santan444/MS001/03-设计开发输出阶段/02电子/05物料证书/隔离电源/BK-1000VA.jpg

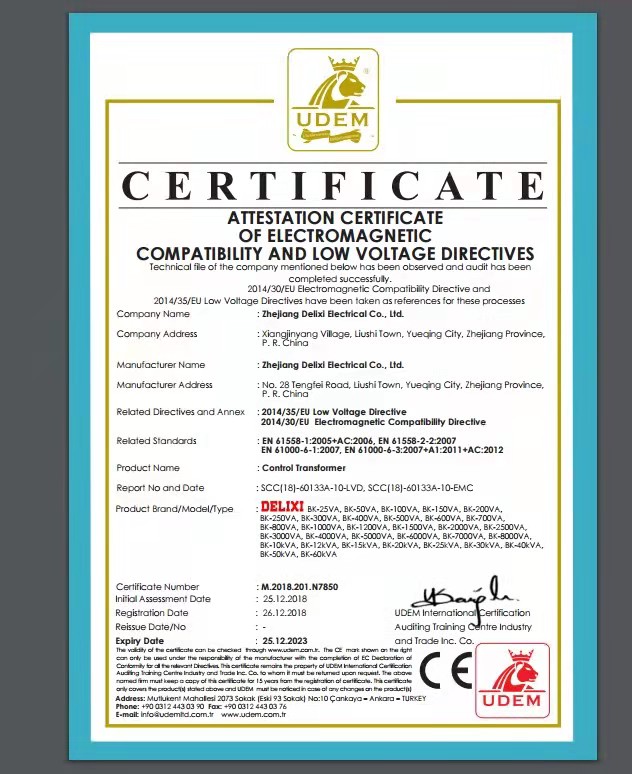
03-设计开发输出阶段/02电子/05物料证书/隔离电源/BK-1000VA.jpg
