santan444/MS001/03-设计开发输出阶段/02电子/05物料证书/显示器/优派VX3515-2KC-PRO.png

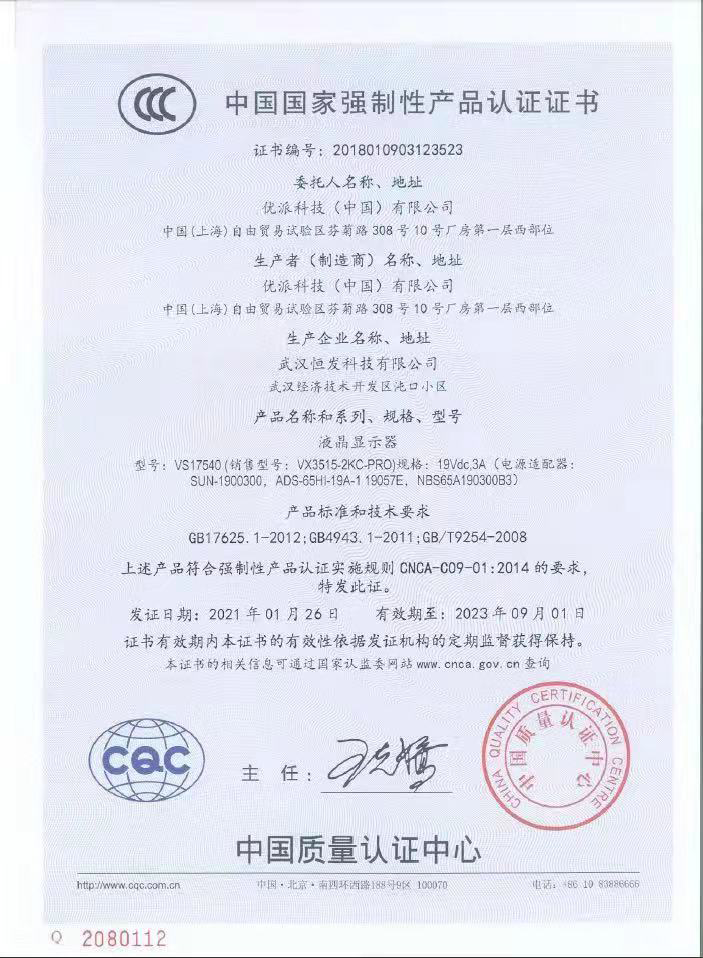
03-设计开发输出阶段/02电子/05物料证书/显示器/优派VX3515-2KC-PRO.png
