santan444/MS001/04-设计开发验证与确认阶段/02使用有效期/附件/控制电路板加速寿命测试记录-空表手签.docx

控制电路板加速寿命测试记录表
操作人： | | 日期：
部件名称 | 模块编号 | 外观完好 | 工作状态
UPS控制板 | 1号
| 2号
| 3号
UR控制板 | 1号
| 2号
| 3号
按键板 | 1号
| 2号
| 3号
RGB灯板 | 1号
| 2号
| 3号
激光控制板 | 1号
| 2号
| 3号
LED灯板 | 1号
| 2号
| 3号

表3.1 试验开始时验证

日期：2021.06.02
部件名称 | 模块编号 | 外观 | 工作状态
UPS控制板 | 1号 | 完好 | 正常
| 2号 | 完好 | 正常
| 3号 | 完好 | 正常
UR控制板 | 1号 | 完好 | 正常
| 2号 | 完好 | 正常
| 3号 | 完好 | 正常
按键板 | 1号 | 完好 | 正常
| 2号 | 完好 | 正常
| 3号 | 完好 | 正常
RGB灯板 | 1号 | 完好 | 正常
| 2号 | 完好 | 正常
| 3号 | 完好 | 正常
激光控制板 | 1号 | 完好 | 正常
| 2号 | 完好 | 正常
| 3号 | 完好 | 正常
LED灯板 | 1号 | 完好 | 正常
| 2号 | 完好 | 正常
| 3号 | 完好 | 正常

表3.2 试验进行中第一次验证

日期：2021.06.10
部件名称 | 模块编号 | 外观 | 工作状态
UPS控制板 | 1号 | 完好 | 正常
| 2号 | 完好 | 正常
| 3号 | 完好 | 正常
UR控制板 | 1号 | 完好 | 正常
| 2号 | 完好 | 正常
| 3号 | 完好 | 正常
按键板 | 1号 | 完好 | 正常
| 2号 | 完好 | 正常
| 3号 | 完好 | 正常
RGB灯板 | 1号 | 完好 | 正常
| 2号 | 完好 | 正常
| 3号 | 完好 | 正常
激光控制板 | 1号 | 完好 | 正常
| 2号 | 完好 | 正常
| 3号 | 完好 | 正常
LED灯板 | 1号 | 完好 | 正常
| 2号 | 完好 | 正常
| 3号 | 完好 | 正常

表3.3 试验进行中第二次验证

日期：2021.06.18
部件名称 | 模块编号 | 外观 | 工作状态
UPS控制板 | 1号 | 完好 | 正常
| 2号 | 完好 | 正常
| 3号 | 完好 | 正常
UR控制板 | 1号 | 完好 | 正常
| 2号 | 完好 | 正常
| 3号 | 完好 | 正常
按键板 | 1号 | 完好 | 正常
| 2号 | 完好 | 正常
| 3号 | 完好 | 正常
RGB灯板 | 1号 | 完好 | 正常
| 2号 | 完好 | 正常
| 3号 | 完好 | 正常
激光控制板 | 1号 | 完好 | 正常
| 2号 | 完好 | 正常
| 3号 | 完好 | 正常
LED灯板 | 1号 | 完好 | 正常
| 2号 | 完好 | 正常
| 3号 | 完好 | 正常

表3.4 试验进行中第三次验证

日期：2021.06.26
部件名称 | 模块编号 | 外观 | 工作状态
UPS控制板 | 1号 | 完好 | 正常
| 2号 | 完好 | 正常
| 3号 | 完好 | 正常
UR控制板 | 1号 | 完好 | 正常
| 2号 | 完好 | 正常
| 3号 | 完好 | 正常
按键板 | 1号 | 完好 | 正常
| 2号 | 完好 | 正常
| 3号 | 完好 | 正常
RGB灯板 | 1号 | 完好 | 正常
| 2号 | 完好 | 正常
| 3号 | 完好 | 正常
激光控制板 | 1号 | 完好 | 正常
| 2号 | 完好 | 正常
| 3号 | 完好 | 正常
LED灯板 | 1号 | 完好 | 正常
| 2号 | 完好 | 正常
| 3号 | 完好 | 正常

表3.5 试验结束时验证

日期：2021.07.02
部件名称 | 模块编号 | 外观 | 工作状态
UPS控制板 | 1号 | 完好 | 正常
| 2号 | 完好 | 正常
| 3号 | 完好 | 正常
UR控制板 | 1号 | 完好 | 正常
| 2号 | 完好 | 正常
| 3号 | 完好 | 正常
按键板 | 1号 | 完好 | 正常
| 2号 | 完好 | 正常
| 3号 | 完好 | 正常
RGB灯板 | 1号 | 完好 | 正常
| 2号 | 完好 | 正常
| 3号 | 完好 | 正常
激光控制板 | 1号 | 完好 | 正常
| 2号 | 完好 | 正常
| 3号 | 完好 | 正常
LED灯板 | 1号 | 完好 | 正常
| 2号 | 完好 | 正常
| 3号 | 完好 | 正常
