santan444/MS001/01-设计开发策划阶段/MS-001任命书_郭宏瑞.docx

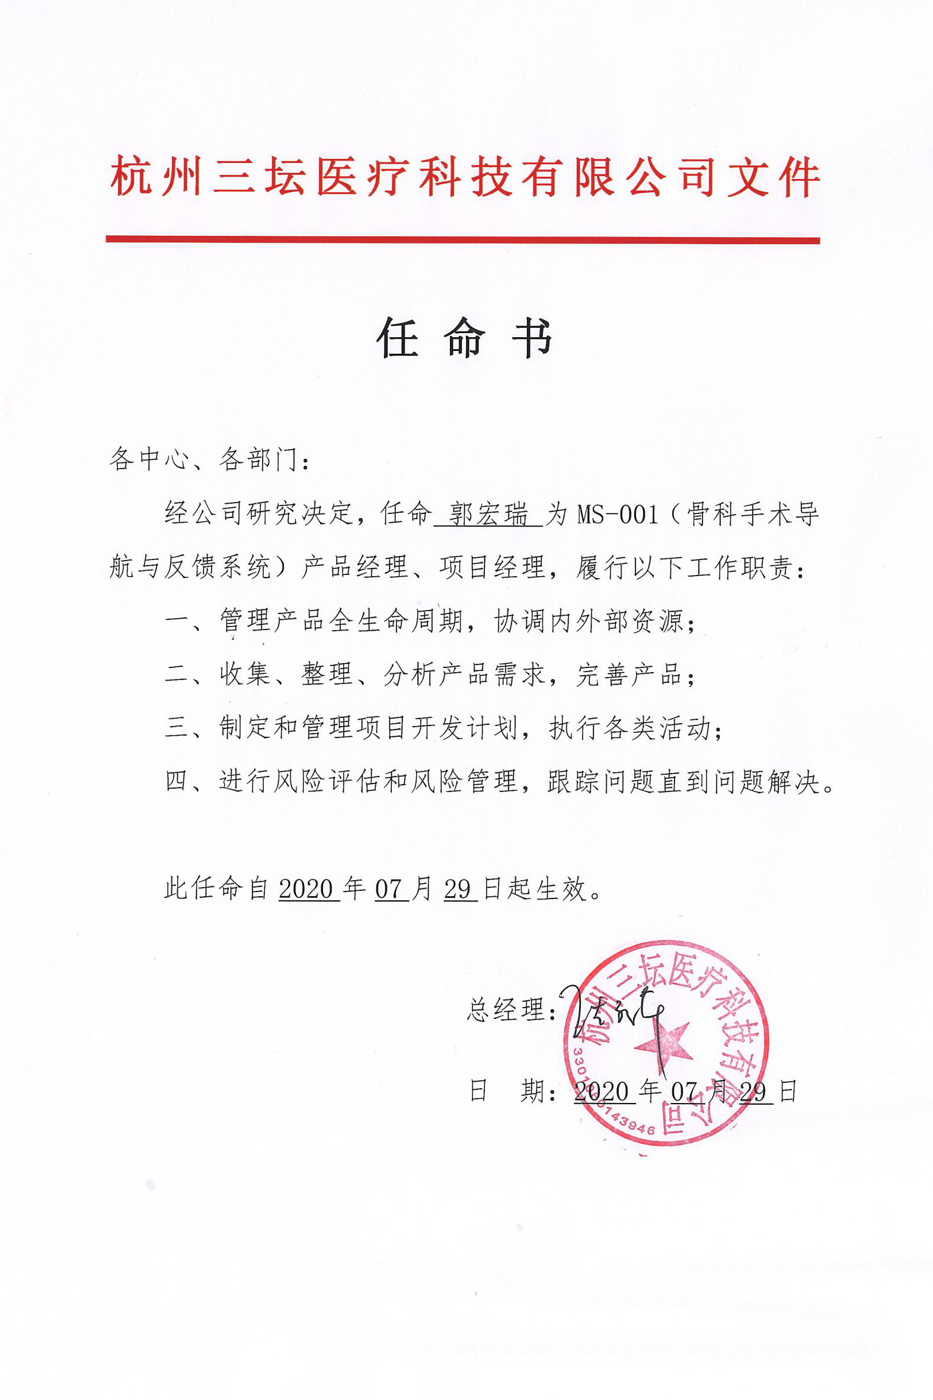
[picture p75: figure]
郭宏瑞-产品经理兼项目经理-MS-001
