santan444/MS001/04-设计开发验证与确认阶段/06评审类/MS-001第四阶段评审会会议纪要_20210831.docx

会议纪要

会议主题：MS-001项目第四阶段开发文件评审
会议时间：2021.08.31 | 会议地点：1号会议室

参会人员：韩琛、卢明、沈丽萍、陈汉清、童睿、王玉帆、焦晓黎、李明、詹佳丹、郭宏瑞

缺席人：

主要内容：

评审了“MS-001模块化手术引导系统”项目的第四阶段设计开发资料，主要确认了：

1. 第四阶段输出相关验证方案、报告等文件，以及下一阶段临床研究的工作安排；
2. 讨论下一步型检安排。

会议结论：

四阶（设计开发验证与确认阶段）资料完整，主要设计方案、验证过程、验证报告数据齐全，结论明确，项目风险可控。经评审审议通过，同意进入下一阶段工作。

记录人/日期：
