santan444/MS001/03-设计开发输出阶段/研发设备、工具、测试环境管理/软件开发设备信息表(戴维焕).docx

软件开发设备信息表

设备类型 | PC
设备编号 | 005001052
设备名称 | PDC20-PC
处理器 | Intel(R) Core i5-7500 @ 3.40GHz 四核
主板 | 华硕 PRIME B250M-PLUS
内存 | 8 GB ( 威刚 DDR4 2400MHz )
操作系统 | Windows 10 专业版
系统类型 | 64 位操作系统, 基于 x64 的处理器
硬盘 | HP SSD EX900 120GB ( 120 GB / 固态硬盘 )
| 1T 机械硬盘
显示器 | 戴尔 DEL413A DELL U2518D
显卡 | Nvidia GeForce GTX 1080 Ti ( 11 GB / 技嘉 )
网卡 | 英特尔 Ethernet Connection I219-V / 华硕
开发软件名称 | 模块化手术导引系统规划软件
