santan444/MS001/03-设计开发输出阶段/研发设备、工具、测试环境管理/软件开发设备信息表(杨斌).docx

软件开发设备信息表

设备类型 | PC
设备编号 | 005001051
设备名称 | PDC14-PC
处理器 | Intel(R) Core(TM) i5-8400 CPU @ 2.80GHz 2.81 GHz
主板 | 华硕B360M-PIXIU
内存 | 8.00 GB ( 金邦 DDR4 2666MHz )
操作系统 | Windows 10 专业版
系统类型 | 64 位操作系统, 基于 x64 的处理器
硬盘 | TIGO SSD 120GB ( 120 GB / 固态硬盘 )
| ST1000DM010-2EP102（1T/机械硬盘）
显示器 | DELF09A DELL SE2218HV（1920 * 1080）
显卡 | NVIDIA GeForce GTX 1050 Ti( 4 GB / 华硕 )
网卡 | 瑞昱 RTL8168/8111/8112 Gigabit Ethernet Controller / 华硕
开发软件名称 | 模块化手术导引系统导引软件
