santan444/MS001/03-设计开发输出阶段/研发设备、工具、测试环境管理/软件开发设备信息表(高广文).docx

软件开发设备信息表

设备类型 | PC
设备编号 | 005001053
设备名称 | DESKTOP-FU5TN12
处理器 | Intel(R) Core(TM) i7-10700F CPU @ 2.90GHz 2.90 GHz
主板 | HP 8704
内存 | 16 GB
操作系统 | Windows 10
系统类型 | 64 位操作系统, 基于 x64 的处理器
硬盘 | 256G 固态硬盘
| 1T 机械硬盘
显示器 | 冠捷AOC2790 U2790B（3840* 2160）
显卡 | NVIDIA GeForce RTX 2060
网卡 | 瑞昱 RTL8168/8111/8112 Gigabit Ethernet Controller / 惠普
开发软件名称 | 模块化手术导引系统规划软件
