santan444/MS001/03-设计开发输出阶段/研发设备、工具、测试环境管理/软件测试环境维护记录(导引台车).docx

软件开发/测试环境维护记录表

维护时间： 2021年 01 月 □开发 ☑测试

设备编号 | ST/RD-E6018 | 设备名称 | MS-001-B
点检项目 | 要求 | 结论 | 备注/问题
软件环境 | 检查操作系统为Windows10家庭版 x64及以上版本 | ☑是 □否 | /
| 检查FileZilla版本为FileZilla_3.7.4.1_win32 | ☑是 □否 | /
| 检查Anaconda版本为Anaconda3-2018.12-Windows-x86_64 | ☑是 □否 | /
| 检查VNC版本为V6.18.907 | ☑是 □否 | /
| 检查Tcp调试脚本为tcp_set.py | ☑是 □否 | /
| 检查机械臂运行脚本为a2_lsr_5_SS.urp | ☑是 □否 | /
| 检查被测软件可以正常运行 | ☑是 □否 | /
硬件环境 | 检查处理器为Intel（R）Core （TM）i3-10100 CPU @3.60GHz 3.60GHz | ☑是 □否 | /
| 检查内存为8GB及以上 | ☑是 □否 | /
| 检查硬盘为500GB及以上 | ☑是 □否 | /
| 检查显示器为1920×1080及以上 | ☑是 □否 | /
| 检查显卡为Intel（R）UHD Graphics 630 及以上 | ☑是 □否 | /
| 检查主机，开机正常，关机正常 | ☑是 □否 | /
| 检查Usb转串口驱动为CH341SER.EXE | ☑是 □否 | /
网络安全 | 检查主机是否联网 | ☑是 □否 | /
病毒防护 | 病毒库是否为最新 | ☑是 □否 | /
| 主机是否检测出病毒，并修复 | ☐是 ☑否 | /
| 主机是否检测出漏洞，并修复 | ☐是 ☑否 | /
数据备份与恢复 | 是否进行数据备份 | ☑是 □否 | /
| 是否进行数据恢复 | □是 ☑否 | /
其他 | /

维护人员/日期： 张彦彦/2021年 01 月 审核人员/日期：
