santan444/MS001/03-设计开发输出阶段/研发设备、工具、测试环境管理/软件测试环境维护记录(规划台车).docx

软件开发/测试环境维护记录表

维护时间： 2021年 01 月 □开发 ☑测试

设备编号 | ST/RD-E6021 | 设备名称 | MS-001-A
点检项目 | 要求 | 结论 | 备注/问题
软件环境 | 检查cuda版本为10.1 | ☑是 □否 | /
| 检查操作系统为Win10 64位（专业版或兼容版本）及以上版本 | ☑是 □否 | /
| 检查被测软件可以正常运行 | ☑是 □否 | /
硬件环境 | 检查内存为8GB及以上 | ☑是 □否 | /
| 检查GPU为NVIDA GeForce RTX 2060及以上 | ☑是 □否 | /
| 检查显示器为3440×1440及以上 | ☑是 □否 | /
| 检查主机，开机正常，关机正常 | ☑是 □否 | /
| 检查硬盘为1TB及以上 | ☑是 □否 | /
| 检查处理器为Intel（R）Core （TM）i5-10500 及以上 | ☑是 □否 | /
网络安全 | 检查主机是否联网 | ☑是 □否 | /
病毒防护 | 病毒库是否为最新 | ☑是 □否 | /
| 主机是否检测出病毒，并修复 | ☐是 ☑否 | /
| 主机是否检测出漏洞，并修复 | ☐是 ☑否 | /
数据备份与恢复 | 是否进行数据备份 | ☑是 □否 | /
| 是否进行数据恢复 | □是 ☑否 | /
其他 | /

维护人员/日期： 张彦彦/2021年 01 月 审核人员/日期：

记录编号：ST-QSP-48FM1 版本号：A/0 页码： 1 / 1
