santan444/MS001/03-设计开发输出阶段/研发设备、工具、测试环境管理/软件测试设备信息.docx

软件测试设备信息

编制/日期：
审核/日期：
批准/日期：

杭州三坛医疗科技有限公司

Hangzhou Santan Medical Technology Co.,Ltd.

## 一、规划台车

## 1.1测试样机编号

设备编号：ST/RD-E6017

型号： MS-001-A

## 1.2软件环境

操作系统 | Windows10 64位专业版
软件版本 | V1
GPU支持软件 | Nvidia CUDA Toolkit 10.1

## 1.3硬件环境

设备 | 型号或配置
主机 | 1、处理器：Intel（R）Core （TM）i5-10500 CPU @3.10GHz 3.10GHz 2、内存：8GB 3、硬盘：1TB 4、分辨率：3440×1440 5、显卡：NVIDA GeForce RTX 2060

## 二、导引台车

## 2.1测试样机编号

设备编号：ST/RD-E6018

型号： MS-001-B

## 2.2软件环境

操作系统 | Windows10家庭版 x64
软件版本 | V1
机械臂运行脚本 | a2_lsr_5_SS.urp
FileZilla | FileZilla_3.7.4.1_win32
Anaconda | Anaconda3-2018.12-Windows-x86_64
Tcp调试脚本 | tcp_set.py
VNC | V6.18.907

## 2.3硬件环境

设备 | 型号或配置
主机 | 1、处理器：Intel（R）Core （TM）i3-10100 CPU @3.60GHz 3.60GHz 2、内存：8GB 3、硬盘：500GB 4、显示器：1920×1080 5、显卡：Intel（R）UHD Graphics 630
