santan444/MS001/03-设计开发输出阶段/采购管理/合格供方名单.docx

合格供方名单

序号 | 供方名称 | 企业性质 | 地址 | 联系人 | 联系方式 | 主要供应产品 | 备注
1 | 杭州肯享机电有限公司 | ☑生产型企业 □贸易型企业 | 海宁连杭开发区春潮路28号 | 毛艳红 | 15967139096 | 机加工件 | B
2 | 杭州百达模型科技有限公司 | ☑生产型企业 □贸易型企业 | 杭州市良渚勾庄工业园沈港路11号2号楼3楼 | 陈海波 | 13646864889 | 机加工件 | B
3 | 浙江洪美包装有限公司 | ☑生产型企业 □贸易型企业 | 浙江省乐清市柳市镇方斗岩工业区 | 卢传 | 18707021276 | 包装木箱 | C
4 | 宁波司实自动化有限公司 | □生产型企业 ☑贸易型企业 | 浙江省宁波市鄞州区首南街道华茂学府一号A座908室 | 王楷华 | 15867504684 | UR机械臂+控制箱 | A
5 | 浙江捷昌线性驱动科技有限公司 | ☑生产型企业 □贸易型企业 | 浙江省新昌县省级高新技术产业园区 | 盛海东 | 18157561073 | 升降立柱 | B
6 | 腾德脚轮（苏州）有限公司 | □生产型企业 ☑贸易型企业 | 苏州市吴江区平望镇欧盛大道2号中鲈国际物流科技园欧中工业园 | 黄永祥 | 15312180089 | 医用脚轮 | C
7 | 浙江沃芯信息系统有限公司 | □生产型企业 ☑贸易型企业 | 杭州市西湖区文三路567号康新花园C座1701 | 高刚 | 0571-56617269 | PC电脑主机 | B
8 | 宁波市北仑区大碶玲辉机械加工厂 | ☑生产型企业 □贸易型企业 | 宁波北仑石湫工业区昌盛路21号 | 石群飞 | 13884407512 | 套筒组件 | B
9 | 上海瑞率电源有限公司 | □生产型企业 ☑贸易型企业 | 上海市嘉定区曹安公路5588号822室 | 章升 | 021-64608192 | 医用电源模块 | C
10 | 安徽鑫德电气有限公司 | □生产型企业 ☑贸易型企业 | 浙江省温州市乐清市柳市镇朝阳村利市（发货地址）/安徽市六安市金安区城北乡北二十铺村（公司地址） | 孔涛 | 18601666085 | 德力西隔离变压器 | B
11 | 得捷电子（上海）有限公司 | □生产型企业 ☑贸易型企业 | 上海市长宁区长宁路1133号长宁来福士广场T1幢办公楼32层3202 | DAVID ROBERT DOHERTY (https://www.qcc.com/pl/p01c217f27857986fc6c514f159dd31d.html) | 400-9201199 | 电子元器件 | C
12 | 杭州屹峰钣金制造有限公司 | ☑生产型企业 □贸易型企业 | 杭州市余杭区瓶窑镇彭公村彭安路88号 | 刘会强 | 18072815358 | 钣金件 | B
13 | 杭州科捷模型有限公司 | ☑生产型企业 □贸易型企业 | 浙江省杭州市江干区九环路63号标准厂房19号楼B幢1层 | 刘姗 | 13597747559 | 外购件，外壳手板件 | B、C
14 | 杭州玺港图文设计有限公司 | ☑生产型企业 □贸易型企业 | 杭州市西湖区三墩镇振华路290号 | 段绍能 | 0571-88478589 /13758246412 | 说明书打印等 | C
15 | 昆山起跑线包装材料有限公司 | ☑生产型企业 □贸易型企业 | 江苏省昆山市千灯镇鹿场路333号4号房 | 李涛 | 13761753564 | 珍珠棉 | C
16 | 深圳市隆创盛科技有限公司 | □生产型企业 ☑贸易型企业 | 深圳市宝安区西乡航城街道洲石路727号727创新园A7栋102室 | 肖建安 | 18107968308 | 导轨 | C
17 | 武汉杰昇电子科技有限公司 | □生产型企业 ☑贸易型企业 | 武汉市洪关区关山大道光谷软件园E1-406室 | 翁经理 | 13469980616 | 工作台旋转组件 | C
18 | 广州丰驰电子科技有限公司 | ☑生产型企业 □贸易型企业 | 广州番禺区大石镇大石街富山路4街5号 | 林雪梅 | 17322252223 | 荣哥显示器 | C
19 | 杭州金骏宇科技有限公司 | □生产型企业 ☑贸易型企业 | 杭州市拱墅区杭行路666号万达商业中心3幢1单元312室 | 刘志成 | 13606548237 | UPS主机 | B
20 | 杭州睿索科技有限公司 | ☑生产型企业 □贸易型企业 | 浙江省杭州市西湖区转塘街道梅玲南路1号1幢182室 | 朱星何 | 18121192337 | PCB板制板+贴片 | A
21 | 上海三实电器有限公司 | ☑生产型企业 □贸易型企业 | 北京东路668号科技京城西楼11楼1室 | 倪华芳 | 13917363722 | 脚踏开关 | B
22 | 大同贝朗科技有限公司 | ☑生产型企业 □贸易型企业 | 山西省大同市平城区水泊寺村南宁丰小区1号楼4号商铺 | 孟伟利 | 19834059842 | 碳纤维板 | C
23 | 苏州希瑞格机器人有限公司 | ☑生产型企业 □贸易型企业 | 昆山市玉山镇富士康路1388号3号 | 诸建新 | 0512-57127038 | 机械臂末端快换装置 | C
24 | 杭州亿泽电子有限公司 | ☑生产型企业 □贸易型企业 | 杭州余杭区博园路1号电子市场2F281 | 魏依冲 | 13588802500 | PCB板制板+贴片 | A
25 | 杭州迪凯电子城昆仲电子商行 | □生产型企业 ☑贸易型企业 | 浙江省杭州市余杭区良渚街道好运街93-99号杭州迪凯电子城4层4B680号 | 潘华军 | 0571-26280118 | 压簧，钢珠球，指示灯，交换机等 | C
26 | 南昌三极光电有限公司 | ☑生产型企业 □贸易型企业 | 江西省南昌市新建区经济开发区璜溪大道909号 | 孙小姐 | 13771991846 | 衍射片 | C
27 | 杭州三顺电器有限公司 | □生产型企业 ☑贸易型企业 | 杭州市西湖区西园路10号 | 徐连杰 | 15888856743 | 绿联线 | C
28 | 杭州致远包装有限公司 | ☑生产型企业 □贸易型企业 | 杭州市上城区笕桥镇横塘一区38号 | 陈周庆 | 0571-85046103 | 包装纸箱 | C
29 | 上海长湾工业产品设计有限公司 | ☑生产型企业 □贸易型企业 | 上海奉贤区新寺镇新林路618号5号楼 | 蒋鑫杰 | 13310156700 | 珍珠棉 | C
30 | 泗洪县鑫亚医疗器械有限公司 | ☑生产型企业 □贸易型企业 | 江苏泗洪红利来大市场 | 丁德玲 | 18261131827 | 消毒盒，卡条 | C
31 | 杭州聚献科技有限公司 | □生产型企业 ☑贸易型企业 | 杭州市西湖区文三路369号数码大厦701室 | 蒋柳喜 | 13372526295 | 优派显示器 | C
32 | 浙江科惠医疗器械股份有限公司 | ☑生产型企业 □贸易型企业 | 浙江省金华市婺城区仙华南街466号 | 应凯 | 13588869740 | 工作套筒+针芯 | B
33 | 浙江嘉佑医疗器械有限公司 | ☑生产型企业 □贸易型企业 | 浙江省绍兴市越城区人民东路1423号办公楼3楼 | 周迎 | 1896759776 | 工作套筒+针芯 | B
34 | 东莞市名优塑业有限公司 | □生产型企业 □贸易型企业 | 广东省东莞市虎门镇南栅五区民昌路3巷13号A栋3楼 | 陈深 | 13798589948 | 外壳手板，机加工件 | B

编制人/编制日期： 审核人/审核日期： 批准人/批准日期：

记录编号：ST-QSP-11FM6 版本号：B/2 页码： 1 / 1
