santan444/MS001/03-设计开发输出阶段/09评审类/MS-001第三阶段评审会会议纪要_20210425.docx

会议纪要

会议主题：MS-001项目第三阶段开发文件评审
会议时间：2021.04.25 | 会议地点：1号会议室

参会人员：韩琛、沈丽萍、陈汉清、童睿、王玉帆、焦晓黎、李明、詹佳丹、郭宏瑞

缺席人：

主要内容：

评审了“模块化手术引导系统”项目的第三阶段设计开发资料，主要确认了：

1. 第三阶段输出的设计开发文件；
2. 讨论下一步试产安排。

会议结论：

项目设计开发输出阶段资料完整，主要设计方案、验证过程、验证报告数据齐全，结论明确，项目风险可控，可以通过阶段评审，进入设计开发验证与确认阶段。

记录人/日期：
