santan444/MS001/03-设计开发输出阶段/03软件/MS-001导引软件描述文档.docx

# 1. 第一部分：基本信息

## 1.1. 软件标识

产品名称（型号）: MS-001-B导引软件

发布版本号：V1

HASH值（如MD5值）

注册申请人地址：

设计开发地址：

## 1.2. 安全性级别

描述软件安全等级，并详细说明安全等级的识别原因。回答表 1-1高风险等级和表 1-2中风险等级中的问题列表，是或否。

定义¹ | 软件安全等级
不会造成受损，不会对健康造成影响 | A
不会有严重受伤 | B
可能会导致死亡或严重受伤 | C

注1．根据IEC 62304:2006第4.3条规定。

表 1-1高风险等级

1. 该医疗器械软件是否具备作为血液建立计算机软件的资质？

否

2. 该医疗器械软件是否拟与药物或生物制剂组合使用？

否

3. 该医疗器械软件是否为高风险等级的医疗器械的附件？

否

4. 在危害缓解前，该医疗器械软件的失效是否会导致患者或器械用户的死亡或严重受伤？

是

a. 该医疗器械软件是否控制生命支持或维持生命功能？

否

b. 该医疗器械软件是否控制可能会导致死亡或严重受伤的具备潜在危害的能量，如放射治疗系统，除颤器和消融发生器？

否

c. 该医疗器械软件是否控制其故障或错误可能会导致死亡或严重受伤的治疗或诊疗？

否

d. 该医疗器械软件是否能提供直接推动治疗或诊疗的诊断信息，例如，如误用，可能会导致死亡或严重受伤？

否

e. 该医疗器械软件在可能危及生命，且必须采取医疗干预情况下，是否能提供生命体征监测和报警？

否

表 1-2中风险等级

1. 该医疗器械软件是否为中等风险等级的医疗器械的附件？

否

2. 在危害缓解前，该医疗器械软件的失效是否会导致患者或器械用户的轻微受伤？

否

3. 该医疗器械软件的故障或潜在设计缺陷是否会导致与轻微受伤相关的医疗护理的误诊或延迟？

是

根据以上的分析，产品软件可能会造成受损，可能会对健康造成影响，所以产品的软件类别为B级。

## 1.3. 结构功能

### 1.3.1. 软件体系结构图

模块化手术导引系统

导引软件

校准子功能

定位子功能

仿真子功能

配置子功能

系统退出子功能

软件注册子功能

网络子功能

机械臂控制子功能

登录子功能

软件信息子功能

日志子功能

登录功能

校准功能

定位功能

辅助设备功能

帮助功能

机械臂控制子功能功能

网络子功能

图 1-1软件系统结构图

本软件组件由“登录功能、校准功能、定位功能、辅助设备功能和帮助功能”组成；无选装。

本产品具体模块架构及流程如下所示：

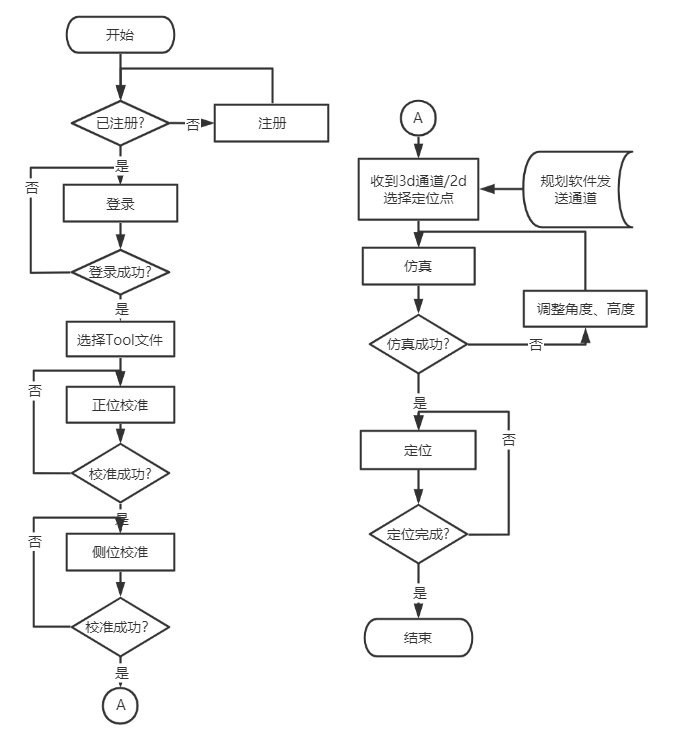
[picture p79: figure]

图 1-2流程图

本软件组件首次开机弹出注册对话框，向用户显示根据该主机硬件信息生成的机器码，用户提供机器码后从厂家获取到注册码。用户在注册对话框输入注册码，注册成功，进入登录页面。

以后本软件组件自动启动，用户使用厂家提供的账号密码登录使用。系统退出前有弹出提示，确认关机后自动关闭工作站电源。

通过软件信息子功能，可显示本软件组件的基本信息，以及本软件组件的生产厂商信息。

本软件组件通过网络接收C臂机传输的DICOM图像，接收图像后在软件中显示，调用图像处理算法进行C臂机畸变参数校准，本软件组件通过以太网络通过TCP/IP协议与机械臂底层控制程序通信，获取机械臂的姿态数据、关节角信息，控制关节移动，获取机械臂的状态；

正侧位校准功能，本软件组件会将机械臂当前姿态和当前图像信息发送给规划软件进行图像融合配准；

规划软件将会规划的通道数据发送回本软件组件，本软件组件再下发给机械臂单元进行仿真、定位操作。

本软件组件支持下面这些功能：

(1) 登录功能完成设备与软件绑定，并保证用户权限，保证网络安全。
(2) 校准功能可对X-Ray图像进行算法校准。正侧位校准所用时间均小于10S。
(3) 手术方案功能包含有数据管理、CT切割复位、CT分区，手术通道规划，X-Ray分区、图像配准和融合，显示定位通道信息。
(4) 配置子功能可以进行参数配置，C臂机相机参数配置和机械臂网络配置。
(5) 机械臂控制子功能进行机械臂关节控制，启动机械臂、关闭机械臂，正位复位、侧位复位，伸展机械臂、收纳机械臂，机械臂自由拖动，禁止拖动和水平对齐；获取机械臂关节角度。
(6) 网络子功能从C臂机接收DICOM图像；并将X光图像发送到规划软件；通过网络接口，还能够实时控制UR机械臂，并读取UR机械臂的实时状态反馈信息。接收的X-Ray 图片分辨率大于等于1000*100，并且宽度与高度相等。
(7) 仿真子功能能够调整定位目标的高度和角度，并能够进行3D通道仿真与2D目标点仿真。仿真数据获取响应时间小于3S。
(8) 定位子功能可以与规划软件配合，在接收到定位信息后进入定位界面。实现2D定位，2D居中；3D定位，定位重置。三维定位精度小于等于1.5mm，三维定位角度小于等于1°。

更多详情见本次注册资料《CH3.5.05.04 体系结构图》。

### 1.3.2. 主界面图示

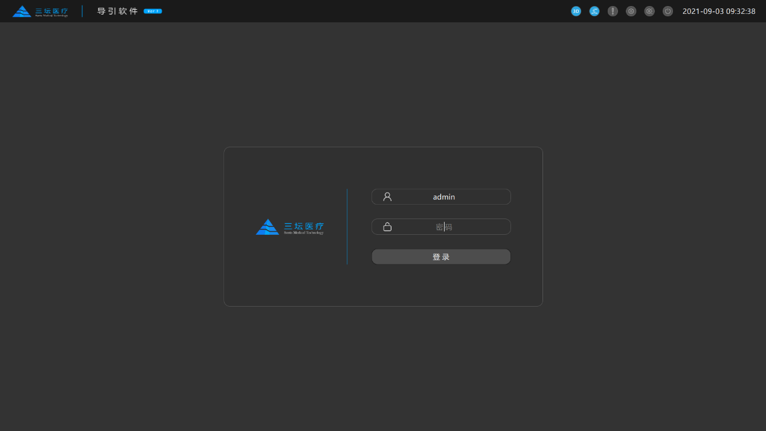
[picture p80: figure]

图 1-3主界面图示

### 1.3.3. 用户界面关系图

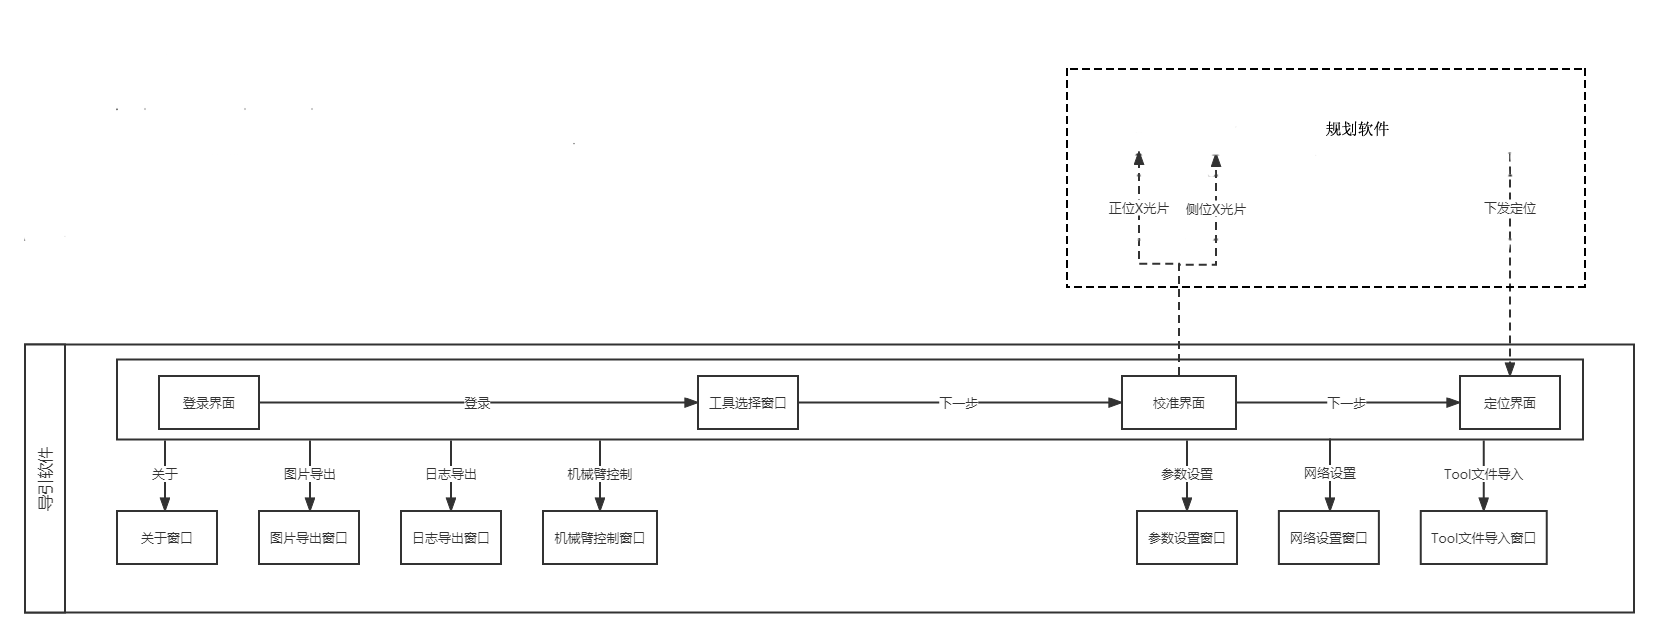
[picture p81: figure]

图 1-4用户关系界面图

(1) 登录界面：

用户登录界面，进入操作导引软件的入口。登录界面应该有合理的布局设计、风格。

(2) 工具选择窗口：

登录成功后，需先进行工具选择，选择本次手术装配的工具（前端器械等）信息数据。

(3) 校准界面：

进入该界面，呈现有校准后的2D视图区;对机械臂常用功能操作区;工具显示;信息提示;校准进度显示及校准功能操作区。每校准完成，将校准后的X光片发送至连接的规划软件。

(4) 定位界面：

进入该界面，呈现有校准后的正位2D视图区;对机械臂常用功能操作区;信息提示;接收规划软件的定位信息,模型仿真区/参数区显示;仿真姿态调整功能操作区;2D/3D定位功能操作区。

(5) 关于窗口：

显示软件版本信息、产品注册信息等。

(6) 图片导出窗口：

导出校准后的图片。

(7) 日志导出窗口：

导出软件的系统日志。

(8) 机械臂控制窗口：

查看及控制机械臂的6轴数据。

(9) 参数配置窗口：

查看配置校准参数、2D、3D补偿数据及机械臂包头信息。

(10) 网络设置窗口：

查看配置IP、端口、子网掩码信息。

(11) Tool文件导入窗口：

配置导入Tool数据。

## 1.4. 硬件拓扑

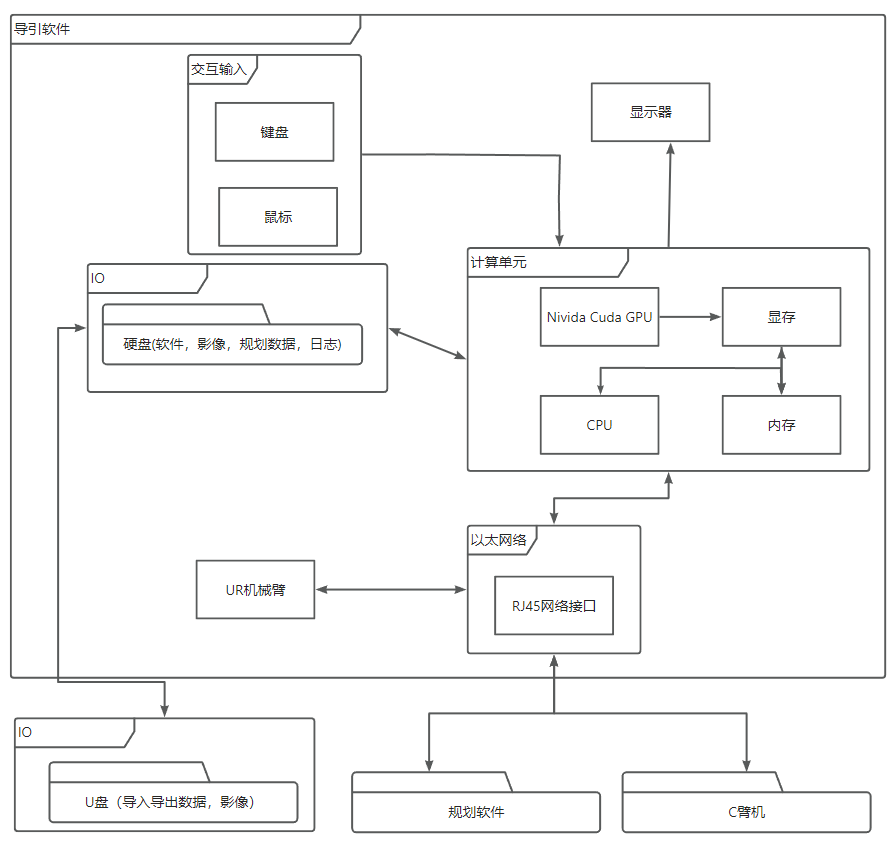
[picture p82: figure]

图 1-5硬件拓扑图

本软件组件在工作站安装后，依靠本地局域以太网络与MS-001-A规划软件进行数据通讯，依靠本地局域网与C臂机进行数据通信，依靠本地局域网与UR机械臂进行数据通信，不接入外部以太网络。数据导入、导出直接通过U盘进行传输。

## 1.5. 运行环境

本软件组件在工作站内安装运行，最低运行环境配置如下：

表 1-3运行环境最低配置

硬件要求 | CPU | Intel(R) Core(TM) i3-10100 CPU @3.60GHz 3.60GHz及以上
| 内存 | 8GB及以上
| GPU | Intel(R) UHD Graphics 630及以上
| 硬盘 | 500GB及以上
| 显示器 | 分辨率：1920*1080及以上
软件要求 | 操作系统 | Windows 10 64位（专业版）及其兼容版本
网络类型 | 局域网 | 100Base-T
| 网络架构 | Peer-to-Peer

## 1.6. 注册历史

本公司本产品为国内外首次注册，无上市历史。

# 2. 第二部分：实现过程

## 2.1. 开发概况

### 2.1.1. 开发方法

本软件组件使用瀑布模型开发方法。

### 2.1.2. 编程语言

本软件组件使用 C++ 编程语言作为组件的编程语言。

### 2.1.3. 开发测试环境

使用微软 Visual Studio 作为开发环境，用户界面架构选择了 Qt GUI 架构，代码开发环境和项目代码管理工具如下表所示：

表 2-1开发测试环境

| 名称 | 版本 | 供应商
开发编译工具 | Microsoft Visual Studio Enterprise 2015 | 14.0.25420.01 Update3 | Microsoft
| Qt | 5.9.7 | Qt Company
项目管理工具 | GitLab | Community Edition 8.17.4 | GitLab Inc.

### 2.1.4. 开发人员

开发人员：3人。

## 2.2. 风险管理

### 2.2.1. 目的

本软件组件的风险管理根据YY/T 0316-2016《医疗器械风险管理对医疗器械的应用》、YY/T 0664-2008《医疗器械软件生命周期过程》和本公司《风险控制程序》执行。

其目的是描述本软件组件的风险管理过程，以有效识别、评估和控制潜在风险。

### 2.2.2. 风险管理报告

见随附报告，报告名称：风险分析报告。

详见本次注册资料《CH3.2风险管理》。

## 2.3. 需求规格（请提供原始文档）

### 2.3.1. 需求规格依据定义

本软件组件的需要规格依据 《MS-001用户需求》中的需求项 UR0200,UR0700进行设计和工程化之后得到。

### 2.3.2. 软件需求规格分析文档

本软件组件的需要规格严格按照《MS-001产品技术需求说明书》第五章 产品功能需求中的5.1 导引软件功能需求执行设计和验证。

## 2.4. 生存周期

### 2.4.1. 生存周期模型

计划

需求分析

概要设计

详细设计

编码

测试

维护

策划阶段

设计开发

验证确认阶段

运行维护阶段

图 2-1瀑布生存周期

### 2.4.2. 开发阶段

开发阶段包括需求分析、概要设计、详细设计，编码和测试共五个阶段。

### 2.4.3. 维护阶段

维护阶段包括维护和测试两个阶段。

## 2.5. 验证与确认（请提供原始文档）

### 2.5.1. 软件的测试计划

由研发人员在代码编写过程中进行动态审核，对已编写完成的代码进行静态代码审核。代码编写完成后，单元测试由研发人员进行。

通过单元测试来测试功能的正确性，测试通过后，将功能进行集成，构成系统。构成完成后开始系统测试。

根据网络安全指导原则，进行网络安全测试。

详细测试计划参考下表：

序号 | 名称
1 | MS-001导引软件单元测试方案
2 | MS-001导引软件单元测试用例
3 | MS-001导引软件网络安全测试方案
4 | MS-001导引软件系统测试方案
5 | MS-001导引软件系统测试用例
6 | MS-001可用性确认方案及计划

### 2.5.2. 目的

由软件开发人员主力承担子功能的单元测试，确保对判定和条件组合完全覆盖，并保证程序中的每一条可能执行路径都至少被执行一次。

由测试人员承担对本软件组件的系统功能测试，在内部结构和内部特性不可见的情况下对程序的外部结构、功能和界面进行测试，保证用户业务逻辑能够完整正确地被实现。

### 2.5.3. 范围

针对本软件组件的软件注册子功能、登录子功能、校准子功能、机械臂控制子功能、定位子功能、仿真子能、网络子功、软件信息子功能、日志子功能、配置子功能、系统退出子功能等功能进行功能模块接口测试、局部数据结构测试、路径测试、错误处理测试、边界测试。

对本软件组件的系统测试内容主要体现在功能测试，主要依据是技术需求规格书中的功能需求部分。

### 2.5.4. 概况

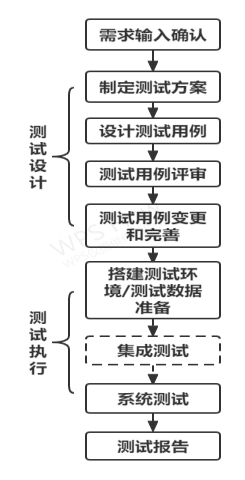
[picture p83: figure]
测试流程

图 2-2测试概况

### 2.5.5. 测试案例起始点

在《MS-001产品技术需求说明书》第五章 产品功能需求中的5.2 导引软件功能需求经过评审确认后，开始制订本软件组件的测试计划，启动测试。

### 2.5.6. 测试目标：通过与失败的标准

要求所有测试用例全部测试通过，认为测试通过。否则判定为测试失败。

### 2.5.7. 报告

（1） 测试人员根据测试方案，执行相应的测试用例，并做好测试记录；
（2） 测试人员进行缺陷登记，并跟踪解决情况，及时复测验证，关闭缺陷；
（3） 测试主管（组长）跟踪测试用例执行情况，了解影响测试用例执行的因素，及时跟进有关的协调，报告测试状态；
（4） 测试主管（组长）根据项目情况，将测试进展情况及时通报给相关各方。

### 2.5.8. 重新测试程序

在每轮测试中，按现有的测试用例没有新的缺陷被发现，测试报告中全部的活动缺陷都被解决，则启动回归测试。

测试小组将按照测试方案中对于回归测试的策略对产品进行回归测试，回归测试的用例属于测试用例的一部分或者是全部测试用例，但不能超出原先预定的测试用例的范围。

### 2.5.9. 任务

在代码开发阶段持续进行单元测试，以保证代码的可靠性。

在系统集成阶段，在发布版本上进行集成或系统测试，保证技术需求规格书中的功能需求完整正确被实现。

在系统集成阶段，在发布版本上进行网络安全测试，保证对网络安全指导原则的严格遵守。

依照《MS-001 可用性确认方案及计划》，确保本软件组件的可用性满足要求。

### 2.5.10. 缺陷报告

本产品剩余缺陷见：《MS-001缺陷分析报告》。

### 2.5.11. 测试报告

本软件组件测试报告见：

序号 | 名称
1 | MS-001导引软件系统测试报告
2 | MS-001导引软件系统测试记录
3 | MS-001导引软件网络安全测试记录
4 | MS-001导引软件网络安全测试报告
5 | MS-001可用性验证报告

## 2.6. 可追溯性分析

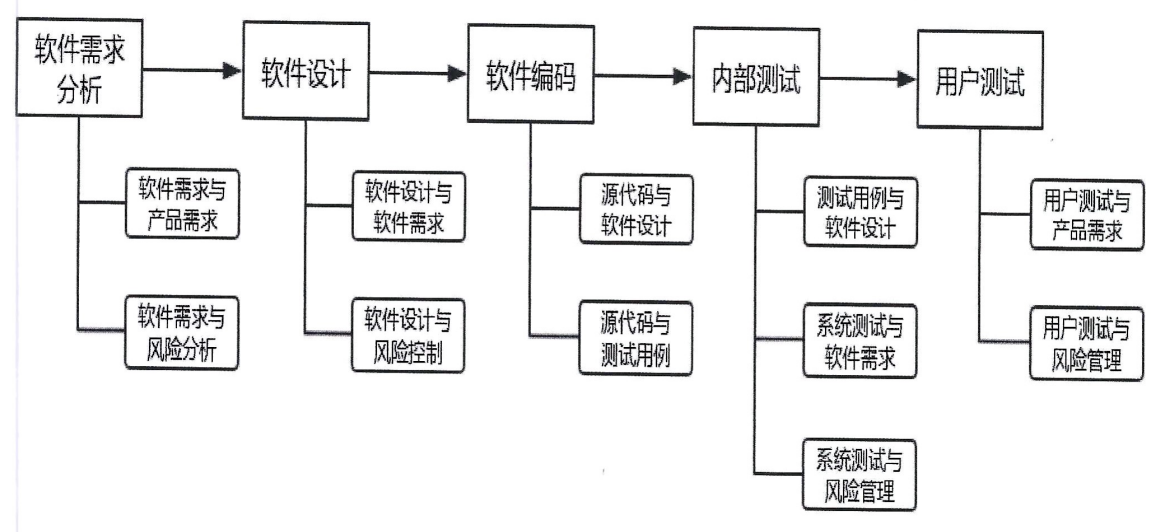
[picture p84: figure]

图 2-3软件可追溯性分析

本软件组件依照《软件可追溯性控制程序》进行软件可追溯性分析活动。

在设计阶段追溯软件设计与需求规格、软件设计与风险控制的关系；

在编码阶段追溯源代码与软件设计、源代码与测试用例的关系；

验证阶段追溯单元测试与软件实现、系统测试与需求规格、系统测试与风险管理之间的关系。

用户测试阶段追溯用户测试与可用性、用户测试与风险管理的关系。

本软件组件的可追溯性分析报告见：

序号 | 名称
1 | MS-001网络安全可追溯性分析报告
2 | MS-001可追溯性跟踪表
3 | MS-001可追溯性分析报告

## 2.7. 缺陷管理

### 2.7.1. 缺陷管理依据

依据《缺陷管理规程》进行项目研发过程的缺陷管理，对本软件组件各阶段的缺陷管理过程进行规范。

### 2.7.2. 缺陷管理过程

对于缺陷管理，从发现缺陷到最终解决的流程如图 2-4缺陷管理流程所示。

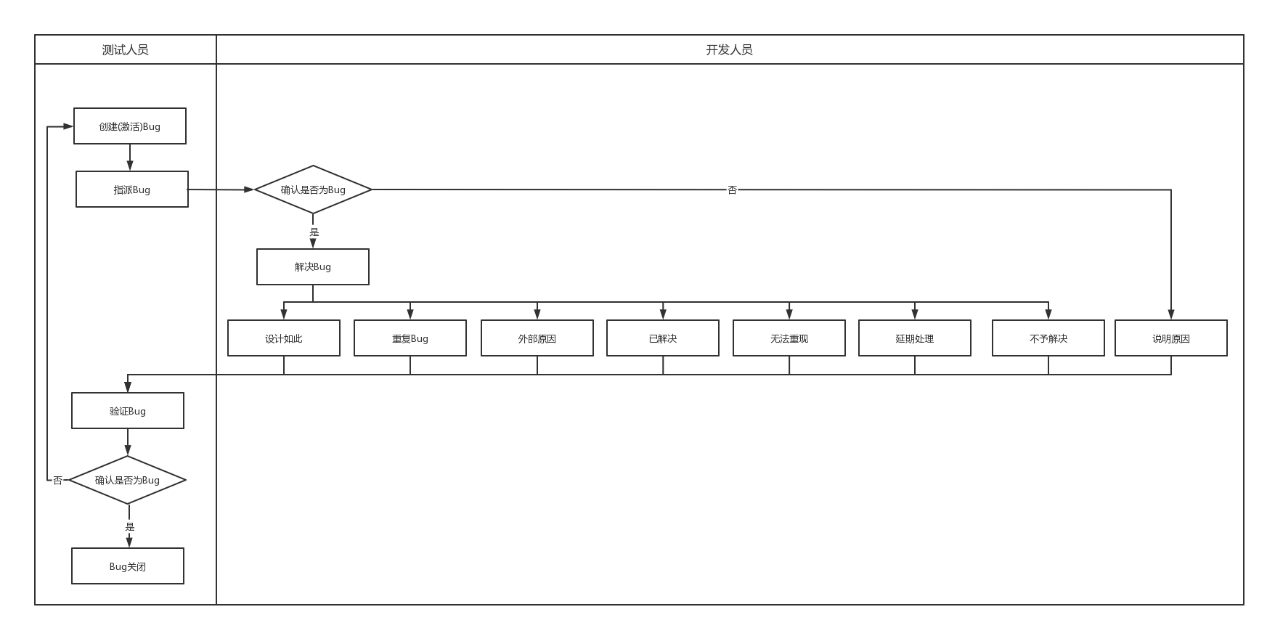
[picture p85: figure]
wps

图 2-4缺陷管理流程

### 2.7.3. 剩余缺陷解决

本软件组件无剩余未解决缺陷。

## 2.8. 更新历史

### 2.8.1. 软件版本识别要求

软件完整版本命名规则：vX.Y.Z.B

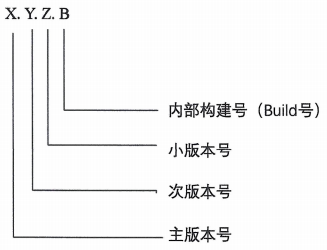
[picture p86: figure]

软件版本规则：发布版本为VX；软件完整版本为vX.Y.Z.B，其中：

X主版本号：表示重大软件更新。影响到医疗器械安全性或有效性的软件更新。具体而言，软件更新如影响到医疗器械的预期用途、使用环境或核心功能均为重大软件更新。

重大软件更新包括以下情形之一：

（1）适应型软件更新：软件运行平台跨越互不兼容的计算平台（包括硬件和软件），如操作系统软件由Windows变为iOS，32位计算平台变为64位计算平台、常规计算平台变为移动计算平台等，而预期运行的系统软件和支持软件的补丁更新一般不视为重大软件更新，除非影响到医疗器械的安全性或有效性。

（2）完善型软件更新：影响到用户临床决策（包括决策能力、决策结果、决策流程和用户行动），或者影响到人员安全（包括患者、用户和其他相关人员），如软件的输入输出数据类型、体系结构、用户界面关系、物理拓扑、核心算法、核心功能、诊疗流程或预期用途等发生改变，软件系统、高风险软件项/软件单元进行代码重构，安全性级别改变，调整报警方式等。而运算效率单纯提高、诊疗流程或工作语言可配置化（即用户可保留原有诊疗流程或工作语言）、用户界面文字性修改、中低风险软件项/软件单元的代码重构等情况通常不视为重大软件更新，除非影响到医疗器械的安全性或有效性。

Y次版本号：表示轻微增强类软件更新。不影响医疗器械安全性与有效性的，为适应新的运行环境，或为改变功能、性能等软件属性而进行的软件更新。

Z小版本号：表示纠正类软件更新。不影响医疗器械安全性与有效性的，为修正软件已知缺陷，或为修正软件潜在未知缺陷以避免出现运行故障而进行的软件更新。

B构建号（Build）：表示软件构建。是指软件编译生成一个版本，同个构建版本类型每发布一次Build号对应+1。

### 2.8.2. 软件版本更新历史

详见本次注册资料《CH3.5.5.9 版本更新历史》。

# 3. 第三部分：核心功能

涉及核心算法详见下表 3-1核心算法。

表 3-1核心算法

核心算法 | 算法类型 | 算法原理 | 核心功能 | 预期用途

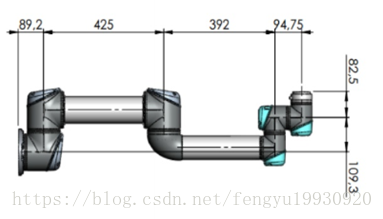
[picture p87: figure]

1. 机械臂正解 | 公开成熟算法 | 机械臂正运动学求解是已知机械臂的关节角度，求解机械臂基座坐标系下TCP的笛卡尔坐标位姿。其本质是六个根据D-H参数确定的变换矩阵的乘积。 UR5机械臂的D-H参数由UR官方提供，通过变换矩阵可得到机械臂TCP的精确笛卡尔位姿。 | 仿真子功能 | 能够调整定位目标的高度和角度，并能够进行3D通道仿真与2D目标点仿真

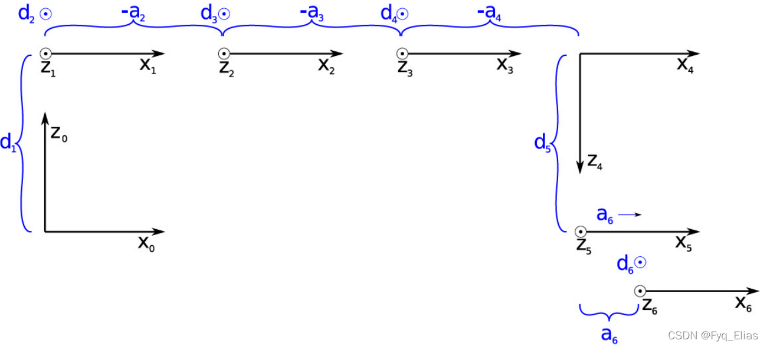
[picture p88: figure]

2.机械臂逆解 | 公开成熟算法 | 我们使用绕坐标系固定轴的方式来描述机械臂TCP的姿态，即绕定轴X（Roll）—Y（Pitch）—Z（Yaw）旋转，因而旋转矩阵左乘。位姿可表示为位移[px,py,pz]和旋转角度[r,b,a],使用D-H参数，我们可直接求解关节1的角度，共两组解。 基于关节1的两组角度，继续求解关节5，共可得四组解。 依次完成关节6，关节3，关节2，关节4得求解，完成机械臂六个关节得全部求解，共可得到八组解。 | 定位子功能 | 在接收到定位信息后进入定位界面。实现2D定位，2D居中；3D定位，定位重置

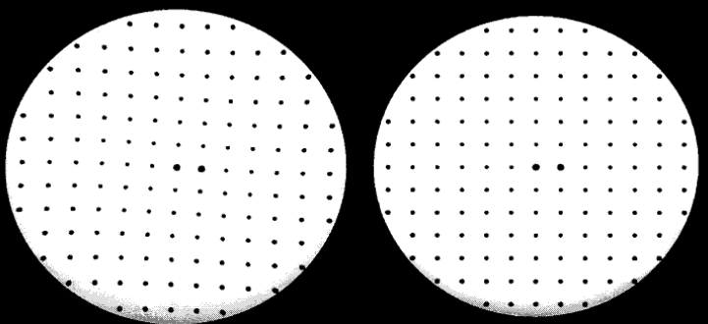
[picture p89: figure]

3.X-Ray图像畸变校正算法 | 公认成熟算法 | 图像增强器失真随C臂旋转角度的变化而变化，这是因为它与地球或其他杂散磁场的方向发生变化。超全局失真校正包括一个模型，不仅在图像中的每个位置，而且针对C臂的每个旋转角度，连续校正其失真。用9英寸图像增强器模式的标准C臂采集校准珠图像。超全局（SG）模型是从给定采样角度间隔的选定校准图像的单平面全局校正获得的。五阶单平面全局校正产生0.20像素的残余rms误差，而SG模型产生0.21像素的rms误差，这是一个可忽略的小差异。SG模型为旋转C臂图像提供了准确、快速和简单的校正，可用于锥形束CT。 | 校准子功能 | 可对X-Ray图像进行算法畸变校正以及校准。

# 4. 第四部分：结论

本软件组件依照YY/T 0664-2008 《医疗器械软件 软件生存周期过程》及《软件生存周期管理程序》进行软件生命期的管理。

依照《MS-001产品技术需求说明书》第五章 产品功能需求中的5.2 导引软件功能需求中的要求实现软件组件的功能，并通过系统测试和可用性确认保证了软件组件功能的完整和正确。

依照《缺陷管理规程》管理软件组件开发过程中的缺陷，最终无剩余未解决缺陷，说明软件组件的功能实现完整正确，且无安全性风险。

本产品通过对标准《YY/T 1474-2016医疗器械可用性工程对医疗器械的应用》的自查，验证了产品的可用性，最终通过临床试验对产品可用性进行确认。同时制定《用户培训方案》增强产品的可用性，以及人为因素对产品使用的影响。
