santan444/MS001/01-设计开发策划阶段/评审类/MS-001产品提议评审会会议纪要_20200729.docx

会议纪要

会议主题：产品开发提议评审
会议时间：2020.07.29 | 会议地点：会议室

参会人员：沈丽萍、韩琛、卢明、陈汉清、童睿、王玉帆、焦晓黎、范忆萍、詹佳丹

缺席人：何滨、于斌、柴宏志

主要内容：

一.评审了“骨科手术机器人导航系统”项目的产品开发提议资料，主要确认了：

1. 项目编号（与产品型号一致）：MS-001；
2. 产品名称与预期用途参照国局分类目录与已上市同类产品情况；
3. 初始设计目标的适应症的最低目标主要是临床应用较广脊柱类和创伤类手术，最高目标中可再根据临床案例进行补充；
4. 初始设计目标的适配C臂机为西门子Compact L和康达平板；
5. 初始设计目标的术中定位精度和术后反馈精度在研发中以“线性误差≤1.0mm，角度误差≤1°”要求开展。

二.下阶段部署

第1阶段开发的项目负责人为童睿；

计划于2020年9月18日前完成第1阶段开发评审。

记录人/日期：
