santan444/MS001/01-设计开发策划阶段/评审类/MS-001第一阶段评审会会议纪要_20200918.docx

会议纪要

会议主题：MS-001项目第一阶段开发文件评审
会议时间：2020.09.18 | 会议地点：会议室

参会人员：何滨、沈丽萍、陈汉清、童睿、王玉帆、焦晓黎、范忆萍、申明宇、杨梅、

詹佳丹

缺席人：于斌、韩琛、卢明、柴宏志

主要内容：

评审了“骨科手术机器人导航系统”项目的第一阶段开发资料，主要确认了：

1. 在项目可行性分析资料的知识产权情况中，本阶段放入《科技查新报告》，产品知识产权分析资料应在第二阶段/第三阶段开发文件中。
2. 确定了项目组成员与评审委员会成员。

记录人/日期：
