santan444/MS001/04-设计开发验证与确认阶段/02使用有效期/附件/外壳空表手签.docx

MS-001外壳加速寿命测试记录表
高低温开始试验日期： | | | | | 高低温结束试验日期：
油漆及机械强度检测日期： | | | | | 试验地点：
高低温试验温度： | | | | | 高低温试验湿度：

1. 外观检查

检查日 | | 外观是否完好 | | | | 说明
第7天： 年 月 日 | | 是 ☐ | | 否☐
第14天： 年 月 日 | | 是 ☐ | | 否☐
第21天： 年 月 日 | | 是 ☐ | | 否☐
第28天： 年 月 日 | | 是 ☐ | | 否☐
第35天： 年 月 日 | | 是 ☐ | | 否☐
第42天： 年 月 日 | | 是 ☐ | | 否☐
第49天： 年 月 日 | | 是 ☐ | | 否☐
第56天： 年 月 日 | | 是 ☐ | | 否☐
第63天： 年 月 日 | | 是 ☐ | | 否☐
第66天： 年 月 日 | | 是 ☐ | | 否☐

2. 尺寸检查

试验前 | 长x宽x高(mm)
试验后 | 长x宽x高(mm)
实配是否有影响 | | | 有☐ 无☐

3. 油漆耐擦拭检查

检测点1 | | 检测点2 | | 检测点3 | | 检测点4 | 检测点5
通过 ☐ | | 通过 ☐ | | 通过 ☐ | | 通过 ☐ | 通过 ☐
不通过☐ | | 不通过☐ | | 不通过☐ | | 不通过☐ | 不通过☐

4. 导电漆测试

检测点1 | | 检测点2 | | 检测点3 | | 检测点4 | 检测点5
通过 ☐ | | 通过 ☐ | | 通过 ☐ | | 通过 ☐ | 通过 ☐
不通过☐ | | 不通过☐ | | 不通过☐ | | 不通过☐ | 不通过☐

5. 机械强度检测

机械强度检测是否通过 | | | | 通过 ☐ 不通过☐
记录人/日期： | | | | 复核人/日期：

2021.05.20-2021.07.25

每隔7天进行一次外观检查

开始2021.05.20 周四

第7天2021.05.26 周三

06-02,06-09,06-16,06-23,06-30，07-07,07-14,07-21,07-24

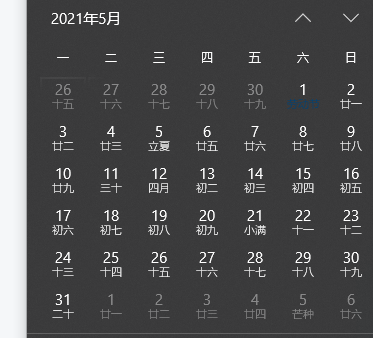
[picture p108: figure]
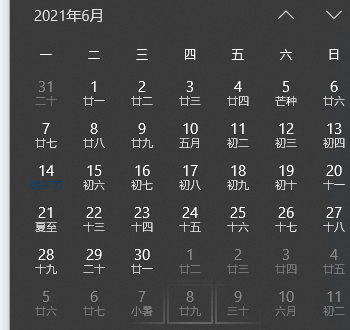
[picture p109: figure]
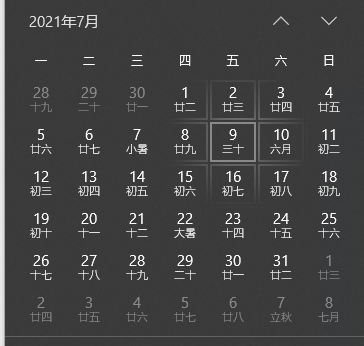
[picture p110: figure]
