santan444/MS001/03-设计开发输出阶段/转产指导/02SOP/MS-001生产工艺流程图.docx

MS-001模块化手术导引系统 生产工艺流程图

合格

检验

注：★标为关键工序

检验不合格品按《不合格品控制程序》处置

半成品入库或进入下一道工序

生产任务单

领料

出库发货

审核放行

产品入库

整机包装

整机调试

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
★TCP标定

MS-001-D体位反馈模块组装

MS-001-C工具包组装

MS-001-B导引模块组装调试

MS-001-A规划模块组装

版本号： | 编制人： | 审核人： | 批准人：
| 日期： | 日期： | 日期：

记录编号：ST-QSP-10FM21 版本号：A/1 页码： 1 / 1
