santan444/MS001/01-设计开发策划阶段/MS-001任命书_项目负责人童睿.PDF

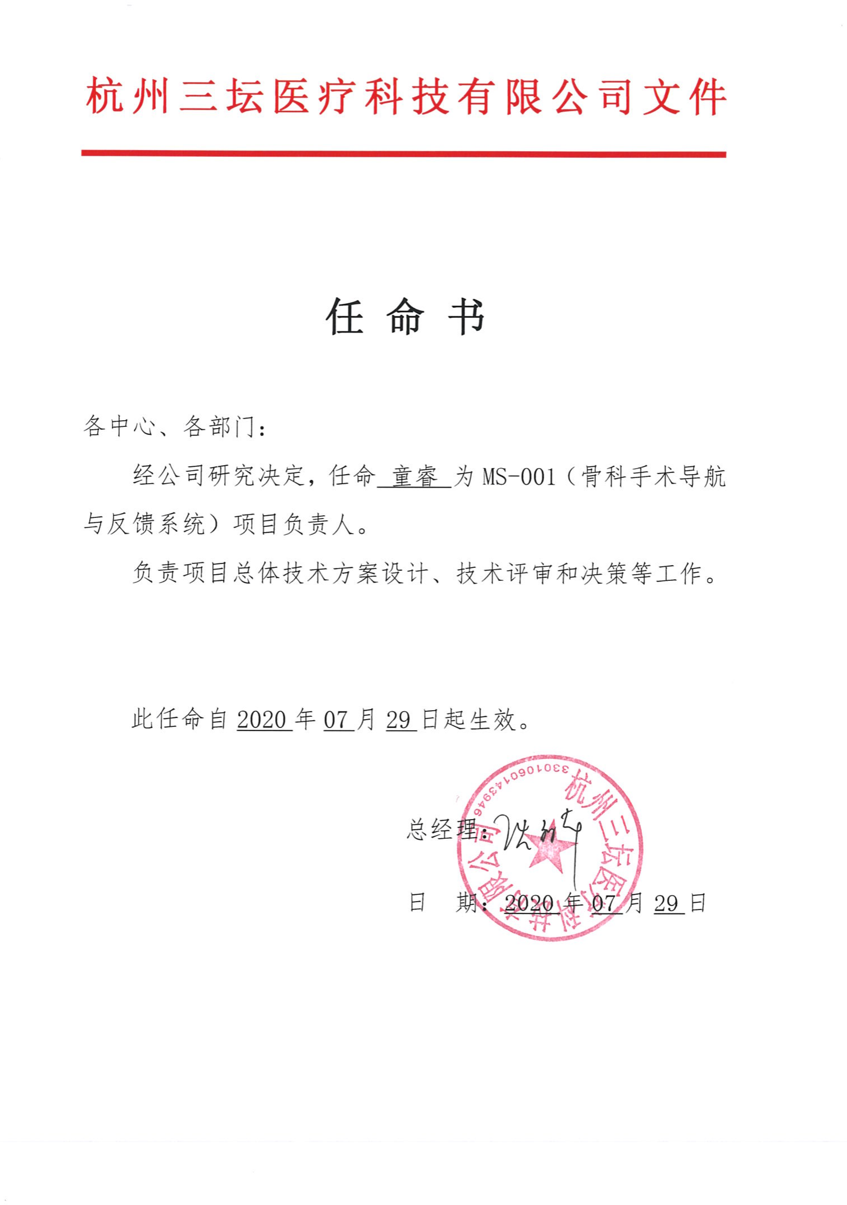
[picture p166: page 1]
