santan444/MS001/01-设计开发策划阶段/MS-001立项书.pdf

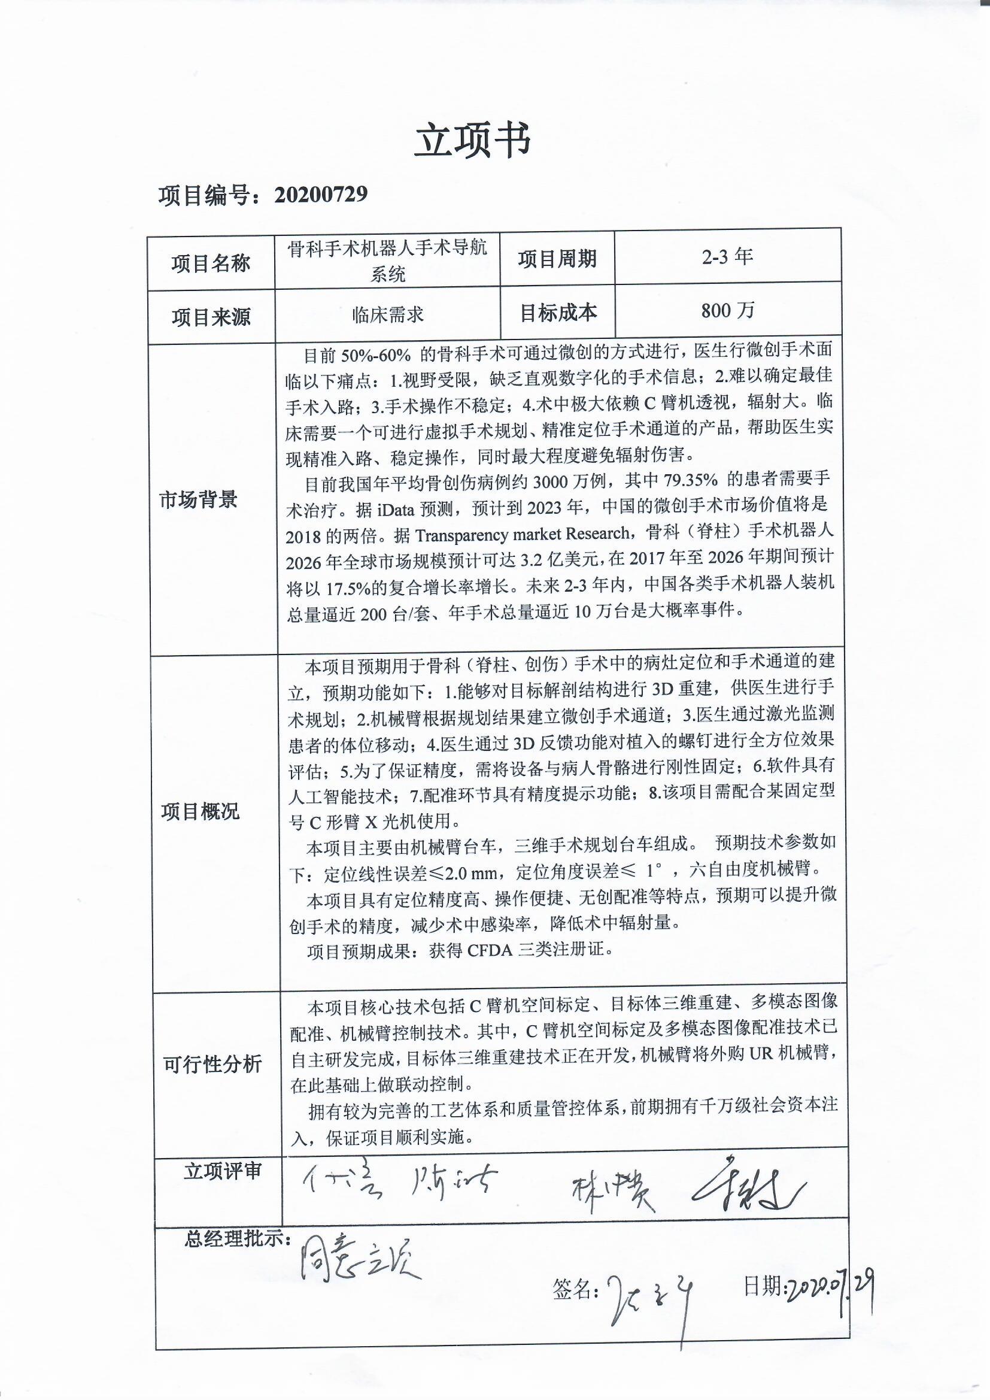
[picture p167: page 1]
