santan444/MS001/04-设计开发验证与确认阶段/02使用有效期/附件/HP ElitePro MTBF证书.pdf

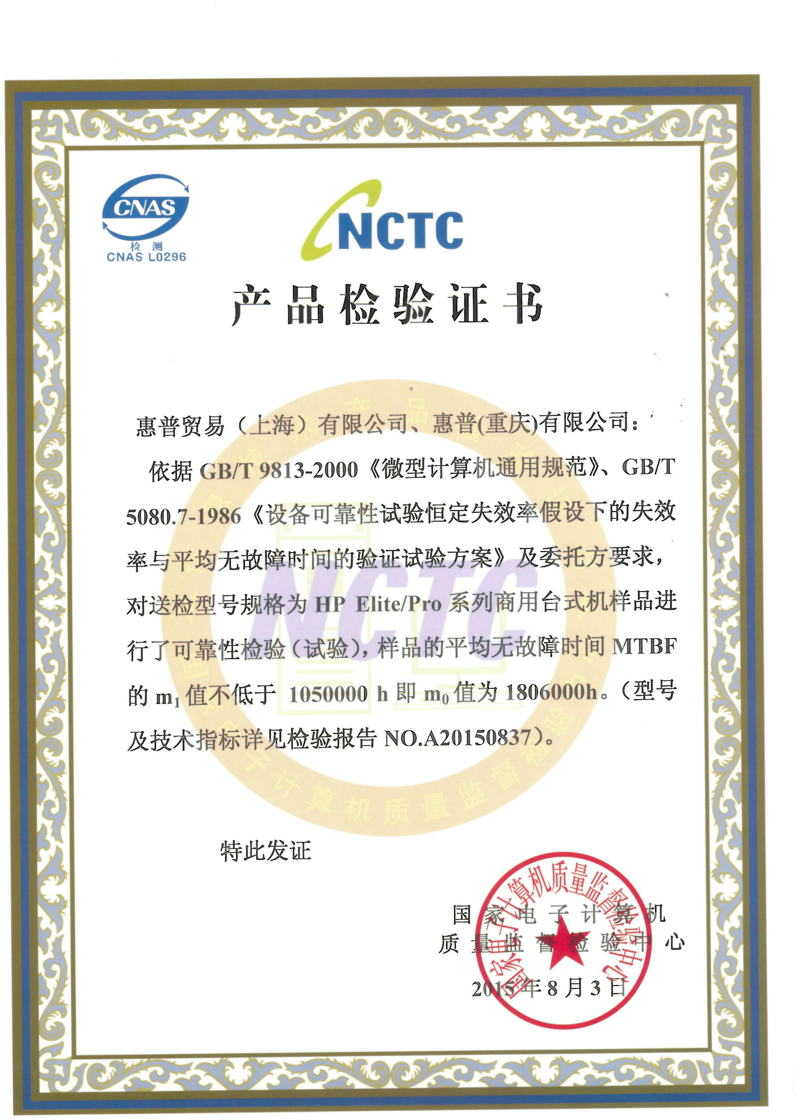
[picture p168: page 1]
