santan444/MS001/03-设计开发输出阶段/01系统/MS-001网络拓扑图.png

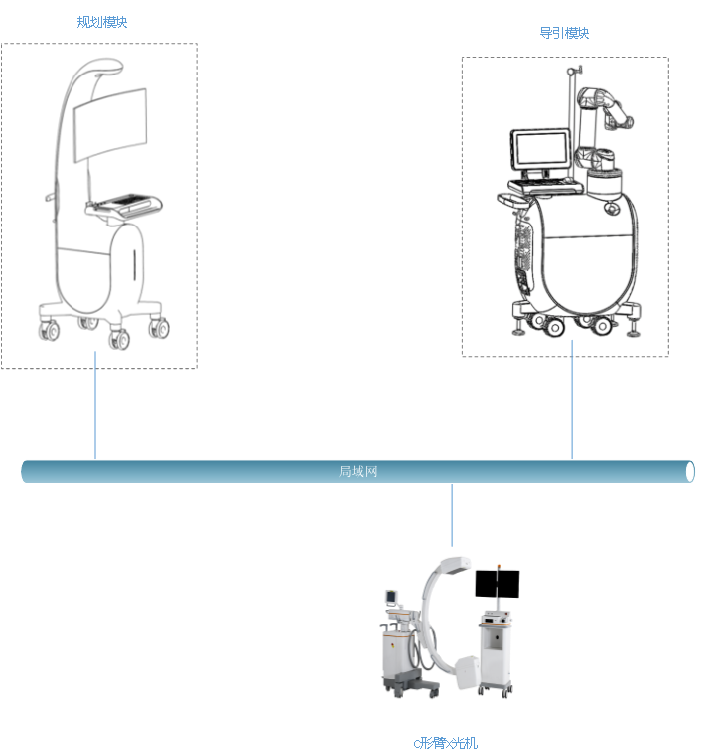
03-设计开发输出阶段/01系统/MS-001网络拓扑图.png
