santan444/MS001/03-设计开发输出阶段/研发设备、工具、测试环境管理/MS001.01.007SM.1.0 研发、生产、检验设备清单列表.docx

MS001.01.007SM.1.0

MS-001

研发、生产、检验设备清单

编制/日期：

审核/日期：

批准/日期：

杭州三坛医疗科技有限公司

文档更改履历

版本号 | 发布/实施日期 | 更改内容概述 | 更改者
V1.0 | | 文件新编

研发、生产、检验设备清单

序号 | 设备名称 | 型号/规格 | 数量 | 主要技术参数 | 备注
1 | 数字万用表 | VC97 | 1 | / | 研发测试数据用
2 | 直流稳压电源 | RIGOL DP832 | 1 | / | 研发测试用
3 | 示波器 | RIGOL DL3021 | 1 | 150V/40A 200W | 研发测试用
4 | 静电放电发生器 | PESD6030 | 1 | / | 研发EMC测试用
5 | 条码打印机 | T-4503E | 1 | / | 打印线缆标签
6 | 防静电手腕测试仪 | HAKK0498 | 1 | / | 电子器件安装人员用
7 | 色差仪 | WR-10 | 1 | ΔE<0.08 | 质量监测外观用
8 | 表面电阻率测试仪 | HZR-100 | 1 | / | 安规检测用
9 | 医用接地电阻测试仪 | CC2521E | 1 | AC220V/50Hz/5A | 安规检测用
10 | 医用耐电压测试仪 | CC2670E | 1 | AC220V/50Hz/5A | 安规检测用
11 | 医用泄漏电流测试仪 | CC2675E | 1 | AC220V/50Hz/5A | 安规检测用
12 | 电子防潮柜 | 350L | 1 | / | 生产物料储存
13 | 冰柜 | / | 1 | / | 测试物料冷冻
14 | 推拉力测试仪 | SF-50 | 1 | 0-50N | 研发碰撞测试用
15 | 三坐标测量仪 | Explorer classic 06.08.06 | 1 | / | 研发生产TCP标定用
16 | 激光功率仪 | LP1 | 1 | / | 研发及质量测激光用
17 | C形臂X光机 | Compact L | 1 | / | 临床整机调试用
18 | 冲击试验机 | / | 1 | / | /
19 | 立式压力蒸汽灭菌器 | LS-35HD 下排气式 | 1 | 设计温度136℃ 设计压力0.23MPa | 器械高温消毒测试用
20 | 超声波清洗机 | BG-01 | 1 | AC 250V/5A DC 115V/0.4A | 器械清洗消毒测试用
21 | 高低温箱 | WHTM-150BO | 1 | / | 研发老化实验用
22 | 三坐标测量仪 | Explorerclassic 06.08.06 | 1 | / | 研发生产标定数据用
23 | 光纤激光打标机 | BK-G20 | 1 | / | 生产打标用
24 | 角度尺 | / | 1 | / | 测量角度用
25 | 可见光频谱仪 | / | 1 | / | 测激光波长用
26 | 激光三坐标仪 | / | 1 | / | 研发测试用
