santan444/MS001/03-设计开发输出阶段/02电子/05物料证书/UPS/CASTLE 1K(6G)  CASTLE 1KS(6G) CQC证书2017-2025.pdf

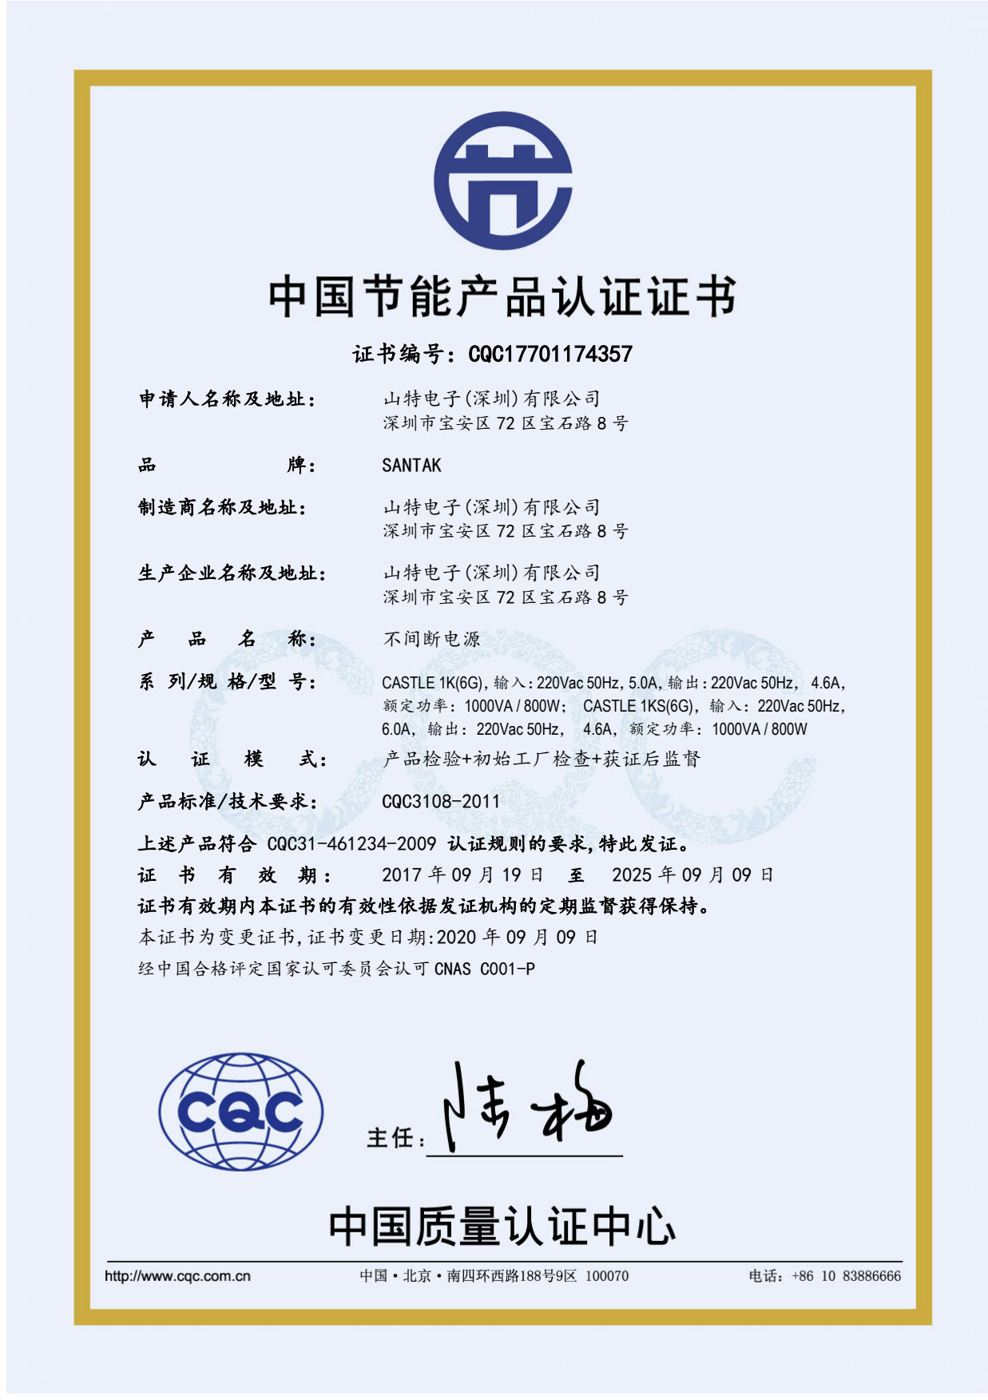
[picture p170: page 1]

证书编号：CQC17701174357

申请人名称及地址： 山特电子(深圳)有限公司
深圳市宝安区 72 区宝石路 8 号
品 | | | 牌： | SANTAK
制造商名称及地址： | 山特电子(深圳)有限公司
| | | | 深圳市宝安区 72 区宝石路 8 号
生产企业名称及地址： | 山特电子(深圳)有限公司
| | | | 深圳市宝安区 72 区宝石路 8 号
产 | 品 | 名 | 称： | 不间断电源
系 列/规 格/型 号： | CASTLE 1K(6G)，输入：220Vac 50Hz，5.0A，输出：220Vac 50Hz，4.6A，
| | | | 额定功率：1000VA / 800W； CASTLE 1KS(6G)，输入：220Vac 50Hz， 6.0A，输出：220Vac 50Hz， 4.6A，额定功率：1000VA / 800W
认 | 证 | 模 | 式： | 产品检验+初始工厂检查+获证后监督
产品标准/技术要求： | CQC3108-2011

上述产品符合 CQC31-461234-2009 认证规则的要求,特此发证。
证 书 有 效 期 ： | 2017 年 09 月 19 日 至 | 2025 年 09 月 09 日
证书有效期内本证书的有效性依据发证机构的定期监督获得保持。 本证书为变更证书,证书变更日期:2020 年 09 月 09 日

经中国合格评定国家认可委员会认可 CNAS C001-P
