santan444/MS001/03-设计开发输出阶段/采购管理/MS-001关键物料规格书.xlsx

序号 | 名称 | 厂家 | 型号 | 认证标准 | 证书编号
1 | 变压器 | 德力西 | BK-1000VA | CE | M.2018.201.N7850
2 | 电源插座 | SCHURTER | DD12.9321.111 | IEC/UL 60601-1 | VDE: 40001522 UL: E72928
3 | 熔断器 | 深圳市良胜电子 | 5JF5AL250V | VDE/UL | VDE:40009306 UL: E221465
4 | 开关电源 | VOXPOWER | NEVO+600M | UL60601 3rd Edition | DK-52068-A3-M1-ULE316486
5 | 机械臂显示器 | 荣歌 | FC-1560CF | CCC | 2020010903319530
6 | 三维显示器 | 优派 | VX3515-2KC-PRO | UL60601-1 | 2018010903123520
7 | 机械臂主机 | 惠普HP | EliteDesk800 G5 Desktop Mini | CCC | 2020010901298351
8 | 三维主机 | 惠普HP | ProDesk680 G5 PCIMT | CCC | 2020010901318512
9 | UR机械臂 | 优傲 | UR5 OEM 版本 | TUV | T72190266 01
10 | 5口交换机 | 腾达 | TEG1005D | CCC | 2016011608922330
11 | 升降立柱 | 捷昌 | JC35EN2-0-A-4-4-24-60/260-0-1-02-2D0-07-G | UL | E355312-D1001-1/A1/C0
12 | 脚轮 | TENTE | 5947UAP125P30-13 | EN 12530 | 770167
13 | 急停开关 | 和泉 | AVW411R/02R/20R | UL | E68961
14 | 脚踏开关 | 三实 | BVR 450/750V 2.5-6 | CCC | 2021010105411170
15 | UPS | 山特 | CASTLE 6G（C1K） | TLC | 0301846121555R1L
