santan444/MS001/03-设计开发输出阶段/采购管理/MS-001关键物料采购建议.xls

MS-001关键物料采购建议
序号 | 名称 | 型号 | 规格尺寸 | 单套配置数量 | 认证标准 | 参考图 | 厂家 | 备注
1 | 变压器 | BK-1000VA | 功率1000VA 输入220V 输出220V | 1 | CE |  | 德力西
2 | 电源插座 | DD12.9321.111 | 额定电压(AC)：250V 额定电流:10 A | 1 | IEC/UL 60601-1 |  | SCHURTER
3 | 熔断器 | F5AL250V | 250V，5A | 2 | IEC 60127-2 |  | 良胜电子
4 | 开关电源 | NEVO+600M | 额定功率:600W | 1 | UL60601 3rd Edition |  | VOXPOWER | 3路（5V、12V、24V）
5 | 机械臂显示器 | 工业显示器 | FC-1560CF | 1 | CCC |  | 荣歌
6 | 三维显示器 | VX3515-2KC-PRO | 分辨率：3440*1440 3尺寸：5寸 | 1 | CCC |  | 优派
7 | 导引模块主机 | 型号：惠普HP EliteDesk800 G6 Desktop Mini | CPU:英特尔i3-10100（3.6Ghz/6M/4核） 显卡：集成显卡 硬盘：512G（SSD） 内存：8G （DDR4-2666） 电源：90W外置电源适配器 尺寸：17.7x17.5x3.4cm | 1 | CCC | =DISPIMG("图片 1",1) | 惠普 | 选择有串口的
8 | 规划模块主机 | 惠普HP ProDesk680 G5 PCIMT | CPU:英特尔i5-10100（3.1Ghz/12M/6核） 显卡:NVIDIA RTX2060 6G显存 硬盘：1T（SSD） 内存：8G（DDR4-2666） 电源：400W80Plus白金电源 尺寸：17x27.7x33.8cm | 1 | CCC |  | 惠普
9 | UR机械臂 | UR5 OEM 版本 | 6轴 | 1 | CE/TUV |  | 优傲 | 联系UR机械臂代理采购 要求系统版本13版
10 | 5口交换机 | TEG1005D |  | 2 | CCC |  | 腾达
11 | 升降立柱 | JC35EN2-0-A-4-4-24-60/260-0-1-02-2D0-07-G |  | 1 | UL |  | 捷昌 | 4000N，行程60mm 联系捷昌驱动代理采购
12 | 脚轮 | 5947UAP125P30-13 |  | 8 | EN 12530 |  | TENTE
13 | 急停开关 | AVW411R/02R/20R |  | 1 | UL |  | 和泉
14 | 脚踏开关 | FS-81-SP-2-20 |  | 1 | TUV |  | 三实
15 | UPS | CASTLE 6G（C1K） |  | 1 | CE |  | 山特
