santan444/MS001/03-设计开发输出阶段/06BOM/辅料BOM/MS001-A.01.002MX.1.1规划模块辅料明细表.xls

三坛医疗 |  |  | 产品名称 | 规划模块 | 辅料 明细表 |  | 编制/日期 | 审核/日期 | 批准/日期
产品型号 |  | MS-001 | 文件号 | MS001-A.01.002MX.1.1
序号 | 物料等级 | 物料编码 | 图号/标准 | 名称 | 数量 | 材料 | 规格 | 备注 | 参考 供应商
紧固件
1 |  |  |  | 等高螺丝 | 10 | 304 | 5xM4x6 | M4螺纹高度5 |  | https://detail.tmall.com/item.htm?id=601075915248&ns=1&abbucket=17&skuId=4327895313549
2 |  |  | GB/T 819.1 | 十字沉头螺钉 | 10 | 304 | M3x8 | 8+2
3 |  |  | GB/T 819.1 | 十字沉头螺钉 | 20 | 304 | M4x8 | 2+4+4+10
4 |  |  | GB/T 70.1 | 内六角圆柱头螺钉 | 4 | 304 | M3x8 |  |  | 6颗USB延长线
5 |  |  | GB/T 70.1 | 内六角圆柱头螺钉 | 6 | 304 | M3x6 | 4+2
6 |  |  | GB/T 70.1 | 内六角圆柱头螺钉 | 8 | 304 | M3x4 | 8+
7 |  |  | GB/T 70.1 | 内六角圆柱头螺钉 | 9 | 304 | M4x8 | 4+5
8 |  |  | GB/T 70.1 | 内六角圆柱头螺钉 | 2 | 304 | M4x16 | 2
9 |  |  | GB/T 70.1 | 内六角圆柱头螺钉 | 4 | 304 | M12x120 | 4
10 |  |  | GB/T 9074.4 | 十字盘头组合螺钉 | 2 | 304 | M4x16 | 2
11 |  |  | GB/T 9074.4 | 十字盘头组合螺钉 | 52 | 304 | M4x12 | 2+2+4+24+4+14+2
12 |  |  | GB/T 9074.4 | 十字盘头组合螺钉 | 64 | 304 | M4x8 | 4+4+2+4+3+12+6+4+2+8+4+3+4+3+1
13 |  |  | GB/T 9074.4 | 十字盘头组合螺钉 | 4 | 304 | M4x6 | 4
14 |  |  | GB/T 9074.4 | 十字盘头组合螺钉 | 4 | 304 | M5x20 | 4
15 |  |  | GB/T 9074.4 | 十字盘头组合螺钉 | 9 | 304 | M5x16 | 5+4
 |  |  | GB/T 97.1 | 平垫 | 4 | 304 | 13*24*2.5 | 4
 |  |  | GB/T 93 | 弹垫 | 4 | 304 | M12 | 4
其它（胶水、轧带等）
1 |  |  |  | ZR- BVR线缆 | 2m |  | 黄绿色
2 |  |  |  | 16AWG线缆 | 2m |  | 蓝色
3 |  |  |  | 16AWG线缆 | 2m |  | 黄色
4 |  |  |  | 16AWG线缆 | 2m |  | 棕色
5 |  |  |  | 22AWG线缆 | 3m |  | 黑色
6 |  |  |  | 22AWG线缆 | 3m |  | 红色
7 |  |  |  | 编织套管 | 10m |  | 8mm
8 |  |  |  | 透明热缩管 | 5m |  | 6mm
9 |  |  |  | 透明热缩管 | 5m |  | 10mm
10 |  |  |  | 母绝缘线接头 | 10颗 |  | FDD1.25-187(5) 红色
11 |  |  |  | U型插片 | 10颗 |  | UT2.5-4
12 |  |  |  | O型插片 | 4颗 |  | OT2.5-16
13 |  |  |  | 直插插片 | 10颗 |  | C45-4
14 |  |  |  | 接插件 | 5颗 |  | SM2.5-4Pin(母头)
15 |  |  |  | 接插件 | 5颗 |  | PHB-4Y（母头）
16 |  |  |  | 扎带 | 10根 |  | 3x150
17 |  |  |  | 标签纸 | 40张 |  | 20x10mm
18 |  |  |  | 热缩套管 | 2m |  | 2mm
19 |  |  |  | 热缩套管 | 2m |  | 4mm
20 |  |  |  | 热缩套管 | 2m |  | 6mm
21 |  |  |  | 热缩套管 | 2m |  | 8mm
