santan444/MS001/03-设计开发输出阶段/06BOM/辅料BOM/MS001-B.01.002MX.1.1导引模块辅料明细表.xls

三坛医疗 |  |  | 产品名称 | 导引模块 | 辅料 明细表 |  | 编制/日期 | 审核/日期 | 批准/日期
产品型号 |  | MS-001 | 文件号 | MS001-B.01.002MX.1.1
序号 | 物料等级 | 物料编码 | 图号/标准 | 名称 | 数量 | 材料 | 规格 | 备注 | 参考 供应商
紧固件
1 |  |  | GB/T 819.1 | 十字沉头螺钉 | 6 | 304 | M3x10
2 |  |  | GB/T 819.1 | 十字沉头螺钉 | 40 | 304 | M4x8
3 |  |  | GB/T 819.1 | 十字沉头螺钉 | 2 | 304 | M5x8
4 |  |  | GB/T 70.1 | 内六角圆柱头螺钉 | 4 | 304 | M3X20
5 |  |  | GB/T 70.1 | 内六角圆柱头螺钉 | 9 | 304 | M3X8
6 |  |  | GB/T 70.1 | 内六角圆柱头螺钉 | 9 | 304 | M3X6
7 |  |  | GB/T 70.1 | 内六角圆柱头螺钉 | 9 | 304 | M4X8
8 |  |  | GB/T 70.1 | 内六角圆柱头螺钉 | 6 | 304 | M5X16
9 |  |  | GB/T 70.1 | 内六角圆柱头螺钉 | 6 | 304 | M5X20
10 |  |  | GB/T 70.1 | 内六角圆柱头螺钉 | 6 | 304 | M6X20
11 |  |  | GB/T 70.1 | 内六角圆柱头螺钉 | 6 | 304 | M8X20
12 |  |  | GB/T 70.1 | 内六角圆柱头螺钉 | 12 | 304 | M8X30
13 |  |  | GB/T 70.1 | 内六角圆柱头螺钉 | 35 | 304 | M8X50
14 |  |  | GB/T 70.1 | 内六角圆柱头螺钉 | 3 | 304 | M10X75
15 |  |  | GB/T 70.1 | 内六角圆柱头螺钉 | 5 | 304 | M12X80
16 |  |  | GB/T 9074.4 | 十字盘头组合螺钉 | 5 | 304 | M3x8
17 |  |  | GB/T 9074.4 | 十字盘头组合螺钉 | 53 | 304 | M4x12
18 |  |  | GB/T 9074.4 | 十字盘头组合螺钉 | 5 | 304 | M4x8
19 |  |  | GB/T 96.2 | 平垫 | 12 | 304 | 5
20 |  |  | GB/T 96.2 | 平垫 | 53 | 304 | 8
21 |  |  | GB/T 96.2 | 平垫 | 5 | 304 | 12
22 |  |  | GB/T 93 | 弹簧垫圈 | 12 | 304 | 5
23 |  |  | GB/T 93 | 弹簧垫圈 | 53 | 304 | 8
24 |  |  | GB/T 93 | 弹簧垫圈 | 5 | 304 | 12
25 |  |  | GB/T 6170 | 六角螺母 | 2 | 304 | M5
26 |  |  | GB/T 6170 | 六角螺母 | 2 | 304 | M8
27 |  |  | GB/T 818 | 十字盘头螺钉 | 12 | 白色尼龙 | M3x20
28 |  |  | GB/T 6170 | 十字盘头螺钉 | 9 | 白色尼龙 | M3x10
其它（胶水、轧带等）
1 |  |  |  | 扎带 | 10根 |  | 3*150
2 |  |  |  | ZR- BVR线缆 | 2m |  | 黄绿色
3 |  |  |  | 16AWG线缆 | 30m |  | 蓝色
4 |  |  |  | 16AWG线缆 | 30m |  | 棕色
5 |  |  |  | 16AWG线缆 | 30m |  | 黄色
6 |  |  |  | 22AWG线缆 | 30m |  | 红色
7 |  |  |  | 22AWG线缆 | 30m |  | 黑色
8 |  |  |  | 22AWG线缆 | 30m |  | 蓝色
9 |  |  |  | 22AWG线缆 | 30m |  | 绿色
10 |  |  |  | 22AWG线缆 | 30m |  | 黄色
11 |  |  |  | 22AWG线缆 | 30m |  | 白色
12 |  |  |  | 母绝缘线接头 | 10颗 |  | FDD1.25-187(5) 红色
13 |  |  |  | U型插片 | 50颗 |  | UT2.5-4
14 |  |  |  | U型插片 | 5颗 |  | UT2.5-6
15
16 |  |  |  | 接插件 | 20颗 |  | HT396K-3.96-4P-14-00A（母头）
17 |  |  |  | 接插件 | 15颗 |  | HT396K-3.96-2P-14-00A（母头）
18 |  |  |  | 接插件 | 5颗 |  | HT396K-3.96-5P-14-00A（母头）
19 |  |  |  | 接插件 | 10颗 |  | PHB-4Y母头
20 |  |  |  | 接插件 | 15颗 |  | SM2.5-2Pin公/母头
21 |  |  |  | 接插件 | 5颗 |  | SM2.5-3Pin公/母头
22 |  |  |  | 接插件 | 5颗 |  | SM2.5-4Pin公/母头
23 |  |  |  | 接插件 | 10颗 |  | PHB-2Y母头
24 |  |  |  | 直插插片 | 20颗 |  | C45-4
25 |  |  |  | O型插片 | 5颗 |  | OT2.5-16
26 |  |  |  | 编织套管 | 50m |  | 6mm |  |  | https://detail.tmall.com/item.htm?id=566406828196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
27 |  |  |  | 编织套管 | 50m |  | 8mm
28 |  |  |  | 编织套管 | 50m |  | 10mm
29 |  |  |  | 热缩管 | 10m |  | 2mm
30 |  |  |  | 热缩管 | 10m |  | 4mm
31 |  |  |  | 热缩管 | 10m |  | 6mm |  |  | https://detail.tmall.com/item.htm?id=566406828196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
32 |  |  |  | 热缩管 | 10m |  | 8mm
33 |  |  |  | 热缩管 | 10m |  | 10mm
34 |  |  |  | 透明热缩管 | 10m |  | 4mm
35 |  |  |  | 透明热缩管 | 10m |  | 6mm
36 |  |  |  | 透明热缩管 | 10m |  | 8mm
37 |  |  |  | 透明热缩管 | 10m |  | 10mm
38 |  |  |  | 标签纸 | 150 |  | 20x10mm
39 |  |  |  | 螺纹胶 | 1瓶 |  | 304胶水
40 |  |  |  | 焊锡 | 1卷 |  | 0.8mm 500g
41 |  |  |  | 导线槽 | 3m
42 |  |  |  | 钢丝绳 | 3m |  | 直径2mm 承重80kg
43 |  |  |  | 钢丝绳锁线器 | 6套 |  | 竖双孔
 |  |  |  | 螺丝盖 | 4 |  | 8mm
 |  |  |  |  |  |  |  |  |  | https://item.taobao.com/item.htm?spm=a1z10.5-c.w4002-17356780314.11.27121911Hr5sHv&id=37055685176
