santan444/MS001/03-设计开发输出阶段/02电子/MS001.06.004ZZ.1.1-按键板/02_物料清单/MS001.06.004WL.1.1-按键板-物料清单.xlsx

三坛医疗 |  |  | 组件名称 | 按键板 |  | 电路板组件 物料明细表 | 编制/日期 |  | 审核/日期 | 批准/日期
产品型号 |  | MS-001 | 文件号 | MS001.06.004WL.1.1
电路板组件
组件编码 |  | 610130005 | 按键板
物料明细
序号 | 物料类型 | 物料编码 | 名称/规格 | 厂家 | 封装 | 位号 | 数量 | 替代编码 | 替代名称/规格 | 替代厂家
1 | 开关 | 610110007 | K2-1817UQ-A4SW-01 | 韩国韩荣 | SMD-6*6mm | K1，K2 | 2
2 | 连接器 | 610060039 | PHB-4AWB | LHE（浙江联合） | PHB-4AWB | J1 | 1
3 | PCB板 | 617010018 | MS001.06.004YL.1.1 | 睿索科技 |  |  | 1
4
5
6
7
8
9
10
11
12
13
14
15
16
17
18
19
20
21
22
23
24
25
26
27
28
29
30
31
32
33
34
35
36
37
