santan444/MS001/03-设计开发输出阶段/02电子/MS001.06.005ZZ.1.1-LED灯板（MS001-A规划模块）/02_物料清单/MS001.06.005WL.1.1-LED灯板-物料清单.xlsx

三坛医疗 |  |  | 组件名称 | LED灯板 |  | 电路板组件 物料明细表 | 编制/日期 |  | 审核/日期 | 批准/日期
产品型号 |  | MS-001 | 文件号 | MS001.06.005WL.1.1
电路板组件
组件编码 |  | 610130006 | LED灯板
物料明细
序号 | 物料类型 | 物料编码 | 名称/规格 | 厂家 | 封装 | 位号 | 数量 | 替代编码 | 替代名称/规格 | 替代厂家
1 | 贴片LED | 610040071 | HL-AM-2835H489BC-S1-08HL | 鸿利光电 | SMT-2.8*3.5mm | D1-D12 | 12
2 | 贴片电阻 | 610016149 | RC0805JR-07130RL | 国巨 | R0805 | R1-R12 | 12
3 | 连接器 | 610060046 | PHB-2A | LHE（浙江联合） | PHB-2A | J1 | 1
4 | PCB板 | 617010019 | MS001.06.005YL.1.1 | 睿索科技 |  |  | 1
5
6
7
8
9
10
11
12
13
14
15
16
17
18
19
20
21
22
23
24
25
26
27
28
29
30
31
32
33
34
35
36
37
38
39
40
