santan444/MS001/03-设计开发输出阶段/04结构/04结构图/MS001.01.005ZX.1.1装箱清单.docx

MS001.01.005ZX.1.1

MS-001

装箱清单

编制/日期：

审核/日期：

批准/日期：

杭州三坛医疗科技有限公司

文档更改履历

版本号 | 发布/实施日期 | 更改内容概述 | 更改者
V1.1 | | 文件新编

装箱清单

产品名称 | 模块化手术导引系统
型号规格 | MS-001
产品编号
序 号 | 部件名称 | 单位 | 数量 | 备注
1 | 规划台车 | 台 | 1
2 | 导引台车 | 台 | 1
3 | 工具包 | 套 | 1
4 | 体位反馈模块 | 台 | 1
5 | 显示器Ⅰ | 台 | 1 | 带原包装M4螺钉
6 | 显示器Ⅱ | 台 | 1 | 带4颗M4X12组合螺钉
7 | 机械臂 | 台 | 1 | 带4颗M8X20螺钉
8 | 支撑杆 | 件 | 1
9 | 连接件 | 件 | 1
10 | 电源线 | 根 | 2 | 线长3米
11 | 脚踏开关 | 个 | 1 | 线长2米
12 | 网线 | 根 | 2 | 线长15米

随机技术文件
13 | 模块化手术导引系统使用说明书 | 本 | 1
14 | 模块化手术导引系统安装说明书 | 份 | 1
15 | 合格证 | 份 | 1
16 | 装箱清单 | 份 | 1
