santan444/MS001/03-设计开发输出阶段/02电子/05物料证书/UPS/山特C1-3K CE认证承诺.PDF

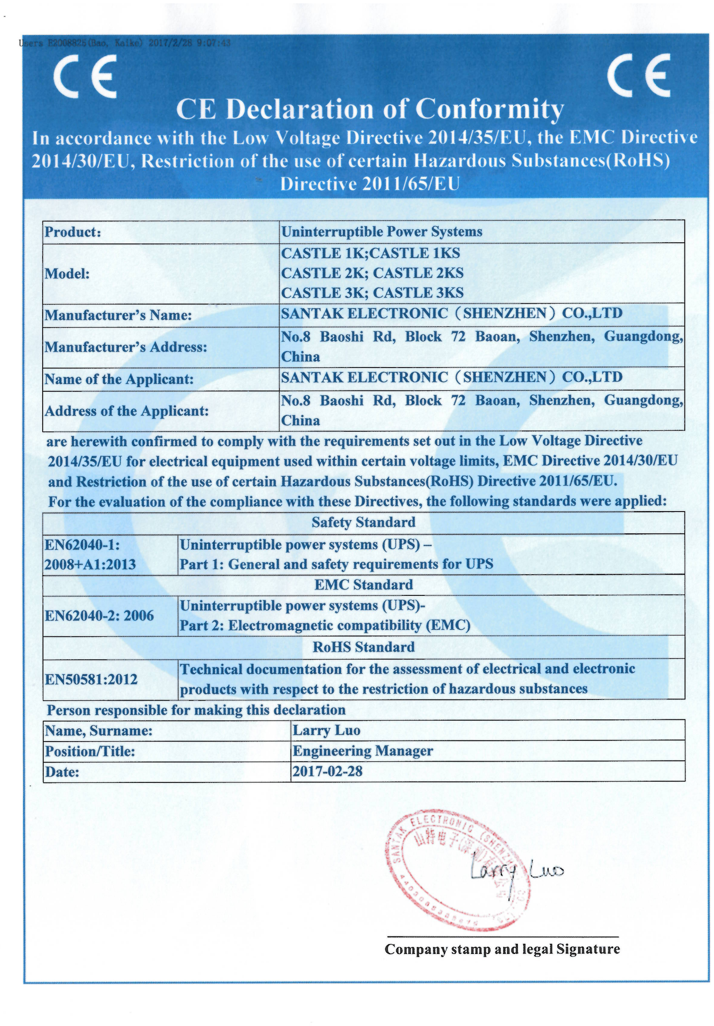
[picture p171: page 1]
