santan444/MS001/03-设计开发输出阶段/02电子/05物料证书/温控开关/KSD9700-5A铁壳（中文版）.pdf

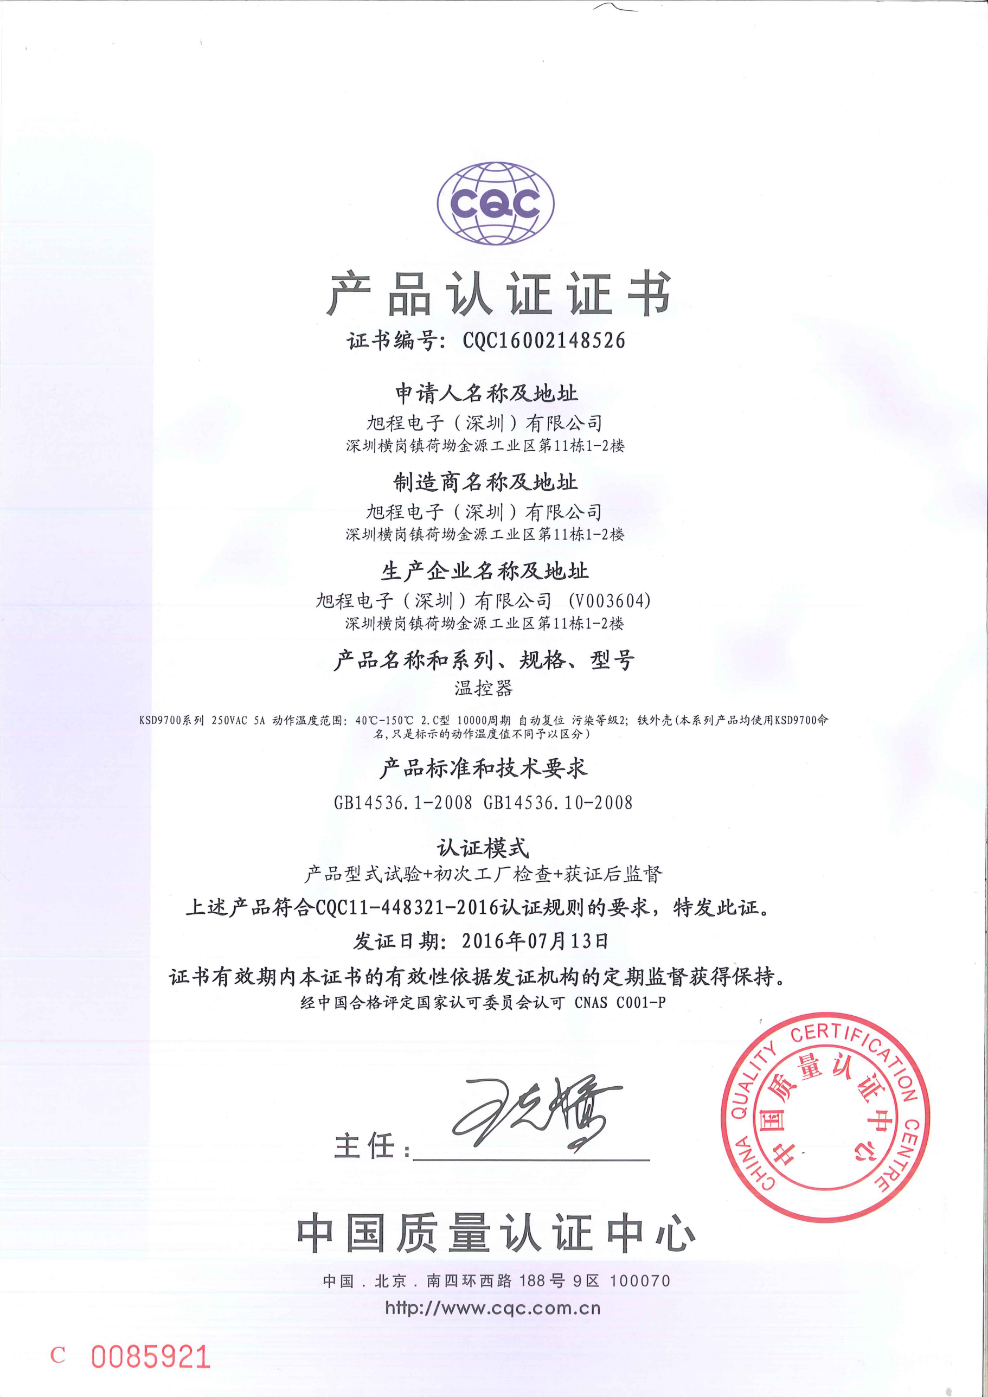
[picture p172: page 1]
