santan444/MS001/03-设计开发输出阶段/02电子/05物料证书/熔断器/F5AL250V 3C证书.pdf

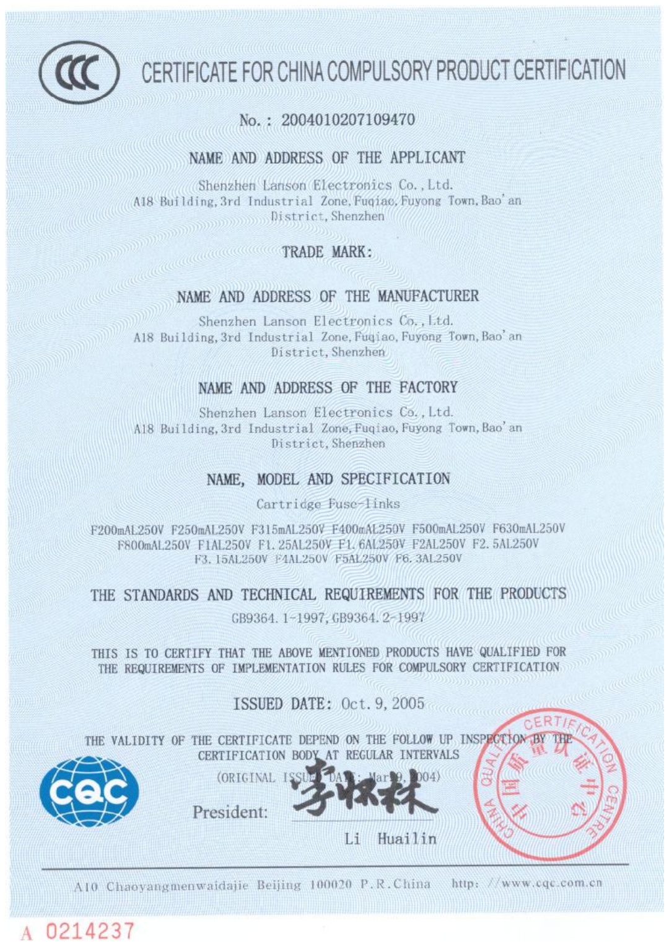
[picture p173: page 1]

PDF 文件使用 "pdfFactory Pro" 试用版本创建 www.fineprint.cn
