santan444/MS001/03-设计开发输出阶段/02电子/05物料证书/脚轮声明/Scan_20210802_104135（符合性声明）.pdf

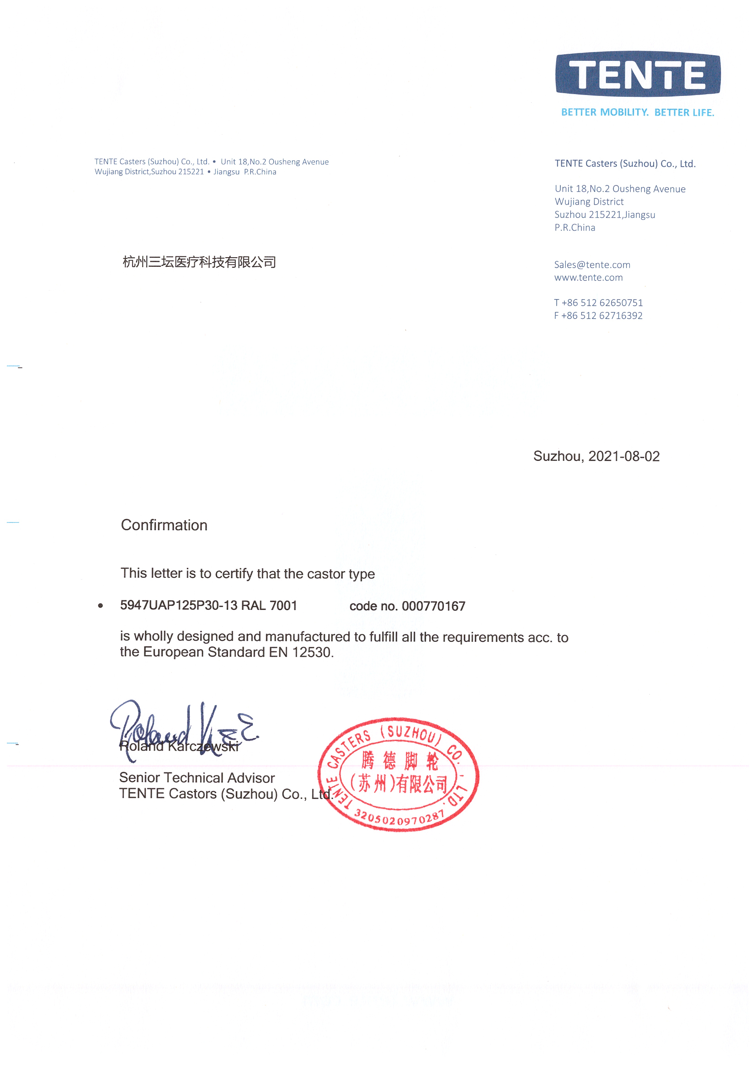
[picture p174: page 1]
