santan444/MS001/03-设计开发输出阶段/06BOM/MS001-A.01.001MX.1.1 规划模块物料明细表.xls

三坛医疗 |  |  | 组件名称 | 规划模块 | 组件物料 明细表 |  | 编制/日期 | 审核/日期 | 批准/日期
产品型号 |  | MS-001 | 文件号 | MS001-A.01.001MX.1.1
序号 | 物料等级 | 物料编码 | 图号/标准 | 名称 | 数量 | 材料 | 型号/规格 | 备注 | 参考 供应商
组件
1 |  | 200000028 | MS001-A.01.001ZZ.1.1 | 规划模块 | 1
部件
1 |  | 200000029 | MS001-A.02.001JX.1.1 | MS001-A框架总成 | 1
2 |  | 200000030 | MS001-A.03.001JX.1.1 | MS001-A外观总成 | 1
3 |  | 200000031 | MS001-A.04.001JX.1.1 | MS001-A侧面板总成 | 1
4 |  | 200000032 | MS001-A.05.001JX.1.1 | MS001-A工作台总成 | 1
5 |  | 200000033 | MS001-A.06.001JX.1.1 | MS001-A运输包装 | 1
加工件明细（机加工、钣金、塑料手板、3D打印、注塑件、线缆图等）
1 | C | 611020427 | MS001-A.01.001DY.1.1 | MS001-A下部面板电源输入线缆 | 1 |  |  | 自制线
2 | C | 611020428 | MS001-A.01.002DY.1.1 | MS001-A 220V电源输入线 | 1 |  |  | 自制线
3 | C | 611020429 | MS001-A.01.003DY.1.1 | MS001-A主机电源线 | 1 |  |  | 自制线
4 | C | 611020430 | MS001-A.01.004DY.1.1 | MS001-A显示器电源线 | 1 |  |  | 自制线
5 | C | 611020432 | MS001-A.01.005DY.1.1 | MS001-A LED灯条线1 | 2 |  |  | 自制线
6 | C | 611020433 | MS001-A.01.006XH.1.1 | MS001-A LED灯条线2 | 1 |  |  | 自制线
7 | C | 611020434 | MS001-A.01.007XH.1.1 | MS001-A计算机开关延长线组件 | 1 |  |  | 自制线
8 | B | 611020435 | MS001-A.02.002JS.1.1 | MS001-A外壳上部固定钣金 | 1 | 304
9 | B | 611020436 | MS001-A.02.003SL.1.1 | MS001-A显示器适配器支架 | 1 | ABS
10 | B | 611020437 | MS001-A.02.004JS.1.1 | MS001-A显示器支架转接件 | 1 | 6061
11 | B | 611020438 | MS001-A.02.005JS.1.1 | MS001-A显示器藏线支座 | 1 | 6061
12 | B | 611020439 | MS001-A.02.006JS.1.1 | MS001-A显示器藏线支座盖板 | 1 | 6061
13 | B | 611020440 | MS001-A.02.007SL.1.1 | MS001-A锁紧座1 | 1 | ABS
14 | B | 611020441 | MS001-A.02.008JS.1.1 | MS001-A焊接框架 | 1 | 304
 |  | / | MS001-A.02.023JS.1.1 | MS001-A框架上顶板 | 1 | 304 |  | 与焊接框架焊接成一体
15 | B | 611020442 | MS001-A.02.009JS.1.1 | MS001-A工作台支撑板 | 1 | Q235
16 | B | 611020443 | MS001-A.02.010JS.1.1 | MS001-A工作台支撑柱 | 1 | 304
17 | B | 611020444 | MS001-A.02.011SL.1.1 | MS001-A右侧灯条支架 | 1 | POM
18 | B | 611020445 | MS001-A.02.012JS.1.1 | MS001-A台车把手固定支架 | 1 | 304
19 | B | 611020446 | MS001-A.02.013SL.1.1 | MS001-A外壳侧部固定支架 | 2 | ABS
20 | B | 611020447 | MS001-A.02.014JS.1.1 | MS001-A交换机固定支架 | 1 | 304
21 | B | 611020448 | MS001-A.02.015JS.1.1 | MS001-A电器组件固定支架 | 1 | 304
22 | B | 611020449 | MS001-A.02.016JS.1.1 | MS001-A前灯条支架 | 1 | 304
23 | B | 611020450 | MS001-A.02.017JS.1.1 | MS001-A主机固定支架 | 1 | 304
24 | B | 611020451 | MS001-A.02.018JS.1.1 | MS001-A滚轮支撑柱 | 4 | 6061
25 | B | 611020452 | MS001-A.02.019SL.1.1 | MS001-A左侧灯条支架 | 1 | POM
26 | B | 611020453 | MS001-A.02.020JS.1.1 | MS001-A锁紧座2 | 1 | 304
27 | B | 611020597 | MS001-A.02.022JS.1.1 | MS001-A主机上钣金 | 1 | 304
28 | B | 611020599 | MS001-A.02.024JS.1.1 | MS001-A止转板 | 1 | 304
29 | B | 611020649 | MS001-A.02.025SL.1.1 | MS001-A灯条支架限位块 | 2 | ABS
30 | B | 611020677 | MS001-A.02.027SL.1.1 | MS001-A垫片 | 1 | 尼龙 |  |  |  | 采用铜网代替
31 | B | 611020678 | MS001-A.02.028JS.1.1 | MS001-A主机左固定支架 | 1 | 304
32 | B | 611020454 | MS001-A.03.002SL.1.1 | MS001-A外壳1 | 1 | ABS
33 | B | 611020455 | MS001-A.03.003SL.1.1 | MS001-A外壳2 | 1 | ABS
34 | B | 611020456 | MS001-A.03.004SL.1.1 | MS001-A外壳3 | 1 | ABS
35 | B | 611020457 | MS001-A.03.005SL.1.1 | MS001-A侧板 | 2 | ABS
36 | B | 611020459 | MS001-A.03.007SL.1.1 | MS001-A外壳4 | 1 | ABS
37 | B | 611020460 | MS001-A.03.008SL.1.1 | MS001-A外壳5 | 1 | ABS
38 | B | 611020461 | MS001-A.03.009SL.1.1 | MS001-A摄像头盖板 | 1 | ABS
39 | B | 611020462 | MS001-A.03.010SL.1.1 | MS001-A外壳6 | 1 | ABS
40 | B | 611020463 | MS001-A.03.011SL.1.1 | MS001-A显示器支架装饰罩 | 1 | ABS
41 | B | 611020464 | MS001-A.03.012SL.1.1 | MS001-A右侧透光板 | 1 | PC
42 | B | 611020465 | MS001-A.03.013SL.1.1 | MS001-A左侧透光板 | 1 | PC
43 | B | 611020466 | MS001-A.03.014SL.1.1 | MS001-A前侧透光板 | 1 | PC
44 | B | 611020600 | MS001-A.03.015SL.1.1 | MS001-A卡接块 | 10 | ABS
45 | B | 611020467 | MS001-A.04.002JS.1.1 | MS001-A侧面板 | 1 | 6061
46 | B | 611020468 | MS001-A.05.002SL.1.1 | MS001-A工作台外壳 | 1 | ABS
47 | B | 611020469 | MS001-A.05.003SL.1.1 | MS001-AUSB固定架 | 1 | ABS
48 | B | 611020470 | MS001-A.05.004SL.1.1 | MS001-A鼠标放置架 | 1 | ABS
49 | B | 611020471 | MS001-A.05.005JS.1.1 | MS001-A光驱固定钣金 | 1 | 304
50 | B | 611020472 | MS001-A.05.006SL.1.1 | MS001-A抽屉盒 | 1 | ABS
51 | B | 611020482 | MS001-A.05.007SL.1.1 | MS001-A工作台装饰条 | 1 | 亚克力板
52 | B | 611020651 | MS001-A.05.008JS.1.1 | MS001-A抽屉左支撑板 | 1 | 304
53 | B | 611020652 | MS001-A.05.009JS.1.1 | MS001-A抽屉右支撑板 | 1 | 304
54 | C | 612010065 | MS001-A.06.002MB.1.1 | MS001-A包装木箱 | 1 | 红色二等次胶合板
55 | C | 612010067 | MS001-A.06.003SL.1.1 | MS001-A珍珠棉1 | 1 | 珍珠棉
56 | C | 612010068 | MS001-A.06.004SL.1.1 | MS001-A珍珠棉2 | 1 | 珍珠棉
57 | C | 612010069 | MS001-A.06.005SL.1.1 | MS001-A珍珠棉3 | 1 | 珍珠棉
58 | C | 612010070 | MS001-A.06.006SL.1.1 | MS001-A珍珠棉4 | 1 | 珍珠棉
59 | C | 612010071 | MS001-A.06.007SL.1.1 | MS001-A珍珠棉5 | 1 | 珍珠棉
60 | C | 612010072 | MS001-A.06.008SL.1.1 | MS001-A珍珠棉6 | 1 | 珍珠棉
标准采购件明细（外购的各类机电类零部件、元器件等）
1 | A | 610130006 | MS001.06.005ZZ.1.1 | LED灯板 | 3 |  |  | 详见电子归档文件
2 | C | 611010134 |  | 交换机 | 1 |  | TEG1005D | 5口，5VDC | 腾达
3 | C | 611010119 |  | 二进十二出接线盒 | 1 |  | HS6/HY2-12a |  | 海胜
4 | B | 611010190 |  | 主机 | 1 |  | HP ProDesk680G6PCIMT | CPU：英特尔i5-10500（3.1Ghz6C65W） 内存：8G（DDR4-2666） 显卡：NVIDIARTX20608G独立显存 电源：550W电源 硬盘：1TSSD 机箱尺寸：15.5x30.3x33.7cm 预装系统：Windows10家庭版64Bit | 惠普总代
5 | C | 611010250 |  | 显示器*PRO | 1 |  | VX3515-2KC-PRO |  | 优派
6 | C | 611010197 |  | 电源模块-1233 | 1 |  | NEVO+600M-1233 | 一路5V 一路12V 24V两路并联 | 上海瑞率电源有限公司
7 | C | 611010114 |  | 滚轮 | 4 |  | 5947UAP125P30-13 |  | TENTE
8 | C | 611010200 |  | 键盘 | 1 |  | HW098A | 轻薄usb有线键盘鼠标套装白色 | 深圳市航世科技
9 | C | 611010199 |  | 鼠标 | 1 |  | M136U
10 | C | 611010236 |  | 22mm金属按钮插座 | 1 |  |  | 配22mm按钮，预留线定制（长1.5m） | FERNYE/丰奕电气
11 | C | 611010235 |  | 22mm金属带灯按钮 | 1 |  | FY1B-A/22F-10F/E+DY/B6 | 带电源标志颜色蓝色，电压5V，自复位平头 | FERNYE/丰奕电气
12 | C | 611010201 |  | USB延长线1.5m | 3 |  | U30-AF | 1.5m，USB3.0，带耳朵，公对母，带螺丝孔 | CY/辰阳
13 | C | 611010202 |  | 导轨 | 2 |  | MGN9C1R145L | 标准滑块 | 上银
14 | C | 611010203 |  | 按压式反弹器 | 1 |  | ML-120W |  | 蓝普/lamp
15 | C | 611010204 |  | 工作台旋转组件 | 1 |  | HG-S100-50 |  | 世嘉智尼
16 | C | 611010205 |  | USB外置光驱 | 1 |  | SE-086CM |  | 三星
17 | C | 611010217 |  | 电源接入连接器 | 1 |  | DD12.9321.111 |  | 得捷电子
18 | C | 611010198 |  | 网口延长线 | 4 |  | RJ45AM/AF | 1m，铜芯RJ45延长线，带螺丝孔,公对母
19 | C | 611010163 |  | 卡扣式防脱扣 | 1 |  | QT-102 | 电源插头卡扣式防脱扣 | 温州忧久科技
20 | C | 611010147 |  | 保险丝座 | 1 |  | 4301.1403 |  | 得捷电子
21 | C | 611010268 |  | 熔断器 | 2 |  | F5AL250V | 5*20 | 杰胜翔鹰
22 | C | 611010260 |  | HDMI数据线 | 1 |  | D0057 | 白色1.8m，2.1高清8k | DIGIFORCE 迪力科技
23 | C | 611010141 |  | 网线0.5米 | 1 |  | NW106 | 0.5m | 绿联
24 | C | 611010232 |  | MS001-APE薄膜塑料袋 | 1 |  | 900*2400*0.14mm
25 | C | 611010143 |  | 网线15米 | 1 |  | NW107 | 15m | 绿联
26 | C | 611010285 |  | 品字电源线-2.5平方 | 1 |  | 3x2.5平方 3C认证 | 3m | 优康
27 | C | 611010277 |  | USB延长线0.5米 | 4 |  | US103 | 0.5m,公对母不带耳朵 | 绿联
28 | C | 611010131 |  | USB延长线 | 1 |  | 1m | 公对公 | 绿联
