santan444/MS001/03-设计开发输出阶段/06BOM/MS001-B.01.001MX.1.1 导引模块物料明细表.xls

三坛医疗 |  |  | 组件名称 | 导引模块 | 组件物料 明细表 |  | 编制/日期 | 审核/日期 | 批准/日期
产品型号 |  | MS-001 | 文件号 | MS001-B.01.001MX.1.1
序号 | 物料等级 | 物料编码 | 图号/标准 | 名称 | 数量 | 材料 | 型号/规格 | 备注 | 参考 供应商
组件
1 |  | 200000034 | MS001-B.01.001ZZ.1.1 | 导引模块 | 1
部件
1 |  | 200000035 | MS001-B.02.001JX.1.1 | MS001-B升降总成 | 1
2 |  | 200000036 | MS001-B.03.001JX.1.1 | MS001-B框架总成 | 1
3 |  | 200000037 | MS001-B.04.001JX.1.1 | MS001-B外观总成 | 1
4 |  | 200000038 | MS001-B.05.001JX.1.1 | MS001-B工作台总成 | 1
5 |  | 200000039 | MS001-B.06.001JX.1.1 | MS001-B侧面板总成 | 1
6 |  | 200000040 | MS001-B.07.001JX.1.1 | MS001-B运输包装 | 1
加工件明细（机加工、钣金、塑料手板、3D打印、注塑件、线缆图等）
1 | C | 611020553 | MS001-B.01.001DY.1.1 | MS001-B接地线 | 1 |  |  | 自制线
2 | C | 611020554 | MS001-B.01.002DY.1.1 | MS001-B电源指示灯线 | 1 |  |  | 自制线
3 | C | 611020555 | MS001-B.01.003DY.1.1 | MS001-B铝壳电阻线 | 1 |  |  | 自制线
4 | C | 611020556 | MS001-B.01.004DY.1.1 | MS001-B隔离变压器输出线 | 1 |  |  | 自制线
5 | C | 611020557 | MS001-B.01.005DY.1.1 | MS001-B UPS输出线 | 1 |  |  | 自制线
6 | C | 611020558 | MS001-B.01.006DY.1.1 | MS001-B显示器电源线 | 1 |  |  | 自制线
7 | C | 611020559 | MS001-B.01.007DY.1.1 | MS001-B电脑电源线 | 1 |  |  | 自制线
8 | C | 611020560 | MS001-B.01.008DY.1.1 | MS001-B开关电源电源线 | 1 |  |  | 自制线
9 | C | 611020561 | MS001-B.01.009DY.1.1 | MS001-BUR控制箱电源线 | 1 |  |  | 自制线
10 | C | 611020562 | MS001-B.01.010XH.1.1 | MS001-B脚踏线 | 1 |  |  | 自制线
11 | C | 611020563 | MS001-B.01.011XH.1.1 | MS001-B计算机开关延长线组件 | 1 |  |  | 自制线
12 | C | 611020564 | MS001-B.01.012XH.1.1 | MS001-BUR开关输入控制线 | 1 |  |  | 自制线
13 | C | 611020565 | MS001-B.01.013XH.1.1 | MS001-B台车升控制线 | 1 |  |  | 自制线
14 | C | 611020566 | MS001-B.01.014XH.1.1 | MS001-B台车降控制线 | 1 |  |  | 自制线
15 | C | 611020567 | MS001-B.01.015XH.1.1 | MS001-BUR开关输出控制线 | 1 |  |  | 自制线
16 | C | 611020568 | MS001-B.01.016XH.1.1 | MS001-BUR上电反馈线 | 1 |  |  | 自制线
17 | C | 611020569 | MS001-B.01.017DY.1.1 | MS001-B 24V电源线 | 1 |  |  | 自制线
18 | C | 611020570 | MS001-B.01.018DY.1.1 | MS001-B 5V电源线 | 1 |  |  | 自制线
19 | C | 611020571 | MS001-B.01.019XH.1.1 | MS001-B立柱控制线 | 1 |  |  | 自制线
20 | C | 611020572 | MS001-B.01.020XH.1.1 | MS001-B急停开关线 | 1 |  |  | 自制线
21 | C | 611020573 | MS001-B.01.021XH.1.1 | MS001-B急停开关延长线 | 1 |  |  | 自制线
22 | C | 611020574 | MS001-B.01.022XH.1.1 | MS001-B脚踏控制线 | 1 |  |  | 自制线
23 | C | 611020575 | MS001-B.01.023XH.1.1 | MS001-B灯板线 | 1 |  |  | 自制线
24 | C | 611020576 | MS001-B.01.024XH.1.1 | MS001-B脚踏延长线 | 1 |  |  | 自制线
25 | C | 611020577 | MS001-B.01.025XH.1.1 | MS001-B线控手柄连接线 | 1 |  |  | 自制线
26 | C | 611020578 | MS001-B.01.026XH.1.1 | MS001-B线控手柄延长线 | 1 |  |  | 自制线
27 | C | 611020654 | MS001-B.01.027XH.1.1 | MS001-B UPS反馈线 | 1 |  |  | 自制线
28 | C | 611020655 | MS001-B.01.028XH.1.1 | MS001-B UPS开关中转线 | 1 |  |  | 自制线
29 | C | 611020656 | MS001-B.01.029XH.1.1 | MS001-B UPS开关延长线 | 1 |  |  | 自制线
30 | C | 611020657 | MS001-B.01.030XH.1.1 | MS001-B UPS反馈延长线 | 1 |  |  | 自制线
31 | C | 611020674 | MS001-B.01.031XH.1.1 | MS001-B线控手柄弹簧线 | 1 |  |  | 自制线
32 | C | 611020681 | MS001-B.01.032XH.1.1 | MS001-B脚踏开关线 | 1 |  |  | 自制线
33 | B | 611020486 | MS001-B.02.002JS.1.1 | MS001-B升降立柱顶板法兰 | 1 | Q235
34 | B | 611020487 | MS001-B.02.003JS.1.1 | MS001-B升降立柱顶板支撑柱 | 8 | Q235
35 | B | 611020488 | MS001-B.02.004JS.1.1 | MS001-B升降立柱底板法兰 | 1 | Q235
36 | B | 611020489 | MS001-B.02.005JS.1.1 | MS001-B升降立柱底板 | 1 | Q235
37 | B | 611020491 | MS001-B.03.003JS.1.1 | MS001-B工作台支撑法兰 | 1 | 304
38 | B | 611020492 | MS001-B.03.025JX.1.1 | MS001-B框架 | 1
 |  | / | MS001-B.03.004JS.1.1 | MS001-B焊接框架 | 1 | 304 |  | 框架附图一
 |  |  | MS001-B.03.002JS.1.1 | MS001-B焊接框架上支撑板 | 1 | 铝合金6061 |  | 框架附图二
 |  |  | MS001-B.03.007JS.1.1 | MS001-B焊接框架中支撑板 | 1 | Q235 |  | 框架附图三
39 | B | 611020493 | MS001-B.03.005JS.1.1 | MS001-B主机固定钣金 | 2 | 304
40 | B | 611020494 | MS001-B.03.006JS.1.1 | MS001-B主机电源适配器安装钣金 | 1 | 304
41 | B | 611020496 | MS001-B.03.008JS.1.1 | MS001-B焊接框架下支撑板 | 1 | Q235
42 | B | 611020497 | MS001-B.03.009JS.1.1 | MS001-B万向脚杯左支撑柱 | 1 | 铝合金6061
43 | B | 611020498 | MS001-B.03.010JS.1.1 | MS001-B UPS固定钣金一 | 1 | 304
44 | B | 611020499 | MS001-B.03.011JS.1.1 | MS001-B UPS固定钣金二 | 1 | 304
45 | B | 611020500 | MS001-B.03.012JS.1.1 | MS001-B机械臂控制箱固定钣金 | 1 | 304
46 | B | 611020501 | MS001-B.03.013JS.1.1 | MS001-B机械臂电源固定钣金 | 1 | 304
47 | B | 611020502 | MS001-B.03.014JS.1.1 | MS001-B显示器适配器安装支架 | 1 | 304
48 | B | 611020503 | MS001-B.03.015JS.1.1 | MS001-B机械臂支撑法兰 | 1 | 铝合金6061
49 | B | 611020506 | MS001-B.03.018JS.1.1 | MS001-B万向脚杯右支撑柱 | 1 | 铝合金6061
50 | B | 611020507 | MS001-B.03.019JS.1.1 | MS001-B万向脚杯前支撑柱 | 1 | 铝合金6061
51 | B | 611020508 | MS001-B.03.020JS.1.1 | MS001-B电路板安装钣金 | 1 | 304
52 | B | 611020509 | MS001-B.03.021JS.1.1 | MS001-B交换机安装钣金 | 1 | 304
53 | B | 611020579 | MS001-B.03.022JS.1.1 | MS001-B止转板 | 1 | SUS304
54 | B | 611020661 | MS001-B.03.023JS.1.1 | MS001-B电源模块安装钣金 | 1 | 304
55 | B | 611020662 | MS001-B.03.024JS.1.1 | MS001-B分线盒安装钣金 | 1 | 304
56 | B | 611020680 | MS001-B.03.026JS.1.1 | 支撑杆 | 1 | 铝合金
 |  | / | MS001-B.03.027JS.1.1 | 空心铝管 | 1 | 铝合金 |  | 支撑杆附图一
 |  |  | MS001-B.03.028JS.1.1 | 螺母 | 1 | 铝合金 |  | 支撑杆附图一
57 | B | 611020510 | MS001-B.04.002SL.1.1 | MS001-B外壳1 | 1 | ABS
58 | B | 611020511 | MS001-B.04.003SL.1.1 | MS001-B外壳2 | 1 | ABS
59 | B | 611020512 | MS001-B.04.004SL.1.1 | MS001-B外壳3 | 1 | ABS
60 | B | 611020513 | MS001-B.04.005SL.1.1 | MS001-B左侧板 | 1 | ABS
61 | B | 611020514 | MS001-B.04.006SL.1.1 | MS001-B遮蔽板 | 2 | ABS
62 | B | 611020515 | MS001-B.04.007SL.1.1 | MS001-B右侧板 | 1 | ABS
63 | B | 611020516 | MS001-B.04.008SL.1.1 | MS001-B外壳4 | 1 | ABS
64 | B | 611020517 | MS001-B.04.009SL.1.1 | MS001-B外壳5 | 1 | ABS
65 | B | 611020518 | MS001-B.04.010SL.1.1 | MS001-B透光罩 | 1 | PC
66 | B | 611020519 | MS001-B.04.011SL.1.1 | MS001-B机械臂装饰罩1 | 1 | ABS
67 | B | 611020520 | MS001-B.04.012SL.1.1 | MS001-B机械臂装饰罩2 | 1 | ABS
68 | B | 611020522 | MS001-B.04.013SL.1.1 | MS001-B收纳盖板 | 1 | ABS
69 | B | 611020648 | MS001-B.04.014JX.1.1 | MS001-B推手 | 1 | ABS+Q235 |  | 塑料包铁工艺
 |  | / | MS001-B.04.014SL.1.1 | MS001-B推手外壳 | 1 | ABS |  |  | 附图
 |  |  | MS001-B.04.014JS.1.1 | MS001-B推手加强金属件 | 1 | Q235 |  |  | 附图
70 | B | 611020523 | MS001-B.05.002SL.1.1 | MS001-B抽屉 | 1 | ABS
71 | B | 611020524 | MS001-B.05.003SL.1.1 | MS001-B工作台主体 | 1 | ABS
72 | B | 611020525 | MS001-B.05.004SL.1.1 | MS001-B显示器保护罩1 | 1 | ABS
73 | B | 611020526 | MS001-B.05.005SL.1.1 | MS001-B亚克力板 | 1 | PMMA
74 | B | 611020527 | MS001-B.05.006SL.1.1 | MS001-B显示器保护罩2 | 1 | ABS
75 | B | 611020528 | MS001-B.05.007SL.1.1 | MS001-B装饰条 | 1 | PMMA
76 | B | 611020529 | MS001-B.05.008JS.1.1 | MS001-B显示器支架钣金 | 1 | 304
77 | B | 611020530 | MS001-B.05.009SL.1.1 | MS001-B显示器支架外壳 | 1 | ABS
78 | B | 611020531 | MS001-B.05.010SL.1.1 | MS001-B线控手柄放置壳 | 1 | ABS
79 | B | 611020532 | MS001-B.05.011SL.1.1 | MS001-B鼠标放置壳 | 1 | ABS
80 | B | 611020533 | MS001-B.05.012SL.1.1 | MS001-BUSB延长线安装板 | 1 | ABS
81 | B | 611020534 | MS001-B.05.013JS.1.1 | MS001-B工作台支撑板 | 1 | Q235
82 | B | 611020535 | MS001-B.05.014JS.1.1 | MS001-B左侧导轨安装钣金 | 1 | 304
83 | B | 611020536 | MS001-B.05.015JS.1.1 | MS001-B右侧导轨安装钣金 | 1 | 304
84 | B | 611020537 | MS001-B.05.016SL.1.1 | MS001-B线控手柄外壳1 | 1 | ABS
85 | B | 611020538 | MS001-B.05.017SL.1.1 | MS001-B线控手柄外壳2 | 1 | ABS
86 | B | 611020539 | MS001-B.05.018SL.1.1 | MS001-B手柄按键 | 2 | PC
87 | B | 611020660 | MS001-B.05.019SL.1.1 | MS001-B显示器保护罩3 | 1 | ABS
88 | B | 611020540 | MS001-B.06.002JS.1.1 | MS001-B侧面板 | 1 | 铝合金6061
89 | C | 612010042 | MS001-B.07.002MB.1.1 | MS001-B包装木箱 | 1 | 红色二等次胶合板
 |  | / | MS001-B.07.003MB.1.1 | MS001-B台车托盘 | 1 | 红色二等次胶合板 |  | 木箱附图一
 |  |  | MS001-B.07.004MB.1.1 | MS001-B垫块面板 | 1 | 红色二等次胶合板 |  | 木箱附图二
90 | C | 612010045 | MS001-B.07.005SL.1.1 | MS001-B珍珠棉1 | 1 | 珍珠棉
91 | C | 612010046 | MS001-B.07.006SL.1.1 | MS001-B珍珠棉2 | 1 | 珍珠棉
92 | C | 612010047 | MS001-B.07.007SL.1.1 | MS001-B珍珠棉3 | 1 | 珍珠棉
93 | C | 612010048 | MS001-B.07.008SL.1.1 | MS001-B珍珠棉4 | 1 | 珍珠棉
94 | C | 612010049 | MS001-B.07.009SL.1.1 | MS001-B珍珠棉5 | 1 | 珍珠棉
95 | B | 611020418 | SY002.04.010SL.1.1 | SY-002机械臂关节罩（小） | 3 | ABS |  | 借用SY-002图号与物料号
96 | B | 611020419 | SY002.04.011SL.1.1 | SY-002机械臂关节罩（大） | 3 | ABS
标准采购件明细（外购的各类机电类零部件、元器件等）
1 | A | 611010247 |  | 机械臂+机械臂控制箱OEMV2版 | 1 |  | UR5 OEMV2版 |  | UR
2 | C | 611010207 |  | 显示器-15.6寸 | 1 |  | FC-190CF15.6寸 | 1920*1080p DVI和VGA接口 | 荣歌
3 | B | 611010208 |  | UPS | 1 |  | CASTLE 1K(6G) |  | 山特
4 | C | 611010206 |  | 铝壳电阻 | 1 |  | RX24-200W-4ΩJ
5 | C | 611010204 |  | 工作台旋转组件 | 1 |  | HG-S100-50 |  | 世嘉智尼
6 | B | 611010112 |  | 升降立柱 | 1 |  | JC35EN2-0-A-4-4-24-60/260-0-1-02-2D0-07-G | 4000N，行程60mm | 捷昌驱动
7 | C | 611010114 |  | 滚轮 | 4 |  | 5947UAP125P30-13 |  | TENTE
8 | C | 611010134 |  | 交换机 | 1 |  | TEG1005D | 5口，5VDC | 腾达
9 | C | 611010203 |  | 按压式反弹器 | 2 |  | ML-120W |  | 蓝普
10 | B | 611010192 |  | 主机G6 | 1 |  | HPEliteDesk800G6DesktopMini | PU:英特尔i3-10100（3.6Ghz/6M/4核） 显卡：集成显卡 硬盘：512G（SSD） 内存：8G（DDR4-2666） 电源：90W外置电源适配器 尺寸：17.7x17.5x3.4cm | 惠普总代
11 | C | 611010119 |  | 二进十二出接线盒 | 1 |  | HS6/HY2-12a |  | 海胜
12 | C | 611010197 |  | 电源模块-1233 | 1 |  | NEVO+600M-1233 | （一路5V、一路12V、24V两路并联） | 上海瑞率
13 | B | 611010117 |  | 隔离变压器 | 1 |  | BK-1000VA | 定制款220V | 德力西
14 | C | 611010271 |  | 万向脚杯-100 | 3 |  | D80,16×100 | 配垫圈 | 杰凯不锈钢
15 | C | 611010212 |  | 开关锁 | 2 |  | MS | 小头白色一套
16 | C | 611010213 |  | 轴销 | 3 |  | 4X50 | 双头带槽销
17 | C | 611010252 |  | 急停开关标识牌 | 1 |  | FJ-13-40 | 外径40内径22
18 | C | 611010136 |  | 急停开关 | 1 |  | AVW402R | 红色，两常闭 | 和泉
19 | C | 611010253 |  | USB线0.5m | 3 |  | USB108 | USB3.0，公对公，0.5m
20 | C | 611010201 |  | USB延长线1.5m | 2 |  | U30-AF | 1.5m，USB3.0，带耳朵，公对母，带螺丝孔 | CY/辰阳
21 | C | 611010202 |  | 导轨 | 2 |  | MGN9C1R145L |  | 上银
22 | C | 611010166 |  | 16mm金属带灯按钮 （蓝色电源符号） | 1 |  | FY1B-A/16F-10F/E+DY/B6 | 单独按钮，电压5V，自复位，平头
23 | C | 611010122 |  | 16mm金属带灯按钮 （绿色箭头符号） | 2 |  | FY1B-A/16F-10F/箭头/G24 | 单独按钮，电压24V，自复位，平头
24 | C | 611010124 |  | 16mm金属带灯按钮 （蓝色圆圈符号) | 1 |  | FY1B-A/16F-10F/E/B24 | 单独按钮，电压24V，自复位，平头
25 | C | 611010125 |  | 16mm金属按钮插座 | 4 |  |  | 与16mm金属按钮配套使用预留线定制（长1.5m）
26 | C | 611010128 |  | 凌科插座（网口） | 2 |  | LP-24-RJ45 | 插座 | 凌科
27 | C | 611010127 |  | 凌科插座（USB） | 1 |  | LP-24-USB | 座子
28 | C | 611010129 |  | 脚踏开关插头+插座组合 | 1 |  | LP24型12芯 | 法兰正装
29 | C | 611010217 |  | 电源接入连接器 | 1 |  | DD12.9321.111 |  | 得捷电子
30 | C | 611010121 |  | 电源指示灯 | 1 |  | 1053QC5 | 颜色：绿色 电压: 208V~250V | 得捷电子
31 | B | 611010126 |  | 脚踏开关 | 1 |  | FS-81-SP-2
32 | B | 611010268 |  | 熔断器 | 2 |  | F5AL250V | 5*20 | 杰胜翔鹰
33 | C | 611010147 |  | 保险丝座 | 1 |  | 4301.1403 |  | 得捷电子 (https://www.digikey.cn/products/zh/connectors-interconnects/power-entry-connectors-inlets-outlets-)
34 | C | 611010276 |  | 三芯航空插头+插座 | 1 |  | SF1210/P3+SF1212/S3 | 三芯整套 | 威浦
35 | C | 611010200 |  | 键盘 | 1 |  | HW098A | 轻薄usb有线键盘鼠标套装白色 | 深圳市航世科技
36 | C | 611010199 |  | 鼠标 | 1 |  | M136U
37 | C | 611010215 |  | 显示器支架-PO | 1 |  | PO-0-1 | （银色） | 昊雄
38 | C | 611010233 |  | MS001-BPE薄膜塑料袋 | 1 |  | 1100*1800*0.14mm
39 | C | 611010141 |  | 网线0.5米 | 2 |  | NW106 | 0.5m | 绿联
40 | C | 611010142 |  | 网线1米 | 2 |  | NW106 | 1m | 绿联
41 | C | 611010259 |  | VGA线 | 1 |  |  | 1.5m，VGA公对公 | 绿联
42 | C | 611010143 |  | 网线15米 | 1 |  | NW107 | 15m | 绿联
43 | C | 611010285 |  | 品字电源线-2.5平方 | 1 |  | 3x2.5平方 3C认证 | 3m | 优康
44 | A | 610130007 |  | RGB灯板 | 4 |  |  | 电子PCB板 | 睿索科技
45 | A | 610130004 |  | UR控制板 | 1
46 | A | 610130003 |  | UPS控制板 | 1
47 | A | 610130005 |  | 按键板 | 1
48 | C | 611010163 |  | 卡扣式防脱扣 | 1 |  | QT-102 | 电源插头卡扣式防脱扣 | 温州忧久科技
49 | C | 611010280 |  | USB分线器 | 1 |  | CM373 | 一出四 铝壳 | 绿联
50 | C | 611010281 |  | 杆包 | 1 |  |  | 125x9.5x9cm | 罟霸 | https://item.taobao.com/item.htm?id=569683703151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
51 | C | 611010255 |  | 蟹钳夹 | 1 |  | 大号钳夹
52 | C | 611010265 |  | 转接螺丝 | 1 |  | 1/4-3/8
53 | C | 611010256 |  | 球台 | 1 |  | SPS03 |  | Vlogger
54 | C | 611010257 |  | 磁吸盘 | 1 |  | 1/4-20螺孔 | 直径43mm
