santan444/MS001/03-设计开发输出阶段/06BOM/MS001-C.01.001MX.1.1工具包物料明细表.xls

三坛医疗 |  |  | 组件名称 | 工具包 | 组件物料 明细表 |  | 编制/日期 | 审核/日期 | 批准/日期
产品型号 |  | MS-001 | 文件号 | MS001-C.01.001MX.1.1
序号 | 物料等级 | 物料编码 | 图号/标准 | 名称 | 数量 | 材料 | 型号/规格 | 备注 | 参考 供应商
组件
1 |  | 200000041 | MS001-C.01.001ZZ.1.1 | 工具包 | 1
部件
1 |  | 200000064 | MS001-C.02.001JX.1.1 | MS001-C转接法兰总成 | 1
2 |  | 200000047 | MS001-C.03.001JX.1.1 | MS001-C配准板总成 | 1
3 |  | 200000048 | MS001-C.04.001JX.1.1 | MS001-C手术定位器总成 | 1
4 |  | 200000049 | MS001-C.05.001JX.1.1 | MS001-C产品包装 | 1
5 |  | 200000065 | MS001-C.07.001JX.1.1 | MS001-C运输包装 | 1
加工件明细（机加工、钣金、塑料手板、3D打印、注塑件、线缆图等）
1 | B | 611020665 | MS001-C.01.002JS.1.1 | MS001-C短套筒Φ2.0 | 1 | SUS304 |  |  | 科惠医疗
2 | B | 611020666 | MS001-C.01.003JS.1.1 | MS001-C短套筒Φ3.0 | 1 | SUS304 |  |  | 科惠医疗
3 | B | 611020667 | MS001-C.02.002JS.1.1 | MS001-C转接法兰 | 1 | POM黑色 |  |  | 肯享机电
4 | B | 611020668 | MS001-C.02.003JS.1.1 | MS001-C转接法兰2 | 1 | 6061-T6 |  |  | 肯享机电
5 | B | 611020669 | MS001-C.02.004JS.1.1 | MS001-C止锁按键 | 1 | 尼龙（黑色） |  |  | 肯享机电
6 | B | 611020632 | MS001-C.03.002SL.1.1 | MS001-C支撑板1 | 1 | 碳纤维板 |  |  | 河北多点
7 | B | 611020633 | MS001-C.03.003SL.1.1 | MS001-C支撑板2 | 1 | 碳纤维板 |  |  | 河北多点
8 | B | 611020634 | MS001-C.03.004SL.1.1 | MS001-C支撑板底板 | 2 | 碳纤维板 |  |  | 河北多点
9 | B | 611020635 | MS001-C.03.005SL.1.1 | MS001-C支撑板盖板 | 2 | 碳纤维板 |  |  | 河北多点
10 | B | 611020630 | MS001-C.03.006JS.1.1 | MS001-C连杆 | 1 | SUS304 |  |  | 肯享机电
11 | B | 611020631 | MS001-C.03.007JS.1.1 | MS001-C压板 | 2 | SUS304 |  |  | 肯享机电
12 | B | 611020636 | MS001-C.04.002JS.1.1 | MS001-C通道焊接件 | 1 | SUS304/6061 |  |  | 肯享机电
13 | B | 611020637 | MS001-C.04.003JS.1.1 | MS001-C底板 | 1 | SUS304 |  |  | 肯享机电
14 | B | 611020638 | MS001-C.04.004JS.1.1 | MS001-C压杆 | 1 | SUS304 |  |  | 肯享机电
15 | C | 612010052 | MS001-C.05.002ZB.1.1 | MS001-C工具包包装纸箱 | 1 | 瓦楞纸
16 | C | 612010078 | MS001-C.05.003SL.1.1 | MS001-C工具包珍珠棉 | 2 | 珍珠棉
17 | C | 612010053 | MS001-C.07.002ZB.1.1 | MS001-A显示器包装纸箱 | 1 | 瓦楞纸
18 | C | 612010054 | MS001-C.07.003ZB.1.1 | MS001-B显示器包装纸箱 | 1 | 瓦楞纸
19 | C | 612010055 | MS001-C.07.004ZB.1.1 | MS001-B机械臂包装纸箱 | 1 | 瓦楞纸
20 | C | 612010058 | MS001-C.07.005SL.1.1 | MS001-C木箱珍珠棉1 | 1 | 珍珠棉
21 | C | 612010059 | MS001-C.07.006SL.1.1 | MS001-C木箱珍珠棉2 | 1 | 珍珠棉
22 | C | 612010060 | MS001-C.07.007SL.1.1 | MS001-C木箱珍珠棉3 | 1 | 珍珠棉
23 | C | 612010061 | MS001-C.07.008SL.1.1 | MS001-C木箱珍珠棉4 | 1 | 珍珠棉
24 | C | 612010062 | MS001-C.07.009SL.1.1 | MS001-C木箱珍珠棉5 | 2 | 珍珠棉
25 | C | 612010063 | MS001-C.07.010SL.1.1 | MS001-C木箱珍珠棉6 | 2 | 珍珠棉
26 | C | 612010064 | MS001-C.07.011SL.1.1 | MS001-C木箱珍珠棉7 | 1 | 珍珠棉
27 | C | 612010075 | MS001-C.07.012SL.1.1 | MS001-B显示器珍珠棉 | 2 | 珍珠棉
28 | C | 612010057 | MS001-C.07.013MB.1.1 | MS001-C包装木箱 | 1 | 红色二等次胶合板
标准采购件明细（外购的各类机电类零部件、元器件等）
1 | C | 611010173 |  | 4mm钢珠球 | 62 | SUS304 | φ4
2 | C | 611010174 |  | 转轴 | 1 | SUS304 | φ2x16
3 | C | 611010175 |  | 弹簧 | 2 | SUS304 | 1.2x8x10
4 | C | 611010176 |  | 拨珠螺丝 | 2 | SUS304 | M4x6
5 | C | 611010179 |  | 圆柱销 | 2 | SUS304 | φ6x10
6 | C | 611010164 |  | QC-R50 | 1 | 合金 |  | 机械臂末端快换装置
7 | C | 611010165 |  | QC-G50 | 1 | 合金
8 | C | 611010238 |  | MS001-C PE塑料袋 | 1 | PE | 100X100X0.14
9 | C | 611010227 |  | MS001消毒盒 | 1 | 铝合金 | 31x22x9.5cm | 咖啡色，盒盖激光雕刻：工具包 | 泗洪县鑫亚医疗器械
10 | C | 611010269 |  | MS001卡条 | 6 | 硅胶 | 21.5x3.5cm
