santan444/MS001/03-设计开发输出阶段/06BOM/MS001-D.01.001MX.1.1 体位反馈模块物料明细表.xls

Sheet: 整机明细表
三坛医疗 |  |  | 组件名称 | 体位反馈模块 | 组件物料 明细表 |  | 编制/日期 | 审核/日期 | 批准/日期
产品型号 |  | MS-001 | 文件号 | MS001-D.01.001MX.1.1
序号 | 物料等级 | 物料编码 | 图号/标准 | 名称 | 数量 | 材料 | 型号/规格 | 备注 | 参考 供应商
组件
1 |  | 200000066 | MS001-D.01.001ZZ.1.1 | 体位反馈模块 | 1
加工件明细（机加工、钣金、塑料手板、3D打印、注塑件、线缆图等）
1 | B | 611020601 | MS001-D.01.002SL.1.1 | MS001-D开关 | 1 | ABS
2 | B | 611020602 | MS001-D.01.003SL.1.1 | MS001-D上外壳 | 1 | ABS
3 | B | 611020603 | MS001-D.01.004SL.1.1 | MS001-D透光板 | 1 | PMMA
4 | B | 611020604 | MS001-D.01.005SL.1.1 | MS001-D防掉落板 | 1 | ABS
5 | B | 611020605 | MS001-D.01.006SL.1.1 | MS001-D转轮 | 1 | ABS
6 | B | 611020606 | MS001-D.01.007SL.1.1 | MS001-D转动轴 | 1 | ABS
7 | B | 611020607 | MS001-D.01.008SL.1.1 | MS001-D下外壳 | 1 | ABS
8 | B | 611020675 | MS001-D.01.009BK.1.1 | MS001-D衍射片 | 4 |  | 共切割4份，原材料分别是50线/100线/150线/200线 | 自制件
9 | C | 612010056 | MS001-D.01.010ZB.1.1 | 体位反馈模块包装纸盒 | 1 | 白板纸
10 | C | 612010077 | MS001-D.01.011SL.1.1 | 体位反馈模块珍珠棉1 | 1 | 珍珠棉
11 | C | 612010076 | MS001-D.01.012SL.1.1 | 体位反馈模块珍珠棉2 | 1 | 珍珠棉
标准采购件明细（外购的各类机电类零部件、元器件等）
1 | C | 611010261 |  | 磁吸片 | 1 |  | 直径4.0cm
2 | C | 611010262 |  | 7号碱性电池 | 1 |  | LR03
3 | A | 610130009 |  | 激光控制板 | 1 |  |  | 详见电子归档文件
4 | C | 611010272 |  | 衍射片 | 1 |  | 50线 |  | 采购回来后需进行切割加工
5 | C | 611010273 |  | 衍射片 | 1 |  | 150线
6 | C | 611010274 |  | 衍射片 | 1 |  | 200线
7 | C | 611010275 |  | 衍射片 | 1 |  | 250线
8 | B | 611010286 |  | 弹簧 | 1 |  | 0.4x5x15
9 | C | / | GB/T 818 | 十字槽盘头螺钉 | 1 | 304 | M3X4

Sheet: Sheet1
611020574 | MS001-B.01.022XH.1.1 | MS001-B脚踏控制线
