santan444/MS001/03-设计开发输出阶段/06BOM/MS001.01.001MX.1.1 模块化手术导引系统物料明细表.xls

三坛医疗 |  |  | 产品名称 | 模块化手术导引系统 | 整机物料 明细表 |  | 编制/日期 | 审核/日期 | 批准/日期
产品型号 |  | MS-001 | 文件号 | MS001.01.001MX.1.1
序号 | 物料等级 | 物料编码 | 图号/标准 | 名称 | 数量 | 材料 | 规格 | 备注 | 参考 供应商
整机
1 |  | 100000001 | MS001.01.001ZZ.1.1 | 模块化手术导引系统 | 1
文件
1 | B | 612010033 | MS001.01.010SM.1.1 | 产品说明书 | 1
2 | B | 612010031 | MS001.01.004AZ.1.1 | MS-001安装说明书 | 1
3 | B | 612010032 | MS001.01.005ZX.1.1 | MS-001装箱清单 | 1
4 | B | 612010034 | MS001.01.006HZ.1.1 | MS-001合格证 | 1
5 | B | 612010079 | MS001.01.010BQ.1.1 | MS-001标签
组件
1 |  | 200000028 | MS001-A.01.001ZZ.1.1 | 规划模块 | 1
2 |  | 200000034 | MS001-B.01.001ZZ.1.1 | 导引模块 | 1
3 |  | 200000041 | MS001-C.01.001ZZ.1.1 | 工具包 | 1
4 |  | 200000066 | MS001-D.01.001ZZ.1.1 | 体位反馈模块 | 1
