santan444/MS001/03-设计开发输出阶段/06BOM/辅料BOM/MS001-C.01.002MX.1.1工具包辅料明细表.xls

三坛医疗 |  |  | 产品名称 | 工具包 | 辅料 明细表 |  | 编制/日期 | 审核/日期 | 批准/日期
产品型号 |  | MS-001 | 文件号 | MS001-C.01.002MX.1.1
序号 | 物料等级 | 物料编码 | 图号/标准 | 名称 | 数量 | 材料 | 规格 | 备注 | 参考 供应商
紧固件
1 |  |  | GB/T 819 | 十字沉头螺钉 | 9 | 304 | M3x10 |  |  | https://bairuite.tmall.com/
2 |  |  | GB/T 819 | 十字沉头螺钉 | 1 | 304 | M3x12 | 黑色
3 |  |  | GB/T 819 | 十字沉头螺钉 | 2 | 304 | M4x6
4 |  |  | GB/T 70.1 | 内六角圆柱头螺钉 | 4 | 304 | M5x16
5 |  |  | GB/T 70.1 | 内六角圆柱头螺钉 | 3 | 304 | M5x10
6 |  |  | GB/T 70.1 | 内六角圆柱头螺钉 | 4 | 304 | M6x10
7 |  |  | GB/T 818 | 十字盘头螺钉 | 12 | 白色尼龙 | M3x15 |  |  | https://gongyijj.tmall.com/?spm=a220o.1000855.1997427721.d4918089.36c77c93p6XWL0
8 |  |  | GB/T 6170 | 螺母 | 12 | 白色尼龙 | M3
9 |  |  | / | 塔簧 | 1 | 304 | 0.8x5/6x14-7 |  |  | https://detail.tmall.com/item.htm?id=579197291225&rn=f08 2f0a843a5495722949d2eff820e12&abbucket=2
10 |  |  | / | 转换牙套 | 1 | 304 | M5xM3x6 |  |  | https://detail.tmall.com/item.htm?id=609856596206&skuId=4510043962943
其它（胶水、扎带等）
1 |  |  | / | 10:1混合胶嘴 | 2 | / | 1.0mmx400x500 |  |  | https://detail.tmall.com/item.htm?id=528869768525&spm=a1z09.2.0.0.101c2e8dP6Zuuh&_u=s5qucc6f4ae
2 |  |  | / | 碳纤维专用胶 | 1/8 | AB胶 | ergo9966 | 约8套消耗1只 |  | https://detail.tmall.com/item.htm?id=570430227475&spm=a1z09.2.0.0.101c2e8dP6Zuuh&_u=s5qucc69ba6
3 |  |  | / | 硅胶垫片 | 1/12 | 硅胶 | 500x500x1.5mm | 约12套消耗1片 |  | https://detail.tmall.com/item.htm?id=523766983755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
