santan444/MS001/03-设计开发输出阶段/02电子/MS001.06.001ZZ.1.3-UPS控制板/02_物料清单/MS001.06.001WL.1.3-UPS控制板-物料清单.xlsx

三坛医疗 |  |  | 组件名称 | UPS控制板 |  | 电路板组件 物料明细表 | 编制/日期 |  | 审核/日期 | 批准/日期
产品型号 |  | MS-001 | 文件号 | MS001.06.001WL.1.3
电路板组件
组件编码 |  | 610130003 | UPS控制板
物料明细
序号 | 物料类型 | 物料编码 | 名称/规格 | 厂家 | 封装 | 位号 | 数量 | 替代编码 | 替代名称/规格 | 替代厂家
1 | 贴片电容 | 610026014 | CC0603KRX7R9BB104 | 国巨 | C0603 | C1, C2, C3, C4, C5, C6 | 6 | 610027014 | GRM188R71H104KA93D | 村田
2 | 贴片LED红灯 | 610040066 | 17-215SURC/S530-A3/TR8 | EVERLIGHT(台湾亿光) | 0805LED | D1 | 1
3 | 肖特基二极管 | 610040067 | B5819W | CJ（江苏长电） | SOD-123 | D2, D3, D4, D5, D6, D7, D8, D9, D10, D11 | 10
4 | 连接器 | 610060037 | PHB-2AWB | LHE（浙江联合） | PHB-2AWB | P2, P3 | 2
5 | 连接器 | 610060047 | 2.54mm带鼻双排直插排母 | 正凌精工 | 2*8P | P4 | 1
6 | 贴片电阻 | 610016077 | RC0603JR-072KL | 国巨 | R0603 | R1 | 1 | 610017077 | 0603WAJ0202T5E | 厚声
7 | 贴片电阻 | 610016116 | RC0603JR-07100KL | 国巨 | R0603 | R3, R5 | 2 | 610017116 | 0603WAJ0104T5E | 厚声
8 | 贴片电阻 | 610016093 | RC0603JR-0710KL | 国巨 | R0603 | R2, R4, R6 | 3 | 610017093 | 0603WAJ0103T5E | 厚声
9 | 电源芯片 | 610050031 | ME6210A33M3G | MICRONE(南京微盟) | SOT-23-3 | U1 | 1
10 | MCU芯片 | 610050036 | STM8L101F3P6 | ST(意法半导体) | TSSOP-20 | U2 | 1
11 | 贴片光耦 | 610040065 | EL817S1(C)(TU)-FG | EVERLIGHT(台湾亿光) | SMD-4P | U3 | 1
12 | PCB板 | 617010017 | MS001.06.001YL.1.3 | 睿索科技 |  |  | 1
13
14
15
16
17
18
19
20
21
22
23
24
25
26
27
28
29
30
31
32
33
34
35
36
37
38
39
