santan444/MS001/03-设计开发输出阶段/02电子/MS001.06.003ZZ.1.2-UR控制板/02_物料清单/MS001.06.003WL.1.2-UR控制板-物料清单.xlsx

三坛医疗 |  |  | 组件名称 | UR控制板 |  | 电路板组件 物料明细表 | 编制/日期 |  | 审核/日期 | 批准/日期
产品型号 |  | MS-001 | 文件号 | MS001.06.003WL.1.2
电路板组件
组件编码 |  | 610130004 | UR控制板
物料明细
序号 | 物料类型 | 物料编码 | 名称/规格 | 厂家 | 封装 | 位号 | 数量 | 替代编码 | 替代名称/规格 | 替代厂家
1 | 贴片电容 | 610026001 | CC0603JRNPO9BN220 | 国巨 | C0603 | C1, C3, C29, C30 | 4 | 610027001 | GRM1885C1H220JA01D | 村田
2 | 贴片电容 | 610026014 | CC0603KRX7R9BB104 | 国巨 | C0603 | C2, C4, C5,C6, C8, C9, C10, C11, C12, C14, C15, C18, C20, C21, C24, C25, C27，C28，C33 | 19 | 610027014 | GRM188R71H104KA93D | 村田
3 | 贴片电容 | 610026020 | CL21A106KAYNNNE | 三星 | C0805 | C7, C26 | 2 | 610027020 | GRM21BR61E106KA73L | 村田
4 | 贴片电解电容 | 610026036 | VEJ221M1VTR-0810 | lelon(台湾立隆) | SMD-8*10mm | C16, C23 | 2
5 | 贴片电解电容 | 610026037 | VEJ471M1CTR-0810 | lelon(台湾立隆) | SMD-8*10mm | C17, C19, C31 | 3
6 | 贴片LED | 610040063 | 17-215/G6C-FN2P2B/3T | EVERLIGHT(台湾亿光) | 0805 | D2 | 1
7 | 插拔式接线端子 | 610060030 | HT396R-3.96-04P-15 | KEFA(科发电子) | 2EDG4P-3R96-TH-W-L | J1, J11，J2, J6, J7 | 5
8 | 插拔式接线端子 | 610060032 | HT396R-3.96-02P-15 | KEFA(科发电子) | 2EDG2P-3R96-TH-W-L | J3, J5, J8, J9, J10 | 5
9 | 连接器 | 610060012 | U-USBAR04P-F002 | Ckmtw(灿科盟) | USB-A | J12 | 1
10 | 贴片电感 | 610030012 | SWPA8040S150MT | Sunlord(深圳顺络) | SMD-8.0*8.0*4.0mm | L1 | 1
11 | 贴片电感 | 610030010 | SLF7055T-100M2R5-3PF | TDK | SMD-7*7*5.5mm | L2 | 1
12 | 贴片MOS管 | 610040005 | 2N7002 | CJ（江苏长电） | SOT-23-3 | Q1, Q3, Q4, Q6, Q7, Q8，Q9 | 7
13 | 贴片MOS管 | 610040064 | AOD413A | AOS | TO-252-2 | Q2 | 1
14 | 贴片电阻 | 610016070 | RC0603JR-071KL | 国巨 | R0603 | R1, R3, R8, R23, R24,R32 | 6 | 610017070 | 0603WAJ0102T5E | 厚声
15 | 贴片电阻 | 610016093 | RC0603JR-0710KL | 国巨 | R0603 | R2, R4, R5, R9, R11, R12, R13, R14, R19, R25, R30, R31，R33 | 13 | 610017093 | 0603WAJ0103T5E | 厚声
16 | 贴片电阻 | 610016116 | RC0603JR-07100KL | 国巨 | R0603 | R6, R10, R17, R18 | 4 | 610017116 | 0603WAJ0104T5E | 厚声
17 | 贴片电阻 | 610016024 | RC0603JR-0710RL | 国巨 | R0603 | R7 | 1 | 610017024 | 0603WAJ0100T5E | 厚声
18 | 贴片电阻 | 610016109 | RC0603JR-0751KL | 国巨 | R0603 | R20, R21, R22, R28 | 4 | 610017109 | 0603WAJ0513T5E | 厚声
19 | 贴片电阻 | 610016089 | RC0603JR-076K8L | 国巨 | R0603 | R26 | 1 | 610017089 | 0603WAJ0682T5E | 厚声
20 | MCU芯片 | 610050029 | STM32F103RCT6 | ST(意法半导体) | LQFP-64 | U1 | 1
21 | 贴片光耦 | 610040065 | EL817S1(C)(TU)-FG | EVERLIGHT(台湾亿光) | SMD-4P | U2, U3, U4, U11, U12 | 5
22 | 电机驱动 | 610050054 | RZ7899 | RZ 睿智微 | SOP-8 | U13 | 1
23 | 电源芯片 | 610050031 | ME6210A33M3G | MICRONE(南京微盟) | SOT-23-3 | U6 | 1
24 | 集成电路 | 610050032 | TPS54202DDCR | TI(德州仪器) | SOT-23-6 | U7 | 1
25 | 集成电路 | 610050033 | ADUM1200AR | ADI(亚德诺)/LINEAR | SOIC-8 | U8 | 1
26 | 集成电路 | 610050034 | CH340G | WCH(南京沁恒) | SOP-16 | U9 | 1
27 | 集成电路 | 610050035 | USBLC6-2SC6 | ST(意法半导体) | SOT-23-6 | U10 | 1
28 | 贴片晶振 | 610100001 | X50328MSD2GC | YXC(扬兴科技) | SMD-5032_2P | Y1 | 1
29 | 贴片晶振 | 610100006 | X503212MSB2GI | YXC(扬兴科技) | SMD-5032_2P | Y2 | 1
30 | PCB板 | 617010021 | MS001.06.003YL.1.2 | 睿索科技 |  |  | 1
31
32
33
34
35
36
37
