santan444/MS001/03-设计开发输出阶段/02电子/MS001.06.006ZZ.1.1-RGB灯板/02_物料清单/MS001.06.006WL.1.1-RGB灯板-物料清单.xlsx

三坛医疗 |  |  | 组件名称 | RGB灯板 |  | 电路板组件 物料明细表 | 编制/日期 |  | 审核/日期 | 批准/日期
产品型号 |  | MS-001 | 文件号 | MS001.06.006WL.1.1
电路板组件
组件编码 |  | 610130007 | RGB灯板
物料明细
序号 | 物料类型 | 物料编码 | 名称/规格 | 厂家 | 封装 | 位号 | 数量 | 替代编码 | 替代名称/规格 | 替代厂家
1 | 贴片LED | 610040072 | HL-AF-5060H271BU46FU79GC-S1-THL | 鸿利光电 | SMT-5.4*5mm | D1, D2, D3, D4, D5, D6, D7, D8, D9, D10 | 10
2 | 贴片电阻 | 610016150 | RC0805JR-07200RL | 国巨 | R0805 | R2, R5, R8, R11, R14, R17, R20, R23, R26, R29 | 10
3 | 贴片电阻 | 610016149 | RC0805JR-07130RL | 国巨 | R0805 | R1, R3, R4, R6, R7, R9, R10, R12, R13, R15, R16, R18, R19, R21, R22, R24, R25, R27, R28, R30 | 20
4 | 连接器 | 610060039 | PHB-4AWB | LHE（浙江联合） | PHB-4AWB | J1, J2 | 2
5 | PCB板 | 617010020 | MS001.06.006YL.1.1 | 睿索科技 |  |  | 1
6
7
8
9
10
11
12
13
14
15
16
17
18
19
20
21
22
23
24
25
26
27
28
29
30
31
32
33
34
35
36
37
