santan444/MS001/03-设计开发输出阶段/02电子/MS001.06.007ZZ.1.1-激光控制板/02_物料清单/MS001.06.007WL.1.1-激光控制板-物料清单.xlsx

三坛医疗 |  |  | 组件名称 | 激光控制板 |  | 电路板组件 物料明细表 | 编制/日期 |  | 审核/日期 | 批准/日期
产品型号 |  | MS-001 | 文件号 | MS001.06.007WL.1.1
电路板组件
组件编码 |  | 610130016 | 激光控制板
物料明细
序号 | 物料类型 | 物料编码 | 名称/规格 | 厂家 | 封装 | 位号 | 数量 | 替代编码 | 替代名称/规格 | 替代厂家
1 | 电池盒 | 610060055 | 1节7号无盖插片 | 深圳金刚狼 | Bat-7-1 | BT1 | 1
2 | 贴片电容 | 610026014 | CC0603KRX7R9BB104 | 国巨 | 0603 | C1, C2, C3, C5, C7, C8 | 6
3 | 贴片电容 | 610026028 | CL21A226MAQNNNE | 三星 | 0805 | C4, C9, C11 | 3
4 | 贴片电容 | 610026011 | CC0603KRX7R9BB103 | 国巨 | 0603 | C10 | 1
5 | 肖特基二极管 | 610040067 | B5819W | CJ（江苏长电） | SOD-123 | D2 | 1
6 | 二极管 | 610040078 | 1N4148WS | CJ（江苏长电） | SOD-123 | D4, D5 | 2
7 | 激光发光头 | 610040079 | DS-206R | 深圳德胜 | Laser-R3 | D3 | 1
8 | 开关 | 610110007 | K2-1817UQ-A4SW-01 | 韩国韩荣 | K-1817 | K1 | 1
9 | 电感 | 610030019 | SWPA3015S220MT | Sunlord（顺络） | L3530 | L1, L2 | 2
10 | 贴片三极管 | 610040003 | S8050 | CJ（江苏长电） | SOT-23 | Q1, Q3 | 2
11 | 贴片三极管 | 610040077 | S8550 | CJ（江苏长电） | SOT-23 | Q2 | 1
12 | 贴片电阻 | 610016123 | RC0603JR-07200KL | 国巨 | 0603 | R1, R3, R6, R8, R9 | 5
13 | 贴片电阻 | 610016116 | RC0603JR-07100KL | 国巨 | 0603 | R2, R5, R7, R10, R11, R12, R13, R17, R18 | 9
14 | 贴片电阻 | 610016093 | RC0603JR-0710KL | 国巨 | 0603 | R14, R15，R19 | 3
15 | 贴片电阻 | 610016047 | RC0603JR-07100RL | 国巨 | 0603 | R20 | 1
16 | 贴片电阻 | 610016016 | RC0603JR-074R7L | 国巨 | 0603 | R21 | 1
17 | 贴片电阻 | 610016063 | RC0603JR-07510RL | 国巨 | 0603 | R16 | 1
18 | MCU芯片 | 610050037 | STM8L101F3P6 | ST(意法半导体) | TSSOP-20 | U1 | 1
19 | 集成电路 | 610050057 | LM358DR2G | ON(安森美) | SOIC-8 | U2 | 1
20 | 电源芯片 | 610050058 | ME2188A33XG | MICRONE(南京微盟) | SOT-23 | U3 | 1
21 | 电源芯片 | 610050059 | ME2159AM6G | MICRONE(南京微盟) | SOT23-6 | U5 | 1
22 | PCB板 | 617010029 | MS001.06.007YL.1.1 | 睿索科技 |  |  | 1
23
24
25
26
27
28
29
30
31
32
33
34
35
36
37
38
39
40
