santan444/MS001/03-设计开发输出阶段/07风险管理/MS-001设计失效模式与效应分析（D-FMEA）_电子.xlsx

Sheet: Rev
变更履历
版本号 | 发布/实施日期 | 更改内容概述 | 更改者
V1.0 | 2021.07.05 | 文件新编 | 洪洁
V1.1 | 2021.07.28 | 修改SEV | 洪洁

Sheet: FMEA
 |  |  |  | MS-001设计失效模式与效应分析（D-FMEA）_电子
 | 产品名称： | 模块化手术导引系统 |  | 文件号： | MS001.01.105SM.1.0
 | 产品代号： | MS-001 |  | 版本： | V1.0 |  | 编制/日期： |  |  | 审核/日期： |  |  | 批准/日期：
序号 | 子系统/零部件 | 潜在失效模式 | 潜在失效的后果 | 局部影响 | SEV | 最终影响 | SEV | 失效模式发生的原因/机理 | OCC | 现行设计控制预防 | 现行设计控制探测方法 | DET | RPN | 建议采取的行动 | 责任人和目标完成日期 | 风险评估控制记录编号
1 | 按键板 | 按键失效 | 按键常开 | 通道定位不能启动 | 5 | 延误手术进程，对病人无直接伤害 | 6 | 1.按键品质问题，内部接触不良。 2.连接线接触不好，断开了 | 2 | 1.按键的设计寿命留有余量； 2.对按键做寿命测试。 | 测试报告 | 5 | 60 | 无 | 2021.04 | R79
2 | 升降立柱 | 无法降 | 脚杯无法撑住地面 | 手术中台车不稳 | 3 | 延误手术进程，对病人无直接伤害 | 6 | 立柱自锁功能卡死 | 4 | 对立柱进行疲劳测试。 | 测试报告 | 1 | 24 | 无 | 2021.04 | R80
3 |  | 无法降 | 脚杯无法撑住地面 | 手术中台车不稳 | 3 | 延误手术进程，对病人无直接伤害 | 6 | 限位开关失效 | 8 | 1.让厂家对限位螺母加固； 2.对立柱进行疲劳测试。 | 测试报告 | 1 | 48 | 无 | 2021.04 | R81
4 |  | 电源连接松动 | 台车不能升降 | 台车在需要移动时无法进行移动 | 1 | 操作者使用不方便 | 3 | 接头故障，导致接触不良 | 1 | 使用防脱带卡扣插头。 | 设计方案评审 | 1 | 3 | 无 | 2021.04 | R82
5 | RGB灯板 | LED灯损坏 | 个别LED不亮 | LED灯亮度变低 | 1 | 无明显影响 | 1 | 后端功率过大，或者短路 | 2 | 使用正规厂家，成熟产品。 | 器件选型表 | 1 | 2 | 无 | 2021.04 | R83
6 |  | 接口松动 | LED整体不亮 | LED灯不能指示机械臂状态 | 2 | 影响用户通过指示灯观察机械臂状态 | 3 | 接头故障，导致接触不良 | 6 | 使用防脱带卡扣插头。 | 设计方案评审 | 1 | 18 | 无 | 2021.04 | R84
7 | UPS | 内部故障关闭 | 系统断电 | 系统在工作中突然断电 | 7 | 产品缺陷会导致病人/用户严重健康损害 | 8 | UPS发生过热、过载或其它内部故障时保护性关闭 | 4 | 1.外壳增加散热孔； 2.设计上，对UPS输出功率留有余量。 | 设计方案评审 | 2 | 64 | 进行超温测试，保证UPS工作散热良好。 | 2021.04 | R85
8 |  | 后备电池供电不足 | 停电时系统无后备电源 | 系统在工作中突然断电 | 7 | 产品缺陷会导致病人/用户严重健康损害 | 8 | 用户超年限使用 | 1 | 规定使用年限，定期更换。 | 使用说明书评审 | 1 | 8 | 无 | 2021.04 | R86
9 |  | 控制线连接松动 | 系统无法开机或者关机 | 系统开关机功能受限 | 3 | 延误手术进程，对病人无直接伤害 | 4 | 接头品质问题或者工艺原因 | 3 | 使用防脱带卡扣插头。 | 设计方案评审 | 2 | 24 | 无 | 2021.04 | R87
10 | UPS控制板 | 电源部分芯片故障 | 控制板无法供电 | 控制板功能失效 | 4 | UPS延时关机，对病人无直接伤害 | 5 | 后端功率过大，或者短路 | 4 | 1，设计上，对电源留有足够余量； 2，对PCB板进行测试，功率，电流。 | 设计方案评审 | 1 | 20 | 无 | 2021.04 | R88
11 |  | MCU故障 | 控制逻辑输出错误 | 控制板功能失效 | 2 | UPS延时关机，对病人无直接伤害 | 5 | MCU静电等干扰损坏 | 5 | 设计接地线，进行静电测试验证。 | 测试报告 | 1 | 25 | 无 | 2021.04 | R89
12 |  | 接口松动 | 与UPS信号无法发送 | 控制板功能失效 | 6 | UPS延时关机，对病人无直接伤害 | 5 | 接头故障，导致接触不良 | 6 | 使用防脱带卡扣插头。 | 设计方案评审 | 1 | 36 | 无 | 2021.04 | R90
13 | UR机器人 | 关节卡死 | 机器人达不到定位位置 | 系统定位无法正常进行 | 7 | 产品缺陷会导致病人/用户严重健康损害 | 8 | 关节电机损坏 | 1 | 进行耐久性测试。 | 测试报告 | 1 | 8 | 无 | 2021.04 | R91
14 |  | 定位精度变差 | 机器人到达定位位置误差较大 | 系统定位后有较大误差 | 7 | 产品缺陷会导致病人/用户严重健康损害 | 8 | 机械传动部分间隙过大 | 1 | 进行耐久性测试。 | 测试报告 | 2 | 16 | 无 | 2021.04 | R92
15 |  | 电源连接线松动 | 机械臂无法启动 | 机械臂无法启动 | 4 | 延误手术进程，对病人无直接伤害 | 6 | 接头故障，导致接触不良 | 3 | 使用原厂插头插座，不做二次加工。 | 设计方案评审 | 1 | 18 | 无 | 2021.04 | R93
16 |  | UR机器人末端工具漏电 | 电击患者或者影响手术监测设备正常工作 | 影响患者手术进程 | 7 | 产品缺陷会导致病人/用户严重健康损害 | 8 | 末端工具隔离未做好 | 1 | 对末端工具进行浮地设计。 | 测试报告 | 1 | 8 | 无 | 2021.04 | R94
17 | UR控制板 | 电源部分芯片故障 | 控制板无法供电 | 控制板所有功能失效 | 5 | 延误手术进程，对病人无直接伤害 | 6 | 后端功率过大，或者短路 | 4 | 1，设计上，对电源留有足够余量； 2，对PCB板进行测试，功率，电流。 | 设计方案评审 | 1 | 24 | 无 | 2021.04 | R95
18 |  | MCU故障 | 控制逻辑输出错误 | 控制板所有功能失效 | 7 | 延误手术进程，对病人无直接伤害 | 6 | MCU静电等干扰损坏 | 5 | 设计接地线，进行静电测试验证。 | 测试报告 | 1 | 35 | 无 | 2021.04 | R96
19 |  | USB功能失效 | 与PC机通讯失败 | 脚踏功能失效 | 7 | 延误手术进程，对病人无直接伤害 | 6 | 接头故障，导致接触不良 | 6 | 使用防脱带卡扣插头。 | 设计方案评审 | 1 | 42 | 无 | 2021.04 | R97
20 |  | 升降立柱电机功能失效 | 立柱无法升降 | 立柱无法升降 | 2 | 台车无法转移 | 4 | 接头故障，导致接触不良 | 3 | 使用防脱带卡扣插头。 | 设计方案评审 | 1 | 12 | 无 | 2021.04 | R98
21 |  | UR机械臂上下电功能失效 | 机械臂无法启动 | 机械臂无法启动 | 5 | 延误手术进程，对病人无直接伤害 | 6 | 接头故障，导致接触不良 | 3 | 使用防脱带卡扣插头。 | 设计方案评审 | 1 | 18 | 无 | 2021.04 | R99
22 |  | 脚踏功能失效 | 机械臂无法启动 | 机械臂无法定位 | 5 | 延误手术进程，对病人无直接伤害 | 6 | 接头故障，导致接触不良 | 3 | 使用防脱带卡扣插头。 | 设计方案评审 | 1 | 18 | 无 | 2021.04 | R100
23 |  | 电机正反转按键失效 | 立柱无法升降 | 立柱无法升降 | 5 | 台车无法转移 | 4 | 按键故障，开关有问题 | 5 | 1.按键的设计寿命留有余量； 2.对按键做疲劳测试。 | 测试报告 | 1 | 25 | 无 | 2021.04 | R101
24 |  | 芯片故障 | 控制板无法正常 | 控制板所有功能失效 | 5 | 延误手术进程，对病人无直接伤害 | 6 | 芯片品质问题故障 | 2 | 1.使用正规厂家，成熟产品； | 设计方案评审 | 1 | 12 | 无 | 2021.04 | R102
25 | 脚踏开关 | 开关卡住 | 机械臂无法启动 | 机械臂无法定位 | 7 | 产品缺陷会导致病人/用户严重健康损害 | 8 | 开关被异物卡住或者开关内部损坏 | 2 | 使用具有IP68认证的开关。 | 测试报告 | 1 | 16 | 无 | 2021.04 | R103
26 |  | 开关连接线断开 | 机械臂无法启动 | 机械臂无法定位 | 5 | 延误手术进程，对病人无直接伤害 | 6 | 插头脱落 | 4 | 使用具有CCC认证的开关。 | 测试报告 | 1 | 24 | 无 | 2021.04 | R104

Sheet: 附录A
评分标准
SEV 局部影响严重程度 |  | SEV 最终影响严重程度
标准 | 评分 | 标准 | 评分
产品不影响使用的瑕疵，功能报废率0.1% | 1 | 用户/病人通常不会发现并对其没有影响 | 1
产品不影响使用的瑕疵，功能报废率0.3% | 2 | 较细心能察觉的外观等产品瑕疵 | 2
产品次要功能损失，功能报废率0.3% | 3 | 用户容易发现并不乐于接受，不影响使用 | 3
产品次要功能损失，功能报废率1% | 4 | 使用不方便，增加用户负担 | 4
产品次要功能损失，可靠性降低但在规格内，功能报废率1% | 5 | 产品还能用，但性能没达到预期 | 5
产品次要严重功能损失，可靠性降低，功能报废率1% | 6 | 对病人/用户健康没有损害，但产品丧失功能 | 6
产品主要功能部分损失，功能报废率1% | 7 | 产品缺陷会导致病人/用户健康损害 | 7
产品主要功能部分损失，功能报废率3% | 8 | 产品缺陷会导致病人/用户严重健康损害 | 8
产品主要功能丧失，功能报废率10% | 9 | 产品缺陷会导致病人/用户生命危险或不可逆转的健康损害 | 9
产品主要功能和次要功能完全丧失，功能报废率10% | 10 | 产品缺陷会导致病人/用户死亡 | 10

Sheet: 附录B
评分标准
OCC（发生几率） |  | DET（失效模式的可察觉性）
标准 | 评分 | 标准 | 评分
<10ppm | 1 | 发生了必然被察觉 | 1
<100ppm | 2 | 一检查就能发现 | 2
<500ppm | 3 | 较多的检查才能发现 | 3
<1000ppm | 4 | 能被发现，检测方法可靠 | 4
<2500ppm | 5 | 可能被发现，检测方法可靠 | 5
<5000ppm | 6 | 可能被发现，检测方法相对可靠 | 6
<10000ppm | 7 | 难被肯定地发现，即使检测方法可靠 | 7
<25000ppm | 8 | 难被肯定地发现，即使检测方法相对可靠 | 8
<50000ppm | 9 | 很难被发现 | 9
<100000ppm | 10 | 似乎不可能察觉的到 | 10
