santan444/MS001/04-设计开发验证与确认阶段/可追溯性/MS-001可追溯性跟踪表_V1.1.xlsx

Sheet: 封面
MS-001
可追溯性跟踪表
 | 编制/时间：
 | 审核/时间：
 | 批准/时间：
 | 杭州三坛医疗科技有限公司

Sheet: 文档修订摘要
文档修订摘要
日期 | 版本号 | 修订章节 | 描述 | 作者
2020.10.29 | V1.0 | 可追溯性记录 | 二阶可追溯性记录（技术需求与用户需求） | 郭宏瑞
2021.08.31 | V1.1 | 可追溯性记录 | 四阶概要设计阶段，追踪概要设计 | 郭宏瑞

Sheet: readme
备忘：
1 | 已在表单页眉中设置了表单编号、版本号及页码情况。
2 | 医疗器械的网络安全可追溯性分析以下方式二选一： （1）提供独立的有关网络安全的可追溯分析； （2）提供整体的可追溯性报告，但需注明网络安全情况。
Readme
简介
本文档用于记录需求的相关信息和属性，管理需求与上下游工作产品的追踪关系。
操作说明
需求跟踪矩阵中所有列分成6个组，分别以不同的颜色标记，每组都可以折叠或展开（通过点击+\-). 各组详细说明如下：
字段 |  | 说明
1.用户需求跟踪 |  | 每一个用户需求可引伸出多个产品技术需求，并且多个用户需求可能需要相同的产品技术需求。在这里记录用户需求与产品技术需求之间的对应关系。可能是一对一、也可能是一对多的关系。
2.产品技术需求 | 状态 | 产品技术需求。 记录产品技术需求相关的信息，包括、、需求简要描述、需求状态。 需求状态包括： 1.已批准：该需求已经经过分析和评估，并确定了实现的版本，分配到相应的需求基线中； 2.已设计：该需求已经完成了设计； 3.已开发：该需求已经完成编码和单元测试；需求开发状态还可以进一步细分，如：提前完成/按时完成/延迟完成； 4.已测试：该需求已经完成了测试；需求测试状态还可以进一步细分，如：已系统测试，已用户测试； 5.已上线：该需求已经部署到生产系统。 6.已删除：由于需求变更原因，该需求已经被删除。
 | 技术需求编号
 | 简述
（软件需求跟踪） |  | 记录软件需求与产品技术需求、设计、代码、测试用例的关联关系。可能是一对一、也可能是一对多的关系。
3.设计文档追踪 |  | 记录产品技术需求与设计文档的关联关系。可能是一对一、也可能是一对多的关系。 设计可以跟踪到设计文档的章节。 设计文档可以是概要设计，也可以是详细设计，或者两者皆有。
4.下游工作产品跟踪 |  | 记录产品技术需求与设计、代码、测试用例的关联关系。可能是一对一、也可能是一对多的关系。 代码可以跟踪到代码文件。 测试可以跟踪到测试用例。
5.风险分析
6.需求变更信息 |  | 用于记录需求变更的过程。需求变更可以来源于用户、也可以来源于项目组内部。 需求变更类型包括新增、修改、删除。 1.新增：需要在矩阵中新增加一行，记录增加的需求点； 2.修改：直接修改原需求记录； 3.删除：原需求记录需要保留，只是将需求状态标记为“已删除”。
裁剪说明
允许裁剪的内容为： 1.用户需求跟踪。（对于由我方主导的纯研发项目，用户需求在适当情况下可裁剪） 软件需求。 3.设计文档，概要或详细至少追踪一种。
注意事项
无

Sheet: 可追溯性记录
1.用户需求追踪 |  | 2.产品技术需求 |  | 3.设计 |  |  | 4.验证、确认 |  |  |  | 5.风险分析
用户需求编号 | 用户需求描述 | 技术需求编号 | 技术需求描述 | 概设（文档及章节名称） | 详设（文档及章节名称） | 实现 | 单元测试 | 系统测试 | 产品验证 | 产品确认 | 风险编号
UR0101 | 整机设备有效期8年 | 170703 | 应最低满足8年的有效期。 | 《嵌入式硬件概要设计说明书》2.1章节功能需求与实现 《MS-001导引模块结构概要设计说明书》1.2章节产品非功能需求 《MS-001工具包结构概要设计说明书》1.2章节产品非功能需求 《MS-001规划模块结构概要设计说明书》1.2章节产品非功能需求； 《MS-001体位反馈模块结构概要设计说明书》1.2章节产品非功能需求 | 《MS-001嵌入式硬件详细设计说明书》 《MS-001导引模块结构详细设计说明书》 《MS-001规划模块结构详细设计说明书》 《MS-001工具包结构详细设计说明书》 《MS-001体位反馈模块结构详细设计说明书》 | 关键元件选型、 《MS001.01.001ZZ.1.1模块化手术导引系统》 | HP Elite/Pro系列MTBF证书 MTBF_25C_SR332-2_NEVOALL 电源NEVO+600M-1233 FPMH MTBF报告 MS-001规划模块焊接框架应力分析 MS-001外壳加速寿命测试报告 MS-001控制电路板加速寿命测试报告 MS-001导引模块焊接框架应力分析 UR5软件中文说明书 I II MS-001 UR机器人单元测试报告 UPS电源CASTLE1K(6G)承诺书（山特UPS3年保内服务） MS-001 升降立柱单元测试报告 MS-001工具包前端器械拆装次数试验报告 MS-001工具包套筒使用次数试验报告 MS-001 激光监测器测试报告 | 《MS-001有源医疗器械使用期限分析评价报告》 | 《MS-001有源医疗器械使用期限分析评价报告》 | 《可用性确认报告》 MS-001猪脊骨试验报告 MS-001模型试验报告 MS-001临床预试验报告 MS-001尸体试验报告 | R22、R23、R25
UR0102 | 电气安全要求符合相关标准 | 170201 | 非功能需求-电气安全-接地电阻：应符合GB 9706.1-2007 医用电气设备 第1部分：安全通用要求。 | 《嵌入式硬件概要设计说明书》2.1章节功能需求与实现 | 《MS-001嵌入式硬件详细设计说明书》 | 关键元件选型 电缆图 | / | 《系统整机验证报告》验证统计表15接地电阻 | 《系统整机验证报告》、型检的EMC检验报告、 型检的全性能检验报告 | 《可用性确认报告》 MS-001猪脊骨试验报告 MS-001模型试验报告 MS-001临床预试验报告 MS-001尸体试验报告 | /
 |  | 170202 | 非功能需求-电气安全-漏电流：应符合GB 9706.1-2007 医用电气设备 第1部分：安全通用要求。 | 《嵌入式硬件概要设计说明书》2.1章节功能需求与实现 | 《MS-001嵌入式硬件详细设计说明书》 | 关键元件选型 电缆图 | / | 《系统整机验证报告》验证统计表16正常工作温度下对地漏电流、 17正常工作温度下外壳漏电流、 18潮湿预处理后对地漏电流、 19潮湿预处理后外壳漏电流 | 《系统整机验证报告》、型检的EMC检验报告、 型检的全性能检验报告 | 《可用性确认报告》 MS-001猪脊骨试验报告 MS-001模型试验报告 MS-001临床预试验报告 MS-001尸体试验报告 | /
 |  | 170203 | 非功能需求-电气安全-绝缘：应符合GB 9706.1-2007 医用电气设备 第1部分：安全通用要求。 | 《嵌入式硬件概要设计说明书》2.1章节功能需求与实现 | 《MS-001嵌入式硬件详细设计说明书》 | 关键元件选型 电缆图 | / | 《系统整机验证报告》 | 《系统整机验证报告》、型检的EMC检验报告、 型检的全性能检验报告 | 《可用性确认报告》 MS-001猪脊骨试验报告 MS-001模型试验报告 MS-001临床预试验报告 MS-001尸体试验报告 | /
 |  | 170204 | 非功能需求-电气安全-爬电距离和电气间隙：应符合GB 9706.1-2007 医用电气设备 第1部分：安全通用要求。 | 《嵌入式硬件概要设计说明书》2.1章节功能需求与实现 | 《MS-001嵌入式硬件详细设计说明书》 | 关键元件选型 电缆图 | / | 《系统整机验证报告》 | 《系统整机验证报告》、型检的EMC检验报告、 型检的全性能检验报告 | 《可用性确认报告》 MS-001猪脊骨试验报告 MS-001模型试验报告 MS-001临床预试验报告 MS-001尸体试验报告 | /
UR0103 | EMC要求符合相关标准 | 170301 | 非功能需求-电磁兼容要求-辐射：应符合YY 0505-2012《医用电气设备 第1-2部分 安全通用要求并列标准 电磁兼容 要求和试验》的要求。 | 《嵌入式硬件概要设计说明书》2.1章节功能需求与实现 《MS-001导引模块结构概要设计说明书》1.2章节产品非功能需求 《MS-001规划模块结构概要设计说明书》1.2章节产品非功能需求 | 《MS-001嵌入式硬件详细设计说明书》 《MS-001导引模块结构详细设计说明书》 《MS-001规划模块结构详细设计说明书》 | 关键元件选型 电缆图 MS001-A.01.001ZZ.1.1规划模块 MS001-B.01.001ZZ.1.1导引模块 | / | 《系统整机验证报告》EMC检测 | 《系统整机验证报告》、型检的EMC检验报告、 型检的全性能检验报告 | 《可用性确认报告》 MS-001猪脊骨试验报告 MS-001模型试验报告 MS-001临床预试验报告 MS-001尸体试验报告 | /
 |  | 170302 | 非功能需求-电磁兼容要求-传导发射：应符合YY 0505-2012《医用电气设备 第1-2部分 安全通用要求并列标准 电磁兼容 要求和试验》的要求。 | 《嵌入式硬件概要设计说明书》2.1章节功能需求与实现 《MS-001导引模块结构概要设计说明书》1.2章节产品非功能需求 《MS-001规划模块结构概要设计说明书》1.2章节产品非功能需求 | 《MS-001嵌入式硬件详细设计说明书》 《MS-001导引模块结构详细设计说明书》 《MS-001规划模块结构详细设计说明书》 | 关键元件选型 电缆图 MS001-A.01.001ZZ.1.1规划模块 MS001-B.01.001ZZ.1.1导引模块 | / | 《系统整机验证报告》EMC检测 | 《系统整机验证报告》、型检的EMC检验报告、 型检的全性能检验报告 | 《可用性确认报告》 MS-001猪脊骨试验报告 MS-001模型试验报告 MS-001临床预试验报告 MS-001尸体试验报告 | /
 |  | 170303 | 非功能需求-电磁兼容要求-静电放电：应符合YY 0505-2012《医用电气设备 第1-2部分 安全通用要求并列标准 电磁兼容 要求和试验》的要求。 | 《嵌入式硬件概要设计说明书》2.1章节功能需求与实现 《MS-001导引模块结构概要设计说明书》1.2章节产品非功能需求 《MS-001规划模块结构概要设计说明书》1.2章节产品非功能需求 | 《MS-001嵌入式硬件详细设计说明书》 《MS-001导引模块结构详细设计说明书》 《MS-001规划模块结构详细设计说明书》 | 关键元件选型 电缆图 MS001-A.01.001ZZ.1.1规划模块 MS001-B.01.001ZZ.1.1导引模块 | / | 《系统整机验证报告》EMC检测 | 《系统整机验证报告》、型检的EMC检验报告、 型检的全性能检验报告 | 《可用性确认报告》 MS-001猪脊骨试验报告 MS-001模型试验报告 MS-001临床预试验报告 MS-001尸体试验报告 | /
 |  | 170304 | 非功能需求-电磁兼容要求-射频磁场辐射：应符合YY 0505-2012《医用电气设备 第1-2部分 安全通用要求并列标准 电磁兼容 要求和试验》的要求。 | 《嵌入式硬件概要设计说明书》2.1章节功能需求与实现 《MS-001导引模块结构概要设计说明书》1.2章节产品非功能需求 《MS-001规划模块结构概要设计说明书》1.2章节产品非功能需求 | 《MS-001嵌入式硬件详细设计说明书》 《MS-001导引模块结构详细设计说明书》 《MS-001规划模块结构详细设计说明书》 | 关键元件选型 电缆图 MS001-A.01.001ZZ.1.1规划模块 MS001-B.01.001ZZ.1.1导引模块 | / | 《系统整机验证报告》EMC检测 | 《系统整机验证报告》、型检的EMC检验报告、 型检的全性能检验报告 | 《可用性确认报告》 MS-001猪脊骨试验报告 MS-001模型试验报告 MS-001临床预试验报告 MS-001尸体试验报告 | /
 |  | 170305 | 非功能需求-电磁兼容要求-脉冲群：应符合YY 0505-2012《医用电气设备 第1-2部分 安全通用要求并列标准 电磁兼容 要求和试验》的要求。 | 《嵌入式硬件概要设计说明书》2.1章节功能需求与实现 《MS-001导引模块结构概要设计说明书》1.2章节产品非功能需求 《MS-001规划模块结构概要设计说明书》1.2章节产品非功能需求 | 《MS-001嵌入式硬件详细设计说明书》 《MS-001导引模块结构详细设计说明书》 《MS-001规划模块结构详细设计说明书》 | 关键元件选型 电缆图 MS001-A.01.001ZZ.1.1规划模块 MS001-B.01.001ZZ.1.1导引模块 | / | 《系统整机验证报告》EMC检测 | 《系统整机验证报告》、型检的EMC检验报告、 型检的全性能检验报告 | 《可用性确认报告》 MS-001猪脊骨试验报告 MS-001模型试验报告 MS-001临床预试验报告 MS-001尸体试验报告 | /
 |  | 170306 | 非功能需求-电磁兼容要求-浪涌：应符合YY 0505-2012《医用电气设备 第1-2部分 安全通用要求并列标准 电磁兼容 要求和试验》的要求。 | 《嵌入式硬件概要设计说明书》2.1章节功能需求与实现 《MS-001导引模块结构概要设计说明书》1.2章节产品非功能需求 《MS-001规划模块结构概要设计说明书》1.2章节产品非功能需求 | 《MS-001嵌入式硬件详细设计说明书》 《MS-001导引模块结构详细设计说明书》 《MS-001规划模块结构详细设计说明书》 | 关键元件选型 电缆图 MS001-A.01.001ZZ.1.1规划模块 MS001-B.01.001ZZ.1.1导引模块 | / | 《系统整机验证报告》EMC检测 | 《系统整机验证报告》、型检的EMC检验报告、 型检的全性能检验报告 | 《可用性确认报告》 MS-001猪脊骨试验报告 MS-001模型试验报告 MS-001临床预试验报告 MS-001尸体试验报告 | /
 |  | 170307 | 非功能需求-电磁兼容要求-射频场传导骚扰：应符合YY 0505-2012《医用电气设备 第1-2部分 安全通用要求并列标准 电磁兼容 要求和试验》的要求。 | 《嵌入式硬件概要设计说明书》2.1章节功能需求与实现 《MS-001导引模块结构概要设计说明书》1.2章节产品非功能需求 《MS-001规划模块结构概要设计说明书》1.2章节产品非功能需求 | 《MS-001嵌入式硬件详细设计说明书》 《MS-001导引模块结构详细设计说明书》 《MS-001规划模块结构详细设计说明书》 | 关键元件选型 电缆图 MS001-A.01.001ZZ.1.1规划模块 MS001-B.01.001ZZ.1.1导引模块 | / | 《系统整机验证报告》EMC检测 | 《系统整机验证报告》、型检的EMC检验报告、 型检的全性能检验报告 | 《可用性确认报告》 MS-001猪脊骨试验报告 MS-001模型试验报告 MS-001临床预试验报告 MS-001尸体试验报告 | /
 |  | 170308 | 非功能需求-电磁兼容要求-电压暂降、短时中断：应符合YY 0505-2012《医用电气设备 第1-2部分 安全通用要求并列标准 电磁兼容 要求和试验》的要求。 | 《嵌入式硬件概要设计说明书》2.1章节功能需求与实现 《MS-001导引模块结构概要设计说明书》1.2章节产品非功能需求 《MS-001规划模块结构概要设计说明书》1.2章节产品非功能需求 | 《MS-001嵌入式硬件详细设计说明书》 《MS-001导引模块结构详细设计说明书》 《MS-001规划模块结构详细设计说明书》 | 关键元件选型 电缆图 MS001-A.01.001ZZ.1.1规划模块 MS001-B.01.001ZZ.1.1导引模块 | / | 《系统整机验证报告》EMC检测 | 《系统整机验证报告》、型检的EMC检验报告、 型检的全性能检验报告 | 《可用性确认报告》 MS-001猪脊骨试验报告 MS-001模型试验报告 MS-001临床预试验报告 MS-001尸体试验报告 | /
 |  | 170309 | 非功能需求-电磁兼容要求-工频磁场：应符合YY 0505-2012《医用电气设备 第1-2部分 安全通用要求并列标准 电磁兼容 要求和试验》的要求。 | 《嵌入式硬件概要设计说明书》2.1章节功能需求与实现 《MS-001导引模块结构概要设计说明书》1.2章节产品非功能需求 《MS-001规划模块结构概要设计说明书》1.2章节产品非功能需求 | 《MS-001嵌入式硬件详细设计说明书》 《MS-001导引模块结构详细设计说明书》 《MS-001规划模块结构详细设计说明书》 | 关键元件选型 电缆图 MS001-A.01.001ZZ.1.1规划模块 MS001-B.01.001ZZ.1.1导引模块 | / | 《系统整机验证报告》EMC检测 | 《系统整机验证报告》、型检的EMC检验报告、 型检的全性能检验报告 | 《可用性确认报告》 MS-001猪脊骨试验报告 MS-001模型试验报告 MS-001临床预试验报告 MS-001尸体试验报告 | /
UR0104 | 环境要求符合相关标准 | 170601 | 环境试验应符合 GB/T 14710-2009 《医用电器环境要求及试验方法》并制定相应的环境试验表。 | 《嵌入式硬件概要设计说明书》2.1章节功能需求与实现 《MS-001导引模块结构概要设计说明书》1.2章节产品非功能需求 《MS-001工具包结构概要设计说明书》1.2章节产品非功能需求 《MS-001规划模块结构概要设计说明书》1.2章节产品非功能需求； 《MS-001体位反馈模块结构概要设计说明书》1.2章节产品非功能需求 | 《MS-001嵌入式硬件详细设计说明书》 《MS-001导引模块结构详细设计说明书》 《MS-001规划模块结构详细设计说明书》 《MS-001工具包结构详细设计说明书》 《MS-001体位反馈模块结构详细设计说明书》 | 整机、 MS001-A.01.001ZZ.1.1规划模块 MS001-B.01.001ZZ.1.1导引模块 MS001-C.01.001ZZ.1.1 工具包 MS001-D.01.001ZZ.1.1体位反馈模块 | / | 《系统整机验证报告》验证统计表27额定工作低温试验 28低温贮存试验 29额定工作高温试验 30运行试验 31高温贮存试验 32额定工作湿热试验 33湿热贮存试验 | 《系统整机验证报告》、型检的EMC检验报告、 型检的全性能检验报告 | 《可用性确认报告》 MS-001猪脊骨试验报告 MS-001模型试验报告 MS-001临床预试验报告 MS-001尸体试验报告 | /
UR0105 | 网络安全要求符合相关标准 | 170501 | 非功能需求-网络安全-保密性：产品实现自身和相关的数据仅可由授权用户在授权的时间以授权的方式进行访问和使用。 | 《规划软件概要设计说明书》8.11.1 | 《规划软件详细设计说明书》4章 | 登录-on_pButton_login_clicked、 登录-getUserInfo、 登录-getDBPassword | A-UT0201001、 A-UT0202002、 A-UT0202007 | 《规划软件系统测试用例》-用户访问控制测试 | 《MS-001规划软件系统测试报告》、 《MS-001规划软件网络安全测试报告》 | 《可用性确认报告》 MS-001猪脊骨试验报告 MS-001模型试验报告 MS-001临床预试验报告 MS-001尸体试验报告 | H10、H11
 |  | 170501 | 非功能需求-网络安全-保密性：产品实现自身和相关的数据仅可由授权用户在授权的时间以授权的方式进行访问和使用。 | 《导引软件概要设计说明书》8.11.1 | 《导引软件详细设计说明书》6章节 | 登录-Login、 登录-GetPassword、 登录-GetLogin、 登录-GetUserInfo | B-UT0401001、 B-UT0401004、 B-UT0401006、 B-UT0401015 | 《导引软件系统测试用例》-登录 | MS-001导引软件系统测试报告、 MS-001导引软件网络安全测试报告 | 《可用性确认报告》 MS-001猪脊骨试验报告 MS-001模型试验报告 MS-001临床预试验报告 MS-001尸体试验报告 | H22
 |  | 170502 | 非功能需求-网络安全-完整性：应实现产品相关数据是准确和完整的，且不能被篡改。 | 《规划软件概要设计说明书》8.3.1、8.9.1 | 《规划软件详细设计说明书》7章 | 数据管理-initUI、 数据管理-initPatientList、 数据管理-updatePatientList、 数据管理-dataRowClicked、 数据管理-dataRowDoubleClicked、 数据管理-receiveSearchClicked、 数据管理-receiveClearClicked、 数据管理-initPatientListWithParam、 数据管理-StartImport | A-UT0504001、 A-UT0504002、 A-UT0504003、 A-UT0504004、 A-UT0504005、 A-UT0504006、 A-UT0504007、 A-UT0504008、 A-UT0505003 | 《规划软件系统测试用例》-信息安全测试 | 《MS-001规划软件系统测试报告》、 《MS-001规划软件网络安全测试报告》 | 《可用性确认报告》 MS-001猪脊骨试验报告 MS-001模型试验报告 MS-001临床预试验报告 MS-001尸体试验报告 | H12
 |  | 170502 | 非功能需求-网络安全-完整性：应实现产品相关数据是准确和完整的，且不能被篡改。 | 《导引软件概要设计说明书》8.3.1、8.9.1 | 《导引软件详细设计说明书》12章 | 配置-initNetworkReg、 配置-InitToolSelectView、 配置-LoadToolInformation、 定位-Start、 定位-Simulation 网络-ByteCount、 网络-Bits、 网络-PosMatrixData、 网络-Parse、 网络-ParseData | B-UT0601001、 B-UT0612004、 B-UT0612005、 B-UT0201040、 B-UT0201010 B-UT1001007、 B-UT1001008、 B-UT1002001、 B-UT1002005、 B-UT1003022 | 《导引软件网络安全测试用例》 | 《MS-001导引软件系统测试报告》、 《MS-001导引软件网络安全测试报告》 | 《可用性确认报告》 MS-001猪脊骨试验报告 MS-001模型试验报告 MS-001临床预试验报告 MS-001尸体试验报告 | /
 |  | 170503 | 非功能需求-网络安全-可得性：应实现产品自身和相关数据能以预期方式适时进行访问和使用。 | 《规划软件概要设计说明书》8.3.1 | 《规划软件详细设计说明书》4章 | 登录-on_pButton_login_clicked、 登录-getUserInfo、 登录-getDBPassword | A-UT0201001、 A-UT0202002、 A-UT0202007 | 《规划软件系统测试用例》-用户访问控制测试 《规划软件系统测试用例》-信息安全测试 | 《MS-001规划软件系统测试报告》、 《MS-001规划软件网络安全测试报告》 | 《可用性确认报告》 MS-001猪脊骨试验报告 MS-001模型试验报告 MS-001临床预试验报告 MS-001尸体试验报告 | /
 |  | 170503 | 非功能需求-网络安全-可得性：应实现产品自身和相关数据能以预期方式适时进行访问和使用。 | 《导引软件概要设计说明书》8.3.1 | 《导引软件详细设计说明书》6章 | 登录-Login、 登录-GetPassword、 登录-GetLogin、 登录-GetUserInfo | B-UT0401001、 B-UT0401004、 B-UT0401006、 B-UT0401015 | 《导引软件系统测试用例》-帮助 《导引软件系统测试用例》-其他 | 《MS-001导引软件系统测试报告》、 《MS-001导引软件网络安全测试报告》 | 《可用性确认报告》 MS-001猪脊骨试验报告 MS-001模型试验报告 MS-001临床预试验报告 MS-001尸体试验报告 | /
 |  | 170504 | 非功能需求-网络安全-真实性：产品应符合其所宣称技术。 | 《规划软件概要设计说明书》8.7.1 | 《规划软件详细设计说明书》3.6、8.6、9.6、10.6、11.6、12.6、13.6章节 | / | 《规划软件单元测试报告》 | 《规划软件系统测试用例》-信息安全测试 | 《MS-001规划软件系统测试报告》、 《MS-001规划软件网络安全测试报告》 | 《可用性确认报告》 MS-001猪脊骨试验报告 MS-001模型试验报告 MS-001临床预试验报告 MS-001尸体试验报告 | /
 |  | 170504 | 非功能需求-网络安全-真实性：产品应符合其所宣称技术。 | 《导引软件概要设计说明书》8.7.1 | 《导引软件详细设计说明书》3.6、5.6、11.6章节 | / | 《导引软件单元测试报告》 | 《导引软件网络安全测试用例》 | 《MS-001导引软件系统测试报告》、 《MS-001导引软件网络安全测试报告》 | 《可用性确认报告》 MS-001猪脊骨试验报告 MS-001模型试验报告 MS-001临床预试验报告 MS-001尸体试验报告 | /
 |  | 170505 | 非功能需求-网络安全-抗抵赖性：产品应实现可证明宣称的技术的实际结果。 | 《规划软件概要设计说明书》8.7.1 | 《规划软件详细设计说明书》3.11、8.11、9.11、10.11、11.11、12.11、13.11章节 | / | 《规划软件单元测试报告》 | 《规划软件系统测试用例》-信息安全测试 | 《MS-001规划软件系统测试报告》、 《MS-001规划软件网络安全测试报告》 | 《可用性确认报告》 MS-001猪脊骨试验报告 MS-001模型试验报告 MS-001临床预试验报告 MS-001尸体试验报告 | /
 |  | 170505 | 非功能需求-网络安全-抗抵赖性：产品应实现可证明宣称的技术的实际结果。 | 《导引软件概要设计说明书》8.7.1 | 《导引软件详细设计说明书》3.11、5.11、11.11章节 | / | 《导引软件单元测试报告》 | 《导引软件网络安全测试用例》-帮助 | 《MS-001导引软件系统测试报告》、 《MS-001导引软件网络安全测试报告》 | 《可用性确认报告》 MS-001猪脊骨试验报告 MS-001模型试验报告 MS-001临床预试验报告 MS-001尸体试验报告 | /
 |  | 170506 | 非功能需求-网络安全-可核查性：产品应实现过程可记录、可追溯 | 《规划软件概要设计说明书》8.10.1 | 《规划软件详细设计说明书》16章节 | 日志记录-Logger、 日志导出-ExportSessionData | A-UT1401002、 A-UT1501004 | 《规划软件系统测试用例》-信息安全测试 | 《MS-001规划软件系统测试报告》、 《MS-001规划软件网络安全测试报告》 | 《可用性确认报告》 MS-001猪脊骨试验报告 MS-001模型试验报告 MS-001临床预试验报告 MS-001尸体试验报告 | /
 |  | 170506 | 非功能需求-网络安全-可核查性：产品应实现过程可记录、可追溯 | 《导引软件概要设计说明书》8.10.1 | 《导引软件详细设计说明书》9章节 | 日志-WriteMilestoneLogInfo、 日志-WriteMilestoneLogWarn、 日志-WriteMilestoneLogError、 日志-MilestoneLogEndLog、 日志-WritLogInfo、 日志-WriteLogWarning、 日志-WriteLogError、 日志-EndLog | B-UT0701001、 B-UT0701002、 B-UT0701003、 B-UT0701004、 B-UT0702001、 B-UT0702002、 B-UT0702003、 B-UT0702004 | 《导引软件系统测试用例》-帮助 | 《MS-001导引软件系统测试报告》、 《MS-001导引软件网络安全测试报告》 | 《可用性确认报告》 MS-001猪脊骨试验报告 MS-001模型试验报告 MS-001临床预试验报告 MS-001尸体试验报告 | /
 |  | 170507 | 非功能需求-网络安全-可靠性：产品应实现预期设计、结果与实际设计、结果相一致。 | 《规划软件概要设计说明书》8.7.1 | 《规划软件详细设计说明书》3.11至18.11章节 | / | 《规划软件单元测试报告》 | 《规划软件网络安全测试用例》 | 《MS-001规划软件系统测试报告》、 《MS-001规划软件网络安全测试报告》 | 《可用性确认报告》 MS-001猪脊骨试验报告 MS-001模型试验报告 MS-001临床预试验报告 MS-001尸体试验报告 | /
 |  | 170507 | 非功能需求-网络安全-可靠性：产品应实现预期设计、结果与实际设计、结果相一致。 | 《导引软件概要设计说明书》8.7.1 | 《导引软件详细设计说明书》3.11至13.11章节 | / | 《导引软件单元测试报告》 | 《导引软件网络安全测试用例》 | 《MS-001导引软件系统测试报告》、 《MS-001导引软件网络安全测试报告》 | 《可用性确认报告》 MS-001猪脊骨试验报告 MS-001模型试验报告 MS-001临床预试验报告 MS-001尸体试验报告 | /
 |  | 170508 | 非功能需求-网络安全-相关数据：产品应实现医疗数据和设备数据要求符合《医疗器械网络安全注册审查指导原则》的要求。 | 《规划软件概要设计说明书》8.1.1 | 《规划软件详细设计说明书》1.4 | / | 《规划软件单元测试报告》 | 《规划软件网络安全测试用例》 | 《MS-001规划软件系统测试报告》、 《MS-001规划软件网络安全测试报告》 | 《可用性确认报告》 MS-001猪脊骨试验报告 MS-001模型试验报告 MS-001临床预试验报告 MS-001尸体试验报告 | /
 |  | 170508 | 非功能需求-网络安全-相关数据：产品应实现医疗数据和设备数据要求符合《医疗器械网络安全注册审查指导原则》的要求。 | 《导引软件概要设计说明书》8.1.1 | 《导引软件详细设计说明书》1.4 | / | 《导引软件单元测试报告》 | 《导引软件网络安全测试用例》 | 《MS-001导引软件系统测试报告》、 《MS-001导引软件网络安全测试报告》 | 《可用性确认报告》 MS-001猪脊骨试验报告 MS-001模型试验报告 MS-001临床预试验报告 MS-001尸体试验报告 | /
 |  | 170509 | 非功能需求-网络安全-电子接口：产品应实现电子接口要求符合《医疗器械网络安全注册审查指导原则》的要求。 | 《嵌入式硬件概要设计说明书》2.1章节功能需求与实现 | 《MS-001嵌入式硬件详细设计说明书》 | / | / | 《系统整机验证报告》 | 型检的EMC检验报告、 型检的全性能检验报告 | 《可用性确认报告》 MS-001猪脊骨试验报告 MS-001模型试验报告 MS-001临床预试验报告 MS-001尸体试验报告 | /
UR0200 | 本产品应该提供规划功能，用于手术方案的规划和制定 | 000101 | 产品性能需求-01手术规划手术-路径允许规划数：≤50 | 《规划软件概要设计说明书》8.3.1 | 《规划软件详细设计说明书》10.3 | 规划软件-规划-GetLine | A-UT0802003 | 《规划软件系统测试用例》-性能 | 《MS-001规划软件系统测试报告》 | 《可用性确认报告》 MS-001猪脊骨试验报告 MS-001模型试验报告 MS-001临床预试验报告 MS-001尸体试验报告 | /
 |  | 000102 | 产品性能需求-01手术规划-软件能对术前CT等数据进行三维重建 | 《规划软件概要设计说明书》8.4.1 | 《规划软件详细设计说明书》8.1 | 规划软件-CT分区-InitView | A-UT0701002 | 《规划软件系统测试用例》-切割复位 | 《MS-001规划软件系统测试报告》 | 《可用性确认报告》 MS-001猪脊骨试验报告 MS-001模型试验报告 MS-001临床预试验报告 MS-001尸体试验报告 | /
 |  | 000103 | 产品性能需求-01手术规划-软件能对重建数据（横断位、冠状位、矢状位、3D视图）进行常规的旋转、平移、缩放及窗口窗位调整等交互操作 | 《规划软件概要设计说明书》8.7.1 | 《规划软件详细设计说明书》8.2 | 规划软件-数据管理-InitWindowLevel、 规划软件-数据管理-SetWindowLevel、 规划软件-数据管理-wheelEvent | A-UT0505004、 A-UT0505008、 A-UT0505010 | 《规划软件系统测试用例》-手术规划 | 《MS-001规划软件系统测试报告》 | 《可用性确认报告》 MS-001猪脊骨试验报告 MS-001模型试验报告 MS-001临床预试验报告 MS-001尸体试验报告 | /
 |  | 000104 | 产品性能需求-01手术规划-软件能进行手术路径的规划操作，可以定义手术通道的直径大小、方向、长度及颜色等 | 《规划软件概要设计说明书》8.7.1 | 《规划软件详细设计说明书》10.1 | 规划软件-规划-GetLine、 规划软件-规划-LineOperationButtonClicked | A-UT0802003、 A-UT0807013 | 《规划软件系统测试用例》-手术规划 | 《MS-001规划软件系统测试报告》 | 《可用性确认报告》 MS-001猪脊骨试验报告 MS-001模型试验报告 MS-001临床预试验报告 MS-001尸体试验报告 | R134、R135、R136
 |  | 000105 | 产品性能需求-01手术规划-软件可实现2D图像与3D图像的自动配准功能 | 《规划软件概要设计说明书》8.7.1 | 《规划软件详细设计说明书》12.2 | 规划软件-配准-coarseMatching 规划软件-配准-clearAllVectorData 规划软件-配准-changeBoxByItemIndex | A-UT1002001、 A-UT1002029、 A-UT1002034 | 《规划软件系统测试用例》-图像配准 | 《MS-001规划软件系统测试报告》 | 《可用性确认报告》 MS-001猪脊骨试验报告 MS-001模型试验报告 MS-001临床预试验报告 MS-001尸体试验报告 | /
 |  | 000106 | 产品性能需求-01手术规划-X光片椎体分割数量≤12 | 《规划软件概要设计说明书》8.3.1 | 《规划软件详细设计说明书》11.2 | 规划软件-X-Ray分区-JudgeAddSpineBox | A-UT0902013 | 《规划软件系统测试用例》--性能测试 | 《MS-001规划软件系统测试报告》 | 《可用性确认报告》 MS-001猪脊骨试验报告 MS-001模型试验报告 MS-001临床预试验报告 MS-001尸体试验报告 | /
 |  | 000107 | 产品性能需求-01手术规划-CT三维椎体分割数量≤12 | 《规划软件概要设计说明书》8.3.1 | 《规划软件详细设计说明书》9.2 | 规划软件-CT分区-AddNewBox | A-UT0702004 | 《规划软件系统测试用例》--性能测试 | 《MS-001规划软件系统测试报告》 | 《可用性确认报告》 MS-001猪脊骨试验报告 MS-001模型试验报告 MS-001临床预试验报告 MS-001尸体试验报告 | /
 |  | 000108 | 产品性能需求-01手术规划-切割列表数量≤10 | 《规划软件概要设计说明书》8.3.1 | 《规划软件详细设计说明书》8.1 | 规划软件-切割复位-pushVolumes | A-UT0604021 | 《规划软件系统测试用例》--性能测试 | 《MS-001规划软件系统测试报告》 | 《可用性确认报告》 MS-001猪脊骨试验报告 MS-001模型试验报告 MS-001临床预试验报告 MS-001尸体试验报告 | /
UR0300 | 本产品应该提供手术定位功能，用于定位信息发送、指引手术位置 | 000201 | 三维定位精度：≤1.5mm | / | / | 软件编码 | 《导引软件单元测试报告》 | 《导引软件系统测试用例》-定位 | 《系统整机验证报告》、《MS-001导引软件系统测试报告》 | 《可用性确认报告》 MS-001猪脊骨试验报告 MS-001模型试验报告 MS-001临床预试验报告 MS-001尸体试验报告 | /
 |  | 000202 | 三维定位角度：≤1º | / | / | 软件编码 | 《导引软件单元测试报告》 | 《导引软件系统测试用例》-定位 《导引软件系统测试用例》-性能测试 | 《系统整机验证报告》、《MS-001导引软件系统测试报告》 | 《可用性确认报告》 MS-001猪脊骨试验报告 MS-001模型试验报告 MS-001临床预试验报告 MS-001尸体试验报告 | /
 |  | 000203 | 正、侧位手眼标定所用时间应≤10秒（点击校准至弹出确认图片） | 《导引软件概要设计说明书》8.4.1 | 《导引软件详细设计说明书》3.3 | 导引软件-校准-Registration、 导引软件-校准-Process | B-UT0101001、 B-UT0101007 | 《导引软件系统测试用例》-校准 《导引软件系统测试用例》-性能测试 | 《系统整机验证报告》、《MS-001导引软件系统测试报告》 | 《可用性确认报告》 MS-001猪脊骨试验报告 MS-001模型试验报告 MS-001临床预试验报告 MS-001尸体试验报告 | /
 |  | 000204 | 仿真计算时间应≤3秒（点击姿态仿真至模型开始运动前） | 《导引软件概要设计说明书》8.4.1 | 《导引软件详细设计说明书》5.3 | 导引软件-仿真-FindTrees、 导引软件-仿真-JudgeReach | B-UT0301006、 B-UT0301010 | 《导引软件系统测试用例》-性能测试 | 《系统整机验证报告》、《MS-001导引软件系统测试报告》 | 《可用性确认报告》 MS-001猪脊骨试验报告 MS-001模型试验报告 MS-001临床预试验报告 MS-001尸体试验报告 | /
 |  | 000205 | 定位时间：≤10秒 | 《嵌入式硬件概要设计说明书》2.1章节功能需求与实现 | 《MS-001嵌入式硬件详细设计说明书》 | / | / | 《系统整机验证报告》 | 《系统整机验证报告》 | 《可用性确认报告》 MS-001猪脊骨试验报告 MS-001模型试验报告 MS-001临床预试验报告 MS-001尸体试验报告 | /
UR0400 | 本产品应该提供术中监测功能，用于监测术中患者的移动情况 | 140001 | 体位反馈功能需求-使用环境-手术室 | 《嵌入式硬件概要设计说明书》2.1章节功能需求与实现 《MS-001体位反馈模块结构概要设计说明书》1.1章节产品功能需求 | 《MS-001嵌入式硬件详细设计说明书》 《MS-001体位反馈模块结构详细设计说明书》 | MS001-D.01.001ZZ.1.1体位反馈模块 | / | 《系统整机验证报告》 | 《可用性验证报告》 | 《可用性确认报告》 MS-001猪脊骨试验报告 MS-001模型试验报告 MS-001临床预试验报告 MS-001尸体试验报告 | /
 |  | 140002 | 体位反馈功能需求-安装方式-安装在手术导引台车 | 《嵌入式硬件概要设计说明书》2.1章节功能需求与实现 《MS-001体位反馈模块结构概要设计说明书》1.1章节产品功能需求 | 《MS-001嵌入式硬件详细设计说明书》 《MS-001体位反馈模块结构详细设计说明书》 | MS001-D.01.008SL.1.1下外壳 | / | 《系统整机验证报告》外观 | 《可用性验证报告》 | 《可用性确认报告》 MS-001猪脊骨试验报告 MS-001模型试验报告 MS-001临床预试验报告 MS-001尸体试验报告 | R73
 |  | 140003 | 体位反馈功能需求-安装方式-安装在手术室 | 《嵌入式硬件概要设计说明书》2.1章节功能需求与实现 《MS-001体位反馈模块结构概要设计说明书》1.1章节产品功能需求 | 《MS-001嵌入式硬件详细设计说明书》 《MS-001体位反馈模块结构详细设计说明书》 | MS001-D.01.008SL.1.1 MS001-D下外壳 | / | 《系统整机验证报告》 | 《可用性验证报告》 | 《可用性确认报告》 MS-001猪脊骨试验报告 MS-001模型试验报告 MS-001临床预试验报告 MS-001尸体试验报告 | /
 |  | 140004 | 体位反馈功能需求-供电方式-独立电池供电 | 《嵌入式硬件概要设计说明书》2.1章节功能需求与实现 《MS-001体位反馈模块结构概要设计说明书》1.1章节产品功能需求 | 《MS-001嵌入式软件详细设计说明书》 《MS-001体位反馈模块结构详细设计说明书》 | MS001-D.01.003SL.1.1 MS001-D上外壳 | 《MS-001 激光监测器测试方案》 《MS-001 激光监测器测试报告》 | 《系统整机验证报告》 | 《系统整机验证报告》、《可用性验证报告》 | 《可用性确认报告》 MS-001猪脊骨试验报告 MS-001模型试验报告 MS-001临床预试验报告 MS-001尸体试验报告 | R27
 |  | 140005 | 体位反馈功能需求-开关按钮-开关功能 | 《嵌入式硬件概要设计说明书》2.1章节功能需求与实现 《MS-001体位反馈模块结构概要设计说明书》1.1章节产品功能需求 | 《MS-001嵌入式软件详细设计说明书》 《MS-001体位反馈模块结构详细设计说明书》 | MS001-D.01.002SL.1.1 MS001-D开关 | 《MS-001 激光监测器测试方案》 《MS-001 激光监测器测试报告》 | 《系统整机验证报告》 | 《系统整机验证报告》、《可用性验证报告》 | 《可用性确认报告》 MS-001猪脊骨试验报告 MS-001模型试验报告 MS-001临床预试验报告 MS-001尸体试验报告 | /
 |  | 140006 | 体位反馈功能需求-开关按钮-激光亮度调节功能 | 《嵌入式硬件概要设计说明书》2.1章节功能需求与实现 《MS-001体位反馈模块结构概要设计说明书》1.1章节产品功能需求 | 《MS-001嵌入式软件详细设计说明书》 《MS-001体位反馈模块结构详细设计说明书》 | MS001-D.01.006SL.1. MS001-D转轮 MS001-D.01.007SL.1.1 MS001-D转动轴 | 《MS-001 激光监测器测试方案》 《MS-001 激光监测器测试报告》 | 《系统整机验证报告》 | 《系统整机验证报告》、《可用性验证报告》 | 《可用性确认报告》 MS-001猪脊骨试验报告 MS-001模型试验报告 MS-001临床预试验报告 MS-001尸体试验报告 | R4
 |  | 140007 | 体位反馈功能需求-造型风格-科技、简约、专业 | 《MS-001体位反馈模块结构概要设计说明书》1.1章节产品功能需求 | 《MS-001体位反馈模块结构详细设计说明书》 | MS001-D.01.003SL.1.1 MS001-D上外壳 MS001-D.01.008SL.1.1 MS001-D下外壳 | / | 《系统整机验证报告》 | 《可用性验证报告》 | 《可用性确认报告》 MS-001猪脊骨试验报告 MS-001模型试验报告 MS-001临床预试验报告 MS-001尸体试验报告 | /
 |  | 140008 | 体位反馈功能需求-设备组成-纽扣电池/7号电池 | 《嵌入式硬件概要设计说明书》2.1章节功能需求与实现 《MS-001体位反馈模块结构概要设计说明书》1.1章节产品功能需求 | 《MS-001嵌入式软件详细设计说明书》 《MS-001体位反馈模块结构详细设计说明书》 | MS001-D.01.003SL.1.1 MS001-D上外壳 MS001-D.01.008SL.1.1 MS001-D下外壳 | 《MS-001 激光监测器测试方案》 《MS-001 激光监测器测试报告》 | 《系统整机验证报告》 | 《系统整机验证报告》、《可用性验证报告》 | 《可用性确认报告》 MS-001猪脊骨试验报告 MS-001模型试验报告 MS-001临床预试验报告 MS-001尸体试验报告 | /
 |  | 140009 | 体位反馈功能需求-设备组成-PCB板 | 《嵌入式硬件概要设计说明书》2.1章节功能需求与实现 《MS-001体位反馈模块结构概要设计说明书》1.1章节产品功能需求 | 《MS-001嵌入式软件详细设计说明书》 《MS-001体位反馈模块结构详细设计说明书》 | MS001-D.01.003SL.1.1 MS001-D上外壳 MS001-D.01.008SL.1.1 MS001-D下外壳 | 《MS-001 激光监测器测试方案》 《MS-001 激光监测器测试报告》 | 《系统整机验证报告》 | 《系统整机验证报告》 | 《可用性确认报告》 MS-001猪脊骨试验报告 MS-001模型试验报告 MS-001临床预试验报告 MS-001尸体试验报告 | /
 |  | 140010 | 体位反馈功能需求-设备组成-激光头组1组/3组 | 《MS-001体位反馈模块结构概要设计说明书》1.1章节产品功能需求 | 《MS-001体位反馈模块结构详细设计说明书》 | MS001-D.01.006SL.1. MS001-D转轮 MS001-D.01.007SL.1.1 MS001-D转动轴 | 《MS-001 激光监测器测试方案》 《MS-001 激光监测器测试报告》 | 《系统整机验证报告》 | 《可用性验证报告》 | 《可用性确认报告》 MS-001猪脊骨试验报告 MS-001模型试验报告 MS-001临床预试验报告 MS-001尸体试验报告 | R4
 |  | 140011 | 体位反馈功能需求-设备组成-激光栅片1片/6片 | 《MS-001体位反馈模块结构概要设计说明书》1.1章节产品功能需求 | 《MS-001体位反馈模块结构详细设计说明书》 | MS001-D.01.009BK.1.1 MS001-D衍射片 | 《MS-001 激光监测器测试方案》 《MS-001 激光监测器测试报告》 | 《系统整机验证报告》 | 《可用性验证报告》 | 《可用性确认报告》 MS-001猪脊骨试验报告 MS-001模型试验报告 MS-001临床预试验报告 MS-001尸体试验报告 | R4
 |  | 140012 | 体位反馈功能需求-结构设计-与手术导引系统台车结构可配合安装 | 《MS-001体位反馈模块结构概要设计说明书》1.1章节产品功能需求 | 《MS-001体位反馈模块结构详细设计说明书》 | MS001-D.01.008SL.1.1 MS001-D下外壳 | / | 《系统整机验证报告》 | 《可用性验证报告》 | 《可用性确认报告》 MS-001猪脊骨试验报告 MS-001模型试验报告 MS-001临床预试验报告 MS-001尸体试验报告 | R73
 |  | 140013 | 体位反馈功能需求-结构设计-可独立安装在手术室内其他位置/墙壁/无影灯 | 《MS-001体位反馈模块结构概要设计说明书》1.1章节产品功能需求 | 《MS-001体位反馈模块结构详细设计说明书》 | MS001-D.01.008SL.1.1 MS001-D下外壳 | / | 《系统整机验证报告》 | 《可用性验证报告》 | 《可用性确认报告》 MS-001猪脊骨试验报告 MS-001模型试验报告 MS-001临床预试验报告 MS-001尸体试验报告 | /
 |  | 140014 | 体位反馈功能需求-结构设计-激光栅片转换装置 | 《MS-001体位反馈模块结构概要设计说明书》1.1章节产品功能需求 | 《MS-001体位反馈模块结构详细设计说明书》 | MS001-D.01.006SL.1. MS001-D转轮 MS001-D.01.007SL.1.1 MS001-D转动轴 MS001-D.01.009BK.1.1 MS001-D衍射片 | 《MS-001 激光监测器测试方案》 《MS-001 激光监测器测试报告》 | 《系统整机验证报告》 | 《可用性验证报告》 | 《可用性确认报告》 MS-001猪脊骨试验报告 MS-001模型试验报告 MS-001临床预试验报告 MS-001尸体试验报告 | /
 |  | 140015 | 体位反馈功能需求-结构设计-激光亮度调节按钮 | 《MS-001体位反馈模块结构概要设计说明书》1.1章节产品功能需求 | 《MS-001体位反馈模块结构详细设计说明书》 | MS001-D.01.006SL.1. MS001-D转轮 MS001-D.01.007SL.1.1 MS001-D转动轴 MS001-D.01.009BK.1.1 MS001-D衍射片 | 《MS-001 激光监测器测试方案》 《MS-001 激光监测器测试报告》 | 《系统整机验证报告》 | 《可用性验证报告》 | 《可用性确认报告》 MS-001猪脊骨试验报告 MS-001模型试验报告 MS-001临床预试验报告 MS-001尸体试验报告 | /
 |  | 140016 | 体位反馈功能需求-结构设计-包装和运输要求：单独包装 | 《MS-001体位反馈模块结构概要设计说明书》1.1章节产品功能需求 | 《MS-001体位反馈模块结构详细设计说明书》 《MS-001体位反馈模块包装及标签方案》 | MS001-D.01.010ZB.1.1 体位反馈模块包装纸盒 MS001-D.01.011SL.1.1 体位反馈模块珍珠棉1 MS001-D.01.012SL.1.1 体位反馈模块珍珠棉2 | / | 《系统整机验证报告》 | 《可用性验证报告》 | 《可用性确认报告》 MS-001猪脊骨试验报告 MS-001模型试验报告 MS-001临床预试验报告 MS-001尸体试验报告 | /
 |  | 140017 | 体位反馈功能需求-外观设计-良好的耐磨性以及抗划伤性、外观污渍好清理、外观强度可靠 | 《MS-001体位反馈模块结构概要设计说明书》1.1章节产品功能需求 | 《MS-001体位反馈模块结构详细设计说明书》 | MS001-D.01.011SL.1.1 体位反馈模块珍珠棉1 MS001-D.01.012SL.1.1 体位反馈模块珍珠棉2 | / | 《系统整机验证报告》 | 《可用性验证报告》 | 《可用性确认报告》 MS-001猪脊骨试验报告 MS-001模型试验报告 MS-001临床预试验报告 MS-001尸体试验报告 | /
 |  | 140018 | 体位反馈功能需求-外观设计-设计外观整体性要考虑与主体两个台车搭配 | 《MS-001体位反馈模块结构概要设计说明书》1.1章节产品功能需求 | 《MS-001体位反馈模块结构详细设计说明书》 | MS001-D.01.003SL.1.1 MS001-D上外壳 MS001-D.01.008SL.1.1 MS001-D下外壳 | / | 《系统整机验证报告》 | 《可用性验证报告》 | 《可用性确认报告》 MS-001猪脊骨试验报告 MS-001模型试验报告 MS-001临床预试验报告 MS-001尸体试验报告 | /
 |  | 140019 | 体位反馈功能需求-外观设计-油漆喷涂 | 《MS-001体位反馈模块结构概要设计说明书》1.1章节产品功能需求 | 《MS-001体位反馈模块结构详细设计说明书》 | MS001-D.01.003SL.1.1 MS001-D上外壳 MS001-D.01.008SL.1.1 MS001-D下外壳 | / | 《系统整机验证报告》 | 《可用性验证报告》 | 《可用性确认报告》 MS-001猪脊骨试验报告 MS-001模型试验报告 MS-001临床预试验报告 MS-001尸体试验报告 | /
 |  | 140020 | 体位反馈功能需求-材料要求-医用级别材料 | 《MS-001体位反馈模块结构概要设计说明书》1.1章节产品功能需求 | 《MS-001体位反馈模块结构详细设计说明书》 | MS001-D.01.003SL.1.1 MS001-D上外壳 MS001-D.01.008SL.1.1 MS001-D下外壳 | / | 《系统整机验证报告》 | 《可用性验证报告》 | 《可用性确认报告》 MS-001猪脊骨试验报告 MS-001模型试验报告 MS-001临床预试验报告 MS-001尸体试验报告 | /
 |  | 140021 | 体位反馈功能需求-工艺-哑光油漆 | 《MS-001体位反馈模块结构概要设计说明书》1.1章节产品功能需求 | 《MS-001体位反馈模块结构详细设计说明书》 | MS001-D.01.003SL.1.1 MS001-D上外壳 MS001-D.01.008SL.1.1 MS001-D下外壳 | / | 《系统整机验证报告》 | 《可用性验证报告》 | 《可用性确认报告》 MS-001猪脊骨试验报告 MS-001模型试验报告 MS-001临床预试验报告 MS-001尸体试验报告 | /
 |  | 140022 | 体位反馈功能需求-文字-铭牌（粘贴） | 《MS-001体位反馈模块结构概要设计说明书》1.1章节产品功能需求 | 《MS-001体位反馈模块结构详细设计说明书》 | MS001-D.01.003SL.1.1 MS001-D上外壳 MS001-D.01.008SL.1.1 MS001-D下外壳 | / | 《系统整机验证报告》 | 《可用性验证报告》 | 《可用性确认报告》 MS-001猪脊骨试验报告 MS-001模型试验报告 MS-001临床预试验报告 MS-001尸体试验报告 | /
UR0500 | 本产品需要提供医用移动式台车用于承载显示器、主控机 | 120001 | 规划台车功能需求-使用环境-手术室 | 《嵌入式硬件概要设计说明书》2.1章节功能需求与实现 《MS-001规划模块结构概要设计说明书》1.1章节产品功能需求 | 《MS-001嵌入式硬件详细设计说明书》2.1章节 《MS-001规划模块结构详细设计说明书》 | MS001-A.01.001ZZ.1.1规划模块 | / | 《系统整机验证报告》 | 《可用性验证报告》 | 《可用性确认报告》 MS-001猪脊骨试验报告 MS-001模型试验报告 MS-001临床预试验报告 MS-001尸体试验报告 | /
 |  | 120002 | 规划台车功能需求-安装方式-可移动 | 《MS-001规划模块结构概要设计说明书》1.1章节产品功能需求 | 《MS-001规划模块结构详细设计说明书》 《MS-001关键零部件选型报告》4.脚轮选型 | MS001-A.02.001JX.1.1 MS001-A框架总成 | / | 《系统整机验证报告》 | 《可用性验证报告》 | 《可用性确认报告》 MS-001猪脊骨试验报告 MS-001模型试验报告 MS-001临床预试验报告 MS-001尸体试验报告 | R48
 |  | 120003 | 规划台车功能需求-供电方式-AC 220V 50/60Hz | 《嵌入式硬件概要设计说明书》2.1章节功能需求与实现 | 《MS-001嵌入式硬件详细设计说明书》2.1章节 | MS001-A.04.001JX.1.1 MS001-A侧面板总成 | / | 《系统整机验证报告》 | 《可用性验证报告》 | 《可用性确认报告》 MS-001猪脊骨试验报告 MS-001模型试验报告 MS-001临床预试验报告 MS-001尸体试验报告 | R60
 |  | 120004 | 规划台车功能需求-移动方式-脚轮移动 | 《MS-001规划模块结构概要设计说明书》1.1章节产品功能需求 | 《MS-001规划模块结构详细设计说明书》 《MS-001关键零部件选型报告》4.脚轮选型 | MS001-A.02.001JX.1.1 MS001-A框架总成 | / | 《系统整机验证报告》 | 《可用性验证报告》 | 《可用性确认报告》 MS-001猪脊骨试验报告 MS-001模型试验报告 MS-001临床预试验报告 MS-001尸体试验报告 | R52
 |  | 120005 | 规划台车功能需求-接口-USB口2个（USB常用，考虑放置在操作台上） | 《嵌入式硬件概要设计说明书》2.1章节功能需求与实现 《MS-001规划模块结构概要设计说明书》1.1章节产品功能需求 | 《MS-001嵌入式硬件详细设计说明书》2.1章节 《MS-001规划模块结构详细设计说明书》 | MS001-A.04.001JX.1.1 MS001-A侧面板总成 | / | 《系统整机验证报告》 | 《可用性验证报告》 | 《可用性确认报告》 MS-001猪脊骨试验报告 MS-001模型试验报告 MS-001临床预试验报告 MS-001尸体试验报告 | /
 |  | 120006 | 规划台车功能需求-接口-网口4个 | 《嵌入式硬件概要设计说明书》2.1章节功能需求与实现 《MS-001规划模块结构概要设计说明书》1.1章节产品功能需求 | 《MS-001嵌入式硬件详细设计说明书》2.1章节 《MS-001规划模块结构详细设计说明书》 | MS001-A.04.001JX.1.1 MS001-A侧面板总成 | / | 《系统整机验证报告》 | 《可用性验证报告》 | 《可用性确认报告》 MS-001猪脊骨试验报告 MS-001模型试验报告 MS-001临床预试验报告 MS-001尸体试验报告 | /
 |  | 120007 | 规划台车功能需求-接口-电源接口1个（防脱落设计） | 《嵌入式硬件概要设计说明书》2.1章节功能需求与实现 《MS-001规划模块结构概要设计说明书》1.1章节产品功能需求 | 《MS-001嵌入式硬件详细设计说明书》2.1章节 《MS-001规划模块结构详细设计说明书》 | MS001-A.04.001JX.1.1 MS001-A侧面板总成 | / | 《系统整机验证报告》 | 《可用性验证报告》 | 《可用性确认报告》 MS-001猪脊骨试验报告 MS-001模型试验报告 MS-001临床预试验报告 MS-001尸体试验报告 | /
 |  | 120008 | 规划台车功能需求-开关按钮-系统开关1个（包括指示灯） | 《嵌入式硬件概要设计说明书》2.1章节功能需求与实现 《MS-001规划模块结构概要设计说明书》1.1章节产品功能需求 | 《MS-001嵌入式硬件详细设计说明书》2.1章节 《MS-001规划模块结构详细设计说明书》 | MS001-A.04.001JX.1.1 MS001-A侧面板总成 | / | 《系统整机验证报告》 | 《可用性验证报告》 | 《可用性确认报告》 MS-001猪脊骨试验报告 MS-001模型试验报告 MS-001临床预试验报告 MS-001尸体试验报告 | /
 |  | 120009 | 规划台车功能需求-灯光-电源指示灯1个，设备上电后立即亮起 | 《嵌入式硬件概要设计说明书》2.1章节功能需求与实现 《MS-001规划模块结构概要设计说明书》1.1章节产品功能需求 | 《MS-001嵌入式硬件详细设计说明书》2.1章节 《MS-001规划模块结构详细设计说明书》 | 《MS001.06.005YL.1.1-LED灯板-原理图》 MS001-A.04.001JX.1.1 MS001-A侧面板总成 | / | 《系统整机验证报告》 | 《可用性验证报告》 | 《可用性确认报告》 MS-001猪脊骨试验报告 MS-001模型试验报告 MS-001临床预试验报告 MS-001尸体试验报告 | R83、R84
 |  | 120010 | 规划台车功能需求-灯光-系统运行指示灯1个 | 《嵌入式硬件概要设计说明书》2.1章节功能需求与实现 《MS-001规划模块结构概要设计说明书》1.1章节产品功能需求 | 《MS-001嵌入式硬件详细设计说明书》2.1章节 《MS-001规划模块结构详细设计说明书》 | MS001-A.04.001JX.1.1 MS001-A侧面板总成 | / | 《系统整机验证报告》 | 《可用性验证报告》 | 《可用性确认报告》 MS-001猪脊骨试验报告 MS-001模型试验报告 MS-001临床预试验报告 MS-001尸体试验报告 | R83、R84
 |  | 120011 | 规划台车功能需求-显示方式-宽视野显示器 | 《嵌入式硬件概要设计说明书》2.1章节功能需求与实现 | 《MS-001嵌入式硬件详细设计说明书》2.1章节 | 关键器件选型 | / | 《系统整机验证报告》 | 《可用性验证报告》 | 《可用性确认报告》 MS-001猪脊骨试验报告 MS-001模型试验报告 MS-001临床预试验报告 MS-001尸体试验报告 | /
 |  | 120012 | 规划台车功能需求-造型风格-科技、简约、专业 | 《MS-001规划模块结构概要设计说明书》1.1章节产品功能需求 | 《MS-001规划模块结构详细设计说明书》 | MS001-A.03.001JX.1.1 MS001-A外观总成 | / | 《系统整机验证报告》 | 《可用性验证报告》 | 《可用性确认报告》 MS-001猪脊骨试验报告 MS-001模型试验报告 MS-001临床预试验报告 MS-001尸体试验报告 | R56、R57
 |  | 120013 | 规划台车功能需求-台车组成-系统PC机 | 《嵌入式硬件概要设计说明书》2.1章节功能需求与实现 《MS-001规划模块结构概要设计说明书》1.1章节产品功能需求 | 《MS-001嵌入式硬件详细设计说明书》2.1章节 《MS-001规划模块结构详细设计说明书》 | MS001-A.02.001JX.1.1 MS001-A框架总成 | 《MS-001 其它关键元件验收方法》 | 《系统整机验证报告》 | 《可用性验证报告》 | 《可用性确认报告》 MS-001猪脊骨试验报告 MS-001模型试验报告 MS-001临床预试验报告 MS-001尸体试验报告 | /
 |  | 120014 | 规划台车功能需求-台车组成-交换机（至少4个接口） | 《嵌入式硬件概要设计说明书》2.1章节功能需求与实现 《MS-001规划模块结构概要设计说明书》1.1章节产品功能需求 | 《MS-001嵌入式硬件详细设计说明书》2.1章节 《MS-001规划模块结构详细设计说明书》 | MS001-A.02.001JX.1.1 MS001-A框架总成 | 《MS-001 其它关键元件验收方法》 | 《系统整机验证报告》 | 《可用性验证报告》 | 《可用性确认报告》 MS-001猪脊骨试验报告 MS-001模型试验报告 MS-001临床预试验报告 MS-001尸体试验报告 | /
 |  | 120015 | 规划台车功能需求-台车组成-电源模块、滤波器 | 《嵌入式硬件概要设计说明书》2.1章节功能需求与实现 《MS-001规划模块结构概要设计说明书》1.1章节产品功能需求 | 《MS-001嵌入式硬件详细设计说明书》2.1章节 《MS-001规划模块结构详细设计说明书》 | MS001-A.02.001JX.1.1 MS001-A框架总成 | 《MS-001 其它关键元件验收方法》 | 《系统整机验证报告》 | 《可用性验证报告》 | 《可用性确认报告》 MS-001猪脊骨试验报告 MS-001模型试验报告 MS-001临床预试验报告 MS-001尸体试验报告 | R82
 |  | 120016 | 规划台车功能需求-台车组成-宽屏显示器 | 《嵌入式硬件概要设计说明书》2.1章节功能需求与实现 《MS-001规划模块结构概要设计说明书》1.1章节产品功能需求 | 《MS-001嵌入式硬件详细设计说明书》2.1章节 《MS-001规划模块结构详细设计说明书》 | MS001-A.02.001JX.1.1 MS001-A框架总成 | 《MS-001 其它关键元件验收方法》 | 《系统整机验证报告》 | 《可用性验证报告》 | 《可用性确认报告》 MS-001猪脊骨试验报告 MS-001模型试验报告 MS-001临床预试验报告 MS-001尸体试验报告 | /
 |  | 120017 | 规划台车功能需求-台车组成-静音轮 | 《MS-001规划模块结构概要设计说明书》1.1章节产品功能需求 | 《MS-001规划模块结构详细设计说明书》 《MS-001关键零部件选型报告》4.脚轮选型 | MS001-A.02.001JX.1.1 MS001-A框架总成 | / | 《系统整机验证报告》 | 《可用性验证报告》 | 《可用性确认报告》 MS-001猪脊骨试验报告 MS-001模型试验报告 MS-001临床预试验报告 MS-001尸体试验报告 | /
 |  | 120018 | 规划台车功能需求-台车组成-光驱 | 《嵌入式硬件概要设计说明书》2.1章节功能需求与实现 《MS-001规划模块结构概要设计说明书》1.1章节产品功能需求 | 《MS-001嵌入式硬件详细设计说明书》2.1章节 | MS001-A.02.001JX.1.1 MS001-A框架总成 | / | 《系统整机验证报告》 | 《可用性验证报告》 | 《可用性确认报告》 MS-001猪脊骨试验报告 MS-001模型试验报告 MS-001临床预试验报告 MS-001尸体试验报告 | /
 |  | 120019 | 规划台车功能需求-结构设计-显示器：显示器设计有上下角度调节功能 | 《MS-001规划模块结构概要设计说明书》1.1章节产品功能需求 | 《MS-001规划模块结构详细设计说明书》 | MS001-A.02.001JX.1.1 MS001-A框架总成 | / | 《系统整机验证报告》 | 《可用性验证报告》 | 《可用性确认报告》 MS-001猪脊骨试验报告 MS-001模型试验报告 MS-001临床预试验报告 MS-001尸体试验报告 | R53、R54、R55
 |  | 120020 | 规划台车功能需求-结构设计-键鼠放置：台车上应该可以放置有线键盘和鼠标并设计收纳位 | 《MS-001规划模块结构概要设计说明书》1.1章节产品功能需求 | 《MS-001规划模块结构详细设计说明书》 | MS001-A.05.001JX.1.1 MS001-A工作台总成 | / | 《系统整机验证报告》 | 《可用性验证报告》 | 《可用性确认报告》 MS-001猪脊骨试验报告 MS-001模型试验报告 MS-001临床预试验报告 MS-001尸体试验报告 | /
 |  | 120021 | 规划台车功能需求-结构设计-设备检修口：机械臂控制箱位置设计设备检修口，方便快速方便检修 | 《MS-001规划模块结构概要设计说明书》1.1章节产品功能需求 | 《MS-001规划模块结构详细设计说明书》 | MS001-A.02.001JX.1.1 MS001-A框架总成 MS001-A.03.001JX.1.1 MS001-A外观总成 | / | 《系统整机验证报告》 | 《可用性验证报告》 | 《可用性确认报告》 MS-001猪脊骨试验报告 MS-001模型试验报告 MS-001临床预试验报告 MS-001尸体试验报告 | /
 |  | 120022 | 规划台车功能需求-结构设计-显示器安装 | 《MS-001规划模块结构概要设计说明书》1.1章节产品功能需求 | 《MS-001规划模块结构详细设计说明书》 | MS001-A.02.001JX.1.1 MS001-A框架总成 | / | 《系统整机验证报告》 | 《可用性验证报告》 | 《可用性确认报告》 MS-001猪脊骨试验报告 MS-001模型试验报告 MS-001临床预试验报告 MS-001尸体试验报告 | R53、R54、R55
 |  | 120023 | 规划台车功能需求-结构设计-物品收纳空间：增加一个收纳抽屉 | 《MS-001规划模块结构概要设计说明书》1.1章节产品功能需求 | 《MS-001规划模块结构详细设计说明书》 | MS001-A.05.001JX.1.1 MS001-A工作台总成 | / | 《系统整机验证报告》 | 《可用性验证报告》 | 《可用性确认报告》 MS-001猪脊骨试验报告 MS-001模型试验报告 MS-001临床预试验报告 MS-001尸体试验报告 | /
 |  | 120024 | 规划台车功能需求-结构设计-散热：外壳有散孔，热源主要为系统PC机 | 《MS-001规划模块结构概要设计说明书》1.1章节产品功能需求 | 《MS-001规划模块结构详细设计说明书》 《MS-001规划模块热分析报告》 | MS001-A.03.001JX.1.1 MS001-A外观总成 | / | 《MS-001规划模块热分析报告》 | 《系统整机验证报告》、《可用性验证报告》 | 《可用性确认报告》 MS-001猪脊骨试验报告 MS-001模型试验报告 MS-001临床预试验报告 MS-001尸体试验报告 | R8、R11、R16
 |  | 120025 | 规划台车功能需求-结构设计-防尘：进风口、散热口有防尘措施 | 《MS-001规划模块结构概要设计说明书》1.1章节产品功能需求 | 《MS-001规划模块结构详细设计说明书》 | MS001-A.03.001JX.1.1 MS001-A外观总成 | / | 《系统整机验证报告》 | 《系统整机验证报告》、《可用性验证报告》 | 《可用性确认报告》 MS-001猪脊骨试验报告 MS-001模型试验报告 MS-001临床预试验报告 MS-001尸体试验报告 | /
 |  | 120026 | 规划台车功能需求-结构设计-包装和运输要求： | 《MS-001规划模块结构概要设计说明书》1.1章节产品功能需求 | 《MS-001规划模块结构详细设计说明书》 《MS-001规划模块包装及标签方案》 | MS001-A.06.001JX.1.1 MS001-A运输包装 | / | 《系统整机验证报告》、 型检报告-运输试验 | 型检报告（模拟运输） | 《可用性确认报告》 MS-001猪脊骨试验报告 MS-001模型试验报告 MS-001临床预试验报告 MS-001尸体试验报告 | R58
 |  | 120027 | 规划台车功能需求-外观设计-良好的耐磨性以及抗划伤性、外观污渍好清理、外观强度可靠（满足一定的防碰撞强度） | 《MS-001规划模块结构概要设计说明书》1.1章节产品功能需求 | 《MS-001规划模块结构详细设计说明书》 | MS001-A.03.001JX.1.1 MS001-A外观总成 | / | 《系统整机验证报告》 | 型检报告（模拟运输） | 《可用性确认报告》 MS-001猪脊骨试验报告 MS-001模型试验报告 MS-001临床预试验报告 MS-001尸体试验报告 | R58、R61
 |  | 120028 | 规划台车功能需求-外观设计-设计外观整体性要考虑显示器的配色 | 《MS-001规划模块结构概要设计说明书》1.1章节产品功能需求 | 《MS-001规划模块结构详细设计说明书》 | MS001-A.03.001JX.1.1 MS001-A外观总成 | / | 《系统整机验证报告》 | 《可用性验证报告》 | 《可用性确认报告》 MS-001猪脊骨试验报告 MS-001模型试验报告 MS-001临床预试验报告 MS-001尸体试验报告 | /
 |  | 120029 | 规划台车功能需求-外观设计-油漆喷涂 | 《MS-001规划模块结构概要设计说明书》1.1章节产品功能需求 | 《MS-001规划模块结构详细设计说明书》 | MS001-A.03.001JX.1.1 MS001-A外观总成 | / | 《系统整机验证报告》 | 《可用性验证报告》 | 《可用性确认报告》 MS-001猪脊骨试验报告 MS-001模型试验报告 MS-001临床预试验报告 MS-001尸体试验报告 | /
 |  | 120030 | 规划台车功能需求-材料要求-医用级别材料 | 《MS-001规划模块结构概要设计说明书》1.1章节产品功能需求 | 《MS-001规划模块结构详细设计说明书》 | MS001-A.03.001JX.1.1 MS001-A外观总成 | / | 《系统整机验证报告》 | 《可用性验证报告》 | 《可用性确认报告》 MS-001猪脊骨试验报告 MS-001模型试验报告 MS-001临床预试验报告 MS-001尸体试验报告 | /
 |  | 120031 | 规划台车功能需求-工艺-哑光油漆 | 《MS-001规划模块结构概要设计说明书》1.1章节产品功能需求 | 《MS-001规划模块结构详细设计说明书》 | MS001-A.03.001JX.1.1 MS001-A外观总成 | / | 《系统整机验证报告》 | 《可用性验证报告》 | 《可用性确认报告》 MS-001猪脊骨试验报告 MS-001模型试验报告 MS-001临床预试验报告 MS-001尸体试验报告 | /
 |  | 120032 | 规划台车功能需求-文字-商标、logo、铭牌 | 《MS-001规划模块结构概要设计说明书》1.1章节产品功能需求 | 《MS-001规划模块结构详细设计说明书》 | MS001-A.03.001JX.1.1 MS001-A外观总成 | / | 《系统整机验证报告》 | 《可用性验证报告》 | 《可用性确认报告》 MS-001猪脊骨试验报告 MS-001模型试验报告 MS-001临床预试验报告 MS-001尸体试验报告 | R12
UR0600 | 本产品需要提供医用移动式台车用于承载机械臂系统、显示器、主控机 | 130001 | 导引台车功能需求-使用环境-手术室 | 《嵌入式硬件概要设计说明书》2.1章节功能需求与实现 《MS-001导引模块结构概要设计说明书》1.1章节产品功能需求 | 《MS-001嵌入式硬件详细设计说明书》2.1章节 《MS-001导引模块结构详细设计说明书》 《MS-001导引模块万向脚杯选型计算》 | MS001-B.01.001ZZ.1.1 导引模块 | / | 《系统整机验证报告》 | 《可用性验证报告》 | 《可用性确认报告》 MS-001猪脊骨试验报告 MS-001模型试验报告 MS-001临床预试验报告 MS-001尸体试验报告 | /
 |  | 130002 | 导引台车功能需求-安装方式-可移动 | 《MS-001导引模块结构概要设计说明书》1.1章节产品功能需求 | 《MS-001导引模块结构详细设计说明书》 《MS-001关键零部件选型报告》4.脚轮选型 | MS001-B.03.001JX.1.1 MS001-B框架总成 | / | 《系统整机验证报告》 | 《可用性验证报告》 | 《可用性确认报告》 MS-001猪脊骨试验报告 MS-001模型试验报告 MS-001临床预试验报告 MS-001尸体试验报告 | R48
 |  | 130003 | 导引台车功能需求-供电方式-AC 220V 50/60Hz | 《嵌入式硬件概要设计说明书》2.1章节功能需求与实现 | 《MS-001嵌入式硬件详细设计说明书》2.1章节 | / | / | 《系统整机验证报告》 | 《可用性验证报告》 | 《可用性确认报告》 MS-001猪脊骨试验报告 MS-001模型试验报告 MS-001临床预试验报告 MS-001尸体试验报告 | R72
 |  | 130004 | 导引台车功能需求-移动方式-脚轮移动 | 《MS-001导引模块结构概要设计说明书》1.1章节产品功能需求 | 《MS-001导引模块结构详细设计说明书》 《MS-001关键零部件选型报告》4.脚轮选型 | MS001-B.03.001JX.1.1 MS001-B框架总成 | 关键器件选型 | 《系统整机验证报告》 | 《可用性验证报告》 | 《可用性确认报告》 MS-001猪脊骨试验报告 MS-001模型试验报告 MS-001临床预试验报告 MS-001尸体试验报告 | R62、R63
 |  | 130005 | 导引台车功能需求-接口-USB口3个（USB常用，操作台上2个、后面板1个） | 《嵌入式硬件概要设计说明书》2.1章节功能需求与实现 《MS-001导引模块结构概要设计说明书》1.1章节产品功能需求 | 《MS-001嵌入式硬件详细设计说明书》2.1章节 《MS-001导引模块结构详细设计说明书》 | MS001-B.06.001JX.1.1 MS001-B侧面板总成 | / | 《系统整机验证报告》 | 《可用性验证报告》 | 《可用性确认报告》 MS-001猪脊骨试验报告 MS-001模型试验报告 MS-001临床预试验报告 MS-001尸体试验报告 | /
 |  | 130006 | 导引台车功能需求-接口-网口2个 | 《嵌入式硬件概要设计说明书》2.1章节功能需求与实现 《MS-001导引模块结构概要设计说明书》1.1章节产品功能需求 | 《MS-001嵌入式硬件详细设计说明书》2.1章节 《MS-001导引模块结构详细设计说明书》 | MS001-B.06.001JX.1.1 MS001-B侧面板总成 | / | 《系统整机验证报告》 | 《可用性验证报告》 | 《可用性确认报告》 MS-001猪脊骨试验报告 MS-001模型试验报告 MS-001临床预试验报告 MS-001尸体试验报告 | /
 |  | 130007 | 导引台车功能需求-接口-电源接口1个（防脱落设计） | 《嵌入式硬件概要设计说明书》2.1章节功能需求与实现 《MS-001导引模块结构概要设计说明书》1.1章节产品功能需求 | 《MS-001嵌入式硬件详细设计说明书》2.1章节 《MS-001导引模块结构详细设计说明书》 | MS001-B.06.001JX.1.1 MS001-B侧面板总成 | / | 《系统整机验证报告》 | 《可用性验证报告》 | 《可用性确认报告》 MS-001猪脊骨试验报告 MS-001模型试验报告 MS-001临床预试验报告 MS-001尸体试验报告 | R82
 |  | 130008 | 导引台车功能需求-接口-脚踏开关插口1个 | 《嵌入式硬件概要设计说明书》2.1章节功能需求与实现 《MS-001导引模块结构概要设计说明书》1.1章节产品功能需求 | 《MS-001嵌入式硬件详细设计说明书》2.1章节 《MS-001导引模块结构详细设计说明书》 | MS001-B.06.001JX.1.1 MS001-B侧面板总成 | / | 《系统整机验证报告》 | 《可用性验证报告》 | 《可用性确认报告》 MS-001猪脊骨试验报告 MS-001模型试验报告 MS-001临床预试验报告 MS-001尸体试验报告 | R100
 |  | 130009 | 导引台车功能需求-开关按钮-急停开关1个 | 《嵌入式硬件概要设计说明书》2.1章节功能需求与实现 《MS-001导引模块结构概要设计说明书》1.1章节产品功能需求 | 《MS-001嵌入式硬件详细设计说明书》2.1章节 《MS-001导引模块结构详细设计说明书》 | MS001-B.06.001JX.1.1 MS001-B侧面板总成 | / | 《系统整机验证报告》 | 《可用性验证报告》 | 《可用性确认报告》 MS-001猪脊骨试验报告 MS-001模型试验报告 MS-001临床预试验报告 MS-001尸体试验报告 | /
 |  | 130010 | 导引台车功能需求-开关按钮-台车升、降按钮各1个（包含指示灯） | 《嵌入式硬件概要设计说明书》2.1章节功能需求与实现 《嵌入式软件概要设计说明书》2.3章节功能需求与实现 《MS-001导引模块结构概要设计说明书》1.1章节产品功能需求 | 《MS-001嵌入式硬件详细设计说明书》2.1章节 《MS-001嵌入式软件详细设计说明书》 《MS-001导引模块结构详细设计说明书》 | 《MS001.06.003YL.1.2-UR控制板-原理图》 MS001.06.003DM.1.1-UR控制板-源代码》 MS001-B.05.001JX.1.1 MS001-B工作台总成 | 《MS-001 UR控制板单元测试方案》 《MS-001 UR控制板单元测试报告》 | 《系统整机验证报告》 | 《系统整机验证报告》 | 《可用性确认报告》 MS-001猪脊骨试验报告 MS-001模型试验报告 MS-001临床预试验报告 MS-001尸体试验报告 | R80、R81
 |  | 130011 | 导引台车功能需求-开关按钮-通道升、降按钮各1个（包含指示灯），结构设计为接线式遥控器 | 《嵌入式硬件概要设计说明书》2.1章节功能需求与实现 《MS-001导引模块结构概要设计说明书》1.1章节产品功能需求 | 《MS-001嵌入式硬件详细设计说明书》2.1章节 《MS-001导引模块结构详细设计说明书》 | MS001.06.004YL.1.1-按键板-原理图》 MS001-B.05.001JX.1.1 MS001-B工作台总成 | 《MS-001 按键板测试方案》 《MS-001 按键板测试报告》 | 《系统整机验证报告》 | 《系统整机验证报告》 | 《可用性确认报告》 MS-001猪脊骨试验报告 MS-001模型试验报告 MS-001临床预试验报告 MS-001尸体试验报告 | R80、R81
 |  | 130012 | 导引台车功能需求-开关按钮-系统开机按钮1个（包含指示灯） | 《嵌入式硬件概要设计说明书》2.1章节功能需求与实现 《MS-001导引模块结构概要设计说明书》1.1章节产品功能需求 | 《MS-001嵌入式硬件详细设计说明书》2.1章节 《MS-001导引模块结构详细设计说明书》 | MS001-B.05.001JX.1.1 MS001-B工作台总成 | 《MS-001 金属带灯按钮测试方案》 《MS-001 金属带灯按钮测试报告》 | 《系统整机验证报告》 | 《可用性验证报告》 | 《可用性确认报告》 MS-001猪脊骨试验报告 MS-001模型试验报告 MS-001临床预试验报告 MS-001尸体试验报告 | /
 |  | 130013 | 导引台车功能需求-开关按钮-机械臂上电开关按钮1个（包含指示灯） | 《嵌入式硬件概要设计说明书》2.1章节功能需求与实现 《嵌入式软件概要设计说明书》2.3章节功能需求与实现 《MS-001导引模块结构概要设计说明书》1.1章节产品功能需求 | 《MS-001嵌入式硬件详细设计说明书》2.1章节 《MS-001导引模块结构详细设计说明书》 | 《MS001.06.003YL.1.2-UR控制板-原理图》 《MS001.06.003DM.1.1-UR控制板-源代码》 MS001-B.06.001JX.1.1 MS001-B侧面板总成 | 《MS-001 UR控制板单元测试方案》 《MS-001 UR控制板单元测试报告》 《MS-001 金属带灯按钮测试方案》 《MS-001 金属带灯按钮测试报告》 | 《系统整机验证报告》 | 《可用性验证报告》 | 《可用性确认报告》 MS-001猪脊骨试验报告 MS-001模型试验报告 MS-001临床预试验报告 MS-001尸体试验报告 | /
 |  | 130014 | 导引台车功能需求-灯光-电源指示灯1个，设备上电后立即亮起 | 《嵌入式硬件概要设计说明书》2.1章节功能需求与实现 《MS-001导引模块结构概要设计说明书》1.1章节产品功能需求 | 《MS-001嵌入式硬件详细设计说明书》2.1章节 《MS-001导引模块结构详细设计说明书》 | MS001-B.06.001JX.1.1 MS001-B侧面板总成 | / | 《系统整机验证报告》 | 《可用性验证报告》 | 《可用性确认报告》 MS-001猪脊骨试验报告 MS-001模型试验报告 MS-001临床预试验报告 MS-001尸体试验报告 | R83、R84
 |  | 130015 | 导引台车功能需求-灯光-系统运行指示灯1个 | 《嵌入式硬件概要设计说明书》2.1章节功能需求与实现 《MS-001导引模块结构概要设计说明书》1.1章节产品功能需求 | 《MS-001嵌入式硬件详细设计说明书》2.1章节 《MS-001导引模块结构详细设计说明书》 | MS001-B.06.001JX.1.1 MS001-B侧面板总成 | / | 《系统整机验证报告》 | 《可用性验证报告》 | 《可用性确认报告》 MS-001猪脊骨试验报告 MS-001模型试验报告 MS-001临床预试验报告 MS-001尸体试验报告 | R83、R84
 |  | 130016 | 导引台车功能需求-灯光-机械臂运行指示灯1个 | 《MS-001导引模块结构概要设计说明书》1.1章节产品功能需求 | 《MS-001导引模块结构详细设计说明书》 | MS001-B.06.001JX.1.1 MS001-B侧面板总成 | / | 《系统整机验证报告》 | 《可用性验证报告》 | 《可用性确认报告》 MS-001猪脊骨试验报告 MS-001模型试验报告 MS-001临床预试验报告 MS-001尸体试验报告 | /
 |  | 130017 | 导引台车功能需求-显示方式-15寸显示器 | 《嵌入式硬件概要设计说明书》2.1章节功能需求与实现 《MS-001导引模块结构概要设计说明书》1.1章节产品功能需求 | 《MS-001嵌入式硬件详细设计说明书》2.1章节 《MS-001导引模块结构详细设计说明书》 | MS001-B.03.001JX.1.1 MS001-B框架总成 | 《MS-001 其它关键元件验收方法》 | 《系统整机验证报告》 | 《可用性验证报告》 | 《可用性确认报告》 MS-001猪脊骨试验报告 MS-001模型试验报告 MS-001临床预试验报告 MS-001尸体试验报告 | /
 |  | 130018 | 导引台车功能需求-造型风格-科技、简约、专业 | 《MS-001导引模块结构概要设计说明书》1.1章节产品功能需求 | 《MS-001导引模块结构详细设计说明书》 | MS001-B.01.001ZZ.1.1 导引模块 | / | 《系统整机验证报告》 | 《可用性验证报告》 | 《可用性确认报告》 MS-001猪脊骨试验报告 MS-001模型试验报告 MS-001临床预试验报告 MS-001尸体试验报告 | /
 |  | 130019 | 导引台车功能需求-台车组成-机械臂及控制系统 | 《嵌入式硬件概要设计说明书》2.1章节功能需求与实现 《嵌入式软件概要设计说明书》2.3章节功能需求与实现 《MS-001导引模块结构概要设计说明书》1.1章节产品功能需求 | 《MS-001嵌入式软件详细设计说明书》 《MS-001嵌入式硬件详细设计说明书》2.1章节 《MS-001导引模块结构详细设计说明书》 | 《MS001.06.003YL.1.2-UR控制板-原理图》 《MS001.06.006YL.1.1-RGB灯板-原理图》 《MS001.06.003DM.1.1-UR控制板-源代码》 MS001-B.03.001JX.1.1 MS001-B框架总成 | 《MS-001 UR控制板单元测试方案》 《MS-001 UR控制板单元测试报告》 《MS-001 RGB灯板单元测试方案》 《MS-001 RGB灯板单元测试报告》 | 《MS-001 UR机器人单元测试报告》、《MS-001 UR控制板单元测试报告》 | 《系统整机验证报告》 | 《可用性确认报告》 MS-001猪脊骨试验报告 MS-001模型试验报告 MS-001临床预试验报告 MS-001尸体试验报告 | R91、R92、R93、R94、R95、R96、R97、R98、R99、R100、R101、R102
 |  | 130020 | 导引台车功能需求-台车组成-主机 | 《嵌入式硬件概要设计说明书》2.1章节功能需求与实现 《MS-001导引模块结构概要设计说明书》1.1章节产品功能需求 | 《MS-001嵌入式硬件详细设计说明书》2.1章节 《MS-001导引模块结构详细设计说明书》 | MS001-B.03.001JX.1.1 MS001-B框架总成 | 关键器件选型 | 《系统整机验证报告》 | 《可用性验证报告》 | 《可用性确认报告》 MS-001猪脊骨试验报告 MS-001模型试验报告 MS-001临床预试验报告 MS-001尸体试验报告 | /
 |  | 130021 | 导引台车功能需求-台车组成-UPS | 《嵌入式硬件概要设计说明书》2.1章节功能需求与实现 《嵌入式软件概要设计说明书》2.3章节功能需求与实现 《MS-001导引模块结构概要设计说明书》1.1章节产品功能需求 | 《MS-001嵌入式软件详细设计说明书》 《MS-001嵌入式硬件详细设计说明书》2.1章节 《MS-001导引模块结构详细设计说明书》 | 《MS001.06.001YL.1.3-UPS控制板-原理图》 《MS001.06.001DM.1.2-UPS控制板-源代码》 MS001-B.03.001JX.1.1 MS001-B框架总成 | 《MS-001 UPS单元测试方案》 《MS-001 UPS单元测试报告》 《MS-001 UPS控制板单元测试方案》 《MS-001 UPS控制板单元测试报告》 | 《系统整机验证报告》 | 《MS-001 UPS单元测试报告》、《MS-001 UPS控制板单元测试报告》、《系统整机验证报告》 | 《可用性确认报告》 MS-001猪脊骨试验报告 MS-001模型试验报告 MS-001临床预试验报告 MS-001尸体试验报告 | R85、R86、R87、R88、R89、R90
 |  | 130022 | 导引台车功能需求-台车组成-交换机 | 《嵌入式硬件概要设计说明书》2.1章节功能需求与实现 《MS-001导引模块结构概要设计说明书》1.1章节产品功能需求 | 《MS-001嵌入式硬件详细设计说明书》2.1章节 《MS-001导引模块结构详细设计说明书》 | MS001-B.03.001JX.1.1 MS001-B框架总成 | 《MS-001 其它关键元件验收方法》 | 《系统整机验证报告》 | 《可用性验证报告》 | 《可用性确认报告》 MS-001猪脊骨试验报告 MS-001模型试验报告 MS-001临床预试验报告 MS-001尸体试验报告 | /
 |  | 130023 | 导引台车功能需求-台车组成-升降立柱 | 《嵌入式硬件概要设计说明书》2.1章节功能需求与实现 《嵌入式软件概要设计说明书》2.3章节功能需求与实现 《MS-001导引模块结构概要设计说明书》1.1章节产品功能需求 | 《MS-001嵌入式软件详细设计说明书》 《MS-001嵌入式硬件详细设计说明书》2.1章节 《MS-001导引模块结构详细设计说明书》 《MS-001关键零部件选型报告》3.升降立柱选型 | 《MS001.06.003YL.1.2-UR控制板-原理图》 《MS001.06.003DM.1.1-UR控制板-源代码》 MS001-B.03.001JX.1.1 MS001-B框架总成 | 《MS-001 UR控制板单元测试方案》 《MS-001 UR控制板单元测试报告》 《MS-001 升降立柱单元测试方案》 《MS-001 升降立柱单元测试报告》 | 《系统整机验证报告》 | 《可用性验证报告》 | 《可用性确认报告》 MS-001猪脊骨试验报告 MS-001模型试验报告 MS-001临床预试验报告 MS-001尸体试验报告 | /
 |  | 130024 | 导引台车功能需求-台车组成-电源模块、滤波器 | 《嵌入式硬件概要设计说明书》2.1章节功能需求与实现 《MS-001导引模块结构概要设计说明书》1.1章节产品功能需求 | 《MS-001嵌入式硬件详细设计说明书》2.1章节 《MS-001导引模块结构详细设计说明书》 | MS001-B.03.001JX.1.1 MS001-B框架总成 | 《MS-001 其它关键元件验收方法》 | 《系统整机验证报告》 | 《可用性验证报告》 | 《可用性确认报告》 MS-001猪脊骨试验报告 MS-001模型试验报告 MS-001临床预试验报告 MS-001尸体试验报告 | /
 |  | 130025 | 导引台车功能需求-台车组成-显示器 | 《嵌入式硬件概要设计说明书》2.1章节功能需求与实现 | 《MS-001嵌入式硬件详细设计说明书》2.1章节 《MS-001导引模块结构详细设计说明书》 | MS001-B.03.001JX.1.1 MS001-B框架总成 | 《MS-001 其它关键元件验收方法》 | 《系统整机验证报告》 | 《可用性验证报告》 | 《可用性确认报告》 MS-001猪脊骨试验报告 MS-001模型试验报告 MS-001临床预试验报告 MS-001尸体试验报告 | R67、R68、R69
 |  | 130026 | 导引台车功能需求-台车组成-脚撑、静音轮 | 《嵌入式硬件概要设计说明书》2.1章节功能需求与实现 《MS-001导引模块结构概要设计说明书》1.1章节产品功能需求 | 《MS-001嵌入式硬件详细设计说明书》2.1章节 《MS-001导引模块结构详细设计说明书》 《MS-001关键零部件选型报告》4.脚轮选型 | MS001-B.03.001JX.1.1 MS001-B框架总成 | 《MS-001 其它关键元件验收方法》 | 《系统整机验证报告》 | 《可用性验证报告》 | 《可用性确认报告》 MS-001猪脊骨试验报告 MS-001模型试验报告 MS-001临床预试验报告 MS-001尸体试验报告 | R64
 |  | 130027 | 导引台车功能需求-台车组成-脚踏开关 | 《嵌入式硬件概要设计说明书》2.1章节功能需求与实现 《MS-001导引模块结构概要设计说明书》1.1章节产品功能需求 | 《MS-001嵌入式硬件详细设计说明书》2.1章节 《MS-001导引模块结构详细设计说明书》 | MS001-B.06.001JX.1.1 MS001-B侧面板总成 | 《MS-001 脚踏开关单元测试方案》 《MS-001 脚踏开关单元测试报告》 | 《系统整机验证报告》 | 《可用性验证报告》 | 《可用性确认报告》 MS-001猪脊骨试验报告 MS-001模型试验报告 MS-001临床预试验报告 MS-001尸体试验报告 | /
 |  | 130028 | 导引台车功能需求-台车组成-体位反馈模块的固定支架 | 《嵌入式硬件概要设计说明书》2.1章节功能需求与实现 《MS-001导引模块结构概要设计说明书》1.1章节产品功能需求 | 《MS-001嵌入式硬件详细设计说明书》2.1章节 《MS-001导引模块结构详细设计说明书》 | MS001-B.03.001JX.1.1 MS001-B框架总成 | / | 《系统整机验证报告》 | 《可用性验证报告》 | 《可用性确认报告》 MS-001猪脊骨试验报告 MS-001模型试验报告 MS-001临床预试验报告 MS-001尸体试验报告 | R73
 |  | 130029 | 导引台车功能需求-结构设计-脚踏收纳 | 《MS-001导引模块结构概要设计说明书》1.1章节产品功能需求 | 《MS-001导引模块结构详细设计说明书》 | MS001-B.04.001JX.1.1 MS001-B外观总成 | 《MS-001 脚踏开关单元测试方案》 《MS-001 脚踏开关单元测试报告》 | 《系统整机验证报告》 | 《可用性验证报告》 | 《可用性确认报告》 MS-001猪脊骨试验报告 MS-001模型试验报告 MS-001临床预试验报告 MS-001尸体试验报告 | /
 |  | 130030 | 导引台车功能需求-结构设计-键鼠放置：台车上应该可以放置有线键盘和鼠标并设计收纳位 | 《MS-001导引模块结构概要设计说明书》1.1章节产品功能需求 | 《MS-001导引模块结构详细设计说明书》 | MS001-B.05.001JX.1.1 MS001-B工作台总成 | / | 《系统整机验证报告》 | 《可用性验证报告》 | 《可用性确认报告》 MS-001猪脊骨试验报告 MS-001模型试验报告 MS-001临床预试验报告 MS-001尸体试验报告 | /
 |  | 130031 | 导引台车功能需求-结构设计-设备检修口：机械臂控制箱位置设计设备检修口，方便快速检修 | 《MS-001导引模块结构概要设计说明书》1.1章节产品功能需求 | 《MS-001导引模块结构详细设计说明书》 | MS001-B.04.001JX.1.1 MS001-B外观总成 | / | 《系统整机验证报告》 | 《可用性验证报告》 | 《可用性确认报告》 MS-001猪脊骨试验报告 MS-001模型试验报告 MS-001临床预试验报告 MS-001尸体试验报告 | R74
 |  | 130032 | 导引台车功能需求-结构设计-机械臂工作高度：当设备工作时，要求机械臂的基座距离地面1.1m左右 | 《MS-001导引模块结构概要设计说明书》1.1章节产品功能需求 | 《MS-001导引模块结构详细设计说明书》 | MS001-B.03.001JX.1.1 MS001-B框架总成 | / | 《系统整机验证报告》 | 《可用性验证报告》 | 《可用性确认报告》 MS-001猪脊骨试验报告 MS-001模型试验报告 MS-001临床预试验报告 MS-001尸体试验报告 | /
 |  | 130033 | 导引台车功能需求-结构设计-设备重量：台车设计完成后总体重量大于200公斤 | 《MS-001导引模块结构概要设计说明书》1.1章节产品功能需求 | 《MS-001导引模块结构详细设计说明书》 | MS001-B.01.001ZZ.1.1 导引模块 | / | 《系统整机验证报告》 | 《可用性验证报告》 | 《可用性确认报告》 MS-001猪脊骨试验报告 MS-001模型试验报告 MS-001临床预试验报告 MS-001尸体试验报告 | /
 |  | 130034 | 导引台车功能需求-结构设计-散热：外壳有散孔，热源主要为主机、机械臂控制系统、UPS | 《MS-001导引模块结构概要设计说明书》1.1章节产品功能需求 | 《MS-001导引模块结构详细设计说明书》《MS-001导引模块热分析报告》 | MS001-B.04.001JX.1.1 MS001-B外观总成 MS001-B.03.001JX.1.1 MS001-B框架总成 | 《MS-001导引模块热分析报告》 | 《系统整机验证报告》 | 《可用性验证报告》 | 《可用性确认报告》 MS-001猪脊骨试验报告 MS-001模型试验报告 MS-001临床预试验报告 MS-001尸体试验报告 | R8、R11、R16、R85
 |  | 130035 | 导引台车功能需求-结构设计-防尘：进风口、散热口有防尘措施 | 《MS-001导引模块结构概要设计说明书》1.1章节产品功能需求 | 《MS-001导引模块结构详细设计说明书》 | MS001-B.04.001JX.1.1 MS001-B外观总成 MS001-B.03.001JX.1.1 MS001-B框架总成 | / | 《系统整机验证报告》 | 《可用性验证报告》 | 《可用性确认报告》 MS-001猪脊骨试验报告 MS-001模型试验报告 MS-001临床预试验报告 MS-001尸体试验报告 | /
 |  | 130036 | 导引台车功能需求-结构设计-包装和运输要求 | 《MS-001导引模块结构概要设计说明书》1.1章节产品功能需求 | 《MS-001导引模块结构详细设计说明书》 《MS-001导引模块包装及标签方案》 | MS001-B.07.001JX.1.1 MS001-B运输包装 | / | 《系统整机验证报告》 | 型检报告（模拟运输） | 《可用性确认报告》 MS-001猪脊骨试验报告 MS-001模型试验报告 MS-001临床预试验报告 MS-001尸体试验报告 | R71
 |  | 130037 | 导引台车功能需求-结构设计-设备断电后可以单独启动UPS，控制台车升降 | 《MS-001导引模块结构概要设计说明书》1.1章节产品功能需求 | 《MS-001导引模块结构详细设计说明书》 | MS001-B.03.001JX.1.1 MS001-B框架总成 | 《MS-001 UPS单元测试方案》 《MS-001 UPS单元测试报告》 《MS-001 UPS控制板单元测试方案》 《MS-001 UPS控制板单元测试报告》 | 《系统整机验证报告》 | 《可用性验证报告》 | 《可用性确认报告》 MS-001猪脊骨试验报告 MS-001模型试验报告 MS-001临床预试验报告 MS-001尸体试验报告 | R80、R81
 |  | 130038 | 导引台车功能需求-外观设计-设计外观整体性时要考虑机械臂有个固定的收纳姿态 | 《MS-001导引模块结构概要设计说明书》1.1章节产品功能需求 | 《MS-001导引模块结构详细设计说明书》 | MS001-B.04.001JX.1.1 MS001-B外观总成 | / | 《系统整机验证报告》 | 《可用性验证报告》 | 《可用性确认报告》 MS-001猪脊骨试验报告 MS-001模型试验报告 MS-001临床预试验报告 MS-001尸体试验报告 | /
 |  | 130039 | 导引台车功能需求-外观设计-良好的耐磨性以及抗划伤性、外观污渍好清理、外观强度可靠（满足一定的防碰撞强度） | 《MS-001导引模块结构概要设计说明书》1.1章节产品功能需求 | 《MS-001导引模块结构详细设计说明书》 | MS001-B.04.001JX.1.1 MS001-B外观总成 | / | 《系统整机验证报告》 | 《可用性验证报告》 | 《可用性确认报告》 MS-001猪脊骨试验报告 MS-001模型试验报告 MS-001临床预试验报告 MS-001尸体试验报告 | R65、R66
 |  | 130040 | 导引台车功能需求-外观设计-设计外观整体性要考虑机械臂的配色 | 《MS-001导引模块结构概要设计说明书》1.1章节产品功能需求 | 《MS-001导引模块结构详细设计说明书》 | MS001-B.04.001JX.1.1 MS001-B外观总成 | / | 《系统整机验证报告》 | 《可用性验证报告》 | 《可用性确认报告》 MS-001猪脊骨试验报告 MS-001模型试验报告 MS-001临床预试验报告 MS-001尸体试验报告 | /
 |  | 130041 | 导引台车功能需求-外观设计-油漆喷涂 | 《MS-001导引模块结构概要设计说明书》1.1章节产品功能需求 | 《MS-001导引模块结构详细设计说明书》 | MS001-B.04.001JX.1.1 MS001-B外观总成 | / | 《系统整机验证报告》 | 《可用性验证报告》 | 《可用性确认报告》 MS-001猪脊骨试验报告 MS-001模型试验报告 MS-001临床预试验报告 MS-001尸体试验报告 | /
 |  | 130042 | 导引台车功能需求-材料要求-医用级别材料 | 《MS-001导引模块结构概要设计说明书》1.1章节产品功能需求 | 《MS-001导引模块结构详细设计说明书》 | MS001-B.04.001JX.1.1 MS001-B外观总成 | / | 《系统整机验证报告》 | 《可用性验证报告》 | 《可用性确认报告》 MS-001猪脊骨试验报告 MS-001模型试验报告 MS-001临床预试验报告 MS-001尸体试验报告 | /
 |  | 130043 | 导引台车功能需求-工艺-哑光油漆 | 《MS-001导引模块结构概要设计说明书》1.1章节产品功能需求 | 《MS-001导引模块结构详细设计说明书》 | MS001-B.04.001JX.1.1 MS001-B外观总成 | / | 《系统整机验证报告》 | 《可用性验证报告》 | 《可用性确认报告》 MS-001猪脊骨试验报告 MS-001模型试验报告 MS-001临床预试验报告 MS-001尸体试验报告 | /
 |  | 130044 | 导引台车功能需求-文字-商标、logo、铭牌 | 《MS-001导引模块结构概要设计说明书》1.1章节产品功能需求 | 《MS-001导引模块结构详细设计说明书》《MS-001导引模块包装及标签方案》 | MS001-B.04.001JX.1.1 MS001-B外观总成 | / | 《系统整机验证报告》 | 《可用性验证报告》 | 《可用性确认报告》 MS-001猪脊骨试验报告 MS-001模型试验报告 MS-001临床预试验报告 MS-001尸体试验报告 | R12
UR0700 | 本产品需要提供一种应用软件，用于患者管理、CT数据导入、X片数据导入、手术规划、手术路径发送 | 010101 | 规划软件功能需求-系统启动后自动打开软件 | 《规划软件概要设计说明书》7.2.1 | 《规划软件详细设计说明书》4-4.2-1 | 登录登录-initLoginUI | A-UT0201002 | 《规划软件系统测试用例》-登录 | 《MS-001规划软件系统测试报告》、《可用性验证报告》 | 《可用性确认报告》 MS-001猪脊骨试验报告 MS-001模型试验报告 MS-001临床预试验报告 MS-001尸体试验报告 | /
 |  | 010102 | 规划软件功能需求-软件启动后进行检测注册序列号，通过后进入登录界面 | 《规划软件概要设计说明书》7.1.1 | 《规划软件详细设计说明书》4-3.2-1 | 软件注册-verifyCrc | A-UT0201003 | 《规划软件系统测试用例》-登录 | 《MS-001规划软件系统测试报告》、《可用性验证报告》 | 《可用性确认报告》 MS-001猪脊骨试验报告 MS-001模型试验报告 MS-001临床预试验报告 MS-001尸体试验报告 | /
 |  | 010103 | 规划软件功能需求-用户通过账号、密码进行登录操作 | 《规划软件概要设计说明书》7.2.1 | 《规划软件详细设计说明书》4-4.2-1 | 登录登录-on_pButton_login_clicked、 登录登录-getUserInfo、 登录登录-getDBPassword | A-UT0201001、 A-UT0202002、 A-UT0202007 | 《规划软件系统测试用例》-登录 | 《MS-001规划软件系统测试报告》、《可用性验证报告》 | 《可用性确认报告》 MS-001猪脊骨试验报告 MS-001模型试验报告 MS-001临床预试验报告 MS-001尸体试验报告 | /
 |  | 010104 | 规划软件功能需求-用户名或者账号密码错误应有相应的提示 | 《规划软件概要设计说明书》7.2.1 | 《规划软件详细设计说明书》4-4.2-2 | 登录登录-on_pButton_login_clicked | A-UT0201001 | 《规划软件系统测试用例》-登录 | 《MS-001规划软件系统测试报告》、《可用性验证报告》 | 《可用性确认报告》 MS-001猪脊骨试验报告 MS-001模型试验报告 MS-001临床预试验报告 MS-001尸体试验报告 | /
 |  | 010105 | 规划软件功能需求-登录界面应该有合理的布局设计、风格 | 《规划软件概要设计说明书》7.2.1 | 《规划软件详细设计说明书》4-4.1-1 | 登录登录-initLoginUI | A-UT0201002 | 《规划软件系统测试用例》-登录 | 《MS-001规划软件系统测试报告》、《可用性验证报告》 | 《可用性确认报告》 MS-001猪脊骨试验报告 MS-001模型试验报告 MS-001临床预试验报告 MS-001尸体试验报告 | /
 |  | 020101 | 规划软件功能需求-账号登录后软件进入模块选择界面 | 《规划软件概要设计说明书》7.3.1 | 《规划软件详细设计说明书》6-6.1-1 | 登录登录-initUI | A-UT0401003 | 《规划软件系统测试用例》-登录 | 《MS-001规划软件系统测试报告》、《可用性验证报告》 | 《可用性确认报告》 MS-001猪脊骨试验报告 MS-001模型试验报告 MS-001临床预试验报告 MS-001尸体试验报告 | /
 |  | 020102 | 规划软件功能需求-必须选择机械臂模块（基础模块、默认选择状态） | 《规划软件概要设计说明书》7.3.1 | 《规划软件详细设计说明书》6-6.2-1 | 选择-initUI | A-UT0401003 | 《规划软件系统测试用例》-辅助模块选择 | 《MS-001规划软件系统测试报告》、《可用性验证报告》 | 《可用性确认报告》 MS-001猪脊骨试验报告 MS-001模型试验报告 MS-001临床预试验报告 MS-001尸体试验报告 | /
 |  | 030101 | 规划软件功能需求-CT数据管理 | 《规划软件概要设计说明书》7.4.1 | 《规划软件详细设计说明书》7-7.1-1 | 数据管理-initUI、 数据管理-initPatientList、 数据管理-updatePatientList、 数据管理-dataRowClicked、 数据管理-dataRowDoubleClicked、 数据管理-receiveSearchClicked、 数据管理-receiveClearClicked、 数据管理-nitPatientListWithParam、 数据管理-StartImport | A-UT0504001、 A-UT0504002、 A-UT0504003、 A-UT0504004、 A-UT0504005、 A-UT0504006、 A-UT0504007、 A-UT0504008、 A-UT0505003 | 《规划软件系统测试用例》-数据管理 | 《MS-001规划软件系统测试报告》 | 《可用性确认报告》 MS-001猪脊骨试验报告 MS-001模型试验报告 MS-001临床预试验报告 MS-001尸体试验报告 | R116、R117
 |  | 030102 | 规划软件功能需求-CT导入 | 《规划软件概要设计说明书》7.4.1 | 《规划软件详细设计说明书》7-7.2-2、 7-7.2-3 | 数据管理-StartImport、 数据管理-ImportPlanningData | A-UT0505003、 A-UT0505007 | 《规划软件系统测试用例》-数据管理 | 《MS-001规划软件系统测试报告》 | 《可用性确认报告》 MS-001猪脊骨试验报告 MS-001模型试验报告 MS-001临床预试验报告 MS-001尸体试验报告 | R105、R117
 |  | 030103 | 规划软件功能需求-CT预览 | 《规划软件概要设计说明书》7.4.1 | 《规划软件详细设计说明书》7-7.2-15、 7-7.2-16、 7-7.2-17、 7-7.2-18、 7-7.2-19 | 数据管理-initPatientList、 数据管理-updatePatientList、 数据管理-SetPreview、 数据管理-SelectPreview、 数据管理-eventFilter、 数据管理-wheelEvent | A-UT0505001、 A-UT0505002、 A-UT0505005、 A-UT0505006、 A-UT0505009、 A-UT0505010 | 《规划软件系统测试用例》-数据管理 | 《MS-001规划软件系统测试报告》 | 《可用性确认报告》 MS-001猪脊骨试验报告 MS-001模型试验报告 MS-001临床预试验报告 MS-001尸体试验报告 | R115
 |  | 030104 | 规划软件功能需求-CT序列 | 《规划软件概要设计说明书》7.4.1 | 《规划软件详细设计说明书》7-7.2-5、 7-7.2-6、 7-7.2-9、 7-7.2-12、 7-7.2-13 | 数据管理-SetDefaultSelectItem、 数据管理-OnCurrentIndexClicked、 数据管理-initListView、 数据管理-initUI | A-UT0503003、 A-UT0503004、 A-UT0503005、 A-UT0504001 | 《规划软件系统测试用例》-数据管理 | 《MS-001规划软件系统测试报告》 | 《可用性确认报告》 MS-001猪脊骨试验报告 MS-001模型试验报告 MS-001临床预试验报告 MS-001尸体试验报告 | R118
 |  | 030201 | 规划软件功能需求-切割复位 | 《规划软件概要设计说明书》7.5.1 | 《规划软件详细设计说明书》8-8.1-1 | 切割复位-initItemWidget、 切割复位-loadSingleModel、 切割复位-initVolumeProperty、 切割复位-initVolume、 切割复位-initItkData | A-UT0603003、 A-UT0604002、 A-UT0604006、 A-UT0604010、 A-UT0604013 | 《规划软件系统测试用例》-数据管理 《规划软件系统测试用例》-切割复位 | 《MS-001规划软件系统测试报告》 | 《可用性确认报告》 MS-001猪脊骨试验报告 MS-001模型试验报告 MS-001临床预试验报告 MS-001尸体试验报告 | R108
 |  | 030202 | 规划软件功能需求-切割图像显示区 | 《规划软件概要设计说明书》7.5.1 | 《规划软件详细设计说明书》8-8.2-1、 8-8.2-2、 8-8.2-3、 8-8.2-5 | 切割复位-isChecked、 切割复位-mouseMoveEvent、 切割复位-moveByActor、 切割复位-mousePressEvent、 切割复位-getVtkTransformMatrix、 切割复位-moveByCamera、 切割复位-wheelEvent | A-UT0603005、 A-UT0604001、 A-UT0604014、 A-UT0604015、 A-UT0604016、 A-UT0604019、 A-UT0604020、 A-UT0604023 | 《规划软件系统测试用例》-切割复位 | 《MS-001规划软件系统测试报告》 | 《可用性确认报告》 MS-001猪脊骨试验报告 MS-001模型试验报告 MS-001临床预试验报告 MS-001尸体试验报告 | R108
 |  | 030203 | 规划软件功能需求-切割列表区 | 《规划软件概要设计说明书》7.5.1 | 《规划软件详细设计说明书》8-8.2-4、8-8.2-5 | 切割复位-initItemWidget、 切割复位-updateName、 切割复位-updateId、 切割复位-isChecked、 切割复位-getItemName、 切割复位-getItemIndex、 切割复位-setCheckBoxVisible、 切割复位-setChecked | A-UT0603002、 A-UT0603003、 A-UT0603004、 A-UT0603005、 A-UT0603006、 A-UT0603007、 A-UT0603008、 A-UT0603009 | 《规划软件系统测试用例》-切割复位 | 《MS-001规划软件系统测试报告》 | 《可用性确认报告》 MS-001猪脊骨试验报告 MS-001模型试验报告 MS-001临床预试验报告 MS-001尸体试验报告 | /
 |  | 030204 | 规划软件功能需求-切割操作功能区 | 《规划软件概要设计说明书》7.5.1 | 《规划软件详细设计说明书》8-8.2-5 、8-8.2-6、8-8.2-7、8-8.2-8章节 | 切割复位-isChecked、 切割复位-mouseMoveEvent、 切割复位-moveByActor、 切割复位-mousePressEvent、 切割复位-getVtkTransformMatrix、 切割复位-moveByCamera、 切割复位-wheelEvent | A-UT0603005、 A-UT0604001、 A-UT0604014、 A-UT0604015、 A-UT0604016、 A-UT0604019、 A-UT0604020、 A-UT0604023 | 《规划软件系统测试用例》-切割复位 | 《MS-001规划软件系统测试报告》 | 《可用性确认报告》 MS-001猪脊骨试验报告 MS-001模型试验报告 MS-001临床预试验报告 MS-001尸体试验报告 | R108
 |  | 030205 | 规划软件功能需求-复位图像显示区 | 《规划软件概要设计说明书》7.5.1 | 《规划软件详细设计说明书》8-8.2-11 | 切割复位-isChecked、 切割复位-mouseMoveEvent、 切割复位-moveByActor、 切割复位-mousePressEvent、 切割复位-getVtkTransformMatrix、 切割复位-moveByCamera、 切割复位-wheelEvent | A-UT0603005、 A-UT0604001、 A-UT0604014、 A-UT0604015、 A-UT0604016、 A-UT0604019、 A-UT0604020、 A-UT0604023 | 《规划软件系统测试用例》-切割复位 | 《MS-001规划软件系统测试报告》 | 《可用性确认报告》 MS-001猪脊骨试验报告 MS-001模型试验报告 MS-001临床预试验报告 MS-001尸体试验报告 | /
 |  | 030206 | 规划软件功能需求-复位列表区 | 《规划软件概要设计说明书》7.5.1 | 《规划软件详细设计说明书》8-8.2-10 | 切割复位-initItemWidget、 切割复位-updateName、 切割复位-updateId、 切割复位-isChecked、 切割复位-getItemName、 切割复位-getItemIndex、 切割复位-setCheckBoxVisible、 切割复位-setChecked | A-UT0603002、 A-UT0603003、 A-UT0603004、 A-UT0603005、 A-UT0603006、 A-UT0603007、 A-UT0603008、 A-UT0603009 | 《规划软件系统测试用例》-切割复位 | 《MS-001规划软件系统测试报告》 | 《可用性确认报告》 MS-001猪脊骨试验报告 MS-001模型试验报告 MS-001临床预试验报告 MS-001尸体试验报告 | /
 |  | 030207 | 规划软件功能需求-复位操作功能区 | 《规划软件概要设计说明书》7.5.1 | 《规划软件详细设计说明书》8-8.2-11 | 切割复位-isChecked、 切割复位-mouseMoveEvent、 切割复位-moveByActor、 切割复位-mousePressEvent、 切割复位-getVtkTransformMatrix、 切割复位-moveByCamera、 切割复位-wheelEvent | A-UT0603005、 A-UT0604001、 A-UT0604014、 A-UT0604015、 A-UT0604016、 A-UT0604019、 A-UT0604020、 A-UT0604023 | 《规划软件系统测试用例》-切割复位 | 《MS-001规划软件系统测试报告》 | 《可用性确认报告》 MS-001猪脊骨试验报告 MS-001模型试验报告 MS-001临床预试验报告 MS-001尸体试验报告 | /
 |  | 030301 | 规划软件功能需求-CT分区 | 《规划软件概要设计说明书》7.6.1 | 《规划软件详细设计说明书》9-9.1-1 | CT分区-InitView | A-UT0701002 | 《规划软件系统测试用例》-切割复位 《规划软件系统测试用例》-CT分区 | 《MS-001规划软件系统测试报告》 | 《可用性确认报告》 MS-001猪脊骨试验报告 MS-001模型试验报告 MS-001临床预试验报告 MS-001尸体试验报告 | R106
 |  | 030302 | 规划软件功能需求-CT正视图显 | 《规划软件概要设计说明书》7.6.1 | 《规划软件详细设计说明书》9-9.2-3、 9-9.2-5 | CT分区-RestInterface、 CT分区-RightMouseRelease、 CT分区-RightMousePress | A-UT0701005、 A-UT0702002、 A-UT0702006、 A-UT0702007 | 《规划软件系统测试用例》-CT分区 | 《MS-001规划软件系统测试报告》 | 《可用性确认报告》 MS-001猪脊骨试验报告 MS-001模型试验报告 MS-001临床预试验报告 MS-001尸体试验报告 | /
 |  | 030303 | 规划软件功能需求-CT侧视图显示 | 《规划软件概要设计说明书》7.6.1 | 《规划软件详细设计说明书》9-9.2-4、 9-9.2-5 | CT分区-RestInterface、 CT分区-RightMouseRelease、 CT分区-RightMousePress | A-UT0701005、 A-UT0702002、 A-UT0702006、 A-UT0702007 | 《规划软件系统测试用例》-CT分区 | 《MS-001规划软件系统测试报告》 | 《可用性确认报告》 MS-001猪脊骨试验报告 MS-001模型试验报告 MS-001临床预试验报告 MS-001尸体试验报告 | /
 |  | 030304 | 规划软件功能需求-分区列表 | 《规划软件概要设计说明书》7.6.1 | 《规划软件详细设计说明书》9-9.2-6 | CT分区-InitData、 CT分区-LeftMouseRelease、 CT分区-AddNewBox、 CT分区-DeleteBox | A-UT0701001、 A-UT0702001、 A-UT0702004、 A-UT0702005 | 《规划软件系统测试用例》-CT分区 | 《MS-001规划软件系统测试报告》 | 《可用性确认报告》 MS-001猪脊骨试验报告 MS-001模型试验报告 MS-001临床预试验报告 MS-001尸体试验报告 | /
 |  | 030305 | 规划软件功能需求-分区功能区 | 《规划软件概要设计说明书》7.6.1 | 《规划软件详细设计说明书》9-9.2-7、 9-9.2-9、 9-9.2-10、 9-9.2-11 | CT分区-InitData、 CT分区-InitView、 CT分区-LeftMouseRelease、 CT分区-AddNewBox、 CT分区-DeleteBox | A-UT0701001、 A-UT0701002、 A-UT0702001、 A-UT0702004、 A-UT0702005 | 《规划软件系统测试用例》-CT分区 | 《MS-001规划软件系统测试报告》 | 《可用性确认报告》 MS-001猪脊骨试验报告 MS-001模型试验报告 MS-001临床预试验报告 MS-001尸体试验报告 | /
 |  | 030401 | 规划软件功能需求-规划功能 | 《规划软件概要设计说明书》7.7.1 | 《规划软件详细设计说明书》10-10.1-1 | 规划-View2D、 规划-Init2DView、 规划-InitLabels、 规划-View3D、 规划-Initial、 规划-InitData、 规划-InitView、 规划-ShowCone | A-UT0801001、 A-UT0801004、 A-UT0801008、 A-UT0801009、 A-UT0806003、 A-UT0807008、 A-UT0807011、 A-UT0810001 | 《规划软件系统测试用例》-CT分区 《规划软件系统测试用例》-手术规划 | 《MS-001规划软件系统测试报告》 | 《可用性确认报告》 MS-001猪脊骨试验报告 MS-001模型试验报告 MS-001临床预试验报告 MS-001尸体试验报告 | R105、R106、R107、R108、R109、R110、R111、R112、R113、R114、R115、R116、R117、R118、R119、R120、R121、R123、R124、R125、R126、R127、R128、R129、R130、R131、R132、R133、R134、R135、R136、R137、R138、R139
 |  | 030402 | 规划软件功能需求-CT数据视图 | 《规划软件概要设计说明书》7.7.1 | 《规划软件详细设计说明书》10-10.1-1、 10-10.2-2 | 规划-View2D、 规划-View3DZoom、 规划-GenerateVROpacity、 规划-Init2DView、 规划-SelectAndChange3dColor、 规划-SetType、 规划-Change3dModle、 规划-InitLabels、 规划-View3D、 规划-GetRenderZoomFrame、 规划-Set3DViewSynchronization、 规划-Reduction3dOpacity、 规划-InitOpacityData、 规划-View2DZoom、 规划-SliceNavigatorZoom、 规划-SliceNavigator、 规划-GetRenderFrame、 规划-Init3DZoomPositionView、 规划-Set2dWindowLevel | A-UT0801001、 A-UT0801002、 A-UT0801003、 A-UT0801004、 A-UT0801005、 A-UT0801006、 A-UT0801007、 A-UT0801008、 A-UT0801009、 A-UT0801010、 A-UT0801011、 A-UT0801012、 A-UT0801013、 A-UT0801014、 A-UT0801015、 A-UT0801016、 A-UT0801017、 A-UT0801018、 A-UT0801019 | 《规划软件系统测试用例》-手术规划 | 《MS-001规划软件系统测试报告》 | 《可用性确认报告》 MS-001猪脊骨试验报告 MS-001模型试验报告 MS-001临床预试验报告 MS-001尸体试验报告 | R115
 |  | 030403 | 规划软件功能需求-分区图像区 | 《规划软件概要设计说明书》7.7.1 | 《规划软件详细设计说明书》10-10.2-3 | 规划-ShowCone、 规划-WidgetIsVisible、 规划-SetWidgetVisible、 规划-SetSelectText、 规划-GetRenderWidget | A-UT0811001、 A-UT0811002、 A-UT0811003、 A-UT0811004、 A-UT0811005 | 《规划软件系统测试用例》-手术规划 | 《MS-001规划软件系统测试报告》 | 《可用性确认报告》 MS-001猪脊骨试验报告 MS-001模型试验报告 MS-001临床预试验报告 MS-001尸体试验报告 | /
 |  | 030404 | 规划软件功能需求-螺钉规划列表 | 《规划软件概要设计说明书》7.7.1 | 《规划软件详细设计说明书》10-10.2-4 | 规划-SetTableState、 规划-setModel、 规划-UpdataHeaderChecked、 规划-UnLockTable、 规划-LockTable、 规划-setModel、 规划-UpdataHeaderChecked、 规划-SetTableState、 规划-LockTable、 规划-UnLockTable、 规划-resizeEvent、 规划-mousePressEvent | A-UT0808001、 A-UT0808002、 A-UT0808003、 A-UT0808004、 A-UT0808005、 A-UT0809001、 A-UT0809002、 A-UT0809003、 A-UT0809004、 A-UT0809005、 A-UT0809006、 A-UT0809007 | 《规划软件系统测试用例》-规划 | 《MS-001规划软件系统测试报告》 | 《可用性确认报告》 MS-001猪脊骨试验报告 MS-001模型试验报告 MS-001临床预试验报告 MS-001尸体试验报告 | R137
 |  | 030405 | 规划软件功能需求-规划功能操作 | 《规划软件概要设计说明书》7.7.1 | 《规划软件详细设计说明书》10-10.2-6 | 规划-GetLinePlanTableObserverId、 规划-SetLinePlanTableObserverId、 规划-GetLine、 规划-AddView、 规划-BeginMeasure、 规划-AssignmentMeasureWidget、 规划-EmptyMeasureWidget、 规划-OffAllMeasure、 规划-showEvent、 规划-ThumbnailSketchWidget、 规划-SetButtonEnable、 规划-OrganSegmentationStateChange、 规划-ReadSelfModularData、 规划-MeasureButtonClicked、 规划-RestInterface、 规划-InitData、 规划-ReadOtherModularData、 规划-ChangeFourWidgetZoom、 规划-InitView、 规划-UpdataSplitConeFourViewCenter、 规划-LineOperationButtonClicked、 规划-ClearAllScrew、 规划-VerificationSelfData | A-UT0802001、 A-UT0802002、 A-UT0802003、 A-UT0802004、 A-UT0805001、 A-UT0805002、 A-UT0805003、 A-UT0805004、 A-UT0807001、 A-UT0807002、 A-UT0807003、 A-UT0807004、 A-UT0807005、 A-UT0807006、 A-UT0807007、 A-UT0807008、 A-UT0807009、 A-UT08070010、 A-UT08070011、 A-UT08070012、 A-UT08070013、 A-UT08070014、 A-UT08070015 | 《规划软件系统测试用例》-手术规划 | 《MS-001规划软件系统测试报告》 | 《可用性确认报告》 MS-001猪脊骨试验报告 MS-001模型试验报告 MS-001临床预试验报告 MS-001尸体试验报告 | R105、R106、R107、R108、R109、R110、R111、R112、R113、R114、R115、R116、R117、R118、R119、R120、R121、R123、R124、R125、R126、R127、R128、R129、R130、R131、R132、R133、R134、R135、R136、R137、R138、R139
 |  | 030406 | 规划软件功能需求-器官分割 | 《规划软件概要设计说明书》7.7.1 | 《规划软件详细设计说明书》10-10.2-5 | 规划-InitView、 规划-RestWidget、 规划-AddImage | A-UT0810001、 A-UT0810002、 A-UT0810003 | 《规划软件系统测试用例》-手术规划 | 《MS-001规划软件系统测试报告》 | 《可用性确认报告》 MS-001猪脊骨试验报告 MS-001模型试验报告 MS-001临床预试验报告 MS-001尸体试验报告 | R108
 |  | 030407 | 规划软件功能需求-器官分割图像显示区 | 《规划软件概要设计说明书》7.7.1 | 《规划软件详细设计说明书》10-10.2-5 | 规划-View2D、 规划-InitView、 规划-RestWidget、 规划-AddImage | A-UT0801001、 A-UT0810001、 A-UT0810002、 A-UT0810003 | 《规划软件系统测试用例》-手术规划 | 《MS-001规划软件系统测试报告》 | 《可用性确认报告》 MS-001猪脊骨试验报告 MS-001模型试验报告 MS-001临床预试验报告 MS-001尸体试验报告 | /
 |  | 030501 | 规划软件功能需求-X-Ray分区 | 《规划软件概要设计说明书》7.8.1 | 《规划软件详细设计说明书》11-11.1-1、11-11.1-2 、11-11.1-3、11-11.1-4 | X-Ray分区--ReceiveFrontalImage、 X-Ray分区-ReadOtherModularData、 X-Ray分区-UpdateCameraParam、 X-Ray分区-ReadSelfModularData、 X-Ray分区-RestInterface | A-UT0901001、 A-UT0901002、 A-UT0901003、 A-UT0901004、 A-UT0901005 | 《规划软件系统测试用例》-手术规划 《规划软件系统测试用例》-X-Ray分区 | 《MS-001规划软件系统测试报告》 | 《可用性确认报告》 MS-001猪脊骨试验报告 MS-001模型试验报告 MS-001临床预试验报告 MS-001尸体试验报告 | R39、R107
 |  | 030502 | 规划软件功能需求-X-Ray显示区 | 《规划软件概要设计说明书》7.8.1 | 《规划软件详细设计说明书》11-11.2-1、 11-11.2-2、 11-11.2-3、 11-11.2-4 | X-Ray分区-LeftMouseRelease、 X-Ray分区-RightMousePress、 X-Ray分区-MouseMove、 X-Ray分区-RightMouseRelease、 X-Ray分区-LeftMousePress | A-UT0902005、 A-UT0902006、 A-UT0902007、 A-UT0902032、 A-UT0902037 | 《规划软件系统测试用例》-X-Ray分区 | 《MS-001规划软件系统测试报告》 | 《可用性确认报告》 MS-001猪脊骨试验报告 MS-001模型试验报告 MS-001临床预试验报告 MS-001尸体试验报告 | /
 |  | 030503 | 规划软件功能需求-分区列表 | 《规划软件概要设计说明书》7.8.1 | 《规划软件详细设计说明书》11-11.2-5 、11-11.2-6 | X-Ray分区-ReadOtherModularData、 X-Ray分区-ReadSelfModularData、 X-Ray分区-ReadBoxData | A-UT0901002、 A-UT0901004、 A-UT0902034、 | 《规划软件系统测试用例》-X-Ray分区 | 《MS-001规划软件系统测试报告》 | 《可用性确认报告》 MS-001猪脊骨试验报告 MS-001模型试验报告 MS-001临床预试验报告 MS-001尸体试验报告 | /
 |  | 030504 | 规划软件功能需求-X-Ray椎体分割功能 | 《规划软件概要设计说明书》7.8.1 | 《规划软件详细设计说明书》11-11.2-7、11-11.2-8、11-11.2-9 | X-Ray分区-ClearView、 X-Ray分区-CreateLine、 X-Ray分区-RightRot、 X-Ray分区-SetTips、 X-Ray分区-LeftMouseRelease、 X-Ray分区-RightMousePress、 X-Ray分区-MouseMove、 X-Ray分区-SaveBoxData、 X-Ray分区-JudgeMoveMiddleLine、 X-Ray分区-JudgeMoveVerticalLine、 X-Ray分区-SortLinesAndPoints、 X-Ray分区-GetBroundPos、 X-Ray分区-JudgeAddSpineBox、 X-Ray分区-UpdateSpineBoxData、 X-Ray分区-CreatePoint、 X-Ray分区-RotateLine、 X-Ray分区-LeftLineMove、 X-Ray分区-PostProcessingImageData、 X-Ray分区-RestCam、 X-Ray分区-SaveAngleData、 X-Ray分区-AddNewBox、 X-Ray分区-ReflashLabelActor、 X-Ray分区-InitPushbutton、 X-Ray分区-JudgeRotateLine、 X-Ray分区-LeaveWidget、 X-Ray分区-CreateBigBox、 X-Ray分区-RestInterface、 X-Ray分区-AddSpineBox、 X-Ray分区-MiddleLineMove、 X-Ray分区-GetVtkWidget、 X-Ray分区-LeftRot、 X-Ray分区-RightMouseRelease、 X-Ray分区-ValidationCtAdnXRayData、 X-Ray分区-ReadBoxData、 X-Ray分区-DeleteBox、 X-Ray分区-LineMove、 X-Ray分区-LeftMousePress、 X-Ray分区-VtkSplitXRayWidget、 X-Ray分区-ResetWindowLevel、 X-Ray分区-DeleteSpinBox | A-UT0902001、 A-UT0902002、 A-UT0902003、 A-UT0902004、 A-UT0902005、 A-UT0902006、 A-UT0902007、 A-UT0902008、 A-UT0902009、 A-UT0902010、 A-UT0902011、 A-UT0902012、 A-UT0902013、 A-UT0902014、 A-UT0902015、 A-UT0902016、 A-UT0902017、 A-UT0902018、 A-UT0902019、 A-UT0902020、 A-UT0902021、 A-UT0902022、 A-UT0902023、 A-UT0902024、 A-UT0902025、 A-UT0902026、 A-UT0902027、 A-UT0902028、 A-UT0902029、 A-UT0902030、 A-UT0902031、 A-UT0902032、 A-UT0902033、 A-UT0902034、 A-UT0902035、 A-UT0902036、 A-UT0902037、 A-UT0902038、 A-UT0902039、 A-UT0902040 | 《规划软件系统测试用例》-X-Ray分区 | 《MS-001规划软件系统测试报告》 | 《可用性确认报告》 MS-001猪脊骨试验报告 MS-001模型试验报告 MS-001临床预试验报告 MS-001尸体试验报告 | R49、R107
 |  | 030601 | 规划软件功能需求-配准界面 | 《规划软件概要设计说明书》7.9.1 | 《规划软件详细设计说明书》12-12.1-1、 12-12.1-2、 12-12.1-3 | 配准-initUITest、 配准-ui_Test、 | A-UT1002016、 A-UT1001005、 A-UT1002032 | 《规划软件系统测试用例》-X-Ray分区 《规划软件系统测试用例》-图像配准 | 《MS-001规划软件系统测试报告》 | 《可用性确认报告》 MS-001猪脊骨试验报告 MS-001模型试验报告 MS-001临床预试验报告 MS-001尸体试验报告 | /
 |  | 030602 | 规划软件功能需求-配准-图像显示区 | 《规划软件概要设计说明书》7.9.1 | 《规划软件详细设计说明书》12-12.2-1、 12-12.2-2、 12-12.2-4 | 配准-zoomInOrOut、 配准-restoreFrontalCtPosture、 配准-restoreFrontalCtPosture、 配准-frontalFilter、 配准-lateralProcessingImageData | A-UT1001006、 A-UT1001009、 A-UT1002002、 A-UT1002027、 A-UT1002030 | 《规划软件系统测试用例》-图像配准 | 《MS-001规划软件系统测试报告》 | 《可用性确认报告》 MS-001猪脊骨试验报告 MS-001模型试验报告 MS-001临床预试验报告 MS-001尸体试验报告 | /
 |  | 030603 | 规划软件功能需求-配准-椎体列表 | 《规划软件概要设计说明书》7.9.1 | 《规划软件详细设计说明书》12-12.2-3 | 配准-coarseMatching、 配准-clearAllVectorData、 配准-changeBoxByItemIndex | A-UT1002001、 A-UT1002029、 A-UT1002034 | 《规划软件系统测试用例》-图像配准 | 《MS-001规划软件系统测试报告》 | 《可用性确认报告》 MS-001猪脊骨试验报告 MS-001模型试验报告 MS-001临床预试验报告 MS-001尸体试验报告 | /
 |  | 030604 | 规划软件功能需求-配准-配准操作功能 | 《规划软件概要设计说明书》7.9.1 | 《规划软件详细设计说明书》12-12.2-3 | 配准-coarseMatching、 配准-clearAllVectorData、 配准-changeBoxByItemIndex | A-UT1002001、 A-UT1002029、 A-UT1002034 | 《规划软件系统测试用例》-图像配准 | 《MS-001规划软件系统测试报告》 | 《可用性确认报告》 MS-001猪脊骨试验报告 MS-001模型试验报告 MS-001临床预试验报告 MS-001尸体试验报告 | R7、R109、R111
 |  | 030605 | 规划软件功能需求-配准-配准参数设置界面 | 《规划软件概要设计说明书》7.9.1 | 《规划软件详细设计说明书》12-12.2-4 | 配准-mouseReleaseEvent、 配准-mousePressEvent | A-UT1001004、 A-UT1001022、 | 《规划软件系统测试用例》-图像配准 | 《MS-001规划软件系统测试报告》 | 《可用性确认报告》 MS-001猪脊骨试验报告 MS-001模型试验报告 MS-001临床预试验报告 MS-001尸体试验报告 | /
 |  | 030701 | 规划软件功能需求-定位 | 《规划软件概要设计说明书》7.10.1 | 《规划软件详细设计说明书》13-13.1-1、 13-13.1-2、 13-13.1-3、 13-13.1-4 | 定位-InitView、 定位-ui_ | A-UT1101001、 A-UT1101006 | 《规划软件系统测试用例》-图像配准 《规划软件系统测试用例》-定位 | 《MS-001规划软件系统测试报告》 | 《可用性确认报告》 MS-001猪脊骨试验报告 MS-001模型试验报告 MS-001临床预试验报告 MS-001尸体试验报告 | R166
 |  | 030702 | 规划软件功能需求-定位-图像显示 | 《规划软件概要设计说明书》7.10.1 | 《规划软件详细设计说明书》13-13.2-2、 13-13.2-3 | 定位-InitView、 定位-RestInterface、 定位-ui_、 定位-showEvent | A-UT1101001、 A-UT1101003、 A-UT1101006、 A-UT1101009 | 《规划软件系统测试用例》-定位 | 《MS-001规划软件系统测试报告》 | 《可用性确认报告》 MS-001猪脊骨试验报告 MS-001模型试验报告 MS-001临床预试验报告 MS-001尸体试验报告 | /
 |  | 030703 | 规划软件功能需求--定位-螺钉列表 | 《规划软件概要设计说明书》7.10.1 | 《规划软件详细设计说明书》13-13.2-4 | 定位-InitData、 定位-ReadSelfModularData | A-UT1101002、 A-UT1101011 | 《规划软件系统测试用例》-定位 | 《MS-001规划软件系统测试报告》 | 《可用性确认报告》 MS-001猪脊骨试验报告 MS-001模型试验报告 MS-001临床预试验报告 MS-001尸体试验报告 | /
 |  | 030704 | 规划软件功能需求--定位-定位操作 | 《规划软件概要设计说明书》7.10.1 | 《规划软件详细设计说明书》13-13.2-5 | 定位-SendPositionData | A-UT1101012 | 《规划软件系统测试用例》-定位 | 《MS-001规划软件系统测试报告》 | 《可用性确认报告》 MS-001猪脊骨试验报告 MS-001模型试验报告 MS-001临床预试验报告 MS-001尸体试验报告 | /
 |  | 040101 | 规划软件功能需求-软件可实现外部设备的连接状态的显示 | 《规划软件概要设计说明书》7.11.1 | 《规划软件详细设计说明书》5-5.2-2 | 网络-InitConnect | A-UT1101010 | 《规划软件系统测试用例》-手术外设监测 | 《MS-001规划软件系统测试报告》 | 《可用性确认报告》 MS-001猪脊骨试验报告 MS-001模型试验报告 MS-001临床预试验报告 MS-001尸体试验报告 | /
 |  | 040102 | 规划软件功能需求-软件可以联合C臂机使用。 | 《规划软件概要设计说明书》7.11.1 | 《规划软件详细设计说明书》5-5.2-1 | 网络-InitConnect | A-UT1101010 | 《规划软件系统测试用例》-定位 | 《MS-001规划软件系统测试报告》、《C臂机联合使用验证报告》 | 《可用性确认报告》 MS-001猪脊骨试验报告 MS-001模型试验报告 MS-001临床预试验报告 MS-001尸体试验报告 | R36、R147、R169、R170
 |  | 050101 | 规划软件功能需求-软件可适配本公司生产的其他扩展模块 | 《规划软件概要设计说明书》3.5-7.11.1 | 《规划软件详细设计说明书》6-6.1-1 | 选择-OptionWidget、 选择-closeEvent、 选择-initUI | A-UT0401001、 A-UT0401002、 A-UT0401003 | 《规划软件系统测试用例》-X-Ray分区 | 《MS-001规划软件系统测试报告》 | 《可用性确认报告》 MS-001猪脊骨试验报告 MS-001模型试验报告 MS-001临床预试验报告 MS-001尸体试验报告 | /
 |  | 060101 | 规划软件功能需求-配置模块包括关于、日志导出、设置和高级设置（需要密码登录）、系统退出、外部设备状态指示 | 《规划软件概要设计说明书》7.12.1、7.13.1 | 《规划软件详细设计说明书》5-5.1-1 | 网络-AboutDialog、 日志导出-okClicked、 配置-initParam | A-UT1201001、 A-UT1501001、 A-UT1301001 | 《规划软件系统测试用例》-帮助 | 《MS-001规划软件系统测试报告》 | 《可用性确认报告》 MS-001猪脊骨试验报告 MS-001模型试验报告 MS-001临床预试验报告 MS-001尸体试验报告 | /
 |  | 060102 | 规划软件功能需求-软件信息模块 | 《规划软件概要设计说明书》7.13.1 | 《规划软件详细设计说明书》14-14.2-1 | 软件信息-AboutDialog | A-UT1201001 | 《规划软件系统测试用例》-帮助 | 《MS-001规划软件系统测试报告》 | 《可用性确认报告》 MS-001猪脊骨试验报告 MS-001模型试验报告 MS-001临床预试验报告 MS-001尸体试验报告 | /
 |  | 060103 | 规划软件功能需求-日志模块 | 《规划软件概要设计说明书》7.14.1、7.15.1 | 《规划软件详细设计说明书》17-17.1-1 | 日志记录-Logger、 日志导出-ExportSessionData | A-UT1401002、 A-UT1501004 | 《规划软件系统测试用例》-帮助 | 《MS-001规划软件系统测试报告》 | 《可用性确认报告》 MS-001猪脊骨试验报告 MS-001模型试验报告 MS-001临床预试验报告 MS-001尸体试验报告 | /
 |  | 060104 | 规划软件功能需求-设置 | 《规划软件概要设计说明书》7.12.1 | 《规划软件详细设计说明书》15-15.2-1 | 配置-initParam、 配置-readConfig | A-UT1301001、 A-UT1301004、 A-UT1302001、 A-UT1302004 | 《规划软件系统测试用例》-帮助 | 《MS-001规划软件系统测试报告》 | 《可用性确认报告》 MS-001猪脊骨试验报告 MS-001模型试验报告 MS-001临床预试验报告 MS-001尸体试验报告 | /
 |  | 060105 | 规划软件功能需求-高级设置 | 《规划软件概要设计说明书》7.12.1 | 《规划软件详细设计说明书》15-15.2-1 | 配置-initParam、 配置-readConfig | A-UT1301001、 A-UT1301004、 A-UT1302001、 A-UT1302004 | 《规划软件系统测试用例》-帮助 | 《MS-001规划软件系统测试报告》 | 《可用性确认报告》 MS-001猪脊骨试验报告 MS-001模型试验报告 MS-001临床预试验报告 MS-001尸体试验报告 | /
 |  | 060106 | 规划软件功能需求-系统退出模块 | 《规划软件概要设计说明书》7.16.1 | 《规划软件详细设计说明书》18-18.1-1 | 系统退出-closeEvent、 系统退出-on_pButton_other_system_clicked | A-UT1601003、 A-UT1601004 | 《规划软件系统测试用例》-帮助 | 《MS-001规划软件系统测试报告》 | 《可用性确认报告》 MS-001猪脊骨试验报告 MS-001模型试验报告 MS-001临床预试验报告 MS-001尸体试验报告 | /
UR0800 | 本产品需要提供一种应用软件，用于控制机械臂运动以及仿真 | 070101 | 导引软件功能需求-系统启动后自动打开软件 | 《导引软件概要设计说明书》7.2.1 | 《导引软件详细设计说明书》6-6.2-1 | 网络-StartProgram | B-UT1003010 | 《导引软件系统测试用例》-其他 | 《MS-001导引软件系统测试报告》、 《可用性验证报告》 | 《可用性确认报告》 MS-001猪脊骨试验报告 MS-001模型试验报告 MS-001临床预试验报告 MS-001尸体试验报告 | /
 |  | 070102 | 导引软件功能需求-软件启动后进行检测注册序列号，通过后进入登录界面 | 《导引软件概要设计说明书》7.1.1 | 《导引软件详细设计说明书》11-11.2-2 | 注册-generateLicense、 注册-IsValid | B-UT0902002、 B-UT0902003 | 《导引软件系统测试用例》-其他 | 《MS-001导引软件系统测试报告》、 《可用性验证报告》 | 《可用性确认报告》 MS-001猪脊骨试验报告 MS-001模型试验报告 MS-001临床预试验报告 MS-001尸体试验报告 | /
 |  | 070103 | 导引软件功能需求-用户通过账号、密码进行登录操作 | 《导引软件概要设计说明书》7.2.1 | 《导引软件详细设计说明书》6-6.2-1 | 登录-Login、 登录-GetPassword、 登录-GetLogin、 登录-GetUserInfo | B-UT0401001、 B-UT0401004、 B-UT0401006、 B-UT0401015 | 《导引软件系统测试用例》-登录 | 《MS-001导引软件系统测试报告》、 《可用性验证报告》 | 《可用性确认报告》 MS-001猪脊骨试验报告 MS-001模型试验报告 MS-001临床预试验报告 MS-001尸体试验报告 | /
 |  | 070104 | 导引软件功能需求-用户名或者密码错误应有相应的提示 | 《导引软件概要设计说明书》7.2.1 | 《导引软件详细设计说明书》6-6.2-2 | 登录-GetCablicate | B-UT0401009 | 《导引软件系统测试用例》-登录 | 《MS-001导引软件系统测试报告》、 《可用性验证报告》 | 《可用性确认报告》 MS-001猪脊骨试验报告 MS-001模型试验报告 MS-001临床预试验报告 MS-001尸体试验报告 | R149、R150、R151、R152
 |  | 070105 | 导引软件功能需求-登录界面应该有合理的布局设计、风格 | 《导引软件概要设计说明书》7.2.1 | 《导引软件详细设计说明书》4-4.1-1 | 登录-Login | B-UT0401001 | 《导引软件系统测试用例》-登录 《导引软件系统测试用例》-其他 | 《MS-001导引软件系统测试报告》 | 《可用性确认报告》 MS-001猪脊骨试验报告 MS-001模型试验报告 MS-001临床预试验报告 MS-001尸体试验报告 | /
 |  | 080101 | 导引软件功能需求-校准-工具选择 | 《导引软件概要设计说明书》7.3.1 | 《导引软件详细设计说明书》3.11-13 | 配置-InitToolSelectView、 配置-LoadToolInformation | B-UT0612004、 B-UT0612005 | 《导引软件系统测试用例》-校准 | 《MS-001导引软件系统测试报告》 | 《可用性确认报告》 MS-001猪脊骨试验报告 MS-001模型试验报告 MS-001临床预试验报告 MS-001尸体试验报告 | /
 |  | 080102 | 导引软件功能需求-校准-校准界面 | 《导引软件概要设计说明书》7.3.1 | 《导引软件详细设计说明书》3章节 | 校准-Registration、 校准-Initialize、 校准-Prepared、 校准-Prepared | B-UT0101001、 B-UT0102001、 B-UT0102002、 B-UT0104001 | 《导引软件系统测试用例》-校准 | 《MS-001导引软件系统测试报告》 | 《可用性确认报告》 MS-001猪脊骨试验报告 MS-001模型试验报告 MS-001临床预试验报告 MS-001尸体试验报告 | R160
 |  | 080103 | 导引软件功能需求-校准-图像显示区 | 《导引软件概要设计说明书》7.3.1 | 《导引软件详细设计说明书》3-3.1-2 | 校准-CalibrateImage、 校准-UndistortPoint、 校准-SendFrontalImage、 校准-SendLateralImage、 校准-SendFrontalImageParam、 校准-SendLateralImageMatrixParam | B-UT0102003、 B-UT0102004、 B-UT1002009、 B-UT1002010、 B-UT1002015、 B-UT1002016 | 《导引软件系统测试用例》-校准 | 《MS-001导引软件系统测试报告》 | 《可用性确认报告》 MS-001猪脊骨试验报告 MS-001模型试验报告 MS-001临床预试验报告 MS-001尸体试验报告 | R154
 |  | 080104 | 导引软件功能需求-校准-机械臂控制功能区 | 《导引软件概要设计说明书》7.4.1 | 《导引软件详细设计说明书》13-13.2 | 机械臂控制-Move | B-UT1101001、 B-UT1103006 | 《导引软件系统测试用例》-校准 | 《MS-001导引软件系统测试报告》 | 《可用性确认报告》 MS-001猪脊骨试验报告 MS-001模型试验报告 MS-001临床预试验报告 MS-001尸体试验报告 | R40、R45、R165
 |  | 080105 | 导引软件功能需求-校准-功能模块区 | 《导引软件概要设计说明书》7.3.1 | 《导引软件详细设计说明书》3-3.2、4-4.2 | 配置-IsCalibrateStatus、 配置-FrontalCalibrate、 配置-LateralCalibrate、 定位-InitProcessor、 定位-StartServer、 定位-State | B-UT0604001、 B-UT0604003、 B-UT0604004、 B-UT0201001、 B-UT0201002、 B-UT0201003 | 《导引软件系统测试用例》-校准 | 《MS-001导引软件系统测试报告》 | 《可用性确认报告》 MS-001猪脊骨试验报告 MS-001模型试验报告 MS-001临床预试验报告 MS-001尸体试验报告 | R160
 |  | 080106 | 导引软件功能需求-校准-工具信息区 | 《导引软件概要设计说明书》7.3.1 | 《导引软件详细设计说明书》3章节 | 配置-LoadToolInformation | B-UT0612005 | 《导引软件系统测试用例》-校准 | 《MS-001导引软件系统测试报告》 | 《可用性确认报告》 MS-001猪脊骨试验报告 MS-001模型试验报告 MS-001临床预试验报告 MS-001尸体试验报告 | /
 |  | 080107 | 导引软件功能需求-校准-信息打印 | 《导引软件概要设计说明书》7.3.1 | 《导引软件详细设计说明书》3.1 | 校准-Registration、 校准-CalibrateImage、 校准-IsRegsitered、 校准-IsFrontalRegsitered、 校准-IsLateralRegsitered、 校准-LastLocation、 校准-LastError | B-UT0101001、 B-UT0102003、 B-UT0103002、 B-UT0103003、 B-UT0103004、 B-UT0103005、 B-UT0103006 | 《导引软件系统测试用例》-校准 | 《MS-001导引软件系统测试报告》 | 《可用性确认报告》 MS-001猪脊骨试验报告 MS-001模型试验报告 MS-001临床预试验报告 MS-001尸体试验报告 | /
 |  | 080108 | 导引软件功能需求-校准-功能操作区 | 《导引软件概要设计说明书》7.3.1 | 《导引软件详细设计说明书》3-3.2 | 校准-CalibrateFrontalXRay、 校准-CalibrateLateralXRay | B-UT0103010、 B-UT0103011 | 《导引软件系统测试用例》-校准 | 《MS-001导引软件系统测试报告》 | 《可用性确认报告》 MS-001猪脊骨试验报告 MS-001模型试验报告 MS-001临床预试验报告 MS-001尸体试验报告 | R142
 |  | 090101 | 导引软件功能需求-定位-机械臂运动功能 | 《导引软件概要设计说明书》7.4.1 | 《导引软件详细设计说明书》4-4.2-1、 4-4.2-2、 | 定位-Move | B-UT1101001、 B-UT1103006 | 《导引软件系统测试用例》-定位 | 《MS-001导引软件系统测试报告》 | 《可用性确认报告》 MS-001猪脊骨试验报告 MS-001模型试验报告 MS-001临床预试验报告 MS-001尸体试验报告 | R1、R2、R9、R24
 |  | 090102 | 导引软件功能需求-定位-定位界面 | 《导引软件概要设计说明书》7.5.1 | 《导引软件详细设计说明书》4章节 | 定位-InitArmJointView、 定位-InitView | B-UT1101003、 B-UT1102005 | 《导引软件系统测试用例》-定位 | 《MS-001导引软件系统测试报告》 | 《可用性确认报告》 MS-001猪脊骨试验报告 MS-001模型试验报告 MS-001临床预试验报告 MS-001尸体试验报告 | /
 |  | 090103 | 导引软件功能需求-定位-图像显示区 | 《导引软件概要设计说明书》7.5.1 | 《导引软件详细设计说明书》12-12.2-1 | 校准-CalibrateImage | B-UT0102003 | 《导引软件系统测试用例》-定位 | 《MS-001导引软件系统测试报告》 | 《可用性确认报告》 MS-001猪脊骨试验报告 MS-001模型试验报告 MS-001临床预试验报告 MS-001尸体试验报告 | /
 |  | 090104 | 导引软件功能需求-定位-机械臂控制功能区（与080104相同） | 《导引软件概要设计说明书》7.4.1 | 《导引软件详细设计说明书》13-13.2 | 机械臂控制-Move | B-UT1101001、 B-UT1103006 | 《导引软件系统测试用例》-校准 | 《MS-001导引软件系统测试报告》 | 《可用性确认报告》 MS-001猪脊骨试验报告 MS-001模型试验报告 MS-001临床预试验报告 MS-001尸体试验报告 | R40、R45、R165
 |  | 090105 | 导引软件功能需求-定位-功能模块区（与080105相同） | 《导引软件概要设计说明书》7.5.1 | 《导引软件详细设计说明书》3-3.2、4-4.2 | 校准-IsCalibrateStatus、 校准-FrontalCalibrate、 校准-LateralCalibrate、 定位-InitProcessor、 定位-StartServer、 定位-State | B-UT0604001、 B-UT0604003、 B-UT0604004、 B-UT0201001、 B-UT0201002、 B-UT0201003 | 《导引软件系统测试用例》-定位 《导引软件系统测试用例》-校准 | 《MS-001导引软件系统测试报告》 | 《可用性确认报告》 MS-001猪脊骨试验报告 MS-001模型试验报告 MS-001临床预试验报告 MS-001尸体试验报告 | R160
 |  | 090106 | 导引软件功能需求-定位-信息打印 | 《导引软件概要设计说明书》7.5.1 | 《导引软件详细设计说明书》3.1 | 校准-Registration、 校准-CalibrateImage、 校准-IsRegsitered、 校准-IsFrontalRegsitered、 校准-IsLateralRegsitered、 校准-LastLocation、 校准-LastError | B-UT0101001、 B-UT0102003、 B-UT0103002、 B-UT0103003、 B-UT0103004、 B-UT0103005、 B-UT0103006 | 《导引软件系统测试用例》-定位 | 《MS-001导引软件系统测试报告》 | 《可用性确认报告》 MS-001猪脊骨试验报告 MS-001模型试验报告 MS-001临床预试验报告 MS-001尸体试验报告 | /
 |  | 090107 | 导引软件功能需求-定位-模型仿真 | 《导引软件概要设计说明书》7.6.1 | 《导引软件详细设计说明书》5-5.2 | 仿真-SetStartEndPoint、 仿真-FindTrees、 仿真-JudgeReach、 仿真-ReplanPath | B-UT0301001、 B-UT0301006、 B-UT0301010、 B-UT0301015 | 《导引软件系统测试用例》-定位 | 《MS-001导引软件系统测试报告》 | 《可用性确认报告》 MS-001猪脊骨试验报告 MS-001模型试验报告 MS-001临床预试验报告 MS-001尸体试验报告 | R167
 |  | 090108 | 导引软件功能需求-定位-机械臂参数区 | 《导引软件概要设计说明书》7.6.1 | 《导引软件详细设计说明书》13-13.2-1、 13-13.2-8、 5-5.2 | 仿真-UpdateAngle、 仿真-UpdateHeight、 仿真-UpdateHeightAngle、 仿真-Update2dAngle、 仿真-Update2dHeight、 仿真-Simulation、 机械臂控制-ArmCtlDlgShowed、 机械臂控制-QueryArmJoint | B-UT0201032、 B-UT0201033、 B-UT0201034、 B-UT0201038、 B-UT0201039、 B-UT0201040、 B-UT0201049、 B-UT0201050 | 《导引软件系统测试用例》-定位 | 《MS-001导引软件系统测试报告》 | 《可用性确认报告》 MS-001猪脊骨试验报告 MS-001模型试验报告 MS-001临床预试验报告 MS-001尸体试验报告 | /
 |  | 090109 | 导引软件功能需求-定位-功能操作区及重置功能 | 《导引软件概要设计说明书》7.5.1 | 《导引软件详细设计说明书》4-4.2 | 定位-Simulation、 定位-LaserTargetPose、 定位-ChannelTargetPose | B-UT0201040、 B-UT0201041、 B-UT0201042 | 《导引软件系统测试用例》-定位 | 《MS-001导引软件系统测试报告》 | 《可用性确认报告》 MS-001猪脊骨试验报告 MS-001模型试验报告 MS-001临床预试验报告 MS-001尸体试验报告 | R145、R146
 |  | 100101 | 导引软件功能需求-软件可实现监测外部设备的连接状态 | 《导引软件概要设计说明书》7.7.1 | 《导引软件详细设计说明书》12-12.4 | 网络-IsConnected | B-UT1003011 | 《导引软件系统测试用例》-辅助设备 | 《MS-001导引软件系统测试报告》 | 《可用性确认报告》 MS-001猪脊骨试验报告 MS-001模型试验报告 MS-001临床预试验报告 MS-001尸体试验报告 | /
 |  | 100102 | 软件可以联合C臂机使用 | 《导引软件概要设计说明书》7.7.1 | 《导引软件详细设计说明书》12.2 | 网络-GenerateCode | B-UT1002007 | 《导引软件系统测试用例》-校准 | 《MS-001导引软件系统测试报告》 | 《可用性确认报告》 MS-001猪脊骨试验报告 MS-001模型试验报告 MS-001临床预试验报告 MS-001尸体试验报告 | R36、R147、R169、R170
 |  | 100103 | 导引软件功能需求-软件适配我公司生产的规划软件 | 《导引软件概要设计说明书》7.7.1 | 《导引软件详细设计说明书》12-12.1-1 | 网络-SetStartEndPoint、 网络-SetHigh | B-UT1003001、 B-UT1003002 | 《导引软件系统测试用例》-校准 《导引软件系统测试用例》-定位 | 《MS-001导引软件系统测试报告》 | 《可用性确认报告》 MS-001猪脊骨试验报告 MS-001模型试验报告 MS-001临床预试验报告 MS-001尸体试验报告 | R148
 |  | 110101 | 导引软件功能需求-帮助-软件应该实现帮助信息显示及软件设置功能 | 《导引软件概要设计说明书》7.10.1 | 《导引软件详细设计说明书》7、8、10章节 | 软件信息-getSoftInVersion、 配置-initNetworkReg、 配置-ShowEvent、 配置-ReadIniSettings、 系统退出-invokeSystemExit | B-UT0501001、 B-UT0801001、 B-UT0601001、 B-UT0607001、 B-UT0607002 | 《导引软件系统测试用例》-帮助 | 《MS-001导引软件系统测试报告》 | 《可用性确认报告》 MS-001猪脊骨试验报告 MS-001模型试验报告 MS-001临床预试验报告 MS-001尸体试验报告 | /
 |  | 110102 | 导引软件功能需求-帮助-关于 | 《导引软件概要设计说明书》7.8.1 | 《导引软件详细设计说明书》7-7.2-1 | 软件信息-getSoftInVersion | B-UT0501001 | 《导引软件系统测试用例》-帮助 | 《MS-001导引软件系统测试报告》 | 《可用性确认报告》 MS-001猪脊骨试验报告 MS-001模型试验报告 MS-001临床预试验报告 MS-001尸体试验报告 | /
 |  | 110103 | 导引软件功能需求-帮助-设置 | 《导引软件概要设计说明书》7.4.1、7.9.1、7.10.1 | 《导引软件详细设计说明书》8-8.2-1、 13-13.2-2至13-13.2-11 | 配置-ExporImages、 机械臂控制-Move、 机械臂控制-ArmCtlDlgShowed | B-UT0605003、 B-UT1101001、 B-UT1103006、 B-UT0201049 | 《导引软件系统测试用例》-帮助 | 《MS-001导引软件系统测试报告》 | 《可用性确认报告》 MS-001猪脊骨试验报告 MS-001模型试验报告 MS-001临床预试验报告 MS-001尸体试验报告 | /
 |  | 110104 | 导引软件功能需求-帮助-高级设置 | 《导引软件概要设计说明书》7.5.1、7.6.1、7.10.1 | 《导引软件详细设计说明书》8-8.2-1 | 配置-initNetworkReg、 配置-InitToolSelectView、 配置-LoadToolInformation、 配置-Start、 配置-Simulation | B-UT0601001、 B-UT0612004、 B-UT0612005、 B-UT0201040、 B-UT0201010 | 《导引软件系统测试用例》-帮助 《导引软件系统测试用例》-定位 | 《MS-001导引软件系统测试报告》 | 《可用性确认报告》 MS-001猪脊骨试验报告 MS-001模型试验报告 MS-001临床预试验报告 MS-001尸体试验报告 | /
 |  | 110105 | 导引软件功能需求-帮助-系统退出 | 《导引软件概要设计说明书》7.11.1 | 《导引软件详细设计说明书》10-10.2-1 | 系统退出-invokeSystemExit | B-UT0801001 | 《导引软件系统测试用例》-帮助 | 《MS-001导引软件系统测试报告》 | 《可用性确认报告》 MS-001猪脊骨试验报告 MS-001模型试验报告 MS-001临床预试验报告 MS-001尸体试验报告 | /
UR0901 | 提供图像校准的装置用于X光片图像处理 | 150002 | 工具包功能需求-安装方式-配合机械臂前端法兰安装 | 《MS-001工具包结构概要设计说明书》1.1章节产品功能需求 | 《MS-001工具包结构详细设计说明书》 | MS001-C.02.001JX.1.1 MS001-C转接法兰总成 | / | 《系统整机验证报告》 | 《可用性验证报告》 | 《可用性确认报告》 MS-001猪脊骨试验报告 MS-001模型试验报告 MS-001临床预试验报告 MS-001尸体试验报告 | R75
 |  | 150003 | 工具包功能需求-造型风格-科技、简约、专业 | 《MS-001工具包结构概要设计说明书》1.1章节产品功能需求 | 《MS-001工具包结构详细设计说明书》 | MS001-C.01.001ZZ.1.1 工具包 | / | 《系统整机验证报告》 | 《可用性验证报告》 | 《可用性确认报告》 MS-001猪脊骨试验报告 MS-001模型试验报告 MS-001临床预试验报告 MS-001尸体试验报告 | /
 |  | 150004 | 工具包功能需求-设备组成-配准板 | 《MS-001工具包结构概要设计说明书》1.1章节产品功能需求 | 《MS-001工具包结构详细设计说明书》 《MS-001关键零部件选型报告》6.配准板材料选型 | MS001-C.03.001JX.1.1 MS001-C配准板总成 | / | 《系统整机验证报告》 | 《可用性验证报告》 | 《可用性确认报告》 MS-001猪脊骨试验报告 MS-001模型试验报告 MS-001临床预试验报告 MS-001尸体试验报告 | R77
 |  | 150005 | 工具包功能需求-设备组成-转接法兰 | 《MS-001工具包结构概要设计说明书》1.1章节产品功能需求 | 《MS-001工具包结构详细设计说明书》 | MS001-C.02.002SL.1.1 MS001-C转接法兰 MS001-C.02.003JS.1.1 MS001-C转接法兰2 | / | 《系统整机验证报告》 | 《可用性验证报告》 | 《可用性确认报告》 MS-001猪脊骨试验报告 MS-001模型试验报告 MS-001临床预试验报告 MS-001尸体试验报告 | /
 |  | 150008 | 工具包功能需求-结构设计-标定板要求上下两层结构设计 | 《MS-001工具包结构概要设计说明书》1.1章节产品功能需求 | 《MS-001工具包结构详细设计说明书》 | MS001-C.03.001JX.1.1 MS001-C配准板总成 | / | 《系统整机验证报告》 | 《可用性验证报告》 | 《可用性确认报告》 MS-001猪脊骨试验报告 MS-001模型试验报告 MS-001临床预试验报告 MS-001尸体试验报告 | /
 |  | 150009 | 工具包功能需求-结构设计-标定板材质要求碳纤维材质 | 《MS-001工具包结构概要设计说明书》1.1章节产品功能需求 | 《MS-001工具包结构详细设计说明书》 | MS001-C.03.001JX.1.1 MS001-C配准板总成 | / | 《系统整机验证报告》 | 《可用性验证报告》 | 《可用性确认报告》 MS-001猪脊骨试验报告 MS-001模型试验报告 MS-001临床预试验报告 MS-001尸体试验报告 | R77
 |  | 150010 | 工具包功能需求-结构设计-标定板表面镶嵌钢柱球（钢珠球的排列和数量由算法定） | 《MS-001工具包结构概要设计说明书》1.1章节产品功能需求 | 《MS-001工具包结构详细设计说明书》 | MS001-C.03.001JX.1.1 MS001-C配准板总成 | / | 《系统整机验证报告》 | 《可用性验证报告》 | 《可用性确认报告》 MS-001猪脊骨试验报告 MS-001模型试验报告 MS-001临床预试验报告 MS-001尸体试验报告 | /
 |  | 150016 | 工具包功能需求-外观设计-良好的耐磨性以及抗划伤性、外观污渍好清理、外观强度可靠 | 《MS-001工具包结构概要设计说明书》1.1章节产品功能需求 | 《MS-001工具包结构详细设计说明书》 | MS001-C.01.001ZZ.1.1 工具包 | / | 《系统整机验证报告》 | 《可用性验证报告》 | 《可用性确认报告》 MS-001猪脊骨试验报告 MS-001模型试验报告 MS-001临床预试验报告 MS-001尸体试验报告 | /
 |  | 150017 | 工具包功能需求-外观设计-设计外观整体性要考虑与主体两个台车搭配 | 《MS-001工具包结构概要设计说明书》1.1章节产品功能需求 | 《MS-001工具包结构详细设计说明书》 | MS001-C.01.001ZZ.1.1 工具包 | / | 《系统整机验证报告》 | 《可用性验证报告》 | 《可用性确认报告》 MS-001猪脊骨试验报告 MS-001模型试验报告 MS-001临床预试验报告 MS-001尸体试验报告 | /
 |  | 150018 | 工具包功能需求-外观设计-器械抛光 | 《MS-001工具包结构概要设计说明书》1.1章节产品功能需求 | 《MS-001工具包结构详细设计说明书》 | MS001-C.01.001ZZ.1.1 工具包 | / | 《系统整机验证报告》 | 《可用性验证报告》 | 《可用性确认报告》 MS-001猪脊骨试验报告 MS-001模型试验报告 MS-001临床预试验报告 MS-001尸体试验报告 | /
 |  | 150019 | 工具包功能需求-材料要求-医用级别材料 | 《MS-001工具包结构概要设计说明书》1.1章节产品功能需求 | 《MS-001工具包结构详细设计说明书》 | MS001-C.01.001ZZ.1.1 工具包 | / | 《系统整机验证报告》 | 《可用性验证报告》 | 《可用性确认报告》 MS-001猪脊骨试验报告 MS-001模型试验报告 MS-001临床预试验报告 MS-001尸体试验报告 | /
 |  | 150020 | 工具包功能需求-文字-商标、logo、产品信息 | 《MS-001工具包结构概要设计说明书》1.1章节产品功能需求 | 《MS-001工具包结构详细设计说明书》<MS-001工具包包装及标签方案> | MS001-C.01.001ZZ.1.1 工具包 | / | 《系统整机验证报告》 | 《可用性验证报告》 | 《可用性确认报告》 MS-001猪脊骨试验报告 MS-001模型试验报告 MS-001临床预试验报告 MS-001尸体试验报告 | R12
UR0902 | 提供手术定位的装置，用于通道把持 | 同前述150005 | 工具包功能需求-设备组成-转接法兰 | / | / | / | / | / | / | / | /
 |  | 150006 | 工具包功能需求-设备组成-定位工具 | 《MS-001工具包结构概要设计说明书》1.1章节产品功能需求 | 《MS-001工具包结构详细设计说明书》 《MS-001关键零部件选型报告》5.手术定位器材料选型 | / | / | 《系统整机验证报告》 | 《可用性验证报告》 | 《可用性确认报告》 MS-001猪脊骨试验报告 MS-001模型试验报告 MS-001临床预试验报告 MS-001尸体试验报告 | R77
 |  | 150011 | 工具包功能需求-结构设计-通道连杆与转接法兰可快速拆装，需保证拆装一致性 | 《MS-001工具包结构概要设计说明书》1.1章节产品功能需求 | 《MS-001工具包结构详细设计说明书》 | / | / | 《系统整机验证报告》 | 《可用性验证报告》 | 《可用性确认报告》 MS-001猪脊骨试验报告 MS-001模型试验报告 MS-001临床预试验报告 MS-001尸体试验报告 | R76
 |  | 同前述150016 | 工具包功能需求-外观设计-良好的耐磨性以及抗划伤性、外观污渍好清理、外观强度可靠 | / | / | / | / | / | / | / | /
 |  | 同前述150017 | 工具包功能需求-外观设计-设计外观整体性要考虑与主体两个台车搭配 | / | / | / | / | / | / | / | /
 |  | 同前述150018 | 工具包功能需求-外观设计-器械抛光 | / | / | / | / | / | / | / | /
 |  | 同前述150019 | 工具包功能需求-材料要求-医用级别材料 | / | / | / | / | / | / | / | /
 |  | 同前述150020 | 工具包功能需求-文字-商标、logo、产品信息 | / | / | / | / | / | / | / | /
UR0903 | 提供手术定位的装置，用于通道定位 | 同前述150005 | 工具包功能需求-设备组成-转接法兰 | / | / | / | / | / | / | / | /
 |  | 150007 | 工具包功能需求-设备组成-套筒 | 《MS-001工具包结构概要设计说明书》1.1章节产品功能需求 | 《MS-001工具包结构详细设计说明书》 | MS001-C.01.002JS.1.1 MS001-C短套筒Φ2.0 MS001-C.01.003JS.1.1 MS001-C短套筒Φ3.0 | MS-001工具包套筒使用次数试验报告 | 《系统整机验证报告》 | 生物相容性测试报告 | 《可用性确认报告》 MS-001猪脊骨试验报告 MS-001模型试验报告 MS-001临床预试验报告 MS-001尸体试验报告 | R78
 |  | 150012 | 工具包功能需求-结构设计-套筒内径应适配不同规格的手术工具（克氏针、施氏针） | 《MS-001工具包结构概要设计说明书》1.1章节产品功能需求 | 《MS-001工具包结构详细设计说明书》 | MS001-C.01.002JS.1.1 MS001-C短套筒Φ2.0 MS001-C.01.003JS.1.1 MS001-C短套筒Φ3.0 | / | 《系统整机验证报告》 | 生物相容性测试报告 | 《可用性确认报告》 MS-001猪脊骨试验报告 MS-001模型试验报告 MS-001临床预试验报告 MS-001尸体试验报告 | R78
 |  | 150013 | 工具包功能需求-结构设计-套筒外径与通道配合时控制公差 | 《MS-001工具包结构概要设计说明书》1.1章节产品功能需求 | 《MS-001工具包结构详细设计说明书》 | MS001-C.01.002JS.1.1 MS001-C短套筒Φ2.0 MS001-C.01.003JS.1.1 MS001-C短套筒Φ3.0 | / | 《系统整机验证报告》 | 生物相容性测试报告 | 《可用性确认报告》 MS-001猪脊骨试验报告 MS-001模型试验报告 MS-001临床预试验报告 MS-001尸体试验报告 | /
 |  | 150014 | 工具包功能需求-结构设计-套筒材质选用医用不锈钢材质 | 《MS-001工具包结构概要设计说明书》1.1章节产品功能需求 | 《MS-001工具包结构详细设计说明书》 | MS001-C.01.002JS.1.1 MS001-C短套筒Φ2.0 MS001-C.01.003JS.1.1 MS001-C短套筒Φ3.0 | / | 生物相容性测试报告 | 生物相容性测试报告 | 《可用性确认报告》 MS-001猪脊骨试验报告 MS-001模型试验报告 MS-001临床预试验报告 MS-001尸体试验报告 | R78
 |  | 150015 | 工具包功能需求-结构设计-套筒与前端器械设计消毒盒，用于医院消毒 | 《MS-001工具包结构概要设计说明书》1.1章节产品功能需求 | 《MS-001工具包结构详细设计说明书》 《MS-001关键零部件选型报告》-5.手术定位器材料选型 《MS-001关键零部件选型报告》-6.配准板材料选型 | MS001-C.01.002JS.1.1 MS001-C短套筒Φ2.0 MS001-C.01.003JS.1.1 MS001-C短套筒Φ3.0 | MS-001工具包套筒使用次数试验报告 | 工具包及选配包消毒灭菌指南 | 工具包及选配包消毒灭菌指南 | 《可用性确认报告》 MS-001猪脊骨试验报告 MS-001模型试验报告 MS-001临床预试验报告 MS-001尸体试验报告 | R3、R5、R6、R50
 |  | 同前述150016 | 工具包功能需求-外观设计-良好的耐磨性以及抗划伤性、外观污渍好清理、外观强度可靠 | / | / | / | / | / | / | / | /
 |  | 同前述150017 | 工具包功能需求-外观设计-设计外观整体性要考虑与主体两个台车搭配 | / | / | / | / | / | / | / | /
 |  | 同前述150018 | 工具包功能需求-外观设计-器械抛光 | / | / | / | / | / | / | / | /
 |  | 同前述150019 | 工具包功能需求-材料要求-医用级别材料 | / | / | / | / | / | / | / | /
 |  | 同前述150020 | 工具包功能需求-文字-商标、logo、产品信息 | / | / | / | / | / | / | / | /
UR1000 | 本产品需要可以与C臂机联合使用 | 《产品技术需求说明书》2.3章节"产品定位" | 与普通C形臂X光机配合使用。 | / | / | / | / | 《C臂机联合使用验证方案》 《C臂机联合使用验证报告》、 《MS-001规划软件系统测试报告》、 《MS-001导引软件系统测试报告》 | 《C臂机联合使用验证报告》、 《MS-001规划软件系统测试报告》、 《MS-001导引软件系统测试报告》 | 《可用性确认报告》 MS-001猪脊骨试验报告 MS-001模型试验报告 MS-001临床预试验报告 MS-001尸体试验报告 | R36、R147
UR1000 | 本产品需要可以与C臂机联合使用 | 同前述040102 | 软件可以联合C臂机使用。 | / | / | / | / | / | / | / | /
UR1100 | 本产品的系统精度应该符合脊柱手术精度要求 | 000201 | 产品性能需求-02术中导引-三维定位精度：≤1.5mm | / | / | / | 《导引软件单元测试报告》 | 《导引软件系统测试用例》-性能 | 《MS-001导引软件系统测试报告》 | 《可用性确认报告》 MS-001猪脊骨试验报告 MS-001模型试验报告 MS-001临床预试验报告 MS-001尸体试验报告 | /
 |  | 000202 | 产品性能需求-02术中导引-三维定位角度：≤1º | / | / | / | 《导引软件单元测试报告》 | 《导引软件系统测试用例》-性能 | 《MS-002导引软件系统测试报告》 | 《可用性确认报告》 MS-001猪脊骨试验报告 MS-001模型试验报告 MS-001临床预试验报告 MS-001尸体试验报告 | /
UR1200 | 本产品应能实现快速定位 | 000203 | 产品性能需求-02术中导引-正、侧位手眼标定所用时间应≤10秒（点击校准至弹出确认图片） | 《导引软件概要设计说明书》8.4.1 | 《导引软件详细设计说明书》3.3 | 导引软件-校准-Registration、 导引软件-校准-Process | B-UT0101001、 B-UT0101007、 | 《导引软件系统测试用例》-校准 《导引软件系统测试用例》-性能 | 《MS-003导引软件系统测试报告》 | 《可用性确认报告》 MS-001猪脊骨试验报告 MS-001模型试验报告 MS-001临床预试验报告 MS-001尸体试验报告 | /
 |  | 000204 | 产品性能需求-02术中导引-仿真计算时间应≤3秒（点击姿态仿真至模型开始运动前） | 《导引软件概要设计说明书》8.4.1 | 《导引软件详细设计说明书》5.3 | 导引软件-仿真-FindTrees、 导引软件-仿真-JudgeReach | B-UT0301006、 B-UT0301010 | 《导引软件系统测试用例》-性能 | 《MS-004导引软件系统测试报告》 | 《可用性确认报告》 MS-001猪脊骨试验报告 MS-001模型试验报告 MS-001临床预试验报告 MS-001尸体试验报告 | /
 |  | 000205 （同前述） | 产品性能需求-02术中导引-定位时间：≤10秒（同前述000205） | / | / | / | / | / | / | / | /
UR1300 | 本产品的用户人群应为骨科手术医生 | 《产品技术需求说明书》2.4章节"使用人群" | 2.4使用人群 | / | / | 整机 | / | 《系统整机验证报告》 | 《可用性验证报告》 | 《可用性确认报告》 MS-001猪脊骨试验报告 MS-001模型试验报告 MS-001临床预试验报告 MS-001尸体试验报告 | R28
UR1400 | 本产品的使用场景应为手术室 | 120001（同前述120001） | 规划台车功能需求-使用环境-手术室（同前述120001） | / | / | / | / | / | / | / | /
 |  | 130001（同前述130001） | 导引台车功能需求-使用环境-手术室（同前述130001） | / | / | / | / | / | / | / | /
 |  | 140001（同前述140001） | 体位反馈功能需求-使用环境-手术室（同前述120001） | / | / | / | / | / | / | / | /
 |  | 150001 | 工具包功能需求-使用环境-手术室 | 《MS-001工具包结构概要设计说明书》1.1章节产品功能需求 | 《MS-001工具包结构详细设计说明书》 | MS001-C.01.001ZZ.1.1 工具包 | / | 《系统整机验证报告》 | 《可用性验证报告》 | 《可用性确认报告》 MS-001猪脊骨试验报告 MS-001模型试验报告 MS-001临床预试验报告 MS-001尸体试验报告 | /
/ | / | 160001 | 操作设备为鼠标、键盘 | / | / | 关键元件选型 接线图 | / | 《系统整机验证报告》 | 《可用性验证报告》 | 《可用性确认报告》 MS-001猪脊骨试验报告 MS-001模型试验报告 MS-001临床预试验报告 MS-001尸体试验报告 | /
/ | / | 160002 | 符合常用办公软件等的操作习惯，包括鼠标滚轮，中键、左右键的操作 | / | / | 整机 | / | 《系统整机验证报告》 | 《可用性验证报告》 | 《可用性确认报告》 MS-001猪脊骨试验报告 MS-001模型试验报告 MS-001临床预试验报告 MS-001尸体试验报告 | /
/ | / | 160003 | 界面文字统一，不允许出现中、英文混搭的现象 | 《规划软件概要设计说明书》8.7.1 | / | 软件编码 | 《规划软件单元测试报告》 | 《规划软件系统测试用例》-登录 《规划软件系统测试用例》-辅助模块选择 《规划软件系统测试用例》-数据管理 《规划软件系统测试用例》-CT分区 《规划软件系统测试用例》-手术规划 《规划软件系统测试用例》--切割复位 《规划软件系统测试用例》-X-Ray分区 《规划软件系统测试用例》-图像配准 《规划软件系统测试用例》-定位 《规划软件系统测试用例》-帮助 | 《MS-001规划软件系统测试报告》 | 《可用性确认报告》 MS-001猪脊骨试验报告 MS-001模型试验报告 MS-001临床预试验报告 MS-001尸体试验报告 | /
/ | / | 160003 | 界面文字统一，不允许出现中、英文混搭的现象 | 《导引软件概要设计说明书》8.7.1 | / | 软件编码 | 《导引软件单元测试报告》 | 《导引软件系统测试用例》-登录 《导引软件系统测试用例》-校准 《导引软件系统测试用例》-定位 《导引软件系统测试用例》-帮助 | 《MS-001导引软件系统测试报告》 | 《可用性确认报告》 MS-001猪脊骨试验报告 MS-001模型试验报告 MS-001临床预试验报告 MS-001尸体试验报告 | /
/ | / | 160004 | 可预见错误：处理方法由用户在流程中定义错误的出路来处理 | 《规划软件概要设计说明书》8.8.1 | 《规划软件详细设计说明书》3至18章节 | 登录-on_pButton_login_clicked、 登录-getUserInfo、 登录-getDBPassword、 登录-initUI、 数据管理-initPatientList、 数据管理-updatePatientList、 数据管理-dataRowClicked、 数据管理-dataRowDoubleClicked、 数据管理-receiveSearchClicked、 数据管理-receiveClearClicked、 数据管理-initPatientListWithParam、 数据管理-StartImport、 选择-initItemWidget、 选择-loadSingleModel、 规划-initVolumeProperty、 规划-initVolume、 规划-initItkData、 X-Ray分区-InitView、 X-Ray分区-View2D、 X-Ray分区-Init2DView、 X-Ray分区-InitLabels、 CT分区-View3D、 CT分区-Initial、 CT分区-InitData、 CT分区-InitView、 切割复位-ShowCone、 网络-ReceiveFrontalImage、 切割复位-ReadOtherModularData、 切割复位-UpdateCameraParam、 切割复位-ReadSelfModularData、 定位-RestInterface、 日志记录-initUITest、 日志导出-ui_Test、 网络-InitConnect、 配置-initParam、 配置-readConfig、 系统退出-closeEvent、 软件信息-on_pButton_other_system_clicked | A-UT0201001、 A-UT0202002、 A-UT0202007、 A-UT0504001、 A-UT0504002、 A-UT0504003、 A-UT0504004、 A-UT0504005、 A-UT0504006、 A-UT0504007、 A-UT0504008、 A-UT0505003、 A-UT0603003、 A-UT0604002、 A-UT0604006、 A-UT0604010、 A-UT0604013、 A-UT0701002 、 A-UT0801001、 A-UT0801004、 A-UT0801008、 A-UT0801009、 A-UT0806003、 A-UT0807008、 A-UT0807011、 A-UT0810001、 A-UT0901001、 A-UT0901002、 A-UT0901003、 A-UT0901004、 A-UT0901005、 A-UT1002016、 A-UT1001005、 A-UT1002032、 A-UT1101001、 A-UT1101006、 A-UT1101010、 A-UT1301001、 A-UT1301004、 A-UT1302001、 A-UT1302004、 A-UT1301001、 A-UT1301004、 A-UT1302001、 A-UT1302004、 A-UT1601003、 A-UT1601004 | 《规划软件系统测试用例》-登录 《规划软件系统测试用例》-数据管理 《规划软件系统测试用例》-切割复位 《规划软件系统测试用例》-CT分区 《规划软件系统测试用例》-手术规划 《规划软件系统测试用例》-X-Ray分区 《规划软件系统测试用例》-图像配准 | 《MS-001规划软件系统测试报告》 | 《可用性确认报告》 MS-001猪脊骨试验报告 MS-001模型试验报告 MS-001临床预试验报告 MS-001尸体试验报告 | /
/ | / | 160004 | 可预见错误：处理方法由用户在流程中定义错误的出路来处理 | 《导引软件概要设计说明书》8.8.1 | 《导引软件详细设计说明书》3至13章 | 登录-StartProgram、 注册-generateLicense、 注册-IsValid、 校准-InitToolSelectView、 校准-LoadToolInformation、 机械臂控制-Move、 定位-Move、 定位-InitArmJointView、 定位-InitView、 网络-CalibrateImage、 仿真-SetStartEndPoint、 仿真-FindTrees、 仿真-JudgeReach、 仿真-ReplanPath、 软件信息-getSoftInVersion、 配置-initNetworkReg、 配置-ShowEvent、 配置-ReadIniSettings、 系统退出-invokeSystemExit | B-UT1003010、 B-UT0902002、 B-UT0902003、 B-UT0612004、 B-UT0612005、 B-UT1101001、 B-UT1103006、 B-UT1101001、 B-UT1103006、 B-UT1101003、 B-UT1102005、 B-UT0102003、 B-UT0301001、 B-UT0301006、 B-UT0301010、 B-UT0301015、 B-UT0501001、 B-UT0801001、 B-UT0601001、 B-UT0607001、 B-UT0607002 | 《导引软件系统测试用例》-登录 《导引软件系统测试用例》-校准 《导引软件系统测试用例》-定位 《导引软件系统测试用例》-辅助设备 《导引软件系统测试用例》-帮助 《导引软件系统测试用例》-其他 | 《MS-001导引软件系统测试报告》 | 《可用性确认报告》 MS-001猪脊骨试验报告 MS-001模型试验报告 MS-001临床预试验报告 MS-001尸体试验报告 | /
/ | / | 160005 | 不可预见错误：处理方法为通过日志记录、异常跟踪来处理 | 《规划软件概要设计说明书》8.10.1 | 《规划软件详细设计说明书》16章节 | 日志记录-Logger、 日志导出-ExportSessionData | A-UT1401002、 A-UT1501004 | 《规划软件系统测试用例》-帮助 | 《MS-001规划软件系统测试报告》 | 《可用性确认报告》 MS-001猪脊骨试验报告 MS-001模型试验报告 MS-001临床预试验报告 MS-001尸体试验报告 | /
/ | / | 160005 | 不可预见错误：处理方法为通过日志记录、异常跟踪来处理 | 《导引软件概要设计说明书》8.10.1 | 《导引软件详细设计说明书》9章节 | 日志-WriteMilestoneLogInfo、 日志-WriteMilestoneLogWarn、 日志-WriteMilestoneLogError、 日志-MilestoneLogEndLog、 日志-WritLogInfo、 日志-WriteLogWarning、 日志-WriteLogError、 日志-EndLog | B-UT0701001、 B-UT0701002、 B-UT0701003、 B-UT0701004、 B-UT0702001、 B-UT0702002、 B-UT0702003、 B-UT0702004、 | 《导引软件系统测试用例》-校准 《导引软件系统测试用例》-帮助 | 《MS-001导引软件系统测试报告》 | 《可用性确认报告》 MS-001猪脊骨试验报告 MS-001模型试验报告 MS-001临床预试验报告 MS-001尸体试验报告 | /
/ | / | 160006 | 提供注册机制，根据本地信息产生序列号，用于基本的注册。防止用户任意复制后使用 | 《规划软件概要设计说明书》8.6.1、8.11.1 | 《规划软件详细设计说明书》3 | 注册-verifyCrc、 注册-generateLicense、 注册-IsValid | A-UT0201003、 A-UT0902002、 A-UT0902003 | 《规划软件系统测试用例》-帮助 | 《MS-001规划软件系统测试报告》 | 《可用性确认报告》 MS-001猪脊骨试验报告 MS-001模型试验报告 MS-001临床预试验报告 MS-001尸体试验报告 | /
/ | / | 160006 | 提供注册机制，根据本地信息产生序列号，用于基本的注册。防止用户任意复制后使用 | 《导引软件概要设计说明书》8.6.1、8.11.1 | 《导引软件详细设计说明书》11章节 | 注册-generateLicense、 注册-IsValid | B-UT0902002、 B-UT0902003 | 《导引软件系统测试用例》-帮助 | 《MS-001导引软件系统测试报告》 | 《可用性确认报告》 MS-001猪脊骨试验报告 MS-001模型试验报告 MS-001临床预试验报告 MS-001尸体试验报告 | /
/ | / | 160007 | 需口令才能登录，运行登录后修改口令 | 《规划软件概要设计说明书》8.5.1 | 《规划软件详细设计说明书》4 | 登录-on_pButton_login_clicked、 登录-getUserInfo、 登录-getDBPassword、 | A-UT0201001、 A-UT0202002、 A-UT0202007 | 《规划软件系统测试用例》-登录 | 《MS-001规划软件系统测试报告》 | 《可用性确认报告》 MS-001猪脊骨试验报告 MS-001模型试验报告 MS-001临床预试验报告 MS-001尸体试验报告 | /
/ | / | 160007 | 需口令才能登录，运行登录后修改口令 | 《导引软件概要设计说明书》8.5.1 | 《导引软件详细设计说明书》6章节 | 登录-Login、 登录-GetPassword、 登录-GetLogin、 登录-GetUserInfo | B-UT0401001、 B-UT0401004、 B-UT0401006、 B-UT0401015 | 《导引软件系统测试用例》-登录 | 《MS-001导引软件系统测试报告》 | 《可用性确认报告》 MS-001猪脊骨试验报告 MS-001模型试验报告 MS-001临床预试验报告 MS-001尸体试验报告 | /
/ | / | 160008 | 重建150MB尺寸单个DICOM序列，所用时间应当小于等于10秒 | 《规划软件概要设计说明书》8.4.1 | 《规划软件详细设计说明书》12.3 | 配准-InitView | A-UT0701002 | 《规划软件系统测试用例》-性能 | 《MS-001规划软件系统测试报告》 | 《可用性确认报告》 MS-001猪脊骨试验报告 MS-001模型试验报告 MS-001临床预试验报告 MS-001尸体试验报告 | /
/ | / | 160009 | 正侧位手眼标定所用时间应当小于等于10秒 | 《导引软件概要设计说明书》8.4.1 | 《导引软件详细设计说明书》3.3 | 注册-FindTrees、 注册-JudgeReach | B-UT0301006、 B-UT0301010 | 《导引软件系统测试用例》-性能 | 《MS-001导引软件系统测试报告》 | 《可用性确认报告》 MS-001猪脊骨试验报告 MS-001模型试验报告 MS-001临床预试验报告 MS-001尸体试验报告 | /
/ | / | 160010 | 仿真计算时间应当小于等于3秒 | 《导引软件概要设计说明书》8.4.1 | 《导引软件详细设计说明书》5.3 | 网络-FindTrees、 网络-JudgeReach | B-UT0301006、 B-UT0301010 | 《导引软件系统测试用例》-性能 | 《MS-001导引软件系统测试报告》 | 《可用性确认报告》 MS-001猪脊骨试验报告 MS-001模型试验报告 MS-001临床预试验报告 MS-001尸体试验报告 | /
/ | / | 160011 | 过日志记录关键操作及关键结果，记录异常、警告 | 《规划软件概要设计说明书》8.10.1 | 《规划软件详细设计说明书》16章节 | 日志记录-Logger、 日志导出-ExportSessionData | A-UT1401002、 A-UT1501004 | 《规划软件系统测试用例》-帮助 | 《MS-001规划软件系统测试报告》 | 《可用性确认报告》 MS-001猪脊骨试验报告 MS-001模型试验报告 MS-001临床预试验报告 MS-001尸体试验报告 | /
/ | / | 160011 | 过日志记录关键操作及关键结果，记录异常、警告 | 《导引软件概要设计说明书》8.10.1 | 《导引软件详细设计说明书》9章节 | 日志-WriteMilestoneLogInfo、 日志-WriteMilestoneLogWarn、 日志-WriteMilestoneLogError、 日志-MilestoneLogEndLog、 日志-WritLogInfo、 日志-WriteLogWarning、 日志-WriteLogError、 日志-EndLog | B-UT0701001、 B-UT0701002、 B-UT0701003、 B-UT0701004、 B-UT0702001、 B-UT0702002、 B-UT0702003、 B-UT0702004 | 《导引软件系统测试用例》-帮助 《导引软件系统测试用例》-校准 | 《MS-001导引软件系统测试报告》 | 《可用性确认报告》 MS-001猪脊骨试验报告 MS-001模型试验报告 MS-001临床预试验报告 MS-001尸体试验报告 | /
/ | / | 170101 | 非功能需求-标识标签-标签、铭牌需要用工具或用较大的力才能取下； | 《MS-001导引模块结构概要设计说明书》1.2章节产品非功能需求 《MS-001工具包结构概要设计说明书》1.2章节产品非功能需求 《MS-001规划模块结构概要设计说明书》1.2章节产品非功能需求； 《MS-001体位反馈模块结构概要设计说明书》1.2章节产品非功能需求 | MS-001规划模块包装及标签方案 MS-001导引模块包装及标签方案 MS-001工具包包装及标签方案 MS-001体位反馈模块包装及标签方案 | MS001.01.010BQ.1.0 MS-001标签MS001.01.011SM.1.0 包装印刷说明书 | / | 《系统整机验证报告》 | 《系统整机验证报告》 | 《可用性确认报告》 MS-001猪脊骨试验报告 MS-001模型试验报告 MS-001临床预试验报告 MS-001尸体试验报告 | /
/ | / | 170102 | 非功能需求-标识标签-必须标记生产商的名字或商标标记； | 《MS-001导引模块结构概要设计说明书》1.2章节产品非功能需求 《MS-001工具包结构概要设计说明书》1.2章节产品非功能需求 《MS-001规划模块结构概要设计说明书》1.2章节产品非功能需求； 《MS-001体位反馈模块结构概要设计说明书》1.2章节产品非功能需求 | MS-001规划模块包装及标签方案 MS-001导引模块包装及标签方案 MS-001工具包包装及标签方案 MS-001体位反馈模块包装及标签方案 | MS001.01.010BQ.1.0 MS-001标签MS001.01.011SM.1.0 包装印刷说明书 | / | 《系统整机验证报告》 | 《系统整机验证报告》 | 《可用性确认报告》 MS-001猪脊骨试验报告 MS-001模型试验报告 MS-001临床预试验报告 MS-001尸体试验报告 | R12
/ | / | 170103 | 非功能需求-标识标签-用于警告性说明，指导性说明标识，应贴在显著的位置； | 《MS-001导引模块结构概要设计说明书》1.2章节产品非功能需求 《MS-001工具包结构概要设计说明书》1.2章节产品非功能需求 《MS-001规划模块结构概要设计说明书》1.2章节产品非功能需求； 《MS-001体位反馈模块结构概要设计说明书》1.2章节产品非功能需求 | MS-001规划模块包装及标签方案 MS-001导引模块包装及标签方案 MS-001工具包包装及标签方案 MS-001体位反馈模块包装及标签方案 | MS001.01.010BQ.1.0 MS-001标签MS001.01.011SM.1.0 包装印刷说明书 | / | 《系统整机验证报告》 | 《系统整机验证报告》 | 《可用性确认报告》 MS-001猪脊骨试验报告 MS-001模型试验报告 MS-001临床预试验报告 MS-001尸体试验报告 | R12
/ | / | 170104 | 非功能需求-标识标签-固定设备的标签安装在正常使用位置时能看清； | 《MS-001导引模块结构概要设计说明书》1.2章节产品非功能需求 《MS-001工具包结构概要设计说明书》1.2章节产品非功能需求 《MS-001规划模块结构概要设计说明书》1.2章节产品非功能需求 | MS-001规划模块包装及标签方案 MS-001导引模块包装及标签方案 MS-001工具包包装及标签方案 | MS001.01.010BQ.1.0 MS-001标签MS001.01.011SM.1.0 包装印刷说明书 | / | 《系统整机验证报告》 | 《系统整机验证报告》 | 《可用性确认报告》 MS-001猪脊骨试验报告 MS-001模型试验报告 MS-001临床预试验报告 MS-001尸体试验报告 | /
/ | / | 170105 | 非功能需求-标识标签-设备的连接接口应该有标识； | 《MS-001导引模块结构概要设计说明书》1.2章节产品非功能需求 《MS-001工具包结构概要设计说明书》1.2章节产品非功能需求 《MS-001规划模块结构概要设计说明书》1.2章节产品非功能需求 | MS-001规划模块包装及标签方案 MS-001导引模块包装及标签方案 MS-001工具包包装及标签方案 | MS001.01.010BQ.1.0 MS-001标签MS001.01.011SM.1.0 包装印刷说明书 | / | 《系统整机验证报告》 | 《系统整机验证报告》 | 《可用性确认报告》 MS-001猪脊骨试验报告 MS-001模型试验报告 MS-001临床预试验报告 MS-001尸体试验报告 | /
/ | / | 170106 | 非功能需求-标识标签-与电源的连接需标明相关信息； | 《嵌入式硬件概要设计说明书》2.1章节功能需求与实现 《MS-001导引模块结构概要设计说明书》1.2章节产品非功能需求 《MS-001规划模块结构概要设计说明书》1.2章节产品非功能需求 | 《MS-001嵌入式硬件详细设计说明书》2.1章节 MS-001规划模块包装及标签方案 MS-001导引模块包装及标签方案 | MS001.01.010BQ.1.0 MS-001标签MS001.01.011SM.1.0 包装印刷说明书 | / | 《系统整机验证报告》 | 《系统整机验证报告》 | 《可用性确认报告》 MS-001猪脊骨试验报告 MS-001模型试验报告 MS-001临床预试验报告 MS-001尸体试验报告 | /
/ | / | 170107 | 非功能需求-标识标签-如有应用部分，应用部分应标记电击防护程度分类等相关符号； | 《嵌入式硬件概要设计说明书》2.1章节功能需求与实现 《MS-001导引模块结构概要设计说明书》1.2章节产品非功能需求 《MS-001规划模块结构概要设计说明书》1.2章节产品非功能需求 | 《MS-001嵌入式硬件详细设计说明书》2.1章节 MS-001规划模块包装及标签方案 MS-001导引模块包装及标签方案 | MS001.01.010BQ.1.0 MS-001标签MS001.01.011SM.1.0 包装印刷说明书 | / | 《系统整机验证报告》 | 《系统整机验证报告》 | 《可用性确认报告》 MS-001猪脊骨试验报告 MS-001模型试验报告 MS-001临床预试验报告 MS-001尸体试验报告 | /
/ | / | 170108 | 非功能需求-标识标签-安全符号和警告性的标识应有对能造成生理效应的危险适当标记，如激光； | 《嵌入式硬件概要设计说明书》2.1章节功能需求与实现 《MS-001导引模块结构概要设计说明书》1.2章节产品非功能需求 《MS-001工具包结构概要设计说明书》1.2章节产品非功能需求 《MS-001规划模块结构概要设计说明书》1.2章节产品非功能需求； 《MS-001体位反馈模块结构概要设计说明书》1.2章节产品非功能需求 | 《MS-001嵌入式硬件详细设计说明书》2.1章节 MS-001规划模块包装及标签方案 MS-001导引模块包装及标签方案 MS-001工具包包装及标签方案 MS-001体位反馈模块包装及标签方案 | MS001.01.010BQ.1.0 MS-001标签MS001.01.011SM.1.0 包装印刷说明书 | / | 《系统整机验证报告》 | 《系统整机验证报告》 | 《可用性确认报告》 MS-001猪脊骨试验报告 MS-001模型试验报告 MS-001临床预试验报告 MS-001尸体试验报告 | /
/ | / | 170109 | 非功能需求-标识标签-熔断器，温度保护开关和热流保护开关：在其附近标上型号、额定值，在随附文件中给出参考标记。 | 《嵌入式硬件概要设计说明书》2.1章节功能需求与实现 《MS-001导引模块结构概要设计说明书》1.2章节产品非功能需求 《MS-001规划模块结构概要设计说明书》1.2章节产品非功能需求 | 《MS-001嵌入式硬件详细设计说明书》2.1章节 MS-001规划模块包装及标签方案 MS-001导引模块包装及标签方案 | MS001.01.010BQ.1.0 MS-001标签MS001.01.011SM.1.0 包装印刷说明书 | / | 《系统整机验证报告》 | 《系统整机验证报告》 | 《可用性确认报告》 MS-001猪脊骨试验报告 MS-001模型试验报告 MS-001临床预试验报告 MS-001尸体试验报告 | /
/ | / | 170110 | 非功能需求-标识标签-电源端子：在其附近标记出电源要求。 | 《嵌入式硬件概要设计说明书》2.1章节功能需求与实现 《MS-001规划模块结构概要设计说明书》1.2章节产品非功能需求 | 《MS-001嵌入式硬件详细设计说明书》2.1章节 | MS001.01.010BQ.1.0 MS-001标签MS001.01.011SM.1.0 包装印刷说明书 | / | 《系统整机验证报告》 | 《系统整机验证报告》 | 《可用性确认报告》 MS-001猪脊骨试验报告 MS-001模型试验报告 MS-001临床预试验报告 MS-001尸体试验报告 | /
/ | / | 170111 | 非功能需求-标识标签-导线：应标记导线的图号/线号/颜色/功能。 | 《嵌入式硬件概要设计说明书》2.1章节功能需求与实现 | 《MS-001嵌入式硬件详细设计说明书》2.1章节 | / | / | 《系统整机验证报告》 | 《系统整机验证报告》 | 《可用性确认报告》 MS-001猪脊骨试验报告 MS-001模型试验报告 MS-001临床预试验报告 MS-001尸体试验报告 | /
/ | / | 170112 | 非功能需求-标识标签-指示灯：应该明确定义指示灯的颜色及定义，并给出标示说明。 | 《嵌入式硬件概要设计说明书》2.1章节功能需求与实现 | 《MS-001嵌入式硬件详细设计说明书》2.1章节 | / | / | 《系统整机验证报告》 | 《系统整机验证报告》 | 《可用性确认报告》 MS-001猪脊骨试验报告 MS-001模型试验报告 MS-001临床预试验报告 MS-001尸体试验报告 | /
/ | / | 170401 | 非功能需求-机械安全-产品应该有防护装置或保护措施保证设备的安全。 | 《MS-001导引模块结构概要设计说明书》1.2章节产品非功能需求 《MS-001工具包结构概要设计说明书》1.2章节产品非功能需求 《MS-001规划模块结构概要设计说明书》1.2章节产品非功能需求 | MS-001规划模块包装及标签方案 MS-001导引模块包装及标签方案 MS-001工具包包装及标签方案 | MS001.01.010BQ.1.0 MS-001标签 | / | 《系统整机验证报告》 | 《系统整机验证报告》 | 《可用性确认报告》 MS-001猪脊骨试验报告 MS-001模型试验报告 MS-001临床预试验报告 MS-001尸体试验报告 | /
/ | / | 170402 | 非功能需求-机械安全-产品和零件表面不能有毛刺，锐角和锐边。 | 《MS-001导引模块结构概要设计说明书》1.2章节产品非功能需求 《MS-001工具包结构概要设计说明书》1.2章节产品非功能需求 《MS-001规划模块结构概要设计说明书》1.2章节产品非功能需求； 《MS-001体位反馈模块结构概要设计说明书》1.2章节产品非功能需求 | 《MS-001导引模块结构详细设计说明书》 《MS-001规划模块结构详细设计说明书》 《MS-001工具包结构详细设计说明书》 《MS-001体位反馈模块结构详细设计说明书》 | MS001.01.001ZZ.1.1模块化手术导引系统 | / | 《系统整机验证报告》 | 《系统整机验证报告》 | 《可用性确认报告》 MS-001猪脊骨试验报告 MS-001模型试验报告 MS-001临床预试验报告 MS-001尸体试验报告 | /
/ | / | 170403 | 非功能需求-机械安全-产品包括部件的任何调节孔盖及所有零件都应该有一定的刚度。 | 《MS-001导引模块结构概要设计说明书》1.2章节产品非功能需求 《MS-001工具包结构概要设计说明书》1.2章节产品非功能需求 《MS-001规划模块结构概要设计说明书》1.2章节产品非功能需求； 《MS-001体位反馈模块结构概要设计说明书》1.2章节产品非功能需求 | 《MS-001导引模块结构详细设计说明书》 《MS-001规划模块结构详细设计说明书》 《MS-001工具包结构详细设计说明书》 《MS-001体位反馈模块结构详细设计说明书》 《MS-001规划模块焊接框架应力分析》 《MS-001导引模块焊接框架应力分析》 《MS-001工具包定位器应力分析》 | MS001-A.02.001JX.1.1 MS001-A框架总成 MS001-B.03.001JX.1.1 MS001-B框架总成 | / | 《系统整机验证报告》 | 《系统整机验证报告》 | 《可用性确认报告》 MS-001猪脊骨试验报告 MS-001模型试验报告 MS-001临床预试验报告 MS-001尸体试验报告 | /
/ | / | 170404 | 非功能需求-机械安全-产品中用于支撑或固定患者的部件，应设计、制造成使身体损伤和固定件意外松动的危险应该减到最小。 | 《MS-001导引模块结构概要设计说明书》1.2章节产品非功能需求 《MS-001工具包结构概要设计说明书》1.2章节产品非功能需求 《MS-001规划模块结构概要设计说明书》1.2章节产品非功能需求 | 《MS-001导引模块结构详细设计说明书》 《MS-001规划模块结构详细设计说明书》 《MS-001工具包结构详细设计说明书》 | MS001-A.01.001ZZ.1.1规划模块 MS001-B.01.001ZZ.1.1 导引模块 MS001-C.01.001ZZ.1.1 工具包 | / | 《系统整机验证报告》 | 《系统整机验证报告》 | 《可用性确认报告》 MS-001猪脊骨试验报告 MS-001模型试验报告 MS-001临床预试验报告 MS-001尸体试验报告 | /
/ | / | 170405 | 非功能需求-机械安全-产品正常使用时，设备不能倾斜造成失衡。 | 《MS-001导引模块结构概要设计说明书》1.2章节产品非功能需求 《MS-001工具包结构概要设计说明书》1.2章节产品非功能需求 《MS-001规划模块结构概要设计说明书》1.2章节产品非功能需求 | 《MS-001导引模块结构详细设计说明书》 《MS-001规划模块结构详细设计说明书》 《MS-001工具包结构详细设计说明书》 | MS001-A.01.001ZZ.1.1规划模块 MS001-B.01.001ZZ.1.1 导引模块 MS001-C.01.001ZZ.1.1 工具包 | / | 《系统整机验证报告》 | 《系统整机验证报告》 | 《可用性确认报告》 MS-001猪脊骨试验报告 MS-001模型试验报告 MS-001临床预试验报告 MS-001尸体试验报告 | R64
/ | / | 170406 | 非功能需求-机械安全-无安全装置的悬挂系统载荷应不超过安全工作载荷；设计时应该考虑磨损、腐蚀等老化时的安全系数。 | 《MS-001导引模块结构概要设计说明书》1.2章节产品非功能需求 《MS-001工具包结构概要设计说明书》1.2章节产品非功能需求 《MS-001规划模块结构概要设计说明书》1.2章节产品非功能需求 | 《MS-001导引模块结构详细设计说明书》 《MS-001规划模块结构详细设计说明书》 《MS-001工具包结构详细设计说明书》 | MS001-A.01.001ZZ.1.1规划模块 MS001-B.01.001ZZ.1.1 导引模块 MS001-C.01.001ZZ.1.1 工具包 | / | 《系统整机验证报告》 | 《系统整机验证报告》 | 《可用性确认报告》 MS-001猪脊骨试验报告 MS-001模型试验报告 MS-001临床预试验报告 MS-001尸体试验报告 | /
/ | / | 170407 | 非功能需求-机械安全-产品的外壳要承受一定的按压测试。 | 《MS-001导引模块结构概要设计说明书》1.2章节产品非功能需求 《MS-001工具包结构概要设计说明书》1.2章节产品非功能需求 《MS-001规划模块结构概要设计说明书》1.2章节产品非功能需求； 《MS-001体位反馈模块结构概要设计说明书》1.2章节产品非功能需求 | 《MS-001导引模块结构详细设计说明书》 《MS-001规划模块结构详细设计说明书》 《MS-001工具包结构详细设计说明书》 《MS-001体位反馈模块结构详细设计说明书》 | MS001-A.01.001ZZ.1.1规划模块 MS001-B.01.001ZZ.1.1 导引模块 MS001-C.01.001ZZ.1.1 工具包 MS001-D.01.001ZZ.1.1 体位反馈模块 | / | 《系统整机验证报告》 | 《系统整机验证报告》 | 《可用性确认报告》 MS-001猪脊骨试验报告 MS-001模型试验报告 MS-001临床预试验报告 MS-001尸体试验报告 | R66
/ | / | 170408 | 非功能需求-机械安全-产品的外壳要承受一定的冲击力。 | 《MS-001导引模块结构概要设计说明书》1.2章节产品非功能需求 《MS-001工具包结构概要设计说明书》1.2章节产品非功能需求 《MS-001规划模块结构概要设计说明书》1.2章节产品非功能需求； 《MS-001体位反馈模块结构概要设计说明书》1.2章节产品非功能需求 | 《MS-001导引模块结构详细设计说明书》 《MS-001规划模块结构详细设计说明书》 《MS-001工具包结构详细设计说明书》 《MS-001体位反馈模块结构详细设计说明书》 《MS-001规划模块焊接框架应力分析》 《MS-001导引模块焊接框架应力分析》 《MS-001工具包定位器应力分析》 | MS001-A.03.001JX.1.1 MS001-A外观总成 MS001-B.04.001JX.1.1 MS001-B外观总成 | / | 《系统整机验证报告》 | 《系统整机验证报告》 | 《可用性确认报告》 MS-001猪脊骨试验报告 MS-001模型试验报告 MS-001临床预试验报告 MS-001尸体试验报告 | R66
/ | / | 170701 | 非功能需求-其他-如有激光类组件，应符合GB7247.1-2012《激光产品的安全 第1部分：设备分类、要求》的要求。 | 《嵌入式硬件概要设计说明书》2.1章节功能需求与实现； 《MS-001体位反馈模块结构概要设计说明书》1.2章节产品非功能需求 | 《MS-001嵌入式硬件详细设计说明书》2.1章节 | MS001-D.01.001ZZ.1.1 体位反馈模块 | / | 体位反馈模块稳定验证方案及报告 体位反馈模块有效性验证方案及报告 | 《系统整机验证报告》验证统计表6激光波长、7激光功率； 型检报告 | 《可用性确认报告》 MS-001猪脊骨试验报告 MS-001模型试验报告 MS-001临床预试验报告 MS-001尸体试验报告 | R4
/ | / | 170702 | 非功能需求-其他-如有脚踏开关组件，应符合YY1057-2016《医用脚踏开关通用技术条件》的要求。 | 《嵌入式硬件概要设计说明书》2.1章节功能需求与实现 | 《MS-001嵌入式硬件详细设计说明书》2.1章节 | MS001-B.06.001JX.1.1 MS001-B侧面板总成 | 《MS-001 脚踏开关单元测试方案》 《MS-001 脚踏开关单元测试报告》 | 《系统整机验证报告》 | 《系统整机验证报告》 | 《可用性确认报告》 MS-001猪脊骨试验报告 MS-001模型试验报告 MS-001临床预试验报告 MS-001尸体试验报告 | R37、R103

Sheet: 质量原模板
 | 可追溯性跟踪表
产品名称：模块化手术导引系统 |  |  |  |  | 产品型号：MS-001 |  |  |  | 编制人/日期：
文件号： |  |  |  |  | 文件版本号：V1.0 |  |  |  | 复核人/日期：
序号 | 用户需求 ID | 风险分析 | 技术需求 ID | 概要设计 文件及其章节号 | 详细设计 文件及其章节号 | 单元模块名称 |  | 验证与确认
 |  |  |  |  |  | 硬件 | 软件 | 单元测试 用例ID | 集成测试 用例ID | 系统测试 用例ID | 产品验证报告 | 用户测试 文件及其章节号
填写说明：1.风险分析中填写危险（源）标识；2.软件源代码追溯至软件单元（列明名称），填入单元模块-软件栏中。
