santan444/MS001/03-设计开发输出阶段/07风险管理/MS-001网络安全风险记录.xlsx

Sheet: 文档修改履历
模板修订履历
序号 | 版本号 | 发布/实施日期 | 更改内容概述 | 更改者
1 | V1.0 | 2021.04.20 | 文件新编 | 郭宏瑞 | 郭宏瑞 | 2021.04.20 | 童睿 | 2021.04.20 | 陈汉清 | 2021.04.21
 | V1.0更正版 | 2023.07.27 | 因2023.07体考整改，文件引用与被引用时间先后逻辑问题，重新签批。内容无修改 | 黄莹莹 |  |  | 郭宏瑞 | 2023.07.27 | 张巍 | 2023.07.27

Sheet: 风险可接受准则
潜在的伤害严重度等级(S)
等级名称 | 代号 | 定义
可忽略 | S1 | 不便或暂时不适
轻度 | S2 | 导致不要求专业医疗介入的暂时伤害或损伤
严重 | S3 | 导致要求专业医疗介入的伤害或损伤
危重的 | S4 | 导致永久性损伤或危及生命的伤害
灾难性的 | S5 | 导致患者死亡
危险发生概率(P)
等级名称 | 代号 | 概率范围 | 分析
非常少 | P1 | ﹤10-6 | 事件不可复制和/或无法在设备的指定操作条件下复制。由于缺乏明确的信息，或在调查后发现与一系列未经证实或不可信的操作员行为或事件有关，因此无法对此类事件进行适当调查。
很少 | P2 | ﹤10-5和≥10-6 | 在设备的特定操作条件下，在产品寿命期间，事件很少发生。这一概率与设备运行相关的不经常的、未预料到的结果有关，或与操作员操作或异常事件的多步骤序列有关。
偶然 | P3 | ﹤10-4和≥10-5 | 在产品寿命期间，在设备的特定操作条件下，偶尔会发生事件。这种概率与两个特定的连续或同时的操作员操作或事件，或大多数用户偶尔执行的功能有关。
有时 | P4 | ﹤10-3和≥10-4 | 在产品的寿命期内，在设备的特定操作条件下，事件可能会发生或多次发生。这种可能性与未预料到的结果有关，这些结果很可能发生在设备的正常使用中。
经常 | P5 | ≥10-3 | 事件不可复制和/或无法在设备的指定操作条件下复制。由于缺乏明确的信息，或在调查后发现与一系列未经证实或不可信的操作员行为或事件有关，因此无法对此类事件进行适当调查。
风险评价准则
A：可接受的风险；
R：合理可行降低(ALARP)的风险；
U：不经过风险/收益分析即判定为不可接受的风险。

Sheet: RAC
项目编号： |  | MS-001 |  | 产品名称： | 模块化手术导引系统 |  |  |  | 编制/日期：
风险分析 |  |  |  |  |  |  |  | 风险评估 |  |  | 风险控制
危险源序号 | 危险(源) |  | 详细描述 | 可预见的事件 |  | 危险情况 | 伤害 | 伤害等级S | 伤害概率P | 风险A/R/U | 风险控制选项 | 风险控制措施描述 | 验证实施：设计规范
规划软件
H1 | 使用错误危险 |  | 产品在无人值守期间阻止非授权用户访问和使用的能力。 | 非授权人员操作设备。 |  | 病人信息泄露。 | 泄露隐私信息 | S1 | P2 | A | 设计保证 | 设备自动休眠。 | 规划软件详细设计说明书 （MS001-A.03.001DD）
H2 | 功能危险 |  | 用户活动未二次确认。 | 导致操作风险。 |  | 引起误操作。 | 延误手术进程。 | S2 | P2 | R | 防护措施 | 用户确认后进行操作。 | 规划软件详细设计说明书 （MS001-A.03.001DD）
H3 | 使用错误危险 |  | 未授权用户使用设备。 | 非授权人员操作设备泄露信息。 |  | 病人信息泄露。 | 泄露隐私信息。 | S2 | P2 | R | 防护措施 | 账号权限管理。 | 规划软件详细设计说明书 （MS001-A.03.001DD）
H4 | 使用错误危险 |  | 产品的数据、硬件或软件受到损坏或破坏。 | 操作中断、数据丢失。 |  | 操作中断。 | 延误手术进程。 | S2 | P2 | R | 设计保证 | 数据保存，设备重启后可恢复至原始步骤。 | 规划软件详细设计说明书 （MS001-A.03.001DD）
H5 | 使用错误危险 |  | U盘导入的数据存在被更改的风险。 | 导入数据错误。 |  | 病人信息不准确。 | 延误手术进程。 | S3 | P2 | R | 设计保证 | 对CT的层数、层厚、连续性进行校验。 | 规划软件详细设计说明书 （MS001-A.03.001DD）
H6 | 功能危险 |  | 存在恶意软件侵入、破坏风险。 | 软件遭到破坏。 |  | 设备无法使用。 | 延误手术进程。 | S2 | P3 | R | 防护措施 | 系统防护。 | 规划软件详细设计说明书 （MS001-A.03.001DD）
H7 | 功能危险 |  | 不能保证正常通信。 | 操作中断、设备无法使用。 |  | 操作中断。 | 延误手术进程。 | S2 | P2 | R | 防护措施 | 内部通信协议 | 规划软件详细设计说明书 （MS001-A.03.001DD）
H8 | 使用错误危险 |  | 存在非授权人员操作和信息泄露。 | 非授权人员操作设备。 |  | 病人信息泄露。 | 泄露隐私信息。 | S1 | P2 | A | 防护措施 | 账号权限管理。 | 规划软件详细设计说明书 （MS001-A.03.001DD）
H9 | 使用错误危险 |  | 数据存储介质盗用、损坏。 | 工作站损坏、盗用。 |  | 数据丢失。 | 病人信息丢失。 | S2 | P2 | R | 设计保证 | 工作站置于台车内部不可拆卸。 | 规划软件详细设计说明书 （MS001-A.03.001DD）
H10 | 使用错误危险 |  | 用户对设备使用不当。 | 设备数据泄露或损坏。 |  | 病人信息泄露。 | 泄露隐私信息。 | S1 | P2 | A | 安全说明 | 加强人员培训 | /
H11 | 使用错误危险 |  | 数据存在非授权人员操作和信息泄露。 | 非授权人员操作设备。 |  | 病人信息泄露。 | 泄露隐私信息。 | S1 | P2 | A | 防护措施 | 数据加密存储。 | 规划软件详细设计说明书 （MS001-A.03.001DD）
H12 | 使用错误危险 |  | 数据传输中存在泄露风险。 | 非授权人员操作设备。 |  | 病人信息泄露。 | 泄露隐私信息。 | S1 | P2 | A | 防护措施 | 数据加密存储。 | 规划软件详细设计说明书 （MS001-A.03.001DD）
H13 | 功能危险 |  | 传输中存在数据不完整。 | 显示信息不完整。 |  | 信息缺失。 | 延误手术进程。 | S2 | P2 | R | 防护措施 | 数据加密、校验。 | 规划软件详细设计说明书 （MS001-A.03.001DD）
导引软件
H14 | 使用错误危险 |  | 产品在无人值守期间阻止非授权用户访问和使用的能力。 | 非授权人员操作设备。 |  | 病人信息泄露。 | 泄露隐私信息 | S1 | P2 | A | 设计保证 | 设备自动休眠。 | 导引软件详细设计说明书 （MS001-B.03.001DD）
H15 | 功能危险 |  | 用户活动未二次确认。 | 导致操作风险。 |  | 引起误操作。 | 延误手术进程。 | S2 | P2 | R | 防护措施 | 用户确认后进行操作。 | 导引软件详细设计说明书 （MS001-B.03.001DD）
H16 | 使用错误危险 |  | 未授权用户使用设备。 | 非授权人员操作设备泄露信息。 |  | 病人信息泄露。 | 泄露隐私信息。 | S2 | P2 | R | 防护措施 | 账号权限管理。 | 导引软件详细设计说明书 （MS001-B.03.001DD）
H17 | 使用错误危险 |  | 产品的数据、硬件或软件受到损坏或破坏。 | 操作中断、数据丢失。 |  | 操作中断。 | 延误手术进程。 | S2 | P2 | R | 设计保证 | 数据保存，设备重启后可恢复至原始步骤。 | 导引软件详细设计说明书 （MS001-B.03.001DD）
H18 | 功能危险 |  | 存在恶意软件侵入、破坏风险。 | 软件遭到破坏。 |  | 设备无法使用。 | 延误手术进程。 | S2 | P3 | R | 防护措施 | 系统防护。 | 导引软件详细设计说明书 （MS001-B.03.001DD）
H19 | 功能危险 |  | 不能保证正常通信。 | 操作中断、设备无法使用。 |  | 操作中断。 | 延误手术进程。 | S2 | P2 | R | 防护措施 | 提供DICOM协议 | 导引软件详细设计说明书 （MS001-B.03.001DD）
H20 | 使用错误危险 |  | 存在非授权人员操作和信息泄露。 | 非授权人员操作设备。 |  | 病人信息泄露。 | 泄露隐私信息。 | S1 | P2 | A | 防护措施 | 账号权限管理。 | 导引软件详细设计说明书 （MS001-B.03.001DD）
H21 | 使用错误危险 |  | 数据存储介质盗用、损坏。 | 工作站损坏、盗用。 |  | 数据丢失。 | 病人信息丢失。 | S2 | P2 | R | 设计保证 | 工作站置于台车内部不可拆卸。 | 导引软件详细设计说明书 （MS001-B.03.001DD）
H22 | 使用错误危险 |  | 用户对设备使用不当。 | 设备数据泄露或损坏。 |  | 病人信息泄露。 | 泄露隐私信息。 | S1 | P2 | A | 安全说明 | 加强人员培训 | 说明书（MS001.01.010SM）
H23 | 使用错误危险 |  | 数据传输中存在泄露风险。 | 非授权人员操作设备。 |  | 病人信息泄露。 | 泄露隐私信息。 | S1 | P2 | A | 防护措施 | 数据加密存储。 | 导引软件详细设计说明书 （MS001-B.03.001DD）
H24 | 功能危险 |  | 传输中存在数据不完整。 | 显示信息不完整。 |  | 信息缺失。 | 延误手术进程。 | S2 | P2 | R | 防护措施 | 数据加密、校验。 | 导引软件详细设计说明书 （MS001-B.03.001DD）

Sheet: 参考
能量危险（源）示例 | 生物学和化学危险（源）示例 | 操作危险（源）示例 | 信息危险（源）示例
电磁能 | 生物学的 | 功能 | 标记
线电压 | 细菌 | 不正确或不适当的输出或功能 | 不完整的使用说明书
漏电流 | 病毒 | 不正确的测量 | 性能特征的不适当的描述
——外壳漏电流 | 其他介质（例如：蛋白病毒） | 错误的测量 | 不适当的预期使用规范
——对地漏电流 | 再次或者交叉感染 | 功能的丧失或变坏 | 局限性未充分公示
——患者漏电流 | 化学的 | 使用错误 | 操作说明书
电场 | 气路、组织、环境或者财产暴露在外来物质中、例如： | 缺乏注意力 | 医疗器械所使用的的附件的规范不适当
磁场 | ——酸或碱 | 记忆力不良 | 使用前检查规范不适当
辐射能 | ——残留物 | 不遵守规则 | 过于复杂的操作说明
电离辐射 | ——污染物 | 缺乏知识 | 警告
非电离辐射 | ——添加剂或者加工助剂 | 违反常规 | 副作用
热能 | ——清洁剂、消毒剂或试验试剂 |  | 一次性使用医疗器械可能重复使用的危险（源）
高温 | ——降解产物 |  | 服务和使用的危险（源）
低温 | ——医用气体
机械能 | ——麻醉产品 |  | 服务和维护规范
重力 | 生物相容性
——坠落 | 化学成分毒性，例如：
——悬挂物 | ——致敏型/刺激
振动 | ——致热源
贮存的能量
运动零件
扭转力、剪切力和张力
患者的移动和定位
声能
——超声能量
——次声能量
——声音
高压液体注射
 |  |  |  | 参考YY/T 0316-2016 | 问题 | 考虑因素
 |  |  |  | C.2.1 | 医疗器械的预期用途是什么和怎样使用医疗器械？ | 医疗器械的作用：
 |  |  |  |  |  | 疾病的诊断、预防、监护、治疗或者缓解；
 |  |  |  |  |  | 伤害或残疾的补偿；
 |  |  |  |  |  | 解剖或生理过程的研究、替代或者补偿； 妊辰控制；
 |  |  |  |  |  | 使用要求（例如，患者人群）？
 |  |  |  |  |  | 设备用于维持生命或支撑生命？
 |  |  |  |  |  | 医疗器械故障时是否需要特殊干预？
 |  |  |  | C.2.2 | 医疗器械是否预期植入？ | 考虑：
 |  |  |  |  |  | 植入位置，患者人群的特征，年龄，体重，体力活动，老化对种植体性能的影响，种植体的预期寿命，植入的可逆性。
 |  |  |  | C.2.3 | 医疗器械是否预期和患者或其他人员接触？ | 预期的接触性质，即表面接触，侵入性接触或植入，以及接触的周期和频率。
 |  |  |  | C.2.4 | 在医疗器械中利用何种材料或组分，或与医疗器械共同使用或与其接触？ | 考虑：
 |  |  |  |  |  | 与相关物质的相容性；
 |  |  |  |  |  | 与组织或体液的相容性；
 |  |  |  |  |  | 是否值得与安全相关的特征？
 |  |  |  |  |  | 是否利用动物源材料？
 |  |  |  | C.2.5 | 是否有能量给予患者或从患者身上获取？ | 考虑：
 |  |  |  |  |  | 能量转移的类型；
 |  |  |  |  |  | 其控制、质量、数量、强度和持续时间；
 |  |  |  |  |  | 能量基本是否高于类似产品当前应用的能量水平。
 |  |  |  | C.2.6 | 是否有物质提供给患者或从患者身上提取？ | 考虑：
 |  |  |  |  |  | 物质是提供还是提取；无论是单一物质还是一系列物质；最大和最小传送率及其控制。
 |  |  |  | C.2.7 | 医疗器械是否处理生物材料用于随后的再次使用、输液/血或移植？ | 考虑：
 |  |  |  |  |  | 处理过程和物质的类型（例如，自动输血，透析，血液成分或细胞疗法处理）
 |  |  |  | C.2.8 | 医疗器械是否以无菌形式提供或预期由使用者灭菌，或用其它微生物学控制方法灭菌？ | 考虑：
 |  |  |  |  |  | 医疗装置是否预期一次性使用包装或重复使用包装；
 |  |  |  |  |  | 储存寿命；
 |  |  |  |  |  | 重复使用周期次数的限制；
 |  |  |  |  |  | 灭菌方式；
 |  |  |  |  |  | 制造商非预期灭菌方法的影响。
 |  |  |  | C.2.9 | 医疗器械是否预期由用户进行常规清洁和消毒？ | 考虑：
 |  |  |  |  |  | 使用的清洁剂或消毒剂的类型以及对清洁周期数的任何限制。
 |  |  |  |  |  | 医疗器械的设计会影响日常清洁和消毒的效果。
 |  |  |  |  |  | 应考虑清洁剂和消毒剂对装置的安全性或性能的影响。
 |  |  |  | C.2.10 | 医疗器械是否预期改善患者的环境？ | 考虑：
 |  |  |  |  |  | 温度； 湿度； 大气成分； 压力； 光线。
 |  |  |  | C.2.11 | 是否进行测量？ | 考虑：
 |  |  |  |  |  | 测量的变量以及测量结果的准确性和精度。
 |  |  |  | C.2.12 | 医疗器械是否进行分析处理？ | 考虑：
 |  |  |  |  |  | 医疗设备是否从输入数据或采集数据得出结论，使用的算法以及置信限度。 应特别注意数据或算法的非预期应用。
 |  |  |  | C.2.13 | 医疗器械是否预期和其它医疗器械、医药或其它医疗技术联合使用？ | 考虑：
 |  |  |  |  |  | 识别可能涉及的任何其他医疗装置，药物或其他医疗技术以及与这种相互作用相关的潜在问题以及患者对治疗的依从性。
 |  |  |  | C.2.14 | 是否有不希望的能量或物质输出？ | 能量相关考虑:
 |  |  |  |  |  | 噪声和振动，热量，辐射（包括电离，非电离和紫外/可见/红外辐射），接触温度，泄漏电流和电场或磁场。
 |  |  |  |  |  | 物质相关考虑：
 |  |  |  |  |  | 制造，清洁或测试中使用的物质，如果留在产品中，会产生不必要的生理影响。
 |  |  |  |  |  | 其他物质相关考虑：化学品，废物和体液的排放。
 |  |  |  | C.2.15 | 医疗器械是否对环境影响敏感？ | 考虑：
 |  |  |  |  |  | 操作、运输和存储环境。这些因素包括光照、温度、湿度、振动、溢出、对电源和冷却电源变化的敏感性，以及电磁干扰。
 |  |  |  | C.2.16 | 医疗器械是否影响环境？ | 考虑：
 |  |  |  |  |  | 对电力和冷却供应的影响；
 |  |  |  |  |  | 有毒物质的排放；
 |  |  |  |  |  | 电磁干扰的产生。
 |  |  |  | C.2.17 | 医疗器械是否有基本的消耗品或附件？ | 考虑：
 |  |  |  |  |  | 这些消耗品或附件的规格，以及在选择这些消耗品时对用户的任何限制。
 |  |  |  | C.2.18 | 是否需要维护和校准？ | 考虑：
 |  |  |  |  |  | 是否由操作者或用户或专家进行维护或校准；
 |  |  |  |  |  | 维护或校准需要特殊的物质或设备。
 |  |  |  | C.2.19 | 医疗器械是否有软件？ | 考虑：
 |  |  |  |  |  | 软件是否打算由操作员或用户或专家安装，验证，修改或交换。
 |  |  |  | C.2.20 | 医疗器械是否有存储寿命限制？ | 考虑：
 |  |  |  |  |  | 标签或标识，以及到期后此类医疗器械的处置。
 |  |  |  | C.2.21 | 是否有延时或长期使用效应？ | 考虑:
 |  |  |  |  |  | 人体工程学和累积效应。
 |  |  |  |  |  | 示例包括：
 |  |  |  |  |  | 随时间腐蚀的盐水泵，机械疲劳，皮带和附件松动，
 |  |  |  |  |  | 振动的影响，标签磨损或脱落，长期的材料退化。
 |  |  |  | C.2.22 | 医疗器械承受何种机械力？ | 考虑:
 |  |  |  |  |  | 医疗装置受到的力是受用户控制还是与他人的相互作用控制。
 |  |  |  | C.2.23 | 什么决定医疗器械的寿命？ | 考虑:
 |  |  |  |  |  | 老化和电池耗尽。
 |  |  |  | C.2.24 | 医疗器械是否预期一次性使用？ | 考虑:
 |  |  |  |  |  | 医疗器械使用后是否自毁？设备已被使用是否显而易见？
 |  |  |  | C.2.25 | 医疗器械是否需要安全的退出运行或处置？ | 考虑：
 |  |  |  |  |  | 处置医疗设备本身产生的废弃物。 例如，是否含有有毒或有害物质，物质是否可回收？
 |  |  |  | C.2.26 | 医疗器械的安装或使用是否需要专门的培训或专门的技能？ | 考虑：
 |  |  |  |  |  | 医疗设备的新颖性以及设备安装人员可能的技能和培训。
 |  |  |  | C.2.27 | 如何提供安全使用信息？ | 考虑：
 |  |  |  |  |  | 信息是由制造商直接提供给最终用户，还是涉及安装人员，护理人员，医疗保健专业人员或药剂师等第三方的参与，以及这是否会影响到培训；
 |  |  |  |  |  | 调试和交付给最终用户，以及是可以由没有必要技能的人员进行安装；
 |  |  |  |  |  | 基于设备的预期寿命，是否需要对操作员或服务人员进行再培训或重新认证。
 |  |  |  | C.2.28 | 是否需要建立或引入新的制造过程？ | 考虑:
 |  |  |  |  |  | 新技术或新的生产规模
 |  |  |  | C.2.29 | 医疗器械的成功使用，是否关键取决于人为因素，例如用户界面？
 |  |  |  | C.2.29.1 | 用户界面设计特性是否可能促成使用错误？ | 应考虑的因素是可能导致使用错误的用户界面设计。 界面设计的例子包括：控制和指示器，使用的符号，人机工程学特征，物理设计和布局，操作层次，软件驱动设备的菜单，警告的可见性，警报的可听性以及颜色编码的标准化。 有关可用性的更多指导，请参阅IEC 60601-1-6，有关警报的指导请参阅IEC 60601-1-8
 |  |  |  | C.2.29.2 | 医疗器械是否在因分散注意力而导致使用错误的环境中使用？ | 考虑：
 |  |  |  |  |  | 使用错误的后果；
 |  |  |  |  |  | 干扰是否来自公共场所；
 |  |  |  |  |  | 用户是否被偶发性事件干扰。
 |  |  |  | C.2.29.3 | 医疗器械是否有连接部分或附件？ | 考虑:
 |  |  |  |  |  | 错误连接的可能性，与其他产品连接的相似性，连接力，对连接完整性的反馈，过度和不足。
 |  |  |  | C.2.29.4 | 医疗器械是否有控制接口？ | 考虑:
 |  |  |  |  |  | 间隔，编码，分组，映射，反馈模式，失误，滑动，控制差异，可见性，激活或改变的方向，控制是连续的还是离散的，以及设置或动作的可逆性。
 |  |  |  | C.2.29.5 | 医疗器械是否显示信息？ | 考虑：
 |  |  |  |  |  | 各种环境中的可视性，方向，用户的视觉能力，人口和观点，所呈现信息的清晰度，单位，颜色编码以及关键信息的可访问性。
 |  |  |  | C.2.29.6 | 医疗器械是否由菜单控制？ | 考虑:
 |  |  |  |  |  | 复杂性和层数，状态意识，设置位置，导航方法，每个动作的步数，序列清晰度和记忆问题，控制功能相对于其可访问性的重要性以及偏离指定操作程序的影响。
 |  |  |  | C.2.29.7 | 医疗器械是否由具有特殊需要的人使用？ | 考虑:
 |  |  |  |  |  | 使用者，他们的精神和身体能力，技能和培训，人体工程学方面，使用环境，安装要求以及患者控制或影响医疗设备使用的能力。 应特别关注残疾人，老年人，儿童等有特殊需求的用户。 他们的特殊需求可能包括另一个人的帮助，以便使用医疗设备。 医疗器械是否打算供具有不同技术水平和文化背景的人使用？
 |  |  |  | C.2.29.8 | 用户界面能否用于启动使用者动作？ | 考虑：
 |  |  |  |  |  | 启动一个有意的动作以便用户进入受控操作模式的可能性，增加了患者的风险并且为用户提供了这种情况的意识。
 |  |  |  | C.2.30 | 医疗器械是否使用报警系统？ | 考虑:
 |  |  |  |  |  | 是否存在误报，漏报，断电报警系统，不可靠的远程报警系统，以及医务人员了解报警系统工作原理的可能性。 报警系统的指导在IEC 60601-1-8中给出。
 |  |  |  | C.2.31 | 医疗器械可能以什么方式被故意地误用？ | 考虑:
 |  |  |  |  |  | 连接器使用不正确，禁用安全功能或警报，忽视制造商推荐的维护。
 |  |  |  | C.2.32 | 医疗器械是否持有患者护理的关键数据？ | 考虑：
 |  |  |  |  |  | 数据被修改或损坏的后果。
 |  |  |  | C.2.33 | 医疗器械是否预期为移动式或便携式？ | 应该考虑的因素是必要的把手，手柄，车轮，制动器，机械稳定性和耐久性。
 |  |  |  | C.2.34 | 医疗器械的使用是否依赖于基本性能？ | 考虑：
 |  |  |  |  |  | 例如，生命支持设备的输出特性或警报的操作。有关性能的讨论，请参见GB 9706.1（IEC60601-1-1）
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
