santan444/MS001/03-设计开发输出阶段/07风险管理/MS-001风险评估和控制记录.xlsx

Sheet: 危险源
参考YY/T 0316-2016 | 问题 | 适用 | 详细描述 | 可能的危险（源） | 危险源标识 | 详细描述
 |  | 与否
C.2.1 | 医疗器械的预期用途是什么和怎样使用医疗器械？ | 适用 | 用于骨外科开放或经皮手术的导航定位。 | 机械能危险 | R1 | 定位过程中，机械臂失控或误操作
 |  |  |  | 功能危险 | R2 | 机械臂精度不准，或者配准误差过大
C.2.2 | 医疗器械是否预期植入？ | 否
C.2.3 | 医疗器械是否预期和患者或其他人员接触？ | 适用 |  | 生物学危险 | R50 | 套筒接触患者
C.2.4 | 在医疗器械中利用何种材料或组分，或与医疗器械共同使用或与其接触？ | 适用 | 与导针共同使用 | 化学危险 | R3 | 套筒磨损产生污染物
C.2.5 | 是否有能量给予患者或从患者身上获取? | 适用 | 激光能量给予患者 | 热能危险 | R4 | 激光功率过大
C.2.6 | 是否有物质提供给患者或从患者身上提取？ | 否
C.2.7 | 医疗器械是否处理生物材料用于随后的再次使用、输液/血或移植？ | 否
C.2.8 | 医疗器械是否以无菌形式提供或预期由使用者灭菌，或用其它微生物学控制方法灭菌？ | 适用 | 工具包需要医院进行高温和低温等离子灭菌 | 生物学危险 | R5 | 灭菌不彻底
C.2.9 | 医疗器械是否预期由用户进行常规清洁和消毒？ | 适用 | 医院进行常规清洁消毒 | 生物学危险 | R6 | 没有进行清洁消毒
C.2.10 | 医疗器械是否预期改善患者的环境? | 否
C.2.11 | 是否进行测量? | 否
C.2.12 | 医疗器械是否进行分析处理? | 适用 | 需要对医学图像进行处理 | 功能危险 | R7 | 配准结果欠佳
C.2.13 | 医疗器械是否预期和其它医疗器械、医药或其它医疗技术联合使用？ | 适用 | 与C臂机配合使用，与导针共同使用 | 辐射能危险 | R8 | 设备发热量超标
 |  |  |  | 机械能危险 | R9 | 机械臂运动路径规划有误
C.2.14 | 是否有不希望的能量或物质输出？ | 适用 | 器械可能发射辐射电磁能及设备发热，激光发热 | 电磁能危险 | R10 | 对外辐射电磁能超标
 |  |  |  | 辐射能危险 | R11 | 设备发热量超标
C.2.15 | 医疗器械是否对环境影响敏感？ | 适用 | 1.操作、运输和存储环境都会规定要求 | 标记危险 | R12 | 标记不清楚
 |  |  | 2.器械可能发射辐射电磁能及设备发热，激光发热 | 电磁能危险 | R13 | 环境电磁能超标
 |  |  |  | 辐射能危险 | R14 | 环境温度过高导致设备内部温度过高
C.2.16 | 医疗器械是否影响环境？ | 适用 | 器械对环境产生辐射电磁能影响 | 电磁能危险 | R15 | 对外辐射电磁能超标
 |  |  |  | 辐射能危险 | R16 | 设备发热量超标
C.2.17 | 医疗器械是否有基本的消耗品或附件？ | 适用 | 工具包是消耗品 | 功能危险 | R17 | 未按使用次数报废，导致精度下降
 |  |  | 激光监测是消耗品 | 功能危险 | R18 | 未按使用次数报废，导致电池续航量不够，激光监测失效，体位发生 移动
C.2.18 | 是否需要维护和校准？ | 适用 | 整机需要定期维护 | 功能危险 | R19 | 没有定期维护
 |  |  |  | 使用错误危险 | R20 | 没有定期维护
C.2.19 | 医疗器械是否有软件？ | 适用 | 器械预装软件，用户无法修改 | 功能危险 | R21 | 软件版本安装错误
C.2.20 | 医疗器械是否有存储寿命限制？ | 适用 | 8年 | 功能危险 | R22 | 超期继续使用器械
C.2.21 | 是否有延时或长期使用效应？ | 适用 | 器械机械松动，老化 | 功能危险 | R23 | 老化后继续使用器械
C.2.22 | 医疗器械承受何种机械力？ | 适用 | 受到的力是受用户控制 | 机械能危险 | R24 | 医生拖动机械臂用力过猛
C.2.23 | 什么决定医疗器械的寿命？ | 适用 | 关键元器件 | 功能危险 | R25 | 关键元器件超过使用寿命
C.2.24 | 医疗器械是否预期一次性使用？ | 否
C.2.25 | 医疗器械是否需要安全的退出运行或处置？ | 适用 | 相关部件需要按照国家标准规范进行处置 | 化学危险 化学危险 | R26 R27 | UPS电池未按规定回收处置 激光监测器电池未按规定回收处置
C.2.26 | 医疗器械的安装或使用是否需要专门的培训或专门的技能？ | 适用 | 需要专门培训 | 使用错误危险 | R28 | 培训不到位
 |  |  |  | 操作说明书危险 | R29 | 过于复杂的操作说明
C.2.27 | 如何提供安全使用信息？ | 适用 | 必须由专业人员进行售后安装、调试； | 服务和维护规范危险 | R30 | 由未经专业培训的人员进行安装、调试
 |  |  | 涉及第三方的参与，需要给第三方做相关培训； | 操作说明书危险 | R31 | 第三方培训不到位
 |  |  | 会提供操作说明书； | 使用错误危险 | R32 | 没有提供操作说明书
C.2.28 | 是否需要建立或引入新的制造过程？ | 否
C.2.29 | 医疗器械的成功使用，是否关键取决于人为因素，例如用户界面？
C.2.29.1 | 用户界面设计特性是否可能促成使用错误？ | 适用 | 软件界面设计可能会有误导性 | 标记危险 | R33 | 软件界面不适当的描述
C.2.29.2 | 医疗器械是否在因分散注意力而导致使用错误的环境中使用？ | 适用 | 软件的操作界面和脚踏控制时会有分散注意力 | 使用错误危险 | R34 | 使用者注意力不集中，在软件界面误点了机械臂相关功能，以及误踩脚踏
C.2.29.3 | 医疗器械是否有连接部分或附件？ | 适用 | 使用脚踏进行控制 | 使用错误危险 | R35 | 未连接脚踏
 |  |  | 器械需要跟C臂机用网线连接 | 使用错误危险 | R36 | 跟C臂机未连接
C.2.29.4 | 医疗器械是否有控制接口？ | 适用 | 使用脚踏进行控制 | 功能危险 | R37 | 脚踏接口功能错误，机械臂未按预期运动或停止
 |  |  | 使用通道升降遥控器 | 功能危险 | R38 | 通道升降遥控器失灵
C.2.29.5 | 医疗器械是否显示信息？ | 适用 | 软件界面或操作面板均显示信息 | 使用错误危险 | R39 | CT分区/X-ray分区,未按提示信息操作，导致无法配准
 |  |  |  | 功能危险 | R40 | 机械臂掉电或异常时会漏报、误报
C.2.29.6 | 医疗器械是否由菜单控制？ | 适用 | 器械由菜单控制 | 使用错误危险 | R41 | 菜单点错按钮
 |  |  |  | 功能危险 | R42 | 菜单表述不明确
C.2.29.7 | 医疗器械是否由具有特殊需要的人使用？ | 适用 | 经过专业培训的医生 | 使用错误危险 | R43 | 医生培训不合格或未经培训操作
C.2.29.8 | 用户界面能否用于启动使用者动作? | 适用 | 机械臂运动过程中有指示灯闪烁 | 使用错误危险 | R44 | 手术过程中，误点定位操作
C.2.30 | 医疗器械是否使用报警系统？ | 适用 | 机械臂掉电或异常会提醒 | 功能危险 | R45 | 机械臂掉电或异常时会漏报、误报
C.2.31 | 医疗器械可能以什么方式被故意地误用？ | 适用 | 在手术过程中，误用通道升降和台车升降按钮 | 使用错误危险 | R46 | 在手术过程中，误用通道升降按钮
 |  |  |  | 机械能危险 | R47 | 在手术过程中，误用台车升降按钮
C.2.32 | 医疗器械是否持有患者护理的关键数据？ | 否
C.2.33 | 医疗器械是否预期为移动式或便携式？ | 适用 | 移动式医疗设备 | 机械能危险 | R48 | 台车移动过程中存在倾倒风险
C.2.34 | 医疗器械的使用是否依赖于基本性能？ | 适用 | 器械使用依赖定位精度；图像识别精度会影响系统精度 | 功能危险 | R49 | 1，机械臂的定位精度未达标； 2，未按提示进行CT分区和X-ray分区；

Sheet: RAC
序号 | 危险(源) | 事件系列 | 危险情况 | 伤害 | 伤害严重度S | 伤害的总体概率P | 风险水平 | 风险控制选项 | 风险控制措施描述 | 验证实施：设计规范 | 有效性验证：设计验证方案编号 | 有效性验证：设计验证报告编号 | 状态 | 措施后S | 措施后P | 措施后风险水平R | 剩余风险评价 | 剩余风险披露 | 措施引入新的风险？
R1 | 机械能危险 | 定位过程中，机械臂失控或误操作 | 碰撞患者 | 造成患者伤残 | S3 | P3 | U | 设计保证 防护措施 | 1.增加脚踏控制； 2.紧急停止按钮。
R2 | 功能危险 | 机械臂精度不准，或者配准误差过大 | 导引错误 | 造成患者伤残 | S3 | P3 | U | 设计保证 安全说明 | 1.增加客户人工确认； 2.软件增加确认提示信息； 3.说明书中增加说明。
R3 | 化学危险 | 套筒磨损产生污染物 | 污染物掉落到患者伤口 | 造成患者感染 | S3 | P2 | R | 设计保证 安全说明 | 1.做生物相容性验证； 2.说明书限定套筒使用次数。
R4 | 热能危险 | 激光功率过大 | 激光照射患者 | 造成患者皮肤灼伤 | S2 | P3 | R | 设计保证 安全说明 | 1.限定激光功率不超过0.39mW； 2.增加激光警示标签； 3.说明书中增加说明。
R5 | 生物学危险 | 灭菌不彻底 | 细菌与患者伤口接触 | 患者细菌感染 | S4 | P3 | U | 设计保证 安全说明 | 1.确定灭菌参数，进行验证； 2.说明书增加灭菌要求； 3.对用户进行培训。
R6 | 生物学危险 | 没有进行清洁消毒 | 残留污染物 | 患者交叉感染 | S3 | P3 | U | 安全说明 | 1.说明书增加日常清洁消毒要求。
R7 | 功能危险 | 配准结果欠佳 | 客户就按当前的配准结果执行，螺钉打偏 | 导致患者伤残 | S3 | P3 | U | 防护措施 安全说明 | 1.软件增加用户确认提示信息； 2.说明书中增加说明。
R8 | 辐射能危险 | 设备发热量超标 | 影响C臂机的功能，导致X-ray图像不清晰 | 延误手术进程 | S2 | P1 | A | 设计保证 | 1.进行超温测试验证； 2.减少设备发热量。
R9 | 机械能危险 | 机械臂运动路径规划有误 | 导针偏离目标位置 | 造成患者伤残 | S3 | P3 | U | 设计保证 | 1.增加机械臂路径仿真模拟。
R10 | 电磁能危险 | 对外辐射电磁能超标 | 干扰其他手术设备不正常 | 造成患者伤残 | S3 | P3 | U | 设计保证 | 1.EMC设计和测试验证。
R11 | 辐射能危险 | 设备发热量超标 | 影响其他手术室设备运行 | 造成患者伤残 | S3 | P3 | U | 设计保证 | 1.进行超温测试验证； 2.减少设备发热量。
R12 | 标记危险 | 标记不清楚 | 使用不规范或功能变坏 | 延误手术进程 | S2 | P1 | A | 安全说明 | 1.说明书中规定相关要求； 2.包装箱增加标识说明。
R13 | 电磁能危险 | 环境电磁能超标 | 干扰设备，系统运行不流畅甚至死机；软件卡滞；显示器无画面或画面模糊；机械臂运行停止或者卡顿。 | 延误手术进程 | S2 | P2 | R | 设计保证 | 1.EMC设计和测试验证。
R14 | 辐射能危险 | 环境温度过高导致设备内部温度过高 | 设备运行不流畅甚至死机 | 延误手术进程 | S2 | P2 | R | 安全说明 | 1.说明书中明确设备使用环境条件。
R15 | 电磁能危险 | 对外辐射电磁能超标 | 干扰其他手术设备不正常 | 造成患者伤残 | S3 | P2 | R | 设计保证 | 1.EMC设计和测试验证。
R16 | 辐射能危险 | 设备发热量超标 | 影响其他手术室设备运行 | 造成患者伤残 | S3 | P2 | R | 设计保证 | 1.进行超温测试验证； 2.减少设备发热量。
R17 | 功能危险 | 未按使用次数报废，导致精度下降 | 导引错误 | 造成患者伤残 | S3 | P3 | U | 安全说明 设计保证 | 1.说明书中规定； 2.软件里增加次数判断。
R18 | 功能危险 | 未按使用次数报废，导致电池续航量不够，激光监测失效.体位发生移动 | 导引错误 | 造成患者伤残 | S3 | P3 | U | 设计保证 安全说明 | 1.低电量时.激光闪烁提示； 2.说明书中规定。
R19 | 功能危险 | 没有定期维护 | 整机精度下降，导引偏差 | 造成患者伤残 | S3 | P2 | R | 安全说明 | 1.说明书中规定维护周期。
R20 | 使用错误危险 | 没有定期维护 | 整机精度下降，导引偏差 | 造成患者伤残 | S3 | P2 | R | 安全说明 | 1.说明书中规定维护周期。
R21 | 功能危险 | 软件版本安装错误 | 软件功能无法使用 | 延误手术进程 | S2 | P1 | A | 设计保证 | 1.提供生产指南。
R22 | 功能危险 | 超期继续使用器械 | 整机精度下降，导引偏差 | 造成患者伤残 | S3 | P3 | U | 安全说明 | 1.说明书中明确规定有效期。
R23 | 功能危险 | 老化后继续使用器械 | 整机精度下降，导引偏差 | 造成患者伤残 | S3 | P2 | R | 安全说明 | 1.说明书中明确规定有效期、整机有效期。
R24 | 机械能危险 | 客户拖动机械臂用力过猛 | 机械臂保护性停止 | 延误手术进程 | S2 | P3 | R | 安全说明 | 1.说明书中规定。
R25 | 功能危险 | 关键元器件超过使用寿命 | 设备无法使用 | 延误手术进程 | S2 | P3 | R | 设计保证 安全说明 | 1.对关键元器件选型验证； 2.符合整机有效期要求。
R26 | 化学危险 | UPS电池未按规定回收处置 | 造成环境污染 | 无 | S1 | P2 | A | 安全说明 | 1.说明书中增加回收相关说明。
R27 | 化学危险 | 激光监测器电池未按规定回收处置 | 造成环境污染 | 无 | S1 | P1 | A | 安全说明 | 1.说明书中增加回收相关说明。
R28 | 使用错误危险 | 培训不到位 | 引起误操作 | 延误手术进程 | S2 | P2 | R | 安全说明 | 1.加强培训并考核。
R29 | 操作说明书危险 | 过于复杂的操作说明 | 影响客户的手术效率 | 延误手术进程 | S2 | P2 | R | 设计保证 | 1.进行可用性验证。
R30 | 服务和维护规范危险 | 由未经专业培训的人员进行安装、调试 | 设备无法使用 | 无 | S2 | P1 | A | 安全说明 | 1.对安装调试人员进行培训及考核。
R31 | 操作说明书危险 | 第三方培训不到位 | 引起误操作 | 延误手术进程 | S2 | P2 | R | 安全说明 | 1.对经销商加强培训与考核。
R32 | 使用错误危险 | 没有提供操作说明书 | 引起误操作 | 延误手术进程 | S2 | P3 | R | 安全说明 | 1.进行装箱核对。
R33 | 标记危险 | 软件界面不适当的描述 | 引起误操作 | 延误手术进程 | S2 | P2 | R | 设计保证 | 1.进行可用性验证。
R34 | 使用错误危险 | 使用者注意力不集中，在软件界面误点了机械臂相关功能，以及误踩脚踏 | 机械臂碰撞到患者 | 导致患者伤残 | S3 | P3 | U | 防护措施 | 1.增加机械臂控制相关动作的确认提示。
R35 | 使用错误危险 | 未连接脚踏 | 机械臂无法运动 | 延误手术进程 | S2 | P1 | A | 安全说明 | 1.现场进行脚踏安装确认。
R36 | 使用错误危险 | 跟C臂机未连接 | X-ray图像无法获取 | 延误手术进程 | S2 | P1 | A | 防护措施 | 1.软件有相应状态显示。
R37 | 功能危险 | 脚踏接口功能错误，机械臂未按预期运动或停止 | 机械臂碰撞到患者 | 导致患者伤残 | S3 | P2 | R | 防护措施 | 1.保障软件测试； 2.增加紧急停止按钮。
R38 | 功能危险 | 通道升降遥控器失灵 | 机械臂碰撞到患者 | 导致患者伤残 | S3 | P2 | R | 防护措施 | 1.增加紧急停止按钮。
R39 | 使用错误危险 | CT分区/X-ray分区，未按提示信息操作，导致无法配准 | 客户就按当前的配准结果执行下发定位 | 导致患者伤残 | S3 | P3 | U | 安全说明设计防护 | 1.软件增加确认提示信息。
R40 | 功能危险 | 机械臂掉电或异常时会漏报、误报 | 引起误操作 | 延误手术进程 | S2 | P1 | A | 设计保证 | 1.声音、灯光提示。
R41 | 使用错误危险 | 菜单点错按钮 | 引起误操作 | 延误手术进程 | S2 | P3 | R | 安全说明 设计防护 | 1.关键行为前增加确认提示信息； 2.通过软件设计进行了有效阻隔.尽量避免误操作发生后的影响。
R42 | 功能危险 | 菜单表述不明确 | 引起误操作 | 延误手术进程 | S2 | P2 | R | 设计保证 | 1.进行可用性验证。
R43 | 使用错误危险 | 客户培训不合格或未经培训操作 | 引起误操作 | 导致患者伤残 | S3 | P1 | R | 安全说明 | 1.进行客户培训及考核。
R44 | 使用错误危险 | 手术过程中，误点定位操作 | 引起非预期动作 | 导致患者伤残 | S3 | P3 | U | 防护措施 | 1.采用脚踏配合，先点软件按钮，再踩脚踏； 2.运动过程中增加灯光提示； 3.增加预先软件模拟仿真。
R45 | 功能危险 | 机械臂掉电或异常时会漏报、误报 | 引起误操作 | 延误手术进程 | S2 | P1 | A | 设计保证 | 1.声音、灯光提示。
R46 | 使用错误危险 | 在手术过程中，误用通道升降按钮 | 引起非预期动作 | 导致患者伤残 | S3 | P2 | R | 防护措施 | 1.增加紧急停止按钮； 2.升降过程中，使用灯光提示。
R47 | 机械能危险 | 在手术过程中，误用台车升降按钮 | 台车压到使用者脚 | 导致使用者受伤 | S2 | P2 | R | 防护措施 | 1.限制台车升降速度； 2.升降过程中，使用灯光提示； 3.按钮设计成点动式。
R48 | 机械能危险 | 台车移动过程中存在倾倒风险 | 台车倾倒 | 导致使用者受伤 | S2 | P2 | R | 设计保证 | 1.降低台车重心； 2.加大脚轮间距。
R49 | 功能危险 | 1，机械臂的定位精度未达标； 2，未按提示进行CT分区和X-ray分区； | 定位误差较大 | 导致患者伤残 | S3 | P3 | U | 设计保证 防护措施 | 1.增加机械臂双机标定，tcp标定； 2.软件增加提示信息。
R50 | 生物学危险 | 套筒接触患者 | 残留污染物 | 造成患者感染 | S3 | P2 | R | 防护措施 安全说明 | 1.确定灭菌参数进行验证； 2.说明书增加灭菌要求； 3.对用户进行培训。
R51 | 使用错误危险 | 合适通道精度范围内执行置针操作。 | 操作者未顺着通道方向置入导针 | 造成患者伤残 | S3 | P2 | R | 安全说明 | 1.加强培训并考核。
R52 | 机械能危险 | 脚轮刹车失效 | 在停放时，受到外力作用台车移动 | 操作不方便 | S1 | P1 | A | 设计保证 | 1.脚轮选型。
R53 | 机械能危险 | 显示器安装固定支架断裂 | 产品无法使用 | 产品不能正常使用 | S1 | P1 | A | 设计保证 | 1.选型确认。
R54 | 机械能危险 | 显示器安装固定支架无法限位 | 显示器往一边偏的较多 | 产品操作不便 | S1 | P1 | A | 设计保证 | 1.选型确认。
R55 | 机械能危险 | 显示器安装固定支架松动 | 显示器晃动 | 产品操作不便 | S1 | P1 | A | 设计保证 | 1.选型确认。
R56 | 机械能危险 | 焊接框架开裂 | 产品形态无法保持 | 产品不能正常使用 | S1 | P1 | A | 设计保证 | 1.对焊缝有明确要求。
R57 | 机械能危险 | 焊接框架变形.台车转运过程中会晃动 | 产品形态无法保持 | 产品不能正常使用 | S1 | P2 | A | 设计保证 | 1.受力分析。
R58 | 机械能危险 | 外壳受外力作用破损 | 外观破损影响视觉观感.同时影响到对内部设备的防护 | 无 | S1 | P1 | A | 设计保证 | 1.设计考虑材料的强度、韧性及厚度； 2.考虑拆件工艺。
R59 | 机械能危险 | 工作台旋转组件卡涩 | 操作时不方便调整工作台方向 | 产品操作不便 | S1 | P1 | A | 设计保证 | 1.选型确认。
R60 | 使用错误危险 | 侧面板插头脱落（脚绊倒电缆） | 功能无法操作 | 延误手术进程 | S2 | P1 | A | 防护措施 | 1.增加防脱落卡扣。
R61 | 机械能危险 | 主控面板外壳受外力作用破损 | 外观破损影响视觉观感.同时影响到对内部设备的防护 | 无 | S1 | P1 | A | 设计保证 | 1.设计考虑材料的强度、韧性及厚度； 2.考虑拆件工艺。
R62 | 机械能危险 | 脚轮刹车失效 | 在停放时.受到外力作用.台车会移动 | 操作不方便 | S1 | P2 | A | 设计保证 | 1.选型确认。
R63 | 机械能危险 | 脚轮过载.卡涩异响 | 台车移动会受到一定影响 | 操作不方便 | S1 | P2 | A | 设计保证 | 1.适当减重，提高脚轮安全系数。
R64 | 机械能危险 | 脚杯受重力作用脚杯变形、设备倾斜 | 定位不准 | 导致患者伤残 | S3 | P1 | R | 设计保证 | 1.选型确认。
R65 | 机械能危险 | 焊接框架开裂 | 设备异响.结构不稳定 | 产品不能正常使用 | S3 | P1 | R | 设计保证 | 1.对焊缝有明确要求。
R66 | 机械能危险 | 焊接框架变形，台车转运过程中会晃动 | 产品形态无法保持 | 产品不能正常使用 | S4 | P1 | R | 设计保证 | 1.受力分析。
R67 | 扭转力、剪切力和张力 | 显示器安装固定支架断裂 | 无法操作 | 产品不能正常使用 | S1 | P2 | A | 设计保证 | 1.选型确认。
R68 | 运动零件 | 显示器安装固定支架松动 | 显示器晃动 | 操作者不便 | S1 | P2 | A | 设计保证 | 1.选型确认。
R69 | 扭转力、剪切力和张力 | 显示器安装固定支架无法限位 | 显示器往一边偏的较多 | 操作者不便 | S1 | P1 | A | 设计保证 | 1.选型确认。
R70 | 机械能危险 | 工作台旋转组件卡涩 | 操作时不方便调整工作台方向 | 产品操作不便 | S1 | P1 | A | 设计保证 | 1.选型确认。
R71 | 机械能危险 | 外壳受外力作用破损 | 外观破损影响视觉观感.同时影响到对内部设备的防护 | 无 | S1 | P1 | A | 设计保证 | 1.设计考虑材料的强度、韧性及厚度； 2.考虑拆件工艺。
R72 | 使用错误危险 | 侧面板插头脱落（脚绊倒电缆） | 功能无法操作 | 延误手术进程 | S2 | P1 | A | 防护措施 | 1.增加防脱落卡扣。
R73 | 机械能危险 | 激光定位杆晃动 | 影响客户对体位的判断 | 导致患者伤残 | S4 | P2 | U | 设计保证 | 1.采用无活动式设计； 2.采用铝合金材质，采用合适的壁厚。
R74 | 机械能危险 | 主控面板外壳受外力作用破损 | 外观破损影响视觉观感.同时影响到对内部设备的防护 | 产品不能正常使用 | S1 | P1 | A | 设计保证 | 1.设计考虑材料的强度、韧性及厚度； 2.塑料外壳手板考虑拆件工艺。
R75 | 机械能危险 | 转接法兰磨损 | 定位不准 | 导致患者伤残 | S4 | P3 | U | 设计保证 | 1.消耗品，限定使用次数。
R76 | 机械能危险 | 手术定位器连接不稳固 | 无法定位 | 延误手术进程 | S2 | P2 | R | 设计保证 | 1.增加止锁按键。
R77 | 机械能危险 | 配准板变形 | 定位不准 | 导致患者伤残 | S4 | P4 | U | 设计保证 防护措施 | 1.结构设计增强结构刚度； 2.灭菌方式修改。
R78 | 机械能危险 | 套筒磨损 | 定位不准 | 导致患者伤残 | S4 | P3 | U | 设计保证 | 1.消耗品，限定使用次数。
R79 | 功能危险 | 按键板按键失效 | 按键常开 | 延误手术进程 | S2 | P1 | A | 设计保证 | 1.按键的设计寿命留有余量； 2.对按键做寿命测试。
R80 | 机械能危险 | 立柱自锁功能卡死，升降立柱无法降 | 脚杯无法撑住地面 | 延误手术进程 | S2 | P1 | A | 设计保证 | 1.对立柱进行疲劳测试。
R81 | 机械能危险 | 限位开关失效，升降立柱无法降 | 脚杯无法撑住地面 | 延误手术进程 | S2 | P1 | A | 设计保证 | 1.对限位螺母加固； 2.对立柱进行疲劳测试。
R82 | 机械能危险 | 电源连接松动 | 台车不能升降 | 产品操作不便 | S1 | P1 | A | 设计保证 | 1.使用防脱带卡扣插头。
R83 | 功能危险 | RGB灯板LED灯损坏 | 个别LED不亮 | 无明显影响 | S1 | P1 | A | 设计保证 | 1.选型确认。
R84 | 机械能危险 | RGB灯板接口松动 | LED整体不亮 | 影响用户通过指示灯观察机械臂状态 | S2 | P2 | R | 设计保证 | 1.使用防脱带卡扣插头。
R85 | 功能危险 | UPS内部故障关闭 | 系统断电 | 导致患者伤残 | S3 | P1 | R | 设计保证 | 1.外壳增加散热孔； 2.设计上，对UPS输出功率留有余量。
R86 | 功能危险 | 用户超年限使用，UPS后备电池供电不足 | 停电时系统无后备电源 | 导致患者伤残 | S3 | P1 | R | 安全说明 | 1.规定使用年限，定期更换。
R87 | 机械能危险 | UPS控制线连接松动 | 系统无法开机或者关机 | 延误手术进程 | S2 | P1 | A | 设计保证 | 1.使用防脱带卡扣插头。
R88 | 功能危险 | UPS控制板电源部分芯片故障 | 控制板无法供电，UPS延时关机 | 对病人无直接伤害 | S1 | P1 | A | 设计保证 | 1.设计上对电源留有足够余量； 2.对PCB板进行测试，功率，电流。
R89 | 功能危险 | UPS控制板MCU故障 | 控制逻辑输出错误，UPS延时关机 | 对病人无直接伤害 | S1 | P1 | A | 设计保证 防护措施 | 1.设计接地线，进行静电测试验证。
R90 | 机械能危险 | UPS控制板接口松动 | 与UPS信号无法发送，UPS延时关机 | 对病人无直接伤害 | S1 | P1 | A | 设计保证 | 1.使用防脱带卡扣插头。
R91 | 功能危险 | UR机器人关节卡死 | 机器人达不到定位位置 | 导致患者伤残 | S3 | P1 | R | 设计保证 | 1.进行耐久性测试。
R92 | 功能危险 | UR机器人定位精度变差 | 机器人到达定位位置误差较大 | 导致患者伤残 | S3 | P2 | R | 设计保证 | 1.进行耐久性测试。
R93 | 机械能危险 | UR机器人电源连接线松动 | 机械臂无法启动 | 延误手术进程 | S2 | P1 | A | 设计保证 | 1.使用原厂插头，不进行改动。
R94 | 电磁能危险 | UR机器人末端工具漏电 | 电击患者或者影响手术监测设备正常工作 | 导致患者伤残 | S3 | P1 | R | 设计保证 | 1.对末端工具进行浮地设计。
R95 | 功能危险 | UR控制板电源部分芯片故障 | 控制板无法供电 | 延误手术进程 | S2 | P1 | A | 设计保证 | 1.设计上，对电源留有足够余量； 2.对PCB板进行测试，功率，电流。
R96 | 功能危险 | UR控制板MCU故障 | 控制逻辑输出错误 | 延误手术进程 | S2 | P1 | A | 设计保证 | 1.设计接地线，进行静电测试验证。
R97 | 功能危险 | UR控制板USB功能失效 | 与PC机通讯失败 | 延误手术进程 | S2 | P1 | A | 设计保证 | 1.使用防脱带卡扣插头。
R98 | 功能危险 | UR控制板升降立柱电机功能失效 | 立柱无法升降 | 台车无法转移 | S1 | P1 | A | 设计保证 | 1.使用防脱带卡扣插头。
R99 | 功能危险 | UR机械臂上下电功能失效 | 机械臂无法启动 | 延误手术进程 | S2 | P1 | A | 设计保证 | 1.使用防脱带卡扣插头。
R100 | 功能危险 | UR控制板脚踏功能失效 | 机械臂无法启动 | 延误手术进程 | S2 | P1 | A | 设计保证 | 1.使用防脱带卡扣插头。
R101 | 功能危险 | UR控制板电机正反转按键失效 | 立柱无法升降 | 台车无法转移 | S1 | P1 | A | 设计保证 | 1.按键的设计寿命留有余量； 2.对按键做疲劳测试。
R102 | 功能危险 | UR控制板芯片故障 | 控制板无法正常 | 延误手术进程 | S2 | P1 | A | 设计保证 | 1.选型确认。
R103 | 功能危险 | 脚踏开关卡住 | 机械臂无法启动 | 延误手术进程 | S2 | P1 | A | 设计保证 | 1.使用具有IP68认证的开关。
R104 | 功能危险 | 开关连接线断开 | 机械臂无法启动 | 延误手术进程 | S2 | P1 | A | 设计保证 | 1.使用具有CCC认证的开关。
R105 | 功能危险 | 导入的CT层厚过厚图像不清晰，配准偏差较大 | 螺钉打偏 | 导致患者伤残 | S3 | P5 | U | 安全说明 | 1.在说明书中明确CT图像层厚要求。
R106 | 功能危险 | CT分区操作不规范，配准图像偏差大 | 螺钉打偏 | 导致患者伤残 | S3 | P5 | U | 设计保证 | 1.增加提示条：关于CT分区的操作注意事项。
R107 | 功能危险 | X-RAY分区操作不规范，配准图像偏差大 | 螺钉打偏 | 导致患者伤残 | S3 | P5 | U | 设计保证 | 1.增加提示条：关于X-RAY分区的操作注意事项。
R108 | 功能危险 | CT切割错误，配准图像偏差大 | 螺钉打偏 | 导致患者伤残 | S3 | P5 | U | 设计保证 | 1.增加复位按钮。
R109 | 功能危险 | 操作不规范 自动配准图像偏差大 | 螺钉打偏 | 导致患者伤残 | S3 | P5 | U | 设计保证 | 1.增加用户确认配准结果。
R110 | 功能危险 | 接收到的x光图像有干扰 | 螺钉打偏 | 导致患者伤残 | S3 | P5 | U | 设计保证 | 1.增加X光图像去除小球、滤波等功能。
R111 | 功能危险 | 自动配准效果不佳 | 螺钉打偏 | 导致患者伤残 | S3 | P5 | U | 设计保证 | 1.增加用户手动微调功能。
R112 | 功能危险 | 接收到的X光图像方向错误 | 螺钉打偏 | 导致患者伤残 | S3 | P5 | U | 设计保证 | 1软件提供X光图像上下翻转和左右翻转功能。
R113 | 功能危险 | u盘传输错误 | 数据无法读取 | 延误手术进程 | S3 | P3 | U | 设计保证 | 1.增加软件提示。
R114 | 功能危险 | 导入路径过长 | 数据无法读取 | 延误手术进程 | S3 | P3 | U | 设计保证 | 1.增加软件提示。
R115 | 功能危险 | CT数据异常 | 数据无法读取 | 延误手术进程 | S3 | P3 | U | 设计保证 | 1.增加软件提示。
R116 | 功能危险 | CT缓存硬盘空间不足 | 医生无法继续手术 | 延误手术进程 | S3 | P3 | U | 设计保证 | 1.增加软件提示。
R117 | 功能危险 | 导入相同CT后会覆盖之前的CT数据 | 医生无法继续手术 | 延误手术进程 | S3 | P3 | U | 设计保证 | 1.重复导入之后软件会新建CT存放路径。
R118 | 功能危险 | 未对多序列CT数据进行区分 | 多序列CT导致软件崩溃 | 延误手术进程 | S3 | P3 | U | 设计保证 | 1.多序列CT导入时生成多序列列表可供选择。
R119 | 功能危险 | 内存和硬盘不稳定 | 需要重启设备 | 延误手术进程 | S3 | P3 | U | 设计保证 | 1.重启后可以继续操作。
R120 | 功能危险 | 操作系统自有缺陷 | 需要重启设备 | 延误手术进程 | S3 | P3 | U | 设计保证 | 1.重启后可以继续操作。
R121 | 功能危险 | 数据未保存或备份 | 需要重启设备 | 延误手术进程 | S3 | P3 | U | 设计保证 | 1.软件关键数据自动保存和备份。
R122 | 功能危险 | 数据损坏 | 需要重启设备 | 延误手术进程 | S3 | P3 | U | 设计保证 | 1.增加软件提示。
R123 | 功能危险 | 数据未更新到其他模块 | 需要重启设备 | 延误手术进程 | S3 | P3 | U | 设计保证 | 1.不同模块相关数据共享。
R124 | 功能危险 | step设置错误 | 需要重启设备 | 延误手术进程 | S3 | P3 | U | 设计保证 | 1.增加权限控制，非相关人员无法修改设置。
R125 | 功能危险 | ip设置错误 | 需要重启设备 | 延误手术进程 | S3 | P3 | U | 设计保证 | 1.增加权限控制，非相关人员无法修改设置。
R126 | 功能危险 | 阈值设置错误 | 需要重启设备 | 延误手术进程 | S3 | P3 | U | 设计保证 | 1.增加权限控制，非相关人员无法修改设置。
R127 | 功能危险 | 窗宽窗位参数调整后无法重置 | 需要重启设备 | 延误手术进程 | S3 | P3 | U | 设计保证 | 1.设置窗宽窗位重置按钮。
R128 | 功能危险 | 部分功能在主进程中占用太多时间 | 医生使用体验感不佳 | 影响医生判断 | S1 | P3 | R | 设计保证 | 1.软件开启多线程运行计算。
R129 | 功能危险 | CT交互渲染时间太长 | 医生使用体验感不佳 | 影响医生判断 | S1 | P3 | R | 设计保证 | 1.软件利用GPU对渲染进行加速。
R130 | 功能危险 | 进度条运行中执行其他操作 | 医生使用体验感不佳 | 影响医生判断 | S1 | P3 | R | 设计保证 | 1.进度条设置置顶。
R131 | 功能危险 | 软件未单实例运行 | 医生使用体验感不佳 | 影响医生判断 | S1 | P3 | R | 设计保证 | 1.软件设置单实例运行程序。
R132 | 功能危险 | 账户数据库被篡改 | 医生无法继续手术 | 延误手术进程 | S3 | P3 | U | 设计保证 | 1.增加账户数据库crc校验。
R133 | 功能危险 | 内存不够 | 医生无法继续手术 | 延误手术进程 | S3 | P3 | U | 设计保证 | 1.限定螺钉数量。
R134 | 功能危险 | 螺钉默认颜色单一 | 医生无法继续手术 | 延误手术进程 | S3 | P3 | U | 设计保证 | 1.自定义螺钉颜色。
R135 | 功能危险 | 未设置螺钉长度范围 | 医生无法继续手术 | 延误手术进程 | S3 | P3 | U | 设计保证 | 1.螺钉限定最大长度最小长度。
R136 | 功能危险 | 螺钉直径固定 | 医生无法继续手术 | 延误手术进程 | S3 | P3 | U | 设计保证 | 1.螺钉直径。
R137 | 功能危险 | 规划后修改螺钉所属椎体导致螺钉位置混乱 | 医生无法继续手术 | 延误手术进程 | S3 | P3 | U | 设计保证 | 1.规划后修改螺钉所属椎体会同步。
R138 | 功能危险 | 导出数据中拔出U盘 | 医生使用体验感不佳 | 影响医生判断 | S1 | P3 | R | 设计保证 | 1.增加软件提示。
R139 | 功能危险 | 分椎线未划定移动范围 | 医生无法继续手术 | 延误手术进程 | S3 | P3 | U | 设计保证 | 1.限定分椎线范围。
R140 | 功能危险 | 内存和硬盘不稳定 | 医生无法继续手术 | 延误手术进程 | S3 | P3 | U | 设计保证 | 1.重启后可以继续操作。
R141 | 功能危险 | 操作系统自有缺陷 | 医生无法继续手术 | 延误手术进程 | S3 | P3 | U | 设计保证 | 1.重启后可以继续操作。
R142 | 功能危险 | 网络异常断开 | 手术无法继续 | 延误手术进程 | S3 | P3 | U | 设计保证 | 1.软件与机械臂断开连接时弹窗提示。
R143 | 功能危险 | 机械臂运动到关节极限，保护性停止 | 手术无法继续 | 延误手术进程 | S3 | P3 | U | 设计保证 | 1.使用自由拖动模式，将机械臂关节运动到正常范围内。
R144 | 功能危险 | 机械臂关节自碰撞，保护性停止 | 手术无法继续 | 延误手术进程 | S3 | P3 | U | 设计保证 | 1.增加姿态仿真功能。
R145 | 功能危险 | 机械臂无法到达指定地点 | 手术无法继续 | 延误手术进程 | S3 | P3 | U | 设计保证 | 1.增加姿态仿真功能。
R146 | 功能危险 | 机械臂遇到障碍物，保护性停止 | 手术无法继续 | 延误手术进程 | S3 | P3 | U | 设计保证 | 1.增加姿态仿真功能。
R147 | 功能危险 | 与C臂机的网络连接断开 | 手术无法继续 | 延误手术进程 | S3 | P3 | U | 设计保证 | 1.显示于C臂机连接的网络状态。
R148 | 功能危险 | 与规划软件的网络连接断开 | 手术无法继续 | 延误手术进程 | S3 | P3 | U | 设计保证 | 1.软件提示发送超时。
R149 | 功能危险 | focalLength设置错误 | 手术无法继续 | 延误手术进程 | S3 | P3 | U | 设计保证 | 1.增加权限控制，非相关人员无法修改设置。
R150 | 功能危险 | spacing设置错误 | 手术无法继续 | 延误手术进程 | S3 | P3 | U | 设计保证 | 1.增加权限控制，非相关人员无法修改设置。
R151 | 功能危险 | radius设置错误 | 手术无法继续 | 延误手术进程 | S3 | P3 | U | 设计保证 | 1.增加权限控制，非相关人员无法修改设置。
R152 | 功能危险 | minArea、maxArea设置错误 | 手术无法继续 | 延误手术进程 | S3 | P3 | U | 设计保证 | 1.增加权限控制，非相关人员无法修改设置。
R153 | 功能危险 | 校准板未水平摆放 | 手术无法继续 | 延误手术进程 | S3 | P3 | U | 设计保证 | 1.增加机械臂水平对齐功能。
R154 | 功能危险 | X光图像分辨率不匹配 | 手术无法继续 | 延误手术进程 | S3 | P3 | U | 设计保证 | 1.配置文件增加参数设置X光图像分辨率。
R155 | 功能危险 | 校准板小球坐标数据不匹配 | 手术无法继续 | 延误手术进程 | S3 | P3 | U | 设计保证 | 1.图像X光片识别结果保存本地。
R156 | 功能危险 | 机械臂临时断电 | 手术无法继续 | 延误手术进程 | S3 | P3 | U | 设计保证 | 1.软件提供机械臂断开和开启功能。
R157 | 功能危险 | 机械臂姿态数据未保存或者备份 | 手术无法继续 | 延误手术进程 | S3 | P3 | U | 设计保证 | 1.每次X光图像校准之后将姿态数据保存至本地，并提供正位复位和侧位复位功能。
R158 | 功能危险 | 规划未在接收X光图像界面 | 手术无法继续 | 延误手术进程 | S3 | P3 | U | 设计保证 | 1.增加软件提示。
R159 | 功能危险 | 部分功能在主进程中占用太多时间 | 医生使用体验感不佳 | 影响医生判断 | S3 | P3 | U | 设计保证 | 1.软件开启多线程运行计算。
R160 | 功能危险 | 校准参数设置错误 | 医生使用体验感不佳 | 影响医生判断 | S3 | P3 | U | 设计保证 | 1.软件校准超时提示。
R161 | 功能危险 | 进度条运行中执行其他操作 | 医生使用体验感不佳 | 影响医生判断 | S3 | P3 | U | 设计保证 | 1.进度条设置置顶。
R162 | 功能危险 | 软件未单实例运行 | 医生使用体验感不佳 | 影响医生判断 | S3 | P3 | U | 设计保证 | 1.软件设置单实例运行程序。
R163 | 功能危险 | 未配置工具文件 | 手术无法继续 | 延误手术进程 | S3 | P3 | U | 设计保证 | 1.增加工具文件导入功能。
R164 | 功能危险 | 工具文格式错误 | 手术无法继续 | 延误手术进程 | S3 | P3 | U | 设计保证 | 1.增加软件提示。
R165 | 功能危险 | 机械臂未开启 | 手术无法继续 | 延误手术进程 | S3 | P3 | U | 设计保证 | 1.增加软件提示。
R166 | 功能危险 | 定位过程未正常结束无法进行下一次定位 | 手术无法继续 | 延误手术进程 | S3 | P3 | U | 设计保证 | 1.设置定位重置按钮。
R167 | 功能危险 | 程序指令顺序冲突 | 手术无法继续 | 延误手术进程 | S3 | P3 | U | 设计保证 | 1.在仿真未结束时禁用定位按钮。
R168 | 功能危险 | 接收到规划数据时未明显提示信息 | 手术无法继续 | 延误手术进程 | S3 | P3 | U | 设计保证 | 1.接收到规划定位数据时显示通道数据信息。
R169 | 功能的丧失或变坏 | (1)网络异常 (2)无法接受X光图像 (3)无法显示C臂机的X光图像 | 手术无法继续 | 用户体验感差 | S1 | P3 | R | 安全说明 设计保证 | 1.采用稳定的网络设备； 2.加强测试。
R170 | 功能的丧失或变坏 | (1)C臂机故障 (2)无法接受X光图像 (3)无法显示C臂机的X光图像 | 手术无法继续 | 用户体验感差 | S1 | P3 | R | 安全说明 | 1.术前检查保证C臂机正常运行； 2.规范操作。
R171 | 功能危险 | 软件内存不够 | 医生使用体验感不佳 | 影响医生判断 | S3 | P3 | U | 设计保证 | 1.增加内存边界检查。

Sheet: 签字页
 |  |  | 文件号：MS001.01.103SM.1.0
模块化手术导引系统
风险评估和控制记录
设计开发输出阶段
 | 编制/时间：
 | 审核/时间：
 | 批准/时间：
 | 杭州三坛医疗科技有限公司
文档更改履历
版本号 | 发布/实施日期 | 更改内容概述 |  | 更改者
V1.0 |  | 文件新编

Sheet: 风险可接受准则
潜在的伤害严重度等级(S)
等级名称 | 代号 | 定义
可忽略 | S1 | 不便或暂时不适
轻度 | S2 | 导致不要求专业医疗介入的暂时伤害或损伤
严重 | S3 | 导致要求专业医疗介入的伤害或损伤
危重的 | S4 | 导致永久性损伤或危及生命的伤害
灾难性的 | S5 | 导致患者死亡
危险发生概率(Px)
等级名称 | 代号 | 概率范围 | 分析
非常少 | Im | ﹤10-6 | 事件不可复制和/或无法在设备的指定操作条件下复制。由于缺乏明确的信息，或在调查后发现与一系列未经证实或不可信的操作员行为或事件有关，因此无法对此类事件进行适当调查。
很少 | Re | ﹤10-5和≥10-6 | 在设备的特定操作条件下，在产品寿命期间，事件很少发生。这一概率与设备运行相关的不经常的、未预料到的结果有关，或与操作员操作或异常事件的多步骤序列有关。
偶然 | Oc | ﹤10-4和≥10-5 | 在产品寿命期间，在设备的特定操作条件下，偶尔会发生事件。这种概率与两个特定的连续或同时的操作员操作或事件，或大多数用户偶尔执行的功能有关。
有时 | So | ﹤10-3和≥10-4 | 在产品的寿命期内，在设备的特定操作条件下，事件可能会发生或多次发生。这种可能性与未预料到的结果有关，这些结果很可能发生在设备的正常使用中。
经常 | Fr | ≥10-3 | 事件不可复制和/或无法在设备的指定操作条件下复制。由于缺乏明确的信息，或在调查后发现与一系列未经证实或不可信的操作员行为或事件有关，因此无法对此类事件进行适当调查。
可能造成的伤害(Py)
等级名称 | 代号 | 说明
可能 | L | 该事件可能导致患者/用户的不良结果和/或医务人员无法识别。这种伤害是迅速或立即发生的。
不太可能 | U | 该事件对护理者来说不是很明显，但良好的临床实践和/或预防性维护等因素可能会阻止严重的患者/用户不良结果。
极少 | R | 该事件不太可能导致患者/用户的不良结果和/或对医务人员明显。这种伤害可能是由于发病延迟，从而增加了检测的可能性。
伤害总体概率评价标准(P)
可能造成的伤害(Py) |  | 危险发生概率(Px)
 |  | 经常Fr | 有时So | 偶然Oc | 很少Re | 非常少Im
可能 (L) |  | 经常P5 | 有时P4 | 偶然P3 | 很少P2 | 非常少P1
不太可能 (U) |  | 有时P4 | 偶然P3 | 很少P2 | 非常少P1 | 非常少P1
极少（R） |  | 偶然P3 | 很少P2 | 非常少P1 | 非常少P1 | 非常少P1
风险评价准则
A：可接受的风险；
R：合理可行降低(ALARP)的风险；
U：不经过风险/收益分析即判定为不可接受的风险。

Sheet: 危险（源）示例
危险（源）示例
能量危险（源）示例 | 生物学和化学危险（源）示例 | 操作危险（源）示例 | 信息危险（源）示例
电磁能 | 生物学的 | 功能 | 标记
线电压 | 细菌 | 不正确或不适当的输出或功能 | 不完整的使用说明书
漏电流 | 病毒 | 不正确的测量 | 性能特征的不适当的描述
——外壳漏电流 | 其他介质（例如：蛋白病毒） | 错误的测量 | 不适当的预期使用规范
——对地漏电流 | 再次或者交叉感染 | 功能的丧失或变坏 | 局限性未充分公示
——患者漏电流 | 化学的 | 使用错误 | 操作说明书
电场 | 气路、组织、环境或者财产暴露在外来物质中、例如： | 缺乏注意力 | 医疗器械所使用的的附件的规范不适当
磁场 | ——酸或碱 | 记忆力不良 | 使用前检查规范不适当
辐射能 | ——残留物 | 不遵守规则 | 过于复杂的操作说明
电离辐射 | ——污染物 | 缺乏知识 | 警告
非电离辐射 | ——添加剂或者加工助剂 | 违反常规 | 副作用
热能 | ——清洁剂、消毒剂或试验试剂 |  | 一次性使用医疗器械可能重复使用的危险（源）
高温 | ——降解产物 |  | 服务和使用的危险（源）
低温 | ——医用气体
机械能 | ——麻醉产品 |  | 服务和维护规范
重力 | 生物相容性
——坠落 | 化学成分毒性，例如：
——悬挂物 | ——致敏型/刺激
振动 | ——致热源
贮存的能量
运动零件
扭转力、剪切力和张力
患者的移动和定位
声能
——超声能量
——次声能量
——声音
高压液体注射
参考YY/T 0316-2016 （ISO14971:2012） | 问题 | 考虑因素
C.2.1 | 医疗器械的预期用途是什么和怎样使用医疗器械？ | 医疗器械的作用:
 |  | 疾病的诊断、预防、监护、治疗或者缓解；
 |  | 伤害或残疾的补偿；
 |  | 解剖或生理过程的研究、替代或者补偿； 妊辰控制；
 |  | 使用要求（例如，患者人群）？
 |  | 设备用于维持生命或支撑生命?
 |  | 医疗器械故障时是否需要特殊干预?
C.2.2 | 医疗器械是否预期植入？ | 考虑：植入位置，患者人群的特征，年龄，体重，体力活动，老化对种植体性能的影响，种植体的预期寿命，植入的可逆性。
C.2.3 | 医疗器械是否预期和患者或其他人员接触？ | 预期的接触性质，即表面接触，侵入性接触或植入，以及接触的周期和频率。
C.2.4 | 在医疗器械中利用何种材料或组分，或与医疗器械共同使用或与其接触？ | 考虑：:
 |  | 与相关物质的相容性;
 |  | 与组织或体液的相容性;
 |  | 是否值得与安全相关的特征;
 |  | 是否利用动物源材料?
C.2.5 | 是否有能量给予患者或从患者身上获取? | 考虑：
 |  | 能量转移的类型;
 |  | 其控制、质量、数量、强度和持续时间;
 |  | 能量基本是否高于类似产品当前应用的能量水平。
C.2.6 | 是否有物质提供给患者或从患者身上提取？ | 考虑：
 |  | 物质是提供还是提取；无论是单一物质还是一系列物质；最大和最小传送率及其控制。
C.2.7 | 医疗器械是否处理生物材料用于随后的再次使用、输液/血或移植？ | 考虑：:
 |  | 处理过程和物质的类型（例如，自动输血，透析，血液成分或细胞疗法处理）
C.2.8 | 医疗器械是否以无菌形式提供或预期由使用者灭菌，或用其它微生物学控制方法灭菌？ | 考虑：:
 |  | 医疗装置是否预期一次性使用包装或重复使用包装;
 |  | 储存寿命;
 |  | 重复使用周期次数的限制;
 |  | 灭菌方式;
 |  | 制造商非预期灭菌方法的影响.。
C.2.9 | 医疗器械是否预期由用户进行常规清洁和消毒？ | 考虑：:
 |  | 使用的清洁剂或消毒剂的类型以及对清洁周期数的任何限制。
 |  | 医疗器械的设计会影响日常清洁和消毒的效果。 应考虑清洁剂和消毒剂对装置的安全性或性能的影响。
C.2.10 | 医疗器械是否预期改善患者的环境? | 考虑：
 |  | 温度;
 |  | 湿度;
 |  | 大气成分;
 |  | 压力;
 |  | 光线.
C.2.11 | 是否进行测量? | 考虑：:
 |  | 测量的变量以及测量结果的准确性和精度。
C.2.12 | 医疗器械是否进行分析处理? | 考虑：:
 |  | 医疗设备是否从输入数据或采集数据得出结论，使用的算法以及置信限度。 应特别注意数据或算法的非预期应用。
C.2.13 | 医疗器械是否预期和其它医疗器械、医药或其它医疗技术联合使用？ | 考虑：:
 |  | 识别可能涉及的任何其他医疗装置，药物或其他医疗技术以及与这种相互作用相关的潜在问题以及患者对治疗的依从性。
C.2.14 | 是否有不希望的能量或物质输出？ | 能量相关考虑:
 |  | 噪声和振动，热量，辐射（包括电离，非电离和紫外/可见/红外辐射），接触温度，泄漏电流和电场或磁场。
 |  | 物质相关考虑： 制造，清洁或测试中使用的物质，如果留在产品中，会产生不必要的生理影响。
 |  | 其他物质相关考虑：化学品，废物和体液的排放。
C.2.15 | 医疗器械是否对环境影响敏感？ | 考虑：:
 |  | 操作、运输和存储环境。这些因素包括光照、温度、湿度、振动、溢出、对电源和冷却电源变化的敏感性，以及电磁干扰。
C.2.16 | 医疗器械是否影响环境？ | 考虑：:
 |  | 对电力和冷却供应的影响；
 |  | 有毒物质的排放；
 |  | 电磁干扰的产生
C.2.17 | 医疗器械是否有基本的消耗品或附件？ | 考虑：:
 |  | 这些消耗品或附件的规格，以及在选择这些消耗品时对用户的任何限制。
C.2.18 | 是否需要维护和校准？ | 考虑：:
 |  | 是否由操作者或用户或专家进行维护或校准;
 |  | 维护或校准需要特殊的物质或设备;
C.2.19 | 医疗器械是否有软件？ | 考虑：
 |  | 软件是否打算由操作员或用户或专家安装，验证，修改或交换。
C.2.20 | 医疗器械是否有存储寿命限制？ | 考虑：:
 |  | 标签或标识，以及到期后此类医疗器械的处置。
C.2.21 | 是否有延时或长期使用效应？ | 考虑:
 |  | 人体工程学和累积效应。
 |  | 示例包括：
 |  | 随时间腐蚀的盐水泵，机械疲劳，皮带和附件松动，
 |  | 振动的影响，标签磨损或脱落，长期的材料退化。
C.2.22 | 医疗器械承受何种机械力？ | 考虑:
 |  | 医疗装置受到的力是受用户控制还是与他人的相互作用控制。
C.2.23 | 什么决定医疗器械的寿命？ | 考虑: 老化和电池耗尽。
C.2.24 | 医疗器械是否预期一次性使用？ | 考虑: 医疗器械使用后是否自毁？设备已被使用是否显而易见？
C.2.25 | 医疗器械是否需要安全的退出运行或处置？ | 考虑： 处置医疗设备本身产生的废弃物。 例如，是否含有有毒或有害物质，物质是否可回收？
C.2.26 | 医疗器械的安装或使用是否需要专门的培训或专门的技能？ | 考虑： 医疗设备的新颖性以及设备安装人员可能的技能和培训。
C.2.27 | 如何提供安全使用信息？ | 考虑：
 |  | 信息是由制造商直接提供给最终用户，还是涉及安装人员，护理人员，医疗保健专业人员或药剂师等第三方的参与，以及这是否会影响到培训;
 |  | 调试和交付给最终用户，以及是可以由没有必要技能的人员进行安装;
 |  | 基于设备的预期寿命，是否需要对操作员或服务人员进行再培训或重新认证。
C.2.28 | 是否需要建立或引入新的制造过程？ | 考虑: 新技术或新的生产规模
C.2.29 | 医疗器械的成功使用，是否关键取决于人为因素，例如用户界面？
C.2.29.1 | 用户界面设计特性是否可能促成使用错误？ | 应考虑的因素是可能导致使用错误的用户界面设计。
 |  | 界面设计的例子包括：控制和指示器，使用的符号，人机工程学特征，物理设计和布局，操作层次，软件驱动设备的菜单，警告的可见性，警报的可听性以及颜色编码的标准化。 有关可用性的更多指导，请参阅IEC 60601-1-6，有关警报的指导请参阅IEC 60601-1-8
C.2.29.2 | 医疗器械是否在因分散注意力而导致使用错误的环境中使用？ | 考虑：
 |  | 使用错误的后果;
 |  | 干扰是否来自公共场所;
 |  | 用户是否被偶发性事件干扰
C.2.29.3 | 医疗器械是否有连接部分或附件？ | 考虑:
 |  | 错误连接的可能性，与其他产品连接的相似性，连接力，对连接完整性的反馈，过度和不足。
C.2.29.4 | 医疗器械是否有控制接口？ | 考虑:
 |  | 间隔，编码，分组，映射，反馈模式，失误，滑动，控制差异，可见性，激活或改变的方向，控制是连续的还是离散的，以及设置或动作的可逆性。
C.2.29.5 | 医疗器械是否显示信息？ | 考虑：
 |  | 各种环境中的可视性，方向，用户的视觉能力，人口和观点，所呈现信息的清晰度，单位，颜色编码以及关键信息的可访问性。
C.2.29.6 | 医疗器械是否由菜单控制？ | 考虑:
 |  | 复杂性和层数，状态意识，设置位置，导航方法，每个动作的步数，序列清晰度和记忆问题，控制功能相对于其可访问性的重要性以及偏离指定操作程序的影响。
C.2.29.7 | 医疗器械是否由具有特殊需要的人使用？ | 考虑:
 |  | 使用者，他们的精神和身体能力，技能和培训，人体工程学方面，使用环境，安装要求以及患者控制或影响医疗设备使用的能力。 应特别关注残疾人，老年人，儿童等有特殊需求的用户。 他们的特殊需求可能包括另一个人的帮助，以便使用医疗设备。 医疗器械是否打算供具有不同技术水平和文化背景的人使用？
C.2.29.8 | 用户界面能否用于启动使用者动作? | 考虑：启动一个有意的动作以便用户进入受控操作模式的可能性，增加了患者的风险并且为用户提供了这种情况的意识。
C.2.30 | 医疗器械是否使用报警系统？ | 考虑:
 |  | 是否存在误报，漏报，断电报警系统，不可靠的远程报警系统，以及医务人员了解报警系统工作原理的可能性。 报警系统的指导在IEC 60601-1-8中给出。
C.2.31 | 医疗器械可能以什么方式被故意地误用？ | 考虑:
 |  | 连接器使用不正确，禁用安全功能或警报，忽视制造商推荐的维护。
C.2.32 | 医疗器械是否持有患者护理的关键数据？ | 考虑：数据被修改或损坏的后果。
C.2.33 | 医疗器械是否预期为移动式或便携式？ | 应该考虑的因素是必要的把手，手柄，车轮，制动器，机械稳定性和耐久性。
C.2.34 | 医疗器械的使用是否依赖于基本性能？ | 考虑：例如，生命支持设备的输出特性或警报的操作。
 |  | 有关性能的讨论，请参见GB 9706.1（IEC60601-1-1）
