santan444/MS001/02-设计开发输入阶段/配置管理/MS-001配置管理计划及配置项列表V1.0(二阶).xls

Sheet: 封面
 |  | 文件号：MS001.01.101CF.1.0
MS-001
配置管理计划及配置项列表
 | 编制/日期： |  | 郭宏瑞/2020.10.29
 | 审核/日期： |  | 童睿/2020.10.29
 | 批准/日期： |  | 陈汉清/2020.10.29
杭州三坛医疗科技有限公司

Sheet: 文档修订页
文档更改履历
日期 | 版本号 | 修订章节 | 描述 | 作者 | 评审者 | 评审日期 | 批准
2020-09-18 | V0.1 | 初稿 | 初步制定本项目配置计划 | 郭宏瑞 | / | / | /
2020-10-29 | V1.0 | 全文 | 制定本项目配置管理计划；基线时间计划 | 郭宏瑞 | 童睿 |  | 陈汉清 | （二阶）

Sheet: 1.组织和职责
1.组织和职责
角色 | 承担者 | 职责 | 工作频度
配置管理员 | 郭宏瑞 | 1.根据项目特点制定项目配置管理计划； 2.配合项目经理识别项目生命周期过程各个阶段的配置项； 3.根据项目生命周期确定项目基线计划； 4.配置服务器日常管理； 5.创建配置基线,跟踪和管理变更过程； 6.向项目经理报告当前配置状态； 7.程序发布执行； 8.跟踪并解决相关的配置问题。 | 每阶段/事件触发
产品经理/项目经理 | 郭宏瑞 | 1.批准配置项的标志，以及软件基线的建立； 2.制定访问控制策略； 3.建立、更改基线的设置，审核变更申请； 4.根据配置管理员的报告决定相应的对策； 5.审核项目配置管理计划； 6.审核配置项的发布； 7.接受配置状态报告； 8.跟踪并解决相关的配置问题。 | 每阶段/事件触发
项目负责人 | 童睿 | 1.审批项目配置管理计划,发布配置计划； 2.审批配置项的发布； 3.接受配置状态报告； 4.解决配置管理问题； 5.批准产品版本发布。 | 每阶段/事件触发

Sheet: 2.配置项标识规定
2.配置项标识规定
技术文档
标识规定 | 项目名称(简称) + 文档类型名称
说明 | 技术类文档包括：技术需求说明书/设计文档/测试类文档
举例 | MS-001技术需求说明书
技术讨论记录
标识规定 | 项目名称(简称) +文档类型名称+记录日期
说明 | 项目名称：项目启动阶段，依据项目立项报告定义
 | 文档类型名称：技术讨论记录表示管理文档的类别为技术讨论记录
 | 讨论日期:为讨论的时间(格式为4位的年2位的月2为的日如20050718)
举例 | MS-001技术讨论记录_20050914
项目管理文档
项目计划
标识规定 | 项目名称(简称) + 项目计划+（版本号）
说明 | 文档类型名称：如概要设计说明书,详细设计说明书
 | 项目名称：项目启动阶段，依据项目立项报告定义
 | 括号内版本号为可选项 如：进度计划选用（无法添加历史修改页）
举例 | MS-001开发计划书.doc、MS-001开发计划V1.0.mpp
会议纪要
标识规定 | 项目名称(简称) + 会议纪要 +开会日期
说明 | 项目名称：项目启动阶段，依据项目立项报告定义
 | 文档类型名称：会议纪要
举例 | MS-001会议记要_20051010
项目月报/周报
标识规定 | 项目名称(简称)+文档类别+ 日期
说明 | 项目名称：项目启动阶段，依据项目立项报告定义。
 | 项目周报:表示管理文档的类别为项目周报
 | 提交日期：8位
举例 | MS-001周报_20051010
工程实施
标识规定 | 项目名称(简称) +客户名称(简称)+文件类型
说明 | 工程类实施文档包括:割接方案/上线报告/安装调试报告等工程类关键性文档
 | 项目名称：项目启动阶段，依据项目立项报告定义。
举例 | MS-001某某医院上线报告.doc
软件发布标识
文档版本号命名规则(适用修改历史页版本命名)
标识规定 | VX.Y.
说明 | 内部版本号：
 | X – 与发布版本对应
 | Y – 与增量、修正对应
 | 说明: 文档初始版本号为0.1，发布初始版本为1.0 ，
 | 若这次版本与上一个版本相比，发布新的版本，则X增2，Y置0；
 | 若这次版本与上一个版本相比，存在增量、修正，则Y增1.
举例 | V2.0 ；V1.1
代码版本命名规则
标识规定 | 版本号=vX.Y.Z.B
说明
举例 | v1.0.0.1

Sheet: 3.配置库说明
3.配置库说明
文档工程-配置库目录结构
一级目录 |  | 二级目录 |  | 备注说明 | 操作权限
MS-001 骨科手术导航与反馈系统 |  |  |  | 顶级目录，产品编号及名称 | 仅配置管理员读写
 |  | 01-设计开发策划阶段 |  | 针对策划阶段（一阶）文档，例如产品开发提议、可行性分析等
 |  | 02-设计开发输入阶段 |  | 针对输入阶段（二阶）文档，例如产品技术需求、风险管理计划等
 |  | 03-设计开发输出阶段 |  | 针对输出阶段（三阶）文档，例如概要设计说明书、详细设计说明书、单元测试报告、集成测试报告等
 |  | 04-设计开发验证与确认阶段 |  | 针对验证与确认阶段（四阶）文档，例如用户测试报告等
 |  | 05-设计开发注册申报阶段 |  | 注册申报阶段（五阶），例如注册检验报告、临床评价资料等
 |  | 06-设计开发量产阶段 |  | 量产阶段（六阶），上市及上市后产生的文档
注:1.一级二级目录均不可更改，三级目录以上可再进行扩展；2.文档工程中不允许存放开发工具软件包等，请将开发工具软件包存放在“研发中心/09-工作软件”目录下。避免工具包占用配置库主机空间，备份时间周期过长。
工作环境及使用工具说明
类别 | 工具/环境/配置要求 |  | 地址 |  | 维护负责人
需求管理 | Excel/Word |  | / |  | 郭宏瑞
缺陷跟踪 | Excel |  | / |  | 郭宏瑞
配置管理 | Excel/Word |  | / |  | 郭宏瑞
编码工具 | Microsoft Visual Studio |  | / |  | /
发布站点 | U盘 |  | / |  | 郭宏瑞
版本控制 | 文档工程：移动硬盘 |  | / |  | 郭宏瑞
 | 代码工程：Gitlab |  | http://192.168.2.252:7080/MS-001 |  | 戴维焕
代码工程-配置库操作权限分配举例说明
master分支 | master | 用途 | 主分支，产品的功能全部实现后，最终在master分支对外发布。
 |  | 数据来源 | 初始创建；从其他分支(develop)合并。
 |  | 权限 | 该分支为开发负责人可以读写，其他开发人员只读； 另外所有在master分支的推送应该打标签做记录，方便追溯。
develop分支 | develop | 用途 | 开发分支，该分支为所有开发人员日常提交的分支； 按项目进展阶段性，进行提测。
 |  | 数据来源 | 基于master分支克隆。
 |  | 权限 | 该分支为所有开发人员可读写，测试人员只读。
配置库操作权限分组举例说明
大域 | 名称 | 权限分组名称 | 权限分组说明
文档域 | MS-001 骨科手术导航与反馈系统 | / | /
代码域（Gitlab） | MS-001 | Guest | Gitlab用户在组中有五种权限：Guest、Reporter、Developer、Master、Owner Guest：可以创建issue、发表评论，不能读写版本库
 |  | Reporter | Reporter：可以克隆代码，不能提交，QA、PM可以赋予这个权限
 |  | Developer | Developer：可以克隆代码、开发、提交、push，RD可以赋予这个权限
 |  | Master | Master：可以创建项目、添加tag、保护分支、添加项目成员、编辑项目，核心RD负责人可以赋予这个权限
 |  | Owner | Owner：可以设置项目访问权限 - Visibility Level、删除项目、迁移项目、管理组成员，开发组leader可以赋予这个权限。
 |  |  | Gitlab中的组和项目有三种访问权限：Private、Internal、Public Private：只有组成员才能看到 Internal：只要登录的用户就能看到 Public：所有人都能看到

Sheet: 4.基线计划
4.基线计划
基线标识 | 基线名称 | 计划创建日期
MS-001策划基线V1.0 | 策划基线 | 2020-09-18
MS-001输入基线V1.0 | 输入基线 | 2020-10-29
MS-001输出基线V1.0 | 输出基线 | 2020年12月
MS-001验证确认基线V1.0 | 验证确认基线 | 2021年1月

Sheet: 5.配置项计划
5.配置项计划
1.文档类配置项 |  |  |  |  |  | 按阶段进行配置
1.1技术类文档
# | 配置项名称 | 责任人 | 是否纳入基线 | 进入基线条件 | 计划入库日期 | 所属基线
1 | 开发提议书 | 产品经理 | 是 | 评审通过 | 2020-09-18 | 策划基线 | 一阶策划
2 | 市场可行性分析 | 产品经理 | 是 | 评审通过 | 2020-09-18 | 策划基线
3 | 技术可行性分析 | 系统工程师 | 是 | 评审通过 | 2020-09-18 | 策划基线
4 | 市场竞品情况 | 质量经理 | 是 | 评审通过 | 2020-09-18 | 策划基线
5 | 学术调研分析 | 学术专员 | 是 | 评审通过 | 2020-09-18 | 策划基线
6 | 专利分析 | 知识产权专员 | 是 | 评审通过 | 2020-09-18 | 策划基线
7 | 用户需求 | 产品经理 | 是 | 评审通过 | 2020-10-29 | 输入基线 | 二阶输入
8 | 可用性需求评估 | 产品经理 | 是 | 评审通过 | 2020-10-29 | 输入基线
9 | 可用性任务分析 | 产品经理 | 是 | 评审通过 | 2020-10-29 | 输入基线
10 | 可用性分析报告 | 产品经理 | 是 | 评审通过 | 2020-10-29 | 输入基线
11 | 产品技术需求说明书（软件、硬件、结构） | 系统工程师 | 是 | 评审通过 | 2020-10-29 | 输入基线
12 | 硬件/嵌软概要设计说明书 | 电子/嵌软工程师 | 是 | 评审通过 | 2020年12月 | 输出基线 | 三阶输出
13 | 结构概要设计说明书 | 结构工程师 | 是 | 评审通过 | 2020年12月 | 输出基线
14 | 结构ID外观效果图（配色方案图） | 结构工程师 | 是 | 评审通过 | 2020年12月 | 输出基线
15 | 软件概要设计说明书 | 软件工程师 | 是 | 评审通过 | 2020年12月 | 输出基线
16 | 结构设计失效模式分析 | 结构工程师 | 是 | 评审通过 | 2020年12月 | 输出基线
17 | 硬件设计失效模式分析 | 硬件/嵌软工程师 | 是 | 评审通过 | 2020年12月 | 输出基线
18 | 软件设计FTA风险分析 | 软件工程师 | 是 | 评审通过 | 2020年12月 | 输出基线
19 | 软件系统测试方案及用例 | 软件测试工程师 | 是 | 评审通过 | 2020年12月 | 输出基线
20 | 整机测试计划\方案 | 系统工程师 | 是 | 评审通过 | 2020年12月 | 输出基线
21 | 硬件/嵌软详细设计说明书 | 电子/嵌软工程师 | 是 | 评审通过 | 2020年12月 | 输出基线
22 | 硬件关键零部件测试验证方案及报告 | 电子工程师 | 是 | 评审通过 | 2020年12月 | 输出基线
23 | 嵌软代码评审记录 | 嵌软工程师 | 是 | 评审通过 | 2020年12月 | 输出基线
24 | 硬件BOM | 硬件工程师 | 是 | 评审通过 | 2020年12月 | 输出基线
25 | 电气原理图 | 硬件工程师 | 是 | 评审通过 | 2020年12月 | 输出基线
26 | 电气绝缘图 | 硬件工程师 | 是 | 评审通过 | 2020年12月 | 输出基线
27 | SMT装配图 | 硬件工程师 | 是 | 评审通过 | 2020年12月 | 输出基线
28 | PCB原理图（Gerber文件/坐标文件） | 硬件工程师 | 是 | 评审通过 | 2020年12月 | 输出基线
29 | PCB加工工艺要求 | 硬件工程师 | 是 | 评审通过 | 2020年12月 | 输出基线
30 | 布线图 | 硬件工程师 | 是 | 评审通过 | 2020年12月 | 输出基线
31 | 接线图 | 硬件工程师 | 是 | 评审通过 | 2020年12月 | 输出基线
32 | 硬件调试指导书 | 硬件工程师 | 是 | 评审通过 | 2020年12月 | 输出基线
33 | 硬件测试方案/报告 | 硬件工程师 | 是 | 评审通过 | 2020年12月 | 输出基线
34 | 结构详细设计说明书 | 结构工程师 | 是 | 评审通过 | 2020年12月 | 输出基线
35 | 结构关键零部件测试验证方案及报告 | 结构工程师 | 是 | 评审通过 | 2020年12月 | 输出基线
36 | 结构BOM | 结构工程师 | 是 | 评审通过 | 2020年12月 | 输出基线
37 | 详细结构设计图（2D/3D） | 结构工程师 | 是 | 评审通过 | 2020年12月 | 输出基线
38 | 包装设计图 | 结构工程师 | 是 | 评审通过 | 2020年12月 | 输出基线
39 | 结构组装报告 | 结构工程师 | 是 | 评审通过 | 2020年12月 | 输出基线
40 | 软件详细设计说明书 | 软件工程师 | 是 | 评审通过 | 2020年12月 | 输出基线
41 | 软件测试方案/用例/报告 | 软件工程师 | 是 | 评审通过 | 2020年12月 | 输出基线
42 | 软件代码评审记录 | 软件工程师 | 是 | 评审通过 | 2020年12月 | 输出基线
43 | 软件评审记录 | 软件工程师 | 是 | 评审通过 | 2020年12月 | 输出基线
44 | 软件缺陷管理记录 | 软件工程师 | 是 | 评审通过 | 2020年12月 | 输出基线
45 | 关键物料规格书 | 研发负责人 | 是 | 评审通过 | 2020年12月 | 输出基线
46 | 工装设计图纸 | 结构工程师 | 是 | 评审通过 | 2020年12月 | 输出基线
47 | 原理样机制作/调试记录 | 研发负责人 | 是 | 评审通过 | 2020年12月 | 输出基线
48 | 生产作业指导书 | 研发负责人 | 是 | 评审通过 | 2020年12月 | 输出基线
49 | 检验指导书 | 研发负责人 | 是 | 评审通过 | 2020年12月 | 输出基线
50 | 工艺流程图(含质量/工艺控制点） | 研发负责人 | 是 | 评审通过 | 2020年12月 | 输出基线
51 | 产品说明书 | 产品经理 | 是 | 评审通过 | 2020年12月 | 输出基线
52 | 产品技术要求 | 产品经理 | 是 | 评审通过 | 2020年12月 | 输出基线
53 | 工程样机生产记录/验证方案 | 生产负责人 | 是 | 评审通过 | 2021年1月 | 验证确认基线
54 | 关键工序验证 | 生产负责人 | 是 | 评审通过 | 2021年1月 | 验证确认基线
55 | 生产/检验相关软件验证报告 | 生产负责人 | 是 | 评审通过 | 2021年1月 | 验证确认基线
56 | 使用期限验证 | 生产负责人 | 是 | 评审通过 | 2021年1月 | 验证确认基线
57 | 机械试验 | 生产负责人 | 是 | 评审通过 | 2021年1月 | 验证确认基线
58 | 环境试验 | 生产负责人 | 是 | 评审通过 | 2021年1月 | 验证确认基线
59 | 性能测试摸底测试（EMC、安规） | 生产负责人 | 是 | 评审通过 | 2021年1月 | 验证确认基线
60 | 生物相容性 | 生产负责人 | 是 | 评审通过 | 2021年1月 | 验证确认基线
61 | 可用性验证方案及计划/报告 | 临床负责人 | 是 | 评审通过 | 2021年1月 | 验证确认基线
62 | 可用性确认方案及计划/报告 | 临床负责人 | 是 | 评审通过 | 2021年1月 | 验证确认基线
63 | 可用性分析报告 | 临床负责人 | 是 | 评审通过 | 2021年1月 | 验证确认基线
64 | 体模试验方案/报告 | 临床负责人 | 是 | 评审通过 | 2021年1月 | 验证确认基线
65 | 动物/尸体试验方案/报告 | 临床负责人 | 是 | 评审通过 | 2021年1月 | 验证确认基线
66 | 试产样机制作与评估 | 生产负责人 | 是 | 评审通过 | 2021年1月 | 验证确认基线
67 | 注册检验报告 | 注册经理 | 是 | 评审通过 | 2023年8月 | 五阶注册基线
68 | 临床评价 | 注册经理 | 是 | 评审通过 | 2023年8月 | 五阶注册基线
69 | 注册申报 | 注册经理 | 是 | 评审通过 | 2023年8月 | 五阶注册基线
70 | 产品备案凭证/注册证 | 注册经理 | 是 | 评审通过 | 2023年8月 | 五阶注册基线
71 | 生产备案凭证/许可证 | 注册经理 | 是 | 评审通过 | 2023年8月 | 五阶注册基线
包括:需求规格书/设计文档/测试文档/数据库脚本等,当然每个阶段这些的变量部分作为新配置项识别
1.2管理类文档
# | 配置项名称 | 责任人 | 是否纳入基线 | 进入基线条件 | 计划入库日期 | 所属基线
1 | 任命书 | 项目经理 | 是 | 评审通过 | 2020-09-18 | 策划基线
2 | 项目立项报告 | 产品经理 | 是 | 评审通过 | 2020-09-18 | 策划基线 | 那时程序还没有定义DCP，无需DCP报告
3 | 设计与开发策划计划 | 项目经理 | 是 | 评审通过 | 2020-09-18 | 策划基线
4 | 设计开发计划书 | 项目经理 | 是 | 评审通过 | 2020-10-29 | 输入基线
5 | 里程碑事件进展表 | 项目经理 | 是 | 项目经理确认 | / | 当前所属基线
6 | 风险管理计划 | 产品经理 | 是 | 评审通过 | 2020-10-29 | 输入基线
7 | 风险评估和控制记录 | 产品经理 | 是 | 评审通过 | 2020-10-29 | 输入基线
8 | 风险管理报告 | 产品经理 | 是 | 评审通过 | 2020-10-29 | 当前所属基线
9 | 网络安全风险管理计划 | 产品经理 | 是 | 评审通过 | 2020年12月 | 输出基线
10 | 软件生存周期计划 | 开发经理 | 是 | 评审通过 | 2020年12月 | 输出基线
11 | 配置管理计划 | 配置管理员 | 是 | 评审通过 | 2020-10-29 | 输入基线
12 | 配置审计报告 | 配置管理员 | 是 | 项目经理确认 | 2020-10-29 | 输入基线
13 | 配置项状态报告 | 配置管理员 | 是 | 项目经理确认 | 2020-10-29 | 输入基线
14 | 可追溯性分析 | 项目经理 | 是 | 评审通过 | 2020年12月 | 输出基线
15 | 变更申请单 | 产品经理 | 是 | 评审通过 | / | 当前所属基线
16 | 更改通知单 | 产品经理 | 是 | 评审通过 | / | 当前所属基线
17 | 会议记录 | 项目经理 | 是 | 项目经理确认 | / | 当前所属基线
包括:项目计划,配置计划,会议纪要等
1.3第三方相关
# | 配置项名称 | 责任人 | 是否纳入基线 | 进入基线条件 | 计划入库日期 | 所属基线
1 | 现成软件验证报告 | 配置管理员 | 是 | 评审通过 | / | 当前所属基线
2 | 现成软件评估 | 配置管理员 | 是 | 评审通过 | / | 当前所属基线
3 | 现成软件列表 | 配置管理员 | 是 | 项目经理确认 | / | 当前所属基线
4 | 第三方依赖库 | 配置管理员 | 是 | 评审通过 | / | 当前所属基线
包括:和相关小组交互的第三方文档、工具、平台、插件等等,这些输入或者输出直接对项目产生一定的影响,相关小组包括:本公司其他项目或者部门,用户,第三方厂家
1.4工程类文档
# | 配置项名称 | 责任人 | 是否纳入基线 | 进入基线条件 | 计划入库日期 | 所属基线
1 | / | /
包括:项目的割接方案/上线计划/安装调试报告/上线报告等等工程文档
2代码类配置项
# | 配置项名称 | 责任人 | 是否纳入基线 | 进入基线条件 | 计划入库日期 | 所属基线
1 | 源代码 | 开发经理 | 是 | 测试通过 | / | 输出基线
包括:产品的源代码/编译环境/ 要求:颗粒度保持在模块级别,不需要列出具体的配置项名称，只需要说明此子目录下存放的哪类配置项，如“子服务前台”
公共部分说明： 1.识别阶段和生命周期的各个阶段保持一致，如果在设计阶段识别的配置项，那么这个识别阶段就是设计阶段 2.进入基线条件：其实任何一个配置项纳入配置库必须经过评审/验证/或者确认才能纳入基线库，例如需求规格书必须经过评审，工程类文档只要项目经理确认，对于代码类配置项必须经常测试进行验证

Sheet: 6.配置变更流程
6.基本变更流程
按照ST-QSP-39《更改控制程序》执行

Sheet: 7.源码管理流程
6.基本变更流程
按照ST-QSP-39《更改控制程序》执行
7.源码管理流程
 | 注：以下流程供项目组参考，配置管理与项目组定义源码管理流程
 | 主要工作流程 1 . 初始化项目为gitflow , 默认创建master分支 , 然后从master拉取第一个develop分支 2 . 从develop拉取feature分支进行编码开发(多个开发人员拉取多个feature同时进行并行开发 , 互不影响) 3 . feature分支完成后 , 合并到develop(不推送 , feature功能完成还未提测 , 推送后会影响其他功能分支的开发) 合并feature到develop , 可以选择删除当前feature , 也可以不删除 . 但当前feature就不可更改了 , 必须从release分支继续编码修改 4 . 从develop拉取release分支进行提测 , 提测过程中在release分支上修改BUG 5 . release分支上线后 , 合并release分支到develop/master并推送 合并之后 , 可选删除当前release分支 , 若不删除 , 则当前release不可修改 . 线上有问题也必须从master拉取hotfix分支进行修改 6 . 上线之后若发现线上BUG , 从master拉取hotfix进行BUG修改 7 . hotfix通过测试上线后 , 合并hotfix分支到develop/master并推送 合并之后 , 可选删除当前hostfix , 若不删除 , 则当前hotfix不可修改 , 若补丁未修复 , 需要从master拉取新的hotfix继续修改 8 . 当进行一个feature时 , 若develop分支有变动 , 如其他开发人员完成功能并上线 , 则需要将完成的功能合并到自己分支上 即合并develop到当前feature分支 9 . 当进行一个release分支时 , 若develop分支有变动 , 如其他开发人员完成功能并上线 , 则需要将完成的功能合并到自己分支上 即合并develop到当前release分支 (!!! 因为当前release分支通过测试后会发布到线上 , 如果不合并最新的develop分支 , 就会发生丢代码的情况)

Sheet: 8.日常工作计划
8.日常工作计划
配置审计计划
审计频率 | 1次/阶段
审计人 | 配置管理员
审计内容 | 1、项目组成员配置活动的规范性检查（检入、检出等） 2、配置项变更过程及记录 3、基线完整性及变更过程和记录
配置状态报告发布计划
发布频率 | 1次/阶段
发布人 | 配置管理员
发布对象 | 项目管理人员（PM，各小组组长）
配置库维护计划
维护频率 | 巡检： 1次/阶段 备份：代码配置库每天自动备份
维护人 | 配置管理员
维护内容 | 配置库巡检，确保配置库正常
注：表中蓝字部分为范例，项目组使用时依据实际情况填写。
