santan444/MS001/03-设计开发输出阶段/03软件/04软件测试/MS-001缺陷记录表(各版本;新老编号映射).xlsx

Sheet: 规划软件缺陷汇总表
软件名称 | 版本号 | 原始BugID | 修改后Bug编号 | 严重程度 | 标题 | 状态 | 解决方式 | 备注
规划软件 | v1.0.0.9 | 195 | 1 | 2 | 配准-单节脊柱配准过程中，还能进行其他操作 | 已关闭 | / | 激活4个，关闭13个
 | v1.0.0.9 | 263 | 2 | 2 | 参数设置connect参数为1，软件重启后不能自动连接 | 已关闭 | /
 | v1.0.0.9 | 327 | 3 | 2 | 导出数据到u盘没判断u盘空间 | 已关闭 | /
 | v1.0.0.9 | 338 | 4 | 1 | X光分区页面重复校准正侧位X光片，点下一步，软件崩溃 | 已关闭 | /
 | v1.0.0.9 | 357 | 5 | 2 | 数据管理模块：2D图、3D图移动到窗口外面，无法恢复 | 已关闭 | /
 | v1.0.0.9 | 352 | 6 | 2 | 规划页面的2D图、3D图移动到窗口外面，无法恢复 | 已关闭 | /
 | v1.0.0.9 | 351 | 7 | 3 | 切割：上一步有弹框 | 已关闭 | /
 | v1.0.0.9 | 193 | 8 | 2 | CT分区与X光分区后，椎体标记无交集，点击X光分区页面下一步，无任何提示信息 | 已关闭 | /
 | v1.0.0.9 | 344 | 9 | 1 | 规划页面导出的数据是.dat格式，导致无法导入，后面改为Santan_CT224711_4格式 | 已关闭 | /
 | v1.0.0.9 | 354 | 10 | 3 | CT分区页面，修改分区信息，点击上一步，有弹框提示 | 已关闭 | /
 | v1.0.0.9 | 355 | 11 | 3 | 规划页面，修改规划信息，点击上一步，有弹框提示 | 已关闭 | /
 | v1.0.0.9 | 356 | 12 | 3 | X光分区页面，调整分区线角度或删除分区线，点击上一步，有弹框提示 | 已关闭 | /
 | v1.0.0.9 | 306 | 13 | 1 | X-Ray分区界面，顺/逆时针旋转X光片，点击下一步，进入配准界面时软件崩溃 | 已关闭 | /
 | v1.0.0.9 | 353 | 14 | 1 | 切割复位页面的2D图、3D图移动到窗口外面，无法恢复 | 已激活 | /
 | v1.0.0.9 | 363 | 15 | 2 | U盘导入CT，导入完成，拔出U盘，点击下一步，切割复位页面报错，视图窗口显示的是windows桌面 | 已激活 | /
 | v1.0.0.9 | 362 | 16 | 3 | 切割复位页面ctrl+右键是调整窗宽窗位，应该是放大缩小 | 已激活 | /
 | v1.0.0.9 | 361 | 17 | 2 | 配准页面的颜色无法修改 | 已激活 | /
 | v1.0.0.10 | 352 | 14 | 1 | 切割复位页面的2D图、3D图移动到窗口外面，无法恢复 | 已关闭 | / | 激活2个，关闭4个
 | v1.0.0.10 | 363 | 15 | 2 | U盘导入CT，导入完成，拔出U盘，点击下一步，切割复位页面报错，视图窗口显示的是windows桌面 | 已关闭 | /
 | v1.0.0.10 | 362 | 16 | 3 | 切割复位页面ctrl+右键是调整窗宽窗位，应该是放大缩小 | 已关闭 | /
 | v1.0.0.10 | 361 | 17 | 2 | 配准页面的颜色无法修改 | 已关闭 | /
 | v1.0.0.10 | 366 | 18 | 2 | v1.0.0.10的版本上还有【模拟加载】的按钮，需要去掉 | 已激活 | /
 | v1.0.0.10 | 120 | 19 | 3 | 切割界面，骨块名称可以使用“！￥……（）-；。”命名，修复后无法输入这些字符 | 已激活 | /
 | v1.0.0.11 | 366 | 18 | 2 | v1.0.0.10的版本上还有【模拟加载】的按钮，需要去掉 | 已关闭 | / | 激活8个，关闭2个
 | v1.0.0.11 | 120 | 19 | 3 | 切割界面，骨块名称可以使用“！￥……（）-；。”命名，修复后无法输入这些字符 | 已关闭 | /
 | v1.0.0.11 | 602 | 20 | 2 | CT分区、X光分区界面调节分区线角度后，移动左右两侧线，出现分区线交叉(CT分区 | 已激活 | /
 | v1.0.0.11 | 604 | 21 | 2 | 进入切割复位前，CT序列不完整，导入成功，CT显示不全，改为检查序列数据完整性，CT数据不完整给出提示 | 已激活 | /
 | v1.0.0.11 | 606 | 22 | 3 | X光分区界面只接收正位图，可点击下一步进入配准界面 | 已激活 | /
 | v1.0.0.11 | 317 | 23 | 1 | 修改了X-ray外参不会更新的问题 | 已激活 | /
 | v1.0.0.11 | 700 | 24 | 1 | 规划页面，胸椎和腰椎规划的螺钉名称错误 | 已激活 | /
 | v1.0.0.11 | 701 | 25 | 3 | 规划页面，M5 U型螺钉去掉 | 已激活 | /
 | v1.0.0.11 | 702 | 26 | 1 | 移动、旋转、放大缩小新增三个参数，可控制微调按钮调整幅度 | 已激活 | /
 | v1.0.0.11 | 705 | 27 | 1 | 图像配准页面，CT与X光全部显示出来，只显示一节不方便观察配图效果 | 已激活 | /
 | v1.0.0.12 | 602 | 20 | 2 | CT分区、X光分区界面调节分区线角度后，移动左右两侧线，出现分区线交叉(CT分区 | 已关闭 | / | 激活0个，关闭8个
 | v1.0.0.12 | 604 | 21 | 2 | 进入切割复位前，CT序列不完整，导入成功，CT显示不全，改为检查序列数据完整性，CT数据不完整给出提示 | 已关闭 | /
 | v1.0.0.12 | 606 | 22 | 3 | X光分区界面只接收正位图，可点击下一步进入配准界面 | 已关闭 | /
 | v1.0.0.12 | 317 | 23 | 1 | 修改了X-ray外参不会更新的问题 | 已关闭 | /
 | v1.0.0.12 | 700 | 24 | 1 | 规划页面，胸椎和腰椎规划的螺钉名称错误 | 已关闭 | /
 | v1.0.0.12 | 701 | 25 | 3 | 规划页面，M5 U型螺钉去掉 | 已关闭 | /
 | v1.0.0.12 | 702 | 26 | 1 | 移动、旋转、放大缩小新增三个参数，可控制微调按钮调整幅度 | 已关闭 | /
 | v1.0.0.12 | 705 | 27 | 1 | 图像配准页面，CT与X光全部显示出来，只显示一节不方便观察配图效果 | 已关闭 | /

Sheet: 导引软件缺陷汇总表
软件名称 | 版本号 | 原始BugID | 修改后Bug编号 | 严重程度 | 标题 | 状态 | 解决方式 | 备注
导引软件 | v1.0.0.6 | 224 | 28 | 3 | 导引软件接收的螺钉定位消息，螺钉序号获取错误 | 已关闭 | / | 激活2个，关闭4个
 | v1.0.0.6 | 244 | 29 | 2 | 正侧位复位完成，提示内部错误 | 已关闭 | /
 | v1.0.0.6 | 269 | 30 | 2 | 导引软件X光片校准失败，提示仿真失败，关节3在其零点两侧 | 已关闭 | /
 | v1.0.0.6 | 318 | 31 | 1 | 正侧位校准，校准成功后精度值显示的是上次校准的值 | 已关闭 | /
 | v1.0.0.6 | 274 | 32 | 2 | 配准页面，配准完成，没点确认，进入定位发螺钉定位，提示分椎错误 | 已激活 | /
 | v1.0.0.6 | 289 | 33 | 2 | 规划软件不在配准页面或者X光分区页面，导引软件校准X光，也会校准成功，应提示校准失败 | 已激活 | /
 | v1.0.0.7 | 274 | 32 | 2 | 配准页面，配准完成，没点确认，进入定位发螺钉定位，提示分椎错误 | 已关闭 | / | 激活10个，关闭2个
 | v1.0.0.7 | 289 | 33 | 2 | 规划软件不在配准页面或者X光分区页面，导引软件校准X光，也会校准成功，应提示校准失败 | 已关闭 | /
 | v1.0.0.7 | 266 | 34 | 2 | 3D未连接，校准超时，提示激光定位：定位中 | 已激活 | /
 | v1.0.0.7 | 358 | 35 | 1 | 导引软件姿态仿真卡死，仿真模型未运动 | 已激活 | /
 | v1.0.0.7 | 359 | 36 | 1 | 机械臂控制页面，关闭机械臂，自动连接后，点水平对齐，踩脚踏，弹框提示机械臂断开连接 | 已激活 | /
 | v1.0.0.7 | 360 | 37 | 1 | 机械臂水平对齐运动到位后，再点击水平对齐，踩脚踏，软件提示“机械臂断开连接” | 已激活 | /
 | v1.0.0.7 | 364 | 38 | 2 | 机械臂未完全上电，进入工具选择，选择工具提示mark球加载失败，机械臂完全上电后，选工具还是mark球加载失败 | 已激活 | /
 | v1.0.0.7 | 367 | 39 | 2 | 校准、仿真日志内的开始时间和截止时间打印的是秒，导致仿真起始时间和结束时间的时间戳一样，看不出计算时间 | 已激活 | /
 | v1.0.0.7 | 403 | 40 | 3 | 3维主机和二维主机网络互通-自动连接值为0-启动三维软件，无法自动重连 | 已激活 | /
 | v1.0.0.7 | 404 | 41 | 1 | 3D-踩脚踏-发送螺钉1-点螺钉定位-机械臂可以运动 | 已激活 | /
 | v1.0.0.7 | 408 | 42 | 1 | 发送一个3D/2D定位指令-仿真中-进行3D/2D定位也能进行 | 已激活 | /
 | v1.0.0.7 | 580 | 43 | 1 | 导引软件MinArea的值不能修改为500以上的数值 | 已激活 | /
 | v1.0.0.8 | 266 | 34 | 2 | 3D未连接，校准超时，提示激光定位：定位中 | 已关闭 | / | 关闭10个
 | v1.0.0.8 | 358 | 35 | 1 | 导引软件姿态仿真卡死，仿真模型未运动 | 已关闭 | /
 | v1.0.0.8 | 359 | 36 | 1 | 机械臂控制页面，关闭机械臂，自动连接后，点水平对齐，踩脚踏，弹框提示机械臂断开连接 | 已关闭 | /
 | v1.0.0.8 | 360 | 37 | 1 | 机械臂水平对齐运动到位后，再点击水平对齐，踩脚踏，软件提示“机械臂断开连接” | 已关闭 | /
 | v1.0.0.8 | 364 | 38 | 2 | 机械臂未完全上电，进入工具选择，选择工具提示mark球加载失败，机械臂完全上电后，选工具还是mark球加载失败 | 已关闭 | /
 | v1.0.0.8 | 367 | 39 | 2 | 校准、仿真日志内的开始时间和截止时间打印的是秒，导致仿真起始时间和结束时间的时间戳一样，看不出计算时间 | 已关闭 | /
 | v1.0.0.8 | 403 | 40 | 3 | 3维主机和二维主机网络互通-自动连接值为0-启动三维软件，无法自动重连 | 已关闭 | /
 | v1.0.0.8 | 404 | 41 | 1 | 3D-踩脚踏-发送螺钉1-点螺钉定位 | 已关闭 | /
 | v1.0.0.8 | 408 | 42 | 1 | 发送一个3D/2D定位指令-仿真中-进行3D/2D定位也能进行 | 已关闭 | /
 | v1.0.0.8 | 580 | 43 | 1 | 导引软件MinArea的值不能修改为500以上的数值 | 已关闭 | /
