santan444/MS001/03-设计开发输出阶段/03软件/03单元测试/导引软件/MS-001导引软件单元测试用例.xlsx

Sheet: 封面
MS-001
导引软件单元测试用例
 | 编制/时间：
 | 审核/时间：
 | 批准/时间：
 | 杭州三坛医疗科技有限公司

Sheet: 文档履历
文档更改履历
版本号 | 发布/实施日期 | 更改内容概述 | 更改者
V1.0 |  | 文件新编

Sheet: 01校准
01校准
测试用例ID | 测试用例 | 测试名称 | 判断 | 输入项目
B-UT0101001 | MarkerRegistrationTest | RegistrationTest | 校准测试 | TEST_F(MarkerRegistrationTest, RegistrationTest)
B-UT0101002 |  | Pos2MatTest | 位置转为矩阵测试 | TEST_F(MarkerRegistrationTest, Pos2MatTest)
B-UT0101003 |  | QjkTest | Qjk运算测试 | TEST_F(MarkerRegistrationTest, QjkTest)
B-UT0101004 |  | SoftAssignTest | 软分配测试 | TEST_F(MarkerRegistrationTest, SoftAssignTest)
B-UT0101005 |  | FindMatchTest | 寻找匹配测试 | TEST_F(MarkerRegistrationTest, FindMatchTest)
B-UT0101006 |  | PoseUpdateTest | 更新姿态测试 | TEST_F(MarkerRegistrationTest, PoseUpdateTest)
B-UT0101007 |  | ProcessTest | 运行进程测试 | TEST_F(MarkerRegistrationTest, ProcessTest)
B-UT0101008 |  | SetNormalizeTransformParaTest | 设置归一化变换参数测试 | TEST_F(MarkerRegistrationTest, SetNormalizeTransformParaTest)
B-UT0101009 |  | SetInitialPoseParaTest | 设置初始化姿态参数测试 | TEST_F(MarkerRegistrationTest, SetInitialPoseParaTest)
B-UT0101010 |  | SetFocalLengthTest | 设置焦距测试 | TEST_F(MarkerRegistrationTest, SetFocalLengthTest)
B-UT0101011 |  | SetCostValueTest | 取值测试 | TEST_F(MarkerRegistrationTest, SetCostValueTest)
B-UT0102001 | calibrationProcessorTest | InitializeTest | 初始化测试 | TEST_F(calibrationProcessorTest, InitializeTest)
B-UT0102002 |  | PreparedTest | 准备测试 | TEST_F(calibrationProcessorTest, PreparedTest)
B-UT0102003 |  | CalibrateImageTest | 校准图像测试 | TEST_F(calibrationProcessorTest, CalibrateImageTest)
B-UT0102004 |  | UndistortPointTest | 校正点测试 | TEST_F(calibrationProcessorTest, UndistortPointTest)
B-UT0102005 |  | StartGetCoefficientTest | 开始获取系数测试 | TEST_F(calibrationProcessorTest, StartGetCoefficientTest)
B-UT0102006 |  | GetCoefficientTest | 获取系数测试 | TEST_F(calibrationProcessorTest, GetCoefficientTest)
B-UT0103001 | RobotRegistrationProcessorTest | IsCalibratedTest | 是否已校正测试 | TEST_F(RobotRegistrationProcessorTest, IsCalibratedTest)
B-UT0103002 |  | IsRegsiteredTest | 是否已校准测试 | TEST_F(RobotRegistrationProcessorTest, IsRegsiteredTest)
B-UT0103003 |  | IsFrontalRegsiteredTest | 是否已正位校准测试 | TEST_F(RobotRegistrationProcessorTest, IsFrontalRegsiteredTest)
B-UT0103004 |  | IsLateralRegsiteredTest | 是否已侧位校准测试 | TEST_F(RobotRegistrationProcessorTest, IsLateralRegsiteredTest)
B-UT0103005 |  | LastLocationTest | 返回当前位置测试 | TEST_F(RobotRegistrationProcessorTest, LastLocationTest)
B-UT0103006 |  | LastErrorTest | 返回当前错误测试 | TEST_F(RobotRegistrationProcessorTest, LastErrorTest)
B-UT0103007 |  | ArmPoseTest | 机械臂姿势测试 | TEST_F(RobotRegistrationProcessorTest, ArmPoseTest)
B-UT0103008 |  | XRayCalibratedTest | X光已校正测试 | TEST_F(RobotRegistrationProcessorTest, XRayCalibratedTest)
B-UT0103009 |  | CalibrateXRayTest | 校正X光测试 | TEST_F(RobotRegistrationProcessorTest, CalibrateXRayTest)
B-UT0103010 |  | CalibrateFrontalXRayTest | 正位X光校正测试 | TEST_F(RobotRegistrationProcessorTest, CalibrateFrontalXRayTest)
B-UT0103011 |  | CalibrateLateralXRayTest | 侧位X光校正测 | TEST_F(RobotRegistrationProcessorTest, CalibrateLateralXRayTest)
B-UT0103012 |  | SaveCalibratedXRayTest | 保存X光校正测试 | TEST_F(RobotRegistrationProcessorTest, SaveCalibratedXRayTest)
B-UT0103013 |  | SaveFrontalCalibratedXRayTest | 保存正位X光校正测试 | TEST_F(RobotRegistrationProcessorTest, SaveFrontalCalibratedXRayTest)
B-UT0103014 |  | SaveLateralCalibratedXRayTest | 保存侧位X光校正测试 | TEST_F(RobotRegistrationProcessorTest, SaveLateralCalibratedXRayTest)
B-UT0103015 |  | ArmFrontalRegistrationTest | 机械臂正位校准测试 | TEST_F(RobotRegistrationProcessorTest, ArmFrontalRegistrationTest)
B-UT0103016 |  | ArmLateralRegistrationTest | 机械臂侧位校准测试 | TEST_F(RobotRegistrationProcessorTest, ArmLateralRegistrationTest)
B-UT0103017 |  | Frontal2LateralMatrixTest | 正侧位关系矩阵测试 | TEST_F(RobotRegistrationProcessorTest, Frontal2LateralMatrixTest)
B-UT0103018 |  | LocatRayTest | 位置通道测试 | TEST_F(RobotRegistrationProcessorTest, LocatRayTest)
B-UT0103019 |  | Locat3dRayTest | 三维位置通道测试 | TEST_F(RobotRegistrationProcessorTest, Locat3dRayTest)
B-UT0103020 |  | ArmFrontalMatrixTest | 机械臂正位矩阵测试 | TEST_F(RobotRegistrationProcessorTest, ArmFrontalMatrixTest)
B-UT0103021 |  | ArmLateralMatrixTest | 机械臂侧位矩阵测试 | TEST_F(RobotRegistrationProcessorTest, ArmLateralMatrixTest)
B-UT0103022 |  | Mat2VectorTest | 矩阵转数组测试 | TEST_F(RobotRegistrationProcessorTest, Mat2VectorTest)
B-UT0103023 |  | Vector2MatTest | 数组转矩阵测试 | TEST_F(RobotRegistrationProcessorTest, Vector2MatTest)
B-UT0104001 | RobotWorkerTest | PreparedTest | 准备测试 | TEST_F(RobotWorkerTest, PreparedTest)
B-UT0104002 |  | SaveFrontalTest | 保存正位测试 | TEST_F(RobotWorkerTest, SaveFrontalTest)
B-UT0104003 |  | SaveLateralTest | 保存侧位测试 | TEST_F(RobotWorkerTest, SaveLateralTest)
B-UT0104004 |  | CalibrateFrontalTest | 正位校正测试 | TEST_F(RobotWorkerTest, CalibrateFrontalTest)
B-UT0104005 |  | CalibratelateralTest | 侧位校正测试 | TEST_F(RobotWorkerTest, CalibratelateralTest)
B-UT0104006 |  | RegistrationFrontalTest | 正位校准测试 | TEST_F(RobotWorkerTest, RegistrationFrontalTest)
B-UT0104007 |  | RegistrationLateralTest | 侧位校准测试 | TEST_F(RobotWorkerTest, RegistrationLateralTest)
B-UT0104008 |  | LaserLocateTest | 通道定位测试 | TEST_F(RobotWorkerTest, LaserLocateTest)
B-UT0104009 |  | PathLocateTest | 定位路径测试 | TEST_F(RobotWorkerTest, PathLocateTest)
B-UT0104010 |  | Get3dPointsTest | 获取3d点测试 | TEST_F(RobotWorkerTest, Get3dPointsTest)
B-UT0104011 |  | GetCal2flangeMatrixTest | 获取法兰矩阵测试 | TEST_F(RobotWorkerTest, GetCal2flangeMatrixTest)
B-UT0104012 |  | GetCalibrationCoefficientTest | 获取校正关系矩阵测试 | TEST_F(RobotWorkerTest, GetCalibrationCoefficientTest)
B-UT0104013 |  | StartCalibrationCoefficientTest | 开始畸变校正测试 | TEST_F(RobotWorkerTest, StartCalibrationCoefficientTest)
B-UT0104014 |  | LoadMarkerDataTest | 载入Marker球数据测试 | TEST_F(RobotWorkerTest, LoadMarkerDataTest)
B-UT0104015 |  | MarkerDetectTest | 监测Marker球测试 | TEST_F(RobotWorkerTest, MarkerDetectTest)
B-UT0104016 |  | RegistrationTest | 校准测试 | TEST_F(RobotWorkerTest, RegistrationTest)
B-UT0104017 |  | GetPointOnLineTest | 获取在线点测试 | TEST_F(RobotWorkerTest, GetPointOnLineTest)
B-UT0104018 |  | GetPose2dTest | 获取2d姿态测试 | TEST_F(RobotWorkerTest, GetPose2dTest)
B-UT0104019 |  | GetPose3dTest | 获取3d姿态 | TEST_F(RobotWorkerTest, GetPose3dTest)
B-UT0104020 |  | RobertPose2MatrixTest | 机器姿态转成矩阵测试 | TEST_F(RobotWorkerTest, RobertPose2MatrixTest)
B-UT0104021 |  | Pos2MatrixTest | 位置转成矩阵测试 | TEST_F(RobotWorkerTest, Pos2MatrixTest)
B-UT0104022 |  | ConnectedRegionTest | 联通区域测试 | TEST_F(RobotWorkerTest, ConnectedRegionTest)
B-UT0104023 |  | GetInitializeTest | 获取初始化信息测试 | TEST_F(RobotWorkerTest, GetInitializeTest)
B-UT0104024 |  | CompensateTransfromTest | 补偿转换测试 | TEST_F(RobotWorkerTest, CompensateTransfromTest)

Sheet: 02定位
02定位
测试用例ID | 测试用例 | 测试名称 | 判断 | 输入项目
B-UT0201001 | ArmDriveURTest | InitProcessorTest | 初始化处理器测试 | TEST_F(ArmDriveURTest, InitProcessorTest)
B-UT0201002 |  | StartServerTest | 开启服务测试 | TEST_F(ArmDriveURTest, StartServerTest)
B-UT0201003 |  | StateTest | 状态测试 | TEST_F(ArmDriveURTest, StateTest)
B-UT0201004 |  | IsConnectedTest | 是否连接测试 | TEST_F(ArmDriveURTest, IsConnectedTest)
B-UT0201005 |  | connectArmTest | 连接机械臂测试 | TEST_F(ArmDriveURTest, IsFreeDriveTest)
B-UT0201006 |  | IsFreeDriveTest | 驱动是否空闲测试 | TEST_F(ArmDriveURTest, CheckProcessorTest)
B-UT0201007 |  | CheckProcessorTes | 检查处理器测试 | TEST_F(ArmDriveURTest, SetPortTest)
B-UT0201008 |  | SetPortTest | 设置端口测试 | TEST_F(ArmDriveURTest, ConnectArmTest)
B-UT0201009 |  | ConnectArmTest | 连接机械臂测试 | TEST_F(ArmDriveURTest, DisconnectArmTest)
B-UT0201010 |  | StartTest | 开启测试 | TEST_F(ArmDriveURTest, StartTest)
B-UT0201011 |  | StopTest | 停止测试 | TEST_F(ArmDriveURTest, StopTest)
B-UT0201012 |  | PauseTest | 暂停测试 | TEST_F(ArmDriveURTest, PauseTest)
B-UT0201013 |  | ResumeTest | 恢复测试 | TEST_F(ArmDriveURTest, ResumeTest)
B-UT0201014 |  | MoveLaserTest | 移动激光测试 | TEST_F(ArmDriveURTest, MoveLaserTest)
B-UT0201015 |  | MoveChannelTest | 移动通道测试 | TEST_F(ArmDriveURTest, MoveChannelTest)
B-UT0201016 |  | MovePathTest | 移动路径测试 | TEST_F(ArmDriveURTest, MovePathTest)
B-UT0201017 |  | SetFreeDriveTest | 设置驱动空闲测试 | TEST_F(ArmDriveURTest, SetFreeDriveTest)
B-UT0201018 |  | SetSpeedTest | 设置速度测试 | TEST_F(ArmDriveURTest, SetSpeedTest)
B-UT0201019 |  | laserSwitchTest | 激光转换测试 | TEST_F(ArmDriveURTest, laserSwitchTest)
B-UT0201020 |  | ResetArmTest | 重启机械臂测试 | TEST_F(ArmDriveURTest, ResetArmTest)
B-UT0201021 |  | FrontalLateralResetArmTest | 正侧位重置机械臂测试 | TEST_F(ArmDriveURTest, FrontalLateralResetArmTest)
B-UT0201022 |  | ResetLocationTest | 重置定位测试 | TEST_F(ArmDriveURTest, ResetLocationTest)
B-UT0201023 |  | AlignArmTest | 校准机械臂测试 | TEST_F(ArmDriveURTest, AlignArmTest)
B-UT0201024 |  | OriginPosTest | 起始位置测试 | TEST_F(ArmDriveURTest, OriginPosTest)
B-UT0201025 |  | SetOriginTest | 设置起点测试 | TEST_F(ArmDriveURTest, SetOriginTest)
B-UT0201026 |  | SetOrigin1Test | 设置起点测试 | TEST_F(ArmDriveURTest, SetOrigin1Test)
B-UT0201027 |  | SetChannelInvalidTest | 设置通道不合理测试 | TEST_F(ArmDriveURTest, SetChannelInvalidTest)
B-UT0201028 |  | ArmPosTest | 机械臂位置测试 | TEST_F(ArmDriveURTest, ArmPosTest)
B-UT0201029 |  | FrontalRegisterArmWithXRayTest | 机械臂正位注册测试 | TEST_F(ArmDriveURTest, FrontalRegisterArmWithXRayTest)
B-UT0201030 |  | LateralRegisterArmWithXRayTest | 机械臂侧位注册测试 | TEST_F(ArmDriveURTest, LateralRegisterArmWithXRayTest)
B-UT0201031 |  | RegisterArmWithXRayTest | 机械臂注册测试 | TEST_F(ArmDriveURTest, RegisterArmWithXRayTest)
B-UT0201032 |  | UpdateAngleTest | 更新角度测试 | TEST_F(ArmDriveURTest, UpdateAngleTest)
B-UT0201033 |  | UpdateHeightTest | 更新高度测试 | TEST_F(ArmDriveURTest, UpdateHeightTest)
B-UT0201034 |  | UpdateHeightAngleTest | 更新高度角度测试 | TEST_F(ArmDriveURTest, UpdateHeightAngleTest)
B-UT0201035 |  | StretchArmTest | 拉伸机械臂测试 | TEST_F(ArmDriveURTest, StretchArmTest)
B-UT0201036 |  | ExtendArmTest | 展开机械臂测试 | TEST_F(ArmDriveURTest, ExtendArmTest)
B-UT0201037 |  | StowageArmTest | 收回机械臂测试 | TEST_F(ArmDriveURTest, StowageArmTest)
B-UT0201038 |  | Update2dAngleTest | 更新角度测试 | TEST_F(ArmDriveURTest, Update2dAngleTest)
B-UT0201039 |  | Update2dHeightTest | 更新高度测试 | TEST_F(ArmDriveURTest, Update2dHeightTest)
B-UT0201040 |  | SimulationTest | 仿真测试 | TEST_F(ArmDriveURTest, SimulationTest)
B-UT0201041 |  | LaserTargetPoseTest | 激光定位姿态测试 | TEST_F(ArmDriveURTest, LaserTargetPoseTest)
B-UT0201042 |  | ChannelTargetPoseTest | 通道定位姿态测试 | TEST_F(ArmDriveURTest, ChannelTargetPoseTest)
B-UT0201043 |  | LaserTcpTest | 激光TCP测试 | TEST_F(ArmDriveURTest, LaserTcpTest)
B-UT0201044 |  | ChannelTcpTest | 通道TCP测试 | TEST_F(ArmDriveURTest, ChannelTcpTest)
B-UT0201045 |  | SetLaserTcpTest | 设置激光TCP测试 | TEST_F(ArmDriveURTest, SetLaserTcpTest)
B-UT0201046 |  | SetChannelTcpTest | 设置通道TCP测试 | TEST_F(ArmDriveURTest, SetChannelTcpTest)
B-UT0201047 |  | LaserStatusTest | 激光状态测试 | TEST_F(ArmDriveURTest, LaserStatusTest)
B-UT0201048 |  | SetDebugTest | 设置调试模式测试 | TEST_F(ArmDriveURTest, SetDebugTest)
B-UT0201049 |  | ArmCtlDlgShowedTest | 机械臂控制对话框测试 | TEST_F(ArmDriveURTest, ArmCtlDlgShowedTest)
B-UT0201050 |  | QueryArmJointTest | 查看机械臂关节测试 | TEST_F(ArmDriveURTest, QueryArmJointTest)
B-UT0201051 |  | ReceiveMoveChannelPathTest | 接收移动通道路径测试 | TEST_F(ArmDriveURTest, ReceiveMoveChannelPathTest)
B-UT0201052 |  | ReceiveMove3dChannelPathTest | 接收移动3D通道路径测试 | TEST_F(ArmDriveURTest, ReceiveMove3dChannelPathTest)
B-UT0201053 |  | ReceiveCalcPathFinishedTest | 接收计算路径完成测试 | TEST_F(ArmDriveURTest, ReceiveCalcPathFinishedTest)
B-UT0201054 |  | SimulateTargetCartesianTest | 仿真定位笛卡尔坐标系测试 | TEST_F(ArmDriveURTest, SimulateTargetCartesianTest)
B-UT0201055 |  | ToExtendArmTest | 开始展开机械臂测试 | TEST_F(ArmDriveURTest, ToExtendArmTest)
B-UT0201056 |  | ToStowageArmTest | 开始收回机械臂测试 | TEST_F(ArmDriveURTest, ToStowageArmTest)

Sheet: 03仿真
03仿真
测试用例ID | 测试用例 | 测试名称 | 判断 | 输入项目
B-UT0301001 | RRTTest | SetStartEndPointTest | 设置起始点、终点测试 | TEST_F(RRTTest, SetStartEndPointTest)
B-UT0301002 |  | SetHighTest | 设置基座平面的限制高度测试 | TEST_F(RRTTest, SetHighTest)
B-UT0301003 |  | SetModeTest | 设置模式测试 | TEST_F(RRTTest, SetModeTest)
B-UT0301004 |  | JudgeJointTest | 判断角度测试 | TEST_F(RRTTest, JudgeJointTest)
B-UT0301005 |  | ExtendNewNodeTest | 拓展新节点测试 | TEST_F(RRTTest,ExtendNewNodeTest)
B-UT0301006 |  | FindTreesTest | 寻找树测试 | TEST_F(RRTTest,FindTreesTest)
B-UT0301007 |  | CreatNewRandJointTest | 创建新的随机节点测试 | TEST_F(RRTTest, CreatNewRandJointTest)
B-UT0301008 |  | MyRandTest | 随机测试 | TEST_F(RRTTest, MyRandTest)
B-UT0301009 |  | GetNewestAddNodeTest | 获取最新增加节点测试 | TEST_F(RRTTest, GetNewestAddNodeTest)
B-UT0301010 |  | JudgeReachTest | 判断到达测试 | TEST_F(RRTTest, JudgeReachTest)
B-UT0301011 |  | FindPathTest | 寻找路径点测试 | TEST_F(RRTTest,FindPathTest)
B-UT0301012 |  | ToFindPathTest | 寻找路径测试 | TEST_F(RRTTest,ToFindPathTest)
B-UT0301013 |  | GetTotalCountTest | 获取路点个数测试 | TEST_F(RRTTest, GetTotalCountTest)
B-UT0301014 |  | GetPathJointByCountTest | 根据数量获取路径角度测试 | TEST_F(RRTTest, GetPathJointByCountTest)
B-UT0301015 |  | ReplanPathTest | 重规划路径测试 | TEST_F(RRTTest,ReplanPathTest)

Sheet: 04登录
04登录
测试用例ID | 测试用例 | 测试名称 | 判断 | 输入项目
B-UT0401001 | MainStoreTest | LoginTest | 登录测试 | TEST_F(MainStoreTest, LoginTest)
B-UT0401002 |  | SetUserIDTest | 设置用户名测试 | TEST_F(MainStoreTest, SetUserIDTest)
B-UT0401003 |  | SetPasswordTest | 设置密码测试 | TEST_F(MainStoreTest, SetPasswordTest)
B-UT0401004 |  | GetPasswordTest | 获取密码测试 | TEST_F(MainStoreTest, GetPasswordTest)
B-UT0401005 |  | SetLoginTest | 设置登录测试 | TEST_F(MainStoreTest, SetLoginTest)
B-UT0401006 |  | GetLoginTest | 获取登录测试 | TEST_F(MainStoreTest, GetLoginTest)
B-UT0401007 |  | SetSoftInVersionTest | 设置软件版本信息测试 | TEST_F(MainStoreTest, SetSoftInVersionTest)
B-UT0401008 |  | GetSoftInVersionTest | 获取软件版本信息测试 | TEST_F(MainStoreTest, GetSoftInVersionTest)
B-UT0401009 |  | GetCablicateTest | 获取字幕测试 | TEST_F(MainStoreTest, GetCablicateTest)
B-UT0401010 |  | SetCablicateTest | 设置字幕测试 | TEST_F(MainStoreTest, SetCablicateTest)
B-UT0401011 |  | GetPasswordChangedTest | 获取密码修改测试 | TEST_F(MainStoreTest, GetPasswordChangedTest)
B-UT0401012 |  | SetPasswordChangedTest | 设置密码修改测试 | TEST_F(MainStoreTest, SetPasswordChangedTest)
B-UT0401013 |  | GetSipShowIMTest | 获取显示的图像测试 | TEST_F(MainStoreTest, GetSipShowIMTest)
B-UT0401014 |  | SetSipShowIMTest | 设置显示的图像测试 | TEST_F(MainStoreTest, SetSipShowIMTest)
B-UT0401015 |  | GetUserInfoTest | 获取用户信息测试 | TEST_F(MainStoreTest, GetUserInfoTest)

Sheet: 05软件信息
05软件信息
测试用例ID | 测试用例 | 测试名称 | 判断 | 输入项目
B-UT0501001 | SoftInfoTest | getSoftInVersionTest | 获取软件版本信息测试 | TEST_F(SoftInfoTest, getSoftInVersionTest)
B-UT0501002 |  | setInVersionTest | 设置软件版本信息测试 | TEST_F(SoftInfoTest, setInVersionTest)

Sheet: 06配置
 | 06配置
 | 测试用例ID | 测试用例 | 测试名称 | 判断 | 输入项目
 | B-UT0601001 | ConfigSettingsDialogTest | initNetworkRegTest | 初始化网络测试 | TEST_F(ConfigSettingsDialogTest, IninNetworkRegTest)
 | B-UT0601002 |  | ConfirmBtnClickTest | 确认按钮测试 | TEST_F(ConfigSettingsDialogTest, ConfirmBtnClickTest)
 | B-UT0602001 | CalibrateArmWidgetTest | ShowWidgetTest | 显示正位/侧位窗口测试 | TEST_F(CalibrateArmWidgetTest, ShowWidgetTest)
 | B-UT0602002 |  | FileIsExistTest | 文件是否存在测试 | TEST_F(CalibrateArmWidgetTest, FileIsExistTest)
 | B-UT0602003 |  | ClearFilesTest | 清除文件测试 | TEST_F(CalibrateArmWidgetTest, ClearFilesTest)
 | B-UT0602004 |  | SaveImage1Test | 保存图像测试 | TEST_F(CalibrateArmWidgetTest, SaveImage1Test)
 | B-UT0602005 |  | SaveImage2Test | 保存图像测试 | TEST_F(CalibrateArmWidgetTest, SaveImage2Test)
 | B-UT0602006 |  | CloseEventTest | 关闭事件测试 | TEST_F(CalibrateArmWidgetTest, CloseEventTest)
 | B-UT0602007 |  | ShowEventTest | 显示事件测试 | TEST_F(CalibrateArmWidgetTest, ShowEventTest)
 | B-UT0602008 |  | CalibrateTypeTest | 获取校准类型测试 | TEST_F(CalibrateArmWidgetTest, CalibrateTypeTest)
 | B-UT0602009 |  | ImageCountTest | 图像数量测试 | TEST_F(CalibrateArmWidgetTest, ImageCountTest)
 | B-UT0603001 | CalibrateBoardToolImportDialogTest | showEventTest | 显示事件测试 | TEST_F(CalibrateBoardToolImportDialogTest, ShowEventTest)
 | B-UT0603002 |  | KeyPressEventTest | 按键测试 | TEST_F(CalibrateBoardToolImportDialogTest, KeyPressEventTest)
 | B-UT0603003 |  | RefreshUsbTest | 刷新USB测试 | TEST_F(CalibrateBoardToolImportDialogTest, RefreshUsbTest)
 | B-UT0603004 |  | UpdateUsbRootTest | 刷新USBRoot测试 | TEST_F(CalibrateBoardToolImportDialogTest, UpdateUsbRootTest)
 | B-UT0603005 |  | CopyFileToPathTest | 拷贝文件到目录测试 | TEST_F(CalibrateBoardToolImportDialogTest, CopyFileToPathTest)
 | B-UT0603006 |  | CheckUsbTest | 检查USB测试 | TEST_F(CalibrateBoardToolImportDialogTest, CheckUsbTest)
 | B-UT0603007 |  | ScanDataTest | 浏览数据测试 | TEST_F(CalibrateBoardToolImportDialogTest, ScanDataTest)
 | B-UT0603008 |  | IsImportFileTest | 是否导入文件测试 | TEST_F(CalibrateBoardToolImportDialogTest, IsImportFileTest)
 | B-UT0604001 | CalibrateControlTest | IsCalibrateStatusTest | 是否校准状态测试 | TEST_F(CalibrateControlTest, IsCalibrateStatusTest)
 | B-UT0604002 |  | UpdateStatusTest | 更新状态测试 | TEST(CalibrateControlTest, updateStatusTest)
 | B-UT0604003 |  | FrontalCalibrateTest | 正位校准测试 | TEST(CalibrateControlTest, frontalCalibrateTest)
 | B-UT0604004 |  | LateralCalibrateTest | 侧位校准测试 | TEST(CalibrateControlTest, lateralCalibrateTest)
 | B-UT0604005 |  | CalibrateFinishedTest | 校准完成测试 | TEST_F(CalibrateControlTest, CalibrateFinishedTest)
 | B-UT0604006 |  | NewFrameTest | 新帧测试 | TEST_F(CalibrateControlTest, NewFrameTest)
 | B-UT0605001 | ExportImageDialogTest | ShowEventTest | 显示事件测试 | TEST_F(ExportImageDialogTest, ShowEventTest)
 | B-UT0605002 |  | HideEventTest | 隐藏事件测试 | TEST_F(ExportImageDialogTest, HideEventTest)
 | B-UT0605003 |  | ExporImagesTest | 导出图像测试 | TEST_F(ExportImageDialogTest, ExporImagesTest)
 | B-UT0605004 |  | RefreshUsbTest | 刷新USB测试 | TEST_F(ExportImageDialogTest, RefreshUsbTest)
 | B-UT0605005 |  | UpdateUsbRootTest | 更新USBroot测试 | TEST_F(ExportImageDialogTest, UpdateUsbRootTest)
 | B-UT0605006 |  | CheckUsbTest | 检查USB测试 | TEST_F(ExportImageDialogTest, CheckUsbTest)
 | B-UT0606001 | ExportLogViewTest | checkUsbTest | 检查USB测试 | TEST_F(ExportLogViewTest, checkUsbTest)
 | B-UT0606002 |  | refreshUsbTest | 刷新USB测试 | TEST_F(ExportLogViewTest, refreshUsbTest)
 | B-UT0606003 |  | reloadClickTest | 重载按钮测试 | TEST_F(ExportLogViewTest, reloadClickTest)
 | B-UT0606004 |  | showEventTest | 显示事件测试 | TEST_F(ExportLogViewTest, showEventTest)
 | B-UT0607001 | ParameterConfigDialogTest | ShowEventTest | 显示事件测试 | TEST_F(ParameterConfigDialogTest, ShowEventTest)
 | B-UT0607002 |  | ReadIniSettingsTest | 读取ini配置测试 | TEST_F(ParameterConfigDialogTest, ReadIniSettingsTest)
 | B-UT0607003 |  | WriteSettingsTest | 写入ini配置测试 | TEST_F(ParameterConfigDialogTest, WriteSettingsTest)
 | B-UT0608001 | PasswordDialogTest | ShowEventTest | 显示事件测试 | TEST_F(PasswordDialogTest, ShowEventTest)
 | B-UT0608002 |  | CloseEventTest | 关闭事件测试 | TEST_F(PasswordDialogTest, CloseEventTest)
 | B-UT0608003 |  | ConfirmBtnClickTest | 确认按钮测试 | TEST_F(PasswordDialogTest, ConfirmBtnClickTest)
 | B-UT0608004 |  | cancelBtnTest | 取消按钮测试 | TEST_F(PasswordDialogTest, CancelBtnClickTest)
 | B-UT0609001 | PromptDialogTest | SetPromptText1Test | 设置提示文本测试 | TEST_F(PromptDialogTest, SetPromptText1Test)
 | B-UT0609002 |  | SetPromptText2Test | 按照类别设置提示文本测试 | TEST_F(PromptDialogTest, SetPromptText2Test)
 | B-UT0610001 | RegisterDialogTest | RegisterLicenseTest | 注册许可测试 | TEST_F(RegisterDialogTest, RegisterLicenseTest)
 | B-UT0610002 |  | PaintEventTest | 界面绘制事件测试 | TEST_F(RegisterDialogTest, PaintEventTest)
 | B-UT0610003 |  | KeyPressEventTest | 键盘按压事件测试 | TEST_F(RegisterDialogTest, KeyPressEventTest)
 | B-UT0610004 |  | CloseEventTest | 关闭事件测试 | TEST_F(RegisterDialogTest, CloseEventTest)
. | B-UT0611001 | RegistrationResultWidgetTest | FrontalRegisterationImageTest | 正位校准图像测试 | TEST_F(RegistrationResultWidgetTest, FrontalRegisterationImageTest)
 | B-UT0611002 |  | LateralRegisterationImageTest | 侧位校准图像测试 | TEST_F(RegistrationResultWidgetTest, LateralRegisterationImageTest)
 | B-UT0612001 | ToolSelectDialogTest | ShowEventTest | 显示事件测试 | TEST_F(ToolSelectDialogTest, ShowEventTest)
 | B-UT0612002 |  | KeyPressEventTest | 键盘按压事件测试 | TEST_F(ToolSelectDialogTest, KeyPressEventTest)
 | B-UT0612003 |  | CloseEventTest | 关闭事件测试 | TEST_F(ToolSelectDialogTest, CloseEventTest)
 | B-UT0612004 |  | InitToolSelectViewTest | 初始化工具选择界面测试 | TEST_F(ToolSelectDialogTest, InitToolSelectViewTest)
 | B-UT0612005 |  | LoadToolInformationTest | 载入工具信息测试 | TEST_F(ToolSelectDialogTest, LoadToolInformationTest)
 | B-UT0612006 |  | ScanDataTest | 浏览数据测试 | TEST_F(ToolSelectDialogTest, ScanDataTest)

Sheet: 07日志
07日志
测试用例ID | 测试用例 | 测试名称 | 判断 | 输入项目
B-UT0701001 | MilestoneLogTest | WriteMilestoneLogInfoTest | 关键日志写入测试 | TEST_F(MilestoneLogTest, WriteMilestoneLogInfoTest)
B-UT0701002 |  | WriteMilestoneLogWarnTest | 关键日志写入警告测试 | TEST_F(MilestoneLogTest, WriteMilestoneLogWarnTest)
B-UT0701003 |  | WriteMilestoneLogErrorTest | 关键日志写入错误测试 | TEST_F(MilestoneLogTest, WriteMilestoneLogErrorTest)
B-UT0701004 |  | MilestoneLogEndLogTest | 关键日志写入结束测试 | TEST_F(MilestoneLogTest, MilestoneLogEndLogTest)
B-UT0702001 | SystemLogTest | WritLogInfoTest | 写日志信息测试 | TEST_F(SystemLogTest, WritLogInfoTest)
B-UT0702002 |  | WriteLogWarningTest | 结束写入警告测试 | TEST_F(SystemLogTest, WriteLogWarningTest)
B-UT0702003 |  | WriteLogErrorTest | 日志写入错误测试 | TEST_F(SystemLogTest, WriteLogErrorTest)
B-UT0702004 |  | EndLogTest | 结束日志测试 | TEST_F(SystemLogTest, EndLogTest)

Sheet: 08系统退出
08系统退出
测试用例ID | 测试用例 | 测试名称 | 判断 | 输入项目
B-UT0801001 | MainStoreTest | invokeSystemExitTest | 系统退出测试 | TEST_F(SystemExitTest, invokeSystemExitTest)

Sheet: 09软件注册
09软件注册
测试用例 |  | 测试名称 | 判断 | 输入项目
B-UT0901001 | SystemInfoTest | cpuIdTest | 是否获取CPU序列号测试 | TEST_F(SystemInfoTest, cpuIdTest)
B-UT0901002 |  | diskIdTest | 是否获取硬盘序列号测试 | TEST_F(SystemInfoTest, diskIdTest)
B-UT0902001 | SoftLicenseTest | systemCodeTest | 生成机器码测试 | TEST_F(SoftLicenseTest, systemCodeTest)
B-UT0902002 |  | generateLicenseTest | 生成注册码测试 | TEST_F(SoftLicenseTest, generateLicenseTest)
B-UT0902003 |  | IsValidTest | 判断注册码的有效性测试 | TEST_F(SoftLicenseTest, IsValidTest)
B-UT0903001 | RegisterDialogTest | RegisterLicenseTest | 注册证测试 | TEST_F(RegisterDialogTest, RegisterLicenseTest)
B-UT0903002 |  | PaintEventTest | 绘制事件测试 | TEST_F(RegisterDialogTest, PaintEventTest)
B-UT0903003 |  | KeyPressEventTest | 键盘按压时间测试 | TEST_F(RegisterDialogTest, KeyPressEventTest)
B-UT0903004 |  | CloseEventTest | 关闭事件测试 | TEST_F(RegisterDialogTest, CloseEventTest)

Sheet: 10网络
10网络
测试用例ID | 测试用例 | 测试名称 | 判断 | 输入项目
B-UT1001001 | ImageDataTest | IsNullTest | 是否为空测试 | TEST_F(ImageDataTest, IsNullTest)
B-UT1001002 |  | CopyTest | 拷贝测试 | TEST_F(ImageDataTest, CopyTest)
B-UT1001003 |  | FromatTest | 格式化测试 | TEST_F(ImageDataTest, FromatTest)
B-UT1001004 |  | BytesPerLineTest | 一行字节数测试 | TEST_F(ImageDataTest, BytesPerLineTest)
B-UT1001005 |  | WidthTest | 宽测试 | TEST_F(ImageDataTest, WidthTest)
B-UT1001006 |  | HeightTest | 高测试 | TEST_F(ImageDataTest, HeightTest)
B-UT1001007 |  | ByteCountTest | 字节数测试 | TEST_F(ImageDataTest, ByteCountTest)
B-UT1001008 |  | BitsTest | 比特测试 | TEST_F(ImageDataTest, BitsTest)
B-UT1001009 |  | ConvertTo1Test | 转换测试 | TEST_F(ImageDataTest, ConvertTo1Test)
B-UT1001010 |  | ConvertTo2Test | 转换测试 | TEST_F(ImageDataTest, ConvertTo2Test)
B-UT1001011 |  | TrunToSquareTest | 变正方形测试 | TEST_F(ImageDataTest, TrunToSquareTest)
B-UT1002001 | ImageService3DTest | PosMatrixDataTest | 姿态矩阵数据测试 | TEST_F(ImageService3DTest, PosMatrixDataTest)
B-UT1002002 |  | StartServerTest | 开始服务测试 | TEST_F(ImageService3DTest, StartServerTest)
B-UT1002003 |  | StartListenTest | 开始监听测试 | TEST_F(ImageService3DTest, StartListenTest)
B-UT1002004 |  | ProcessCommandTest | 解析命令测试 | TEST_F(ImageService3DTest, ProcessCommandTest)
B-UT1002005 |  | ParseTest | 解析测试 | TEST_F(ImageService3DTest, ParseTest)
B-UT1002006 |  | SendCommandTest | 发送命令测试 | TEST_F(ImageService3DTest, SendCommandTest)
B-UT1002007 |  | GenerateCodeTest | 生成代码测试 | TEST_F(ImageService3DTest, GenerateCodeTest)
B-UT1002008 |  | SetLocateTest | 设置位置测试 | TEST_F(ImageService3DTest, SetLocateTest)
B-UT1002009 |  | SendFrontalImageTest | 发送正位图像测试 | TEST_F(ImageService3DTest, SendFrontalImageTest)
B-UT1002010 |  | SendLateralImageTest | 发送侧位图像测试 | TEST_F(ImageService3DTest, SendLateralImageTest)
B-UT1002011 |  | SendFeedbackFrontalImageTest | 发送正位反馈图像测试 | TEST_F(ImageService3DTest, SendFeedbackFrontalImageTest)
B-UT1002012 |  | SendFeedbackLateralImageTest | 发送侧位反馈图像测试 | TEST_F(ImageService3DTest, SendFeedbackLateralImageTest)
B-UT1002013 |  | SendLateralImageMatrixTest | 发送侧位图像与矩阵参数测试 | TEST_F(ImageService3DTest, SendLateralImageMatrixTest)
B-UT1002014 |  | Frontal2LateralMatrixTest | 正侧位矩阵测试 | TEST_F(ImageService3DTest, Frontal2LateralMatrixTest)
B-UT1002015 |  | SendFrontalImageParamTest | 发送正位图片和参数测试 | TEST_F(ImageService3DTest, SendFrontalImageParamTest)
B-UT1002016 |  | SendLateralImageMatrixParamTest | 发送侧位图片和矩阵参数测试 | TEST_F(ImageService3DTest, SendLateralImageMatrixParamTest)
B-UT1003001 | ArmURDashboardProcessorTest | ConnectDashboardTest | 连接面板测试 | TEST_F(ArmURDashboardProcessorTest, ConnectDashboardTest)
B-UT1003002 |  | ConnectToServerTest | 连接到服务测试 | TEST_F(ArmURDashboardProcessorTest, ConnectToServerTest)
B-UT1003003 |  | DisconnectFromServerTest | 断开服务连接测试 | TEST_F(ArmURDashboardProcessorTest, DisconnectFromServerTest)
B-UT1003004 |  | PlayTest | 执行测试 | TEST_F(ArmURDashboardProcessorTest, PlayTest)
B-UT1003005 |  | PauseTest | 暂停测试 | TEST_F(ArmURDashboardProcessorTest, PauseTest)
B-UT1003006 |  | StopTest | 停止测试 | TEST_F(ArmURDashboardProcessorTest, StopTest)
B-UT1003007 |  | QuitTest | 退出测试 | TEST_F(ArmURDashboardProcessorTest, QuitTest)
B-UT1003008 |  | ShutDownTest | 关闭测试 | TEST_F(ArmURDashboardProcessorTest, ShutDownTest)
B-UT1003009 |  | RestartTest | 重启测试 | TEST_F(ArmURDashboardProcessorTest, RestartTest)
B-UT1003010 |  | StartProgramTest | 启动程序测试 | TEST_F(ArmURDashboardProcessorTest, StartProgramTest)
B-UT1003011 |  | IsConnectedTest | 是否连接测试 | TEST_F(ArmURDashboardProcessorTest, IsConnectedTest)
B-UT1003012 |  | IpAddrTest | 获取IP测试 | TEST_F(ArmURDashboardProcessorTest, IpAddrTest)
B-UT1003013 |  | SendCmdPackagesTest | 发送命名包测试 | TEST_F(ArmURDashboardProcessorTest, SendCmdPackagesTest)
B-UT1003014 |  | SendSingleCmdTest | 发送一条命令测试 | TEST_F(ArmURDashboardProcessorTest, SendSingleCmdTest)
B-UT1003015 |  | RobotStateTest | 获取机器状态测试 | TEST_F(ArmURDashboardProcessorTest, RobotStateTest)
B-UT1003016 |  | ClosePopupTest | 关闭弹窗测试 | TEST_F(ArmURDashboardProcessorTest, ClosePopupTest)
B-UT1003017 |  | SetPresssedTest | 设置压下测试 | TEST_F(ArmURDashboardProcessorTest, SetPresssedTest)
B-UT1003018 |  | ResetLocationTest | 重置位置测试 | TEST_F(ArmURDashboardProcessorTest, ResetLocationTest)
B-UT1003019 |  | SetLocationStatusTest | 设置位置状态测试 | TEST_F(ArmURDashboardProcessorTest, SetLocationStatusTest)
B-UT1003020 |  | GenerateCodeTest | 生成代码测试 | TEST_F(ArmURDashboardProcessorTest, GenerateCodeTest)
B-UT1003021 |  | CheckStatusTest | 检查状态测试 | TEST_F(ArmURDashboardProcessorTest, CheckStatusTest)
B-UT1003022 |  | ParseDataTest | 解析数据测试 | TEST_F(ArmURDashboardProcessorTest, ParseDataTest)
B-UT1003023 |  | ProcessCommandTest | 加工命令测试 | TEST_F(ArmURDashboardProcessorTest, ProcessCommandTest)

Sheet: 11机械臂控制
11机械臂控制
测试用例ID | 测试用例 | 测试名称 | 判断 | 输入项目
B-UT1101001 | ArmJointControlTest | MoveTest | 运动测试 | TEST_F(ArmJointControlTest, MoveTest)
B-UT1101002 |  | SetPortTest | 设置端口测试 | TEST_F(ArmJointControlTest, SetPortTest)
B-UT1101003 |  | InitArmJointViewTest | 初始化视图测试 | TEST_F(ArmJointControlTest, InitArmJointViewTest)
B-UT1101004 |  | SetFetchStatusTest | 设置获取状态测试 | TEST_F(ArmJointControlTest, SetFetchStatusTest)
B-UT1102001 | GetArmJointProcessorTest | SetPortTest | 设置端口测试 | TEST_F(GetArmJointProcessorTest, SetPortTest)
B-UT1102002 |  | SetIpaddressTest | 设置IP测试 | TEST_F(GetArmJointProcessorTest, SetIpaddressTest)
B-UT1102003 |  | ConnectURTest | 连接UR测试 | TEST_F(GetArmJointProcessorTest, ConnectURTest)
B-UT1102004 |  | PackageHeadUpdatedTest | 更新包头测试 | TEST_F(GetArmJointProcessorTest, PackageHeadUpdatedTest)
B-UT1102005 |  | InitViewTest | 初始化视图测试 | TEST_F(GetArmJointProcessorTest, InitViewTest)
B-UT1102006 |  | DisconnectURTest | 断开连接UR测试 | TEST_F(GetArmJointProcessorTest, DisconnectURTest)
B-UT1102007 |  | IsConnectedTest | 是否连接测试 | TEST_F(GetArmJointProcessorTest, IsConnectedTest)
B-UT1102008 |  | StartConnectTest | 开始连接作业测试 | TEST_F(GetArmJointProcessorTest, StartConnectTest)
B-UT11020010 |  | ParsePacketTest | 解包测试 | TEST_F(GetArmJointProcessorTest, ParsePacketTest)
B-UT11020011 |  | GetDoubleTest | 获取双精度测试 | TEST_F(GetArmJointProcessorTest, GetDoubleTest)
B-UT11020012 |  | SetFetchStatusTest | 设置获取状态测试 | TEST_F(GetArmJointProcessorTest, SetFetchStatusTest)
B-UT1103001 | ArmJointControlProcessorTest | SetPortTest | 设置端口测试 | TEST_F(ArmJointControlProcessorTest, SetPortTest)
B-UT1103002 |  | SetIpaddressTest | 设置IP测试 | TEST_F(ArmJointControlProcessorTest, SetIpaddressTest)
B-UT1103003 |  | ConnectURTest | 连接UR测试 | TEST_F(ArmJointControlProcessorTest, ConnectURTest)
B-UT1103004 |  | DisconnectURTest | UR断开连接测试 | TEST_F(ArmJointControlProcessorTest, DisconnectURTest)
B-UT1103005 |  | IsConnectedTest | 是否连接测试 | TEST_F(ArmJointControlProcessorTest, IsConnectedTest)
B-UT1103006 |  | MoveTest | 移动测试 | TEST_F(ArmJointControlProcessorTest, MoveTest)
B-UT1103007 |  | StartConnectTest | 开始连接测试 | TEST_F(ArmJointControlProcessorTest, StartConnectTest)
