santan444/MS001/03-设计开发输出阶段/03软件/03单元测试/导引软件/MS-001导引软件单元测试记录.xlsx

Sheet: 封面
MS-001
导引软件单元测试记录
 | 编制/时间：
 | 审核/时间：
 | 批准/时间：
 | 杭州三坛医疗科技有限公司

Sheet: 文档履历
文档更改履历
版本号 | 发布/实施日期 | 更改内容概述 | 更改者
V1.0 |  | 文件新编

Sheet: 01校准
01校准
测试用例ID | 测试用例 | 测试名称 | 判断 | 输入项目 | 输出结果 | 验证人 | 验证日期 | 结果 | 测试状态
B-UT0101001 | MarkerRegistrationTest | RegistrationTest | 校准测试 | TEST_F(MarkerRegistrationTest, RegistrationTest) | [----------] 11 tests from MarkerRegistrationTest [ RUN ] MarkerRegistrationTest.RegistrationTest [ OK ] MarkerRegistrationTest.RegistrationTest (14 ms) [ RUN ] MarkerRegistrationTest.Pos2MatTest [ OK ] MarkerRegistrationTest.Pos2MatTest (0 ms) [ RUN ] MarkerRegistrationTest.QjkTest [ OK ] MarkerRegistrationTest.QjkTest (31 ms) [ RUN ] MarkerRegistrationTest.SoftAssignTest [ OK ] MarkerRegistrationTest.SoftAssignTest (2 ms) [ RUN ] MarkerRegistrationTest.FindMatchTest [ OK ] MarkerRegistrationTest.FindMatchTest (0 ms) [ RUN ] MarkerRegistrationTest.PoseUpdateTest [ OK ] MarkerRegistrationTest.PoseUpdateTest (3 ms) [ RUN ] MarkerRegistrationTest.ProcessTest [ OK ] MarkerRegistrationTest.ProcessTest (73 ms) [ RUN ] MarkerRegistrationTest.SetNormalizeTransformParaTest [ OK ] MarkerRegistrationTest.SetNormalizeTransformParaTest (0 ms) [ RUN ] MarkerRegistrationTest.SetInitialPoseParaTest [ OK ] MarkerRegistrationTest.SetInitialPoseParaTest (0 ms) [ RUN ] MarkerRegistrationTest.SetFocalLengthTest [ OK ] MarkerRegistrationTest.SetFocalLengthTest (0 ms) [ RUN ] MarkerRegistrationTest.SetCostValueTest [ OK ] MarkerRegistrationTest.SetCostValueTest (0 ms) [----------] 11 tests from MarkerRegistrationTest (131 ms total) | 杨斌 | 2021-02-01 | OK | PASS
B-UT0101002 |  | Pos2MatTest | 位置转为矩阵测试 | TEST_F(MarkerRegistrationTest, Pos2MatTest) |  | 杨斌 | 2021-02-01 | OK | PASS
B-UT0101003 |  | QjkTest | Qjk运算测试 | TEST_F(MarkerRegistrationTest, QjkTest) |  | 杨斌 | 2021-02-01 | OK | PASS
B-UT0101004 |  | SoftAssignTest | 软分配测试 | TEST_F(MarkerRegistrationTest, SoftAssignTest) |  | 杨斌 | 2021-02-01 | OK | PASS
B-UT0101005 |  | FindMatchTest | 寻找匹配测试 | TEST_F(MarkerRegistrationTest, FindMatchTest) |  | 杨斌 | 2021-02-01 | OK | PASS
B-UT0101006 |  | PoseUpdateTest | 更新姿态测试 | TEST_F(MarkerRegistrationTest, PoseUpdateTest) |  | 杨斌 | 2021-02-01 | OK | PASS
B-UT0101007 |  | ProcessTest | 运行进程测试 | TEST_F(MarkerRegistrationTest, ProcessTest) |  | 杨斌 | 2021-02-01 | OK | PASS
B-UT0101008 |  | SetNormalizeTransformParaTest | 设置归一化变换参数测试 | TEST_F(MarkerRegistrationTest, SetNormalizeTransformParaTest) |  | 杨斌 | 2021-02-01 | OK | PASS
B-UT0101009 |  | SetInitialPoseParaTest | 设置初始化姿态参数测试 | TEST_F(MarkerRegistrationTest, SetInitialPoseParaTest) |  | 杨斌 | 2021-02-01 | OK | PASS
B-UT0101010 |  | SetFocalLengthTest | 设置焦距测试 | TEST_F(MarkerRegistrationTest, SetFocalLengthTest) |  | 杨斌 | 2021-02-01 | OK | PASS
B-UT0101011 |  | SetCostValueTest | 取值测试 | TEST_F(MarkerRegistrationTest, SetCostValueTest) |  | 杨斌 | 2021-02-01 | OK | PASS
B-UT0102001 | calibrationProcessorTest | InitializeTest | 初始化测试 | TEST_F(calibrationProcessorTest, InitializeTest) | [----------] 6 tests from calibrationProcessorTest [ RUN ] calibrationProcessorTest.InitializeTest [ OK ] calibrationProcessorTest.InitializeTest (2 ms) [ RUN ] calibrationProcessorTest.PreparedTest [ OK ] calibrationProcessorTest.PreparedTest (0 ms) [ RUN ] calibrationProcessorTest.CalibrateImageTest [ OK ] calibrationProcessorTest.CalibrateImageTest (2 ms) [ RUN ] calibrationProcessorTest.UndistortPointTest [ OK ] calibrationProcessorTest.UndistortPointTest (1 ms) [ RUN ] calibrationProcessorTest.StartGetCoefficientTest [ OK ] calibrationProcessorTest.StartGetCoefficientTest (0 ms) [ RUN ] calibrationProcessorTest.GetCoefficientTest [ OK ] calibrationProcessorTest.GetCoefficientTest (388025 ms) [----------] 6 tests from calibrationProcessorTest (388037 ms total) | 杨斌 | 2021-02-01 | OK | PASS
B-UT0102002 |  | PreparedTest | 准备测试 | TEST_F(calibrationProcessorTest, PreparedTest) |  | 杨斌 | 2021-02-01 | OK | PASS
B-UT0102003 |  | CalibrateImageTest | 校准图像测试 | TEST_F(calibrationProcessorTest, CalibrateImageTest) |  | 杨斌 | 2021-02-01 | OK | PASS
B-UT0102004 |  | UndistortPointTest | 校正点测试 | TEST_F(calibrationProcessorTest, UndistortPointTest) |  | 杨斌 | 2021-02-01 | OK | PASS
B-UT0102005 |  | StartGetCoefficientTest | 开始获取系数测试 | TEST_F(calibrationProcessorTest, StartGetCoefficientTest) |  | 杨斌 | 2021-02-01 | OK | PASS
B-UT0102006 |  | GetCoefficientTest | 获取系数测试 | TEST_F(calibrationProcessorTest, GetCoefficientTest) |  | 杨斌 | 2021-02-01 | OK | PASS
B-UT0103001 | RobotRegistrationProcessorTest | IsCalibratedTest | 是否已校正测试 | TEST_F(RobotRegistrationProcessorTest, IsCalibratedTest) | [----------] 23 tests from RobotRegistrationProcessorTest [ RUN ] RobotRegistrationProcessorTest.IsCalibratedTest [ OK ] RobotRegistrationProcessorTest.IsCalibratedTest (107 ms) [ RUN ] RobotRegistrationProcessorTest.IsRegsiteredTest [ OK ] RobotRegistrationProcessorTest.IsRegsiteredTest (63 ms) [ RUN ] RobotRegistrationProcessorTest.IsFrontalRegsiteredTest [ OK ] RobotRegistrationProcessorTest.IsFrontalRegsiteredTest (57 ms) [ RUN ] RobotRegistrationProcessorTest.IsLateralRegsiteredTest [ OK ] RobotRegistrationProcessorTest.IsLateralRegsiteredTest (58 ms) [ RUN ] RobotRegistrationProcessorTest.LastLocationTest [ OK ] RobotRegistrationProcessorTest.LastLocationTest (73 ms) [ RUN ] RobotRegistrationProcessorTest.LastErrorTest [ OK ] RobotRegistrationProcessorTest.LastErrorTest (49 ms) [ RUN ] RobotRegistrationProcessorTest.ArmPoseTest [ OK ] RobotRegistrationProcessorTest.ArmPoseTest (48 ms) [ RUN ] RobotRegistrationProcessorTest.XRayCalibratedTest [ OK ] RobotRegistrationProcessorTest.XRayCalibratedTest (50 ms) [ RUN ] RobotRegistrationProcessorTest.CalibrateXRayTest [ OK ] RobotRegistrationProcessorTest.CalibrateXRayTest (64 ms) [ RUN ] RobotRegistrationProcessorTest.CalibrateFrontalXRayTest [ OK ] RobotRegistrationProcessorTest.CalibrateFrontalXRayTest (49 ms) [ RUN ] RobotRegistrationProcessorTest.CalibrateLateralXRayTest [ OK ] RobotRegistrationProcessorTest.CalibrateLateralXRayTest (72 ms) [ RUN ] RobotRegistrationProcessorTest.SaveCalibratedXRayTest [ OK ] RobotRegist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 | 杨斌 | 2021-02-02 | OK | PASS
B-UT0103002 |  | IsRegsiteredTest | 是否已校准测试 | TEST_F(RobotRegistrationProcessorTest, IsRegsiteredTest) |  | 杨斌 | 2021-02-02 | OK | PASS
B-UT0103003 |  | IsFrontalRegsiteredTest | 是否已正位校准测试 | TEST_F(RobotRegistrationProcessorTest, IsFrontalRegsiteredTest) |  | 杨斌 | 2021-02-02 | OK | PASS
B-UT0103004 |  | IsLateralRegsiteredTest | 是否已侧位校准测试 | TEST_F(RobotRegistrationProcessorTest, IsLateralRegsiteredTest) |  | 杨斌 | 2021-02-02 | OK | PASS
B-UT0103005 |  | LastLocationTest | 返回当前位置测试 | TEST_F(RobotRegistrationProcessorTest, LastLocationTest) |  | 杨斌 | 2021-02-02 | OK | PASS
B-UT0103006 |  | LastErrorTest | 返回当前错误测试 | TEST_F(RobotRegistrationProcessorTest, LastErrorTest) |  | 杨斌 | 2021-02-02 | OK | PASS
B-UT0103007 |  | ArmPoseTest | 机械臂姿势测试 | TEST_F(RobotRegistrationProcessorTest, ArmPoseTest) |  | 杨斌 | 2021-02-02 | OK | PASS
B-UT0103008 |  | XRayCalibratedTest | X光已校正测试 | TEST_F(RobotRegistrationProcessorTest, XRayCalibratedTest) |  | 杨斌 | 2021-02-02 | OK | PASS
B-UT0103009 |  | CalibrateXRayTest | 校正X光测试 | TEST_F(RobotRegistrationProcessorTest, CalibrateXRayTest) |  | 杨斌 | 2021-02-02 | OK | PASS
B-UT0103010 |  | CalibrateFrontalXRayTest | 正位X光校正测试 | TEST_F(RobotRegistrationProcessorTest, CalibrateFrontalXRayTest) |  | 杨斌 | 2021-02-02 | OK | PASS
B-UT0103011 |  | CalibrateLateralXRayTest | 侧位X光校正测 | TEST_F(RobotRegistrationProcessorTest, CalibrateLateralXRayTest) |  | 杨斌 | 2021-02-02 | OK | PASS
B-UT0103012 |  | SaveCalibratedXRayTest | 保存X光校正测试 | TEST_F(RobotRegistrationProcessorTest, SaveCalibratedXRayTest) |  | 杨斌 | 2021-02-02 | OK | PASS
B-UT0103013 |  | SaveFrontalCalibratedXRayTest | 保存正位X光校正测试 | TEST_F(RobotRegistrationProcessorTest, SaveFrontalCalibratedXRayTest) |  | 杨斌 | 2021-02-02 | OK | PASS
B-UT0103014 |  | SaveLateralCalibratedXRayTest | 保存侧位X光校正测试 | TEST_F(RobotRegistrationProcessorTest, SaveLateralCalibratedXRayTest) |  | 杨斌 | 2021-02-02 | OK | PASS
B-UT0103015 |  | ArmFrontalRegistrationTest | 机械臂正位校准测试 | TEST_F(RobotRegistrationProcessorTest, ArmFrontalRegistrationTest) |  | 杨斌 | 2021-02-02 | OK | PASS
B-UT0103016 |  | ArmLateralRegistrationTest | 机械臂侧位校准测试 | TEST_F(RobotRegistrationProcessorTest, ArmLateralRegistrationTest) |  | 杨斌 | 2021-02-02 | OK | PASS
B-UT0103017 |  | Frontal2LateralMatrixTest | 正侧位关系矩阵测试 | TEST_F(RobotRegistrationProcessorTest, Frontal2LateralMatrixTest) |  | 杨斌 | 2021-02-02 | OK | PASS
B-UT0103018 |  | LocatRayTest | 位置通道测试 | TEST_F(RobotRegistrationProcessorTest, LocatRayTest) |  | 杨斌 | 2021-02-02 | OK | PASS
B-UT0103019 |  | Locat3dRayTest | 三维位置通道测试 | TEST_F(RobotRegistrationProcessorTest, Locat3dRayTest) |  | 杨斌 | 2021-02-02 | OK | PASS
B-UT0103020 |  | ArmFrontalMatrixTest | 机械臂正位矩阵测试 | TEST_F(RobotRegistrationProcessorTest, ArmFrontalMatrixTest) |  | 杨斌 | 2021-02-02 | OK | PASS
B-UT0103021 |  | ArmLateralMatrixTest | 机械臂侧位矩阵测试 | TEST_F(RobotRegistrationProcessorTest, ArmLateralMatrixTest) |  | 杨斌 | 2021-02-02 | OK | PASS
B-UT0103022 |  | Mat2VectorTest | 矩阵转数组测试 | TEST_F(RobotRegistrationProcessorTest, Mat2VectorTest) |  | 杨斌 | 2021-02-02 | OK | PASS
B-UT0103023 |  | Vector2MatTest | 数组转矩阵测试 | TEST_F(RobotRegistrationProcessorTest, Vector2MatTest) |  | 杨斌 | 2021-02-02 | OK | PASS
B-UT0104001 | RobotWorkerTest | PreparedTest | 准备测试 | TEST_F(RobotWorkerTest, PreparedTest) | [----------] 24 tests from RobotWorkerTest [ RUN ] RobotWorkerTest.PreparedTest [ OK ] RobotWorkerTest.PreparedTest (64 ms) [ RUN ] RobotWorkerTest.SaveFrontalTest [ OK ] RobotWorkerTest.SaveFrontalTest (66 ms) [ RUN ] RobotWorkerTest.SaveLateralTest [ OK ] RobotWorkerTest.SaveLateralTest (76 ms) [ RUN ] RobotWorkerTest.CalibrateFrontalTest [ OK ] RobotWorkerTest.CalibrateFrontalTest (63 ms) [ RUN ] RobotWorkerTest.CalibratelateralTest [ OK ] RobotWorkerTest.CalibratelateralTest (57 ms) [ RUN ] RobotWorkerTest.RegistrationFrontalTest [ OK ] RobotWorkerTest.RegistrationFrontalTest (67 ms) [ RUN ] RobotWorkerTest.RegistrationLateralTest [ OK ] RobotWorkerTest.RegistrationLateralTest (47 ms) [ RUN ] RobotWorkerTest.LaserLocateTest [ OK ] RobotWorkerTest.LaserLocateTest (131 ms) [ RUN ] RobotWorkerTest.PathLocateTest [ OK ] RobotWorkerTest.PathLocateTest (115 ms) [ RUN ] RobotWorkerTest.Get3dPointsTest [ OK ] RobotWorkerTest.Get3dPointsTest (63 ms) [ RUN ] RobotWorkerTest.GetCal2flangeMatrixTest [ OK ] RobotWorkerTest.GetCal2flangeMatrixTest (49 ms) [ RUN ] RobotWorkerTest.GetCalibrationCoefficientTest [ OK ] RobotWorkerTest.GetCalibrationCoefficientTest (382545 ms) [ RUN ] RobotWorkerTest.StartCalibrationCoefficientTest [ OK ] RobotWorkerTest.StartCalibrationCoefficientTest (79 ms) [ RUN ] RobotWorkerTest.LoadMarkerDataTest [ OK ] RobotWorkerTest.LoadMarkerDataTest (56 ms) [ RUN ] RobotWorkerTest.MarkerDetectTest [ OK ] RobotWorkerTest.MarkerDetectTest (78 ms) [ RUN ] RobotWor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 | 杨斌 | 2021-02-02 | OK | PASS
B-UT0104002 |  | SaveFrontalTest | 保存正位测试 | TEST_F(RobotWorkerTest, SaveFrontalTest) |  | 杨斌 | 2021-02-02 | OK | PASS
B-UT0104003 |  | SaveLateralTest | 保存侧位测试 | TEST_F(RobotWorkerTest, SaveLateralTest) |  | 杨斌 | 2021-02-02 | OK | PASS
B-UT0104004 |  | CalibrateFrontalTest | 正位校正测试 | TEST_F(RobotWorkerTest, CalibrateFrontalTest) |  | 杨斌 | 2021-02-02 | OK | PASS
B-UT0104005 |  | CalibratelateralTest | 侧位校正测试 | TEST_F(RobotWorkerTest, CalibratelateralTest) |  | 杨斌 | 2021-02-02 | OK | PASS
B-UT0104006 |  | RegistrationFrontalTest | 正位校准测试 | TEST_F(RobotWorkerTest, RegistrationFrontalTest) |  | 杨斌 | 2021-02-02 | OK | PASS
B-UT0104007 |  | RegistrationLateralTest | 侧位校准测试 | TEST_F(RobotWorkerTest, RegistrationLateralTest) |  | 杨斌 | 2021-02-02 | OK | PASS
B-UT0104008 |  | LaserLocateTest | 通道定位测试 | TEST_F(RobotWorkerTest, LaserLocateTest) |  | 杨斌 | 2021-02-02 | OK | PASS
B-UT0104009 |  | PathLocateTest | 定位路径测试 | TEST_F(RobotWorkerTest, PathLocateTest) |  | 杨斌 | 2021-02-02 | OK | PASS
B-UT0104010 |  | Get3dPointsTest | 获取3d点测试 | TEST_F(RobotWorkerTest, Get3dPointsTest) |  | 杨斌 | 2021-02-02 | OK | PASS
B-UT0104011 |  | GetCal2flangeMatrixTest | 获取法兰矩阵测试 | TEST_F(RobotWorkerTest, GetCal2flangeMatrixTest) |  | 杨斌 | 2021-02-02 | OK | PASS
B-UT0104012 |  | GetCalibrationCoefficientTest | 获取校正关系矩阵测试 | TEST_F(RobotWorkerTest, GetCalibrationCoefficientTest) |  | 杨斌 | 2021-02-02 | OK | PASS
B-UT0104013 |  | StartCalibrationCoefficientTest | 开始畸变校正测试 | TEST_F(RobotWorkerTest, StartCalibrationCoefficientTest) |  | 杨斌 | 2021-02-02 | OK | PASS
B-UT0104014 |  | LoadMarkerDataTest | 载入Marker球数据测试 | TEST_F(RobotWorkerTest, LoadMarkerDataTest) |  | 杨斌 | 2021-02-02 | OK | PASS
B-UT0104015 |  | MarkerDetectTest | 监测Marker球测试 | TEST_F(RobotWorkerTest, MarkerDetectTest) |  | 杨斌 | 2021-02-02 | OK | PASS
B-UT0104016 |  | RegistrationTest | 校准测试 | TEST_F(RobotWorkerTest, RegistrationTest) |  | 杨斌 | 2021-02-02 | OK | PASS
B-UT0104017 |  | GetPointOnLineTest | 获取在线点测试 | TEST_F(RobotWorkerTest, GetPointOnLineTest) |  | 杨斌 | 2021-02-02 | OK | PASS
B-UT0104018 |  | GetPose2dTest | 获取2d姿态测试 | TEST_F(RobotWorkerTest, GetPose2dTest) |  | 杨斌 | 2021-02-02 | OK | PASS
B-UT0104019 |  | GetPose3dTest | 获取3d姿态 | TEST_F(RobotWorkerTest, GetPose3dTest) |  | 杨斌 | 2021-02-02 | OK | PASS
B-UT0104020 |  | RobertPose2MatrixTest | 机器姿态转成矩阵测试 | TEST_F(RobotWorkerTest, RobertPose2MatrixTest) |  | 杨斌 | 2021-02-02 | OK | PASS
B-UT0104021 |  | Pos2MatrixTest | 位置转成矩阵测试 | TEST_F(RobotWorkerTest, Pos2MatrixTest) |  | 杨斌 | 2021-02-02 | OK | PASS
B-UT0104022 |  | ConnectedRegionTest | 联通区域测试 | TEST_F(RobotWorkerTest, ConnectedRegionTest) |  | 杨斌 | 2021-02-02 | OK | PASS
B-UT0104023 |  | GetInitializeTest | 获取初始化信息测试 | TEST_F(RobotWorkerTest, GetInitializeTest) |  | 杨斌 | 2021-02-02 | OK | PASS
B-UT0104024 |  | CompensateTransfromTest | 补偿转换测试 | TEST_F(RobotWorkerTest, CompensateTransfromTest) |  | 杨斌 | 2021-02-02 | OK | PASS

Sheet: 02定位
02定位
测试用例ID | 测试用例 | 测试名称 | 判断 | 输入项目 | 输出结果 | 验证人 | 验证日期 | 结果 | 测试状态
B-UT0201001 | ArmDriveURTest | InitProcessorTest | 初始化处理器测试 | TEST_F(ArmDriveURTest, InitProcessorTest) | [----------] 56 tests from ArmDriveURTest [ RUN ] ArmDriveURTest.InitProcessorTest Com3 open failed [ OK ] ArmDriveURTest.InitProcessorTest (77 ms) [ RUN ] ArmDriveURTest.StartServerTest Com3 open failed [ OK ] ArmDriveURTest.StartServerTest (138 ms) [ RUN ] ArmDriveURTest.StateTest Com3 open failed [ OK ] ArmDriveURTest.StateTest (140 ms) [ RUN ] ArmDriveURTest.IsConnectedTest Com3 open failed [ OK ] ArmDriveURTest.IsConnectedTest (142 ms) [ RUN ] ArmDriveURTest.IsFreeDriveTest Com3 open failed [ OK ] ArmDriveURTest.IsFreeDriveTest (146 ms) [ RUN ] ArmDriveURTest.CheckProcessorTest Com3 open failed [ OK ] ArmDriveURTest.CheckProcessorTest (140 ms) [ RUN ] ArmDriveURTest.SetPortTest Com3 open failed [ OK ] ArmDriveURTest.SetPortTest (141 ms) [ RUN ] ArmDriveURTest.ConnectArmTest Com3 open failed [ OK ] ArmDriveURTest.ConnectArmTest (138 ms) [ RUN ] ArmDriveURTest.DisconnectArmTest Com3 open failed Could not parse stylesheet of object 0x214a88a1500 [ OK ] ArmDriveURTest.DisconnectArmTest (572 ms) [ RUN ] ArmDriveURTest.StartTest Com3 open failed [ OK ] ArmDriveURTest.StartTest (138 ms) [ RUN ] ArmDriveURTest.StopTest Com3 open failed [ OK ] ArmDriveURTest.StopTest (158 ms) [ RUN ] ArmDriveURTest.PauseTest Com3 open failed [ OK ] ArmDriveURTest.PauseTest (143 ms) [ RUN ] ArmDriveURTest.ResumeTest Com3 open failed [ OK ] ArmDriveURTest.ResumeTest (147 ms) [ RUN ] ArmDriveURTest.MoveLaserTest Com3 open failed [ OK ] ArmDriveURTest.MoveLaserTest (128 ms) QIODevice::write (QTcpSo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 | 杨斌 | 2021-03-13 | OK | PASS
B-UT0201002 |  | StartServerTest | 开启服务测试 | TEST_F(ArmDriveURTest, StartServerTest) |  | 杨斌 | 2021-03-13 | OK | PASS
B-UT0201003 |  | StateTest | 状态测试 | TEST_F(ArmDriveURTest, StateTest) |  | 杨斌 | 2021-03-13 | OK | PASS
B-UT0201004 |  | IsConnectedTest | 是否连接测试 | TEST_F(ArmDriveURTest, IsConnectedTest) |  | 杨斌 | 2021-03-13 | OK | PASS
B-UT0201005 |  | connectArmTest | 连接机械臂测试 | TEST_F(ArmDriveURTest, IsFreeDriveTest) |  | 杨斌 | 2021-03-13 | OK | PASS
B-UT0201006 |  | IsFreeDriveTest | 驱动是否空闲测试 | TEST_F(ArmDriveURTest, CheckProcessorTest) |  | 杨斌 | 2021-03-13 | OK | PASS
B-UT0201007 |  | CheckProcessorTes | 检查处理器测试 | TEST_F(ArmDriveURTest, SetPortTest) |  | 杨斌 | 2021-03-13 | OK | PASS
B-UT0201008 |  | SetPortTest | 设置端口测试 | TEST_F(ArmDriveURTest, ConnectArmTest) |  | 杨斌 | 2021-03-13 | OK | PASS
B-UT0201009 |  | ConnectArmTest | 连接机械臂测试 | TEST_F(ArmDriveURTest, DisconnectArmTest) |  | 杨斌 | 2021-03-13 | OK | PASS
B-UT0201010 |  | StartTest | 开启测试 | TEST_F(ArmDriveURTest, StartTest) |  | 杨斌 | 2021-03-13 | OK | PASS
B-UT0201011 |  | StopTest | 停止测试 | TEST_F(ArmDriveURTest, StopTest) |  | 杨斌 | 2021-03-13 | OK | PASS
B-UT0201012 |  | PauseTest | 暂停测试 | TEST_F(ArmDriveURTest, PauseTest) |  | 杨斌 | 2021-03-13 | OK | PASS
B-UT0201013 |  | ResumeTest | 恢复测试 | TEST_F(ArmDriveURTest, ResumeTest) |  | 杨斌 | 2021-03-13 | OK | PASS
B-UT0201014 |  | MoveLaserTest | 移动激光测试 | TEST_F(ArmDriveURTest, MoveLaserTest) |  | 杨斌 | 2021-03-13 | OK | PASS
B-UT0201015 |  | MoveChannelTest | 移动通道测试 | TEST_F(ArmDriveURTest, MoveChannelTest) |  | 杨斌 | 2021-03-13 | OK | PASS
B-UT0201016 |  | MovePathTest | 移动路径测试 | TEST_F(ArmDriveURTest, MovePathTest) |  | 杨斌 | 2021-03-13 | OK | PASS
B-UT0201017 |  | SetFreeDriveTest | 设置驱动空闲测试 | TEST_F(ArmDriveURTest, SetFreeDriveTest) |  | 杨斌 | 2021-03-13 | OK | PASS
B-UT0201018 |  | SetSpeedTest | 设置速度测试 | TEST_F(ArmDriveURTest, SetSpeedTest) |  | 杨斌 | 2021-03-13 | OK | PASS
B-UT0201019 |  | laserSwitchTest | 激光转换测试 | TEST_F(ArmDriveURTest, laserSwitchTest) |  | 杨斌 | 2021-03-13 | OK | PASS
B-UT0201020 |  | ResetArmTest | 重启机械臂测试 | TEST_F(ArmDriveURTest, ResetArmTest) |  | 杨斌 | 2021-03-13 | OK | PASS
B-UT0201021 |  | FrontalLateralResetArmTest | 正侧位重置机械臂测试 | TEST_F(ArmDriveURTest, FrontalLateralResetArmTest) |  | 杨斌 | 2021-03-13 | OK | PASS
B-UT0201022 |  | ResetLocationTest | 重置定位测试 | TEST_F(ArmDriveURTest, ResetLocationTest) |  | 杨斌 | 2021-03-13 | OK | PASS
B-UT0201023 |  | AlignArmTest | 校准机械臂测试 | TEST_F(ArmDriveURTest, AlignArmTest) |  | 杨斌 | 2021-03-13 | OK | PASS
B-UT0201024 |  | OriginPosTest | 起始位置测试 | TEST_F(ArmDriveURTest, OriginPosTest) |  | 杨斌 | 2021-03-13 | OK | PASS
B-UT0201025 |  | SetOriginTest | 设置起点测试 | TEST_F(ArmDriveURTest, SetOriginTest) |  | 杨斌 | 2021-03-13 | OK | PASS
B-UT0201026 |  | SetOrigin1Test | 设置起点测试 | TEST_F(ArmDriveURTest, SetOrigin1Test) |  | 杨斌 | 2021-03-13 | OK | PASS
B-UT0201027 |  | SetChannelInvalidTest | 设置通道不合理测试 | TEST_F(ArmDriveURTest, SetChannelInvalidTest) |  | 杨斌 | 2021-03-13 | OK | PASS
B-UT0201028 |  | ArmPosTest | 机械臂位置测试 | TEST_F(ArmDriveURTest, ArmPosTest) |  | 杨斌 | 2021-03-13 | OK | PASS
B-UT0201029 |  | FrontalRegisterArmWithXRayTest | 机械臂正位注册测试 | TEST_F(ArmDriveURTest, FrontalRegisterArmWithXRayTest) |  | 杨斌 | 2021-03-13 | OK | PASS
B-UT0201030 |  | LateralRegisterArmWithXRayTest | 机械臂侧位注册测试 | TEST_F(ArmDriveURTest, LateralRegisterArmWithXRayTest) |  | 杨斌 | 2021-03-13 | OK | PASS
B-UT0201031 |  | RegisterArmWithXRayTest | 机械臂注册测试 | TEST_F(ArmDriveURTest, RegisterArmWithXRayTest) |  | 杨斌 | 2021-03-13 | OK | PASS
B-UT0201032 |  | UpdateAngleTest | 更新角度测试 | TEST_F(ArmDriveURTest, UpdateAngleTest) |  | 杨斌 | 2021-03-13 | OK | PASS
B-UT0201033 |  | UpdateHeightTest | 更新高度测试 | TEST_F(ArmDriveURTest, UpdateHeightTest) |  | 杨斌 | 2021-03-13 | OK | PASS
B-UT0201034 |  | UpdateHeightAngleTest | 更新高度角度测试 | TEST_F(ArmDriveURTest, UpdateHeightAngleTest) |  | 杨斌 | 2021-03-13 | OK | PASS
B-UT0201035 |  | StretchArmTest | 拉伸机械臂测试 | TEST_F(ArmDriveURTest, StretchArmTest) |  | 杨斌 | 2021-03-13 | OK | PASS
B-UT0201036 |  | ExtendArmTest | 展开机械臂测试 | TEST_F(ArmDriveURTest, ExtendArmTest) |  | 杨斌 | 2021-03-13 | OK | PASS
B-UT0201037 |  | StowageArmTest | 收回机械臂测试 | TEST_F(ArmDriveURTest, StowageArmTest) |  | 杨斌 | 2021-03-13 | OK | PASS
B-UT0201038 |  | Update2dAngleTest | 更新角度测试 | TEST_F(ArmDriveURTest, Update2dAngleTest) |  | 杨斌 | 2021-03-13 | OK | PASS
B-UT0201039 |  | Update2dHeightTest | 更新高度测试 | TEST_F(ArmDriveURTest, Update2dHeightTest) |  | 杨斌 | 2021-03-13 | OK | PASS
B-UT0201040 |  | SimulationTest | 仿真测试 | TEST_F(ArmDriveURTest, SimulationTest) |  | 杨斌 | 2021-03-13 | OK | PASS
B-UT0201041 |  | LaserTargetPoseTest | 激光定位姿态测试 | TEST_F(ArmDriveURTest, LaserTargetPoseTest) |  | 杨斌 | 2021-03-13 | OK | PASS
B-UT0201042 |  | ChannelTargetPoseTest | 通道定位姿态测试 | TEST_F(ArmDriveURTest, ChannelTargetPoseTest) |  | 杨斌 | 2021-03-13 | OK | PASS
B-UT0201043 |  | LaserTcpTest | 激光TCP测试 | TEST_F(ArmDriveURTest, LaserTcpTest) |  | 杨斌 | 2021-03-13 | OK | PASS
B-UT0201044 |  | ChannelTcpTest | 通道TCP测试 | TEST_F(ArmDriveURTest, ChannelTcpTest) |  | 杨斌 | 2021-03-13 | OK | PASS
B-UT0201045 |  | SetLaserTcpTest | 设置激光TCP测试 | TEST_F(ArmDriveURTest, SetLaserTcpTest) |  | 杨斌 | 2021-03-13 | OK | PASS
B-UT0201046 |  | SetChannelTcpTest | 设置通道TCP测试 | TEST_F(ArmDriveURTest, SetChannelTcpTest) |  | 杨斌 | 2021-03-13 | OK | PASS
B-UT0201047 |  | LaserStatusTest | 激光状态测试 | TEST_F(ArmDriveURTest, LaserStatusTest) |  | 杨斌 | 2021-03-13 | OK | PASS
B-UT0201048 |  | SetDebugTest | 设置调试模式测试 | TEST_F(ArmDriveURTest, SetDebugTest) |  | 杨斌 | 2021-03-13 | OK | PASS
B-UT0201049 |  | ArmCtlDlgShowedTest | 机械臂控制对话框测试 | TEST_F(ArmDriveURTest, ArmCtlDlgShowedTest) |  | 杨斌 | 2021-03-13 | OK | PASS
B-UT0201050 |  | QueryArmJointTest | 查看机械臂关节测试 | TEST_F(ArmDriveURTest, QueryArmJointTest) |  | 杨斌 | 2021-03-13 | OK | PASS
B-UT0201051 |  | ReceiveMoveChannelPathTest | 接收移动通道路径测试 | TEST_F(ArmDriveURTest, ReceiveMoveChannelPathTest) |  | 杨斌 | 2021-03-13 | OK | PASS
B-UT0201052 |  | ReceiveMove3dChannelPathTest | 接收移动3D通道路径测试 | TEST_F(ArmDriveURTest, ReceiveMove3dChannelPathTest) |  | 杨斌 | 2021-03-13 | OK | PASS
B-UT0201053 |  | ReceiveCalcPathFinishedTest | 接收计算路径完成测试 | TEST_F(ArmDriveURTest, ReceiveCalcPathFinishedTest) |  | 杨斌 | 2021-03-13 | OK | PASS
B-UT0201054 |  | SimulateTargetCartesianTest | 仿真定位笛卡尔坐标系测试 | TEST_F(ArmDriveURTest, SimulateTargetCartesianTest) |  | 杨斌 | 2021-03-13 | OK | PASS
B-UT0201055 |  | ToExtendArmTest | 开始展开机械臂测试 | TEST_F(ArmDriveURTest, ToExtendArmTest) |  | 杨斌 | 2021-03-13 | OK | PASS
B-UT0201056 |  | ToStowageArmTest | 开始收回机械臂测试 | TEST_F(ArmDriveURTest, ToStowageArmTest) |  | 杨斌 | 2021-03-13 | OK | PASS

Sheet: 03仿真
03仿真
测试用例ID | 测试用例 | 测试名称 | 判断 | 输入项目 | 输出结果 | 验证人 | 验证日期 | 结果 | 测试状态
B-UT0301001 | RRTTest | SetStartEndPointTest | 设置起始点、终点测试 | TEST_F(RRTTest, SetStartEndPointTest) | [==========] Running 15 tests from 1 test case. [----------] Global test environment set-up. [----------] 15 tests from RRTTest [ RUN ] RRTTest.SetStartEndPointTest [ OK ] RRTTest.SetStartEndPointTest (6 ms) [ RUN ] RRTTest.SetHighTest [ OK ] RRTTest.SetHighTest (1 ms) [ RUN ] RRTTest.SetModeTest [ OK ] RRTTest.SetModeTest (1 ms) [ RUN ] RRTTest.JudgeJointTest [ OK ] RRTTest.JudgeJointTest (2 ms) [ RUN ] RRTTest.ExtendNewNodeTest [ OK ] RRTTest.ExtendNewNodeTest (2 ms) [ RUN ] RRTTest.FindTreesTest [ OK ] RRTTest.FindTreesTest (137317 ms) [ RUN ] RRTTest.CreatNewRandJointTest [ OK ] RRTTest.CreatNewRandJointTest (1 ms) [ RUN ] RRTTest.MyRandTest [ OK ] RRTTest.MyRandTest (1 ms) [ RUN ] RRTTest.GetNewestAddNodeTest [ OK ] RRTTest.GetNewestAddNodeTest (2 ms) [ RUN ] RRTTest.JudgeReachTest [ OK ] RRTTest.JudgeReachTest (2 ms) [ RUN ] RRTTest.FindPathTest [ OK ] RRTTest.FindPathTest (1 ms) [ RUN ] RRTTest.ToFindPathTest [ OK ] RRTTest.ToFindPathTest (137189 ms) [ RUN ] RRTTest.GetTotalCountTest [ OK ] RRTTest.GetTotalCountTest (1 ms) [ RUN ] RRTTest.GetPathJointByCountTest [ OK ] RRTTest.GetPathJointByCountTest (2 ms) [ RUN ] RRTTest.ReplanPathTest [ OK ] RRTTest.ReplanPathTest (1 ms) [----------] 15 tests from RRTTest (2236116 ms total) | 杨斌 | 2021-03-10 | OK | PASS
B-UT0301002 |  | SetHighTest | 设置基座平面的限制高度测试 | TEST_F(RRTTest, SetHighTest) |  | 杨斌 | 2021-03-10 | OK | PASS
B-UT0301003 |  | SetModeTest | 设置模式测试 | TEST_F(RRTTest, SetModeTest) |  | 杨斌 | 2021-03-10 | OK | PASS
B-UT0301004 |  | JudgeJointTest | 判断角度测试 | TEST_F(RRTTest, JudgeJointTest) |  | 杨斌 | 2021-03-10 | OK | PASS
B-UT0301005 |  | ExtendNewNodeTest | 拓展新节点测试 | TEST_F(RRTTest,ExtendNewNodeTest) |  | 杨斌 | 2021-03-10 | OK | PASS
B-UT0301006 |  | FindTreesTest | 寻找树测试 | TEST_F(RRTTest,FindTreesTest) |  | 杨斌 | 2021-03-10 | OK | PASS
B-UT0301007 |  | CreatNewRandJointTest | 创建新的随机节点测试 | TEST_F(RRTTest, CreatNewRandJointTest) |  | 杨斌 | 2021-03-10 | OK | PASS
B-UT0301008 |  | MyRandTest | 随机测试 | TEST_F(RRTTest, MyRandTest) |  | 杨斌 | 2021-03-10 | OK | PASS
B-UT0301009 |  | GetNewestAddNodeTest | 获取最新增加节点测试 | TEST_F(RRTTest, GetNewestAddNodeTest) |  | 杨斌 | 2021-03-10 | OK | PASS
B-UT0301010 |  | JudgeReachTest | 判断到达测试 | TEST_F(RRTTest, JudgeReachTest) |  | 杨斌 | 2021-03-10 | OK | PASS
B-UT0301011 |  | FindPathTest | 寻找路径点测试 | TEST_F(RRTTest,FindPathTest) |  | 杨斌 | 2021-03-10 | OK | PASS
B-UT0301012 |  | ToFindPathTest | 寻找路径测试 | TEST_F(RRTTest,ToFindPathTest) |  | 杨斌 | 2021-03-10 | OK | PASS
B-UT0301013 |  | GetTotalCountTest | 获取路点个数测试 | TEST_F(RRTTest, GetTotalCountTest) |  | 杨斌 | 2021-03-10 | OK | PASS
B-UT0301014 |  | GetPathJointByCountTest | 根据数量获取路径角度测试 | TEST_F(RRTTest, GetPathJointByCountTest) |  | 杨斌 | 2021-03-10 | OK | PASS
B-UT0301015 |  | ReplanPathTest | 重规划路径测试 | TEST_F(RRTTest,ReplanPathTest) |  | 杨斌 | 2021-03-10 | OK | PASS

Sheet: 04登录
04登录
测试用例ID | 测试用例 | 测试名称 | 判断 | 输入项目 | 输出结果 | 验证人 | 验证日期 | 结果 | 测试状态
B-UT0401001 | MainStoreTest | LoginTest | 登录测试 | TEST_F(MainStoreTest, LoginTest) | [----------] 15 tests from MainStoreTest [ RUN ] MainStoreTest.LoginTest [ OK ] MainStoreTest.LoginTest (0 ms) [ RUN ] MainStoreTest.SetUserIDTest [ OK ] MainStoreTest.SetUserIDTest (0 ms) [ RUN ] MainStoreTest.SetPasswordTest [ OK ] MainStoreTest.SetPasswordTest (0 ms) [ RUN ] MainStoreTest.GetPasswordTest [ OK ] MainStoreTest.GetPasswordTest (0 ms) [ RUN ] MainStoreTest.SetLoginTest [ OK ] MainStoreTest.SetLoginTest (0 ms) [ RUN ] MainStoreTest.GetLoginTest [ OK ] MainStoreTest.GetLoginTest (0 ms) [ RUN ] MainStoreTest.SetSoftInVersionTest [ OK ] MainStoreTest.SetSoftInVersionTest (0 ms) [ RUN ] MainStoreTest.GetSoftInVersionTest [ OK ] MainStoreTest.GetSoftInVersionTest (0 ms) [ RUN ] MainStoreTest.GetCablicateTest [ OK ] MainStoreTest.GetCablicateTest (0 ms) [ RUN ] MainStoreTest.SetCablicateTest [ OK ] MainStoreTest.SetCablicateTest (0 ms) [ RUN ] MainStoreTest.GetPasswordChangedTest [ OK ] MainStoreTest.GetPasswordChangedTest (0 ms) [ RUN ] MainStoreTest.SetPasswordChangedTest [ OK ] MainStoreTest.SetPasswordChangedTest (0 ms) [ RUN ] MainStoreTest.GetSipShowIMTest [ OK ] MainStoreTest.GetSipShowIMTest (0 ms) [ RUN ] MainStoreTest.SetSipShowIMTest [ OK ] MainStoreTest.SetSipShowIMTest (163 ms) [ RUN ] MainStoreTest.GetUserInfoTest QSqlQuery::exec: database not open false "" [ OK ] MainStoreTest.GetUserInfoTest (2 ms) [----------] 15 tests from MainStoreTest (173 ms total) | 杨斌 | 2021-02-08 | OK | PASS
B-UT0401002 |  | SetUserIDTest | 设置用户名测试 | TEST_F(MainStoreTest, SetUserIDTest) |  | 杨斌 | 2021-02-08 | OK | PASS
B-UT0401003 |  | SetPasswordTest | 设置密码测试 | TEST_F(MainStoreTest, SetPasswordTest) |  | 杨斌 | 2021-02-08 | OK | PASS
B-UT0401004 |  | GetPasswordTest | 获取密码测试 | TEST_F(MainStoreTest, GetPasswordTest) |  | 杨斌 | 2021-02-08 | OK | PASS
B-UT0401005 |  | SetLoginTest | 设置登录测试 | TEST_F(MainStoreTest, SetLoginTest) |  | 杨斌 | 2021-02-08 | OK | PASS
B-UT0401006 |  | GetLoginTest | 获取登录测试 | TEST_F(MainStoreTest, GetLoginTest) |  | 杨斌 | 2021-02-08 | OK | PASS
B-UT0401007 |  | SetSoftInVersionTest | 设置软件版本信息测试 | TEST_F(MainStoreTest, SetSoftInVersionTest) |  | 杨斌 | 2021-02-08 | OK | PASS
B-UT0401008 |  | GetSoftInVersionTest | 获取软件版本信息测试 | TEST_F(MainStoreTest, GetSoftInVersionTest) |  | 杨斌 | 2021-02-08 | OK | PASS
B-UT0401009 |  | GetCablicateTest | 获取字幕测试 | TEST_F(MainStoreTest, GetCablicateTest) |  | 杨斌 | 2021-02-08 | OK | PASS
B-UT0401010 |  | SetCablicateTest | 设置字幕测试 | TEST_F(MainStoreTest, SetCablicateTest) |  | 杨斌 | 2021-02-08 | OK | PASS
B-UT0401011 |  | GetPasswordChangedTest | 获取密码修改测试 | TEST_F(MainStoreTest, GetPasswordChangedTest) |  | 杨斌 | 2021-02-08 | OK | PASS
B-UT0401012 |  | SetPasswordChangedTest | 设置密码修改测试 | TEST_F(MainStoreTest, SetPasswordChangedTest) |  | 杨斌 | 2021-02-08 | OK | PASS
B-UT0401013 |  | GetSipShowIMTest | 获取显示的图像测试 | TEST_F(MainStoreTest, GetSipShowIMTest) |  | 杨斌 | 2021-02-08 | OK | PASS
B-UT0401014 |  | SetSipShowIMTest | 设置显示的图像测试 | TEST_F(MainStoreTest, SetSipShowIMTest) |  | 杨斌 | 2021-02-08 | OK | PASS
B-UT0401015 |  | GetUserInfoTest | 获取用户信息测试 | TEST_F(MainStoreTest, GetUserInfoTest) |  | 杨斌 | 2021-02-08 | OK | PASS
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
