santan444/MS001/03-设计开发输出阶段/03软件/03单元测试/规划软件/MS-001规划软件单元测试用例.xlsx

Sheet: 封面
MS-001
规划软件单元测试用例
 | 编制/时间：
 | 审核/时间：
 | 批准/时间：
 | 杭州三坛医疗科技有限公司

Sheet: 文档履历
文档更改履历
版本号 | 发布/实施日期 | 更改内容概述 | 更改者
V1.0 |  | 文件新编

Sheet: 01注册
01注册
测试用例ID | 测试用例 | 测试名称 | 判断 | 输入项目
A-A-UT0101001 | SystemInfoTest | diskIdTest | 是否获取硬盘序列号测试 | TEST(SystemInfoTest, diskIdTest)
A-A-UT0101002 |  | cpuIdTest | 是否获取CPU序列号测试 | TEST(SystemInfoTest, cpuIdTest)
A-A-UT0102001 | SoftLicenseTest | systemCodeTest | 是否生成机器码测试 | TEST(SoftLicenseTest, systemCodeTest)
A-A-UT0102002 |  | isValidTest | 判断注册码的有效性测试 | TEST(SoftLicenseTest, isValidTest)
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
