santan444/MS001/03-设计开发输出阶段/02电子/05物料证书/交换机/TEG1005D.jpg

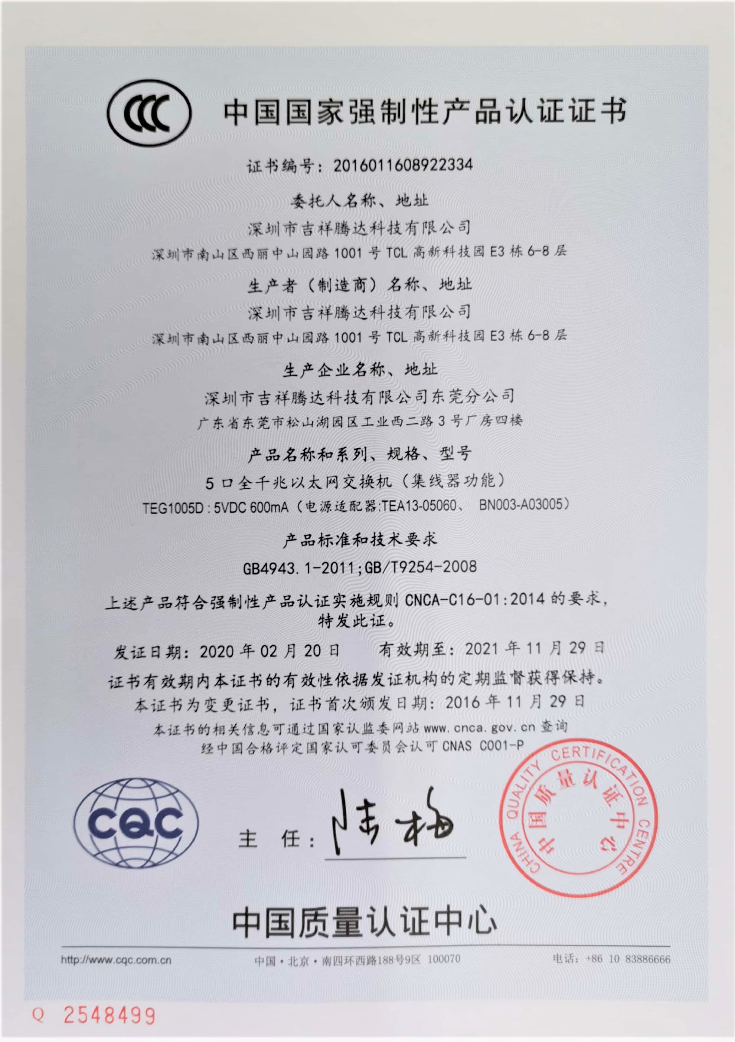
03-设计开发输出阶段/02电子/05物料证书/交换机/TEG1005D.jpg
