santan444/MS001/03-设计开发输出阶段/02电子/05物料证书/显示器/机械臂显示器FC-1560CF.png

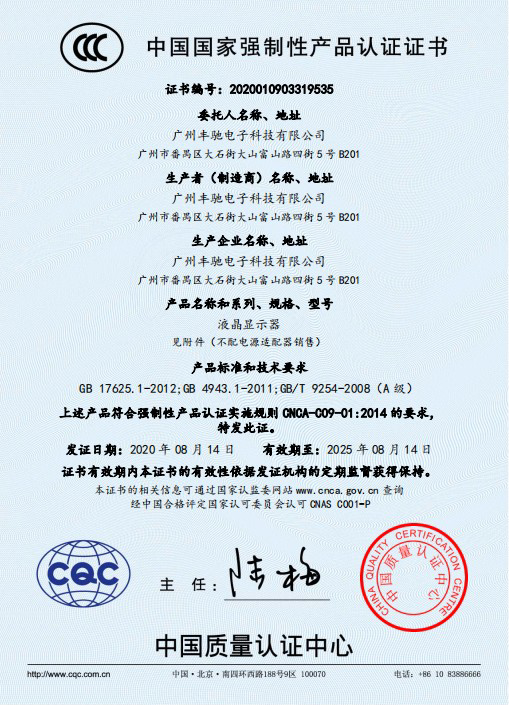
03-设计开发输出阶段/02电子/05物料证书/显示器/机械臂显示器FC-1560CF.png
