santan444/MS001/03-设计开发输出阶段/02电子/05物料证书/电源插座/VDE.png

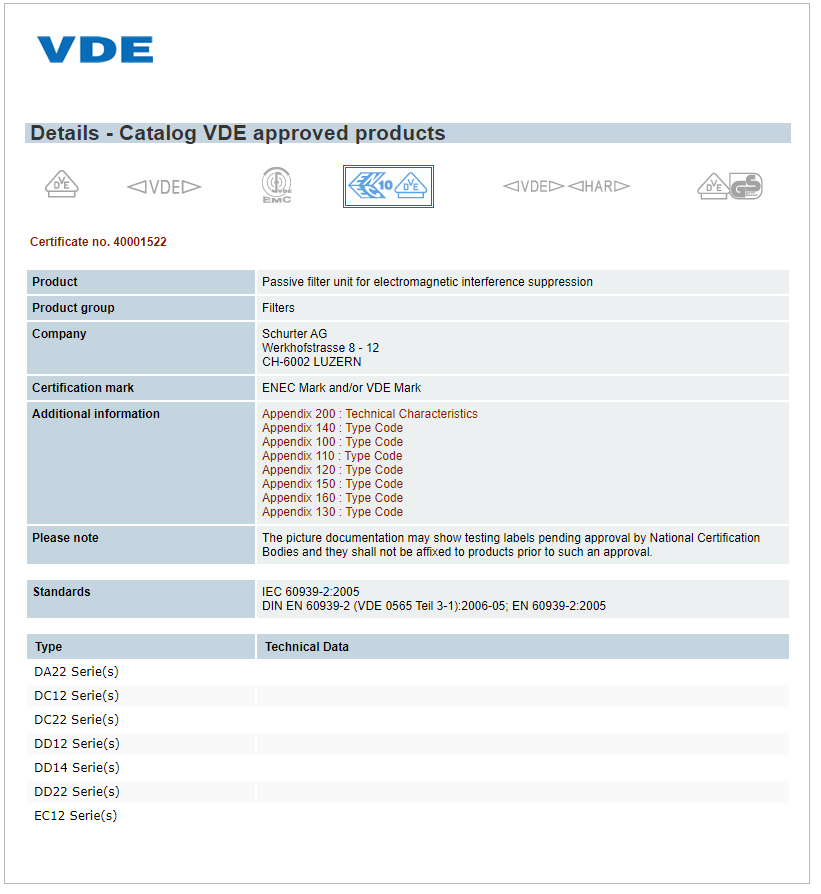
03-设计开发输出阶段/02电子/05物料证书/电源插座/VDE.png
