santan444/MS001/03-设计开发输出阶段/04结构/04结构图/2. MS001-B 导引模块/2. MS001-B STEP零件3D模型/MS001-B.05.008JS.1.1 显示器支架钣金.step

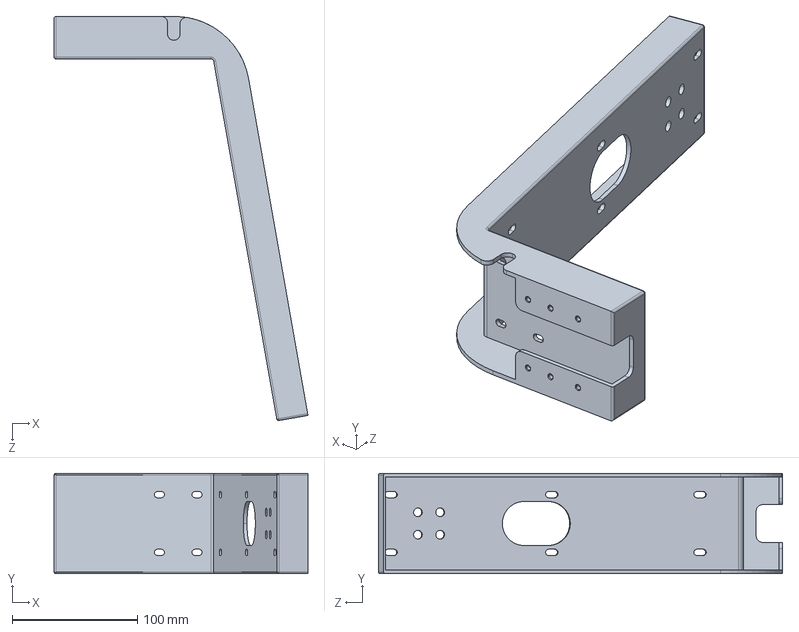
[picture p179: CAD file, 2024-10-22]
03-设计开发输出阶段/04结构/04结构图/2. MS001-B 导引模块/2. MS001-B STEP零件3D模型/MS001-B.05.008JS.1.1 显示器支架钣金.step
202.4 x 80.0 x 322.1 mm
