santan444/MS001/03-设计开发输出阶段/04结构/04结构图/3. MS001-C 工具包/2. MS001-C STEP零件3D模型/MS001-C.07.005SL.1.1 MS001-C木箱珍珠棉1.step

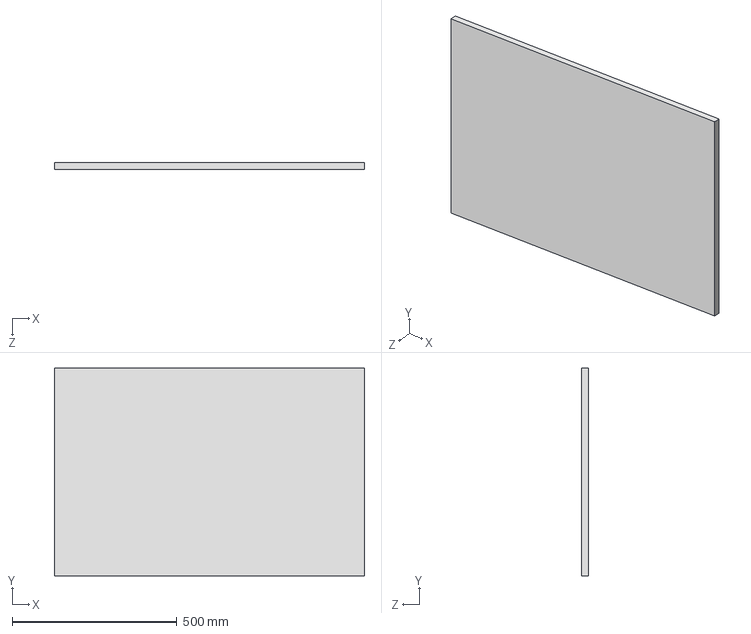
[picture p180: CAD file, 2024-10-22]
03-设计开发输出阶段/04结构/04结构图/3. MS001-C 工具包/2. MS001-C STEP零件3D模型/MS001-C.07.005SL.1.1 MS001-C木箱珍珠棉1.step
940.0 x 630.0 x 20.0 mm
