santan444/MS001/03-设计开发输出阶段/04结构/04结构图/4. MS001-D 体位反馈模块/MS001-D STEP/MS001-D.01.008SL.1.1 MS001-D下外壳.step

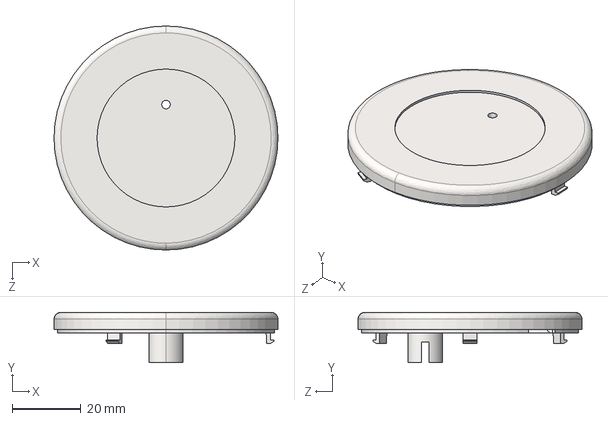
[picture p181: CAD file, 2024-10-22]
03-设计开发输出阶段/04结构/04结构图/4. MS001-D 体位反馈模块/MS001-D STEP/MS001-D.01.008SL.1.1 MS001-D下外壳.step
65.0 x 14.6 x 65.0 mm
