santan444/MS001/03-设计开发输出阶段/04结构/04结构图/5. MS001-C 工具包选配包/图纸/step/MS001-C.08.004JS.1.1-MS001-C底层固定钣金3.step

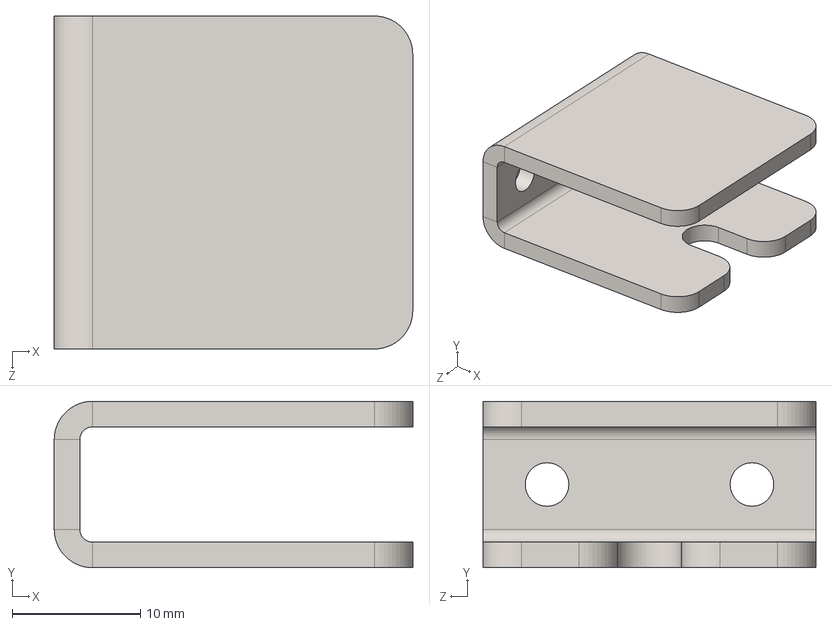
[picture p182: CAD file, 2024-10-22]
03-设计开发输出阶段/04结构/04结构图/5. MS001-C 工具包选配包/图纸/step/MS001-C.08.004JS.1.1-MS001-C底层固定钣金3.step
28.0 x 13.0 x 26.0 mm
