santan444/MS001/03-设计开发输出阶段/04结构/05工艺装备/MS-001系统精度检测工装/MS001.05.002SL.1.1 整机精度检测工装本体.STEP

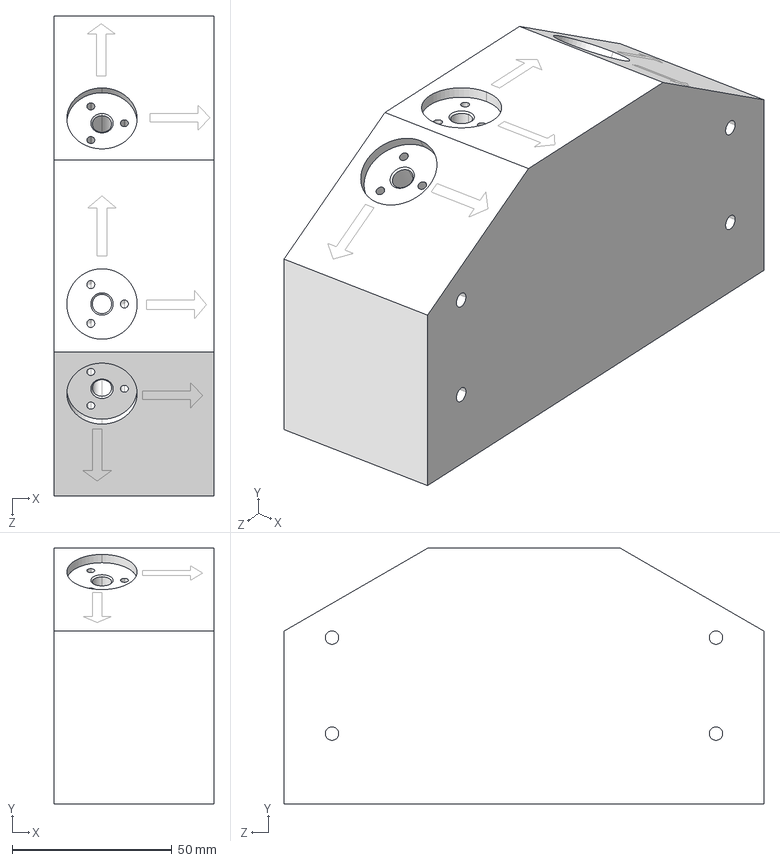
[picture p183: CAD file, 2024-10-22]
03-设计开发输出阶段/04结构/05工艺装备/MS-001系统精度检测工装/MS001.05.002SL.1.1 整机精度检测工装本体.STEP
50.0 x 80.0 x 150.0 mm
