santan444/MS001/03-设计开发输出阶段/04结构/04结构图/1. MS001-A 规划模块/2. MS001-A STEP零件3D模型/MS001-A.04.002JS.1.1侧面板.step

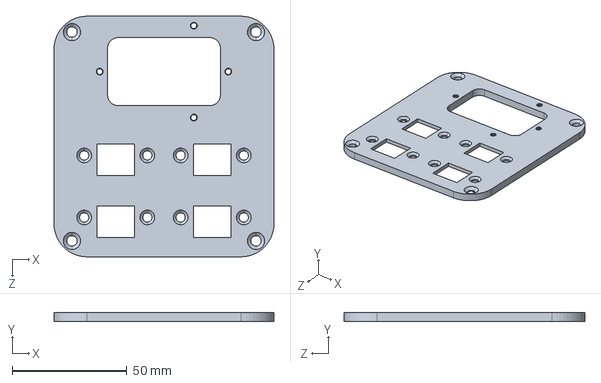
[picture p184: CAD file, 2024-10-22]
03-设计开发输出阶段/04结构/04结构图/1. MS001-A 规划模块/2. MS001-A STEP零件3D模型/MS001-A.04.002JS.1.1侧面板.step
95.8 x 4.00 x 104.8 mm
