santan444/MS001/03-设计开发输出阶段/04结构/04结构图/2. MS001-B 导引模块/2. MS001-B STEP零件3D模型/MS001-B.04.006SL.1.1 遮蔽板.step

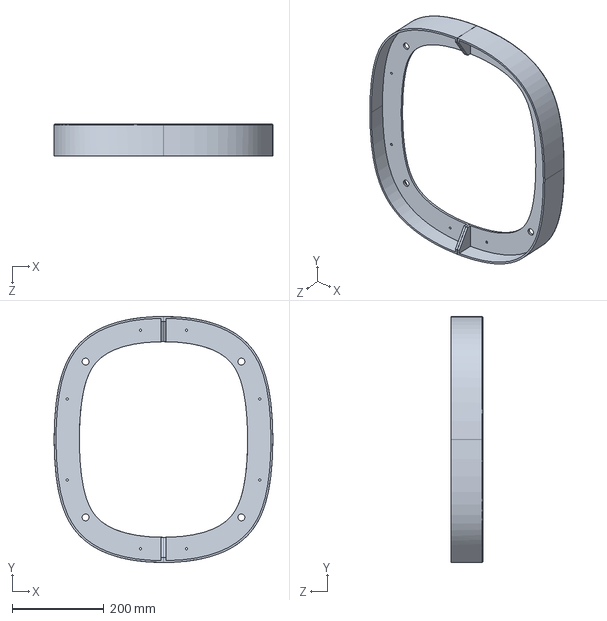
[picture p185: CAD file, 2024-10-22]
03-设计开发输出阶段/04结构/04结构图/2. MS001-B 导引模块/2. MS001-B STEP零件3D模型/MS001-B.04.006SL.1.1 遮蔽板.step
477.2 x 536.8 x 69.0 mm
殑敖啣 x 2
