santan444/MS001/03-设计开发输出阶段/04结构/04结构图/1. MS001-A 规划模块/2. MS001-A STEP零件3D模型/MS001-A.02.026SL.1.1MS001-A静电屏蔽罩.step

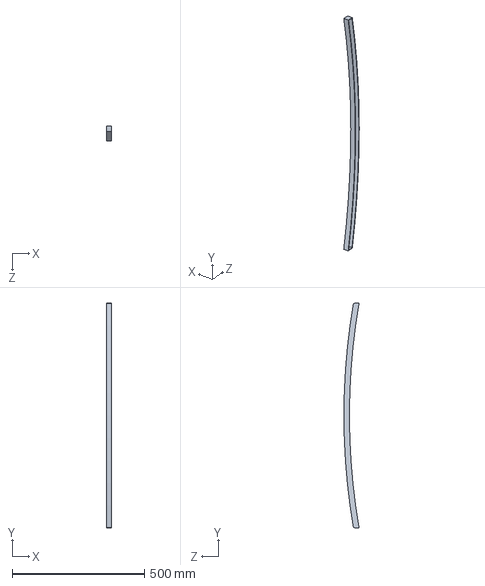
[picture p189: CAD file, 2024-10-22]
03-设计开发输出阶段/04结构/04结构图/1. MS001-A 规划模块/2. MS001-A STEP零件3D模型/MS001-A.02.026SL.1.1MS001-A静电屏蔽罩.step
18.0 x 849.5 x 57.4 mm
