santan444/MS001/03-设计开发输出阶段/04结构/04结构图/2. MS001-B 导引模块/2. MS001-B STEP零件3D模型/MS001-B.04.011SL.1.1 机械臂装饰罩1.step

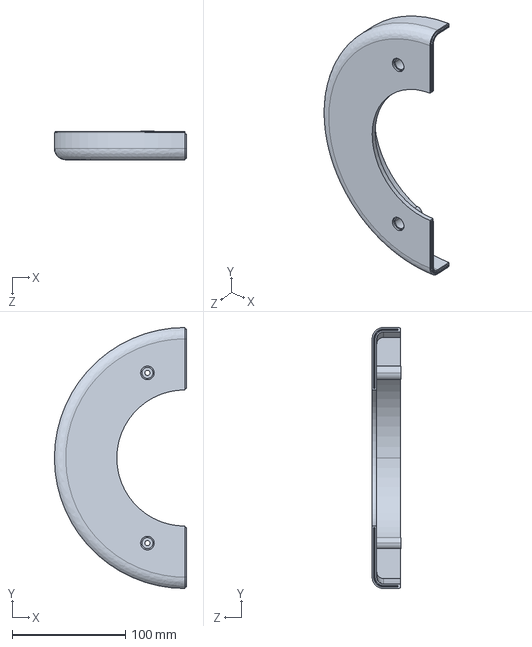
[picture p190: CAD file, 2024-10-22]
03-设计开发输出阶段/04结构/04结构图/2. MS001-B 导引模块/2. MS001-B STEP零件3D模型/MS001-B.04.011SL.1.1 机械臂装饰罩1.step
116.5 x 230.0 x 25.3 mm
