santan444/MS001/03-设计开发输出阶段/04结构/04结构图/3. MS001-C 工具包/2. MS001-C STEP零件3D模型/MS001-C.04.002JS.1.1 MS001-C通道焊接件.STEP

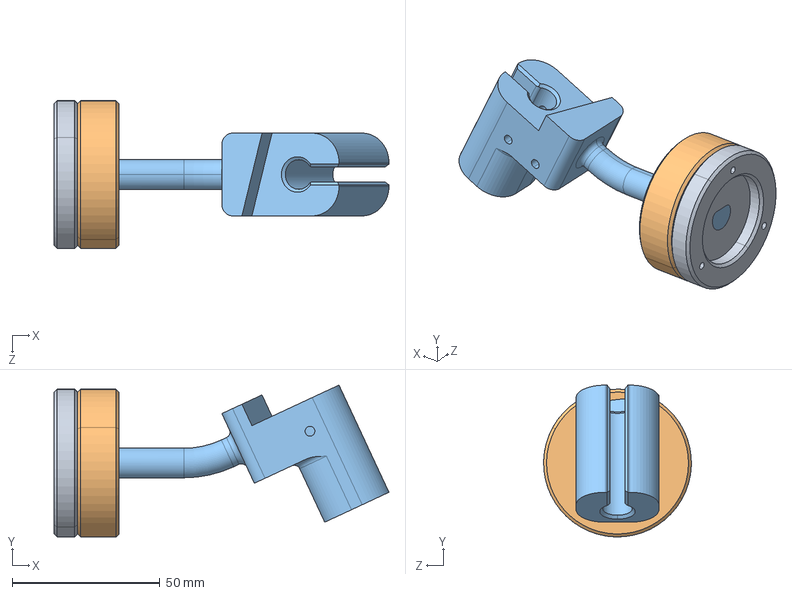
[picture p191: CAD file, 2024-10-22]
03-设计开发输出阶段/04结构/04结构图/3. MS001-C 工具包/2. MS001-C STEP零件3D模型/MS001-C.04.002JS.1.1 MS001-C通道焊接件.STEP
113.3 x 51.4 x 50.0 mm
MS001-C.04.002JS.1.1-附图1 MS001-C连接法兰
MS001-C.04.002JS.1.1-附图2 MS001-C连接法兰2
MS001-C.04.002JS.1.1-附图3 MS001-C通道连杆
