santan444/MS001/03-设计开发输出阶段/04结构/05工艺装备/MS-001系统精度检测工装/MS001.05.004SL.1.1 精度盘.STEP

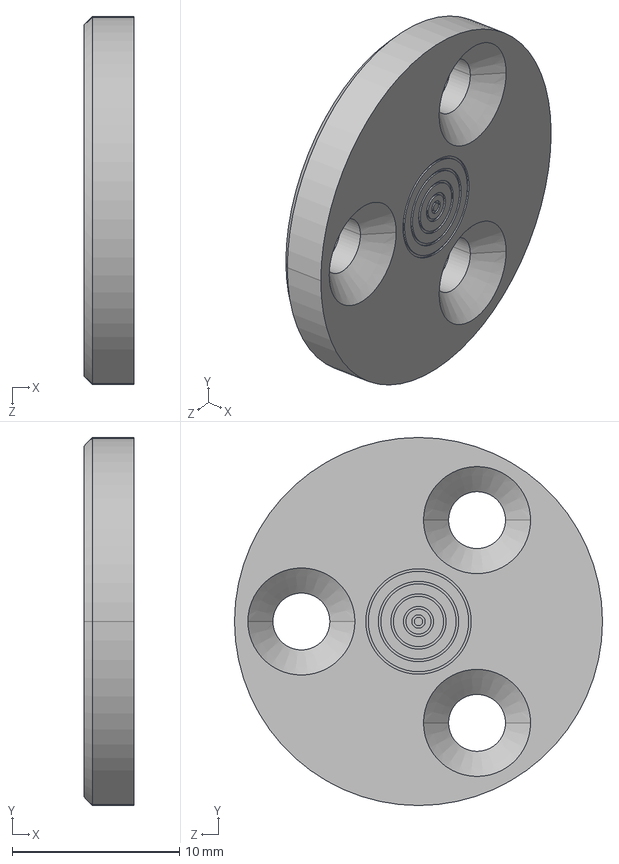
[picture p193: CAD file, 2024-10-22]
03-设计开发输出阶段/04结构/05工艺装备/MS-001系统精度检测工装/MS001.05.004SL.1.1 精度盘.STEP
3.00 x 22.0 x 22.0 mm
