santan444/MS001/03-设计开发输出阶段/04结构/04结构图/2. MS001-B 导引模块/2. MS001-B STEP零件3D模型/MS001-B.03.004JS.1.1 焊接框架.step

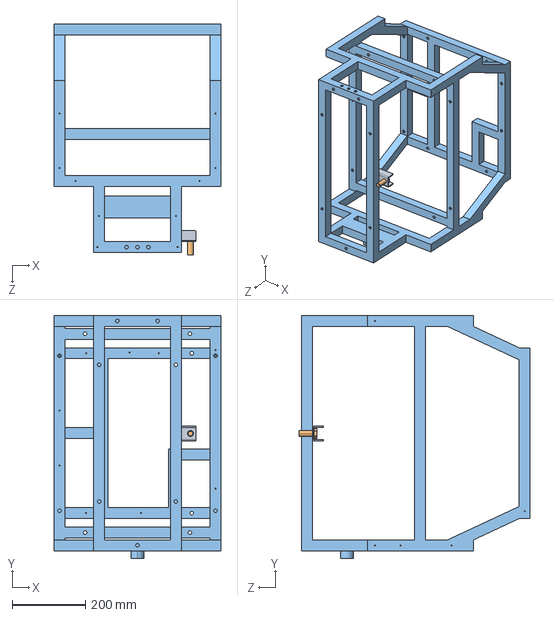
[picture p195: CAD file, 2024-10-22]
03-设计开发输出阶段/04结构/04结构图/2. MS001-B 导引模块/2. MS001-B STEP零件3D模型/MS001-B.03.004JS.1.1 焊接框架.step
457.0 x 665.0 x 633.0 mm
