santan444/MS001/03-设计开发输出阶段/04结构/04结构图/3. MS001-C 工具包/2. MS001-C STEP零件3D模型/MS001-C.02.004SL.1.1 MS001-C止锁按键.step

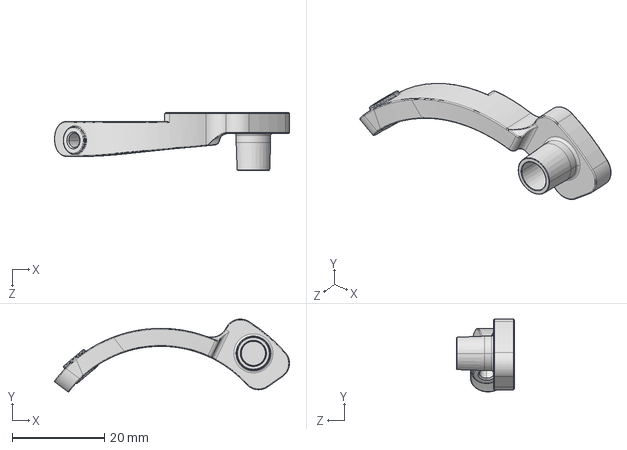
[picture p196: CAD file, 2024-10-22]
03-设计开发输出阶段/04结构/04结构图/3. MS001-C 工具包/2. MS001-C STEP零件3D模型/MS001-C.02.004SL.1.1 MS001-C止锁按键.step
51.0 x 15.8 x 12.5 mm
