santan444/MS001/03-设计开发输出阶段/04结构/04结构图/4. MS001-D 体位反馈模块/MS001-D STEP/MS001-D.01.002SL.1.1 MS001-D开关.step

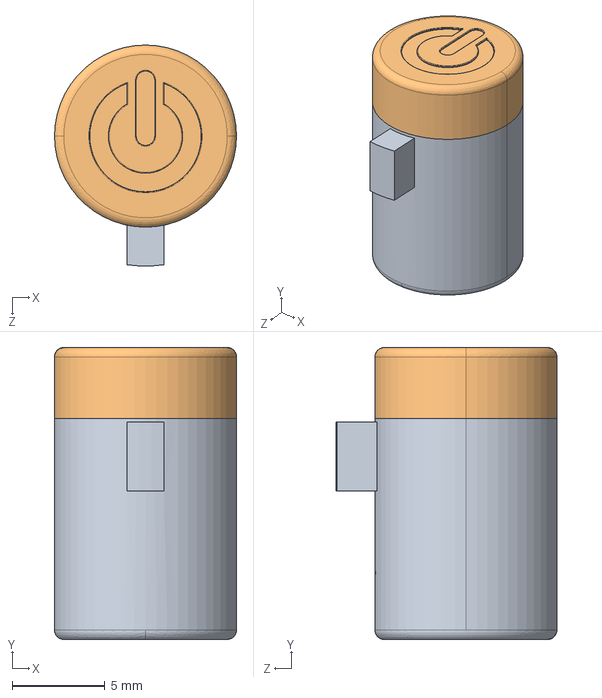
[picture p197: CAD file, 2024-10-22]
03-设计开发输出阶段/04结构/04结构图/4. MS001-D 体位反馈模块/MS001-D STEP/MS001-D.01.002SL.1.1 MS001-D开关.step
9.80 x 15.7 x 11.9 mm
