santan444/MS001/03-设计开发输出阶段/04结构/04结构图/5. MS001-C 工具包选配包/图纸/step/MS001-C.08.008JS.1.1-工作套筒（长）.step

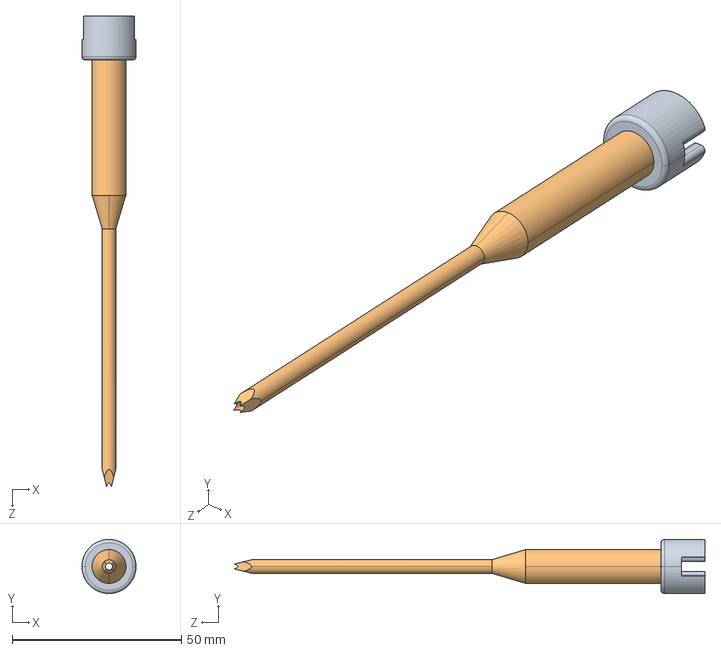
[picture p198: CAD file, 2024-10-22]
03-设计开发输出阶段/04结构/04结构图/5. MS001-C 工具包选配包/图纸/step/MS001-C.08.008JS.1.1-工作套筒（长）.step
16.0 x 16.0 x 139.2 mm
