santan444/MS001/03-设计开发输出阶段/04结构/04结构图/1. MS001-A 规划模块/2. MS001-A STEP零件3D模型/MS001-A.02.027SL.1.1MS001-A垫片.step

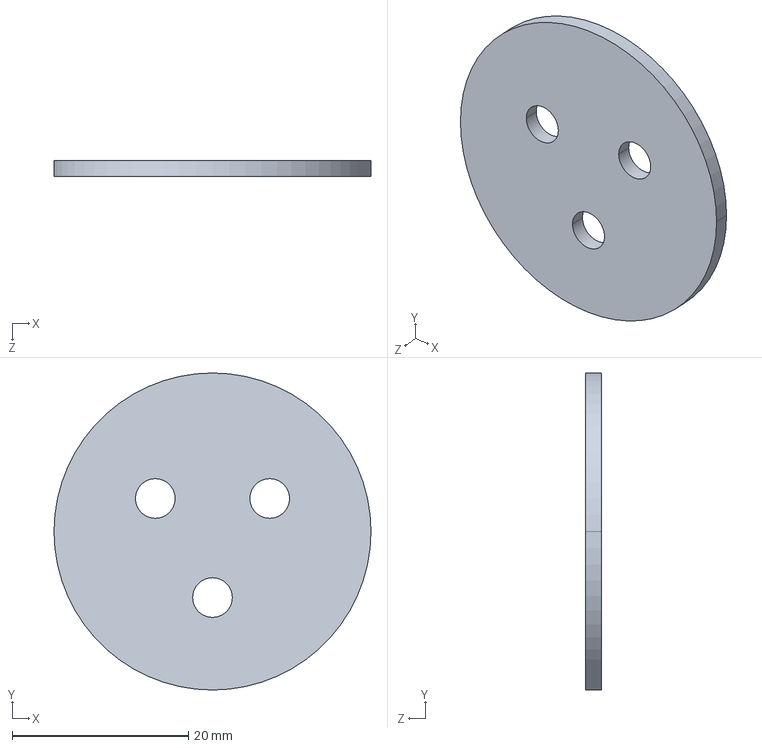
[picture p199: CAD file, 2024-10-22]
03-设计开发输出阶段/04结构/04结构图/1. MS001-A 规划模块/2. MS001-A STEP零件3D模型/MS001-A.02.027SL.1.1MS001-A垫片.step
36.0 x 36.0 x 1.80 mm
