santan444/MS001/03-设计开发输出阶段/04结构/04结构图/2. MS001-B 导引模块/2. MS001-B STEP零件3D模型/MS001-B.05.005SL.1.1 亚克力板.step

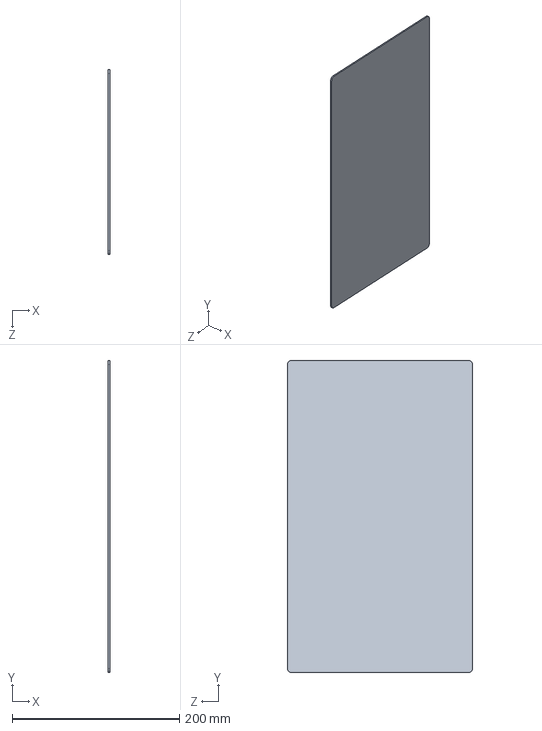
[picture p200: CAD file, 2024-10-22]
03-设计开发输出阶段/04结构/04结构图/2. MS001-B 导引模块/2. MS001-B STEP零件3D模型/MS001-B.05.005SL.1.1 亚克力板.step
2.00 x 373.0 x 221.5 mm
