santan444/MS001/03-设计开发输出阶段/04结构/04结构图/4. MS001-D 体位反馈模块/MS001-D STEP/MS001-D.01.005SL.1.1 MS001-D防掉落板.step

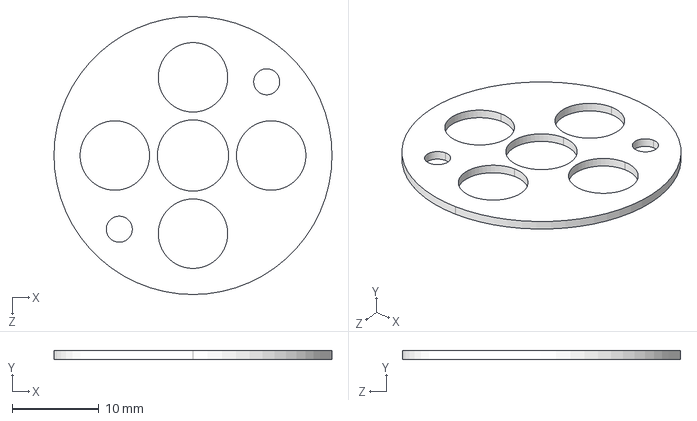
[picture p202: CAD file, 2024-10-22]
03-设计开发输出阶段/04结构/04结构图/4. MS001-D 体位反馈模块/MS001-D STEP/MS001-D.01.005SL.1.1 MS001-D防掉落板.step
32.0 x 1.00 x 32.0 mm
