santan444/MS001/03-设计开发输出阶段/04结构/04结构图/5. MS001-C 工具包选配包/图纸/step/工作套筒（短）.step

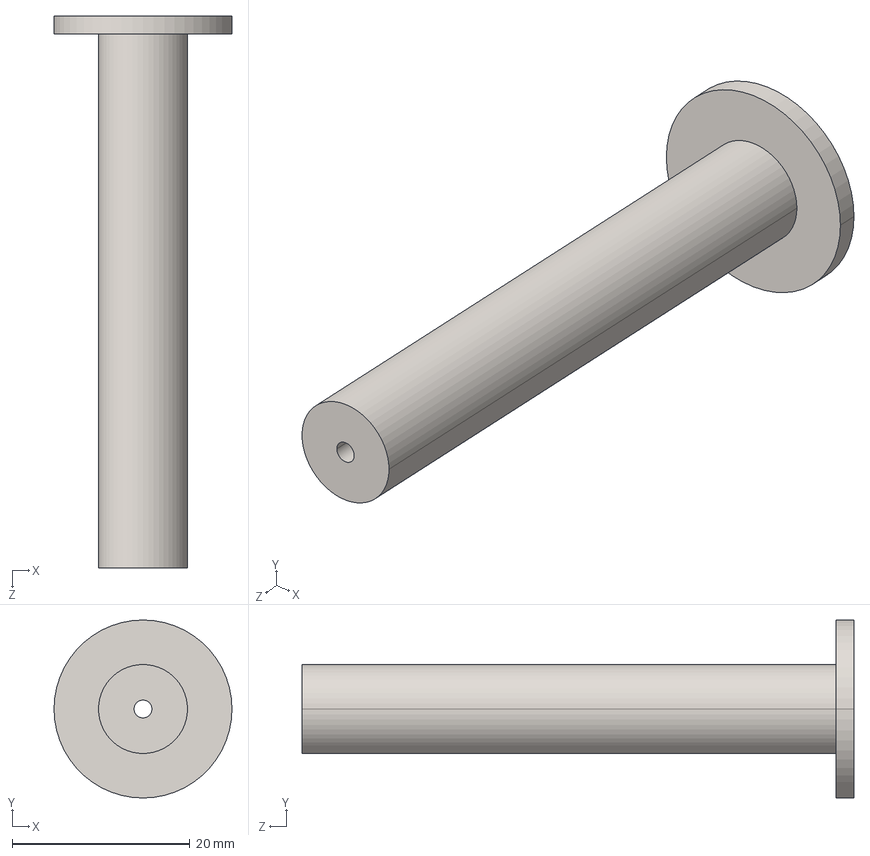
[picture p203: CAD file, 2024-10-22]
03-设计开发输出阶段/04结构/04结构图/5. MS001-C 工具包选配包/图纸/step/工作套筒（短）.step
20.0 x 20.0 x 62.0 mm
