santan444/MS001/03-设计开发输出阶段/04结构/04结构图/1. MS001-A 规划模块/2. MS001-A STEP零件3D模型/MS001-A.06.002MB.1.1包装木箱.step

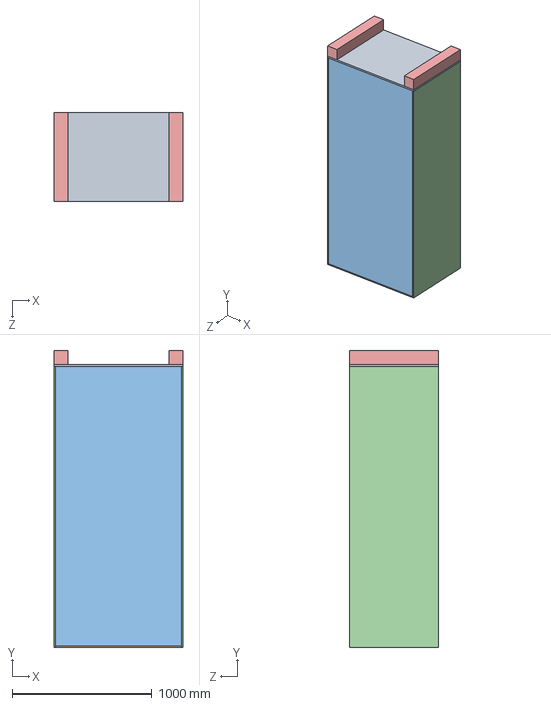
[picture p204: CAD file, 2024-10-22]
03-设计开发输出阶段/04结构/04结构图/1. MS001-A 规划模块/2. MS001-A STEP零件3D模型/MS001-A.06.002MB.1.1包装木箱.step
920.0 x 2125.0 x 639.0 mm
