santan444/MS001/03-设计开发输出阶段/04结构/04结构图/3. MS001-C 工具包/2. MS001-C STEP零件3D模型/MS001-C.03.007JS.1.1 MS001-C压板.step

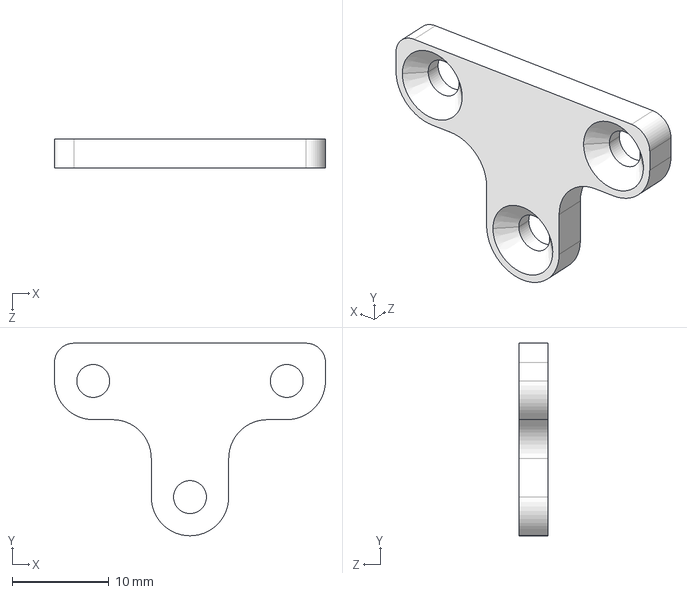
[picture p206: CAD file, 2024-10-22]
03-设计开发输出阶段/04结构/04结构图/3. MS001-C 工具包/2. MS001-C STEP零件3D模型/MS001-C.03.007JS.1.1 MS001-C压板.step
28.0 x 19.9 x 3.00 mm
