santan444/MS001/03-设计开发输出阶段/04结构/04结构图/4. MS001-D 体位反馈模块/MS001-D STEP/MS001-D.01.010ZB.1.1 体位反馈模块包装纸盒.step

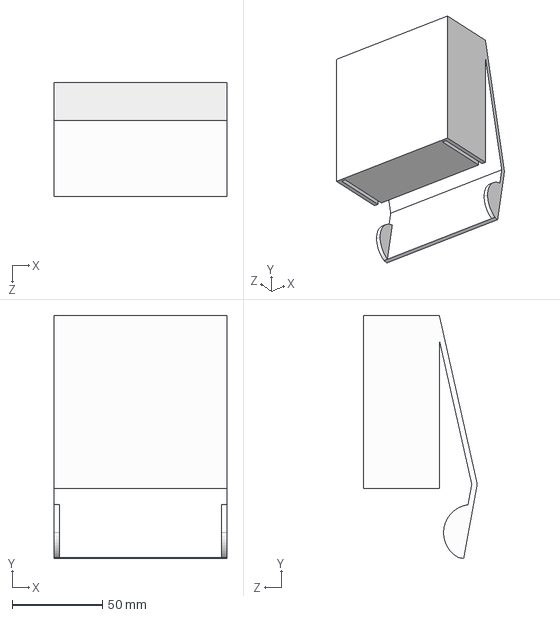
[picture p207: CAD file, 2024-10-22]
03-设计开发输出阶段/04结构/04结构图/4. MS001-D 体位反馈模块/MS001-D STEP/MS001-D.01.010ZB.1.1 体位反馈模块包装纸盒.step
96.0 x 135.0 x 63.1 mm
