santan444/MS001/03-设计开发输出阶段/04结构/04结构图/5. MS001-C 工具包选配包/图纸/step/MS001-C.09.002ZB.1.1 MS001-C工具包纸箱.step

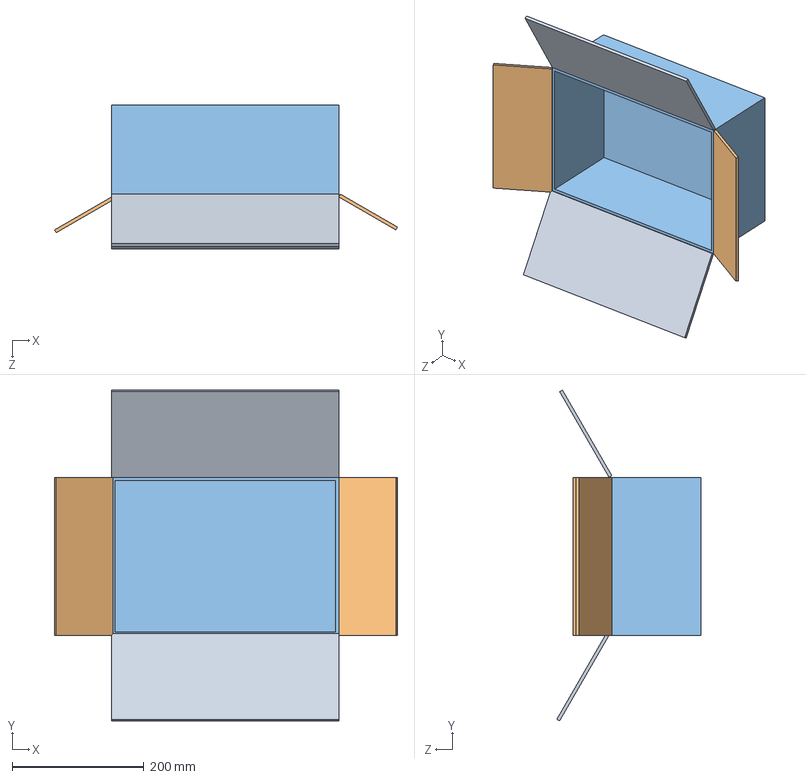
[picture p208: CAD file, 2024-10-22]
03-设计开发输出阶段/04结构/04结构图/5. MS001-C 工具包选配包/图纸/step/MS001-C.09.002ZB.1.1 MS001-C工具包纸箱.step
520.7 x 502.3 x 219.3 mm
