santan444/MS001/03-设计开发输出阶段/04结构/04结构图/1. MS001-A 规划模块/2. MS001-A STEP零件3D模型/MS001-A.05.009JS.1.1抽屉右支撑板.step

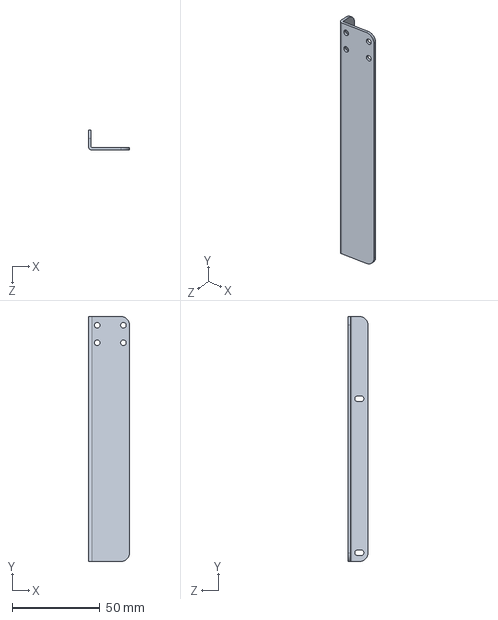
[picture p209: CAD file, 2024-10-22]
03-设计开发输出阶段/04结构/04结构图/1. MS001-A 规划模块/2. MS001-A STEP零件3D模型/MS001-A.05.009JS.1.1抽屉右支撑板.step
23.5 x 140.0 x 11.5 mm
