santan444/MS001/03-设计开发输出阶段/04结构/04结构图/4. MS001-D 体位反馈模块/MS001-D STEP/MS001-D.01.007SL.1.1 MS001-D转动轴.step

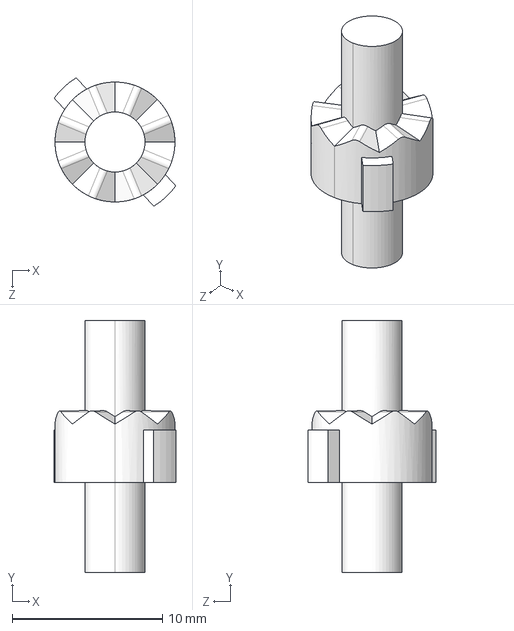
[picture p212: CAD file, 2024-10-22]
03-设计开发输出阶段/04结构/04结构图/4. MS001-D 体位反馈模块/MS001-D STEP/MS001-D.01.007SL.1.1 MS001-D转动轴.step
8.11 x 16.8 x 8.56 mm
