santan444/MS001/03-设计开发输出阶段/04结构/04结构图/1. MS001-A 规划模块/2. MS001-A STEP零件3D模型/MS001-A.05.006SL.1.1抽屉盒.step

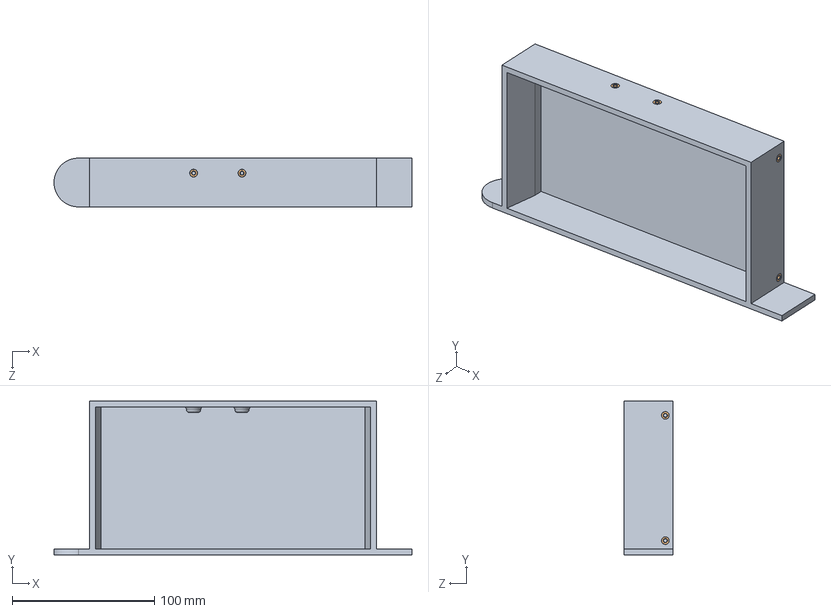
[picture p214: CAD file, 2024-10-22]
03-设计开发输出阶段/04结构/04结构图/1. MS001-A 规划模块/2. MS001-A STEP零件3D模型/MS001-A.05.006SL.1.1抽屉盒.step
251.7 x 108.0 x 34.3 mm
