santan444/MS001/03-设计开发输出阶段/04结构/04结构图/3. MS001-C 工具包/2. MS001-C STEP零件3D模型/MS001-C.01.003JS.1.1 MS001-C短套筒Φ3.0.step

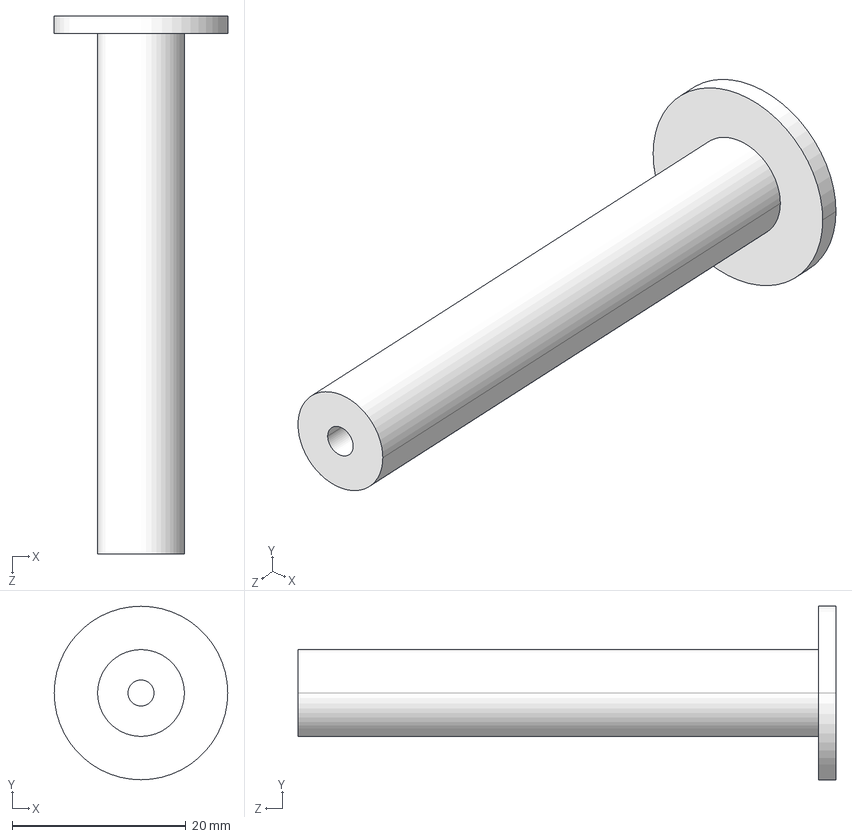
[picture p216: CAD file, 2024-10-22]
03-设计开发输出阶段/04结构/04结构图/3. MS001-C 工具包/2. MS001-C STEP零件3D模型/MS001-C.01.003JS.1.1 MS001-C短套筒Φ3.0.step
20.0 x 20.0 x 62.0 mm
