santan444/MS001/03-设计开发输出阶段/04结构/04结构图/4. MS001-D 体位反馈模块/MS001-D STEP/MS001-D.01.011SL.1.1体位反馈模块珍珠棉1.step

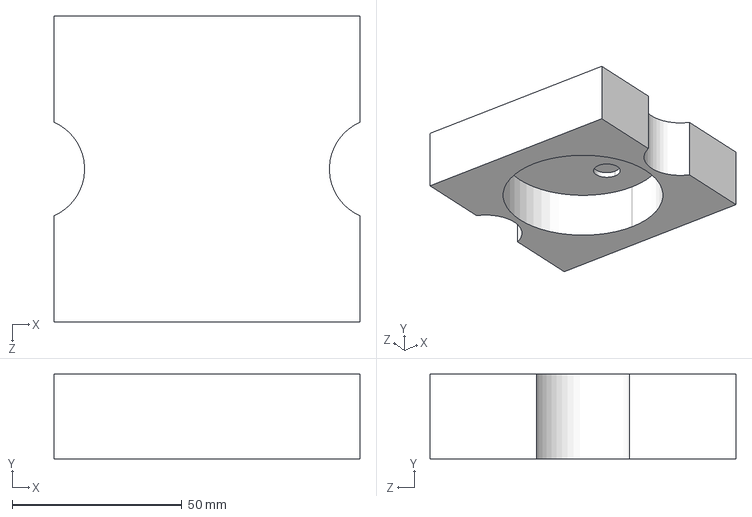
[picture p217: CAD file, 2024-10-22]
03-设计开发输出阶段/04结构/04结构图/4. MS001-D 体位反馈模块/MS001-D STEP/MS001-D.01.011SL.1.1体位反馈模块珍珠棉1.step
90.0 x 25.0 x 90.0 mm
