santan444/MS001/03-设计开发输出阶段/04结构/04结构图/5. MS001-C 工具包选配包/图纸/step/MS001-C.08.003JS.1.1-MS001-C底层固定钣金2.step

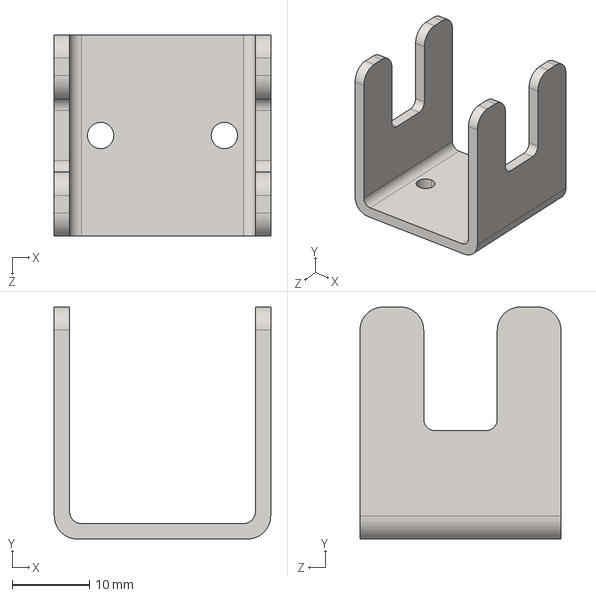
[picture p218: CAD file, 2024-10-22]
03-设计开发输出阶段/04结构/04结构图/5. MS001-C 工具包选配包/图纸/step/MS001-C.08.003JS.1.1-MS001-C底层固定钣金2.step
28.0 x 30.0 x 26.0 mm
