santan444/MS001/03-设计开发输出阶段/04结构/04结构图/1. MS001-A 规划模块/2. MS001-A STEP零件3D模型/MS001-A.03.014SL.1.1前侧透光板.step

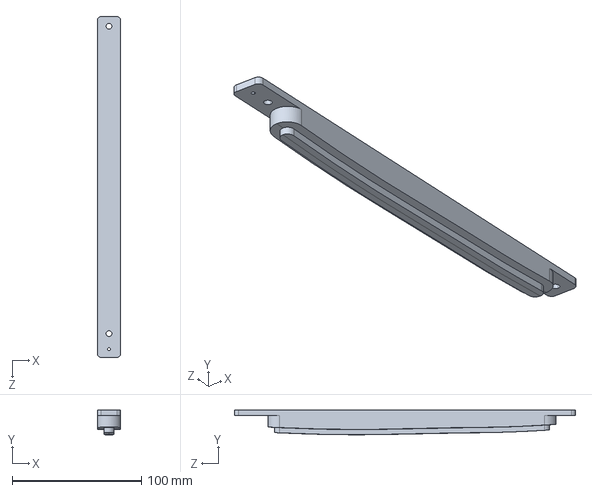
[picture p219: CAD file, 2024-10-22]
03-设计开发输出阶段/04结构/04结构图/1. MS001-A 规划模块/2. MS001-A STEP零件3D模型/MS001-A.03.014SL.1.1前侧透光板.step
18.0 x 19.0 x 264.0 mm
