santan444/MS001/03-设计开发输出阶段/04结构/04结构图/3. MS001-C 工具包/2. MS001-C STEP零件3D模型/MS001-C.07.011SL.1.1 MS001-C木箱珍珠棉7.step

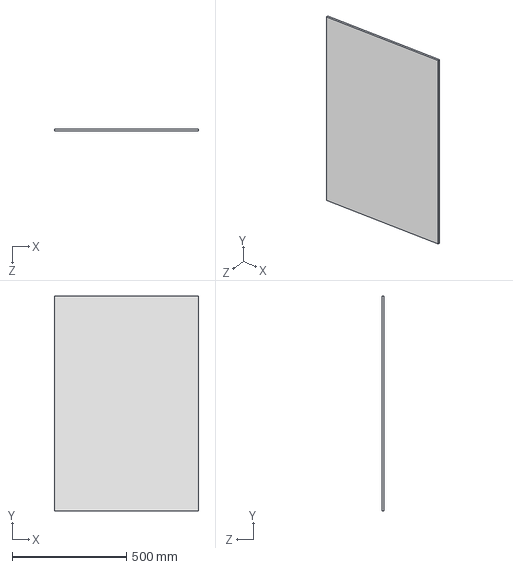
[picture p221: CAD file, 2024-10-22]
03-设计开发输出阶段/04结构/04结构图/3. MS001-C 工具包/2. MS001-C STEP零件3D模型/MS001-C.07.011SL.1.1 MS001-C木箱珍珠棉7.step
630.0 x 940.0 x 10.0 mm
