santan444/MS001/03-设计开发输出阶段/04结构/04结构图/4. MS001-D 体位反馈模块/MS001-D STEP/MS001-D.01.006SL.1.1 MS001-D转轮.step

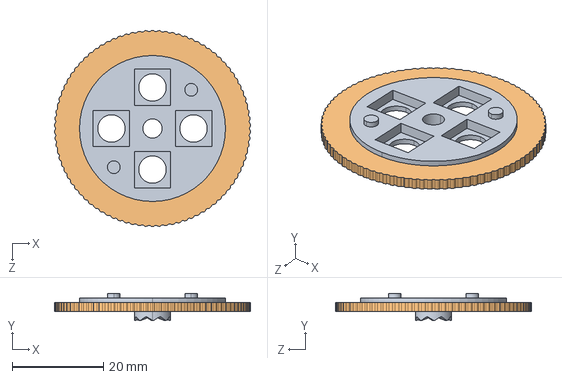
[picture p222: CAD file, 2024-10-22]
03-设计开发输出阶段/04结构/04结构图/4. MS001-D 体位反馈模块/MS001-D STEP/MS001-D.01.006SL.1.1 MS001-D转轮.step
43.0 x 6.00 x 43.0 mm
