santan444/MS001/03-设计开发输出阶段/04结构/04结构图/5. MS001-C 工具包选配包/图纸/step/MS001-C.05.003SL.1.1 MS001-C工具包珍珠棉.step

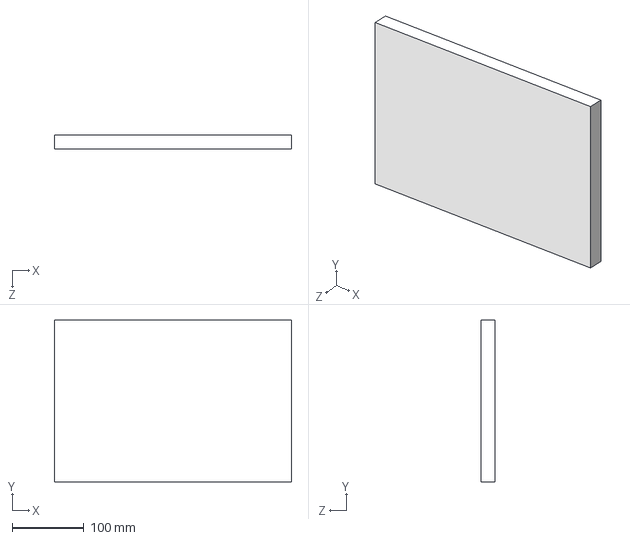
[picture p223: CAD file, 2024-10-22]
03-设计开发输出阶段/04结构/04结构图/5. MS001-C 工具包选配包/图纸/step/MS001-C.05.003SL.1.1 MS001-C工具包珍珠棉.step
330.0 x 225.0 x 20.0 mm
