santan444/MS001/03-设计开发输出阶段/04结构/04结构图/1. MS001-A 规划模块/2. MS001-A STEP零件3D模型/MS001-A.02.007SL.1.1MS001-A锁紧座1.step

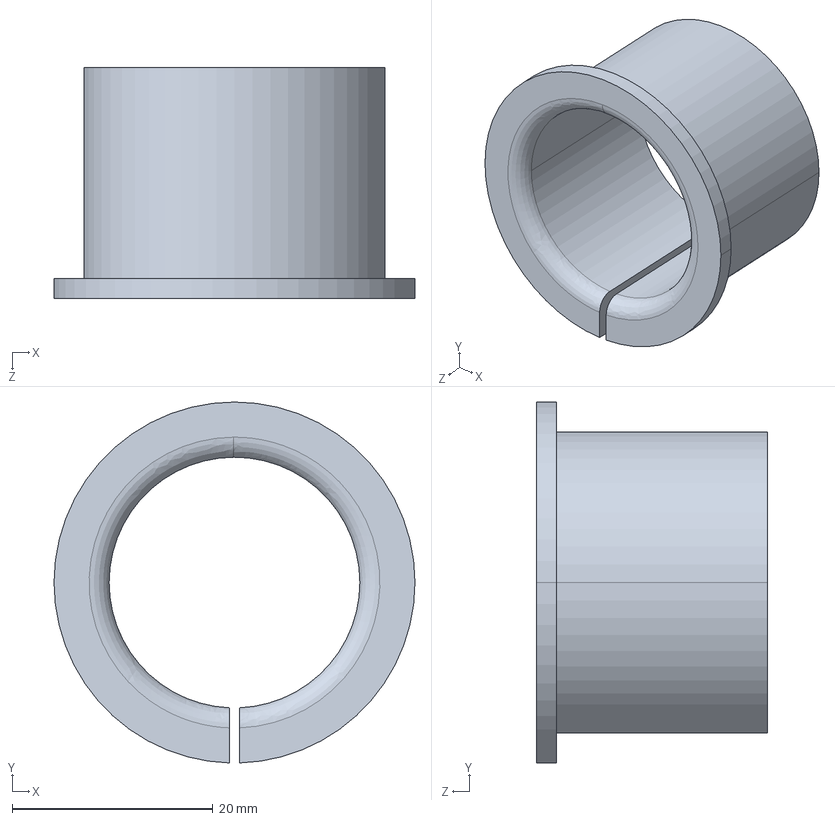
[picture p224: CAD file, 2024-10-22]
03-设计开发输出阶段/04结构/04结构图/1. MS001-A 规划模块/2. MS001-A STEP零件3D模型/MS001-A.02.007SL.1.1MS001-A锁紧座1.step
36.0 x 36.0 x 23.0 mm
