santan444/MS001/03-设计开发输出阶段/04结构/04结构图/2. MS001-B 导引模块/2. MS001-B STEP零件3D模型/MS001-B.03.020JS.1.1 电路板安装钣金.step

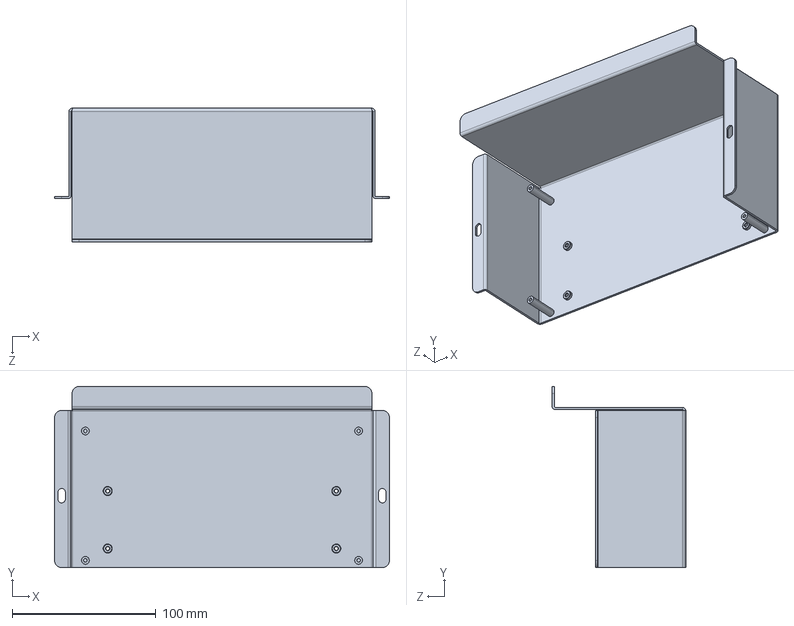
[picture p225: CAD file, 2024-10-22]
03-设计开发输出阶段/04结构/04结构图/2. MS001-B 导引模块/2. MS001-B STEP零件3D模型/MS001-B.03.020JS.1.1 电路板安装钣金.step
233.0 x 126.0 x 93.0 mm
