santan444/MS001/03-设计开发输出阶段/04结构/04结构图/3. MS001-C 工具包/2. MS001-C STEP零件3D模型/MS001-C.07.008SL.1.1 MS001-C木箱珍珠棉4.step

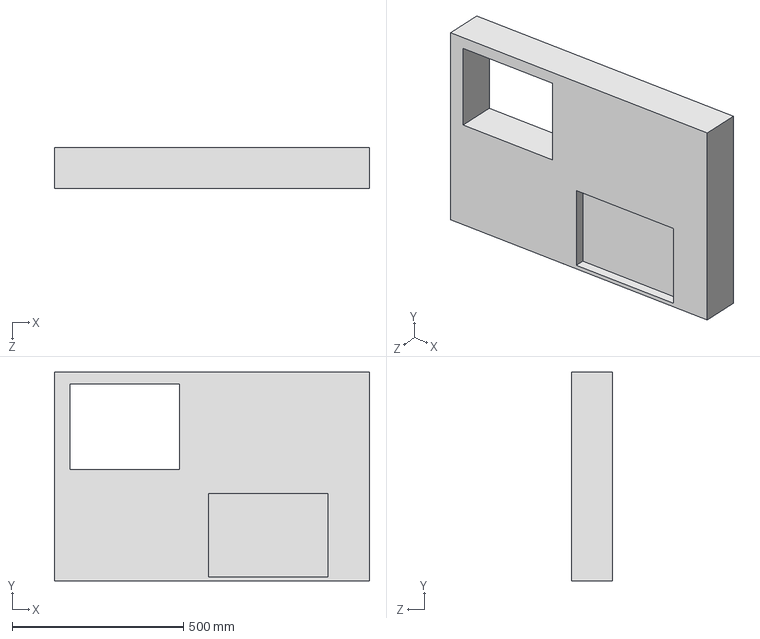
[picture p226: CAD file, 2024-10-22]
03-设计开发输出阶段/04结构/04结构图/3. MS001-C 工具包/2. MS001-C STEP零件3D模型/MS001-C.07.008SL.1.1 MS001-C木箱珍珠棉4.step
920.0 x 610.0 x 120.0 mm
