santan444/MS001/03-设计开发输出阶段/04结构/04结构图/4. MS001-D 体位反馈模块/MS001-D STEP/MS001-D.01.009BK.1.1 MS001-D衍射片.step

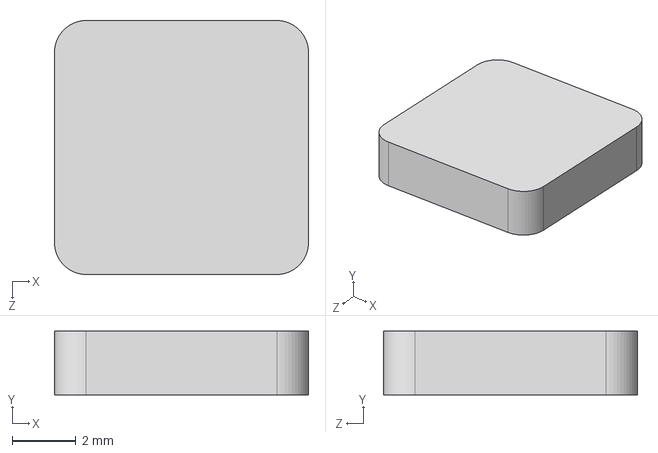
[picture p227: CAD file, 2024-10-22]
03-设计开发输出阶段/04结构/04结构图/4. MS001-D 体位反馈模块/MS001-D STEP/MS001-D.01.009BK.1.1 MS001-D衍射片.step
8.00 x 2.00 x 8.00 mm
