santan444/MS001/03-设计开发输出阶段/04结构/04结构图/1. MS001-A 规划模块/2. MS001-A STEP零件3D模型/MS001-A.02.024JS.1.1MS001-A止转板.step

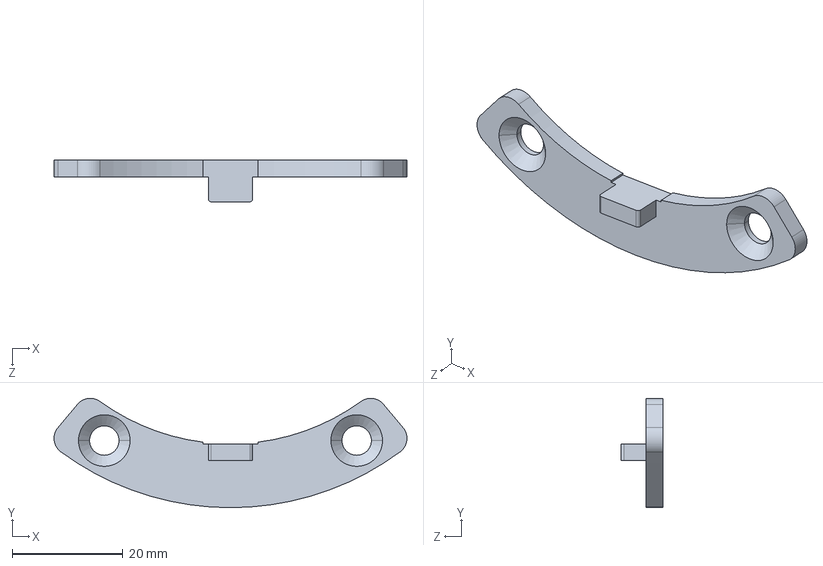
[picture p229: CAD file, 2024-10-22]
03-设计开发输出阶段/04结构/04结构图/1. MS001-A 规划模块/2. MS001-A STEP零件3D模型/MS001-A.02.024JS.1.1MS001-A止转板.step
63.6 x 19.7 x 7.50 mm
