santan444/MS001/03-设计开发输出阶段/04结构/04结构图/3. MS001-C 工具包/2. MS001-C STEP零件3D模型/MS001-C.07.012SL.1.1 MS001-B显示器珍珠棉.step

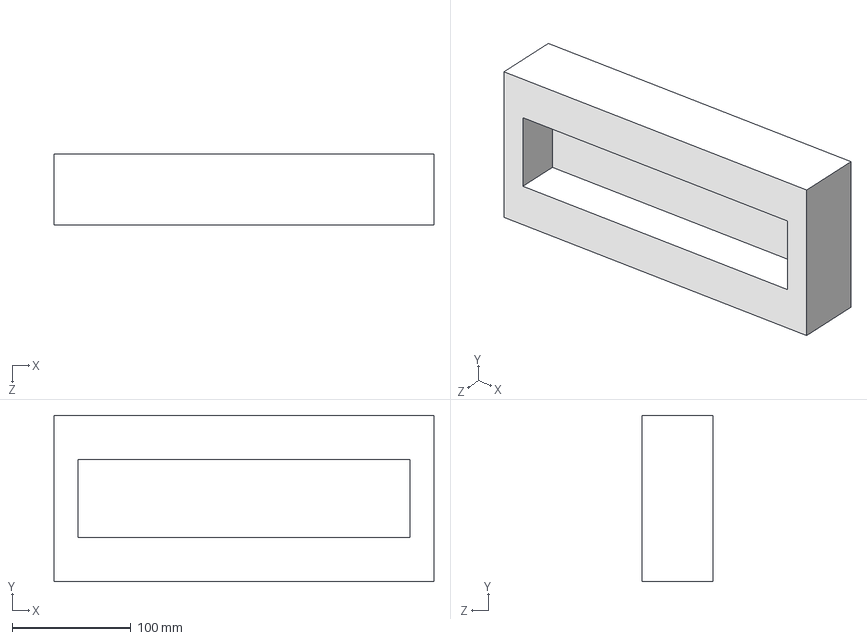
[picture p230: CAD file, 2024-10-22]
03-设计开发输出阶段/04结构/04结构图/3. MS001-C 工具包/2. MS001-C STEP零件3D模型/MS001-C.07.012SL.1.1 MS001-B显示器珍珠棉.step
320.0 x 140.0 x 60.0 mm
