santan444/MS001/03-设计开发输出阶段/04结构/04结构图/5. MS001-C 工具包选配包/图纸/step/MS001-C.08.00JS.1.1-MS001-C长套筒固定钣金2.step

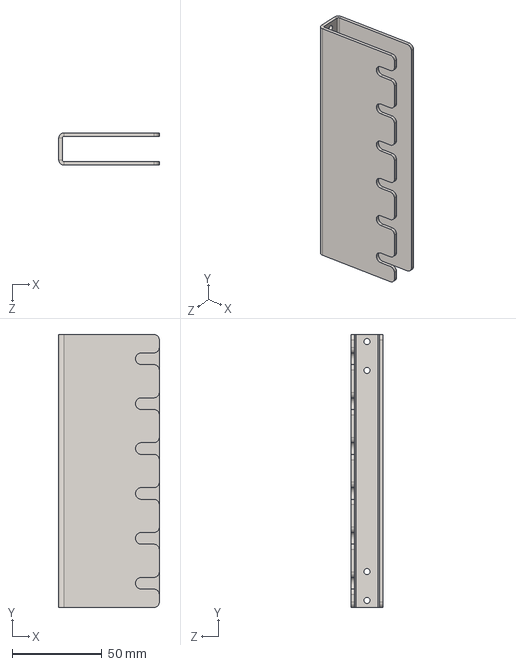
[picture p231: CAD file, 2024-10-22]
03-设计开发输出阶段/04结构/04结构图/5. MS001-C 工具包选配包/图纸/step/MS001-C.08.00JS.1.1-MS001-C长套筒固定钣金2.step
56.0 x 152.0 x 18.0 mm
