santan444/MS001/03-设计开发输出阶段/04结构/04结构图/2. MS001-B 导引模块/2. MS001-B STEP零件3D模型/MS001-B.07.003MB.1.1 台车托盘.step

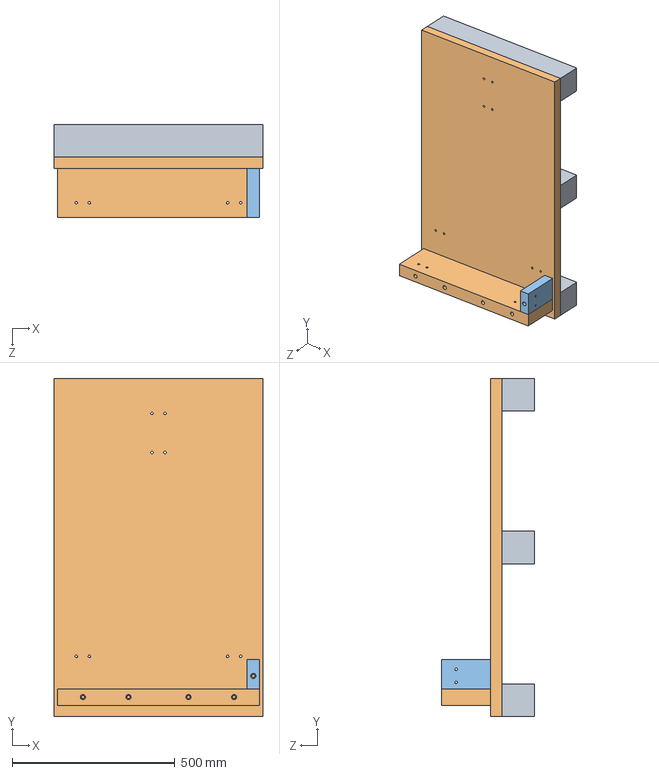
[picture p232: CAD file, 2024-10-22]
03-设计开发输出阶段/04结构/04结构图/2. MS001-B 导引模块/2. MS001-B STEP零件3D模型/MS001-B.07.003MB.1.1 台车托盘.step
640.0 x 1037.0 x 285.0 mm
