santan444/MS001/03-设计开发输出阶段/04结构/04结构图/3. MS001-C 工具包/2. MS001-C STEP零件3D模型/MS001-C.07.010SL.1.1 MS001-C木箱珍珠棉6.step

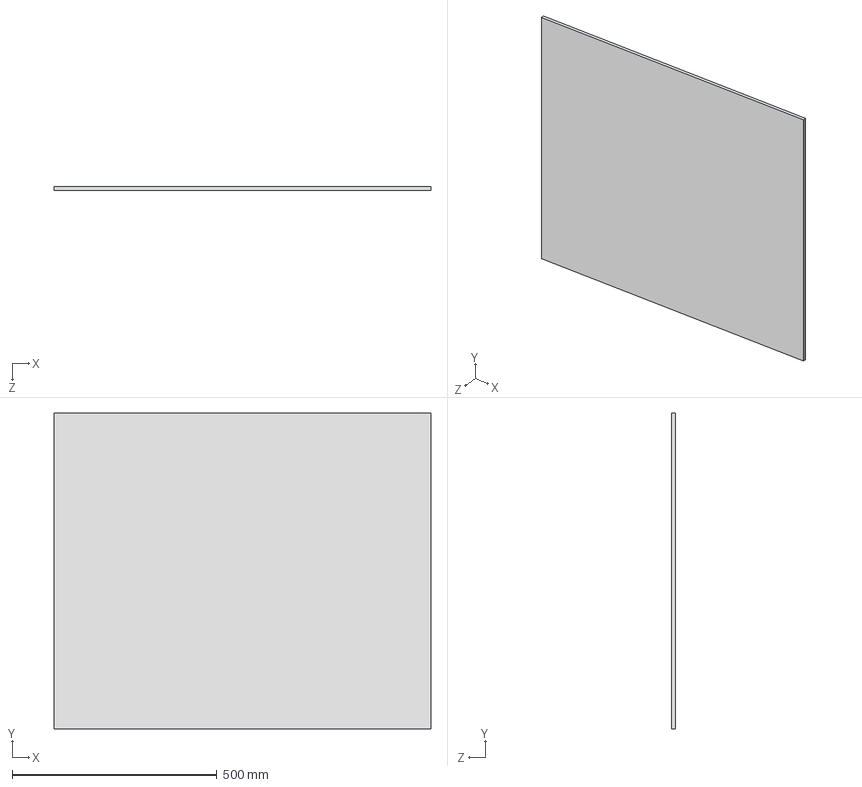
[picture p233: CAD file, 2024-10-22]
03-设计开发输出阶段/04结构/04结构图/3. MS001-C 工具包/2. MS001-C STEP零件3D模型/MS001-C.07.010SL.1.1 MS001-C木箱珍珠棉6.step
920.0 x 770.0 x 10.0 mm
