santan444/MS001/03-设计开发输出阶段/04结构/04结构图/1. MS001-A 规划模块/2. MS001-A STEP零件3D模型/MS001-A.02.011SL.1.1MS001-A右侧灯条支架.step

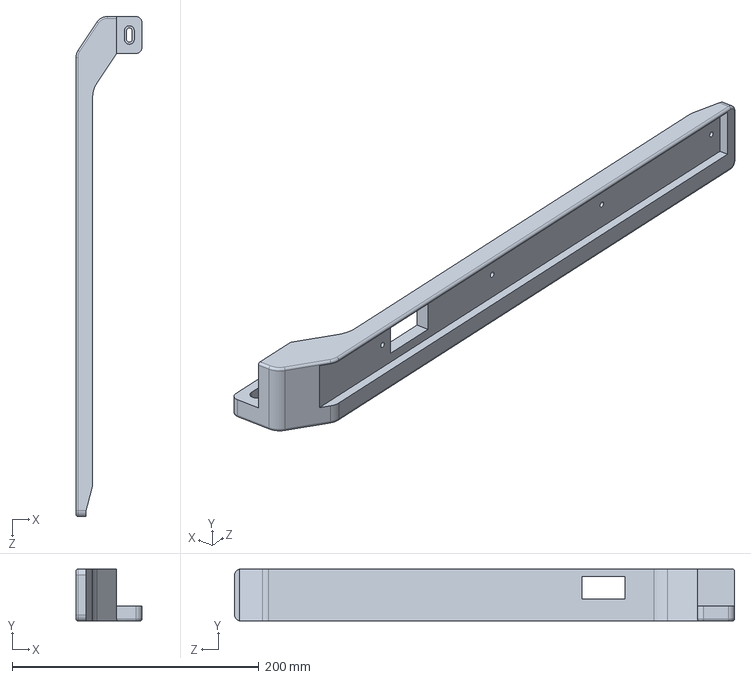
[picture p234: CAD file, 2024-10-22]
03-设计开发输出阶段/04结构/04结构图/1. MS001-A 规划模块/2. MS001-A STEP零件3D模型/MS001-A.02.011SL.1.1MS001-A右侧灯条支架.step
53.5 x 42.0 x 405.0 mm
