santan444/MS001/03-设计开发输出阶段/04结构/04结构图/2. MS001-B 导引模块/2. MS001-B STEP零件3D模型/MS001-B.05.013JS.1.1 工作台支撑板.step

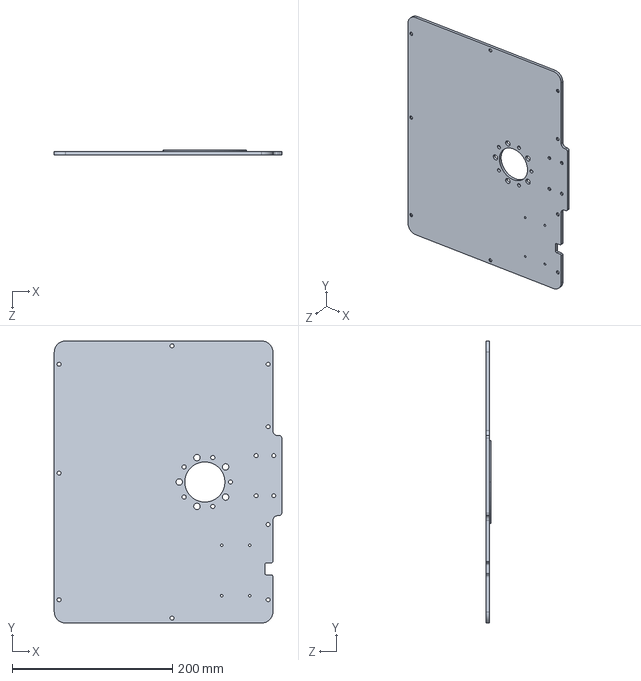
[picture p235: CAD file, 2024-10-22]
03-设计开发输出阶段/04结构/04结构图/2. MS001-B 导引模块/2. MS001-B STEP零件3D模型/MS001-B.05.013JS.1.1 工作台支撑板.step
284.0 x 352.0 x 6.00 mm
