santan444/MS001/03-设计开发输出阶段/04结构/04结构图/3. MS001-C 工具包/2. MS001-C STEP零件3D模型/MS001-C.03.003SL.1.1 MS001-C支撑板2.step

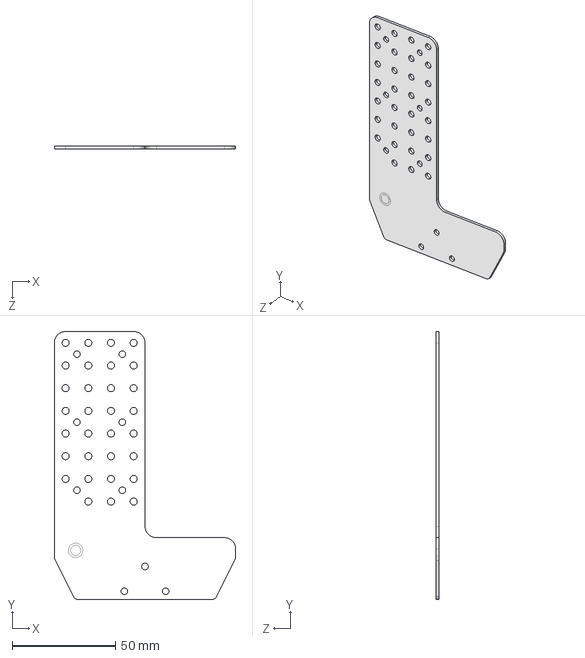
[picture p236: CAD file, 2024-10-22]
03-设计开发输出阶段/04结构/04结构图/3. MS001-C 工具包/2. MS001-C STEP零件3D模型/MS001-C.03.003SL.1.1 MS001-C支撑板2.step
88.0 x 130.0 x 1.50 mm
