santan444/MS001/03-设计开发输出阶段/04结构/04结构图/1. MS001-A 规划模块/2. MS001-A STEP零件3D模型/MS001-A.06.008SL.1.1珍珠棉6.step

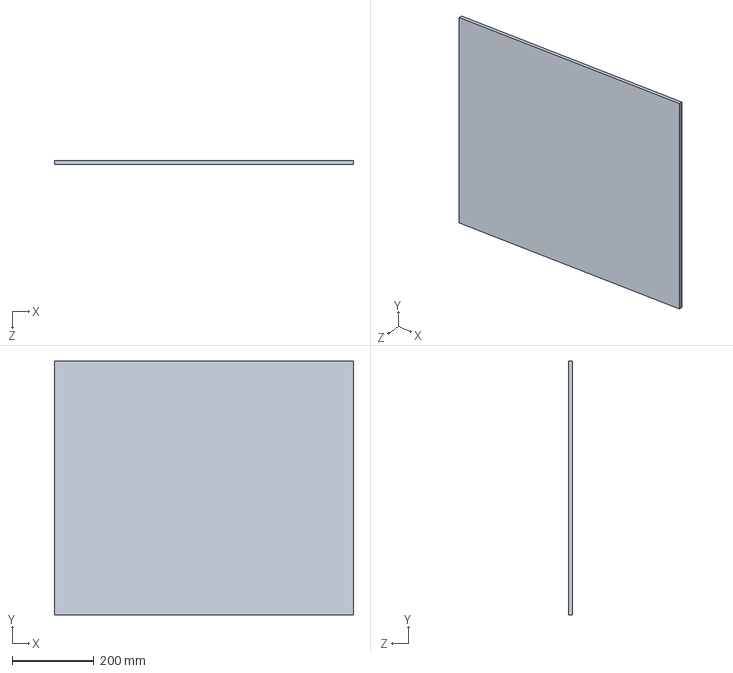
[picture p237: CAD file, 2024-10-22]
03-设计开发输出阶段/04结构/04结构图/1. MS001-A 规划模块/2. MS001-A STEP零件3D模型/MS001-A.06.008SL.1.1珍珠棉6.step
730.0 x 619.0 x 10.0 mm
