santan444/MS001/03-设计开发输出阶段/04结构/04结构图/1. MS001-A 规划模块/2. MS001-A STEP零件3D模型/MS001-A.03.011SL.1.1显示器支架装饰罩.step

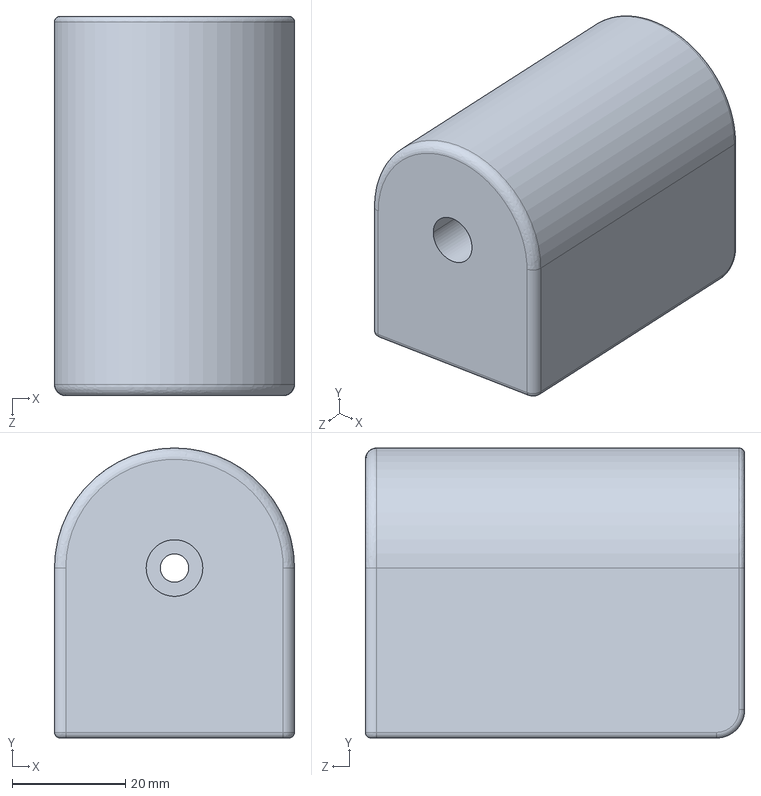
[picture p240: CAD file, 2024-10-22]
03-设计开发输出阶段/04结构/04结构图/1. MS001-A 规划模块/2. MS001-A STEP零件3D模型/MS001-A.03.011SL.1.1显示器支架装饰罩.step
42.4 x 51.2 x 67.0 mm
