santan444/MS001/03-设计开发输出阶段/04结构/04结构图/2. MS001-B 导引模块/2. MS001-B STEP零件3D模型/MS001-B.05.011SL.1.1 鼠标放置壳.step

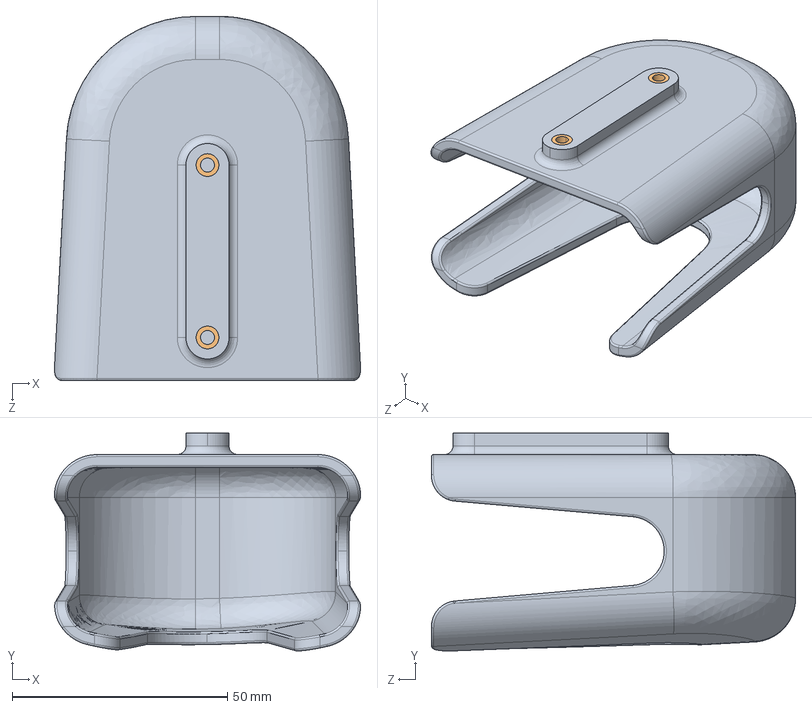
[picture p241: CAD file, 2024-10-22]
03-设计开发输出阶段/04结构/04结构图/2. MS001-B 导引模块/2. MS001-B STEP零件3D模型/MS001-B.05.011SL.1.1 鼠标放置壳.step
71.0 x 50.6 x 84.5 mm
鼠标放置壳
И杶-M4X5X4 x 2
