santan444/MS001/03-设计开发输出阶段/04结构/04结构图/1. MS001-A 规划模块/2. MS001-A STEP零件3D模型/MS001-A.02.009JS.1.1MS001-A工作台支撑板.step

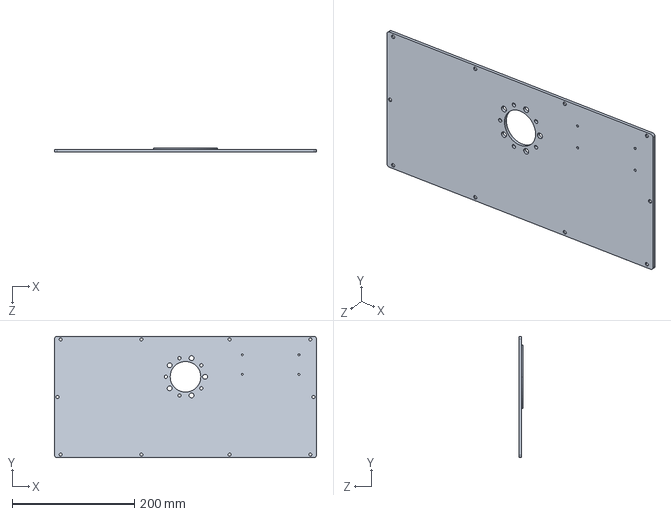
[picture p243: CAD file, 2024-10-22]
03-设计开发输出阶段/04结构/04结构图/1. MS001-A 规划模块/2. MS001-A STEP零件3D模型/MS001-A.02.009JS.1.1MS001-A工作台支撑板.step
428.0 x 198.0 x 6.00 mm
