santan444/MS001/03-设计开发输出阶段/04结构/04结构图/2. MS001-B 导引模块/2. MS001-B STEP零件3D模型/MS001-B.07.007SL.1.1 珍珠棉3.step

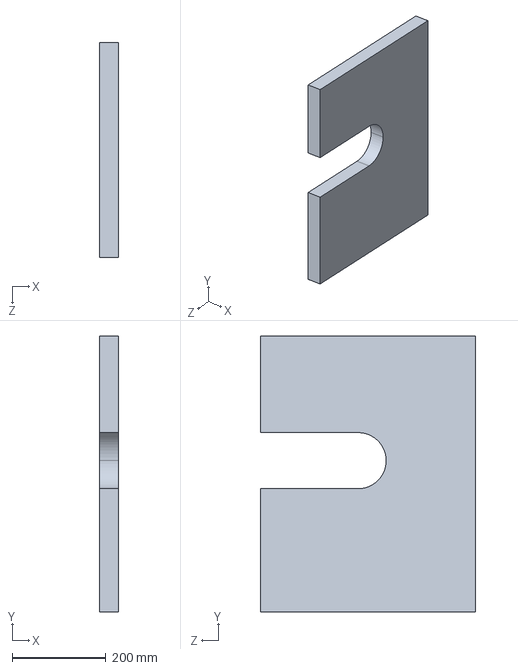
[picture p244: CAD file, 2024-10-22]
03-设计开发输出阶段/04结构/04结构图/2. MS001-B 导引模块/2. MS001-B STEP零件3D模型/MS001-B.07.007SL.1.1 珍珠棉3.step
40.0 x 590.0 x 460.0 mm
