santan444/MS001/03-设计开发输出阶段/04结构/04结构图/2. MS001-B 导引模块/2. MS001-B STEP零件3D模型/MS001-B.03.009JS.1.1 万向脚杯左支撑柱.step

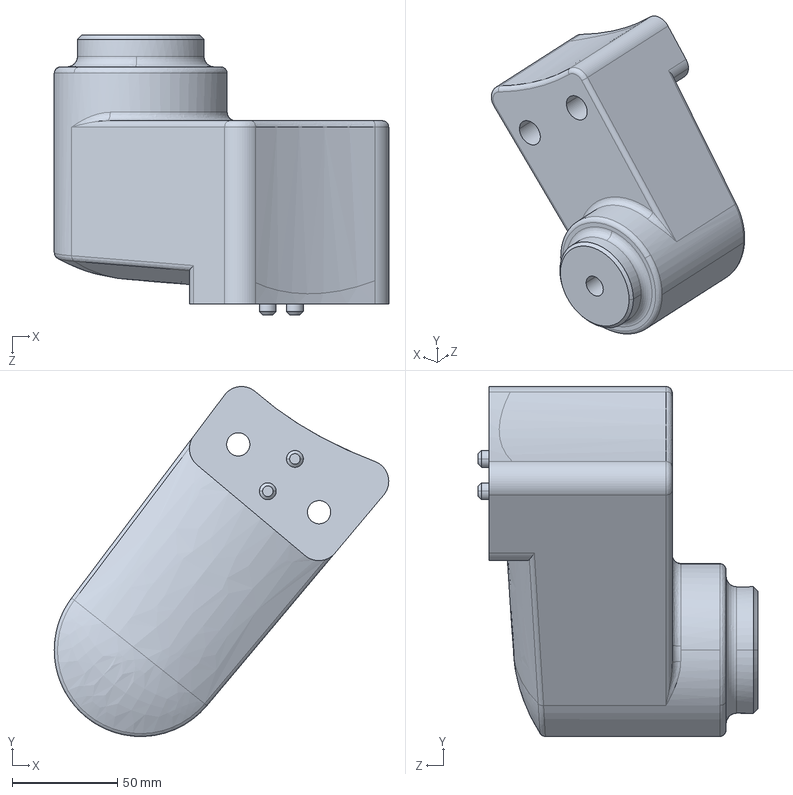
[picture p247: CAD file, 2024-10-22]
03-设计开发输出阶段/04结构/04结构图/2. MS001-B 导引模块/2. MS001-B STEP零件3D模型/MS001-B.03.009JS.1.1 万向脚杯左支撑柱.step
158.6 x 165.9 x 132.5 mm
