santan444/MS001/03-设计开发输出阶段/04结构/04结构图/1. MS001-A 规划模块/2. MS001-A STEP零件3D模型/MS001-A.02.025SL.1.1MS001-A灯条支架限位块.step

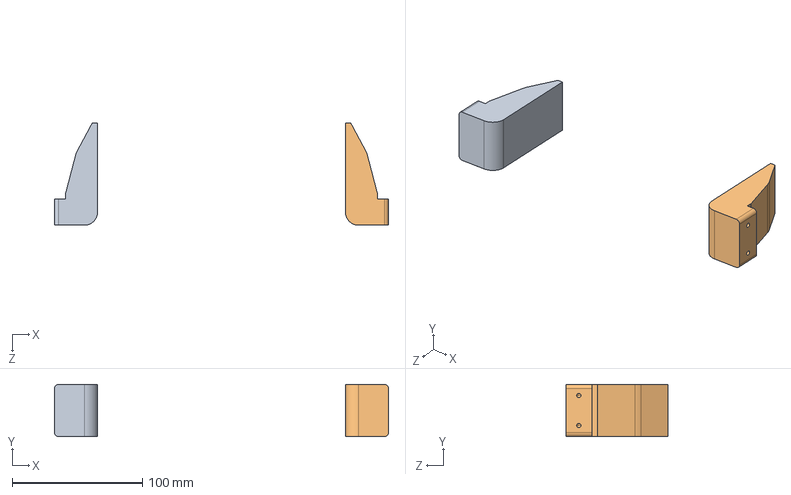
[picture p248: CAD file, 2024-10-22]
03-设计开发输出阶段/04结构/04结构图/1. MS001-A 规划模块/2. MS001-A STEP零件3D模型/MS001-A.02.025SL.1.1MS001-A灯条支架限位块.step
256.0 x 40.0 x 78.5 mm
