santan444/MS001/03-设计开发输出阶段/04结构/04结构图/2. MS001-B 导引模块/2. MS001-B STEP零件3D模型/MS001-B.05.014JS.1.1 左侧导轨安装钣金.step

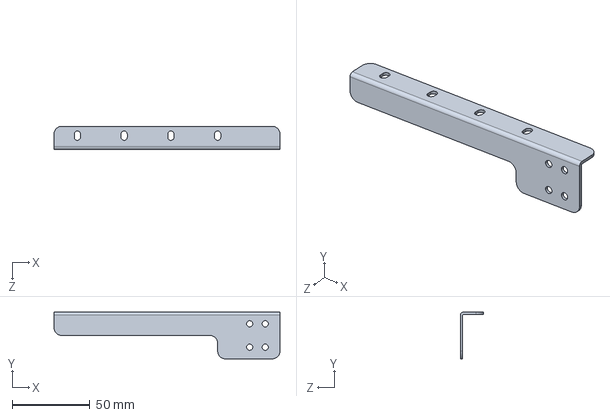
[picture p249: CAD file, 2024-10-22]
03-设计开发输出阶段/04结构/04结构图/2. MS001-B 导引模块/2. MS001-B STEP零件3D模型/MS001-B.05.014JS.1.1 左侧导轨安装钣金.step
145.0 x 30.0 x 15.0 mm
