santan444/MS001/03-设计开发输出阶段/04结构/04结构图/1. MS001-A 规划模块/2. MS001-A STEP零件3D模型/MS001-A.05.005JS.1.1光驱固定钣金.step

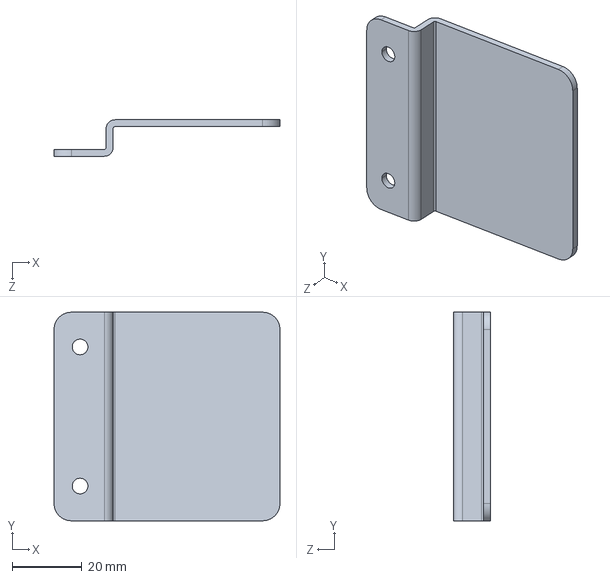
[picture p251: CAD file, 2024-10-22]
03-设计开发输出阶段/04结构/04结构图/1. MS001-A 规划模块/2. MS001-A STEP零件3D模型/MS001-A.05.005JS.1.1光驱固定钣金.step
65.0 x 60.0 x 10.5 mm
