santan444/MS001/03-设计开发输出阶段/04结构/04结构图/2. MS001-B 导引模块/2. MS001-B STEP零件3D模型/MS001-B.03.013JS.1.1 机械臂电源固定钣金.step

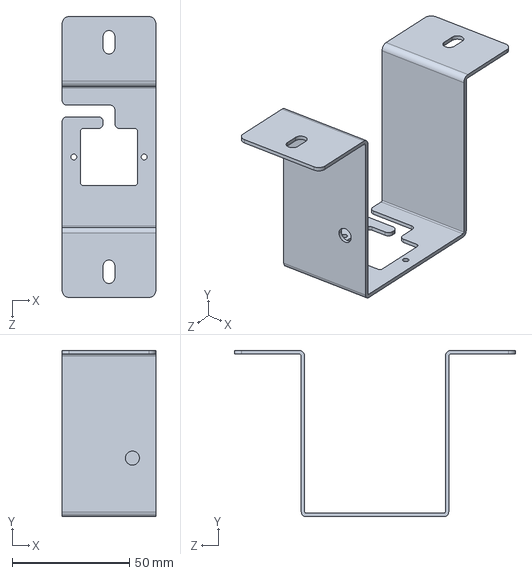
[picture p252: CAD file, 2024-10-22]
03-设计开发输出阶段/04结构/04结构图/2. MS001-B 导引模块/2. MS001-B STEP零件3D模型/MS001-B.03.013JS.1.1 机械臂电源固定钣金.step
40.0 x 71.0 x 120.0 mm
