santan444/MS001/03-设计开发输出阶段/04结构/04结构图/3. MS001-C 工具包/2. MS001-C STEP零件3D模型/MS001-C.07.002ZB.1.1 MS001-A显示器包装纸箱.step

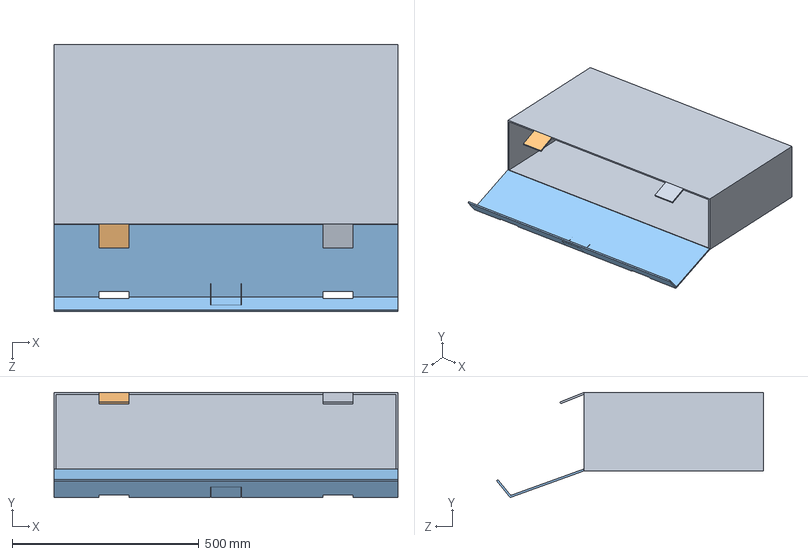
[picture p255: CAD file, 2024-10-22]
03-设计开发输出阶段/04结构/04结构图/3. MS001-C 工具包/2. MS001-C STEP零件3D模型/MS001-C.07.002ZB.1.1 MS001-A显示器包装纸箱.step
920.0 x 281.3 x 714.0 mm
