santan444/MS001/03-设计开发输出阶段/04结构/04结构图/2. MS001-B 导引模块/2. MS001-B STEP零件3D模型/MS001-B.03.010JS.1.1 MS001-BUPS固定钣金一.step

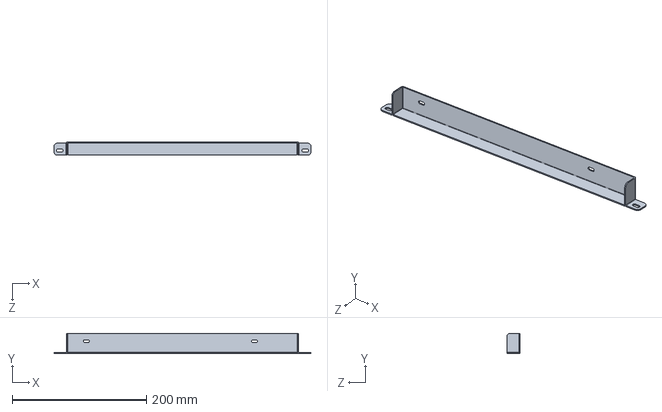
[picture p257: CAD file, 2024-10-22]
03-设计开发输出阶段/04结构/04结构图/2. MS001-B 导引模块/2. MS001-B STEP零件3D模型/MS001-B.03.010JS.1.1 MS001-BUPS固定钣金一.step
383.0 x 30.0 x 20.0 mm
