santan444/MS001/03-设计开发输出阶段/04结构/04结构图/1. MS001-A 规划模块/2. MS001-A STEP零件3D模型/MS001-A.02.012JS.1.1MS001-A台车把手固定支架.step

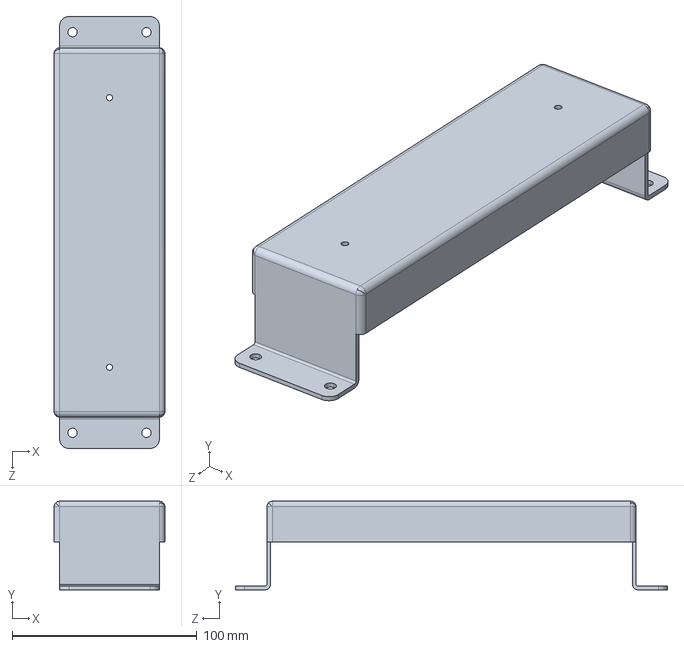
[picture p259: CAD file, 2024-10-22]
03-设计开发输出阶段/04结构/04结构图/1. MS001-A 规划模块/2. MS001-A STEP零件3D模型/MS001-A.02.012JS.1.1MS001-A台车把手固定支架.step
60.0 x 48.0 x 234.0 mm
