santan444/MS001/03-设计开发输出阶段/04结构/04结构图/2. MS001-B 导引模块/2. MS001-B STEP零件3D模型/MS001-B.05.004SL.1.1 显示器保护罩1.step

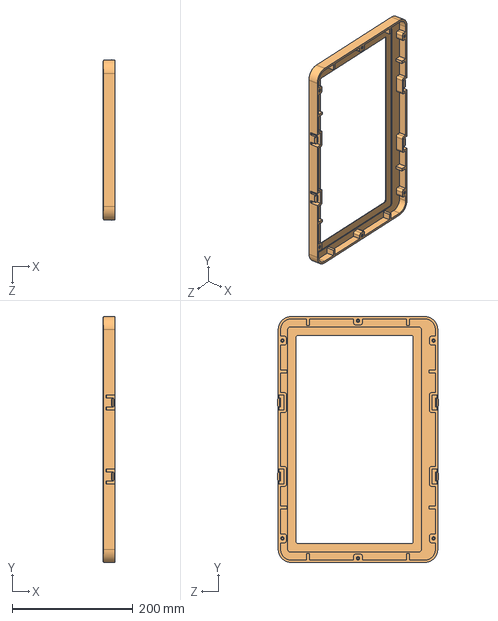
[picture p260: CAD file, 2024-10-22]
03-设计开发输出阶段/04结构/04结构图/2. MS001-B 导引模块/2. MS001-B STEP零件3D模型/MS001-B.05.004SL.1.1 显示器保护罩1.step
20.0 x 407.4 x 266.4 mm
И杶-M4X5X4 x 6
显示器保护罩1
