santan444/MS001/03-设计开发输出阶段/04结构/04结构图/2. MS001-B 导引模块/2. MS001-B STEP零件3D模型/MS001-B.04.014JX.1.1 推手.step

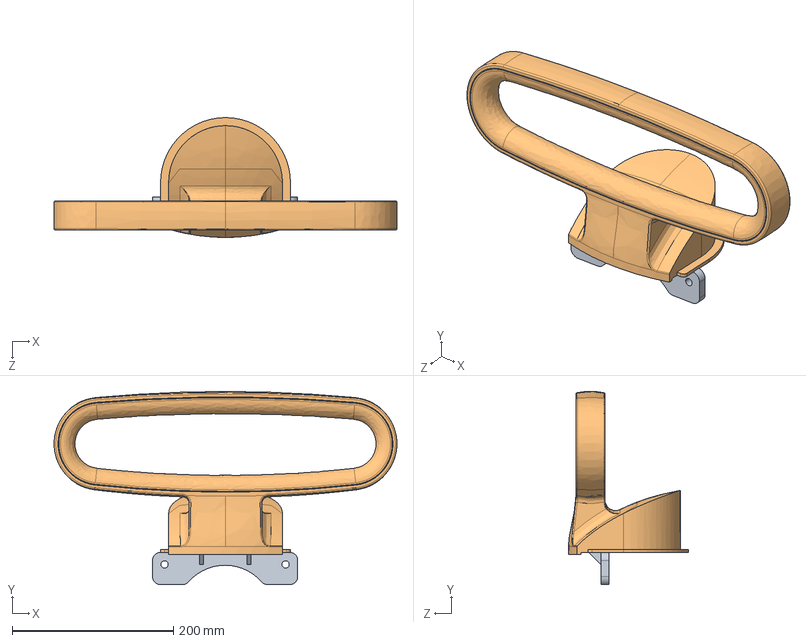
[picture p262: CAD file, 2024-10-22]
03-设计开发输出阶段/04结构/04结构图/2. MS001-B 导引模块/2. MS001-B STEP零件3D模型/MS001-B.04.014JX.1.1 推手.step
425.0 x 239.4 x 148.5 mm
MS001-B.04.014JS.1.1推手加强金属件
MS001-B.04.014SL.1.1推手外壳
