santan444/MS001/03-设计开发输出阶段/04结构/04结构图/1. MS001-A 规划模块/2. MS001-A STEP零件3D模型/MS001-A.02.023JS.1.1MS001-A框架上顶板.step

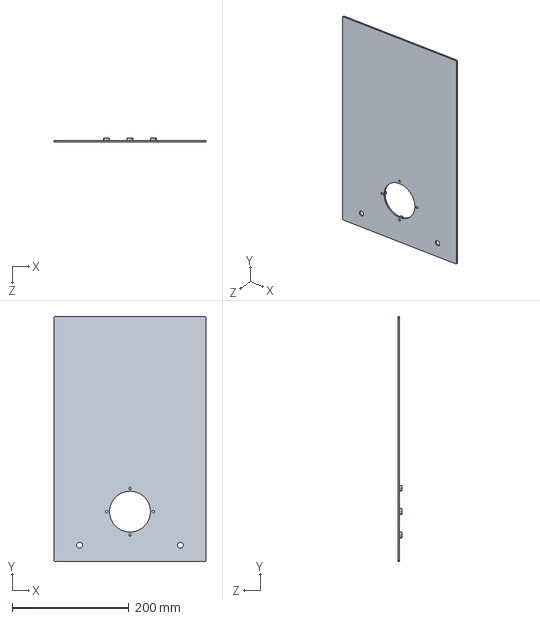
[picture p263: CAD file, 2024-10-22]
03-设计开发输出阶段/04结构/04结构图/1. MS001-A 规划模块/2. MS001-A STEP零件3D模型/MS001-A.02.023JS.1.1MS001-A框架上顶板.step
260.0 x 420.0 x 7.00 mm
