santan444/MS001/03-设计开发输出阶段/04结构/04结构图/2. MS001-B 导引模块/2. MS001-B STEP零件3D模型/MS001-B.03.024JS.1.1 分线盒安装钣金.step

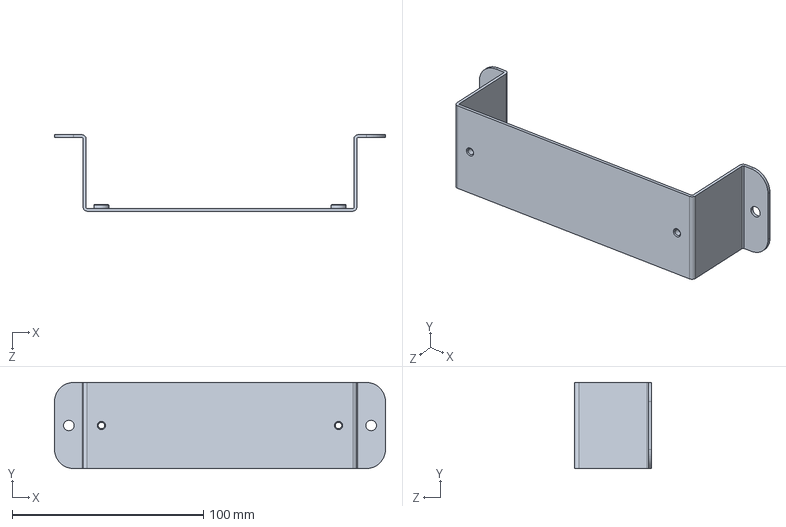
[picture p264: CAD file, 2024-10-22]
03-设计开发输出阶段/04结构/04结构图/2. MS001-B 导引模块/2. MS001-B STEP零件3D模型/MS001-B.03.024JS.1.1 分线盒安装钣金.step
173.0 x 45.0 x 40.0 mm
