santan444/MS001/03-设计开发输出阶段/04结构/04结构图/3. MS001-C 工具包/2. MS001-C STEP零件3D模型/MS001-C.07.013MB.1.1 MS001-C包装木箱.STEP

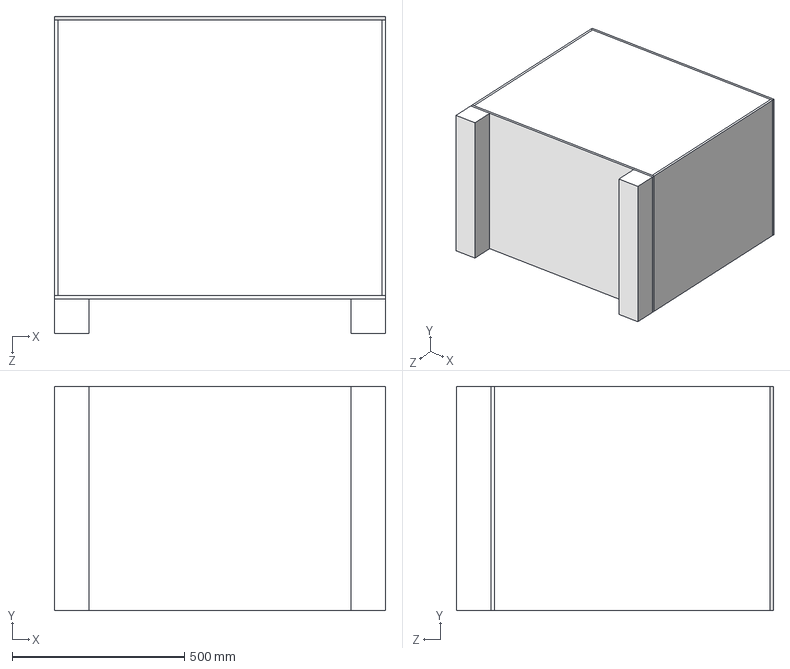
[picture p265: CAD file, 2024-10-22]
03-设计开发输出阶段/04结构/04结构图/3. MS001-C 工具包/2. MS001-C STEP零件3D模型/MS001-C.07.013MB.1.1 MS001-C包装木箱.STEP
960.0 x 650.0 x 920.0 mm
底托木箱
階啣
耜啣 x 2
淏啣 x 2
