santan444/MS001/03-设计开发输出阶段/04结构/04结构图/1. MS001-A 规划模块/2. MS001-A STEP零件3D模型/MS001-A.02.015JS.1.1MS001-A电器元件固定支架.step

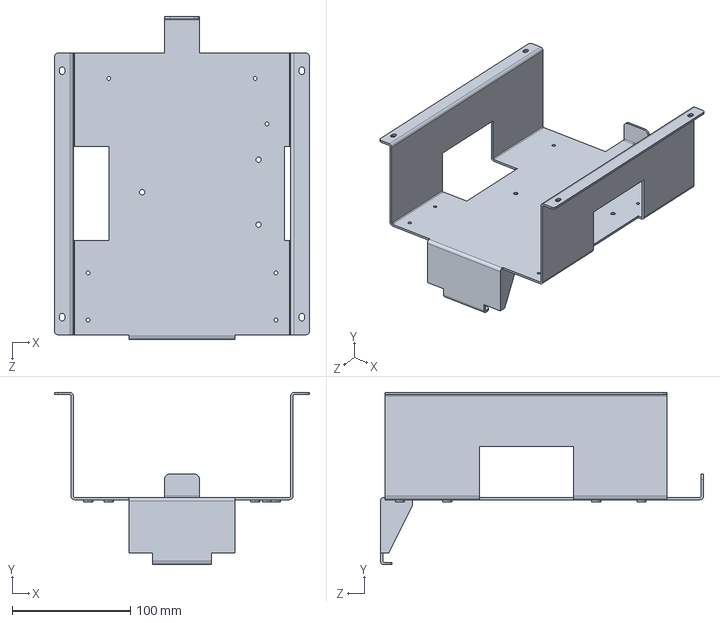
[picture p266: CAD file, 2024-10-22]
03-设计开发输出阶段/04结构/04结构图/1. MS001-A 规划模块/2. MS001-A STEP零件3D模型/MS001-A.02.015JS.1.1MS001-A电器元件固定支架.step
216.0 x 146.0 x 273.7 mm
