santan444/MS001/03-设计开发输出阶段/04结构/04结构图/2. MS001-B 导引模块/2. MS001-B STEP零件3D模型/MS001-B.03.006JS.1.1 主机电源适配器安装钣金.step

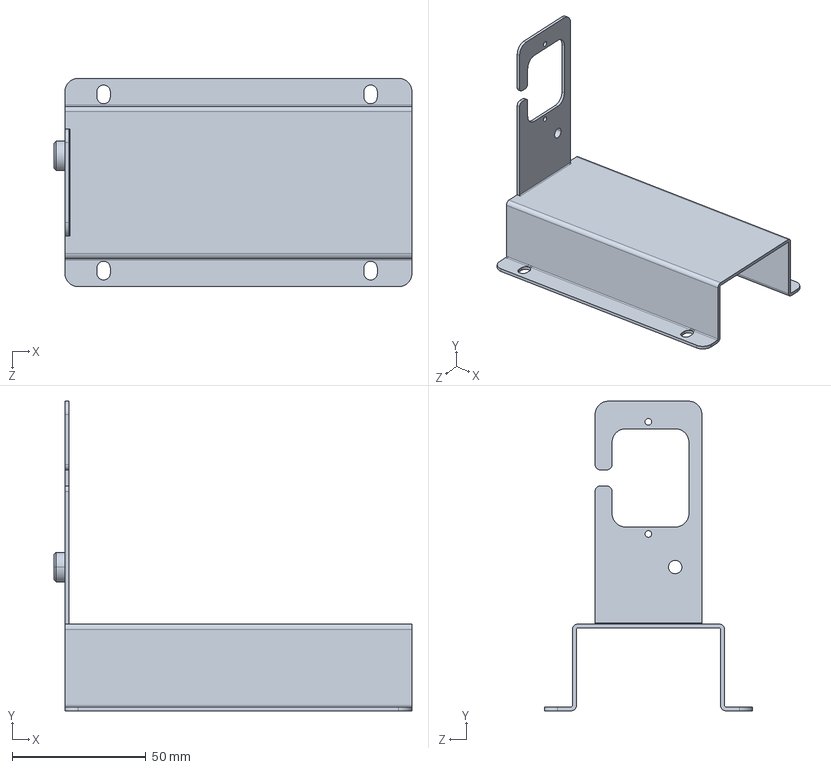
[picture p267: CAD file, 2024-10-22]
03-设计开发输出阶段/04结构/04结构图/2. MS001-B 导引模块/2. MS001-B STEP零件3D模型/MS001-B.03.006JS.1.1 主机电源适配器安装钣金.step
134.1 x 116.0 x 78.0 mm
