santan444/MS001/03-设计开发输出阶段/04结构/04结构图/3. MS001-C 工具包/2. MS001-C STEP零件3D模型/MS001-C.02.003JS.1.1 MS001-C转接法兰2.step

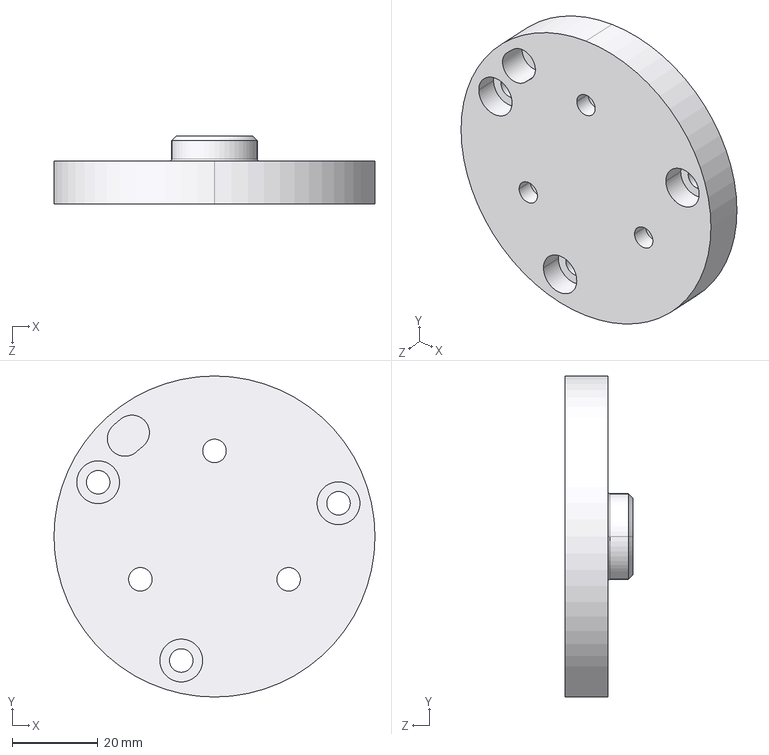
[picture p270: CAD file, 2024-10-22]
03-设计开发输出阶段/04结构/04结构图/3. MS001-C 工具包/2. MS001-C STEP零件3D模型/MS001-C.02.003JS.1.1 MS001-C转接法兰2.step
75.0 x 75.0 x 15.8 mm
