santan444/MS001/03-设计开发输出阶段/04结构/04结构图/1. MS001-A 规划模块/2. MS001-A STEP零件3D模型/MS001-A.03.009SL.1.1摄像头盖板.step

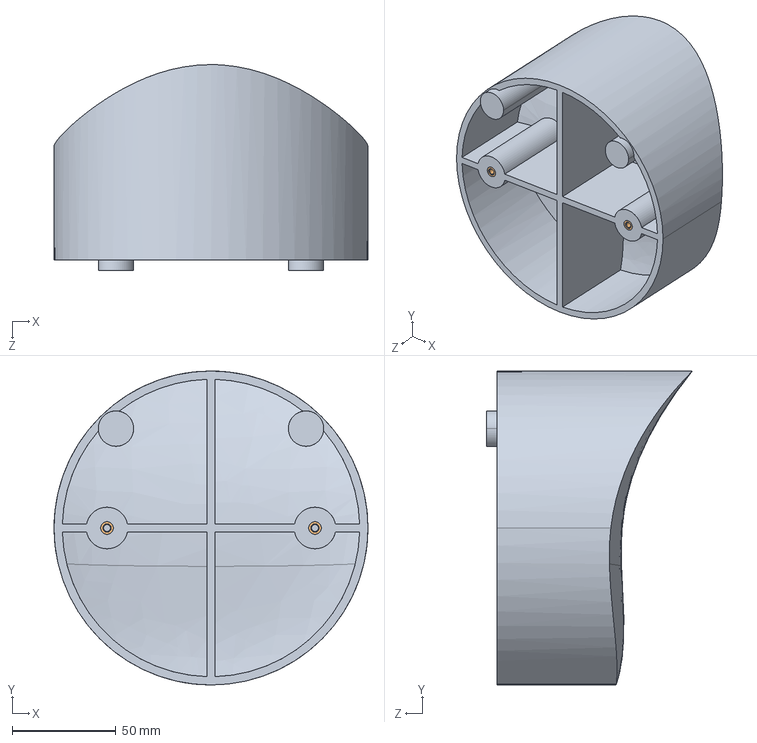
[picture p271: CAD file, 2024-10-22]
03-设计开发输出阶段/04结构/04结构图/1. MS001-A 规划模块/2. MS001-A STEP零件3D模型/MS001-A.03.009SL.1.1摄像头盖板.step
151.0 x 151.0 x 99.0 mm
