santan444/MS001/03-设计开发输出阶段/04结构/04结构图/1. MS001-A 规划模块/2. MS001-A STEP零件3D模型/MS001-A.02.014JS.1.1MS001-A交换机固定支架.step

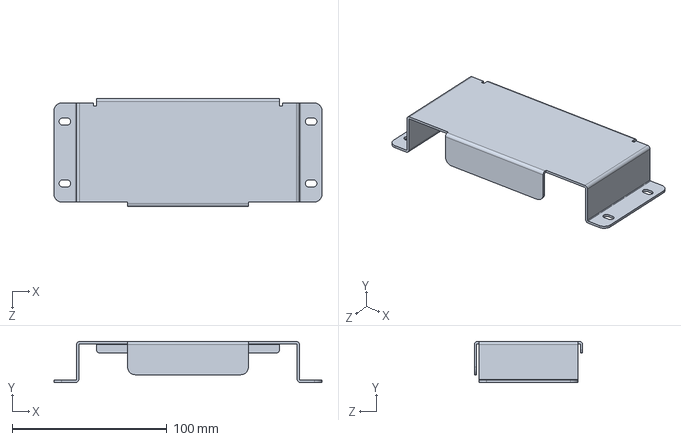
[picture p273: CAD file, 2024-10-22]
03-设计开发输出阶段/04结构/04结构图/1. MS001-A 规划模块/2. MS001-A STEP零件3D模型/MS001-A.02.014JS.1.1MS001-A交换机固定支架.step
173.0 x 26.5 x 70.0 mm
