santan444/MS001/03-设计开发输出阶段/04结构/04结构图/1. MS001-A 规划模块/2. MS001-A STEP零件3D模型/MS001-A.06.005SL.1.1珍珠棉3.step

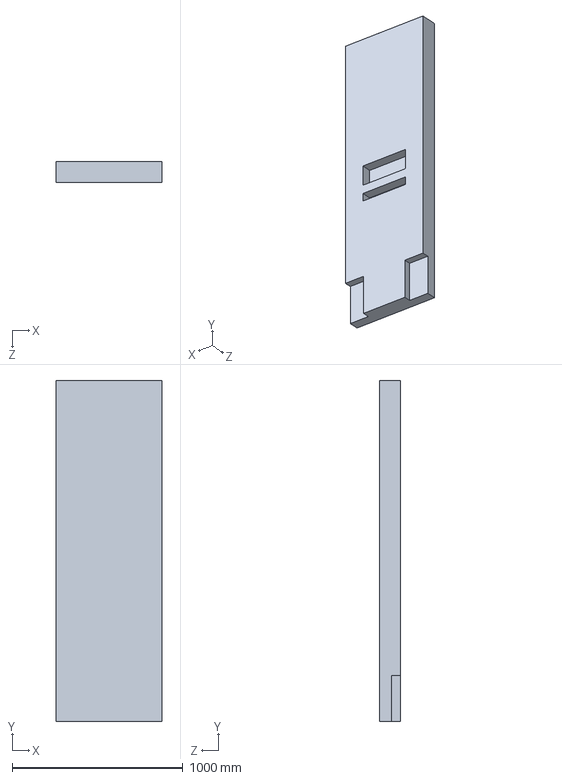
[picture p275: CAD file, 2024-10-22]
03-设计开发输出阶段/04结构/04结构图/1. MS001-A 规划模块/2. MS001-A STEP零件3D模型/MS001-A.06.005SL.1.1珍珠棉3.step
620.0 x 1995.0 x 120.0 mm
