santan444/MS001/03-设计开发输出阶段/04结构/04结构图/2. MS001-B 导引模块/2. MS001-B STEP零件3D模型/MS001-B.05.017SL.1.1 线控手柄外壳2.step

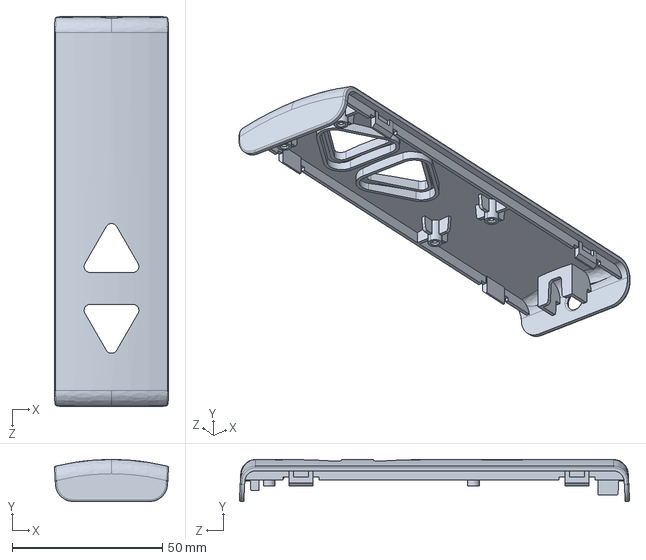
[picture p276: CAD file, 2024-10-22]
03-设计开发输出阶段/04结构/04结构图/2. MS001-B 导引模块/2. MS001-B STEP零件3D模型/MS001-B.05.017SL.1.1 线控手柄外壳2.step
38.0 x 14.0 x 129.9 mm
