santan444/MS001/03-设计开发输出阶段/04结构/04结构图/3. MS001-C 工具包/2. MS001-C STEP零件3D模型/MS001-C.07.004ZB.1.1 MS001-B机械臂包装纸箱.step

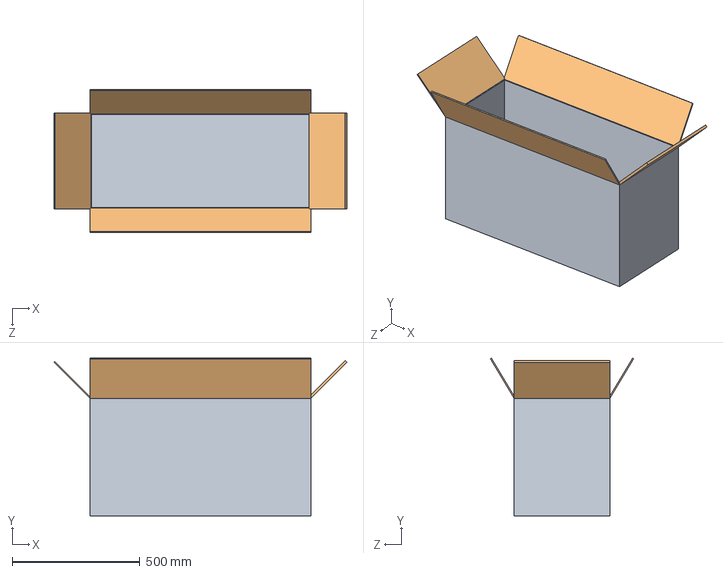
[picture p277: CAD file, 2024-10-22]
03-设计开发输出阶段/04结构/04结构图/3. MS001-C 工具包/2. MS001-C STEP零件3D模型/MS001-C.07.004ZB.1.1 MS001-B机械臂包装纸箱.step
1147.8 x 618.2 x 561.3 mm
