santan444/MS001/03-设计开发输出阶段/04结构/04结构图/2. MS001-B 导引模块/2. MS001-B STEP零件3D模型/MS001-B.07.009SL.1.1 珍珠棉5.step

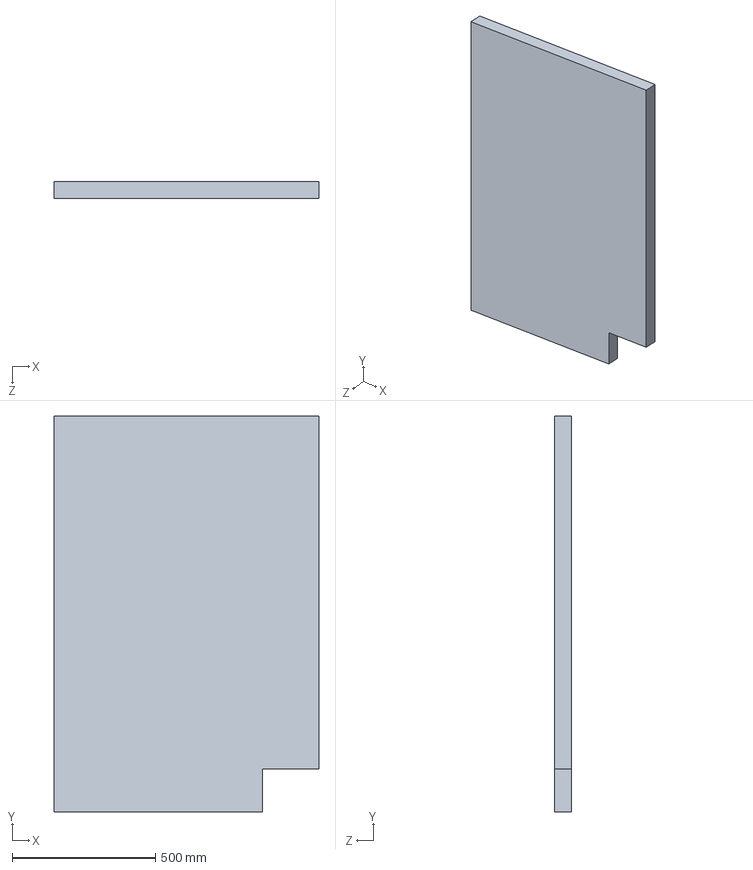
[picture p278: CAD file, 2024-10-22]
03-设计开发输出阶段/04结构/04结构图/2. MS001-B 导引模块/2. MS001-B STEP零件3D模型/MS001-B.07.009SL.1.1 珍珠棉5.step
922.0 x 1380.0 x 60.0 mm
