santan444/MS001/03-设计开发输出阶段/04结构/04结构图/1. MS001-A 规划模块/2. MS001-A STEP零件3D模型/MS001-A.02.002JS.1.1MS001-A外壳上部固定钣金.step

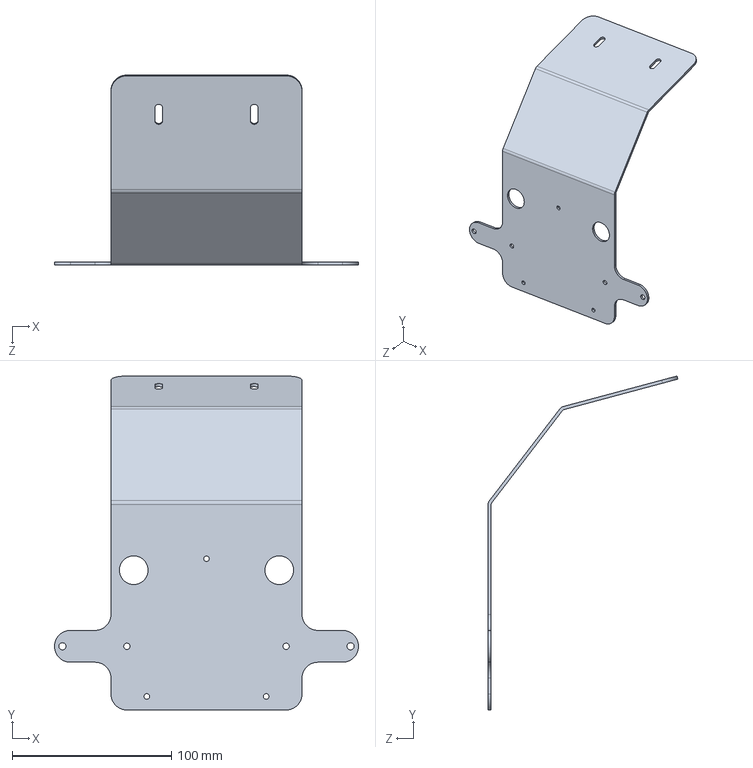
[picture p279: CAD file, 2024-10-22]
03-设计开发输出阶段/04结构/04结构图/1. MS001-A 规划模块/2. MS001-A STEP零件3D模型/MS001-A.02.002JS.1.1MS001-A外壳上部固定钣金.step
191.0 x 209.8 x 119.3 mm
