santan444/MS001/03-设计开发输出阶段/04结构/04结构图/1. MS001-A 规划模块/2. MS001-A STEP零件3D模型/MS001-A.05.007SL.1.1工作台装饰条.step

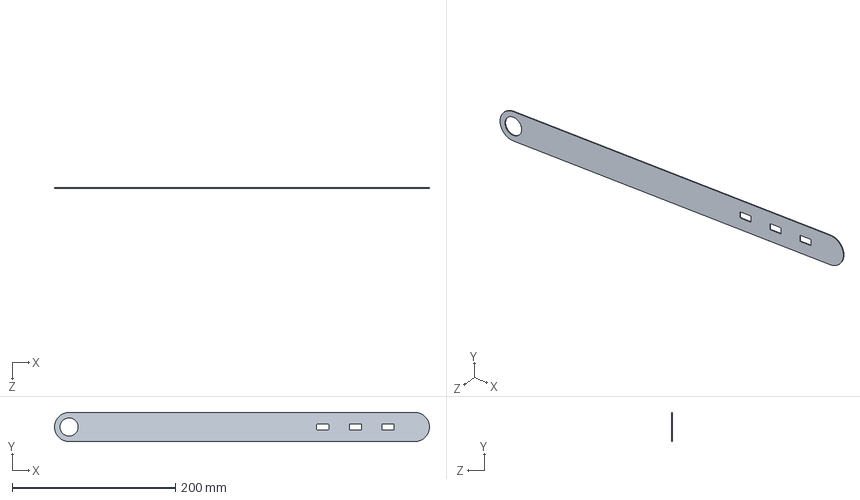
[picture p283: CAD file, 2024-10-22]
03-设计开发输出阶段/04结构/04结构图/1. MS001-A 规划模块/2. MS001-A STEP零件3D模型/MS001-A.05.007SL.1.1工作台装饰条.step
459.7 x 35.7 x 1.00 mm
