santan444/MS001/03-设计开发输出阶段/04结构/04结构图/1. MS001-A 规划模块/2. MS001-A STEP零件3D模型/MS001-A.02.005JS.1.1MS001-A显示器藏线支座.step

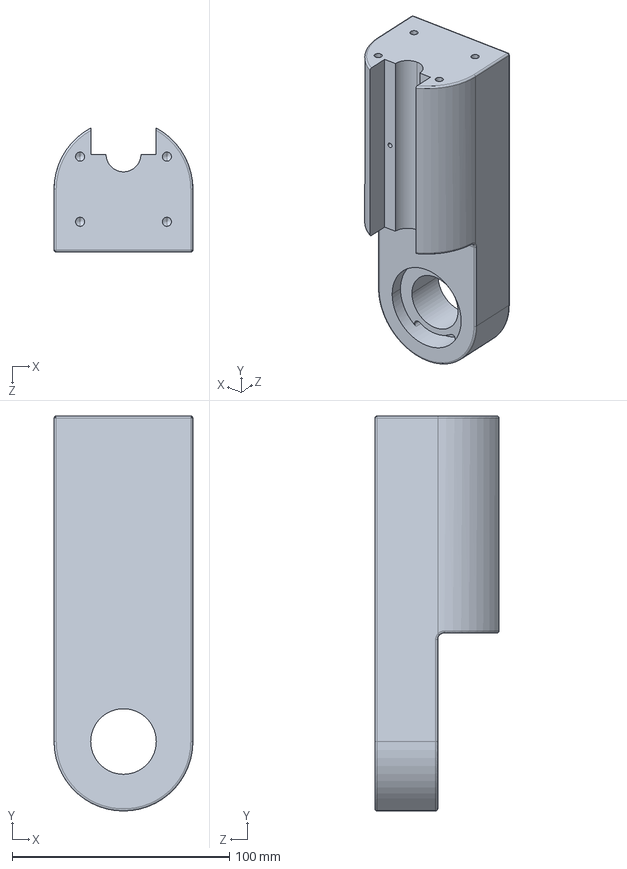
[picture p285: CAD file, 2024-10-22]
03-设计开发输出阶段/04结构/04结构图/1. MS001-A 规划模块/2. MS001-A STEP零件3D模型/MS001-A.02.005JS.1.1MS001-A显示器藏线支座.step
64.0 x 182.0 x 57.3 mm
