santan444/MS001/03-设计开发输出阶段/04结构/04结构图/1. MS001-A 规划模块/2. MS001-A STEP零件3D模型/MS001-A.02.004JS.1.1MS001-A显示器支架转接件.step

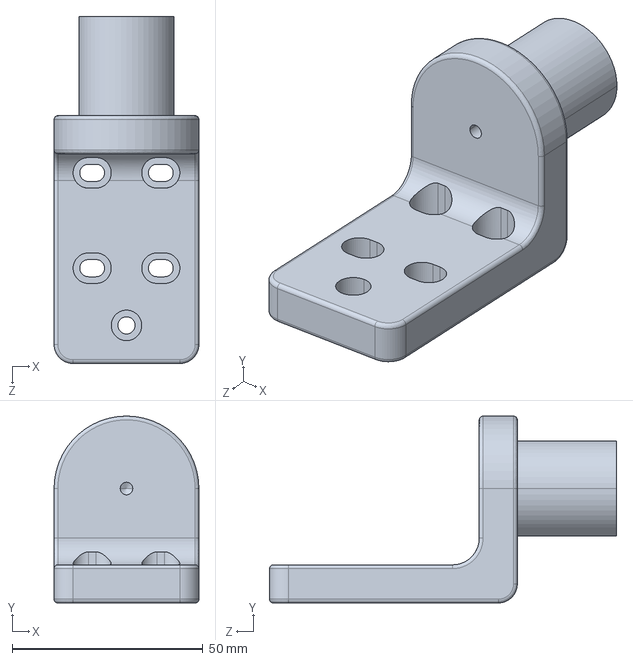
[picture p286: CAD file, 2024-10-22]
03-设计开发输出阶段/04结构/04结构图/1. MS001-A 规划模块/2. MS001-A STEP零件3D模型/MS001-A.02.004JS.1.1MS001-A显示器支架转接件.step
38.0 x 49.0 x 91.0 mm
