santan444/MS001/03-设计开发输出阶段/04结构/04结构图/2. MS001-B 导引模块/2. MS001-B STEP零件3D模型/MS001-B.07.002MB.1.1 包装木箱.step

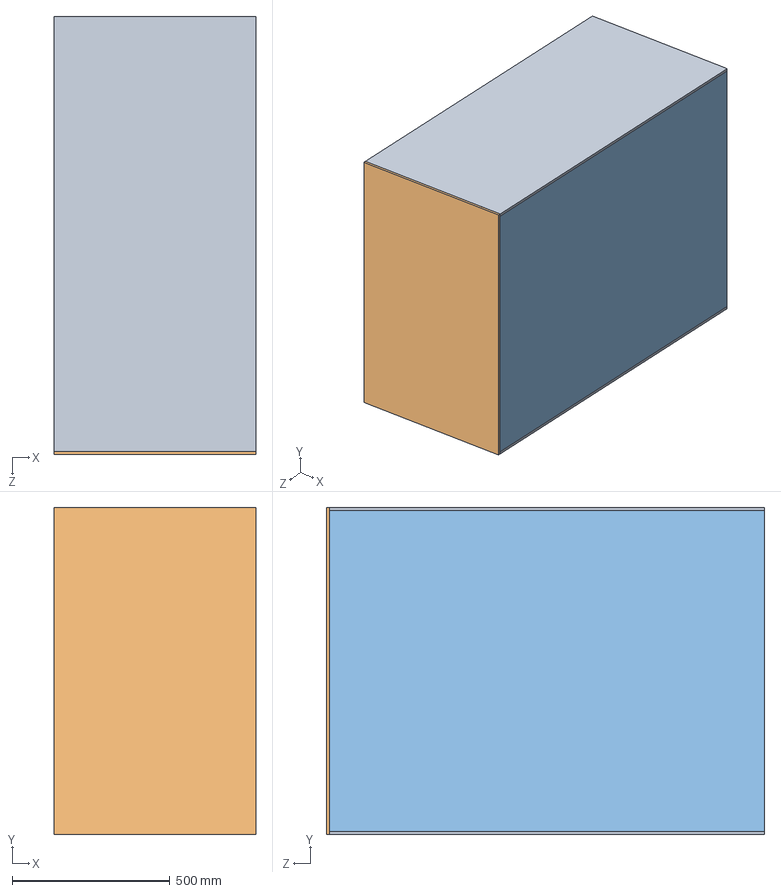
[picture p287: CAD file, 2024-10-22]
03-设计开发输出阶段/04结构/04结构图/2. MS001-B 导引模块/2. MS001-B STEP零件3D模型/MS001-B.07.002MB.1.1 包装木箱.step
640.0 x 1037.0 x 1390.0 mm
机械臂台车侧面板
机械臂台车上面板
机械臂台车正面板 x 2
MS001-B.07.004MB.1.1垫块面板
