santan444/MS001/03-设计开发输出阶段/04结构/04结构图/1. MS001-A 规划模块/2. MS001-A STEP零件3D模型/MS001-A.02.022JS.1.1MS001-A主机上钣金.step

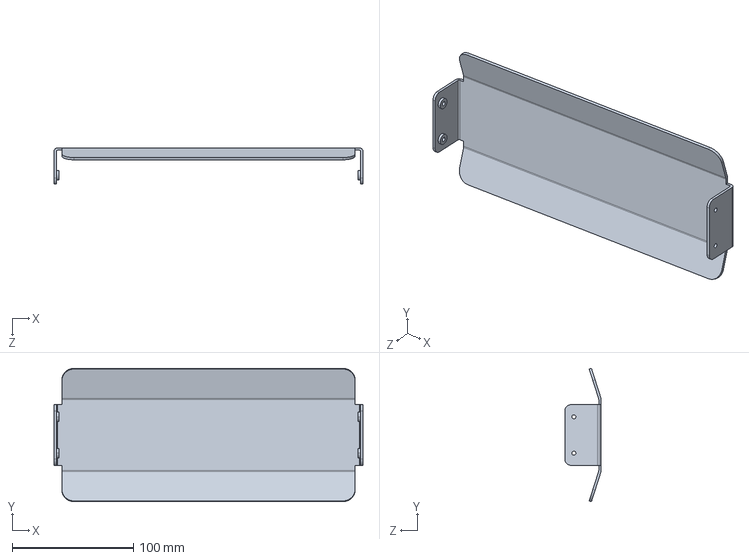
[picture p288: CAD file, 2024-10-22]
03-设计开发输出阶段/04结构/04结构图/1. MS001-A 规划模块/2. MS001-A STEP零件3D模型/MS001-A.02.022JS.1.1MS001-A主机上钣金.step
255.0 x 110.0 x 30.0 mm
