santan444/MS001/03-设计开发输出阶段/04结构/04结构图/2. MS001-B 导引模块/2. MS001-B STEP零件3D模型/MS001-B.03.005JS.1.1 主机固定钣金.step

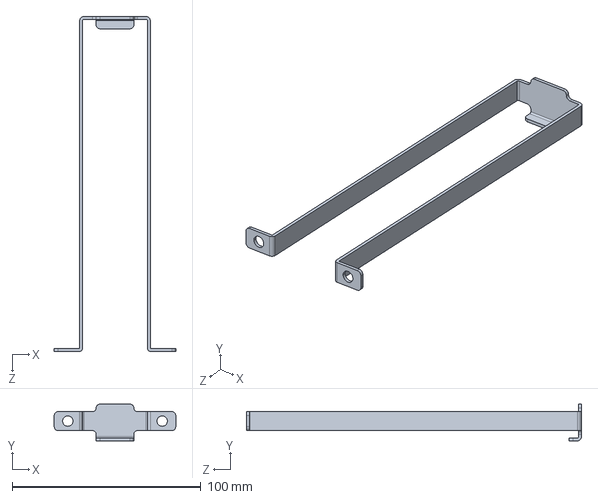
[picture p289: CAD file, 2024-10-22]
03-设计开发输出阶段/04结构/04结构图/2. MS001-B 导引模块/2. MS001-B STEP零件3D模型/MS001-B.03.005JS.1.1 主机固定钣金.step
64.4 x 19.5 x 177.5 mm
