santan444/MS001/03-设计开发输出阶段/04结构/04结构图/1. MS001-A 规划模块/2. MS001-A STEP零件3D模型/MS001-A.06.006SL.1.1珍珠棉4.step

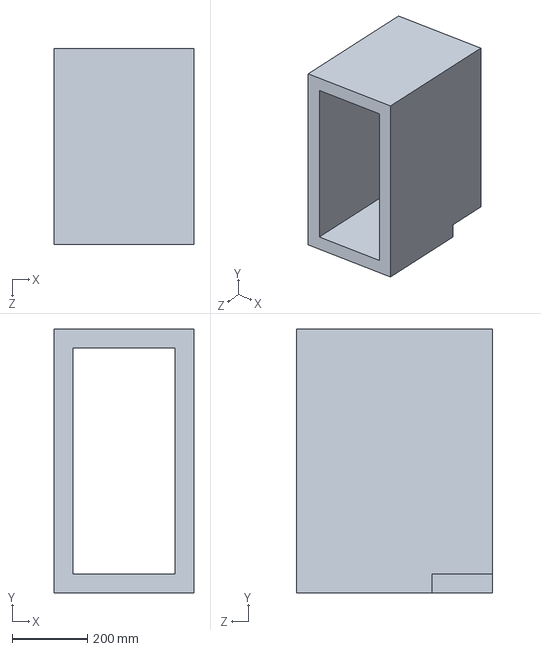
[picture p292: CAD file, 2024-10-22]
03-设计开发输出阶段/04结构/04结构图/1. MS001-A 规划模块/2. MS001-A STEP零件3D模型/MS001-A.06.006SL.1.1珍珠棉4.step
370.0 x 700.0 x 520.0 mm
