santan444/MS001/03-设计开发输出阶段/04结构/04结构图/2. MS001-B 导引模块/2. MS001-B STEP零件3D模型/MS001-B.05.002SL.1.1 抽屉.step

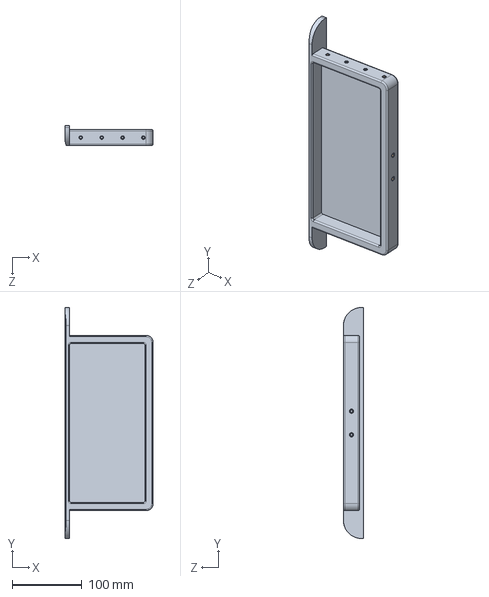
[picture p293: CAD file, 2024-10-22]
03-设计开发输出阶段/04结构/04结构图/2. MS001-B 导引模块/2. MS001-B STEP零件3D模型/MS001-B.05.002SL.1.1 抽屉.step
126.9 x 332.0 x 29.0 mm
喲歾
И杶-M4X5X4 x 10
