santan444/MS001/03-设计开发输出阶段/04结构/04结构图/1. MS001-A 规划模块/2. MS001-A STEP零件3D模型/MS001-A.02.006JS.1.1MS001-A显示器藏线支座盖板.step

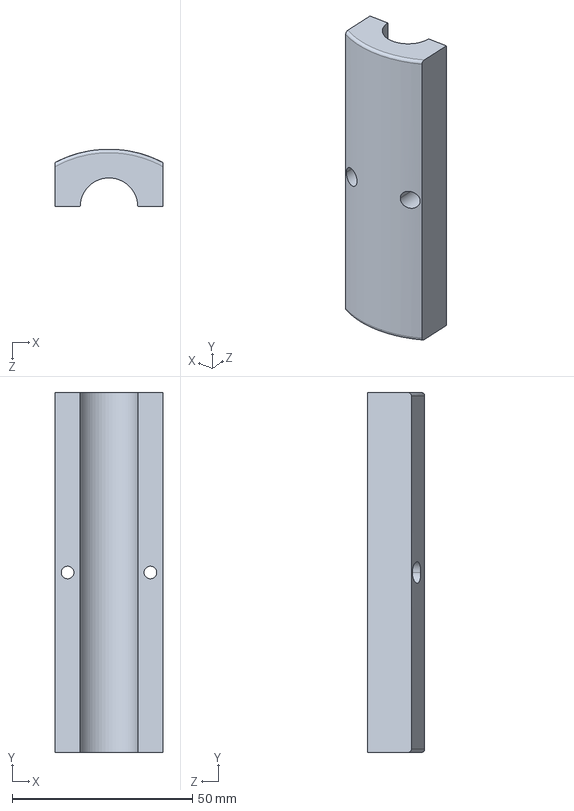
[picture p297: CAD file, 2024-10-22]
03-设计开发输出阶段/04结构/04结构图/1. MS001-A 规划模块/2. MS001-A STEP零件3D模型/MS001-A.02.006JS.1.1MS001-A显示器藏线支座盖板.step
30.0 x 100.0 x 16.0 mm
