santan444/MS001/03-设计开发输出阶段/04结构/04结构图/1. MS001-A 规划模块/2. MS001-A STEP零件3D模型/MS001-A.02.003SL.1.1MS001-A显示器适配器支架.step

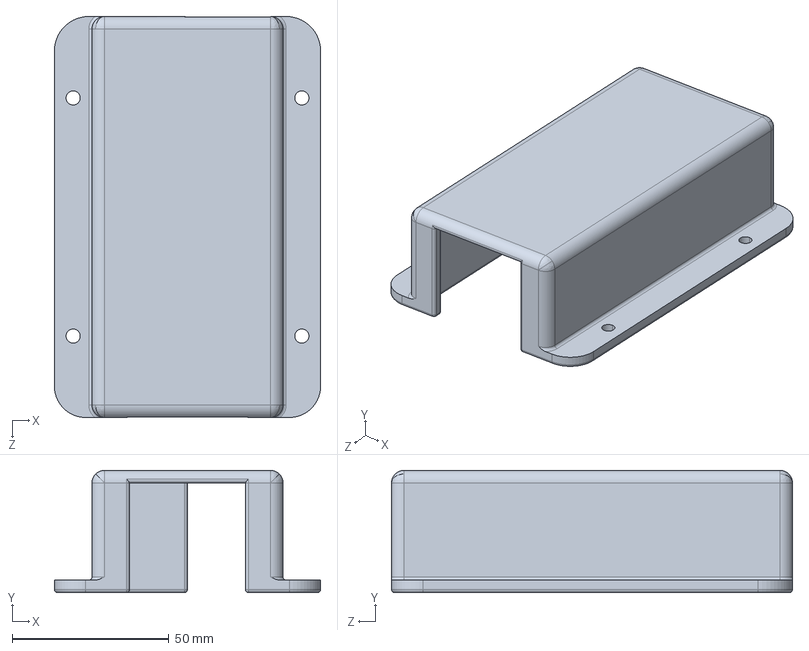
[picture p299: CAD file, 2024-10-22]
03-设计开发输出阶段/04结构/04结构图/1. MS001-A 规划模块/2. MS001-A STEP零件3D模型/MS001-A.02.003SL.1.1MS001-A显示器适配器支架.step
85.0 x 39.0 x 128.0 mm
