santan444/MS001/03-设计开发输出阶段/04结构/04结构图/2. MS001-B 导引模块/2. MS001-B STEP零件3D模型/MS001-B.05.019SL.1.1 显示器保护罩3.step

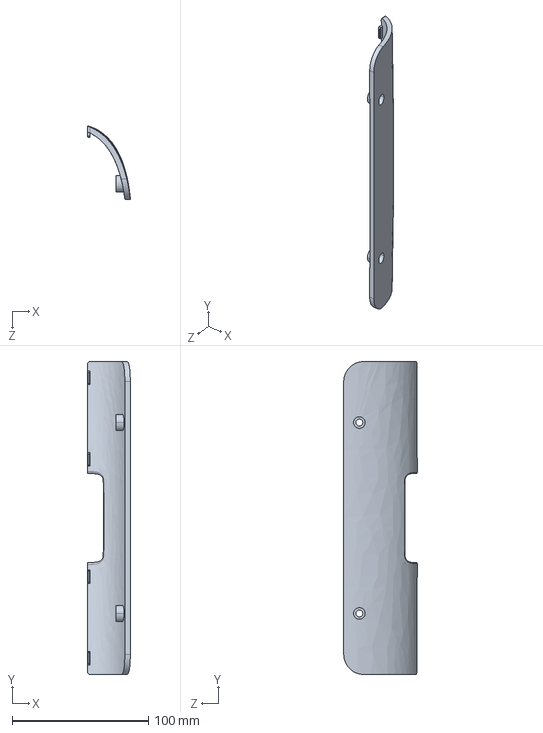
[picture p301: CAD file, 2024-10-22]
03-设计开发输出阶段/04结构/04结构图/2. MS001-B 导引模块/2. MS001-B STEP零件3D模型/MS001-B.05.019SL.1.1 显示器保护罩3.step
31.6 x 229.6 x 54.0 mm
