santan444/MS001/03-设计开发输出阶段/04结构/04结构图/2. MS001-B 导引模块/2. MS001-B STEP零件3D模型/MS001-B.02.003JS.1.1 升降立柱顶板支撑柱.step

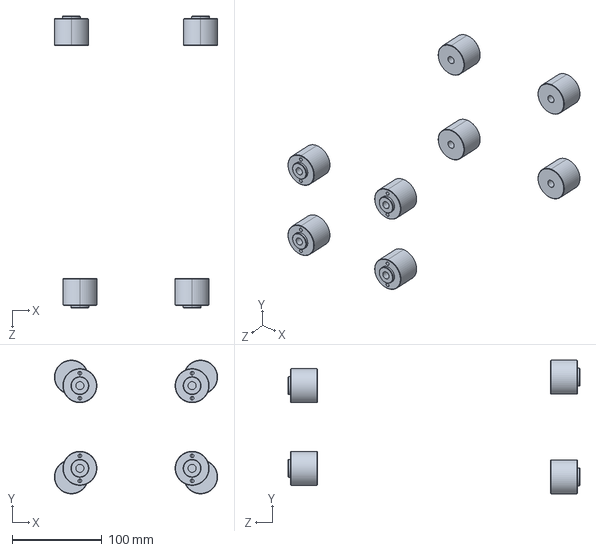
[picture p303: CAD file, 2024-10-22]
03-设计开发输出阶段/04结构/04结构图/2. MS001-B 导引模块/2. MS001-B STEP零件3D模型/MS001-B.02.003JS.1.1 升降立柱顶板支撑柱.step
182.3 x 149.3 x 326.0 mm
MS001-B.02.003JS.1.1 升降立柱顶板支撑柱 x 8
