santan444/MS001/03-设计开发输出阶段/04结构/04结构图/2. MS001-B 导引模块/2. MS001-B STEP零件3D模型/MS001-B.05.012SL.1.1 USB延长线安装板.step

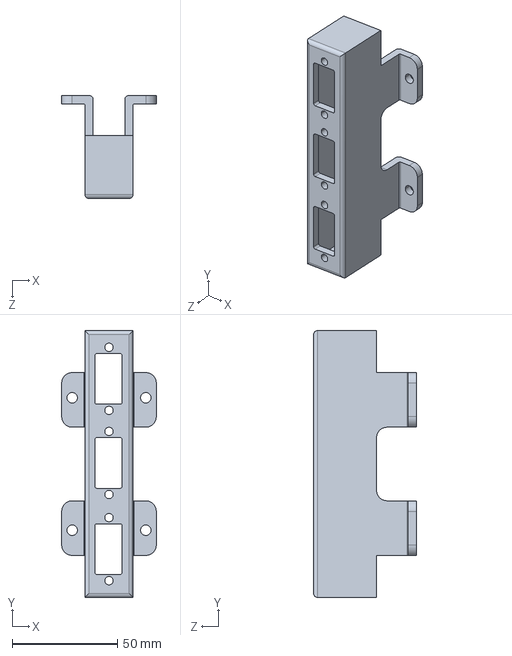
[picture p305: CAD file, 2024-10-22]
03-设计开发输出阶段/04结构/04结构图/2. MS001-B 导引模块/2. MS001-B STEP零件3D模型/MS001-B.05.012SL.1.1 USB延长线安装板.step
45.0 x 127.0 x 49.0 mm
