santan444/MS001/(list of files, cad)

Other CAD files:
03-设计开发输出阶段/02电子/02接线图/MS001-A接线图/MS001-A.01.002JL.1.1规划模块接线图.dwg
03-设计开发输出阶段/02电子/02接线图/MS001-B接线图/MS001-B.01.002JL.1.1导引模块接线图.dwg
03-设计开发输出阶段/02电子/03线缆图/MS001-A线缆图/MS001-A线缆图.dwg
03-设计开发输出阶段/02电子/03线缆图/MS001-B线缆图/MS001-B线缆图.dwg
03-设计开发输出阶段/04结构/04结构图/加工丝印源文件/B台车侧面板激光雕刻文件.dwg
03-设计开发输出阶段/04结构/04结构图/加工丝印源文件/A台车侧面板激光雕刻文件.dwg
03-设计开发输出阶段/04结构/04结构图/2. MS001-B 导引模块/2. MS001-B STEP零件3D模型/MS001-B.03.022JS.1.1 止转板.step
03-设计开发输出阶段/04结构/04结构图/1. MS001-A 规划模块/2. MS001-A STEP零件3D模型/MS001-A.03.012SL.1.1右侧透光板.step
03-设计开发输出阶段/04结构/04结构图/3. MS001-C 工具包/2. MS001-C STEP零件3D模型/MS001-C.05.002ZB.1.1 MS001-C工具包纸箱.step
03-设计开发输出阶段/04结构/04结构图/1. MS001-A 规划模块/2. MS001-A STEP零件3D模型/MS001-A.02.019SL.1.1MS001-A左侧灯条支架.step
03-设计开发输出阶段/04结构/04结构图/3. MS001-C 工具包/2. MS001-C STEP零件3D模型/MS001-C.05.003SL.1.1 MS001-C工具包珍珠棉.step
03-设计开发输出阶段/04结构/04结构图/1. MS001-A 规划模块/2. MS001-A STEP零件3D模型/MS001-A.06.003SL.1.1珍珠棉1.step
03-设计开发输出阶段/04结构/04结构图/3. MS001-C 工具包/2. MS001-C STEP零件3D模型/MS001-C.01.002JS.1.1 MS001-C短套筒Φ2.0.step
03-设计开发输出阶段/04结构/04结构图/2. MS001-B 导引模块/2. MS001-B STEP零件3D模型/MS001-B.04.005SL.1.1 左侧板.step
03-设计开发输出阶段/04结构/04结构图/1. MS001-A 规划模块/2. MS001-A STEP零件3D模型/MS001-A.05.008JS.1.1抽屉左支撑板.step
03-设计开发输出阶段/04结构/04结构图/2. MS001-B 导引模块/2. MS001-B STEP零件3D模型/MS001-B.03.021JS.1.1 交换机安装钣金.step
03-设计开发输出阶段/04结构/04结构图/2. MS001-B 导引模块/2. MS001-B STEP零件3D模型/MS001-B.03.018JS.1.1 万向脚杯右支撑柱.step
03-设计开发输出阶段/04结构/04结构图/2. MS001-B 导引模块/2. MS001-B STEP零件3D模型/MS001-B.05.015JS.1.1 右侧导轨安装钣金.step
03-设计开发输出阶段/04结构/04结构图/1. MS001-A 规划模块/2. MS001-A STEP零件3D模型/MS001-A.02.028JS.1.1MS001-A主机左固定支架.step
03-设计开发输出阶段/04结构/04结构图/2. MS001-B 导引模块/2. MS001-B STEP零件3D模型/MS001-B.02.002JS.1.1 升降立柱顶板法兰.step
03-设计开发输出阶段/04结构/04结构图/2. MS001-B 导引模块/2. MS001-B STEP零件3D模型/MS001-B.02.004JS.1.1 升降立柱底板法兰.step
03-设计开发输出阶段/04结构/04结构图/2. MS001-B 导引模块/2. MS001-B STEP零件3D模型/MS001-B.02.005JS.1.1 升降立柱底板.step
03-设计开发输出阶段/04结构/04结构图/2. MS001-B 导引模块/2. MS001-B STEP零件3D模型/MS001-B.03.007JS.1.1 焊接框架中支撑板.step
03-设计开发输出阶段/04结构/04结构图/2. MS001-B 导引模块/2. MS001-B STEP零件3D模型/MS001-B.03.011JS.1.1 MS001-BUPS固定钣金二.step
03-设计开发输出阶段/04结构/04结构图/2. MS001-B 导引模块/2. MS001-B STEP零件3D模型/MS001-B.03.014JS.1.1 显示器适配器安装支架.step
03-设计开发输出阶段/04结构/04结构图/2. MS001-B 导引模块/2. MS001-B STEP零件3D模型/MS001-B.03.015JS.1.1 机械臂支撑法兰.step
03-设计开发输出阶段/04结构/04结构图/2. MS001-B 导引模块/2. MS001-B STEP零件3D模型/MS001-B.03.019JS.1.1 万向脚杯前支撑柱.step
03-设计开发输出阶段/04结构/04结构图/2. MS001-B 导引模块/2. MS001-B STEP零件3D模型/MS001-B.03.026JS.1.1 支撑杆.step
03-设计开发输出阶段/04结构/04结构图/2. MS001-B 导引模块/2. MS001-B STEP零件3D模型/MS001-B.03.027JS.1.1 空心铝管.step
03-设计开发输出阶段/04结构/04结构图/2. MS001-B 导引模块/2. MS001-B STEP零件3D模型/MS001-B.04.010SL.1.1 透光罩.step
03-设计开发输出阶段/04结构/04结构图/2. MS001-B 导引模块/2. MS001-B STEP零件3D模型/MS001-B.04.012SL.1.1 机械臂装饰罩2.step
03-设计开发输出阶段/04结构/04结构图/2. MS001-B 导引模块/2. MS001-B STEP零件3D模型/MS001-B.04.014JS.1.1推手加强金属件.step
03-设计开发输出阶段/04结构/04结构图/2. MS001-B 导引模块/2. MS001-B STEP零件3D模型/MS001-B.05.009SL.1.1 显示器支架外壳.step
03-设计开发输出阶段/04结构/04结构图/2. MS001-B 导引模块/2. MS001-B STEP零件3D模型/MS001-B.05.010SL.1.1 线控手柄放置壳.step
03-设计开发输出阶段/04结构/04结构图/2. MS001-B 导引模块/2. MS001-B STEP零件3D模型/MS001-B.05.018SL.1.1 手柄按键.step
03-设计开发输出阶段/04结构/04结构图/2. MS001-B 导引模块/2. MS001-B STEP零件3D模型/MS001-B.06.002JS.1.1 侧面板.step
03-设计开发输出阶段/04结构/04结构图/2. MS001-B 导引模块/2. MS001-B STEP零件3D模型/MS001-B.07.004MB.1.1垫块面板.step
03-设计开发输出阶段/04结构/04结构图/2. MS001-B 导引模块/2. MS001-B STEP零件3D模型/MS001-B.07.005SL.1.1 珍珠棉1.step
03-设计开发输出阶段/04结构/04结构图/2. MS001-B 导引模块/2. MS001-B STEP零件3D模型/MS001-B.07.006SL.1.1 珍珠棉2.step
03-设计开发输出阶段/04结构/04结构图/2. MS001-B 导引模块/2. MS001-B STEP零件3D模型/机械臂关节盖（小）.step
