santan444/MS001/03-设计开发输出阶段/02电子/MS001.06.005ZZ.1.1-LED灯板（MS001-A规划模块）/05_装配图/MS001.06.005ZZ.1.1-LED灯板-装配图.pdf

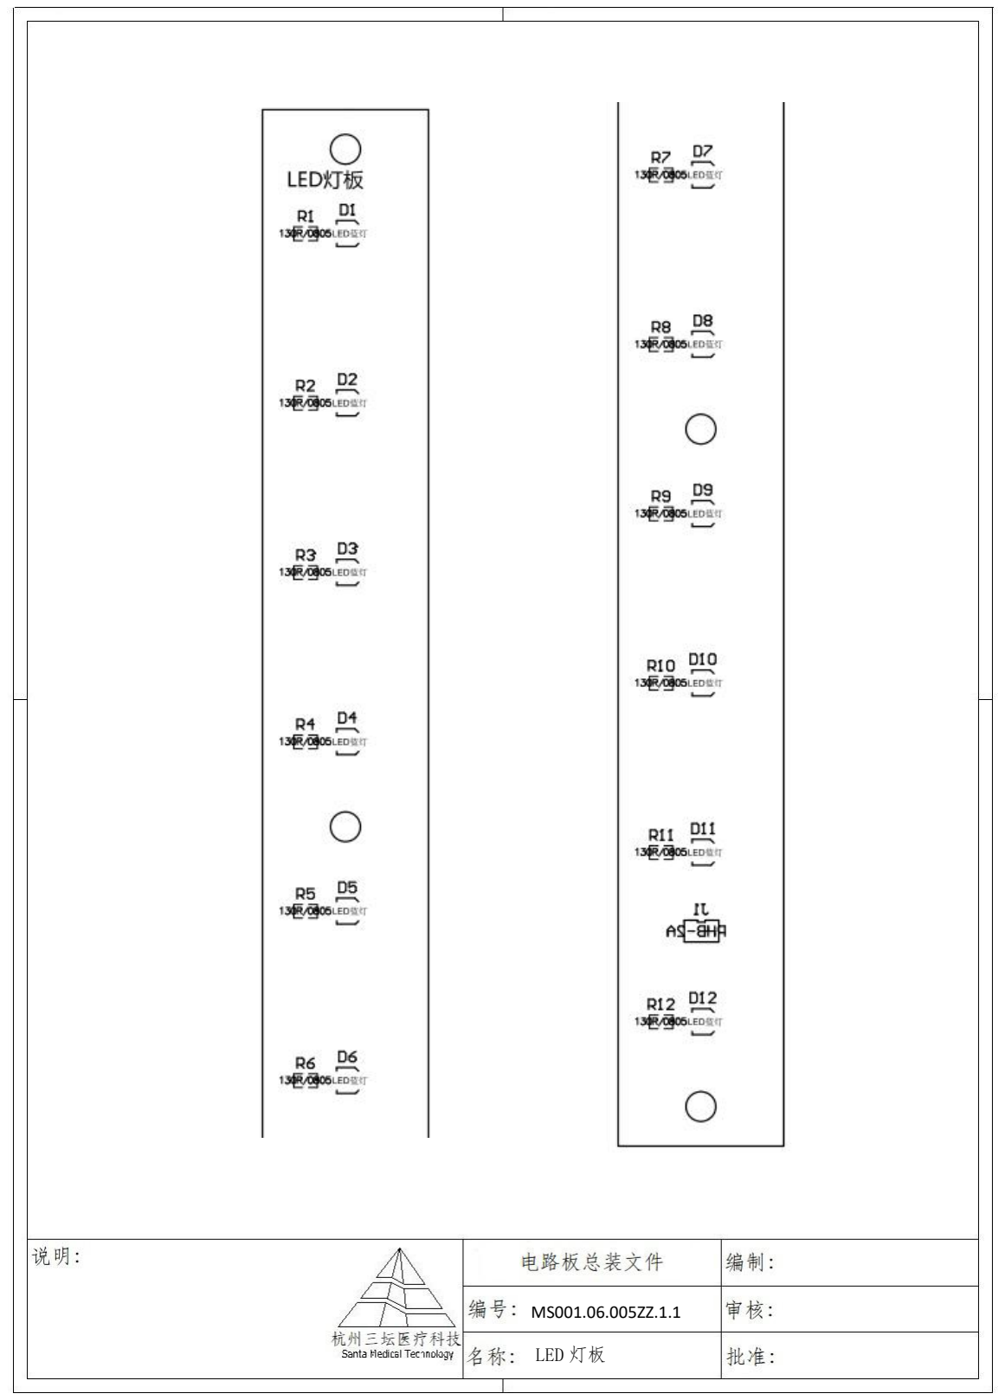
[picture p324: page 1]

LED 灯板

MS001.06.005ZZ.1.1
