santan444/MS001/03-设计开发输出阶段/02电子/MS001.06.003ZZ.1.2-UR控制板/05_装配图/MS001.06.003ZZ.1.2-UR控制板-装配图.pdf

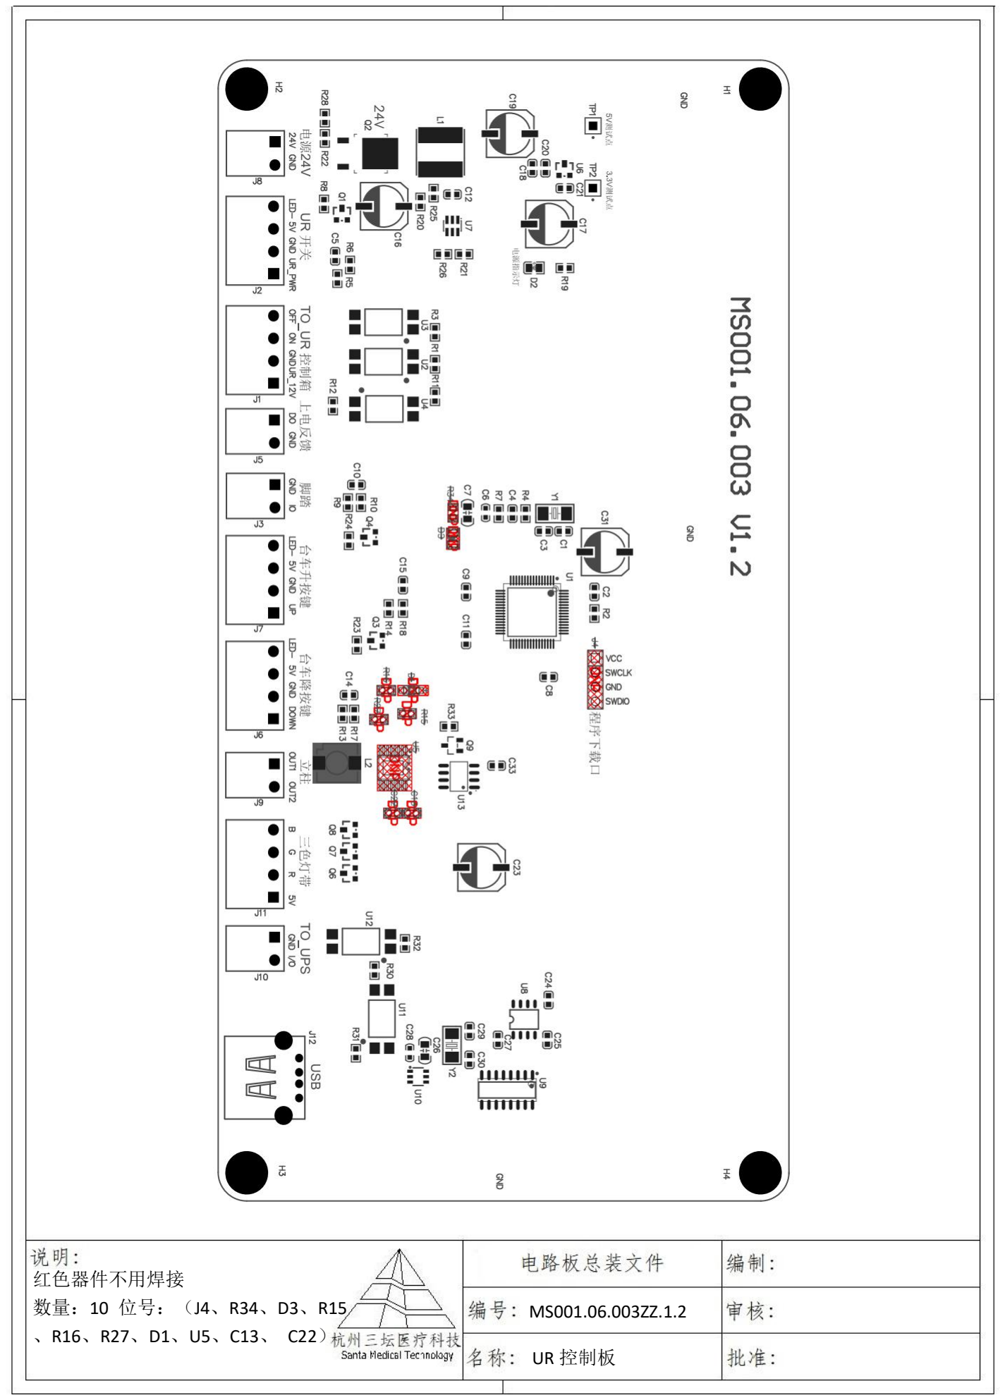
[picture p374: page 1]

红色器件不用焊接 数量：10 位号：（J4、R34、D3、R15 、R16、R27、D1、U5、C13、 C22） | MS001.06.003ZZ.1.2 UR 控制板
