santan444/MS001/03-设计开发输出阶段/02电子/MS001.06.004ZZ.1.1-按键板/05_装配图/MS001.06.004ZZ.1.1-按键板-装配图.pdf

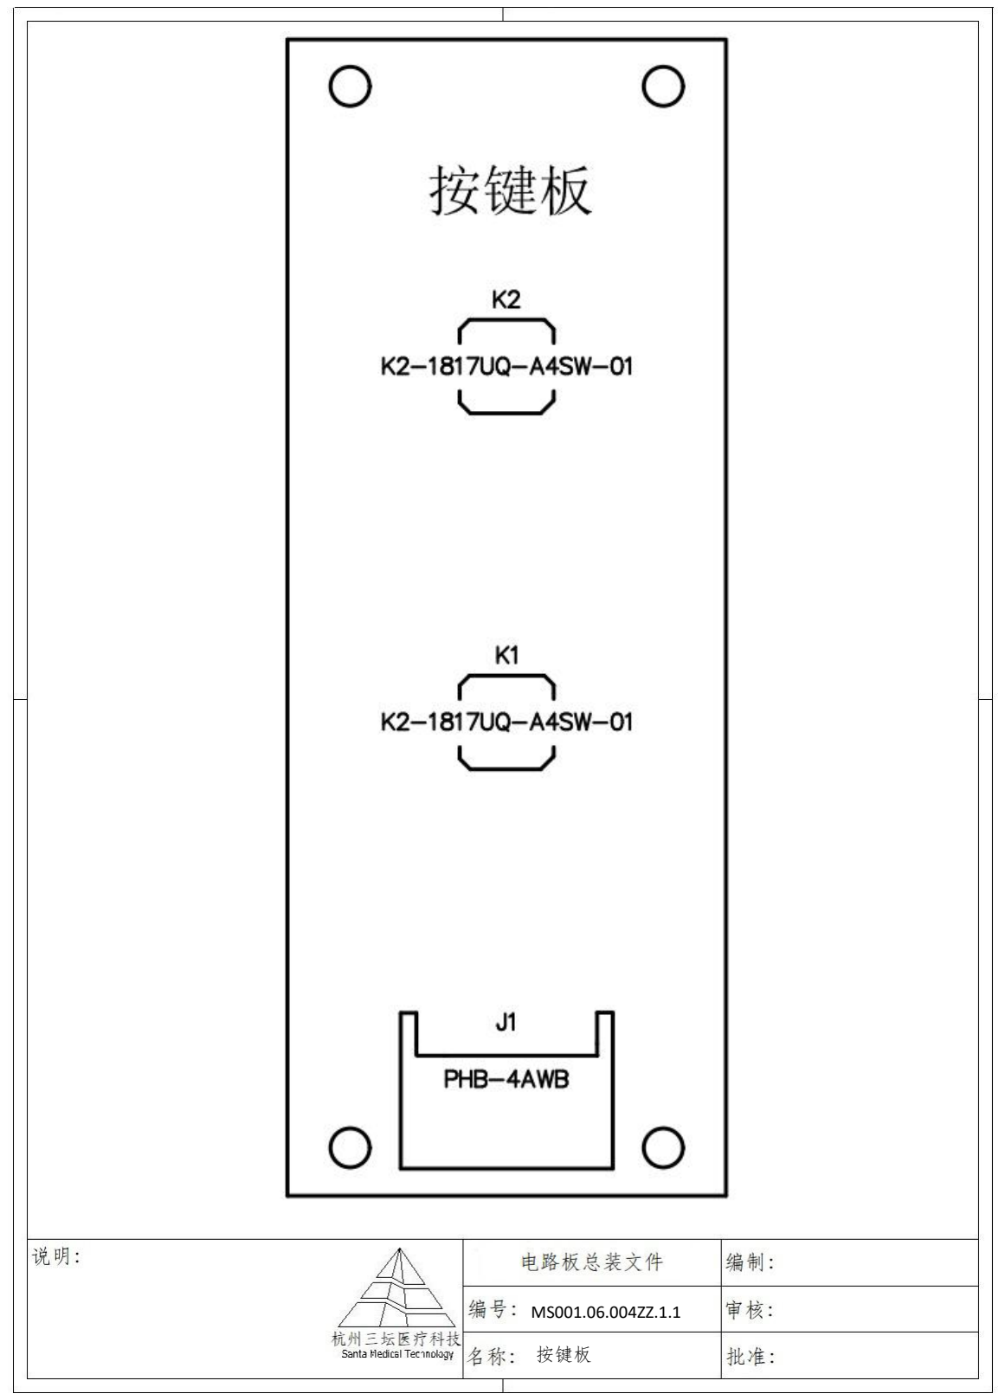
[picture p375: page 1]

按键板

MS001.06.004ZZ.1.1
