santan444/MS001/03-设计开发输出阶段/02电子/MS001.06.006ZZ.1.1-RGB灯板/05_装配图/MS001.06.006ZZ.1.1-RGB灯板-装配图.pdf

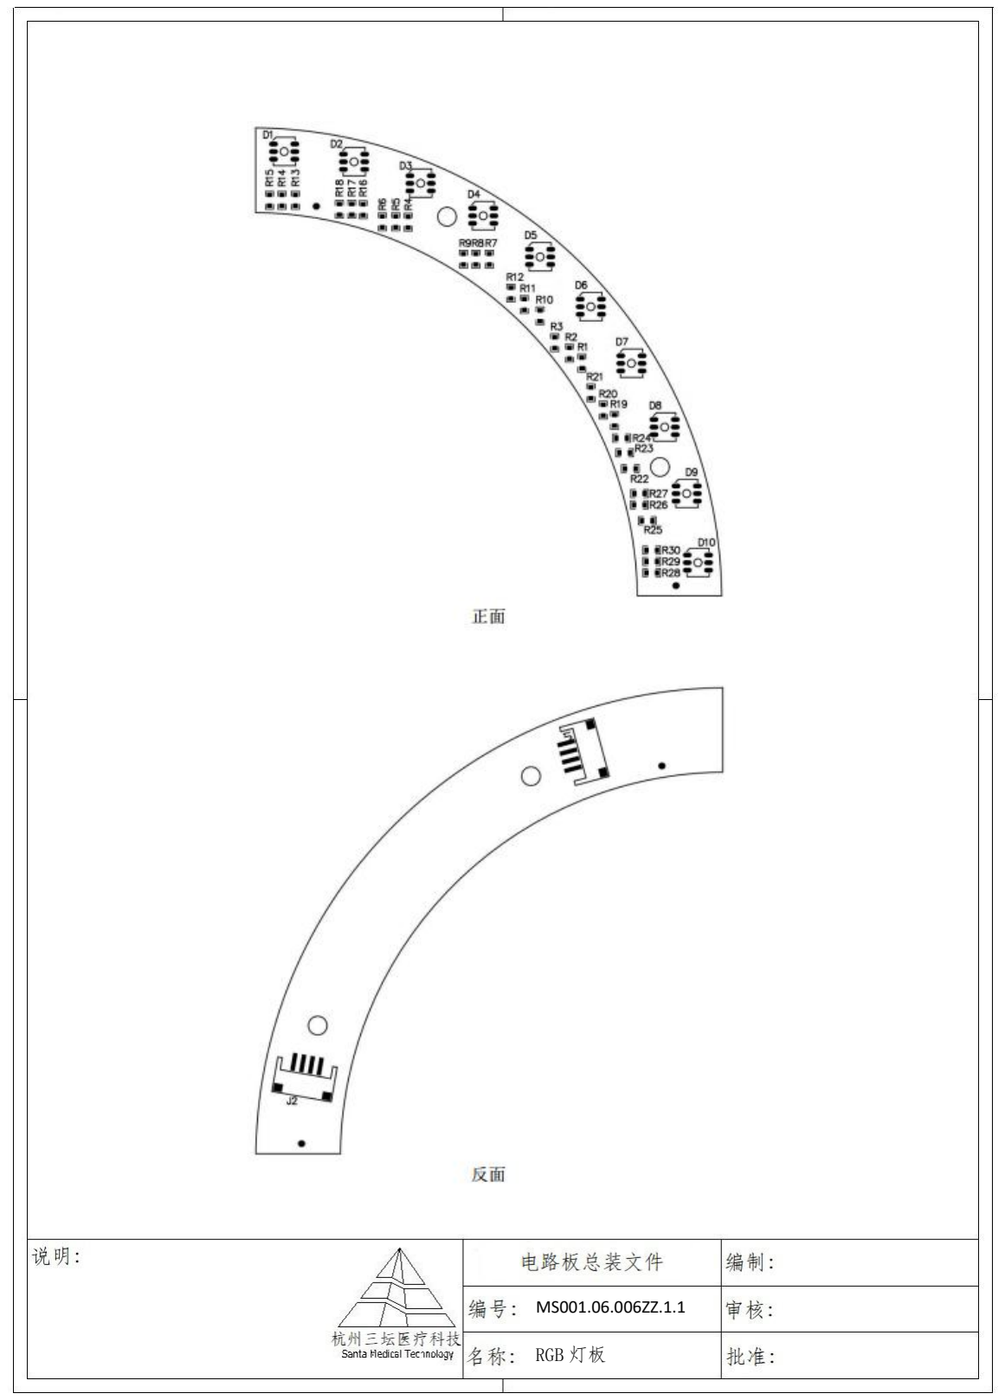
[picture p376: page 1]

RGB 灯板

MS001.06.006ZZ.1.1
