santan444/MS001/03-设计开发输出阶段/02电子/MS001.06.007ZZ.1.1-激光控制板/05_装配图/MS001.06.007ZZ.1.1-激光控制板-装配图.pdf

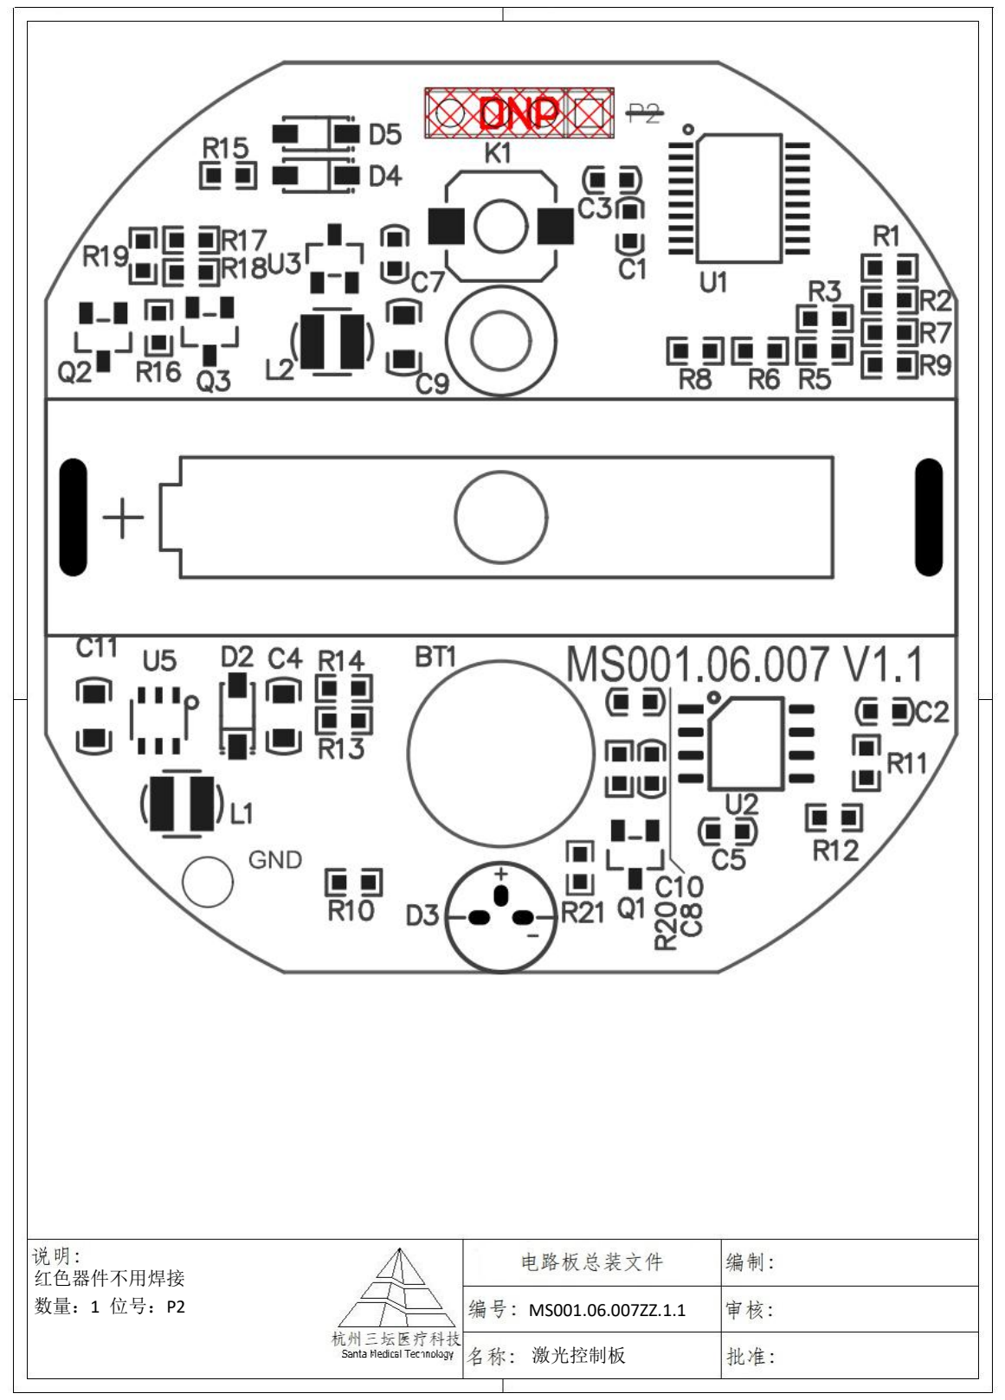
[picture p377: page 1]

红色器件不用焊接 数量：1 位号：P2 | MS001.06.007ZZ.1.1 激光控制板
