santan444/MS001/03-设计开发输出阶段/07风险管理/MS-001故障树分析法（FTA）_导引软件.xlsx

Sheet: Rev
变更履历
版本号 | 发布/实施日期 | 更改内容概述 | 更改者
V1.0 | 2021.07.29 | 文件新编 | 洪洁
V1.1 | 2021.08.03 | 增加风险评估自动公式计算 | 洪洁

Sheet: Method
操作指南
1，画软件架构框图
2，知晓每个模块的功能（参考软件技术需求说明书）
3，根据功能点，寻找潜在的软件故障（顶层事件）
4，根据软件架构框图，遍历可能导致故障的发生路径，识别、分析路径上的每个软件项（基本事件）
5，分析每个软件项的具体成因
备注：
1，当前只作为软件风险分析工具
2，每一个软件故障，为一棵树

Sheet: FTA
 |  |  |  |  | 故障树分析法（FTA）
 | 产品名称： | 模块化手术导引系统-导引软件 |  | 文件号：MS001-B.01.106SM.1.0
 | 产品代号： | MS-001 |  | 版本：V1.0 | 编制： |  |  |  |  | 审核： |  | 批准：
序号 | 软件故障 | 危险情况 | 伤害 | 可能促成危险情况的软件项 | 软件项具体成因 | 伤害严重度S | 危险情况发生的概率Px | 导致伤害的可能性Py | 伤害的总体概率P | 风险水平 | 风险控制选项 | 风险控制措施描述 | 责任人和目标完成日期 | 风险评估控制记录编号
1 | 软件运行过程中闪退 | 医生无法继续手术 | 延误手术进程 | 存储IO错误 | 内存和硬盘不稳定 | S3 | Fr | R | P3 | U | 设计保证 | 重启后可以继续操作 | 杨斌 2021.04 | R140
 |  |  |  | 操作系统错误 | 操作系统自有缺陷 | S3 | Fr | R | P3 | U | 设计保证 | 重启后可以继续操作 | 杨斌 2021.04 | R141
2 | 机械臂无法运动到目标位置 | 手术无法继续 | 延误手术进程 | 软件与机械臂的连接失效 | 网络异常断开 | S3 | Fr | R | P3 | U | 设计保证 | 软件与机械臂断开连接时弹窗提示 | 杨斌 2021.04 | R142
 |  |  |  | 机械臂异常停止 | 机械臂运动到关节极限，保护性停止 | S3 | Fr | R | P3 | U | 设计保证 | 使用自由拖动模式，将机械臂关节运动到正常范围内 | 杨斌 2021.04 | R143
 |  |  |  |  | 机械臂关节自碰撞，保护性停止 | S3 | Fr | R | P3 | U | 设计保证 | 增加姿态仿真功能 | 杨斌 2021.04 | R144
 |  |  |  |  | 机械臂无法到达指定地点 | S3 | Fr | R | P3 | U | 设计保证 | 增加姿态仿真功能 | 杨斌 2021.04 | R145
 |  |  |  |  | 机械臂遇到障碍物，保护性停止 | S3 | Fr | R | P3 | U | 设计保证 | 增加姿态仿真功能 | 杨斌 2021.04 | R146
3 | 网络异常 | 手术无法继续 | 延误手术进程 | 未接收到X光图像 | 与C臂机的网络连接断开 | S3 | Fr | R | P3 | U | 设计保证 | 显示于C臂机连接的网络状态 | 杨斌 2021.04 | R147
 |  |  |  | 规划软件断开连接 | 与规划软件的网络连接断开 | S3 | Fr | R | P3 | U | 设计保证 | 软件提示发送超时 | 杨斌 2021.04 | R148
4 | 图片校准错误 | 手术无法继续 | 延误手术进程 | focalLength | focalLength设置错误 | S3 | Fr | R | P3 | U | 设计保证 | 增加权限控制，非相关人员无法修改设置 | 杨斌 2021.04 | R149
 |  |  |  | spacing | spacing设置错误 | S3 | Fr | R | P3 | U | 设计保证 | 增加权限控制，非相关人员无法修改设置 | 杨斌 2021.04 | R150
 |  |  |  | radius | radius设置错误 | S3 | Fr | R | P3 | U | 设计保证 | 增加权限控制，非相关人员无法修改设置 | 杨斌 2021.04 | R151
 |  |  |  | minArea、maxArea | minArea、maxArea设置错误 | S3 | Fr | R | P3 | U | 设计保证 | 增加权限控制，非相关人员无法修改设置 | 杨斌 2021.04 | R152
 |  |  |  | 校准板姿态识别错误 | 校准板未水平摆放 | S3 | Fr | R | P3 | U | 设计保证 | 增加机械臂水平对齐功能 | 杨斌 2021.04 | R153
 |  |  |  | X光图像显示错误 | X光图像分辨率不匹配 | S3 | Fr | R | P3 | U | 设计保证 | 配置文件增加参数设置X光图像分辨率 | 杨斌 2021.04 | R154
 |  |  |  | 校准板小球识别错误 | 校准板小球坐标数据不匹配 | S3 | Fr | R | P3 | U | 设计保证 | 图像X光片识别结果保存本地 | 杨斌 2021.04 | R155
5 | 软件无法正常运行 | 手术无法继续 | 延误手术进程 | 机械臂断开连接 | 机械臂临时断电 | S3 | Fr | R | P3 | U | 设计保证 | 软件提供机械臂断开和开启功能 | 杨斌 2021.04 | R156
6 | 运行数据异常 | 手术无法继续 | 延误手术进程 | 无法重复校准 | 机械臂姿态数据未保存或者备份 | S3 | Fr | R | P3 | U | 设计保证 | 每次X光图像校准之后将姿态数据保存至本地，并提供正位复位和侧位复位功能 | 杨斌 2021.04 | R157
7 | X光图像发送失败 | 手术无法继续 | 延误手术进程 | X光图像发送超时 | 规划未在接收X光图像界面 | S3 | Fr | R | P3 | U | 设计保证 | 软件提示 | 杨斌 2021.04 | R158
8 | 软件运行卡顿 | 医生使用体验感不佳 | 影响医生判断 | 部分功能运行时间太久 | 部分功能在主进程中占用太多时间 | S3 | Fr | R | P3 | U | 设计保证 | 软件开启多线程运行计算 | 杨斌 2021.04 | R159
 |  |  |  | 校准X光图像超时 | 校准参数设置错误 | S3 | Fr | R | P3 | U | 设计保证 | 软件校准超时提示 | 杨斌 2021.04 | R160
 |  |  |  | 进度条显示卡顿 | 进度条运行中执行其他操作 | S3 | Fr | R | P3 | U | 设计保证 | 进度条设置置顶 | 杨斌 2021.04 | R161
 |  |  |  | 用户可以启动软件多个实例 | 软件未单实例运行 | S3 | Fr | R | P3 | U | 设计保证 | 软件设置单实例运行程序 | 杨斌 2021.04 | R162
9 | 工具加载失败 | 手术无法继续 | 延误手术进程 | 无法找到工具文件 | 未配置工具文件 | S3 | Fr | R | P3 | U | 设计保证 | 增加工具文件导入功能 | 杨斌 2021.04 | R163
 |  |  |  | 工具文件加载失败 | 工具文格式错误 | S3 | Fr | R | P3 | U | 设计保证 | 软件提示 | 杨斌 2021.04 | R164
 |  |  |  | 机械臂未连接 | 机械臂未开启 | S3 | Fr | R | P3 | U | 设计保证 | 软件提示 | 杨斌 2021.04 | R165
10 | 定位失败 | 手术无法继续 | 延误手术进程 | 定位错误后无法恢复 | 定位过程未正常结束无法进行下一次定位 | S3 | Fr | R | P3 | U | 设计保证 | 设置定位重置按钮 | 杨斌 2021.04 | R166
 |  |  |  | 仿真过程中点定位 | 程序指令顺序冲突 | S3 | Fr | R | P3 | U | 设计保证 | 在仿真未结束时禁用定位按钮 | 杨斌 2021.04 | R167
 |  |  |  | 接收定位数据不显示 | 接收到规划数据时未明显提示信息 | S3 | Fr | R | P3 | U | 设计保证 | 接收到规划定位数据时显示通道数据信息 | 杨斌 2021.04 | R168
11 | 无法显示C臂机的X光图像 | 手术无法继续 | 用户体验感差 | 无法接受X光图像 | 网络异常 | S1 | Fr | R | P3 | R | 安全说明 设计保证 | 1.采用稳定的网络设备，并有网络状态显示 2.加强测试 | 杨斌 2021.04 | R169
 |  |  |  |  | C臂机故障 | S1 | Fr | R | P3 | R | 安全说明 | 1.术前检查保证C臂机正常运行 2.规范操作 | 杨斌 2021.04 | R170
12 | 导出数据失败 | 医生使用体验感不佳 | 影响医生判断 | 导出图片过多 | 软件内存不够 | S3 | Fr | R | P3 | U | 设计保证 | 增加内存边界检查 | 杨斌 2021.04 | R171
