santan444/MS001/03-设计开发输出阶段/07风险管理/MS-001故障树分析法（FTA）_规划软件.xlsx

Sheet: Method
操作指南
1，画软件架构框图
2，知晓每个模块的功能（参考软件技术需求说明书）
3，根据功能点，寻找潜在的软件故障（顶层事件）
4，根据软件架构框图，遍历可能导致故障的发生路径，识别、分析路径上的每个软件项（基本事件）
5，分析每个软件项的具体成因
备注：
1，当前只作为软件风险分析工具
2，每一个软件故障，为一棵树

Sheet: Rev
变更履历
版本号 | 发布/实施日期 | 更改内容概述 | 更改者
V1.0 | 2021.07.29 | 文件新编 | 洪洁
V1.1 | 2021.08.03 | 增加风险评估自动公式计算 | 洪洁

Sheet: FTA
 |  |  |  |  | 故障树分析法（FTA）
 | 产品名称： | 模块化手术导引系统-规划软件 |  | 文件号：MS001-A.01.106SM.1.0
 | 产品代号： | MS-001 |  | 版本：V1.0 | 编制： |  |  |  |  | 审核： |  | 批准：
序号 | 软件故障 | 危险情况 | 伤害 | 可能促成危险情况的软件项 | 软件项具体成因 | 伤害严重度S | 危险情况发生的概率Px | 导致伤害的可能性Py | 伤害的总体概率P | 风险水平 | 风险控制选项 | 风险控制措施描述 | 责任人和目标完成日期 | 风险评估控制记录编号
1 | 配准图像偏差较大 | 医生就按当前的配准结果执行下发定位 | 螺钉打偏，导致患者病人伤残 | CT图像不清晰 | 导入的CT层厚过厚 | S3 | Fr | L | P5 | U | 安全说明 | 在说明书中明确CT图像层厚要求 | 高广文 2021.04 | R105
 |  |  |  | CT分区不规范 | 操作不规范 | S3 | Fr | L | P5 | U | 设计保证 | 增加提示条：关于CT分区的操作注意事项 | 高广文 2021.04 | R106
 |  |  |  | X-RAY分区不规范 | 操作不规范 | S3 | Fr | L | P5 | U | 设计保证 | 增加提示条：关于X-RAY分区的操作注意事项 | 高广文 2021.04 | R107
 |  |  |  | CT切割错误 | 操作不规范 | S3 | Fr | L | P5 | U | 设计保证 | 增加复位按钮 | 高广文 2021.04 | R108
 |  |  |  | 自动配准图像偏差较大 | 操作不规范 | S3 | Fr | L | P5 | U | 设计保证 | 增加用户确认配准结果 | 高广文 2021.04 | R109
 |  |  |  |  | 接收到的x光图像有干扰 | S3 | Fr | L | P5 | U | 设计保证 | 增加X光图像去除小球、滤波等功能 | 高广文 2021.04 | R110
 |  |  |  |  | 自动配准效果不佳 | S3 | Fr | L | P5 | U | 设计保证 | 增加用户手动微调 | 高广文 2021.04 | R111
 |  |  |  |  | 接收到的X光图像方向错误 | S3 | Fr | L | P5 | U | 设计保证 | 软件提供X光图像上下翻转和左右翻转功能 | 高广文 2021.04 | R112
2 | 导入数据失败 | 医生无法继续手术 | 延误手术进程 | 数据无法读取 | u盘传输错误 | S3 | Fr | R | P3 | U | 设计保证 | 软件提示 | 高广文 2021.04 | R113
 |  |  |  |  | 导入路径过长 | S3 | Fr | R | P3 | U | 设计保证 | 软件提示 | 高广文 2021.04 | R114
 |  |  |  |  | CT数据异常 | S3 | Fr | R | P3 | U | 设计保证 | 软件提示 | 高广文 2021.04 | R115
 |  |  |  | 导入数据存储本地失败 | CT缓存硬盘空间不足 | S3 | Fr | R | P3 | U | 设计保证 | 软件提示 | 高广文 2021.04 | R116
 |  |  |  | CT重复导入 | 导入相同CT后会覆盖之前的CT数据 | S3 | Fr | R | P3 | U | 设计保证 | 重复导入之后软件会新建CT存放路径 | 高广文 2021.04 | R117
 |  |  |  | 多序列CT导致软件崩溃 | 未对多序列CT数据进行区分 | S3 | Fr | R | P3 | U | 设计保证 | 多序列CT导入时生成多序列列表可供选择 | 高广文 2021.04 | R118
3 | 软件运行过程中闪退 | 需要重启设备 | 延误手术进程 | 存储IO错误 | 内存和硬盘不稳定 | S3 | Fr | R | P3 | U | 设计保证 | 重启后可以继续操作 | 高广文 2021.04 | R119
 |  |  |  | 操作系统错误 | 操作系统自有缺陷 | S3 | Fr | R | P3 | U | 设计保证 | 重启后可以继续操作 | 高广文 2021.04 | R120
4 | 运行数据异常 | 需要重启设备 | 延误手术进程 | 数据丢失 | 数据未保存或备份 | S3 | Fr | R | P3 | U | 设计保证 | 软件关键数据自动保存和备份 | 高广文 2021.04 | R121
 |  |  |  | 数据错误 | 数据损坏 | S3 | Fr | R | P3 | U | 设计保证 | 软件提示 | 高广文 2021.04 | R122
 |  |  |  | 不同模块数据不同步 | 数据未更新到其他模块 | S3 | Fr | R | P3 | U | 设计保证 | 不同模块相关数据共享 | 高广文 2021.04 | R123
5 | 软件设置参数错误 | 需要重启设备 | 延误手术进程 | step | step设置错误 | S3 | Fr | R | P3 | U | 设计保证 | 增加权限控制，非相关人员无法修改设置 | 高广文 2021.04 | R124
 |  |  |  | ip | ip设置错误 | S3 | Fr | R | P3 | U | 设计保证 | 增加权限控制，非相关人员无法修改设置 | 高广文 2021.04 | R125
 |  |  |  | 阈值 | 阈值设置错误 | S3 | Fr | R | P3 | U | 设计保证 | 增加权限控制，非相关人员无法修改设置 | 高广文 2021.04 | R126
 |  |  |  | CT显示不清晰 | 窗宽窗位参数调整后无法重置 | S3 | Fr | R | P3 | U | 设计保证 | 设置窗宽窗位重置按钮 | 高广文 2021.04 | R127
6 | 软件运行卡顿 | 医生使用体验感不佳 | 影响医生判断 | 部分功能运行时间太久 | 部分功能在主进程中占用太多时间 | S1 | Fr | R | P3 | R | 设计保证 | 软件开启多线程运行计算 | 高广文 2021.04 | R128
 |  |  |  | CT操作交互卡顿 | CT交互渲染时间太长 | S1 | Fr | R | P3 | R | 设计保证 | 软件利用GPU对渲染进行加速 | 高广文 2021.04 | R129
 |  |  |  | 进度条显示卡顿 | 进度条运行中执行其他操作 | S1 | Fr | R | P3 | R | 设计保证 | 进度条设置置顶 | 高广文 2021.04 | R130
 |  |  |  | 用户可以启动软件多个实例 | 软件未单实例运行 | S1 | Fr | R | P3 | R | 设计保证 | 软件设置单实例运行程序 | 高广文 2021.04 | R131
7 | 数据库异常 | 医生无法继续手术 | 延误手术进程 | 账户无法登陆 | 账户数据库被篡改 | S3 | Fr | R | P3 | U | 设计保证 | 增加账户数据库crc校验 | 高广文 2021.04 | R132
8 | 规划螺钉数据异常 | 医生无法继续手术 | 延误手术进程 | 螺钉数量过多软件卡顿 | 内存不够 | S3 | Fr | R | P3 | U | 设计保证 | 限定螺钉数量 | 高广文 2021.04 | R133
 |  |  |  | 螺钉颜色不清楚 | 螺钉默认颜色单一 | S3 | Fr | R | P3 | U | 设计保证 | 自定义螺钉颜色 | 高广文 2021.04 | R134
 |  |  |  | 螺钉长度过长 | 未设置螺钉长度范围 | S3 | Fr | R | P3 | U | 设计保证 | 螺钉限定最大长度最小长度 | 高广文 2021.04 | R135
 |  |  |  | 螺钉直径不匹配 | 螺钉直径固定 | S3 | Fr | R | P3 | U | 设计保证 | 螺钉直径 | 高广文 2021.04 | R136
 |  |  |  | 螺钉序号显示错误 | 规划后修改螺钉所属椎体导致螺钉位置混乱 | S3 | Fr | R | P3 | U | 设计保证 | 规划后修改螺钉所属椎体会同步 | 高广文 2021.04 | R137
9 | 导出数据失败 | 医生使用体验感不佳 | 影响医生判断 | 导出数据中断 | 导出数据中拔出U盘 | S1 | Fr | R | P3 | R | 设计保证 | 软件提示 | 高广文 2021.04 | R138
10 | 相邻分椎有重叠 | 医生无法继续手术 | 延误手术进程 | 相邻分椎线交叉重叠 | 分椎线未划定移动范围 | S3 | Fr | R | P3 | U | 设计保证 | 限定分椎线范围 | 高广文 2021.04 | R139
