santan444/MS001/03-设计开发输出阶段/07风险管理/MS-001生产过程失效模式与效应分析（PFMEA）.xlsx

Sheet: Rev
变更履历
版本号 | 发布/实施日期 | 更改内容概述 | 更改者
V1.0 | 2021.08.03 | 文件新编 | 洪洁

Sheet: FMEA
 |  |  |  |  | MS-001生产过程失效模式与效应分析（P-FMEA）
 | 产品名称： |  |  |  | 文件号： |  |  |  |  |  |  |  | 编制人： | 马文豪
 | 产品代号： | MS-001 |  |  | 版本： |  |  |  |  |  |  |  | 批准：
 | 项目类型： |  |  |  | 设计责任： |  |  |  |  |  |  |  | 修订日期：
序号 | 过程步骤/描述 | 过程步骤的功能 | 潜在失效模式 | 潜在失效的后果 | 局部影响 | SEV | 最终影响 | SEV | 失效模式发生的原因/机理 | OCC | 当前控制方法 | DET | RPN | 建议采取的行动 | 责任人和目标完成日期 | 风险评估控制记录编号
1 | 采购 | 原材料 | B升降立柱不能升降、突然掉落 | 1、无法移动设备 2、如果在移动或维修设备时损坏可能造成人员受伤 |  |  |  |  | 电机/丝杆损坏 |  | 做好选型验证工作 |  | 0 |  |  |  | *1
 |  |  | B脚轮破损、刹车失效 | 1、无法移动设备 2、如果在移动或维修设备时损坏可能造成人员受伤 |  |  |  |  | 结构损坏/卡死 |  | 做好选型验证工作 |  |  |  |  |  | 如果对病人、用户的安全影响是清楚的，则记录相应的严重度等级。
 |  |  | B脚杯弯折 | 设备不能正常使用 |  |  |  |  | 运输搬运过程中弯折 |  | 1、做好选型验证工作 2、运输搬运过程中考虑脚杯受力情况
 |  |  | 电脑硬件不能满足软件运行条件，硬件松动 | 1、运行卡顿 2、无法使用 |  |  |  |  | 1、硬件选型不合理 2、厂家软件、系统、驱动问题 |  | 1、确认硬件要求，购买正规渠道产品 2、确认系统版本or确保软件通用性 3、确认网卡，驱动，确保网络可用 4、显示异常，检查显卡 |  |  |  |  |  | 非病人、用户安全相关的失效则记录为非相关"N"。
 |  |  | 机械臂/主控箱损伤、程序异常 | 影响使用 |  |  |  |  | 1、厂家/经销商出错 2、运输过程损伤 |  | 进料检 |  |  |  |  |  | 对病人、用户的安全影响不清楚时，应记录为"待定"并由更高一级的FMEA最终确定其是否对病人、用户构成安全影响，而不是记录为"空格"或"非安全相关影响"。
 |  |  | 包装材料损伤、发霉，漏印标识 | 影响包装 |  |  |  |  | 1、材料性能不满足要求 2、运输过程损伤 3、存储环境不满足要求 |  | 进料检，做好防护工作
 |  |  | 采购零部件速度慢、质量差 | 影响整机质量、交期 |  |  |  |  | 原材料本身性能 |  | 1、确认供应商，采购交期长的关键部件要考虑可替代性、备货 2、进料检 |  |  |  |  |  | *2
2 | 外壳加工 | 产品外观 | 外观缺陷、无法安装 | 1、表面色差、外观缺陷 2、孔位错误，牙套安装不牢，影响安装 3、拆件不合理，胶水失效，外壳破损 |  |  |  |  | 1、供应商加工水平不行 2、运输过程损伤 |  | 1、确认供应商加工水平 2、明确工艺要求 3、做好入厂检验
3 | 加工 | 产品结构 | 加工件孔位、尺寸不对，螺纹孔没攻牙/没安装牙套 表面有油污、生锈、划伤，表面处理不合格 | 1、影响安装 2、影响外观 |  |  |  |  | 1、结构不合理/图纸错误 2、供应商加工水平不行 3、运输过程损伤 |  | 1、加工图受控 2、确认好加工图纸版本号及加工要求 3、确认供应商加工水平，做好沟通工作 4、现阶段加工件全检
 |  |  | 焊接框架尺寸不标准 | 1、脚轮不能全部着地，设备晃动 2、各层底板不平行，设备不稳定 3、孔位错误，影响安装 |  |  |  |  | 1、焊接件尺寸不容易控制 2、B框架承重较大 |  | 1、受力分析 2、检验工装
 |  |  | 钣金件变形，孔位、尺寸错误，影响安装 | 影响安装 |  |  |  |  | 1、设计尺寸错误 2、加工错误 3、配件变更 |  | 钣金件与配件配合检验
 |  |  | D通道变形 | 影响安装使用 |  |  |  |  | 焊接件尺寸不容易控制 |  | 入厂检
 |  |  | PCB板加工错误 | 不可用 |  |  |  |  | 1、设计不合理/版本错误 2、供应商加工水平不行 |  | 1、PCB板文件受控备份 2、丝印文件上添加版本要求 3、确认PCB板外观、功能、主要性能、老化测试
4 | 组装 | 组装产品 | 接线不劳，接错线，金属异物 | 烧坏电路、设备着火及人员触电伤亡 |  |  |  |  | 1、接线不劳 2、接错线 3、配电箱有金属异物 |  | 1、制定接线标准 2、检查线路通断情况 3、测试相关功能是否准确、完善 4、寻找外包厂商 |  |  |  |  |  | RPN值不高的时候，如果失效模式的影响、后果的严重度非常高，也应当采取补救措施。
 |  |  | 电路板调试、烧录文件错误 | 无法使用/使用体验不佳 |  |  |  |  | 软件程序有误/版本不对 |  | 1、文件受控归档 2、测试验证
 |  |  | 线槽盖板容易掉落 | 设备搬运有异响 |  |  |  |  | 线槽变形 |  | 竖直或斜装线槽需防护
 |  |  | 螺钉没拧紧，少拧螺钉 | 影响设备稳定性 |  |  |  |  | 操作失误 |  | 生产检验记录表
 |  |  | 掰断外壳卡扣 | 外壳固定不牢 |  |  |  |  | 1、操作失误 2、结构拆装不便 |  | 做好前期确认工作，减少拆装次数
 |  |  | A主机固定不牢 | 设备搬运有异响 |  |  |  |  | 结构不合理 |  | 修改固定钣金
 |  |  | 激光定位杆晃动 | 影响医生对病人体位的判断 |  |  |  |  | 1、结构不合理 2、安装不牢 |  | 修改固定结构
 |  |  | D激光衍射片裁切不好，划伤 | 激光衍射不能满足使用要求 |  |  |  |  | 切割打磨过程损伤 |  | 1、生产自检 2、质量检验
 |  |  | D 三坐标标定数据错误，tcp松动 | 影响调试及产品精度 |  |  |  |  | 1、安装不牢 2、标定错误 3、数据转化错误 4、运输过程损伤 |  | 1、确认tcp标定文档 2、刻钢印，做好数据对应表，验证标定数据 3、确认tcp配合精度
5 | 调试 | 调试设备功能 | 软件弄错版本、漏装驱动 | 无法使用/使用体验不佳 |  |  |  |  | 软件程序有误/版本不对 |  | 1、软件受控归档 2、填写记录 3、测试确认功能、性能
 |  |  | tcp标定数据错误 | 影响设备精度 |  |  |  |  | 操作不当 |  | 1、做好人员培训 2、记录
6 | 测试 | 测试设备功能 | 外观损伤 | 搬运磕伤 |  |  |  |  | 操作不当 |  | 包装前确认外观、洁净度
 |  |  | 功能缺失，漏测功能 | 设备功能异常，影响使用 |  |  |  |  | 操作不当 |  | 生产检验记录表
 |  |  | 主要性能不满足要求 | 设备不能正常使用 |  |  |  |  | 1、操作不当 2、软件问题 |  | 重新调试
 |  |  | 影像匹配反应慢、匹配错误 | 设备不能正常使用 |  |  |  |  | 1、操作不当 2、软件问题 |  | 做好软件设计及测试
 |  |  | 精度不满足要求 | 设备不能正常使用 |  |  |  |  | 1、调试工作没做好 2、设备重复定位精度不好 |  | 1、重复调试直到满足要求 2、精度记录表 3、检验记录表
7 | 包装 | 包装产品 | 台车搬运固定磕伤 | 设备损伤 |  |  |  |  | 1、结构不合理，磕碰 2、操作不当 |  | 1、包装结构稳固、合理 2、包装防护
 |  |  | 缺少标识，标识信息错误 | 缺少标识 |  |  |  |  | 操作不当 |  | 1、标签留样 2、检验记录表 3、质量检验
 |  |  | 缺少配件 | 无法使用 |  |  |  |  | 操作失误 |  | 装箱清单
8 | 运输 | 运输产品 | 振动导致部件松动 | 产品可靠性下降，在特定条件下不能正常工作 |  |  |  |  | 1、固定方式不牢 2、前期没做好运输振动测试 |  | 1、螺钉防松 2、接头打胶固定 3、前期运输振动测试
 |  |  | 电子元件受潮 | 产品可靠性下降，在特定条件下不能正常工作 |  |  |  |  | 运输环境影响 |  | 防潮包装
 |  |  | 产品配件磕碰 | 产品可靠性下降，在特定条件下不能正常工作 |  |  |  |  | 包装设计不合理 |  | 包装防护
9 | 现场 安装/使用/维护 | 安装使用维护 | 现场安装异常 | 无法使用 |  |  |  |  | 1、运输损伤 2、人员培训不足 |  | 1、简化安装操作 2、安装培训
 |  |  | 维修不便 | 小故障可能需要完全拆卸才能解决 |  |  |  |  | 结构设计不合理 |  | 1、结构合理设计 2、布线整齐，做好标识 3、留有检修口
 |  |  | 影像匹配反应慢、匹配错误 | 无法使用，甚至损害人体 |  |  |  |  | 设备异常 |  | 1、做好软件设计及测试 2、现场相关人员技能培训
 |  |  | 机械臂失控 | 撞伤 |  |  |  |  | 设备异常 |  | 1、做好程序验证测试工作 2、不随意更改机械臂程序及安装设置
 |  |  | 按键失效 | 不能正常操作设备 |  |  |  |  | 线路异常
 |  |  | 1、松开脚踏机械臂不能正常运行 2、松开脚踏机械臂不能正常停止 | 1、不能正常使用设备 2、撞伤 |  |  |  |  | 1、线路异常 2、程序异常 |  | 1、机械臂异常处理程序 2、做好调试测试工作
 |  |  | 信号干扰/干扰其他设备 | 导致本机or医院其他设备功能失效 |  |  |  |  | 设计考虑不够全面 |  | 外壳喷金属漆屏蔽
 |  |  | 网络安全 | 功能异常，数据丢失，信息泄露 |  |  |  |  | 感染病毒

Sheet: 附录A
评分标准
SEV 局部影响严重程度 |  | SEV 最终影响严重程度
标准 | 评分 | 标准 | 评分
产品不影响使用的瑕疵，功能报废率0.1% | 1 | 用户/病人通常不会发现并对其没有影响 | 1
产品不影响使用的瑕疵，功能报废率0.3% | 2 | 较细心能察觉的外观等产品瑕疵 | 2
产品次要功能损失，功能报废率0.3% | 3 | 用户容易发现并不乐于接受，不影响使用 | 3
产品次要功能损失，功能报废率1% | 4 | 使用不方便，增加用户负担 | 4
产品次要功能损失，可靠性降低但在规格内，功能报废率1% | 5 | 产品还能用，但性能没达到预期 | 5
产品次要严重功能损失，可靠性降低，功能报废率1% | 6 | 对病人/用户健康没有损害，但产品丧失功能 | 6
产品主要功能部分损失，功能报废率1% | 7 | 产品缺陷会导致病人/用户健康损害 | 7
产品主要功能部分损失，功能报废率3% | 8 | 产品缺陷会导致病人/用户严重健康损害 | 8
产品主要功能丧失，功能报废率10% | 9 | 产品缺陷会导致病人/用户生命危险或不可逆转的健康损害 | 9
产品主要功能和次要功能完全丧失，功能报废率10% | 10 | 产品缺陷会导致病人/用户死亡 | 10

Sheet: 附录B
评分标准
OCC（发生几率） |  | DET（失效模式的可察觉性）
标准 | 评分 | 标准 | 评分
<10ppm | 1 | 发生了必然被察觉 | 1
<100ppm | 2 | 一检查就能发现 | 2
<500ppm | 3 | 较多的检查才能发现 | 3
<1000ppm | 4 | 能被发现，检测方法可靠 | 4
<2500ppm | 5 | 可能被发现，检测方法可靠 | 5
<5000ppm | 6 | 可能被发现，检测方法相对可靠 | 6
<10000ppm | 7 | 难被肯定地发现，即使检测方法可靠 | 7
<25000ppm | 8 | 难被肯定地发现，即使检测方法相对可靠 | 8
<50000ppm | 9 | 很难被发现 | 9
<100000ppm | 10 | 似乎不可能察觉的到 | 10
