santan444/MS001/03-设计开发输出阶段/07风险管理/MS-001设计失效模式与效应分析（D-FMEA）_机械.xlsx

Sheet: Rev
变更履历
版本号 | 发布/实施日期 | 更改内容概述 | 更改者
V1.0 | 2021.07.05 | 文件新编 | 洪洁
V1.1 | 2021.07.28 | 修改SEV | 洪洁

Sheet: FMEA
 |  |  |  | MS-001设计失效模式与效应分析（D-FMEA）_机械
 | 产品名称： | 模块化手术导引系统 |  | 文件号： | MS001.01.104SM.1.0
 | 产品代号： | MS-001 |  | 版本： | V1.0 |  | 编制/日期： |  |  | 审核/日期： |  |  | 批准/日期：
序号 | 子系统/零部件 | 潜在失效模式 | 潜在失效的后果 | 局部影响 | SEV | 最终影响 | SEV | 失效模式发生的原因/机理 | OCC | 现行设计控制预防 | 现行设计控制探测方法 | DET | RPN | 建议采取的行动 | 责任人和目标完成日期 | 风险评估控制记录编号
1 | MS-001-A/脚轮 | 刹车失效 | 无法固定在地面 | 在停放时，受到外力作用，台车会移动 | 1 | 操作者使用不便 | 3 | 脚轮过载，刹车强度不够 | 4 | 1，脚轮选型时，考虑负载留有余量；选择优质品牌产品 | 设计选型 | 6 | 72 | 无 | 沈杭 2021.04 | R52
2 | MS-001-A/显示器安装固定支架 | 无法限位 | 转动角度加大 | 显示器往一边偏的较多 | 2 | 操作有一定影响，但没有伤害 | 2 | 磨损 | 2 | 选型确认 | 设计评审 | 4 | 16 | 无 | 沈杭 2021.04 | R53
 |  | 断裂 | 显示器无法固定 | 无法操作 | 7 | 产品不能使用，但对病人和使用者无直接伤害 | 6 | 过载及磨损 | 1 | 选型确认 | 设计评审 | 1 | 7 | 无 | 沈杭 2021.04 | R54
 |  | 松动 | 显示器不稳固 | 操作时可能晃动 | 2 | 操作者不便 | 4 | 磨损 | 4 | 选型确认 | 设计评审 | 3 | 48 | 无 | 沈杭 2021.04 | R55
3 | MS-001-A/焊接框架 | 焊缝开裂 | 设备异响，结构不稳定 | 产品形态无法保持 | 6 | 产品不能正常使用 | 6 | 焊接虚焊或漏焊 | 1 | 设计时对焊缝有明确要求 | 设计评审 | 2 | 12 | 无 | 沈杭 2021.04 | R56
 |  | 框架变形 | 台车转运过程中会晃动 | 产品形态无法保持 | 6 | 产品不能正常使用 | 3 | 结构刚性不够 | 2 | 受力分析 | 设计评审 | 5 | 60 | 无 | 沈杭 2021.04 | R57
4 | MS-001-A/外壳 | 撞击破损 | 影响外观 | 外观破损影响视觉观感，同时影响到对内部设备的防护 | 2 | 对使用者和病人无直接影响 | 3 | 外壳强度不够，在突发外力作用下受损 | 4 | 1. 设计考虑材料的强度、韧性及厚度 2. 考虑拆件工艺 | 设计评审 | 2 | 24 | 无 | 沈杭 2021.04 | R58
5 | MS-001-A/工作台旋转组件 | 卡涩 | 旋转阻力加大 | 操作时不方便调整工作台方向 | 2 | 无伤害，但使用体验较差 | 3 | 磨损、润滑失效 | 2 | 选型确认 | 设计选型 | 3 | 18 | 无 | 沈杭 2021.04 | R59
6 | MS-001-A/侧面板 | 插头脱落 | 设备断电 | 功能无法操作 | 7 | 对病人/用户健康没有损害，但产品丧失功能 | 6 | 没有防护措施 | 8 | 1. 增加防脱落卡扣 | 设计评审 | 1 | 56 | 无 | 沈杭 2021.04 | R60
7 | MS-001-A/主控面板 | 撞击破损 | 影响外观 | 外观破损影响视觉观感，同时影响到对内部设备的防护 | 2 | 对使用者和病人无直接影响 | 3 | 外壳强度不够，在突发外力作用下受损 | 3 | 1. 设计考虑材料的强度、韧性及厚度，塑料外壳手板考虑拆件工艺 | 设计评审 | 1 | 9 | 无 | 沈杭 2021.04 | R61
8 | MS-001-B/脚轮 | 刹车失效 | 无法固定在地面 | 在停放时，受到外力作用，台车会移动 | 1 | 对手术过程完全没有影响 | 2 | 脚轮过载，刹车强度不够 | 7 | 1，脚轮选型时，考虑负载留有余量，选择优质品牌产品 | 设计选型 | 6 | 84 | 无 | 颜廷威 2021.04 | R62
 |  | 脚轮卡涩异响 | 影响设备移动 | 对操作者在移动设备时带来一定的阻碍 | 3 | 对手术过程完全没有影响 | 3 | 脚轮过载 | 5 | 设计时考虑减轻整机的重量，提高脚轮的安全系数 | 设计选型 | 1 | 15 | 无 | 颜廷威 2021.04 | R63
9 | MS-001-B/脚杯 | 变形 | 设备倾斜 | 定位不准 | 8 | 产品缺陷会导致病人/用户健康损害 | 7 | 脚杯过载，强度不够 | 4 | 选型确认，设计留有余量 | 设计评审 | 1 | 28 | 无 | 颜廷威 2021.04 | R64
10 | MS-001-B/焊接框架 | 焊缝开裂 | 设备异响，结构不稳定 | 产品形态无法保持 | 6 | 产品不能正常使用 | 6 | 焊接虚焊或漏焊 | 1 | 设计时对焊缝有明确要求 | 设计评审 | 2 | 12 | 无 | 颜廷威 2021.04 | R65
 |  | 框架变形 | 台车转运过程中会晃动 | 产品形态无法保持 | 6 | 产品不能正常使用 | 3 | 结构刚性不够 | 2 | 受力分析 | 设计评审 | 5 | 60 | 无 | 颜廷威 2021.04 | R66
11 | MS-001-A/显示器安装固定支架 | 断裂 | 显示器无法固定 | 无法操作 | 7 | 产品不能使用，但对病人和使用者无直接伤害 | 6 | 过载及磨损 | 1 | 选型确认 | 设计评审 | 1 | 7 | 无 | 沈杭 2021.04 | R67
 |  | 松动 | 显示器不稳固 | 操作时可能晃动 | 2 | 操作者不便 | 4 | 磨损 | 4 | 选型确认 | 设计评审 | 3 | 48 | 无 | 沈杭 2021.04 | R68
 |  | 无法限位 | 转动角度加大 | 显示器往一边偏的较多 | 2 | 操作有一定影响，但没有伤害 | 2 | 磨损 | 2 | 选型确认 | 设计评审 | 4 | 16 | 无 | 沈杭 2021.04 | R69
12 | MS-001-B/工作台旋转组件 | 卡涩 | 旋转阻力加大 | 操作时不方便调整工作台方向 | 2 | 无伤害，但使用体验较差 | 3 | 磨损、润滑失效 | 2 | 选型确认 | 设计选型 | 3 | 18 | 无 | 颜廷威 2021.04 | R70
13 | MS-001-B/外壳 | 撞击破损 | 影响外观 | 外观破损影响视觉观感，同时影响到对内部设备的防护 | 2 | 对使用者和病人无直接影响 | 3 | 外壳强度不够，在突发外力作用下受损 | 4 | 1. 设计考虑材料的强度、韧性及厚度 2. 考虑拆件工艺 | 设计评审 | 2 | 24 | 无 | 颜廷威 2021.04 | R71
14 | MS-001-B/侧面板 | 插头脱落 | 设备断电 | 功能无法操作 | 7 | 对病人/用户健康没有损害，但产品丧失功能 | 6 | 没有防护措施 | 8 | 1. 增加防脱落卡扣 | 设计选型 | 1 | 56 | 无 | 颜廷威 2021.04 | R72
15 | MS-001-B/激光定位杆 | 晃动 | 激光点不稳 | 影响医生对体位的判断 | 6 | 螺钉可能定位不准 | 7 | 1.固定有间隙； 2.刚性不够； | 7 | 1.采用无活动式设计； 2.采用铝合金材质，采用合适的壁厚； | 设计评审 | 6 | 294 | 无 | 熊义均 2021.04 | R73
16 | MS-001-B/主控面板 | 撞击破损 | 影响外观 | 外观破损影响视觉观感，同时影响到对内部设备的防护 | 2 | 对使用者和病人无直接影响 | 3 | 外壳强度不够，在突发外力作用下受损 | 3 | 1. 设计考虑材料的强度、韧性及厚度，塑料外壳手板考虑拆件工艺 | 设计评审 | 1 | 9 | 无 | 颜廷威 2021.04 | R74
17 | MS-001-C/转接法兰 | 磨损 | 影响TCP | 定位不准 | 8 | 产品缺陷会导致病人/用户健康损害 | 7 | 耐磨度不够 | 5 | 消耗品，限定使用次数 | 测试 | 5 | 200 | 无 | 颜廷威 2021.04 | R75
18 | MS-001-C/手术定位器 | 连接不稳固 | 意外脱落 | 无法定位 | 7 | 砸到患者 | 7 | 拖动时误触锁定开关 | 7 | 增加止锁按键 | 设计评审 | 1 | 49 | 无 | 颜廷威 2021.04 | R76
19 | MS-001-C/配准板 | 变形 | 影响配准结果 | 定位不准 | 8 | 产品缺陷会导致病人/用户健康损害 | 7 | 1.结构刚性不够； 2.不耐高温； | 7 | 改成低温等离子； | 设计评审 | 4 | 224 | 无 | 熊义均 2021.04 | R77
20 | MS-001-C/套筒 | 磨损 | 增加导针晃动间隙 | 定位不准 | 8 | 产品缺陷会导致病人/用户健康损害 | 7 | 耐磨度不够 | 5 | 消耗品，限定使用次数 | 测试 | 2 | 80 | 无 | 熊义均 2021.04 | R78

Sheet: 附录A
评分标准
SEV 局部影响严重程度 |  | SEV 最终影响严重程度
标准 | 评分 | 标准 | 评分
产品不影响使用的瑕疵，功能报废率0.1% | 1 | 用户/病人通常不会发现并对其没有影响 | 1
产品不影响使用的瑕疵，功能报废率0.3% | 2 | 较细心能察觉的外观等产品瑕疵 | 2
产品次要功能损失，功能报废率0.3% | 3 | 用户容易发现并不乐于接受，不影响使用 | 3
产品次要功能损失，功能报废率1% | 4 | 使用不方便，增加用户负担 | 4
产品次要功能损失，可靠性降低但在规格内，功能报废率1% | 5 | 产品还能用，但性能没达到预期 | 5
产品次要严重功能损失，可靠性降低，功能报废率1% | 6 | 对病人/用户健康没有损害，但产品丧失功能 | 6
产品主要功能部分损失，功能报废率1% | 7 | 产品缺陷会导致病人/用户健康损害 | 7
产品主要功能部分损失，功能报废率3% | 8 | 产品缺陷会导致病人/用户严重健康损害 | 8
产品主要功能丧失，功能报废率10% | 9 | 产品缺陷会导致病人/用户生命危险或不可逆转的健康损害 | 9
产品主要功能和次要功能完全丧失，功能报废率10% | 10 | 产品缺陷会导致病人/用户死亡 | 10

Sheet: 附录B
评分标准
OCC（发生几率） |  | DET（失效模式的可察觉性）
标准 | 评分 | 标准 | 评分
<10ppm | 1 | 发生了必然被察觉 | 1
<100ppm | 2 | 一检查就能发现 | 2
<500ppm | 3 | 较多的检查才能发现 | 3
<1000ppm | 4 | 能被发现，检测方法可靠 | 4
<2500ppm | 5 | 可能被发现，检测方法可靠 | 5
<5000ppm | 6 | 可能被发现，检测方法相对可靠 | 6
<10000ppm | 7 | 难被肯定地发现，即使检测方法可靠 | 7
<25000ppm | 8 | 难被肯定地发现，即使检测方法相对可靠 | 8
<50000ppm | 9 | 很难被发现 | 9
<100000ppm | 10 | 似乎不可能察觉的到 | 10
