santan444/MS001/03-设计开发输出阶段/04结构/02包装及标签/MS001.01.010BQ.1.0 MS-001标签.pdf

## 导 引 模 块

## 模块化 手 术 导 引 系 统

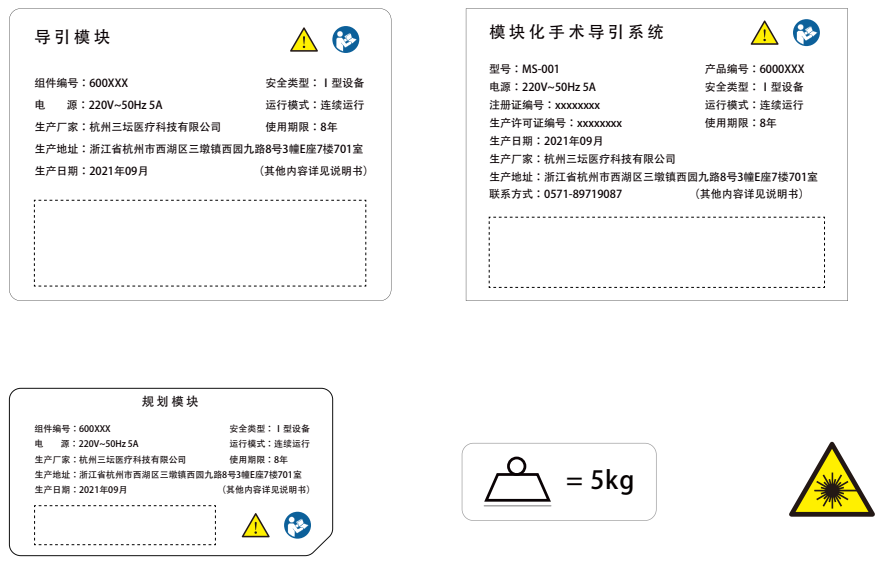
[picture p407: page 1]
组件编号：600XXX; 生产厂家：杭州三坛医疗科技有限公司 生产地址：浙江省杭州市西湖区三墩镇西园九路8号3幢E座7楼701室; 生产日期：2021年09月; （其他内容详见说明书）; 安全类型：Ⅰ型设备 运行模式：连续运行 使用期限：8年; 生产厂家：杭州三坛医疗科技有限公司; 生产地址：浙江省杭州市西湖区三墩镇西园九路8号3幢E座7楼701室; 安全类型：Ⅰ型设备; 运行模式：连续运行; 使用期限：8年; 型号：MS-001 电源：220V~50Hz 5A 注册证编号：xxxxxxxx 生产许可证编号：xxxxxxxx 生产日期：2021年09月 生产厂家：杭州三坛医疗科技有限公司 生产地址：浙江省杭州市西湖区三墩镇西园九路8号3幢E座7楼701室; 联系方式：0571-89719087; 产品编号：6000XXX 安全类型：Ⅰ型设备 运行模式：连续运行 使用期限：8年
