santan444/MS001/03-设计开发输出阶段/04结构/04结构图/MS001.01.001ZZ.1.1 模块化手术导引系统.PDF

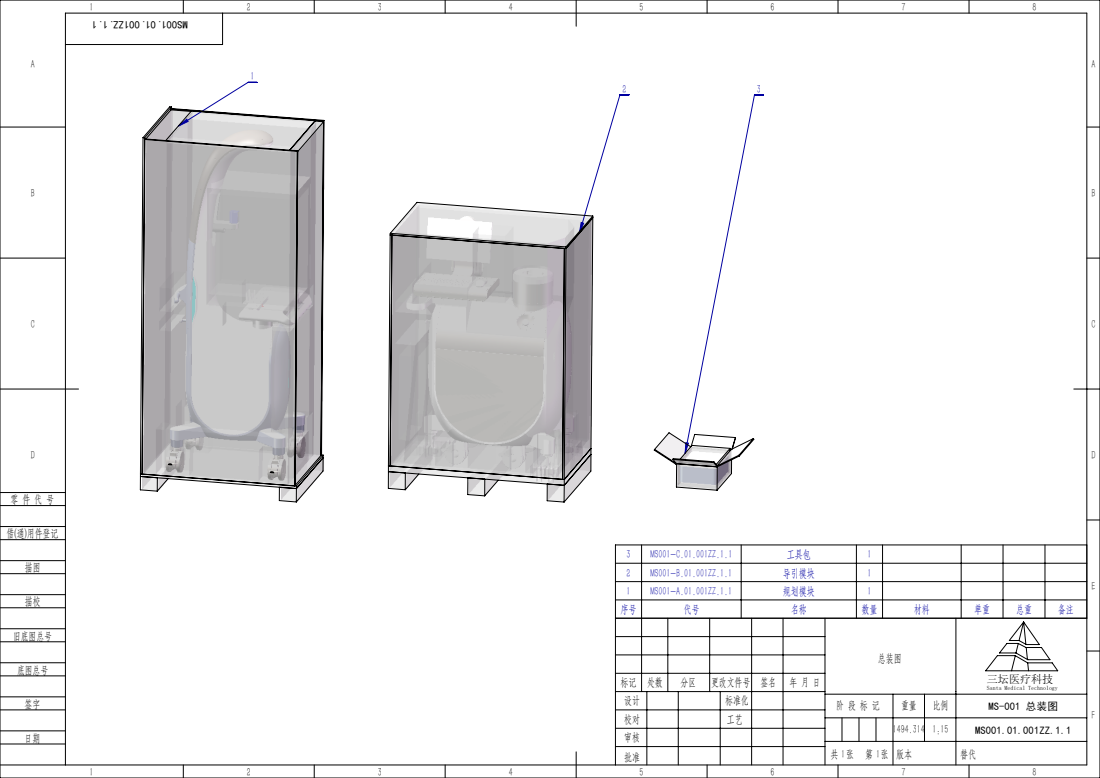
[picture p408: page 1]
更改文件号

3 | MS001-C.01.001ZZ.1.1 | 工具包 | 1
2 | MS001-B.01.001ZZ.1.1 | 导引模块 | 1
1 | MS001-A.01.001ZZ.1.1 | 规划模块 | 1
序号 | 代号 | 名称 | 数量 | 材料 | 单重 | 总重 | 备注

总装图 | 三坛医疗科技 Santa Medical Technology

阶 段 标 记 | 重量 | 比例 | MS-001 总装图
