santan444/MS001/03-设计开发输出阶段/04结构/04结构图/MS001.01.006HZ.1.1 MS-001合格证.pdf

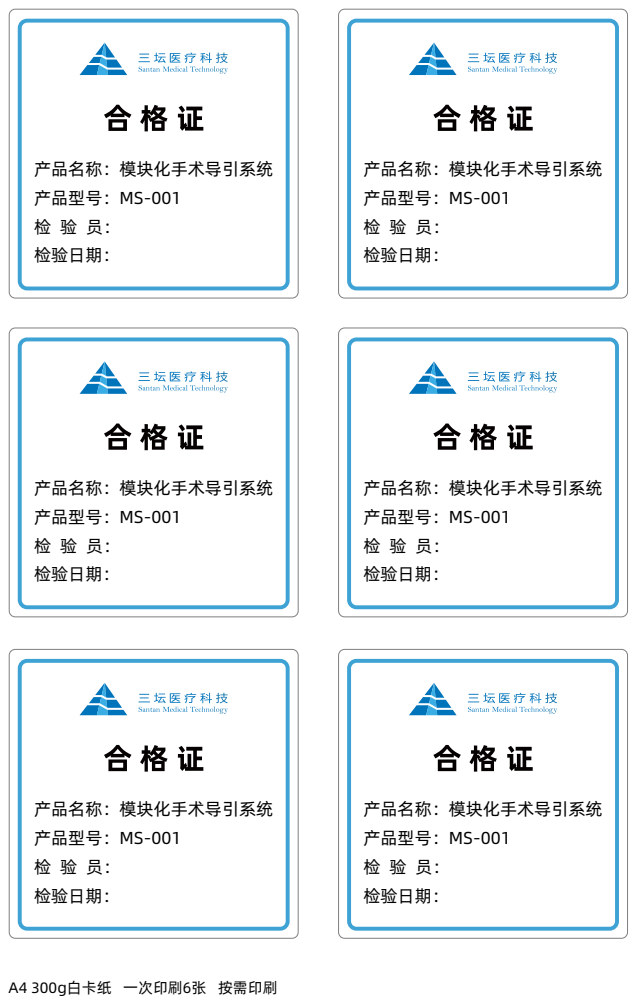
[picture p409: page 1]
产品名称：模块化手术导引系统 产品型号：MS-001 检 验 员： 检验日期：; A4 300g白卡纸 一次印刷6张 按需印刷
