santan444/MS001/03-设计开发输出阶段/04结构/05工艺装备/MS-001系统精度检测工装/MS001.05.001ZZ.1.1 整机精度检测工装.PDF

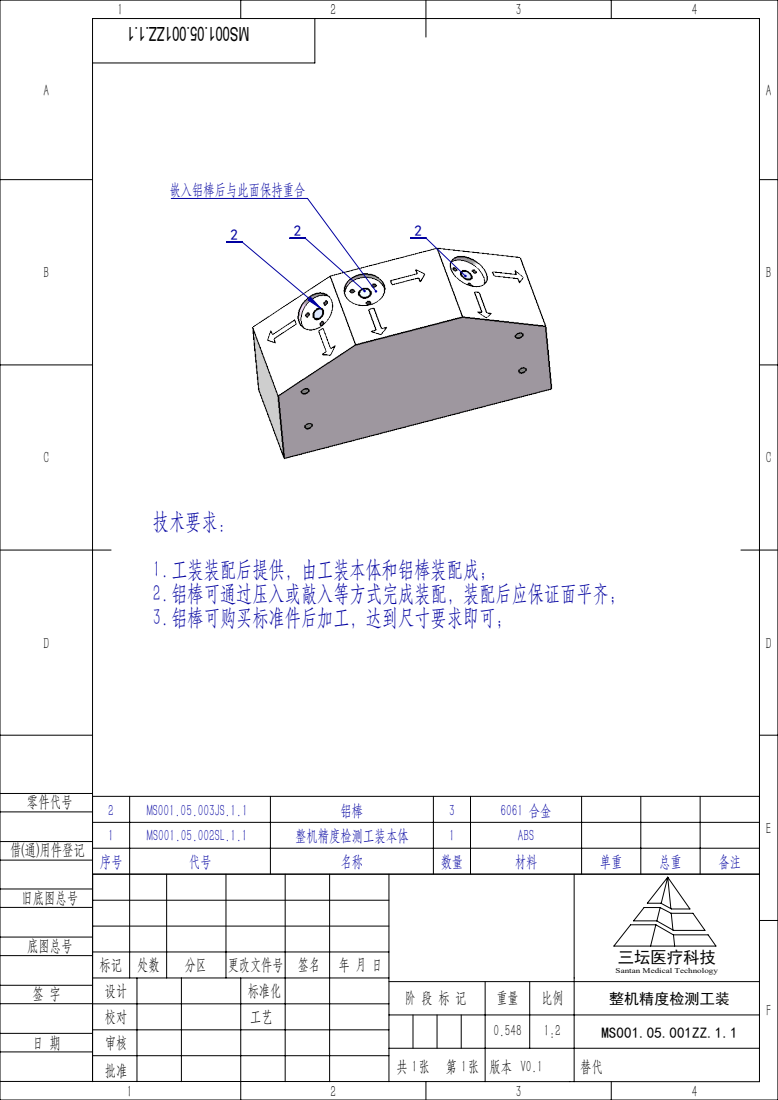
[picture p410: page 1]

1 | MS001.05.002SL.1.1 | 整机精度检测工装本体 | 1 | ABS
序号 | 代号 | 名称 | 数量 | 材料 | 单重 | 总重 | 备注

三坛医疗科技 Santan Medical Technology

标记 | 处数 | 分区 | 更改文件号 | 签名 | 年 月 日
设计 | | | 标准化
校对 | | | 工艺
审核
批准

阶 段 标 记 | 重量 | 比例 | 整机精度检测工装
