santan444/MS001/03-设计开发输出阶段/04结构/05工艺装备/MS-001系统精度检测工装/MS001.05.002SL.1.1 整机精度检测工装本体.PDF

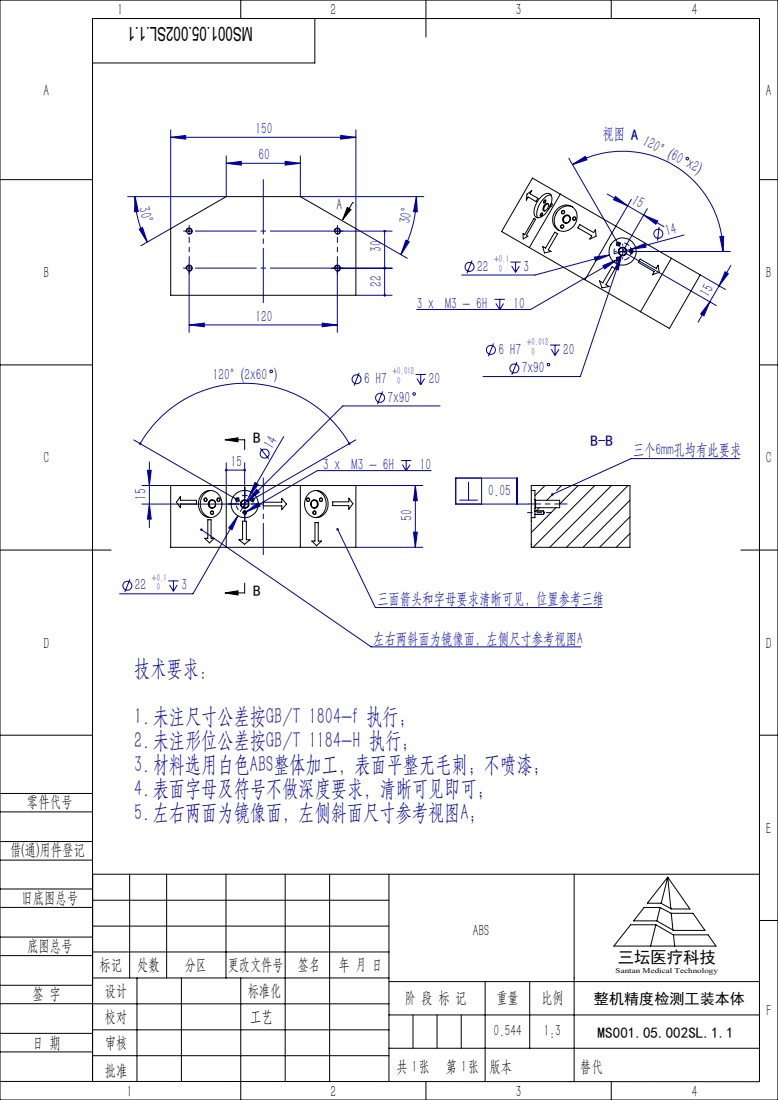
[picture p411: page 1]

1.未注尺寸公差按GB/T 1804-f 执行；
2.未注形位公差按GB/T 1184-H 执行；
3.材料选用白色ABS整体加工，表面平整无毛刺；不喷漆；
4.表面字母及符号不做深度要求，清晰可见即可；
5.左右两面为镜像面，左侧斜面尺寸参考视图A;

ABS | 三坛医疗科技 Santan Medical Technology

标记 | 处数 | 分区 | 更改文件号 | 签名 | 年 月 日
设计 | | | 标准化
校对 | | | 工艺
审核
批准

阶 段 标 记 | 重量 | 比例 | 整机精度检测工装本体
