santan444/MS001/03-设计开发输出阶段/04结构/05工艺装备/MS-001系统精度检测工装/MS001.05.004SL.1.1 精度盘.PDF

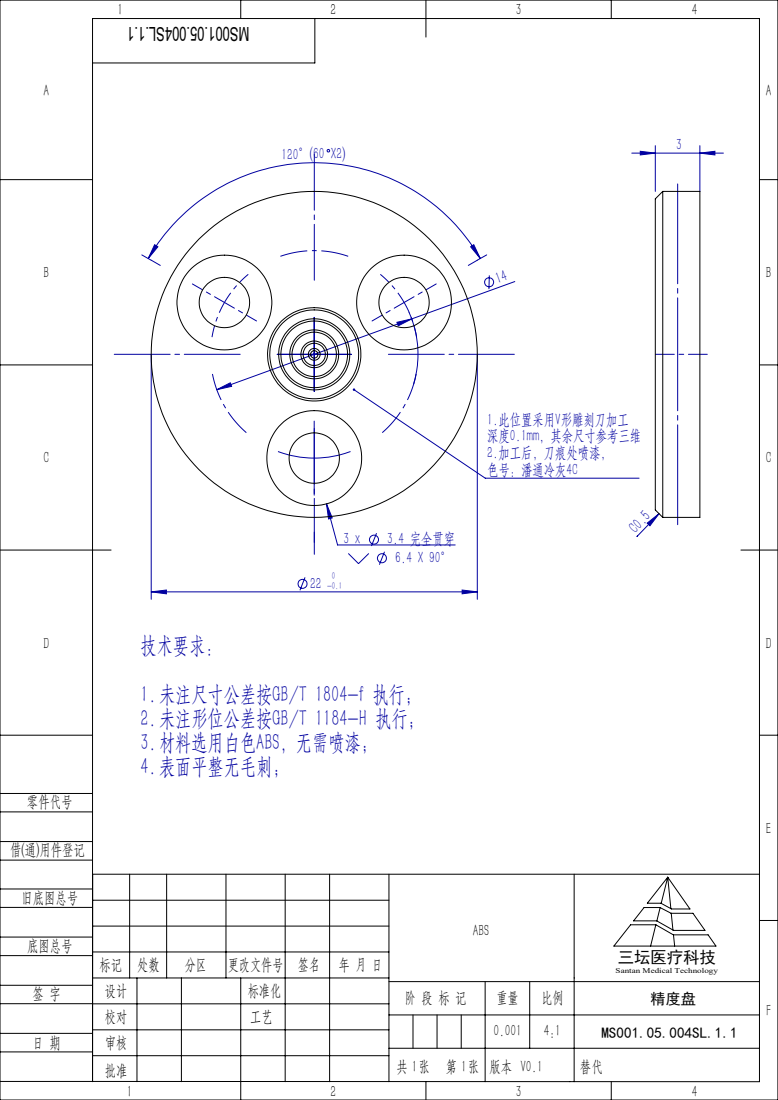
[picture p413: page 1]
3.4 完全贯穿; 1.未注尺寸公差按GB/T 1804-f 执行； 2.未注形位公差按GB/T 1184-H 执行；

ABS | 三坛医疗科技 Santan Medical Technology

标记 | 处数 | 分区 | 更改文件号 | 签名 | 年 月 日
设计 | | | 标准化
校对 | | | 工艺
审核
批准

阶 段 标 记 | 重量 | 比例 | 精度盘
