santan444/MS001/03-设计开发输出阶段/04结构/05工艺装备/MS-001重复定位精度检测工装/MS001.01.005ZZ.1.1 重复定位精度检测工装.PDF

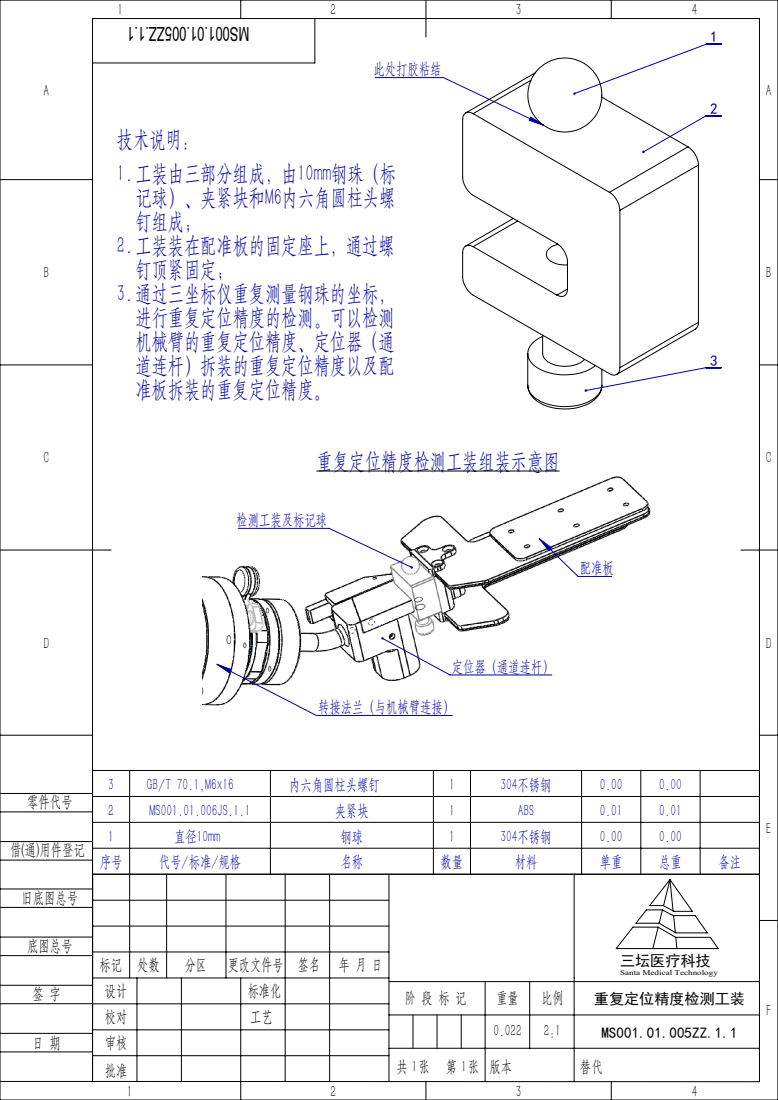
[picture p414: page 1]

3 | GB/T 70.1,M6x16 | 内六角圆柱头螺钉 | 1 | 304不锈钢 | 0.00 | 0.00
2 | MS001.01.006JS.1.1 | 夹紧块 | 1 | ABS | 0.01 | 0.01
1 | 直径10mm | 钢球 | 1 | 304不锈钢 | 0.00 | 0.00
序号 | 代号/标准/规格 | 名称 | 数量 | 材料 | 单重 | 总重 | 备注

三坛医疗科技 Santa Medical Technology

标记 | 处数 | 分区 | 更改文件号 | 签名 | 年 月 日
设计 | | | 标准化
校对 | | | 工艺
审核
批准

阶 段 标 记 | 重量 | 比例 | 重复定位精度检测工装
