santan444/MS001/03-设计开发输出阶段/04结构/05工艺装备/MS-001重复定位精度检测工装/MS001.01.006JS.1.1 夹紧块.PDF

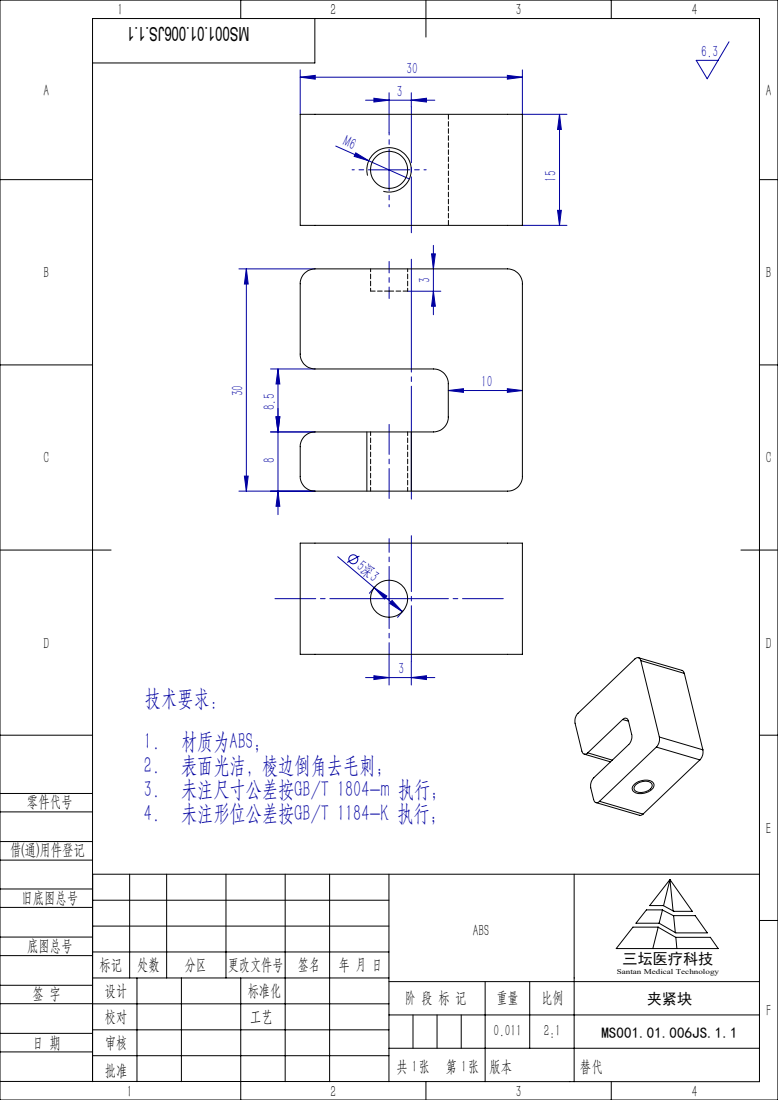
[picture p415: page 1]
1. 材质为ABS； 2. 表面光洁，棱边倒角去毛刺； 3. 未注尺寸公差按GB/T 1804-m 执行； 4. 未注形位公差按GB/T 1184-K 执行；

ABS | 三坛医疗科技 Santan Medical Technology

标记 | 处数 | 分区 | 更改文件号 | 签名 | 年 月 日
设计 | | | 标准化
校对 | | | 工艺
审核
批准

阶 段 标 记 | 重量 | 比例 | 夹紧块
