santan444/MS001/03-设计开发输出阶段/02电子/03线缆图/MS001-A线缆图/MS001-A.01.007XH.1.1 MS001-A计算机开关延长线组件.pdf

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

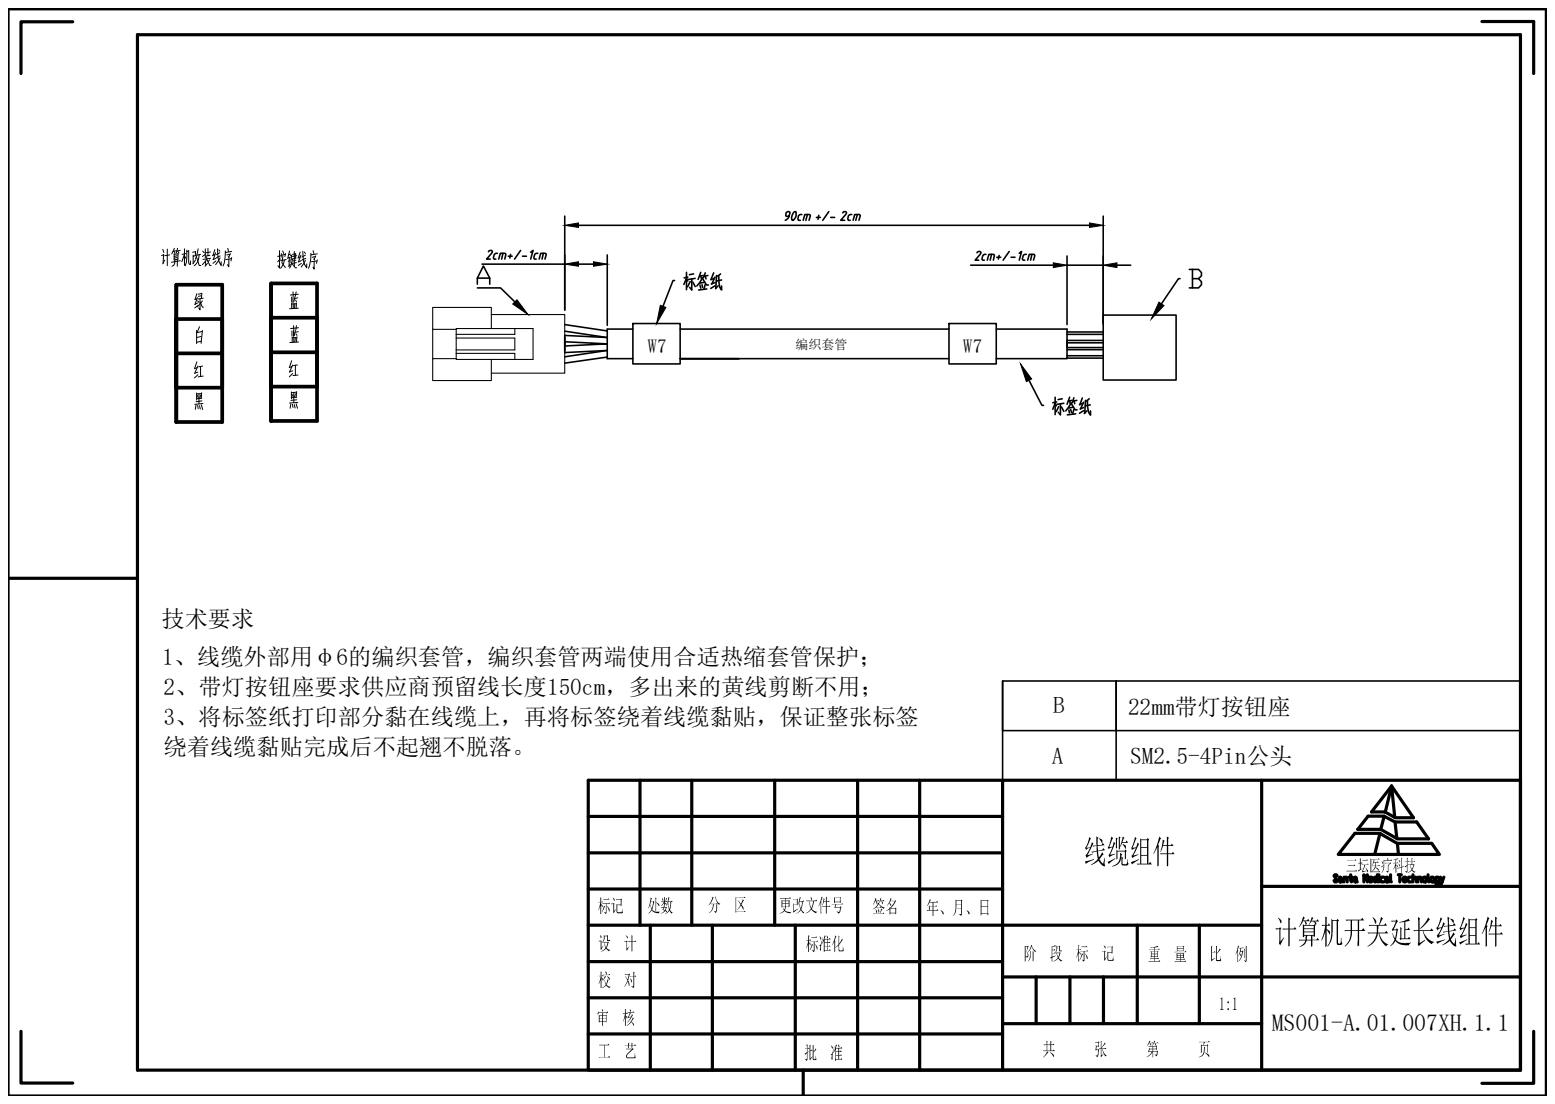
[picture p421: page 1]
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
