santan444/MS001/03-设计开发输出阶段/02电子/03线缆图/MS001-B线缆图/MS001-B.01.011XH.1.1 MS001-B计算机开关延长线组件.pdf

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

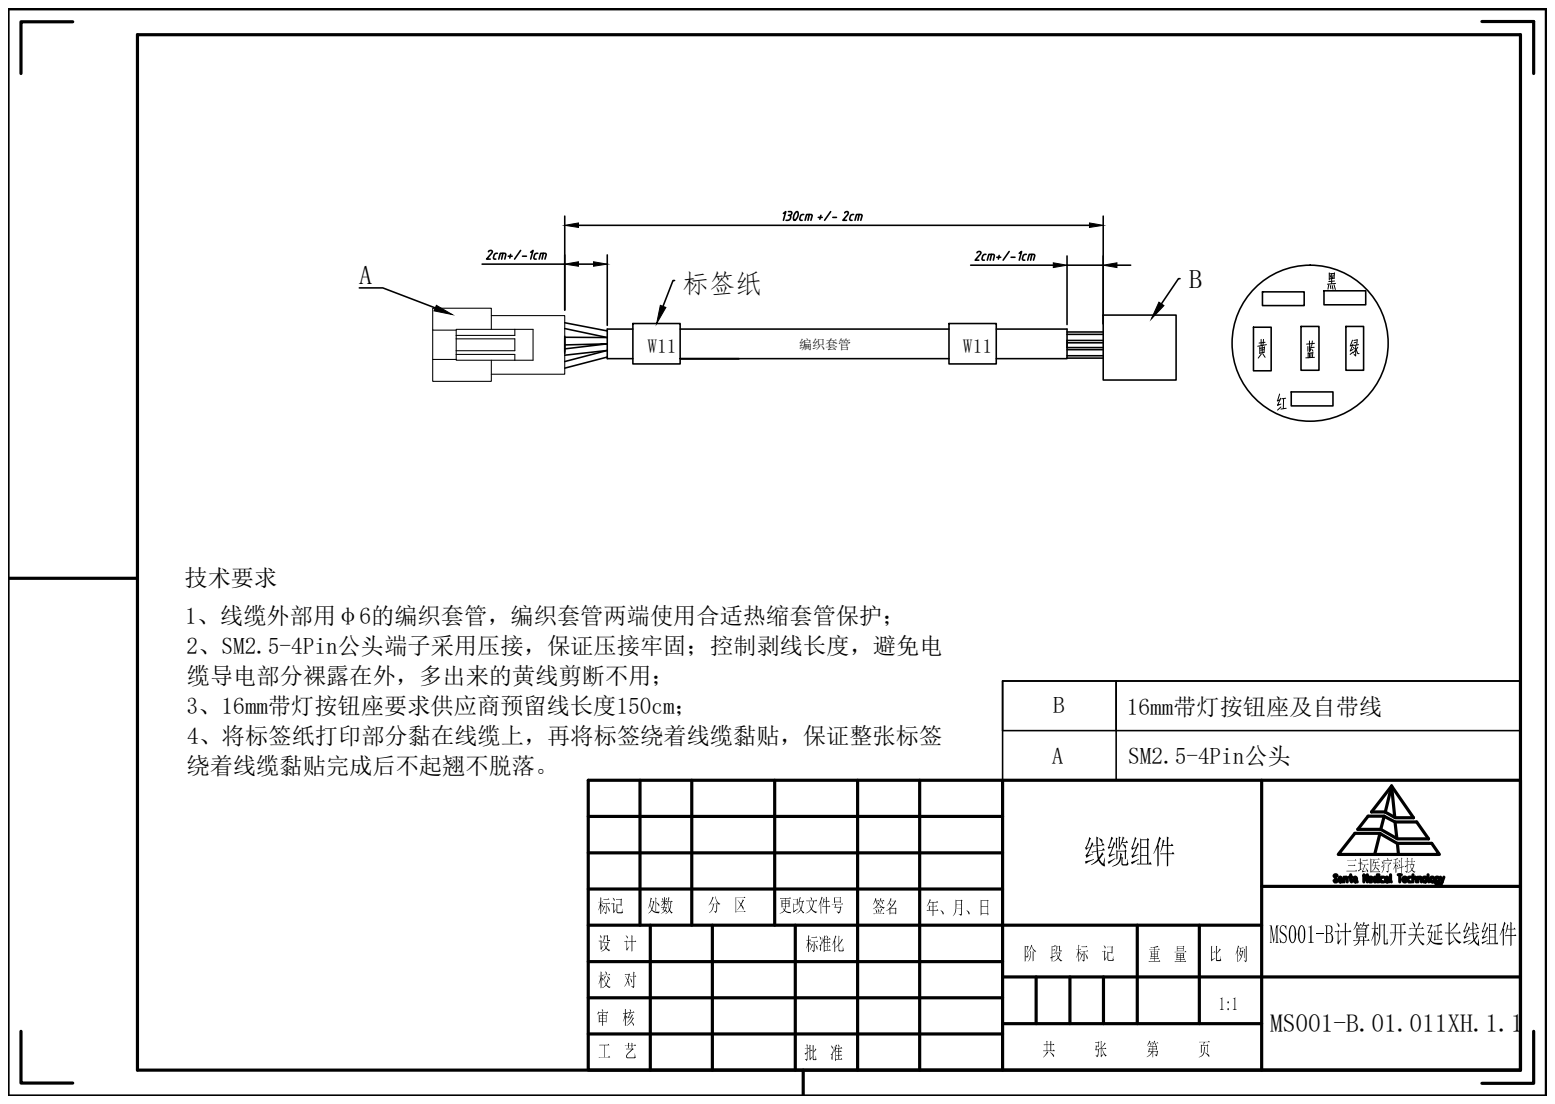
[picture p433: page 1]
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
