santan444/MS001/03-设计开发输出阶段/02电子/03线缆图/MS001-B线缆图/MS001-B.01.016XH.1.1 MS001-B UR上电反馈线.pdf

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

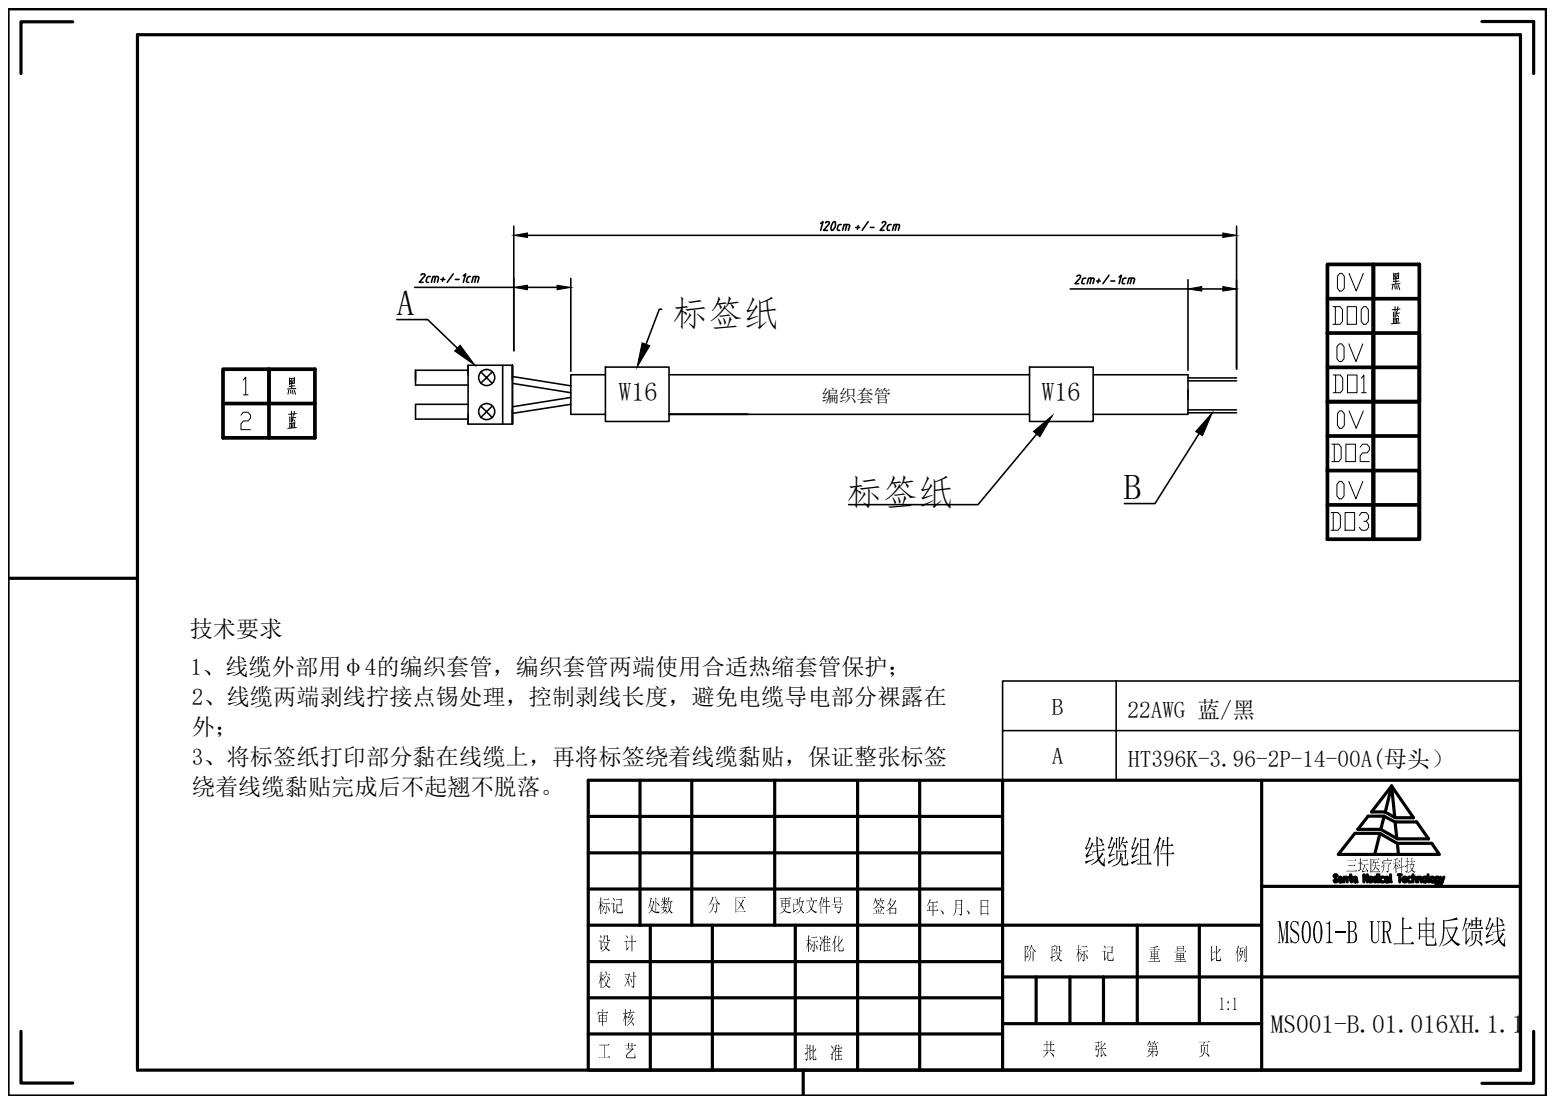
[picture p438: page 1]
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
